muni-works/rose/electronics/limb-controller/DESIGN.md

# Arm controller board - design v0.1 (2026-10-13)

**Schematic:** `arm_controller.loon` is the circuit, written in loon, and it is the source.
`./build.sh` exports it with vcad to `arm_controller.kicad_sch`. It then checks that every pin is
on its loon net with no merges (`netcheck.py`), runs KiCad ERC (0 errors), and plots
`arm_controller.pdf`. Every part is a KiCad library symbol, so pin numbers come from KiCad.

**Parts the schematic uses instead of the first pass below.** Each change was made to use a part
that KiCad's library has:

| first pass | schematic | why |
|---|---|---|
| TCAN1044 | MCP2562FD | same role, 8-pin CAN-FD, in KiCad's library |
| LM5069 | LM5060 | high-side switch controller with enable, inrush and VDS overcurrent |
| INA229 (SPI) | INA228 (I2C) | same 85 V, 20-bit monitor |
| TPS3431 | TPS3430 | same window watchdog family |
| LMR38020 to 5 V | LM5164 48 V to 12 V, then TPS54302 to 5 V | the 12 V rail drives the brake FET gate and feeds aux |
| FDCAN2 on PB12/PB13 | FDCAN2 on PB5/PB6 | the 100-pin package has no port G, so RMII takes PB11-PB13 |

- **Same FET twice.** The hot-swap and brake FETs are the same 100 V TOLL part.
- **VCAP pins.** The two VCAP pins each get their own 2.2 µF capacitor.
- **Footprint gap.** KiCad has no XT30(2+2) footprint, so the wrist-bus connector is a marked
  placeholder until one is drawn.
- **Check before layout.** Verify the FDCAN3 pins (PD12/PD13) and every alternate-function
  assignment in CubeMX.

One board per arm. It sits in the base, on the 6 mm foot, beside the yaw motor. It replaces
four boxes:

| replaced | by |
|---|---|
| RobStride Power Board | the power front end: inrush limit, e-stop switch, bus monitoring |
| RobStride Discharge Module | the on-board brake chopper; its resistor is bolted to the foot |
| a USB-to-CAN adapter | two motor buses, driven directly by the microcontroller |
| a Teensy + transceivers | the microcontroller, with a hardware watchdog it can't override |

It has two firmware modes on the same hardware:

- **Robot mode.** A humanoid's main computer sends joint targets each tick: position, velocity,
  kp, kd and feed-forward torque. The board forwards them to both buses in the same tick and
  returns the motor states. It does no kinematics. It adds the safety layer and one cable across
  the shoulder.
- **Standalone mode.** A laptop talks to the board over USB-C or Ethernet. The board runs the
  servo loop, trajectory interpolation, gravity compensation and the safety policy. The user needs
  no CAN adapter and no realtime OS.

## Simulation (sim/, 2026-10-13)

`cd sim && cargo run --release` runs the power path on vcad's circuit solver. The ICs are behavioural
chips (`vcad_ecad_sim::circuit::chips`): the LM5060 hot-swap, the 3-input AND, the TLV7031 comparator,
and the brake FET with its driver. The circuit is a 48 V bench supply that can't absorb current,
power-up, a 100 ms regen pulse from a back-driven arm, then e-stop. `plot.py` draws
`power_path.svg`.

What it changed in the schematic:

| | first schematic | simulated | now |
|---|---|---|---|
| brake comparator hysteresis | on 54.3 V / off 53.3 V: chatters (582 switch events in 100 ms) | | R16 301k, R17 9.09k, R20 665k: on 57.0 / off 55.5 V (±1.2%: on ≤57.7, off ≥54.9, above a full 13S pack at 54.6) |
| brake resistor | 10 Ω: holds 5 A of regen; 20 A runs the bus to 188 V | 4.7 Ω holds 10 A, 3.3 Ω holds 15 A at 54.2 V | **3.3 Ω, 200 W, on the foot** |
| e-stop hold (R8 / C3) | 104-142 ms, depending on how long the board has been on | diode across R8 makes it fixed | C3 390 nF + BAT54 (D10): **188 ms** |

The LM5060 pin thresholds (EN 2.0 V, UVLO 1.6 V, OVP 2.0 V) and the 5 A inrush limit are assumptions
in the model. Check them against the datasheet before trusting the e-stop delay.

Linear checks were run with vcad's hosted simulate tool:
- 12 V feedback: 1.189 V at 12.0 V out, so the rail sits at 12.11 V.
- 5 V feedback: 0.587 V at 5.0 V out, so the rail sits at 5.08 V.
- Brake sense at 48 V: 1.46 V against the 1.65 V reference, so the brake stays off.
- CAN split-termination corner: about 1.1 MHz.

## Requirements

Facts below come from the RobStride manuals in `~/Developer/robstride_assets`.

| | requirement | source |
|---|---|---|
| bus voltage | 48 V nominal; every part on the bus rated 80 V or more | motors 15–60 V; regen spikes |
| motor buses | 2, CAN 2.0 at 1 Mbps today; CAN-FD capable for later | motors default to 1 Mbps CAN 2.0; most RS models list CAN-FD |
| control rate | 1 kHz with command and reply for every joint | 3 motors per bus fits at 1 Mbps (about 1.1 kHz ceiling) |
| bus A | J1 yaw, J2 shoulder, J4 elbow (3x RS04) | RS04: XT30 power + GH1.25 CAN, separate |
| bus B | J5, J6 (RS02), J7 (RS00), gripper | RS02/RS00: XT30(2+2), power and CAN in one plug |
| current | 40 A peak, 10 A continuous for the whole arm | RS04 phase peak 90 A is phase, not bus; bus power is far lower |
| regen | clamp the motor bus to about 54 V | a bench supply cannot absorb energy, per the discharge module manual |
| e-stop | cuts motor power by hardware, with no firmware in the path | ISO 13850; matches the power board's 5 µs cut |
| uplink | USB-C, 100 Mbit Ethernet, and CAN-FD | robot or standalone |
| size | fits the foot annulus outside the J1 collar: 150 x 40 mm max | foot Ø230, collar Ø140 |

## Block diagram

```mermaid
flowchart LR
  PIN[48 V in<br/>XT60] --> TVS[TVS + reverse<br/>polarity FET] --> HS[LM5069 hot-swap<br/>inrush + overcurrent<br/>+ e-stop off]
  HS --> MB[(motor bus)]
  MB --> BR[brake chopper<br/>comparator + 100 V FET<br/>resistor on the foot]
  MB --> INA[INA229<br/>bus V and I]
  MB --> BA[bus A out<br/>3x XT30 + GH1.25]
  MB --> BB[bus B out<br/>XT30 2+2]
  PIN --> BK[LMR38020 buck<br/>48 V to 5 V] --> LDO[3.3 V LDO]
  BK --> AUX[5 V aux out]
  ES[e-stop loop<br/>2-channel NC] --> HS
  WD[TPS3431<br/>window watchdog] --> HS
  MCU[STM32H723<br/>550 MHz M7<br/>3x FDCAN] --> TA[TCAN1044 A] --> BA
  MCU --> TB[TCAN1044 B] --> BB
  MCU --> TU[TCAN1044 uplink] --> UP[CAN-FD uplink<br/>JST-GH 4]
  MCU --> PHY[LAN8742A<br/>RMII] --> RJ[RJ45]
  MCU --> USB[USB-C]
  MCU --> WD
  INA --> MCU
  MCU -- override --> BR
  ES --> MCU
```

## Microcontroller: STM32H723 instead of the Teensy's i.MX RT1062

| | STM32H723VGT6 | i.MX RT1062 (Teensy 4.1) |
|---|---|---|
| CAN | **3x FDCAN**, all CAN-FD | 3x CAN, only one CAN-FD |
| Ethernet | MAC on chip, RMII PHY | MAC on chip, RMII PHY |
| package | LQFP-100, routable on a 4-layer board | BGA-196, needs fine-pitch fab |
| flash | 1 MB on chip | external QSPI |
| price, qty 10 | about $10 (estimate) | about $8, plus flash |

The H723 wins on CAN-FD on every bus and on an easy package. The Teensy's selling point was firmware
continuity, so **prototype on an ST NUCLEO-H723ZG instead of a Teensy**. Its chip is the same, and it
has Ethernet on board. The firmware then moves to this board unchanged.

## Power and safety

**Power path.** 48 V comes in through an XT60. Next are a TVS (SMDJ60A) and a reverse-polarity
FET. Then an LM5069 hot-swap controller drives a 100 V, about 2 mΩ MOSFET. The LM5069 does three jobs:

- It limits inrush by limiting the rise rate, so no precharge resistor is needed.
- It trips on overcurrent with a power limit, set to 45 A.
- Its enable pin is driven only by the e-stop loop AND the watchdog. Firmware cannot hold it on.

**Brake chopper.** It sits on the motor side of the switch. A comparator with hysteresis turns
on at 57.0 V and off at 55.5 V: above a full 13S pack (54.6 V), so it never bleeds a charged pack,
and below RS04's limit. Firmware may add braking (soft brake on 55.0 / off 54.4 V when the BMS can't
take the regen) but never inhibits the comparator. TVS is SMDJ60A: 60 V stand-off clears the 57.7 V
worst-case brake-on, clamp stays under the 100 V FETs.
It drives a 100 V FET into an aluminium-clad resistor, 10 Ω / 100 W, bolted to the 6 mm foot.
The foot is the heat sink. The MCU can also force it on, and it logs every event.

**Stop sequence (ISO 13850 category 1).**

1. Pressing e-stop, a watchdog timeout or a fault from the bus monitor starts a stop.
2. Within one tick, the MCU commands every motor to damping mode. Each joint gets kd only, so
   the arm settles instead of dropping.
3. After 200 ms, an RC timer opens the hot-swap FET. This step is hardware and happens even if
   the firmware is dead.
4. Unpowered, the motors fall back on RobStride's power-off anti-backdrive damping. Rig test #1
   checks whether that holds a slowly falling arm.

**Watchdog.** A TPS3431 window watchdog is kicked by the control loop, not by an idle task. A
hung loop takes motor power away within 200 ms.

**Monitoring.** An INA229 reads bus voltage and current at 20 bits over SPI. Firmware uses it for
energy accounting, overcurrent before the hardware trip, and collision detection from current
spikes, the crush-point policy the audit asks for. Two NTCs watch the FET and the brake resistor.

**Logic power.** An LMR38020 buck (80 V in, 2 A) makes 5 V from the input side of the switch, so
the MCU stays alive through an e-stop and can report. A 3.3 V LDO follows it. The 5 V aux output
is for the gripper or lights.

## Connectors

| connector | part | carries |
|---|---|---|
| power in | XT60PW-M | 48 V from supply or body bus |
| bus A power | 3x XT30PW-M (or one XT30 out, daisy-chained) | RS04 power |
| bus A CAN | GH1.25 2-pin | RS04 CAN, daisy-chained |
| bus B | XT30PB(2+2)-M | RS02 / RS00 power + CAN, daisy-chained |
| e-stop | 4-pin locking, dual-channel normally closed | e-stop button |
| uplink | RJ45 with magnetics, JST-GH 4 (CAN-FD), USB-C | robot or laptop |
| brake resistor | 2-pin screw terminal | resistor on the foot |
| aux | JST-GH 3 | 5 V, GND, one GPIO |

Each CAN bus is terminated at the board, with a 120 Ω split termination and a solder jumper, and at
the far motor. ESD protection (PESD2CAN class) on every CAN line that leaves the board.

## Board

- **Stackup:** 4 layers, 2 oz outer copper for the 40 A path. The motor bus runs as a pour,
  not as traces.
- **Size:** 140 x 38 mm, shaped to the foot annulus. It mounts on four M3 standoffs with the FET
  and chopper thermally padded to the foot.
- **Assembly:** single-sided SMT at a board house. Connectors are hand-soldered or assembled
  through-hole.
- **Cost, qty 10:** roughly $45–70 per board assembled, excluding the brake resistor. That's an
  estimate until it's quoted.

### One board, many limbs

The same board runs the arm, a leg, the torso or the head. Firmware picks the role from
the board ID, and each block below is fitted only where a limb needs it.

| Block | Part | MCU | Use |
|---|---|---|---|
| Board ID | R67/R68 divider | PC0 (ADC) | R68 DNP = arm, 10k leg, 4.7k torso, 2.2k head |
| IMU | ISM330DHCX (SPI1) | CS PA4, INT PD6 | orientation, fall and collision detection |
| Load cell | ADS1220 24-bit, ratiometric (SPI1) | CS PD4, DRDY PD2 | wrist force, grip force, foot contact (J14) |
| 4th CAN-FD | MCP251863 (controller and transceiver, SPI1) | CS PD5, INT PC10 | second limb or tool bus (J15); the MCU's 3 FDCANs are taken |
| Brushed motor | DRV8871 from +12 V, ILIM 0.78 A | TIM1 CH1/CH2 (PA8/PA9) | gripper or tool without a RobStride (J16) |
| 48 V aux out | 1.1 A PTC (60 V 2920s stop near 1 A), XT30 | - | the board doubles as the power distribution node (J17) |
| PTP time sync | STM32H7 MAC timestamping | - | firmware only, no new parts |
| Mounting | 4 x M3, grounded pads | - | fits any limb, not only the foot ring |

SPI1 is PA5 SCK, PA6 MISO and PD7 MOSI. The IMU and ADC outputs go through 33 R series
resistors onto the shared MISO line. The MCP251863's TXCAN-TXD link is a 0 R resistor (R77).
**Open:** check the brushed motor's 0.78 A limit against the 1 A LM5164 12 V buck. If a
gripper needs more, swap the buck for a 2 A part. Pick a real part number for F1.

### Layout as built (v0.1 draft, 150 x 40 mm)

- **Hand work (v0.2, 150 x 46):** the router left SPI_MOSI open between U10 and the SPI devices.
  - SPI_MOSI: astar_fix.py with ASTAR_FORCE=1 ASTAR_WIN=8 ASTAR_GRID=0.1 routed it, ripping
    IMU_INT's escape.
  - IMU_INT: pin-swapped from U10 pin 87 (PD6) to pin 7 (PC13), beside its remaining copper,
    then astar_fix.py. Firmware: IMU_INT is PC13 (EXTI13).
  - +12V near the ETH_REFCLK via at (108.75, 35.9): the 0.5 mm jog re-laid 1.4 mm to the left
    (Power class needs 0.2 mm).
  - AUX_IO stays on U10 pin 34 (PB0), facing J11 (from the 150 x 40 board).
  A full re-route regenerates the board: replay pin_swap.py and astar_fix.py.

- **Flow:** `arm_controller.loon` → `place.py` (placement block) → `route.sh`. route.sh runs
  `vcad route`, then KiCad fills the zones (`fill_zones.py`) and runs DRC (`drc.rpt`).
- **Stackup (6 layers):** F signal / In1 GND / In2 signal / In3 +3V3 / In4 signal / B signal.
  The router keeps traces off the two plane layers, and vias pass through them. On
  4 layers, signals on the planes cut ground into islands and stranded pads. +12 V, +5 V,
  VIN_BUCK and VAUX48 are traced at 0.5 mm (the "Power" class).
- **48 V pours:** VIN, VBUS_SW, VBUS and BRK_R get F.Cu pour rectangles that reinforce routed
  traces. The router never relies on them, because KiCad's fill carves overlapping pours
  apart. Only pads of 1 mm² or larger set a pour's extent, so a controller's sense pin
  doesn't drag the pour over the logic.
- **VIN_BUCK:** a ferrite (FB4) splits the buck's input from VIN. This keeps the buck's
  switching noise off the hot-swap sense node, and gives the 48 V pour a clean edge.
- **Hot-swap and brake FETs:** IPT015N10N5 (TOLL), with pins 1 = G, 2 = S, 3 = D. The
  old generic NMOS symbol's G/D/S names didn't match the footprint's pad numbers, so the FETs
  were unconnected. vcad now refuses a pin that has no pad.
- **Thermal vias** under exposed pads tie solid to the planes, with no spokes.
- **Easter eggs:** the muni logo is on the front silk. A note sits inside the MCU's pad ring,
  so it's only readable on a bare board. The back carries the fork arm, drawn from its own
  dimensions.

## Firmware outline

- **1 kHz control tick.** Send bus A and bus B frames in parallel and gather replies, then publish
  one state packet upstream and kick the watchdog.
- **Robot mode.** Accept one target packet per tick over CAN-FD or UDP. Stale for 3 ticks means a
  damped hold. Stale for 200 ms means the hardware stop.
- **Standalone mode.** A USB CDC or UDP API covering joint and Cartesian targets, trajectories,
  gravity compensation from the model's masses, and leader-follower teleop for LeRobot-style data.
- **Safety layer, both modes.** Joint limits from `audit.py` ranges, a velocity cap, collision
  detection from motor current and INA229 spikes, and a thermal model per motor from the stall
  ratings.
- **Bring-up tools.** A Python CLI to set motor IDs, read parameters, zero joints and stream plots.

## Plan

1. **Now:** NUCLEO-H723ZG plus three TCAN1044 breakout modules and the RobStride discharge module.
   Write the firmware against the elbow rig.
2. **Board v0.1:** schematic and layout from this document. Fab 5 at a board house.
3. **Swap:** the rig and the first arm move to the board. Firmware is unchanged.

Open questions:

- the EDU gripper's interface (PWM servo, serial bus or CAN), which decides what the aux port carries
- whether the humanoid body supplies 48 V on a shared bus, and how its regen is handled
- e-stop wiring in the humanoid: one loop through every limb board, or a body-level signal
