muni-works/rose/electronics/brain/b2b_pinmap.csv

connector | pin | net
J_B2B1 | 1 | GND
J_B2B1 | 2 | GND
J_B2B1 | 3 | CAM0_CP
J_B2B1 | 4 | GND
J_B2B1 | 5 | CAM0_CN
J_B2B1 | 6 | GND
J_B2B1 | 7 | GND
J_B2B1 | 8 | GND
J_B2B1 | 9 | CAM0_D0P
J_B2B1 | 10 | GND
J_B2B1 | 11 | CAM0_D0N
J_B2B1 | 12 | GND
J_B2B1 | 13 | GND
J_B2B1 | 14 | GND
J_B2B1 | 15 | CAM0_D1P
J_B2B1 | 16 | GND
J_B2B1 | 17 | CAM0_D1N
J_B2B1 | 18 | GND
J_B2B1 | 19 | GND
J_B2B1 | 20 | GND
J_B2B1 | 21 | CAM0_D2P
J_B2B1 | 22 | GND
J_B2B1 | 23 | CAM0_D2N
J_B2B1 | 24 | GND
J_B2B1 | 25 | GND
J_B2B1 | 26 | GND
J_B2B1 | 27 | CAM0_D3P
J_B2B1 | 28 | GND
J_B2B1 | 29 | CAM0_D3N
J_B2B1 | 30 | GND
J_B2B1 | 31 | GND
J_B2B1 | 32 | GND
J_B2B1 | 33 | CAM1_CP
J_B2B1 | 34 | GND
J_B2B1 | 35 | CAM1_CN
J_B2B1 | 36 | GND
J_B2B1 | 37 | GND
J_B2B1 | 38 | GND
J_B2B1 | 39 | CAM1_D0P
J_B2B1 | 40 | GND
J_B2B1 | 41 | CAM1_D0N
J_B2B1 | 42 | GND
J_B2B1 | 43 | GND
J_B2B1 | 44 | GND
J_B2B1 | 45 | CAM1_D1P
J_B2B1 | 46 | GND
J_B2B1 | 47 | CAM1_D1N
J_B2B1 | 48 | GND
J_B2B1 | 49 | GND
J_B2B1 | 50 | GND
J_B2B1 | 51 | CAM1_D2P
J_B2B1 | 52 | GND
J_B2B1 | 53 | CAM1_D2N
J_B2B1 | 54 | GND
J_B2B1 | 55 | GND
J_B2B1 | 56 | GND
J_B2B1 | 57 | CAM1_D3P
J_B2B1 | 58 | GND
J_B2B1 | 59 | CAM1_D3N
J_B2B1 | 60 | GND
J_B2B1 | 61 | GND
J_B2B1 | 62 | GND
J_B2B1 | 63 | USB_OTG_DP
J_B2B1 | 64 | GND
J_B2B1 | 65 | USB_OTG_DM
J_B2B1 | 66 | GND
J_B2B1 | 67 | GND
J_B2B1 | 68 | GND
J_B2B1 | 69 | GND
J_B2B1 | 70 | GND
J_B2B1 | 71 | GND
J_B2B1 | 72 | GND
J_B2B1 | 73 | GND
J_B2B1 | 74 | GND
J_B2B1 | 75 | GND
J_B2B1 | 76 | GND
J_B2B1 | 77 | GND
J_B2B1 | 78 | GND
J_B2B1 | 79 | GND
J_B2B1 | 80 | GND
J_B2B1 | 81 | GND
J_B2B1 | 82 | GND
J_B2B1 | 83 | GND
J_B2B1 | 84 | GND
J_B2B1 | 85 | GND
J_B2B1 | 86 | GND
J_B2B1 | 87 | GND
J_B2B1 | 88 | GND
J_B2B1 | 89 | GND
J_B2B1 | 90 | GND
J_B2B1 | 91 | GND
J_B2B1 | 92 | GND
J_B2B1 | 93 | GND
J_B2B1 | 94 | GND
J_B2B1 | 95 | GND
J_B2B1 | 96 | GND
J_B2B1 | 97 | GND
J_B2B1 | 98 | GND
J_B2B1 | 99 | GND
J_B2B1 | 100 | GND
J_B2B2 | 1 | VCC_SYSIN
J_B2B2 | 2 | VCC_SYSIN
J_B2B2 | 3 | VCC_SYSIN
J_B2B2 | 4 | VCC_SYSIN
J_B2B2 | 5 | VCC_SYSIN
J_B2B2 | 6 | VCC_SYSIN
J_B2B2 | 7 | VCC_SYSIN
J_B2B2 | 8 | VCC_SYSIN
J_B2B2 | 9 | VCC_SYSIN
J_B2B2 | 10 | VCC_SYSIN
J_B2B2 | 11 | VCC_SYSIN
J_B2B2 | 12 | VCC_SYSIN
J_B2B2 | 13 | VCC_SYSIN
J_B2B2 | 14 | VCC_SYSIN
J_B2B2 | 15 | VCC_SYSIN
J_B2B2 | 16 | VCC_SYSIN
J_B2B2 | 17 | VCC_SYSIN
J_B2B2 | 18 | VCC_SYSIN
J_B2B2 | 19 | VCC_SYSIN
J_B2B2 | 20 | VCC_SYSIN
J_B2B2 | 21 | VCC_3V3_S0
J_B2B2 | 22 | VCC_3V3_S0
J_B2B2 | 23 | VCC_3V3_S0
J_B2B2 | 24 | VCC_3V3_S0
J_B2B2 | 25 | USB_VBUS
J_B2B2 | 26 | USB_VBUS
J_B2B2 | 27 | GND
J_B2B2 | 28 | GND
J_B2B2 | 29 | CAM0_PWDN
J_B2B2 | 30 | GND
J_B2B2 | 31 | CAM0_SCL
J_B2B2 | 32 | GND
J_B2B2 | 33 | CAM0_SDA
J_B2B2 | 34 | GND
J_B2B2 | 35 | CAM1_PWDN
J_B2B2 | 36 | GND
J_B2B2 | 37 | CAM1_SCL
J_B2B2 | 38 | GND
J_B2B2 | 39 | CAM1_SDA
J_B2B2 | 40 | GND
J_B2B2 | 41 | PWRON_L
J_B2B2 | 42 | GND
J_B2B2 | 43 | RECOVERY_KEY
J_B2B2 | 44 | GND
J_B2B2 | 45 | RT_BOOT0
J_B2B2 | 46 | GND
J_B2B2 | 47 | RT_CS_n
J_B2B2 | 48 | GND
J_B2B2 | 49 | RT_IRQ
J_B2B2 | 50 | GND
J_B2B2 | 51 | RT_MISO
J_B2B2 | 52 | GND
J_B2B2 | 53 | RT_MOSI
J_B2B2 | 54 | GND
J_B2B2 | 55 | RT_NRST
J_B2B2 | 56 | GND
J_B2B2 | 57 | RT_RX
J_B2B2 | 58 | GND
J_B2B2 | 59 | RT_SCK
J_B2B2 | 60 | GND
J_B2B2 | 61 | RT_TX
J_B2B2 | 62 | GND
J_B2B2 | 63 | SOC_UART2_RX
J_B2B2 | 64 | GND
J_B2B2 | 65 | SOC_UART2_TX
J_B2B2 | 66 | GND
J_B2B2 | 67 | GND
J_B2B2 | 68 | GND
J_B2B2 | 69 | GND
J_B2B2 | 70 | GND
J_B2B2 | 71 | GND
J_B2B2 | 72 | GND
J_B2B2 | 73 | GND
J_B2B2 | 74 | GND
J_B2B2 | 75 | GND
J_B2B2 | 76 | GND
J_B2B2 | 77 | GND
J_B2B2 | 78 | GND
J_B2B2 | 79 | GND
J_B2B2 | 80 | GND
J_B2B2 | 81 | GND
J_B2B2 | 82 | GND
J_B2B2 | 83 | GND
J_B2B2 | 84 | GND
J_B2B2 | 85 | GND
J_B2B2 | 86 | GND
J_B2B2 | 87 | GND
J_B2B2 | 88 | GND
J_B2B2 | 89 | GND
J_B2B2 | 90 | GND
J_B2B2 | 91 | GND
J_B2B2 | 92 | GND
J_B2B2 | 93 | GND
J_B2B2 | 94 | GND
J_B2B2 | 95 | GND
J_B2B2 | 96 | GND
J_B2B2 | 97 | GND
J_B2B2 | 98 | GND
J_B2B2 | 99 | GND
J_B2B2 | 100 | GND
