muni-works/rose/electronics/brain/ddr_swizzle.csv

channel | dram_side | dram_dq | soc_dq
0 | A | 0 | 1
0 | A | 1 | 4
0 | A | 2 | 6
0 | A | 3 | 0
0 | A | 4 | 2
0 | A | 5 | 7
0 | A | 6 | 5
0 | A | 7 | 3
0 | A | 8 | 14
0 | A | 9 | 11
0 | A | 10 | 8
0 | A | 11 | 9
0 | A | 12 | 10
0 | A | 13 | 13
0 | A | 14 | 12
0 | A | 15 | 15
0 | B | 0 | 6
0 | B | 1 | 0
0 | B | 2 | 5
0 | B | 3 | 2
0 | B | 4 | 4
0 | B | 5 | 7
0 | B | 6 | 3
0 | B | 7 | 1
0 | B | 8 | 13
0 | B | 9 | 14
0 | B | 10 | 9
0 | B | 11 | 8
0 | B | 12 | 10
0 | B | 13 | 11
0 | B | 14 | 12
0 | B | 15 | 15
1 | A | 0 | 2
1 | A | 1 | 0
1 | A | 2 | 4
1 | A | 3 | 5
1 | A | 4 | 7
1 | A | 5 | 6
1 | A | 6 | 1
1 | A | 7 | 3
1 | A | 8 | 14
1 | A | 9 | 12
1 | A | 10 | 9
1 | A | 11 | 8
1 | A | 12 | 11
1 | A | 13 | 10
1 | A | 14 | 13
1 | A | 15 | 15
1 | B | 0 | 0
1 | B | 1 | 1
1 | B | 2 | 6
1 | B | 3 | 5
1 | B | 4 | 7
1 | B | 5 | 3
1 | B | 6 | 4
1 | B | 7 | 2
1 | B | 8 | 9
1 | B | 9 | 11
1 | B | 10 | 14
1 | B | 11 | 8
1 | B | 12 | 13
1 | B | 13 | 15
1 | B | 14 | 12
1 | B | 15 | 10
