muni-works/rose/electronics/limb-controller/sim/power_path.csv

t_s | vbus | hs_en | brake
0.0000 | 0.000 | 0.000 | 0
0.0005 | 11.077 | 2.740 | 0
0.0010 | 22.047 | 2.761 | 0
0.0015 | 32.841 | 2.773 | 0
0.0020 | 43.386 | 2.782 | 0
0.0025 | 47.182 | 2.788 | 0
0.0030 | 47.183 | 2.793 | 0
0.0035 | 47.183 | 2.798 | 0
0.0040 | 47.183 | 2.802 | 0
0.0045 | 47.183 | 2.805 | 0
0.0050 | 47.183 | 2.808 | 0
0.0055 | 47.183 | 2.811 | 0
0.0060 | 47.183 | 2.814 | 0
0.0065 | 47.183 | 2.816 | 0
0.0070 | 47.183 | 2.818 | 0
0.0075 | 47.183 | 2.820 | 0
0.0080 | 47.183 | 2.822 | 0
0.0085 | 47.183 | 2.824 | 0
0.0090 | 47.183 | 2.826 | 0
0.0095 | 47.183 | 2.828 | 0
0.0100 | 47.183 | 2.830 | 0
0.0105 | 47.183 | 2.831 | 0
0.0110 | 47.183 | 2.833 | 0
0.0115 | 47.183 | 2.834 | 0
0.0120 | 47.183 | 2.836 | 0
0.0125 | 47.183 | 2.837 | 0
0.0130 | 47.183 | 2.838 | 0
0.0135 | 47.183 | 2.840 | 0
0.0140 | 47.183 | 2.841 | 0
0.0145 | 47.183 | 2.842 | 0
0.0150 | 47.183 | 2.843 | 0
0.0155 | 47.183 | 2.845 | 0
0.0160 | 47.183 | 2.846 | 0
0.0165 | 47.183 | 2.847 | 0
0.0170 | 47.183 | 2.848 | 0
0.0175 | 47.183 | 2.849 | 0
0.0180 | 47.183 | 2.850 | 0
0.0185 | 47.183 | 2.851 | 0
0.0190 | 47.183 | 2.852 | 0
0.0195 | 47.183 | 2.853 | 0
0.0200 | 47.183 | 2.854 | 0
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
