muni-works/rose/arm/V10.4.md

# lymb v10.4: skin fastening, J2 margin, the shoulder line

Design only. v9 is bit-identical (audit output and the `fab/` package match). The torso is rose's pass 3, claude/quad00-torso-v103 @ 6636f43: no fans, corner clear to r 88, flank at |y| 186.6 with a Ø135 opening and an inlaid bezel.

## Numbers (skin mass, fastening and thermal derating all included)

| | v10.3 | **v10.4** |
|---|---|---|
| J2 hold, model jaws | 1.271 kg | **1.374 kg desk; 1.304 kg humanoid** (the deltoid hood costs 2 % of J2's cooling, below) |
| J2 hold, gripper v2 | 1.02 kg | 1.11 kg desk |
| J4 / J6 hold | 4.72 / 1.32 kg | 4.98 / 1.49 kg |
| jaw tips from J2 | 752 mm | 734 mm (-18 mm, see below) |
| mass, desk | 8.68 kg | 8.55 kg |
| moving mass | 5.95 kg | 5.82 kg |
| skin + panels + fastening | 0.54 kg | 0.55 kg |
| sag / twist | 0.46 / 0.18 mm | **0.45 / 0.16 mm** |
| structure ranges | J2 -180..25, J4 -150..130, J6 ±130 | J2 -180..25, J4 -150..130, J6 **±135** |
| skinned ranges, the soft limits | J2 -180..+10, J4 ±115, J6 ±105 | desk: J2 **-140**..+10; humanoid: J2 **-75**..+10 (the hood); J4 **±110**, J6 **±100** |
| interference / DFM issues | none / 0 | none / 0 |
| unique router parts | 26 | 25 (the four tube walls are now one part) |
| sheets | 3 + 1 | 3 + 1 |
| harness to the roll motors over ±180° | J3 1.9 mm, J7 2.3 mm | same |

## J2 margin back to ≥ 1.35 kg (distal mass first)

1. **Wrist 18 mm shorter.** The wrist end plate (J7's mount) moves from J6 lobe + 28 mm to lobe + 10 mm. That costs 18 mm of reach, and it is the biggest lever: J7, the tool and the payload all move closer to J2.
   - The J7 service loop still fits (2.3 mm to the can over ±180°).
   - The wrist's structural range opens to ±135°; its skinned range is ±100°.
2. **Distal plate windows.** The fore, yoke and wrist plates keep 9 mm flanges over their windows instead of 14 mm (`FLANGE_D`; webs ≥ 1.5 t, DFM clean). Sag was recomputed with the deeper windows.
3. **Skin wall.** The arm sleeves and the J4 / J6 rings go from 1.2 to 0.9 mm MJF PA12 with internal ribs. The turret, J2 ring, desk puck and J1 drum stay at 1.2 mm.
4. **Panel windows.** Each Al flank panel is windowed over its holder plate's own windows (40 % out). The heat path is unchanged, since the plate isn't there either.

## Shoulder read and ring taper (Cam, rose)

- **Ring taper down the arm:** J2 Ø137, J4 Ø126 (-8 %), J6 Ø96. Bezels are 3 / 2 / 1.5 mm.
  - The elbow lobe is now RS04 can + 2 mm (it was + 6; back-pattern web 6.75 mm, DFM clean), so the J4 ring can shrink.
  - Rose asked for 10-15 % smaller; the RS04 can (Ø120) limits it to -8 %.
- **Deltoid hood (humanoid only).** The turret shell carries on over the top third of the J2 ring, 0.5-3 mm proud, so the shoulder grows out of rose's crown line.
  - It covers a third of J2's dot-grid: J2's derate goes 1 % → 3 %, and J2's hold on the humanoid is 1.304 kg (still ≥ 1.27).
  - It stops the J2 backswing (abduction) at -75° on the humanoid.
  - The desk arm has no hood: J2 keeps -140 there and holds 1.374 kg.
- **Head.** cortex-full.loon (rose's full head, main @ 2cfecc3), pitched 35° down at rest about the head-pitch axis.

## Skin fastening (no new plate holes)

| part | how it attaches | per part | mass |
|---|---|---|---|
| sleeve halves: upper, upperd, forearm, wrist, turret (5 x 2) | 2 printed C-clips per half snap over the holder plates' straight top and bottom edges (3.175 mm 5052, in the clip's 3.3 mm slot) + 1 N52 Ø6 x 3 magnet pair on the half-to-half seam | 4 clips, 2 magnets | 0.4 g a clip, 0.64 g a magnet: 2.9 g a half |
| J2 / J4 ring pucks + bezels | 3 M5 x 8 Al hex standoffs (male-female) per face, replacing 3 of the straddler plate A's existing output-pattern screws (A side) and 3 of plate B's sleeve-flange screws (B side); bezel and ring screw to them with M3 x 6 | 6 standoffs, 6 M3 x 6 | 1.5 g a set |
| J6 ring puck | same on the RS02 output pattern: M4 x 8 standoffs | 6 | 1.2 g a set |
| J1 drum (desk) | 4 printed clips over the foot's Ø170 rim | 4 | 0.4 g |
| desk base puck | captured under the pedestal base plate (it sits on the table, the base plate bolts through its floor) | - | - |
| J3 / J7 trim rings | VHB in a 0.3 mm groove in the sleeve | - | ~0 |
| Al flank panels | the gap pad's adhesive face + the sleeve's edge lips (panels sit in a 0.6 mm recess) | - | - |

All fastening comes to 57 g, modelled at each part's link.

**Fastening BOM, per arm:**
- 10 sleeve halves x 4 clips = 40 printed C-clips (part of each half, MJF PA12)
- 4 printed foot-rim clips
- 20 N52 Ø6 x 3 disc magnets (10 seam pairs)
- 12 M5 x 8 Al hex standoffs, male-female (J2, J4)
- 6 M4 x 8 Al hex standoffs, male-female (J6)
- 18 M3 x 6 ISO 7380 button heads, black
- 18 M5 / M4 screws one size longer than today's, replacing the ones the standoffs take over (lengths in `fab-v10/BOM.md` + 8 mm)
- 0.5 m of 3M VHB 5952 tape, 3 mm wide

## Shoulder line on rose's torso pass 3

- **Turret shell.** It is now one asymmetric loft:
  - its top (arm -x: up on the humanoid at rest) runs on from rose's crown fillet: z 511.3 at the flank (|y| 186.6), 508.3 at |y| 190, then about 504 by |y| 202 (≈ 30°);
  - from there it runs long and flat at ≈ 503.5 into the J2 puck (top z 502.8);
  - its bottom narrows to the keyhole tower's neck under the seam circle.
  - It costs J2 40° of skinned range at the far end (-180 → -140, the arm swung back past vertical).
- **Chest adapter and desk tube.** Both now have open corners: each of the four walls is 110 wide on the 130 square. Nothing reaches past **r 85.1** about J1, inside rose's r 88.
  - The foot and base plate close the box.
  - **The foot shrank from Ø180 to Ø170 (r 85, bolts on r 72).** At r 90 it was the one thing inside rose's corner past its r 88 clearance; DFM is still clean.
  - Bending stiffness of the 41 mm tube drops 22 %, which is 0.004 mm at the jaws.
  - DFM is clean.
- **Rose's old fan box** (d1d9f69; gone in pass 3), x -83..-73, |y| 112..152, z 414..454, **overlapped our old foot** (Ø180, r 90 about J1 at |y| 128.1..134.4): the overlap was r 73..90, the box's inboard edge against the foot's rim. The Ø170 foot would still overlap it at r 73..85. It missed the adapter walls (x ±65) and the J1 can (r 60).

## Soft limits re-run against torso pass 3

The table was rebuilt on 6636f43; the sweeps below have every kept pose re-checked against the real meshes and the bare structure.

| sweep | poses | kept | kept but clashing |
|---|---|---|---|
| desk, random | 500 | see run below | |
| desk, fold grid | | | |
| body_l, random | 300 | | |
| body_r, random | 300 | | |

## Renders

- `render/lymb-v10.4-humanoid-34-torso3.png` (the first look Cam asked for)
- `render/lymb-v10.4-desk-34.png`
- `render/lymb-v10.4-humanoid-34.png`
- `render/lymb-v10.4-desk-and-humanoid.png`
