muni-works/rose/arm/V10.5.md

# lymb v10.5: the biceps

Built on v10.4 (fastening, J2 margin, turret slope, ring taper, deltoid hood). QUAD00 is rose's merged torso and head on main @ 2cfecc3: no fans, cortex-full head at head_pitch 35° rest.

## 1. What showed on the upper arm (humanoid 3/4, front, side; J3 = 90° rest and J3 = 0°)

Audit renders: `t5.py` crops of the left arm on main's torso, before any v10.5 change.

| item | in the v10.3 / torso-3 renders | in v10.4 (this base) |
|---|---|---|
| J3 RS02 can (silver in the old flat-shaded scenes) | read as a grey band: the dot-grid band was drawn as a flat "vent" strip | under the sleeve; only its dot-grid holes show, dark |
| upper end plate / upperd bridge tabs (3.2 mm 5052, tab-and-slot) | showed in the 1.5 mm J3 gap as bright edges | black-anodized in skinned scenes and behind the gunmetal ring; nothing bright in the gap |
| J2 holder plates' keyhole necks | inside the J2 ring | inside the ring |
| hub caps (printed, orange) | at J2 / J4 | left out of skinned scenes; the ring bezels replace them |
| harness at the J2 crossing | orange loops at the puck | black silicone, under the ring |

With the v10.4 skin, none of the six views (3/4, front, side x J3 0 / 90) shows a bare can, tab or silver edge on the upper arm. The remaining reads are the ones rose asked for:
- the J2 ring with its gunmetal bezel and hood;
- one sleeve with its J3 dot-grid panel;
- the 1.5 mm J3 parting line with a thin gunmetal band;
- the J4 ring.

## 2. The sleeve, built to rose's form

| rose | v10.5 |
|---|---|
| section 1.15 wide (lateral) : 1 deep (fore-aft), corner 0.3, flat front/back, fuller sides | rounded rectangle, b = 1.15 a (arm z lateral, arm y fore-aft), corner 0.30 x half-depth; the Al panels sit on the front/back flats |
| fullest 25-30 % down from J2, straight to 0.75 at J3, ~0.72 to the elbow, no waist, no swelling | fullest at 27 % (81 mm), straight to 0.75 at the J3 seam, 0.72 at the elbow ring. Each station is raised only where the structure needs it. The J3 can + its loop set the 0.75 point, so the biceps is 122 deep x 140 wide at its fullest. |
| sleeve under the deltoid cap rim, ~1 mm shadow gap, cap overlapping 8-10 mm | the sleeve's top is cut by the J2 seam cylinder, a constant 1 mm to the J2 ring at every angle. The hood covers the ring's top third. **Open:** the hood does not reach down to the sleeve (see below). |
| across J3 the sections match, one surface with a hairline | one loft split at J3: identical sections both sides, a 1.5 mm dark parting line with a 0.8 mm gunmetal hairline inset 0.6 mm. No band. |
| lower sleeve 1 mm short of the elbow ring's bezel | the J4 seam is r = ring + 1 mm |
| J3 dot-grid | inner, back and outer faces, front clean. One size, Ø1.4 / 2.2 hex (the cortex grilles'). Each face's grid sits in a rounded-rectangle field (corner 0.3), ≥ 6 mm from the J3 hairline. The outer face's field stops 15° of the corner round + 3 mm short of the front edge. Holes are 2.5 mm deep into the dark sleeve (dark on dark). Left and right arms mirror (`ROSE_ARM_SIDE`). |
| upper arm visibly heavier than the forearm | biceps 122 x 140 against a forearm of 84 x 57 |
| J2 > J4 > J6 rings | the rings match the sleeve's width where it meets each joint: J2 Ø137 x 122, J4 Ø126 x 90, J6 Ø96 x 84 |

**Not met: the deltoid cap overlap.** On the humanoid, J2's axis runs fore-aft and the upper arm hangs below the J2 ring, so the sleeve meets the ring, not the cap. A cap that overlapped the sleeve by 8-10 mm would have to wrap the ring's lower half too. That would cover the rest of J2's dot-grid (J2 derate 3 % → about 10 %, J2 hold below 1.27 kg) and stop the J2 swing near 0°. I kept the hood to the top third. Rose should decide whether "cap over sleeve" can read as "cap over ring, ring over sleeve".

## 3. Thermal

- **J3:**
  - The grid is real holes. Open area is 2231 mm² (Ø1.4 / 2.2, three fields) against 2830 mm² for the v10.3 four-face Ø1.3 / 2.3 grid.
  - Derate **21 %**. Continuous **3.49 N·m**, above the **3.43 N·m** pose cap; the cap is unchanged.
  - The Ø1.3 / 2.3 grid in the same fields would not hold the cap (derate 22 %, continuous ~3.43 N·m with no margin).
- **J2 / J4:** open faces unchanged. J2 1 % desk, 3 % humanoid (the hood); J4 1 %.
- **Holds, model jaws:** J2 **1.369 kg desk / 1.299 kg humanoid**; J4 4.98 kg; J6 1.49 kg. Sag 0.45 mm. Mass 8.58 kg desk.

## 4. What the fuller biceps costs: range

The biceps is 122 deep x 140 wide, held to 55 mm on the torso side (arm -z) so it clears the turret shell below J2. That fuller section shortens the skinned single-joint ranges (`skin_clash.ranges`), and the soft limits now carry them:

| joint | v10.4 | v10.5 |
|---|---|---|
| J2, desk | -140 .. +10 | **-95 .. +5** |
| J2, humanoid (hood) | -75 .. +10 | -75 .. **+5** |
| J4 | ±110 | **±100** |
| J6 | ±100 | ±100 |

If rose wants J2 / J4 back, the biceps' fore-aft depth (a) is the lever, not its width.

Soft limits re-run on main's torso (table rebuilt; every kept pose re-checked against the real meshes and the bare structure):

| sweep | poses | kept | kept but clashing |
|---|---|---|---|
| desk, random inside the structure's ranges | 500 | 131 (26 %) | **0** |
| desk, fold grid J2 x J4 x J6 over the skinned ranges | 1372 | 1263 (92 %) | **0** |
| body_l, random | 300 | 64 (21 %) | **0** |
| body_r, random | 300 | 63 (21 %) | **0** |

The kept fraction of the whole structural range dropped from 45-48 % (v10.4) to 21-26 %, almost all from the per-joint ranges above.

## Renders (photoreal, 256 spp, main's torso and head)

- `render/lymb-v10.5-humanoid-34.png`
- `render/lymb-v10.5-humanoid-front.png`
- `render/lymb-v10.5-humanoid-side.png`
- `render/lymb-v10.5-biceps-rest.png` (J3 90)
- `render/lymb-v10.5-biceps-j3p90.png` (J3 180)
- `render/lymb-v10.5-biceps-outer-grazing.png` (the outer face, near-grazing view)
- `render/lymb-v10.5-desk-34.png`
- `render/lymb-v10.5-desk-and-humanoid.png`

## Still open

- The J4 ring is 8 % smaller than J2's, not the 10-15 % asked for: the RS04 can sets the floor.
