muni-works/rose/arm/render/fork-v1-posed.png

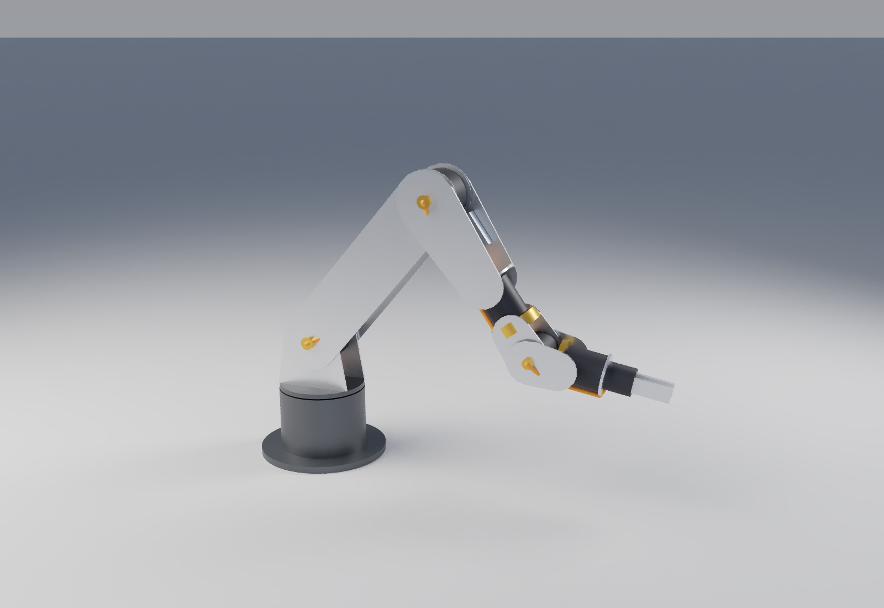
arm/render/fork-v1-posed.png
