muni-works/rose/arm/render/fork-v1.png

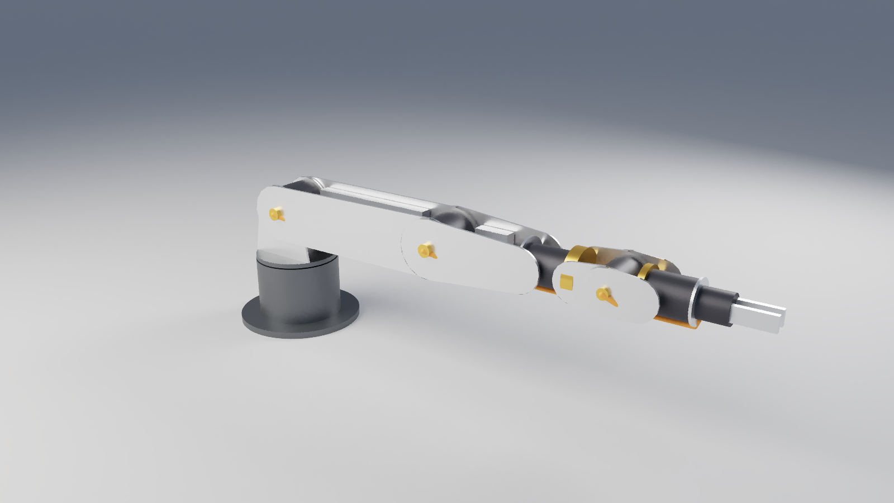
arm/render/fork-v1.png
