muni-works/rose/arm/render/fork-v3-back.png

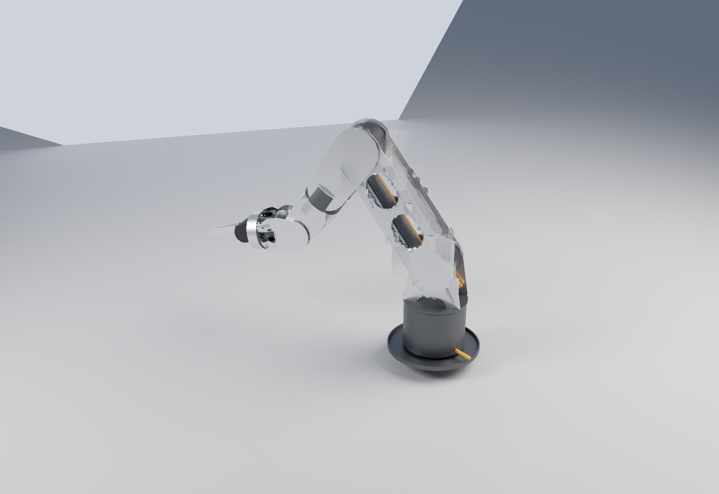
arm/render/fork-v3-back.png
