muni-works/rose/arm/render/fork-v3-posed.png

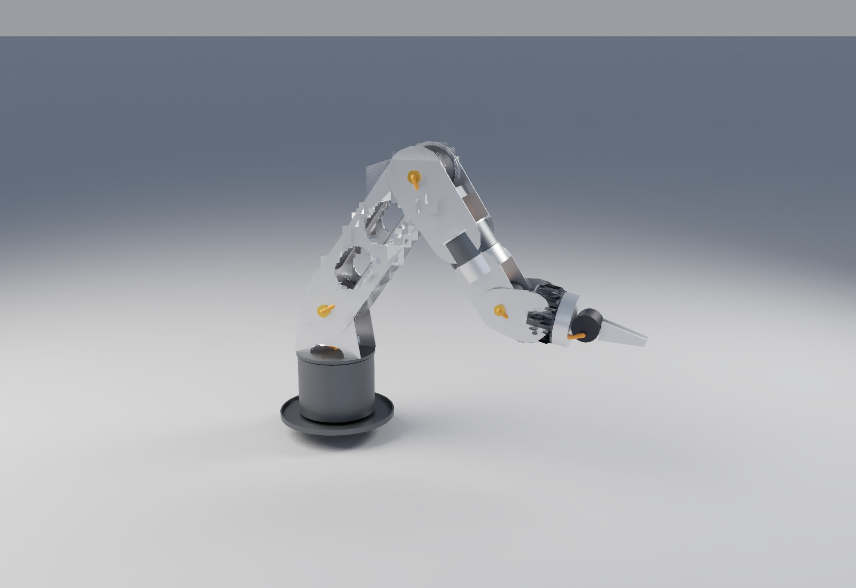
arm/render/fork-v3-posed.png
