muni-works/rose/arm/render/fork-v3.png

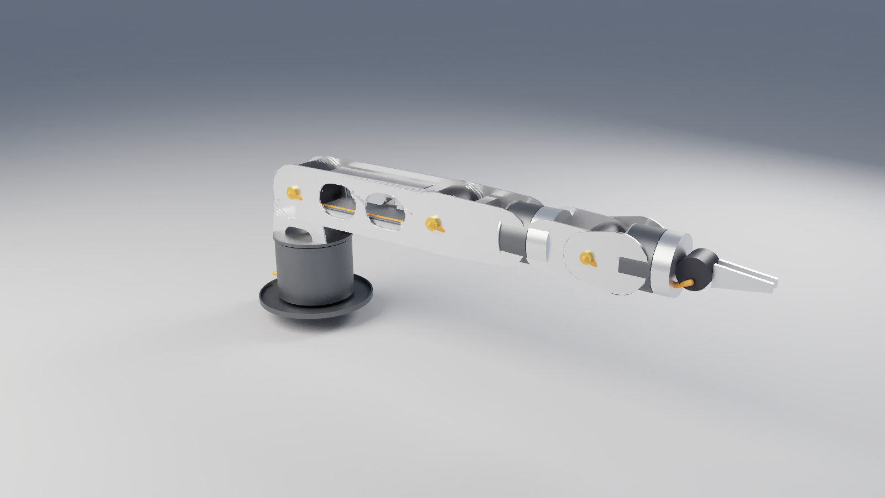
arm/render/fork-v3.png
