muni-works/rose/arm/render/fork-v4-lines.png

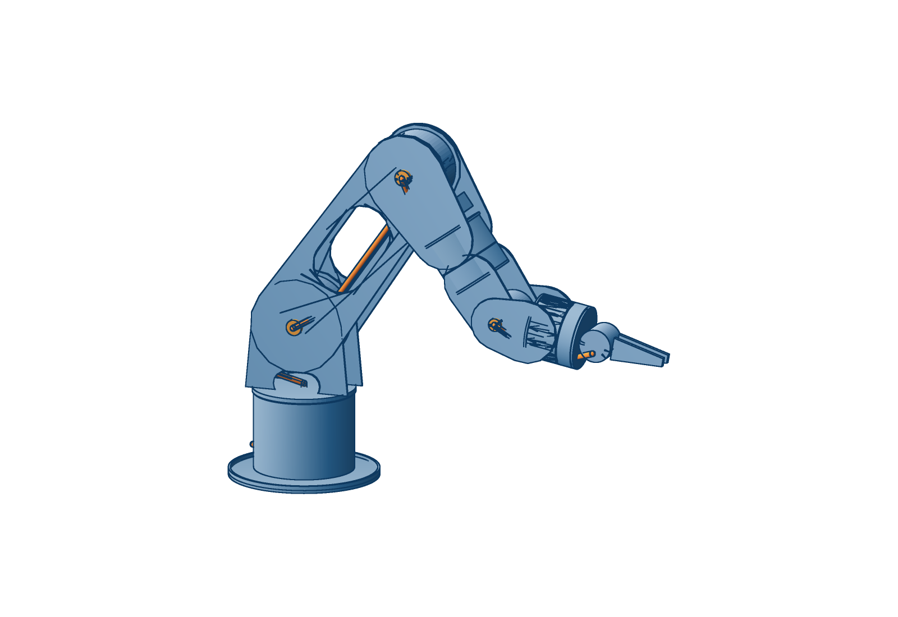
arm/render/fork-v4-lines.png
