muni-works/rose/arm/render/fork-v6-back.png

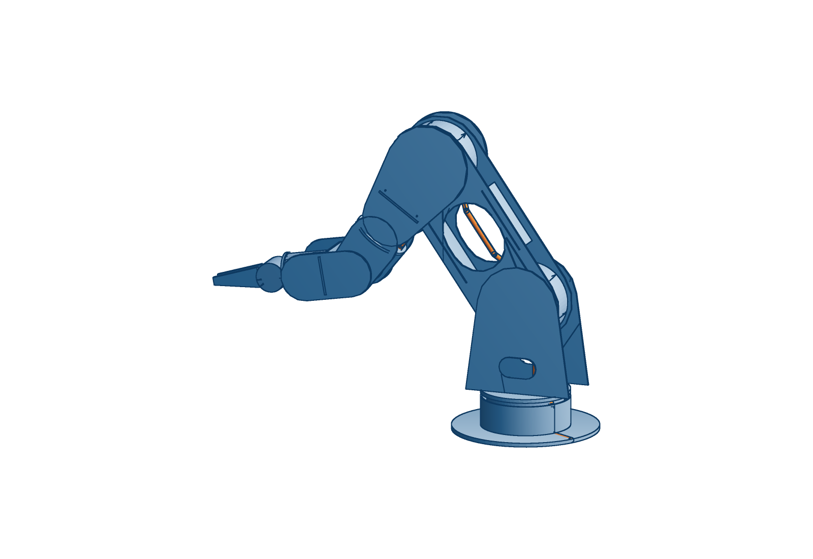
arm/render/fork-v6-back.png
