muni-works/rose/arm/render/fork-v7-lines.png

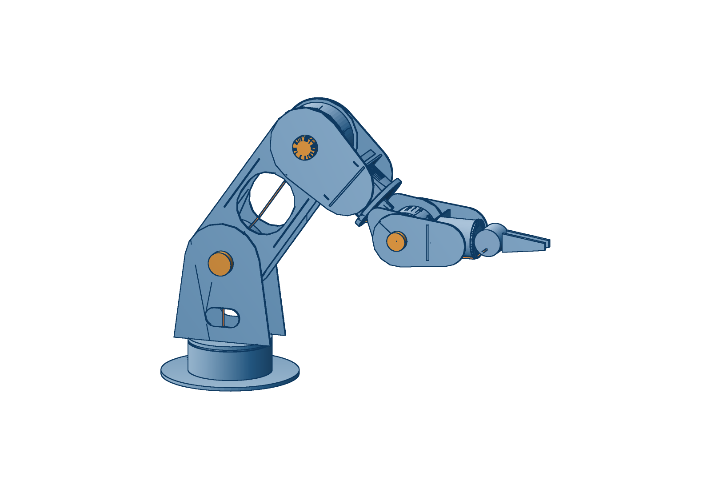
arm/render/fork-v7-lines.png
