muni-works/rose/arm/render/lymb-v9-vs-v10-desk.png

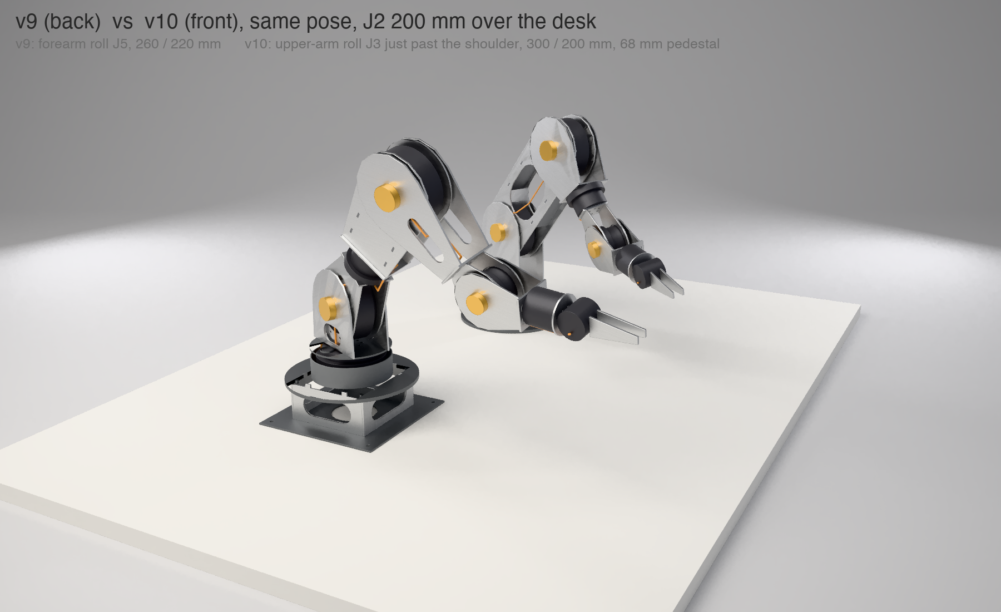
arm/render/lymb-v9-vs-v10-desk.png
