muni-works/rose/arm/render/lymb-v10-desk.png

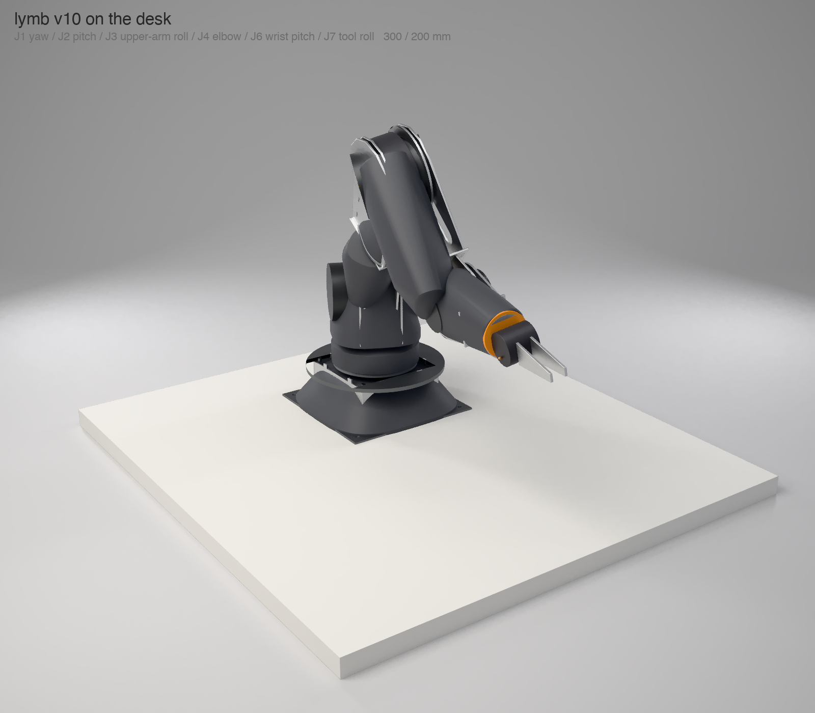
arm/render/lymb-v10-desk.png
