muni-works/rose/arm/render/lymb-v10-humanoid.png

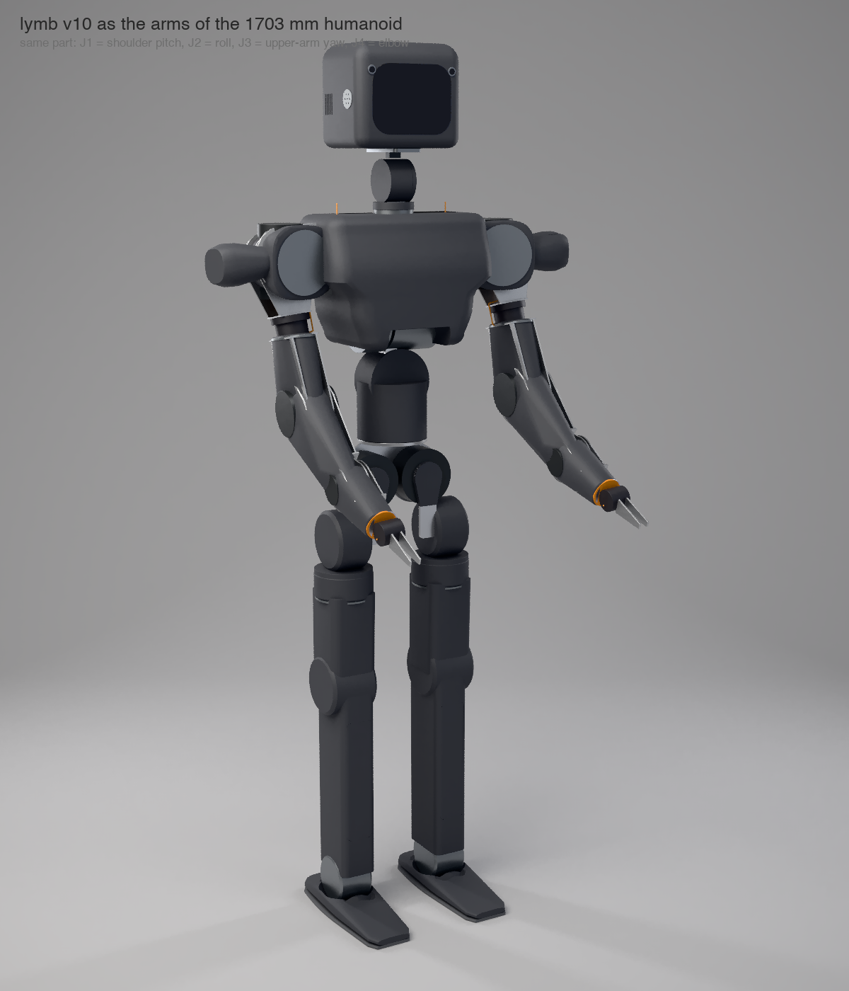
arm/render/lymb-v10-humanoid.png
