muni-works/rose/arm/render/lymb-v10.1-elbow-closeup.png

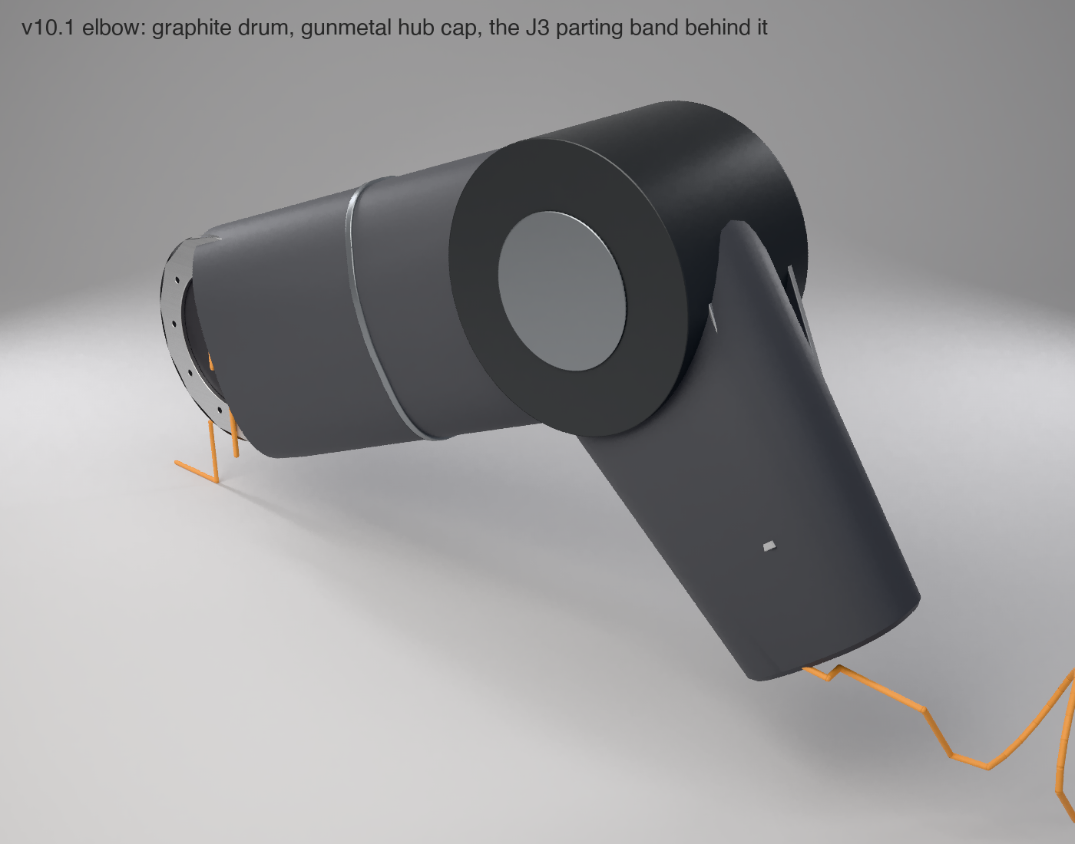
arm/render/lymb-v10.1-elbow-closeup.png
