muni-works/rose/arm/render/lymb-v10.2-desk-and-humanoid.png

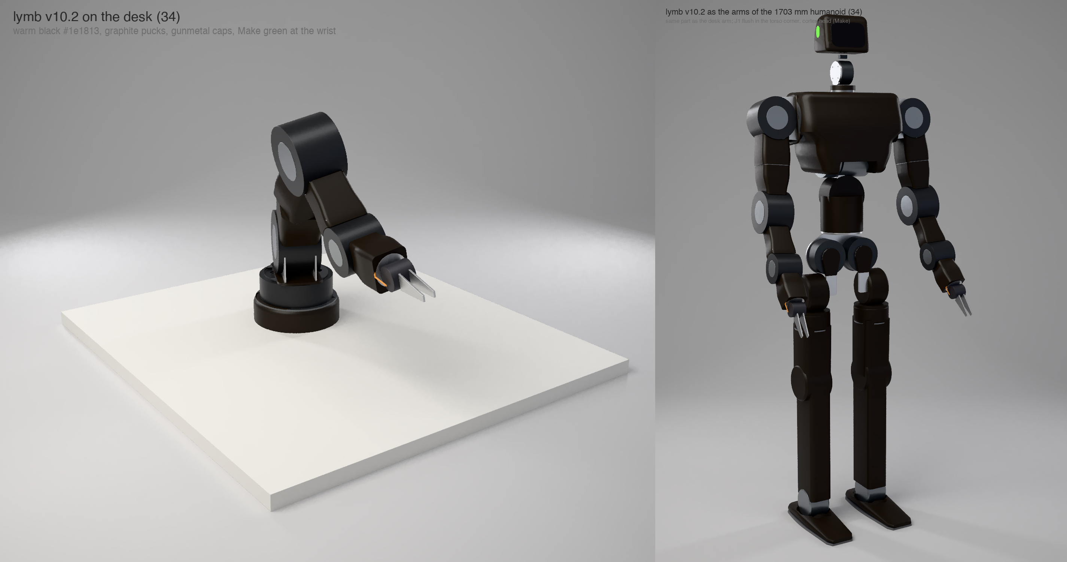
arm/render/lymb-v10.2-desk-and-humanoid.png
