muni-works/rose/arm/render/lymb-v10.2-desk-front.png

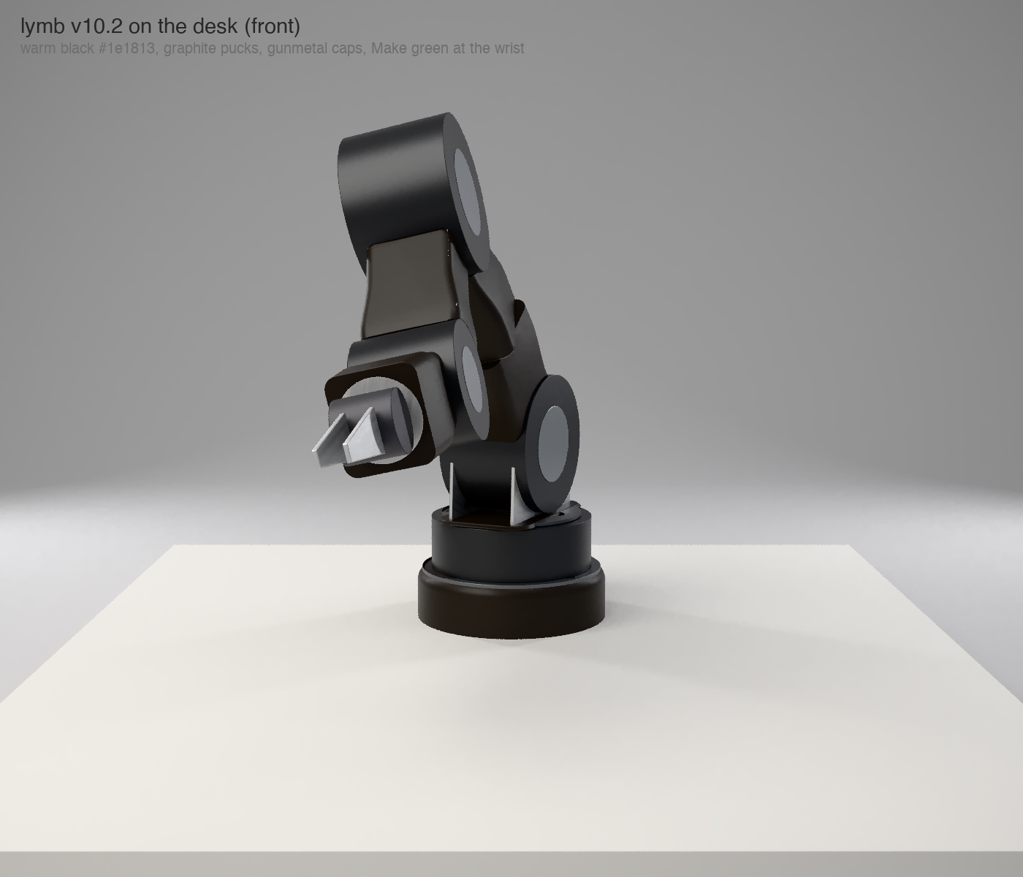
arm/render/lymb-v10.2-desk-front.png
