muni-works/rose/arm/render/lymb-v10.2-desk-high.png

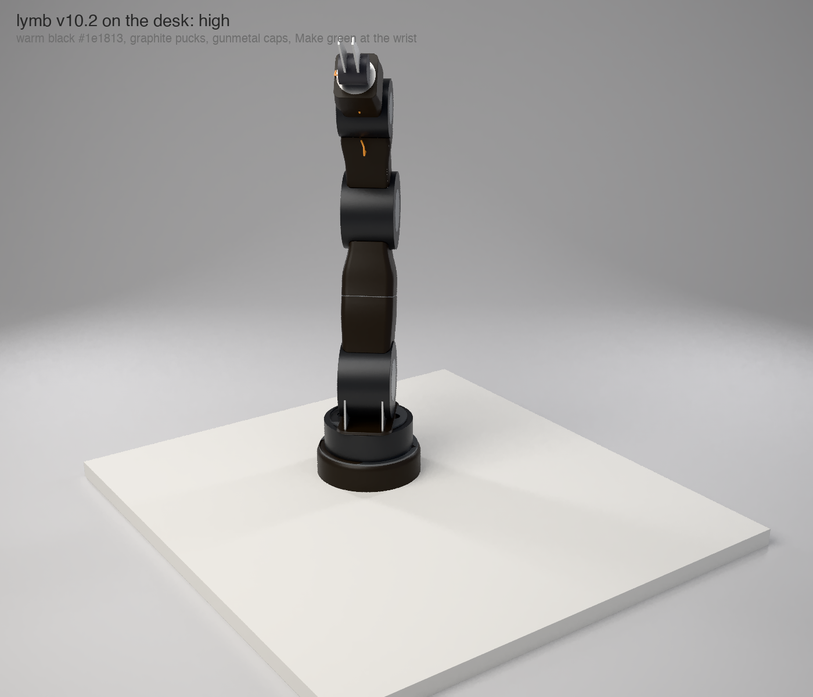
arm/render/lymb-v10.2-desk-high.png
