muni-works/rose/arm/render/lymb-v10.2-desk-pick.png

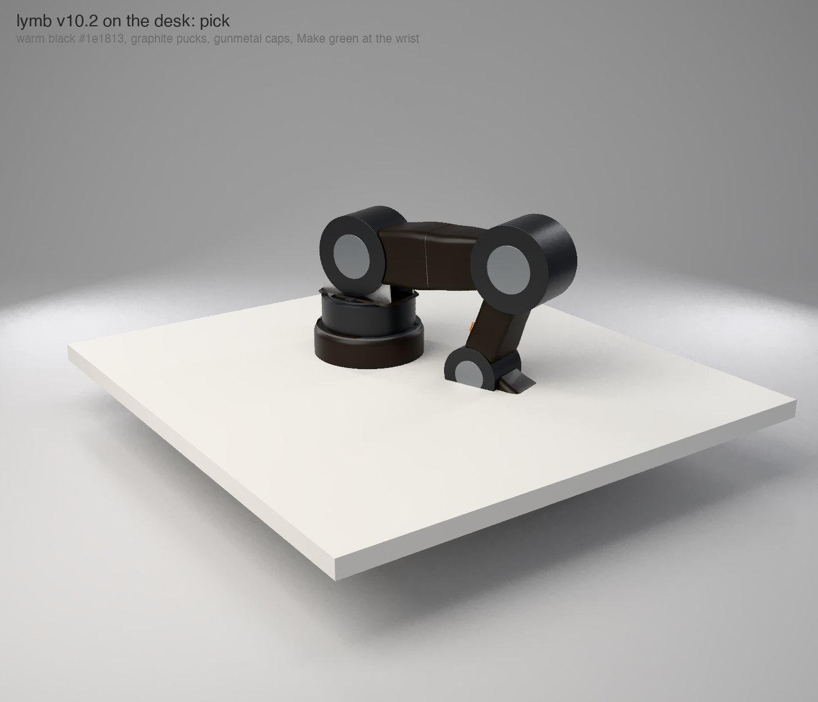
arm/render/lymb-v10.2-desk-pick.png
