muni-works/rose/arm/render/lymb-v10.2-desk-side.png

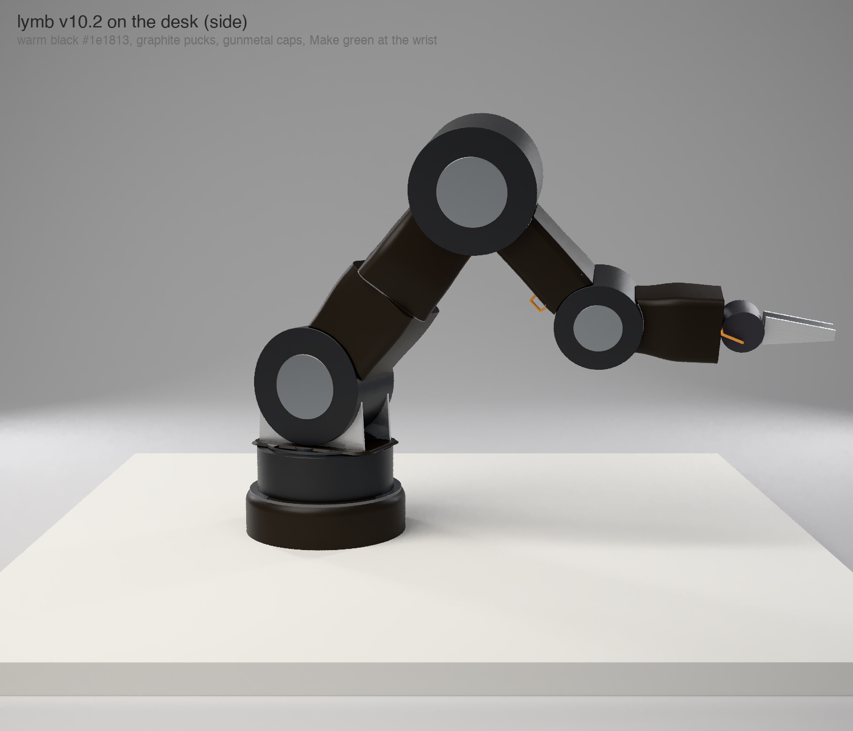
arm/render/lymb-v10.2-desk-side.png
