muni-works/rose/arm/render/lymb-v10.2-elbow-closeup.png

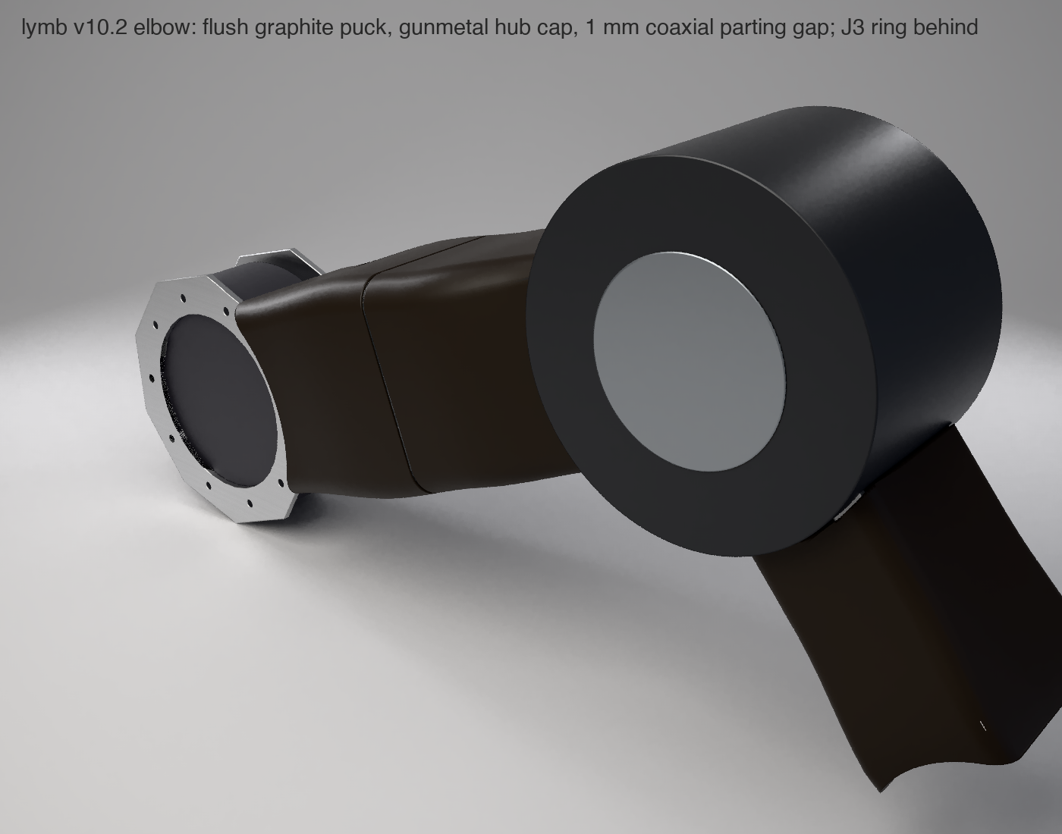
arm/render/lymb-v10.2-elbow-closeup.png
