muni-works/rose/arm/render/lymb-v10.2-humanoid-34.png

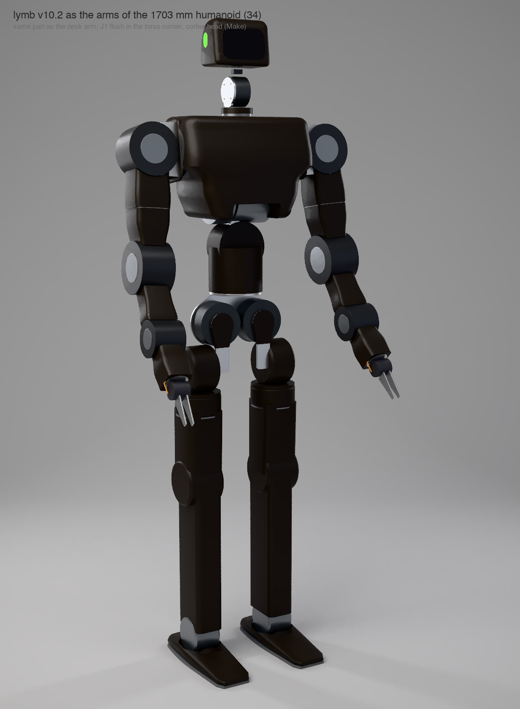
arm/render/lymb-v10.2-humanoid-34.png
