muni-works/rose/arm/render/lymb-v10.2-humanoid-carry.png

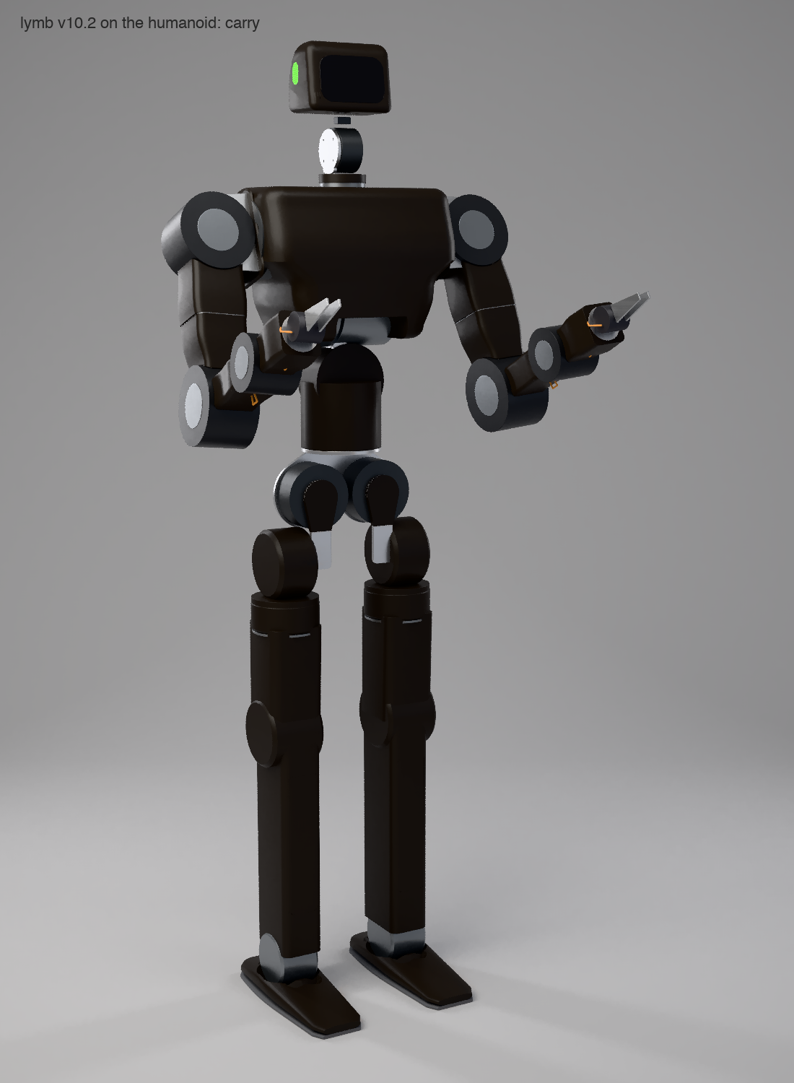
arm/render/lymb-v10.2-humanoid-carry.png
