muni-works/rose/arm/render/lymb-v10.2-humanoid-front.png

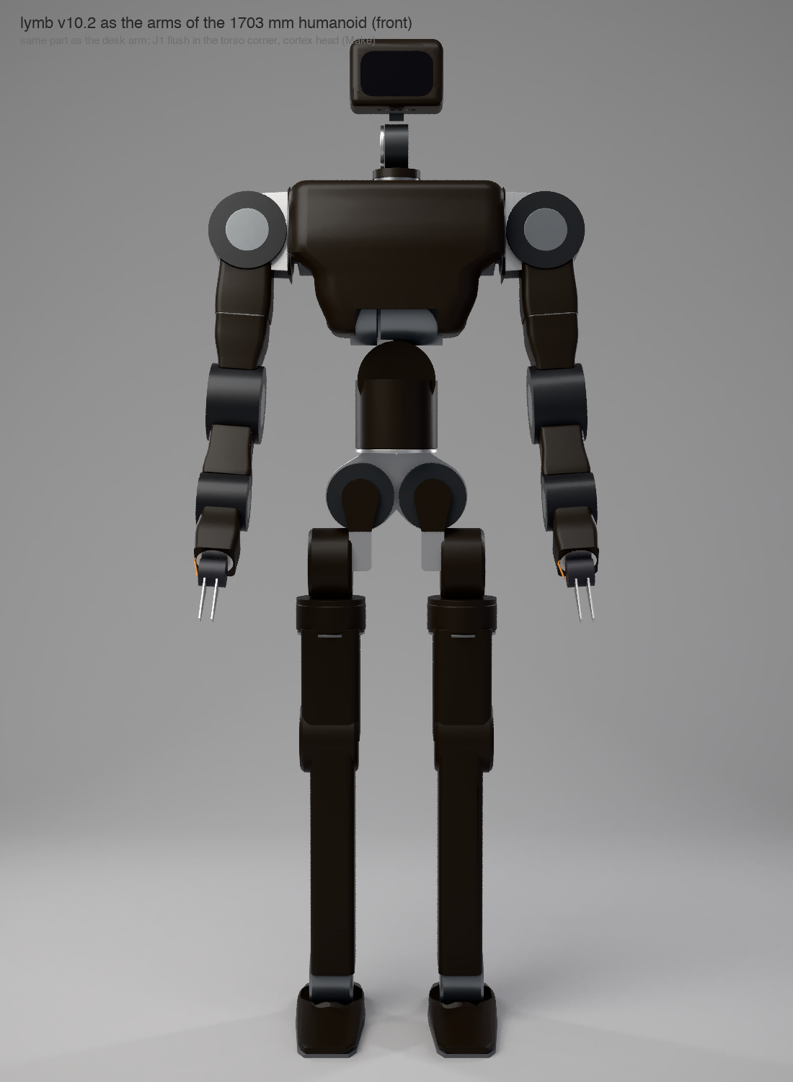
arm/render/lymb-v10.2-humanoid-front.png
