muni-works/rose/arm/render/lymb-v10.2-humanoid-reach.png

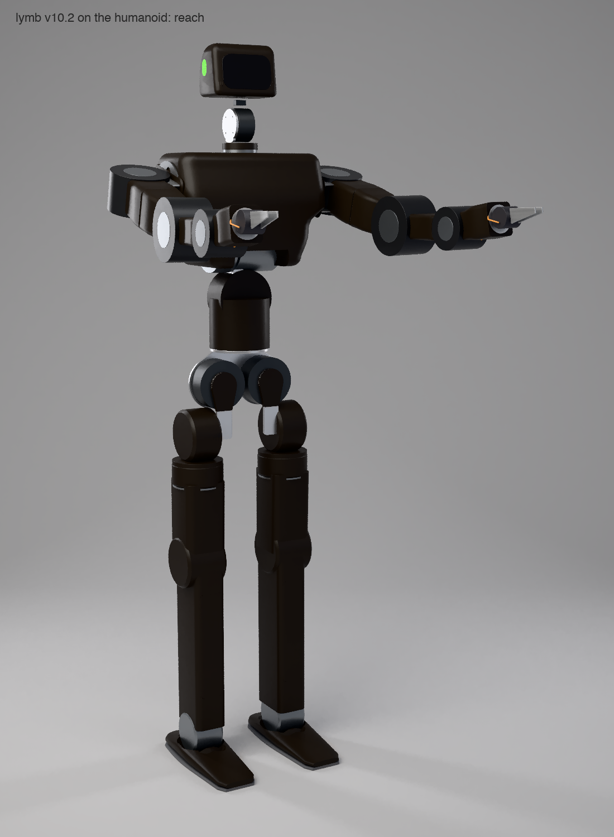
arm/render/lymb-v10.2-humanoid-reach.png
