muni-works/rose/arm/render/lymb-v10.2-humanoid-side.png

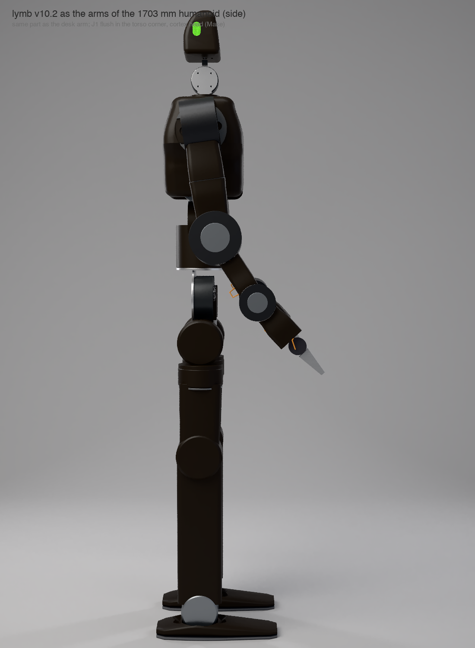
arm/render/lymb-v10.2-humanoid-side.png
