muni-works/rose/arm/render/lymb-v10.2-shoulder-j1m90.png

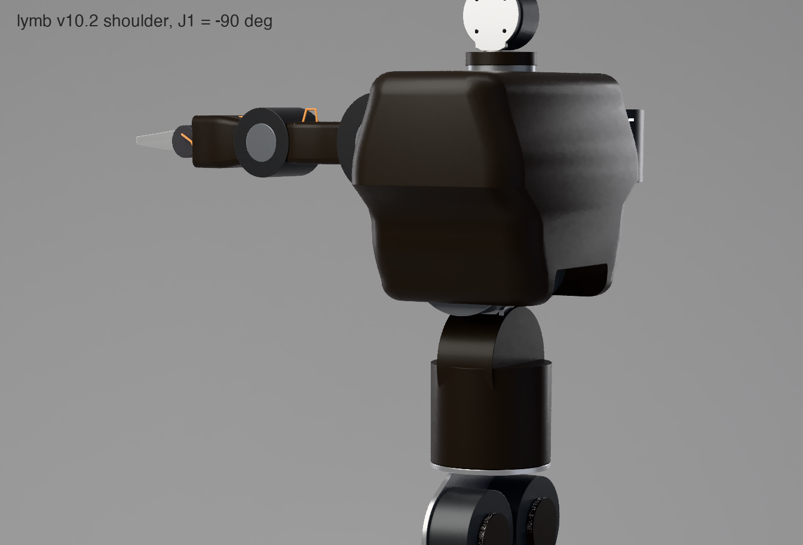
arm/render/lymb-v10.2-shoulder-j1m90.png
