muni-works/rose/arm/render/lymb-v10.3-elbow-closeup.png

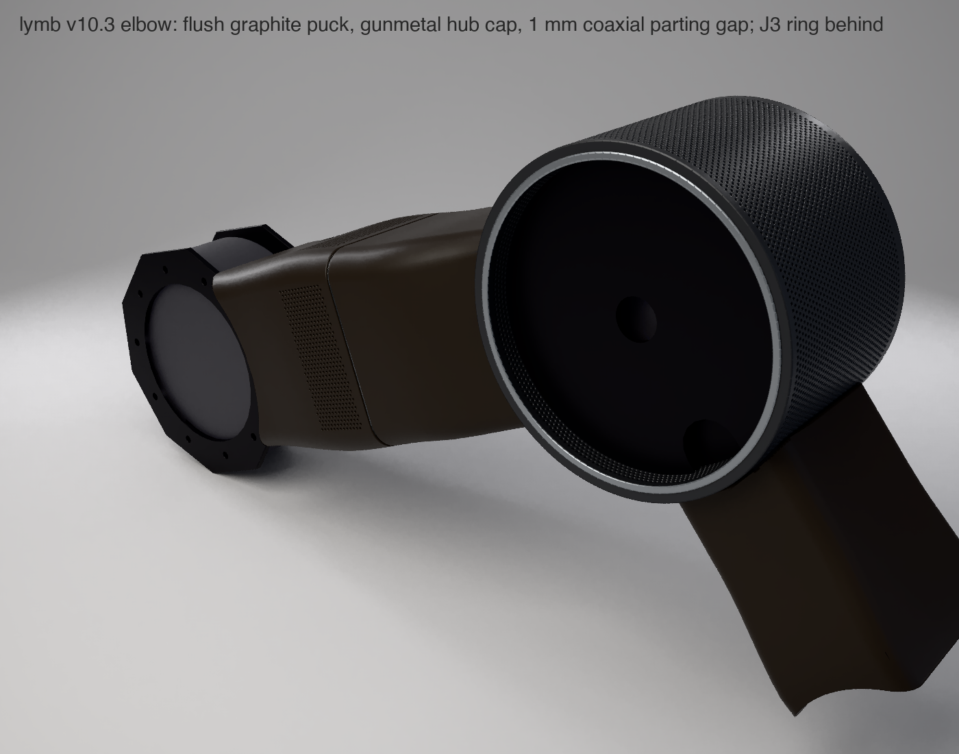
arm/render/lymb-v10.3-elbow-closeup.png
