muni-works/rose/arm/render/lymb-v10.4-humanoid-34-torso3.png

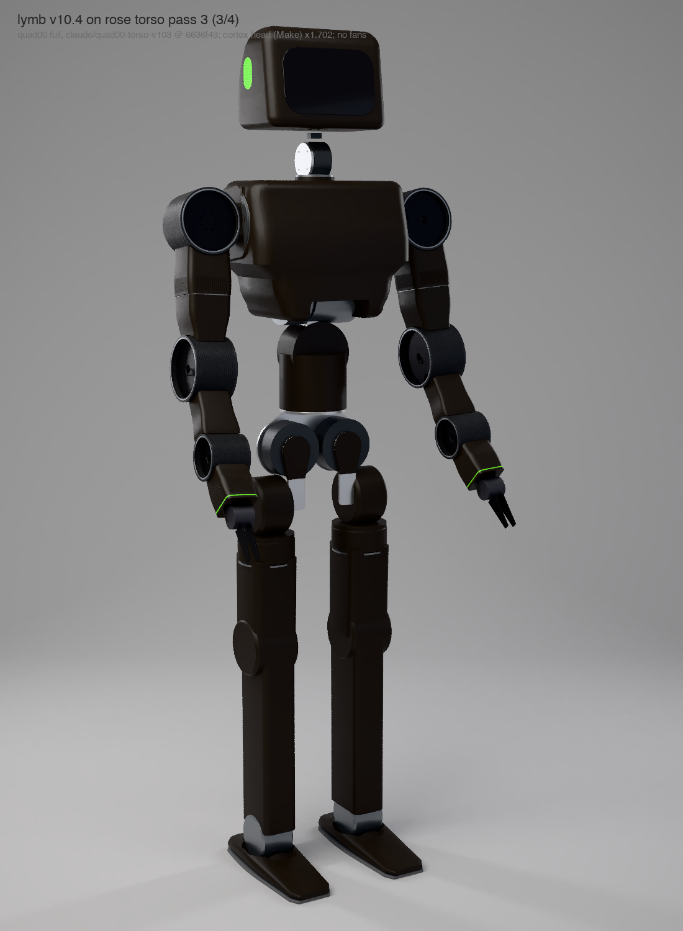
arm/render/lymb-v10.4-humanoid-34-torso3.png
