muni-works/rose/arm/render/lymb-v10.5-biceps-j3p90.png

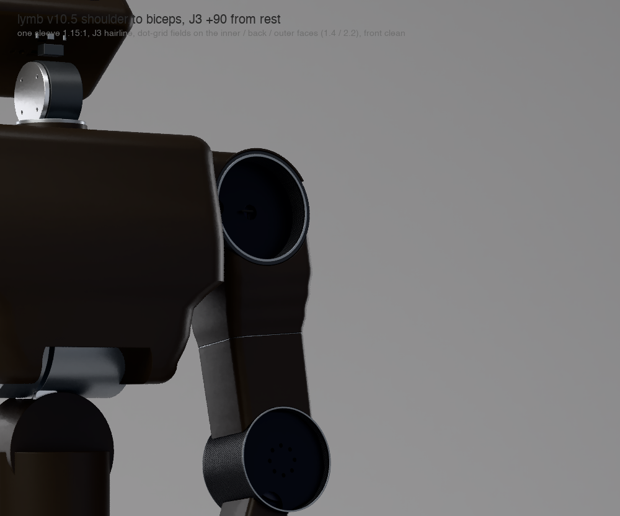
arm/render/lymb-v10.5-biceps-j3p90.png
