muni-works/rose/arm/render/lymb-v10.5-biceps-outer-grazing.png

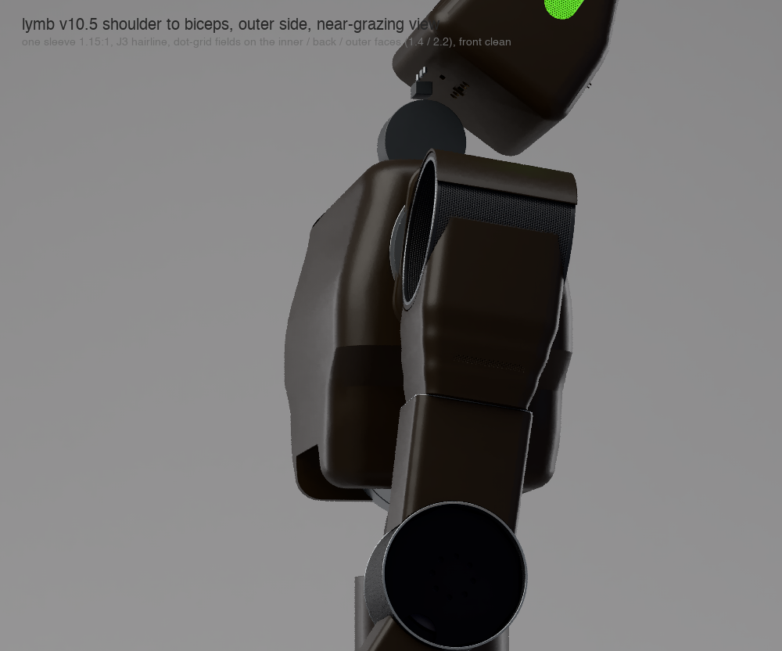
arm/render/lymb-v10.5-biceps-outer-grazing.png
