muni-works/rose/arm/render/lymb-v10.5-biceps-rest.png

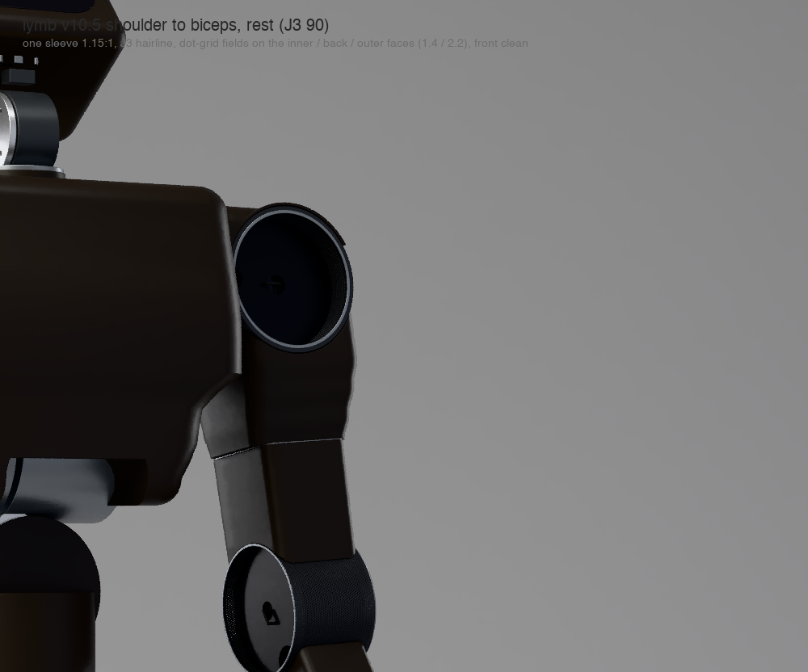
arm/render/lymb-v10.5-biceps-rest.png
