muni-works/rose/arm/render/lymb-v10.5-humanoid-side.png

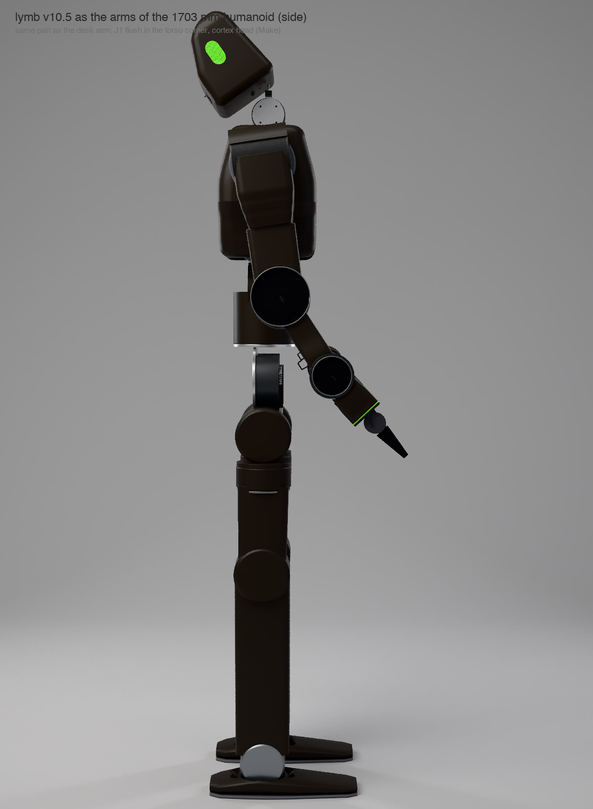
arm/render/lymb-v10.5-humanoid-side.png
