muni-works/rose/arm/render/lymb-v10.8-black-neck-closeup.png

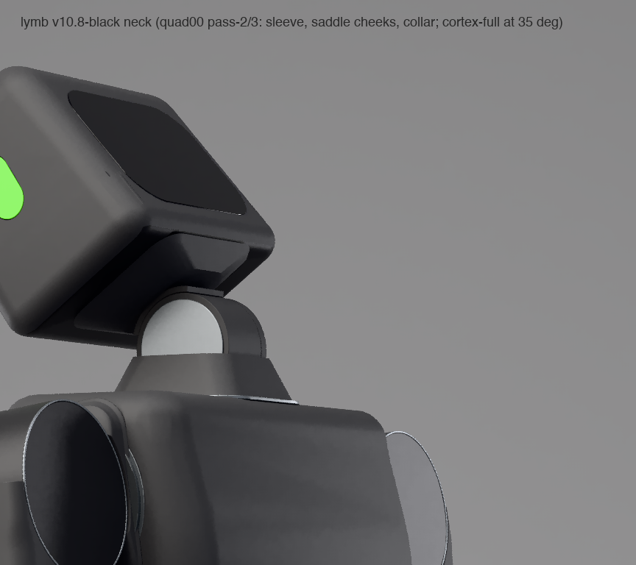
arm/render/lymb-v10.8-black-neck-closeup.png
