muni-works/rose/arm/render/lymb-v10.8-white-humanoid-34.png

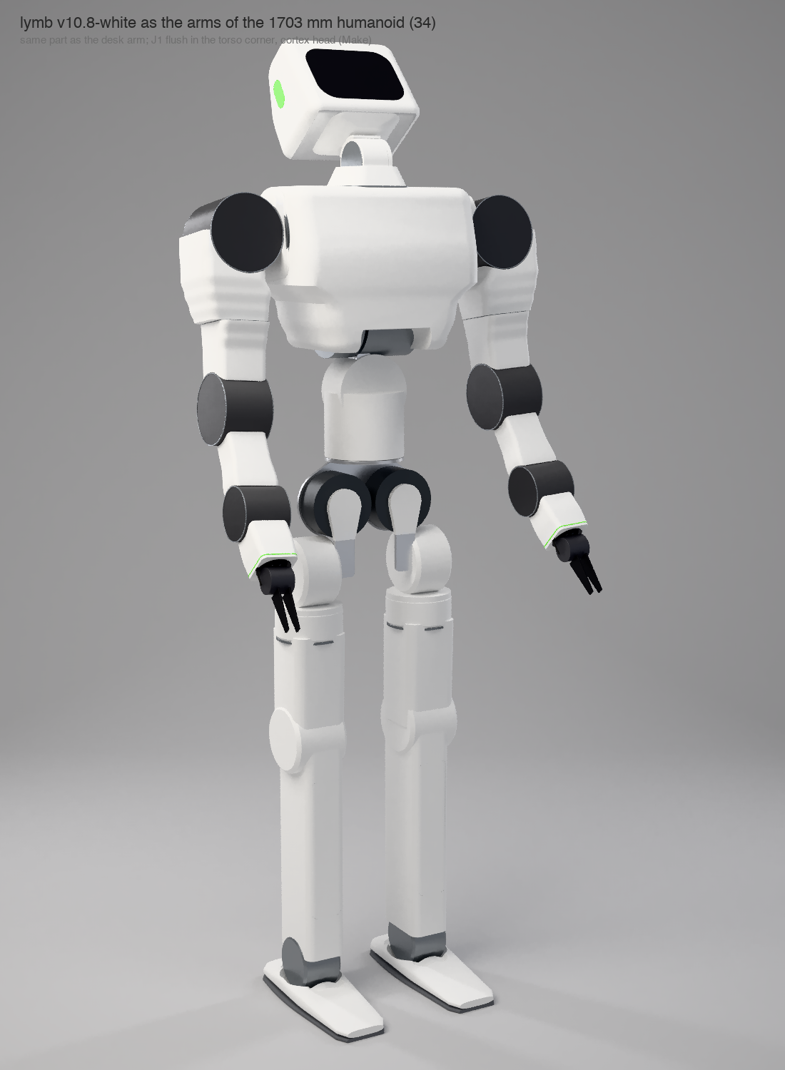
arm/render/lymb-v10.8-white-humanoid-34.png
