muni-works/rose/arm/render/lymb-v10.8-white-humanoid-front.png

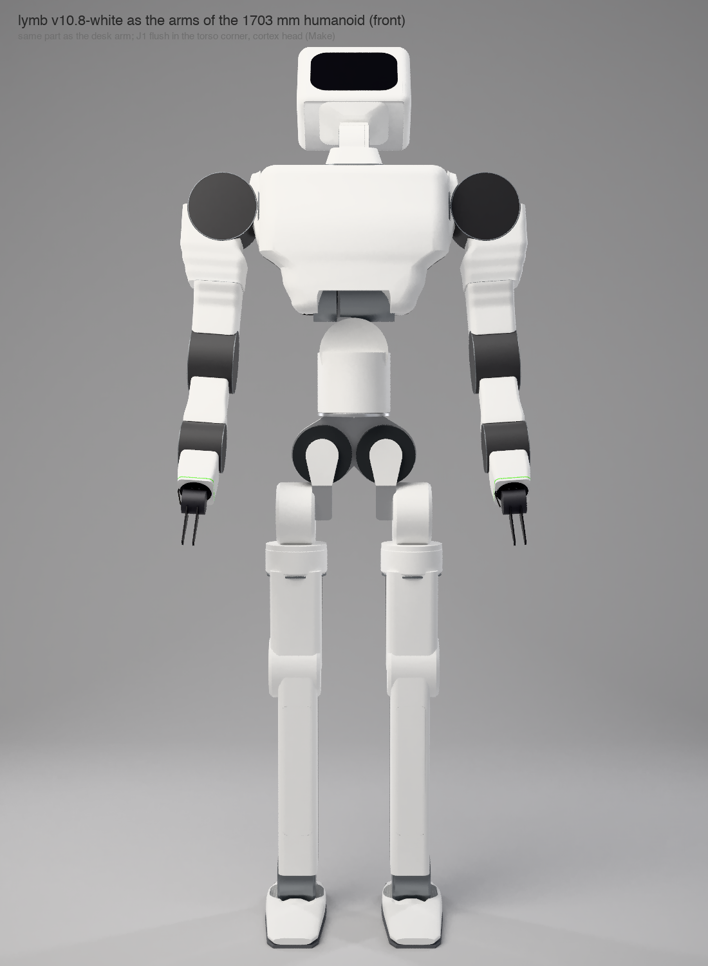
arm/render/lymb-v10.8-white-humanoid-front.png
