muni-works/rose/arm/render/lymb-v10.8-white-humanoid-side.png

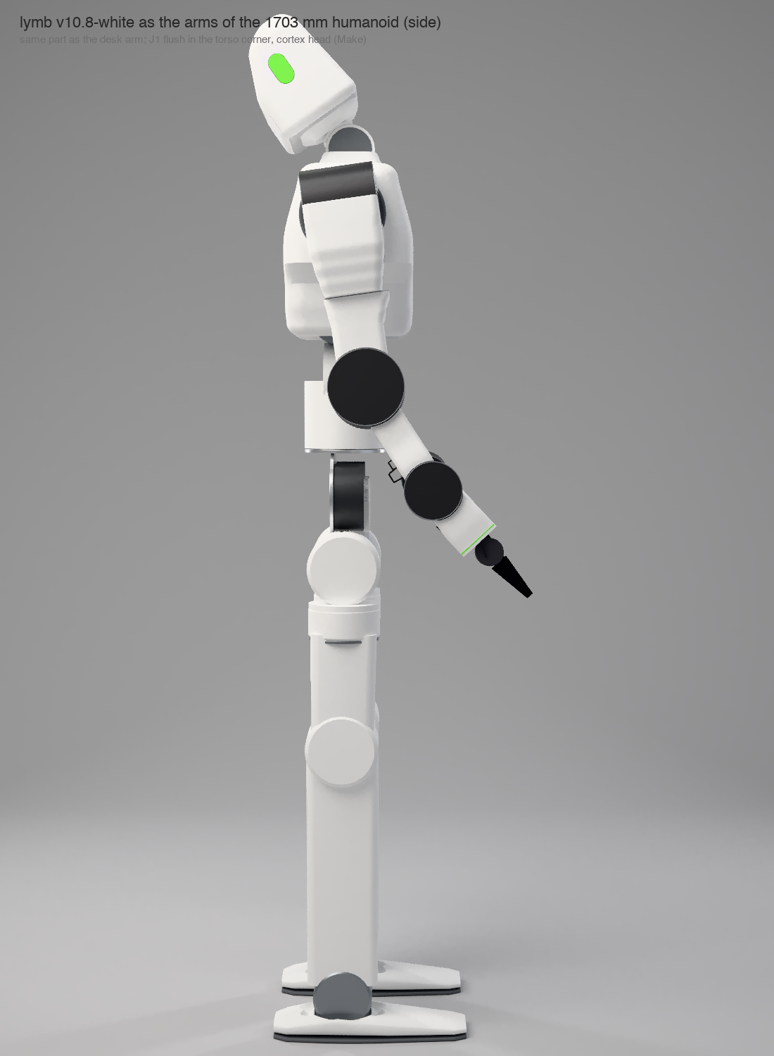
arm/render/lymb-v10.8-white-humanoid-side.png
