muni-works/rose/arm/render/lymb-v10.8-white-neck-closeup.png

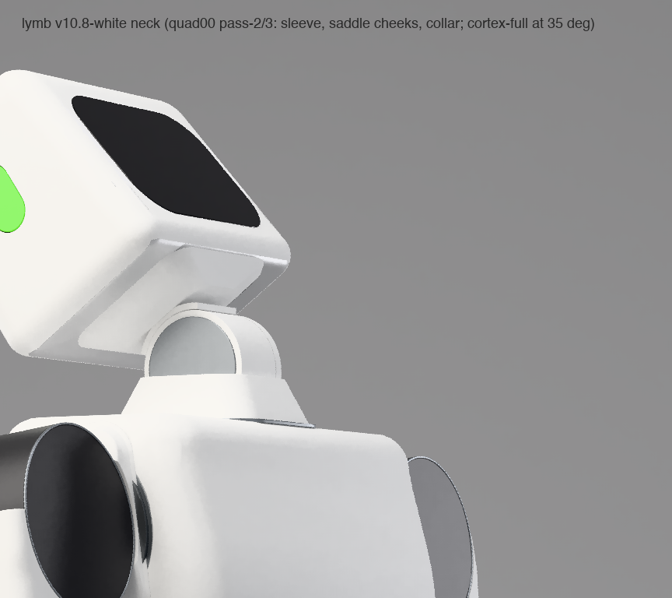
arm/render/lymb-v10.8-white-neck-closeup.png
