muni-works/rose/arm/render/mini-compare-iso.png

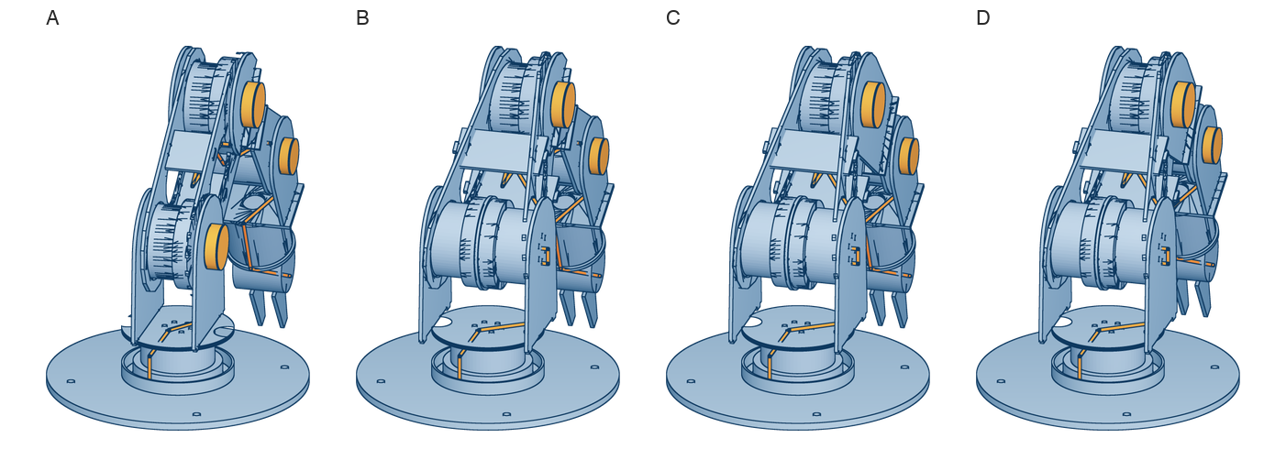
arm/render/mini-compare-iso.png
