muni-works/rose/arm/render/mini-compare.png

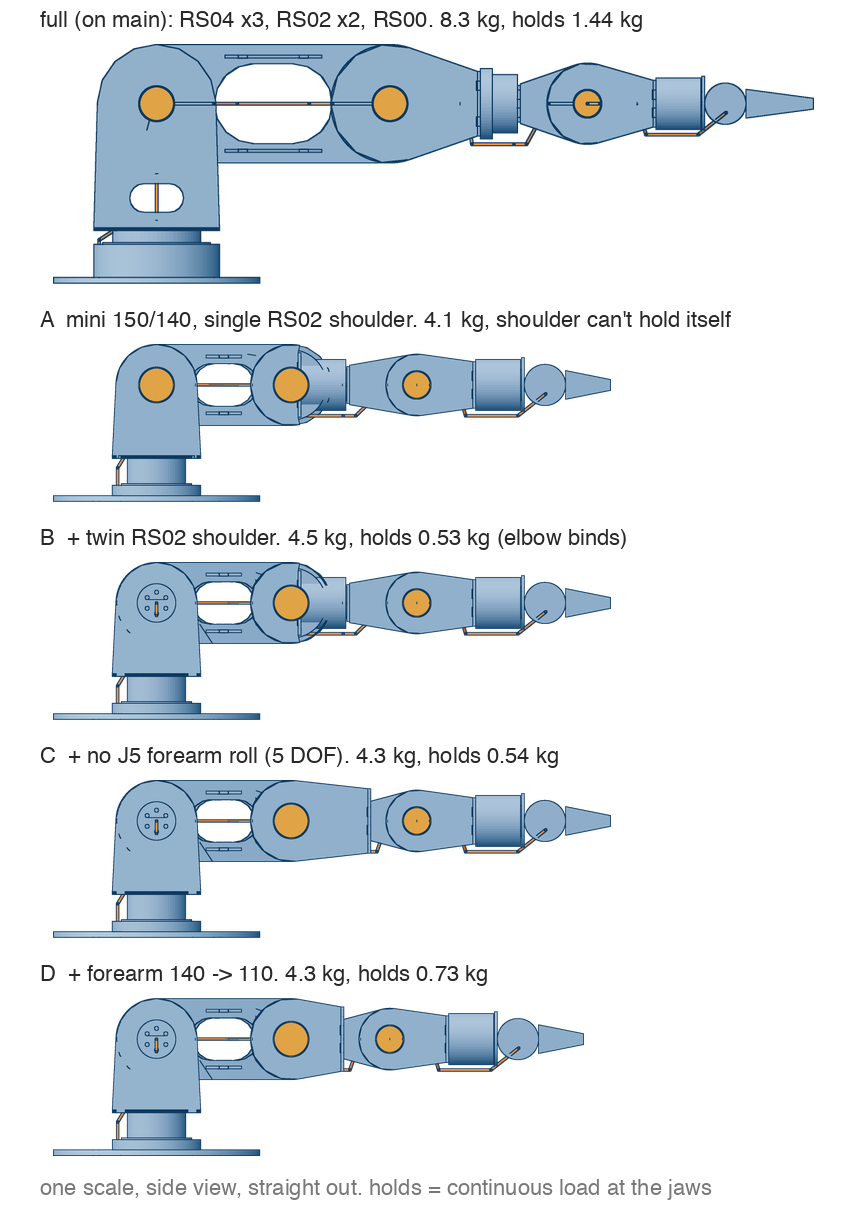
arm/render/mini-compare.png
