muni-works/rose/arm/render/rose-arms.png

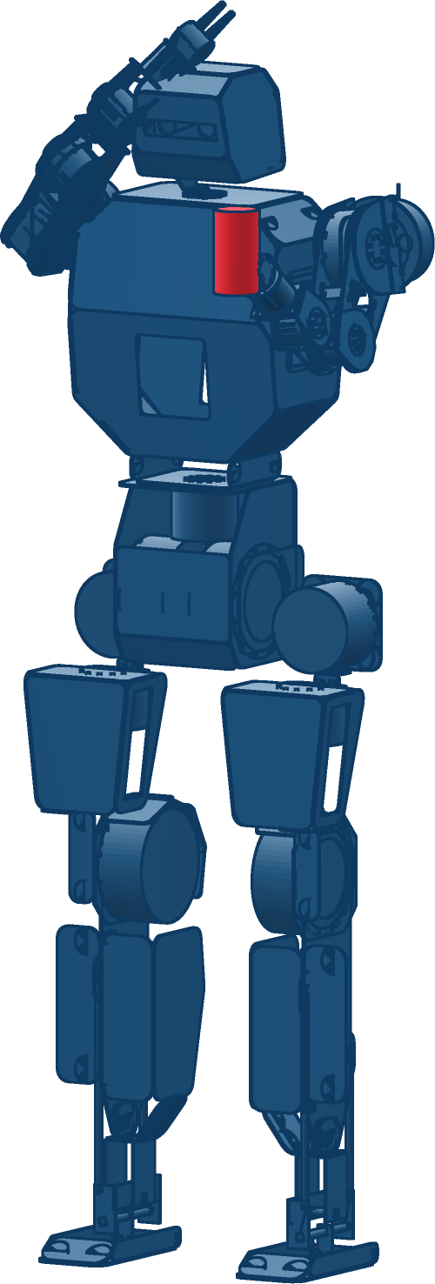
arm/render/rose-arms.png
