muni-works/rose/body/renders/body-node/duet-front.png

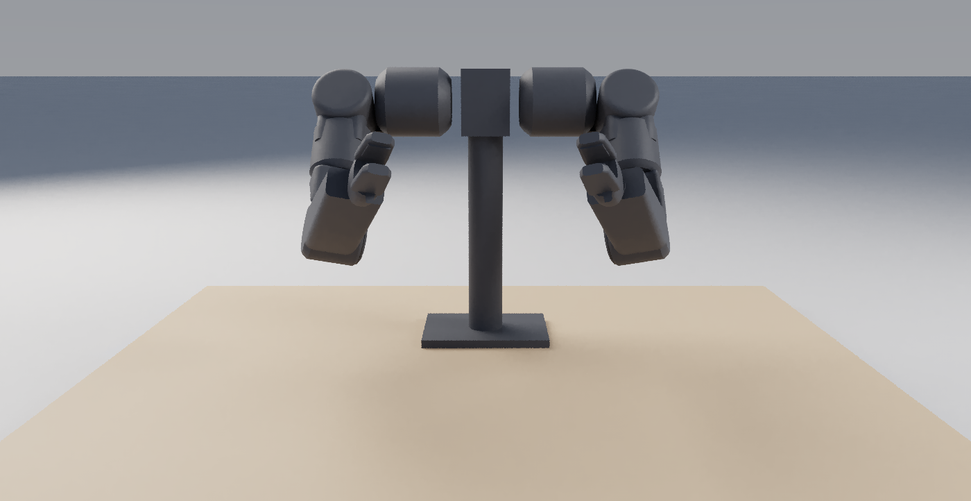
body/renders/body-node/duet-front.png
