muni-works/rose/body/renders/body-node/duet-hero.png

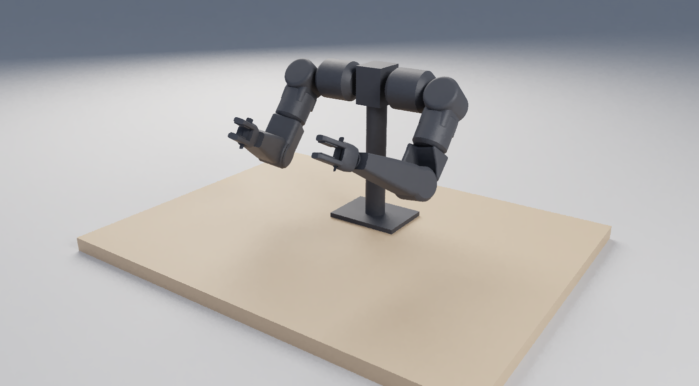
body/renders/body-node/duet-hero.png
