muni-works/rose/body/renders/body-node/full-front.png

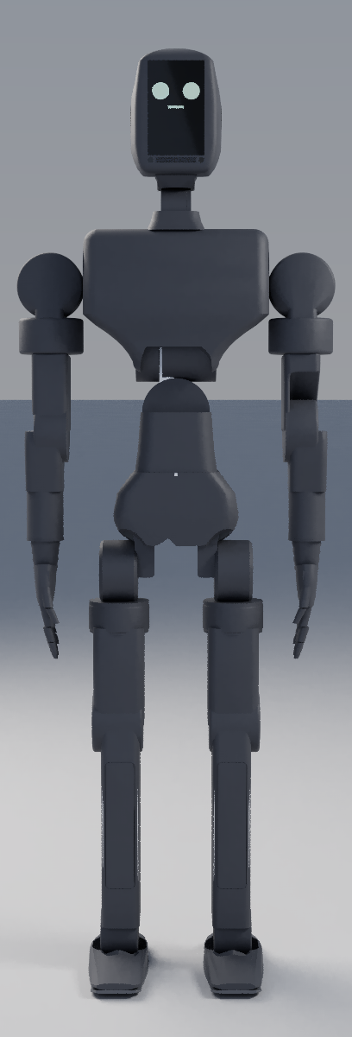
body/renders/body-node/full-front.png
