muni-works/rose/body/renders/body-node/full-side.png

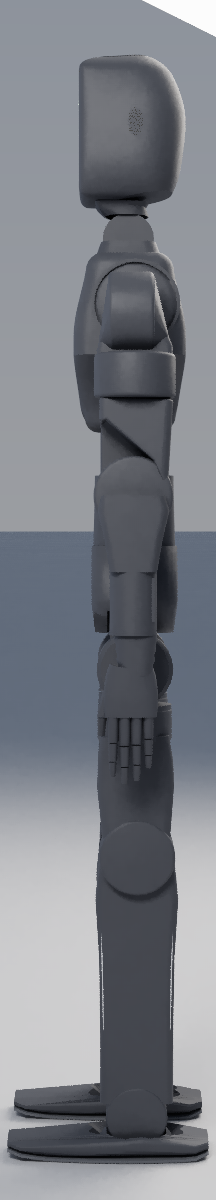
body/renders/body-node/full-side.png
