muni-works/rose/body/renders/body-node/hand-full-alone.png

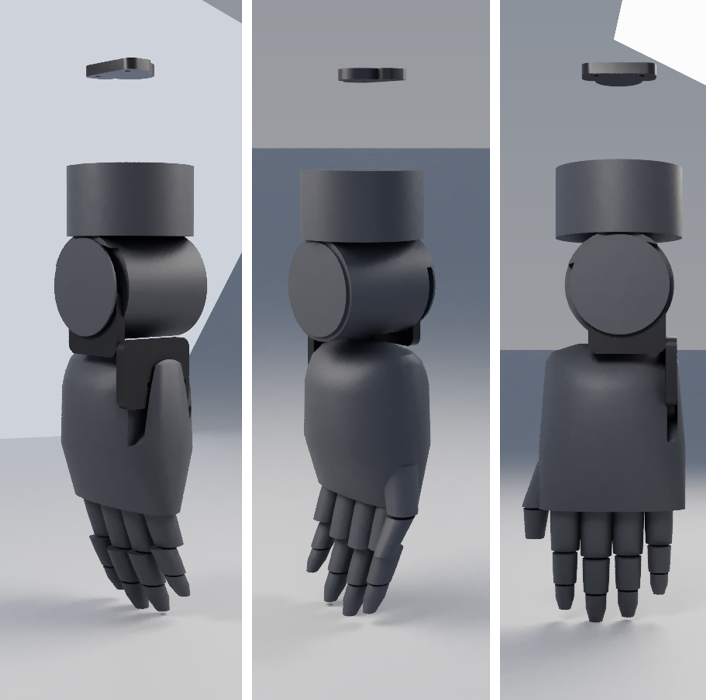
body/renders/body-node/hand-full-alone.png
