muni-works/rose/body/renders/body-node/hand-full-ujoint.png

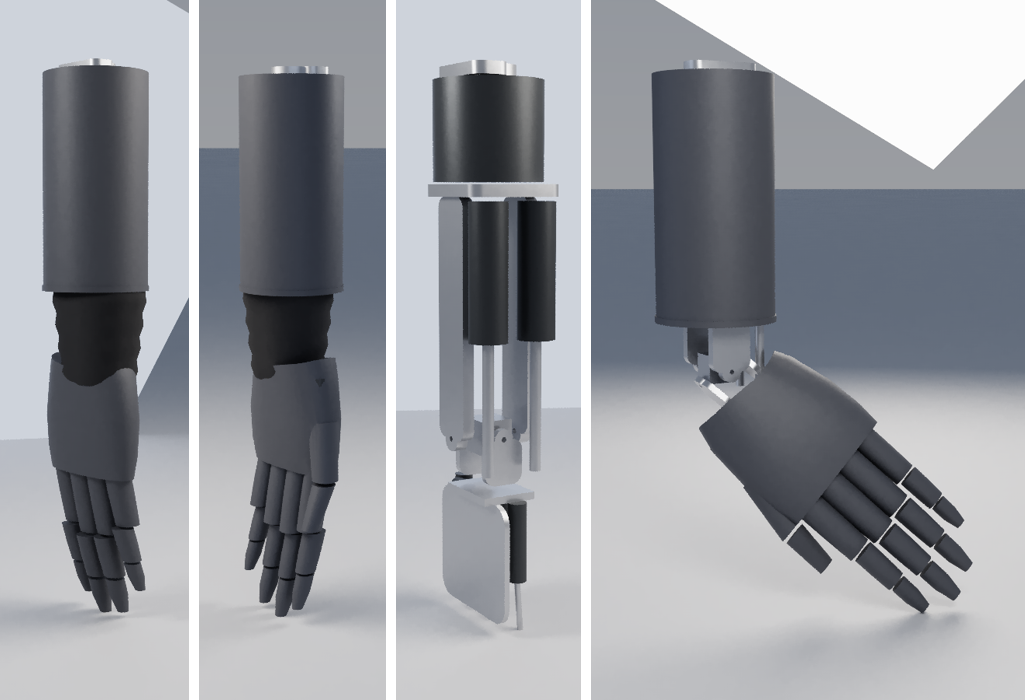
body/renders/body-node/hand-full-ujoint.png
