muni-works/rose/body/renders/body-node/hand-grasp-frames.png

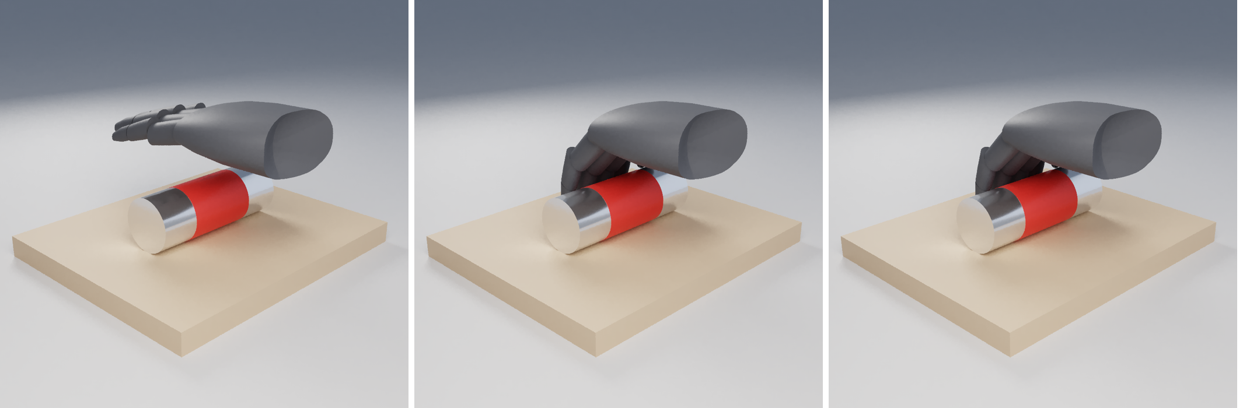
body/renders/body-node/hand-grasp-frames.png
