muni-works/rose/body/renders/body-node/hands-full.png

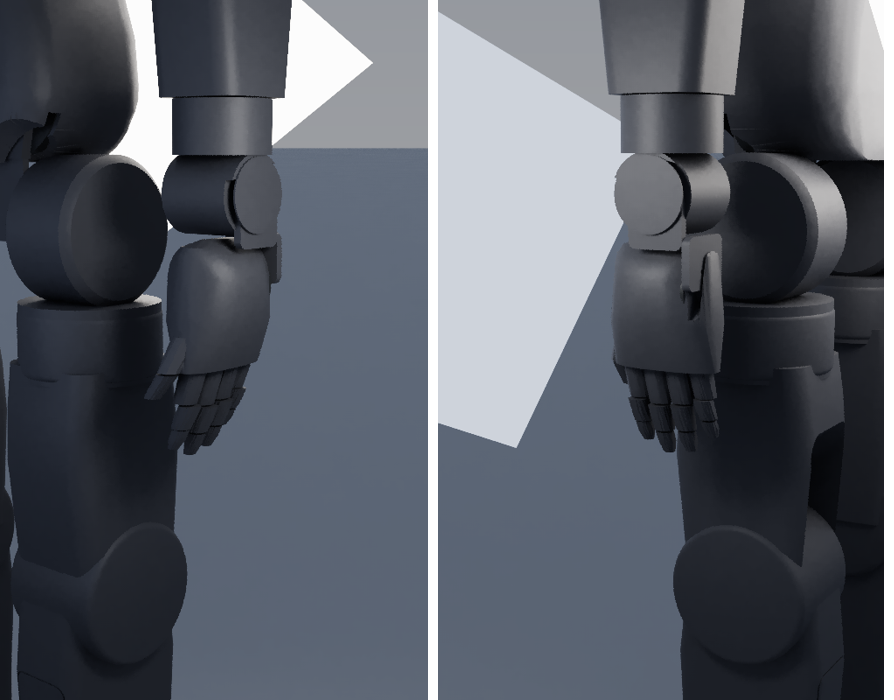
body/renders/body-node/hands-full.png
