muni-works/rose/body/renders/body-node/hands-mini.png

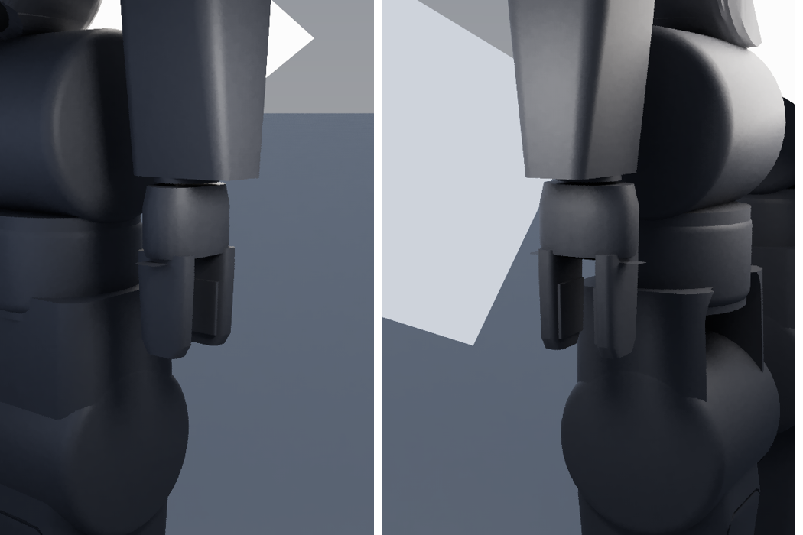
body/renders/body-node/hands-mini.png
