muni-works/rose/body/renders/body-node/heads-jaw.png

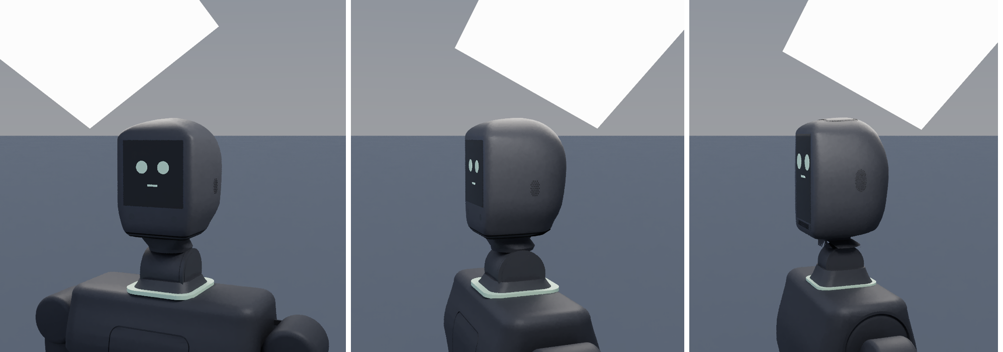
body/renders/body-node/heads-jaw.png
