muni-works/rose/body/renders/body-node/mini-bare-34.png

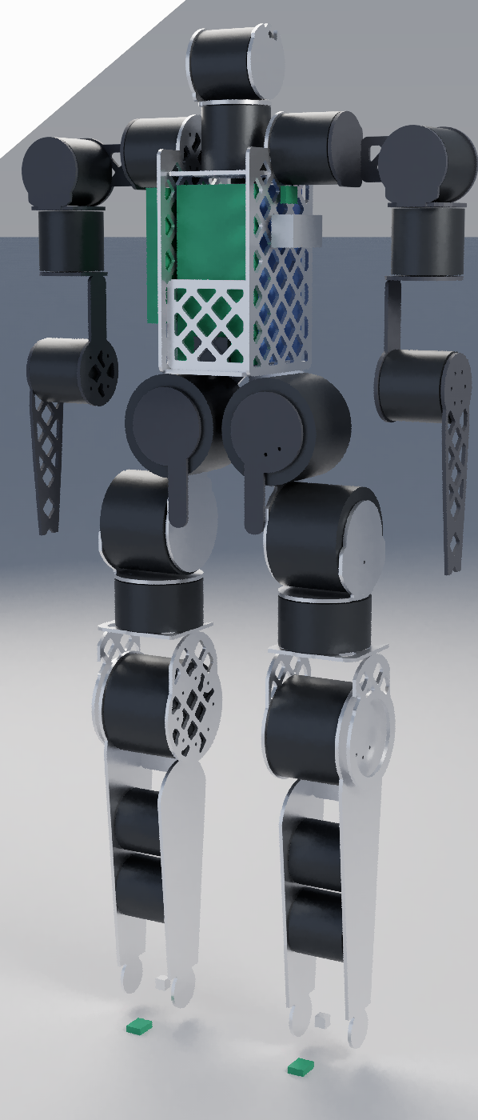
body/renders/body-node/mini-bare-34.png
