muni-works/rose/body/renders/body-node/mini-bare-back.png

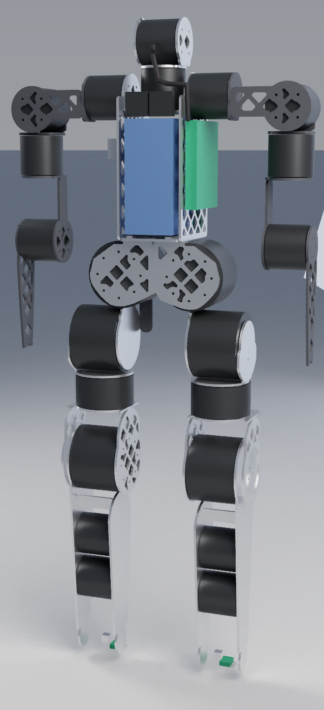
body/renders/body-node/mini-bare-back.png
