muni-works/rose/body/renders/body-node/mini-bare-front.png

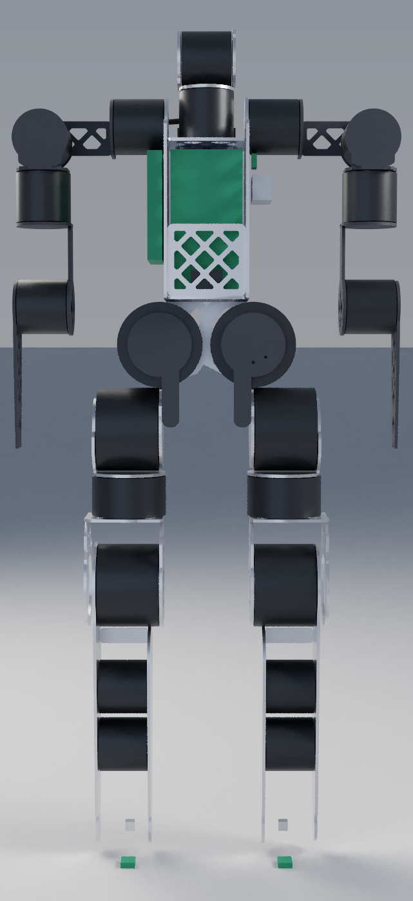
body/renders/body-node/mini-bare-front.png
