muni-works/rose/body/renders/body-node/mini-bare.png

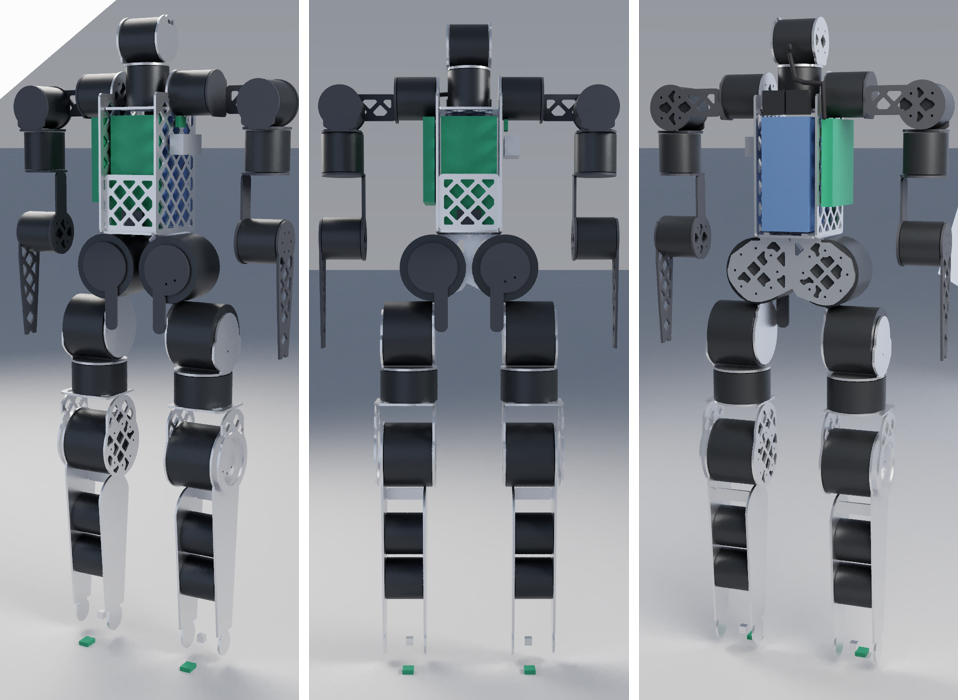
body/renders/body-node/mini-bare.png
