muni-works/rose/body/renders/body-node/mini-exploded-34.png

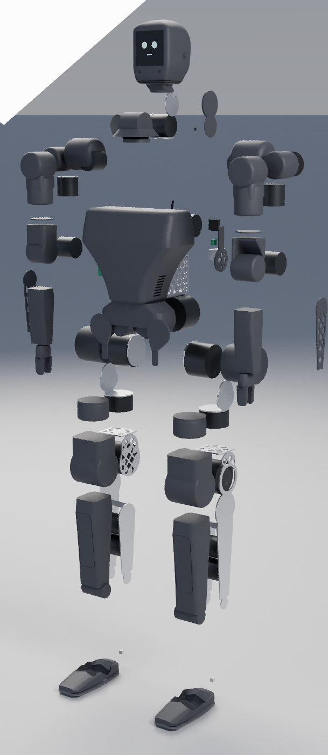
body/renders/body-node/mini-exploded-34.png
