muni-works/rose/body/renders/body-node/mini-exploded-back.png

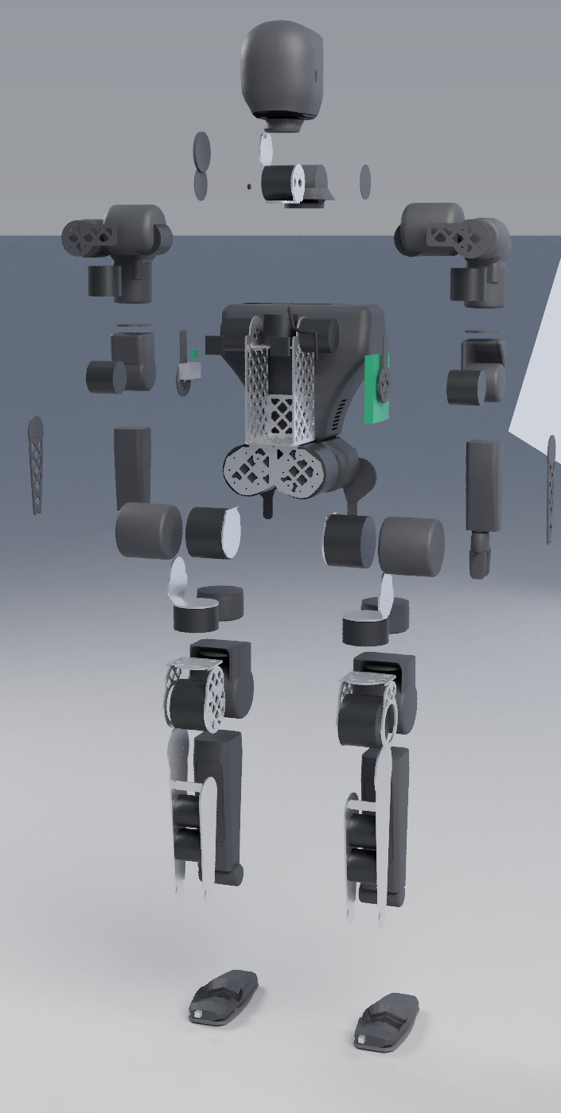
body/renders/body-node/mini-exploded-back.png
