muni-works/rose/body/renders/body-node/mini-exploded-front.png

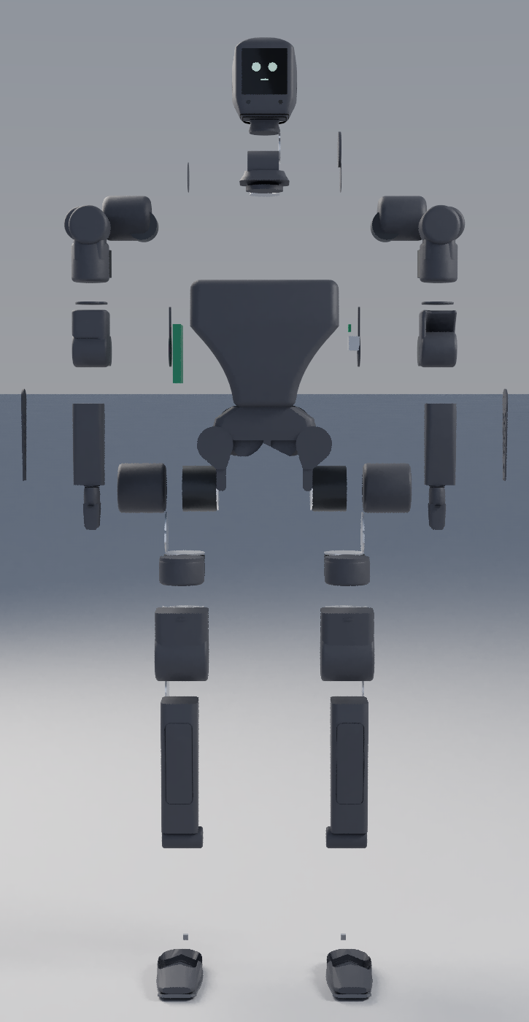
body/renders/body-node/mini-exploded-front.png
