muni-works/rose/body/renders/body-node/mini-exploded.png

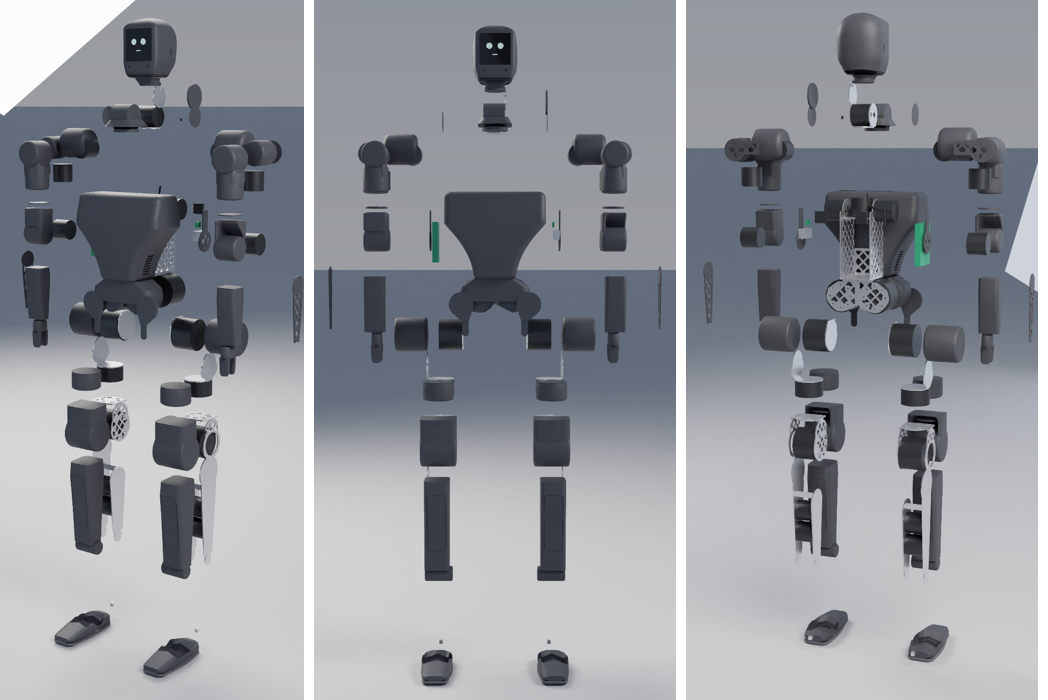
body/renders/body-node/mini-exploded.png
