muni-works/rose/body/renders/body-node/mini-front.png

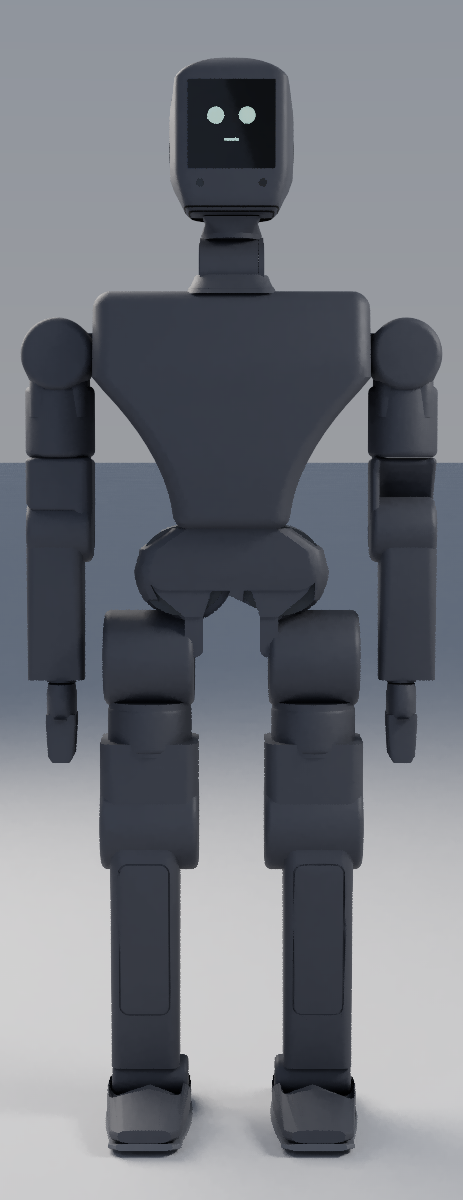
body/renders/body-node/mini-front.png
