muni-works/rose/body/renders/body-node/mini-side.png

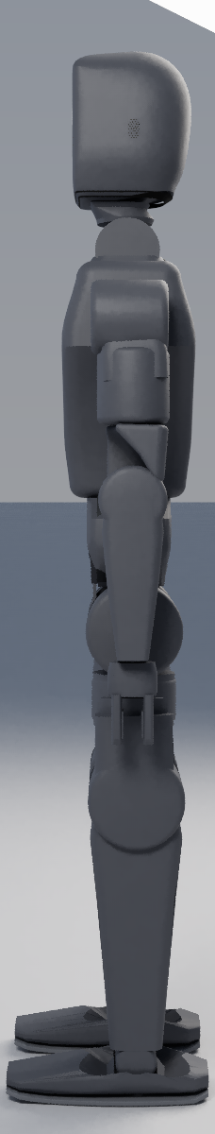
body/renders/body-node/mini-side.png
