muni-works/rose/body/renders/body-node/mini-vs-k1-34.png

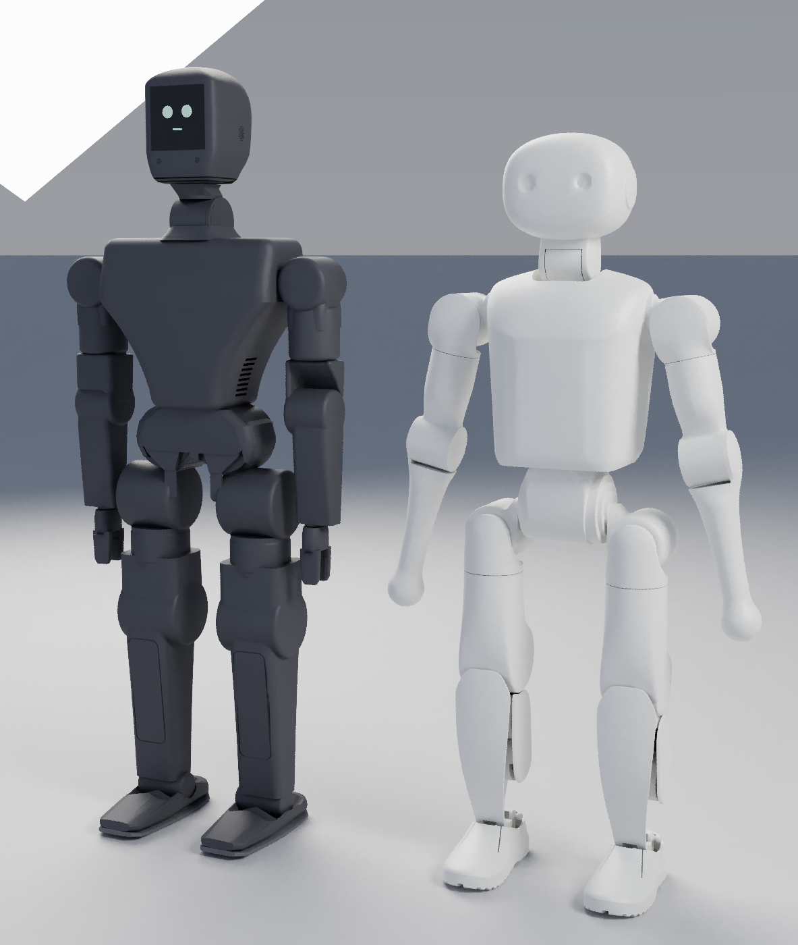
body/renders/body-node/mini-vs-k1-34.png
