muni-works/rose/body/renders/body-node/mini-vs-k1-front.png

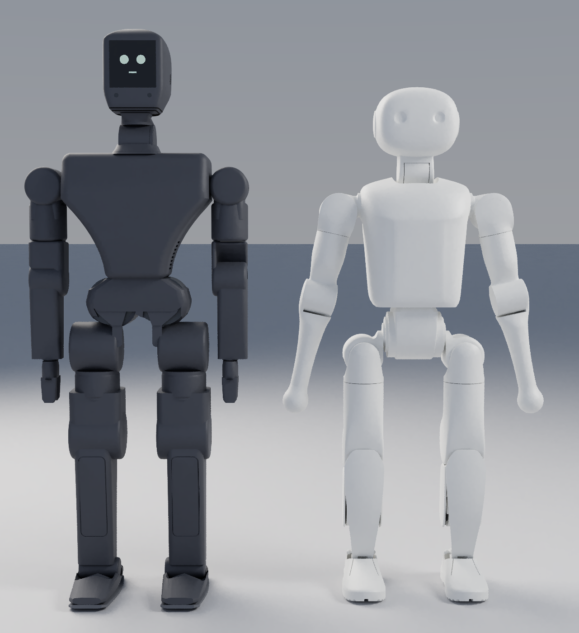
body/renders/body-node/mini-vs-k1-front.png
