muni-works/rose/body/renders/body-node/mini-vs-k1-side.png

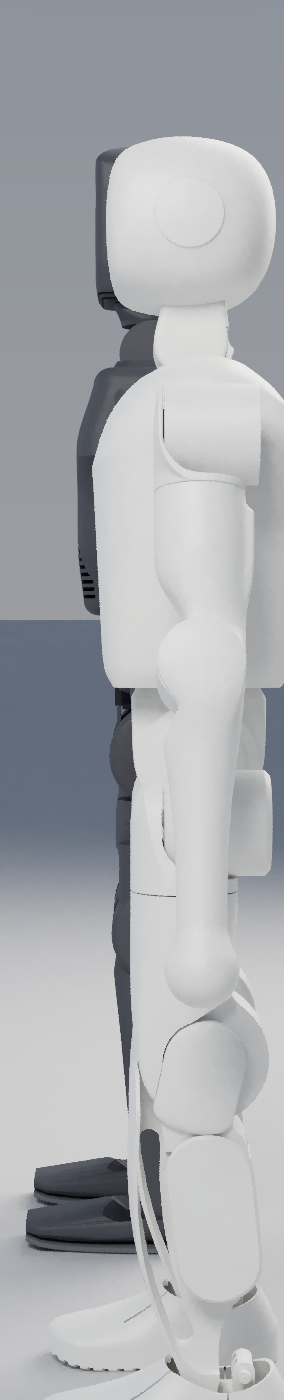
body/renders/body-node/mini-vs-k1-side.png
