muni-works/rose/body/renders/body-node/mini-vs-k1.png

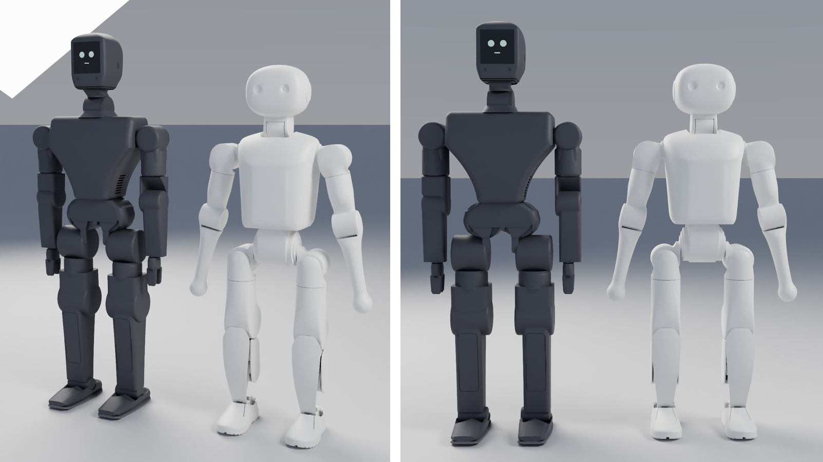
body/renders/body-node/mini-vs-k1.png
