muni-works/rose/body/renders/body-node/sheet.png

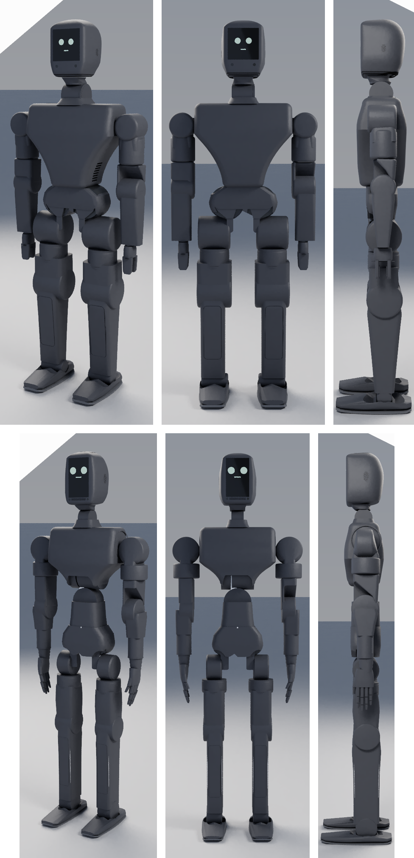
body/renders/body-node/sheet.png
