muni-works/rose/body/renders/body-node/torso-pass-preview.png

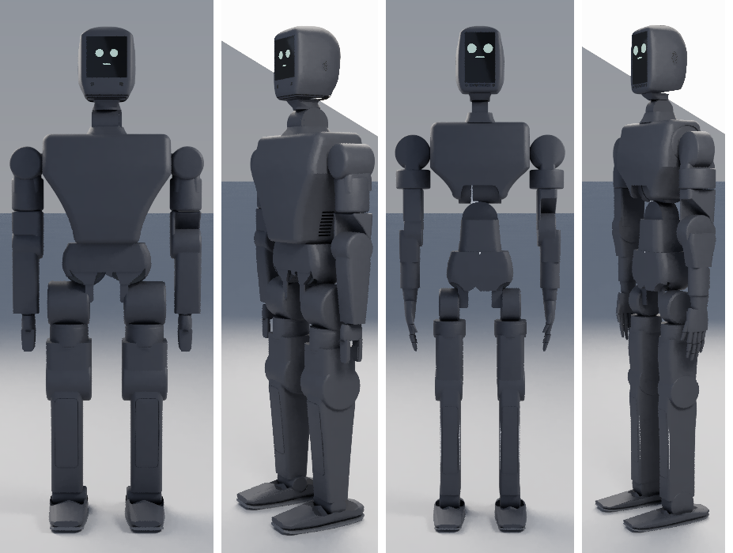
body/renders/body-node/torso-pass-preview.png
