muni-works/rose/body/renders/deep-mini/deep-mini-cutaway.png

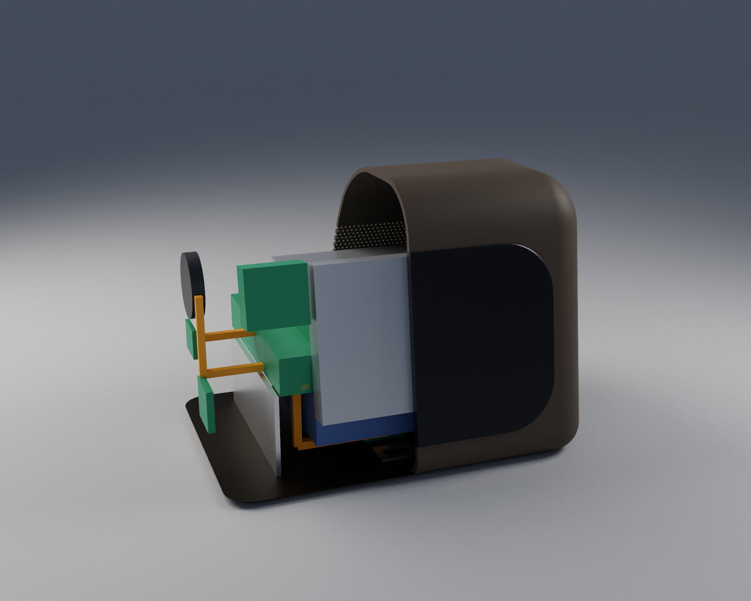
body/renders/deep-mini/deep-mini-cutaway.png
