muni-works/rose/body/renders/deep-mini/minis-vs-full-34.png

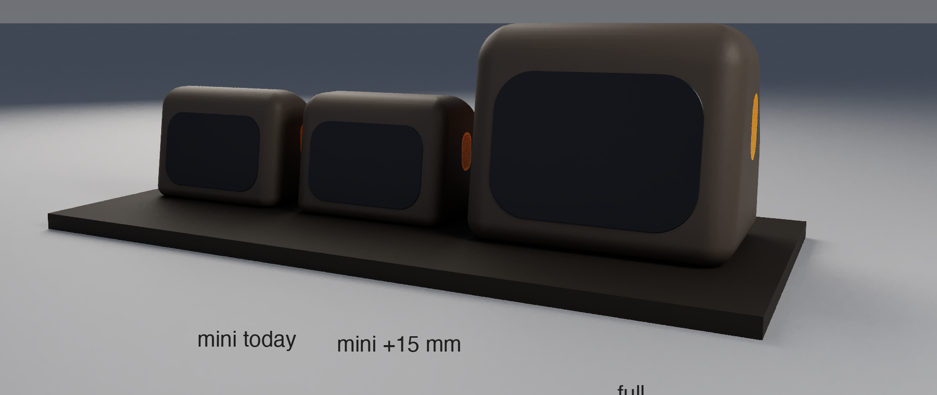
body/renders/deep-mini/minis-vs-full-34.png
