muni-works/rose/body/renders/deep-mini/minis-vs-full-side.png

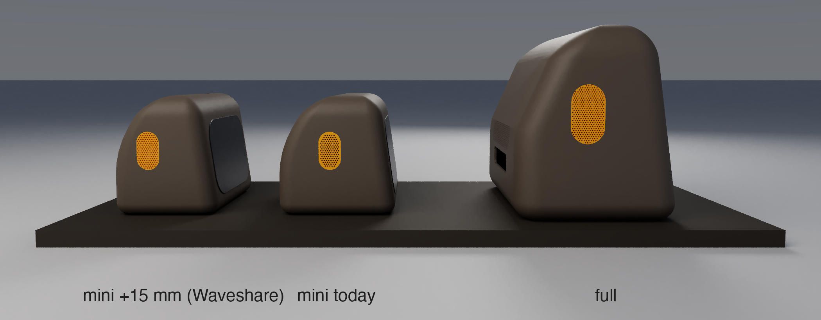
body/renders/deep-mini/minis-vs-full-side.png
