muni-works/rose/body/renders/lineup/humanoid-lineup.png

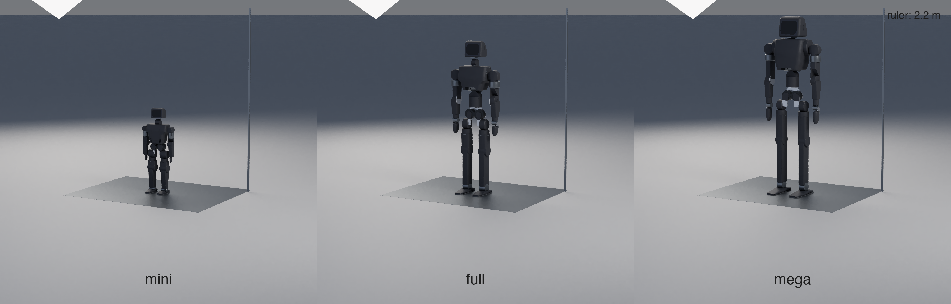
body/renders/lineup/humanoid-lineup.png
