muni-works/rose/body/renders/lineup/lineup-full.png

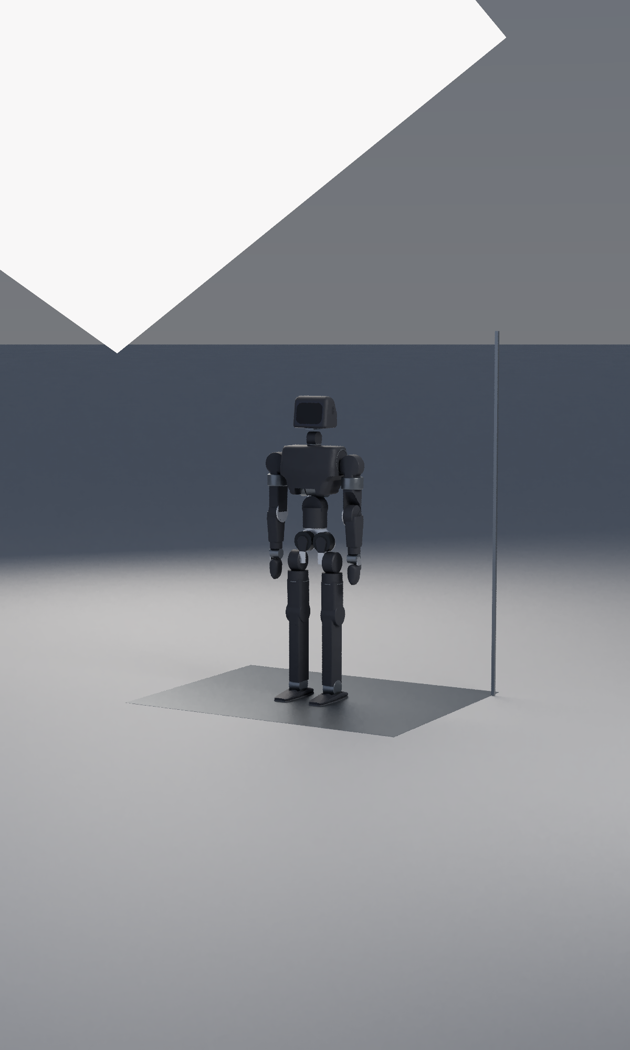
body/renders/lineup/lineup-full.png
