muni-works/rose/body/renders/neck/full-34-pitch0.png

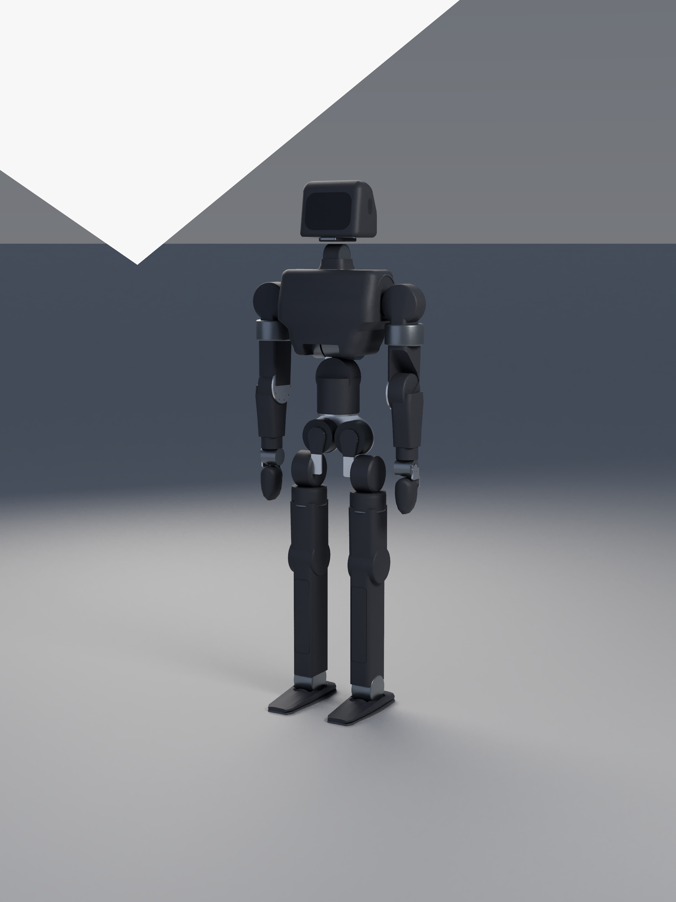
body/renders/neck/full-34-pitch0.png
