muni-works/rose/body/renders/neck/neck-closeup-pitch0.png

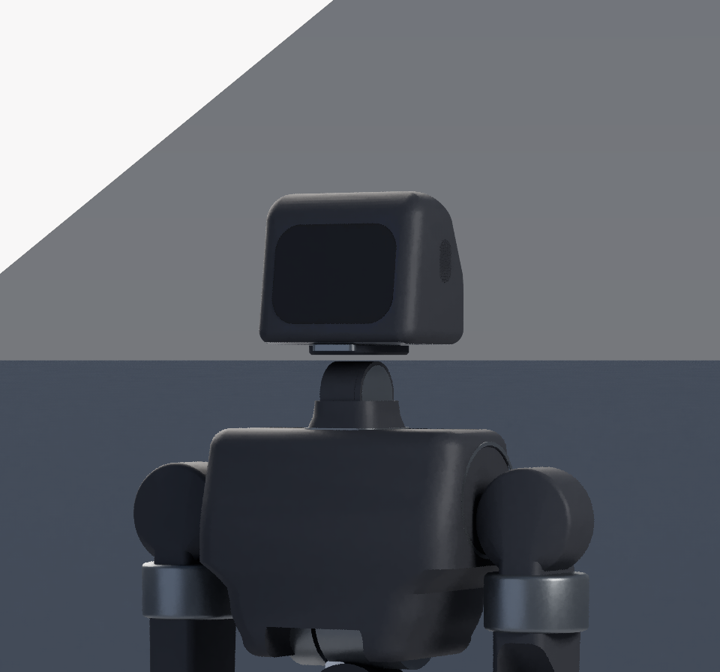
body/renders/neck/neck-closeup-pitch0.png
