muni-works/rose/body/renders/neck/neck-closeup-pitch35.png

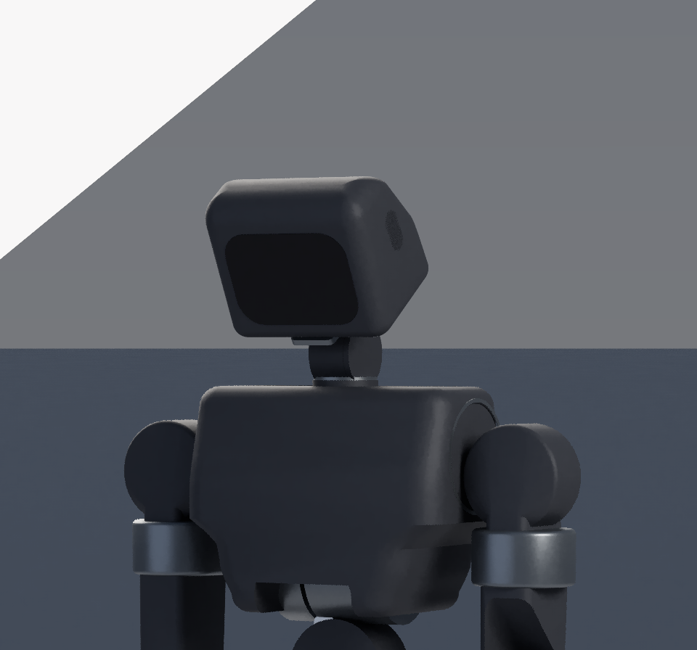
body/renders/neck/neck-closeup-pitch35.png
