muni-works/rose/body/renders/neck/pass3-neck-closeup-pitch35.png

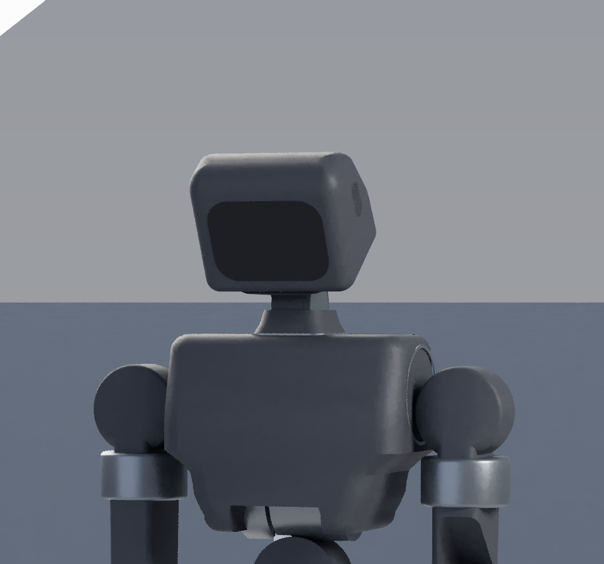
body/renders/neck/pass3-neck-closeup-pitch35.png
