muni-works/rose/body/renders/torso-v103/full-34.png

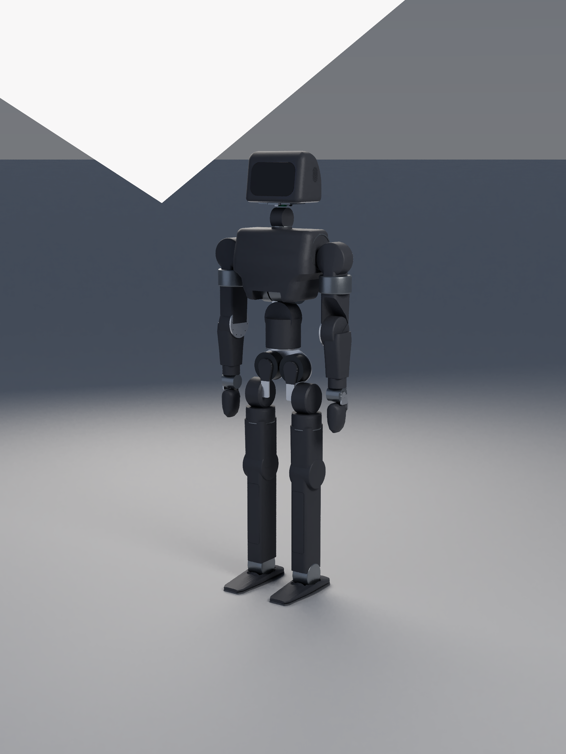
body/renders/torso-v103/full-34.png
