muni-works/rose/body/renders/torso-v103/full-rear.png

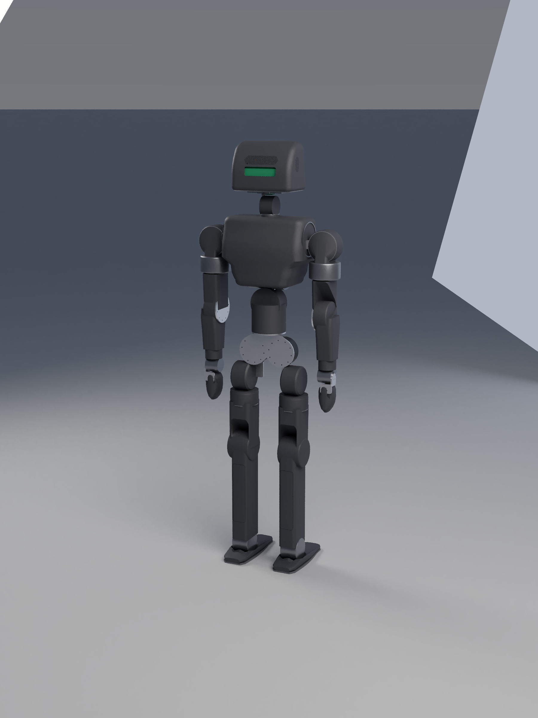
body/renders/torso-v103/full-rear.png
