muni-works/rose/body/renders/torso-v103/full-side.png

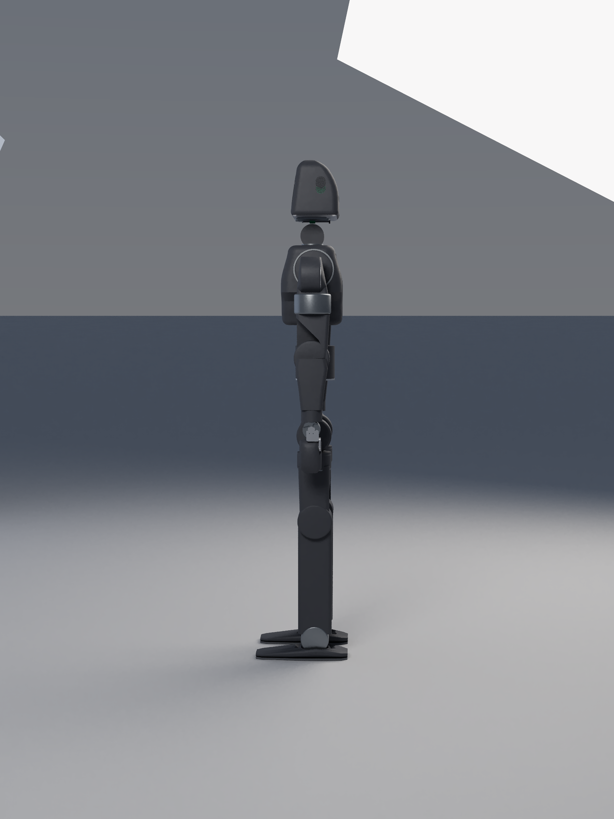
body/renders/torso-v103/full-side.png
