muni-works/rose/body/renders/torso-v103/j1-corner-side.png

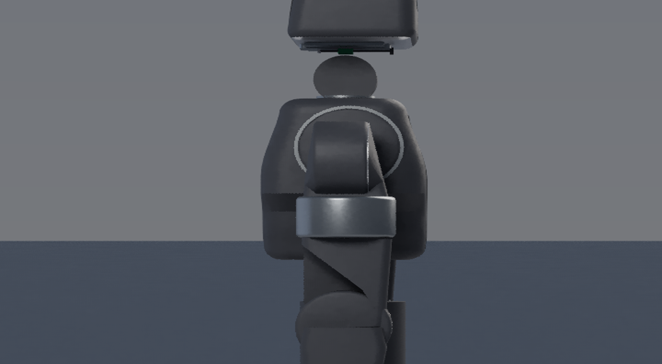
body/renders/torso-v103/j1-corner-side.png
