muni-works/rose/body/renders/torso-v103/torso-rear.png

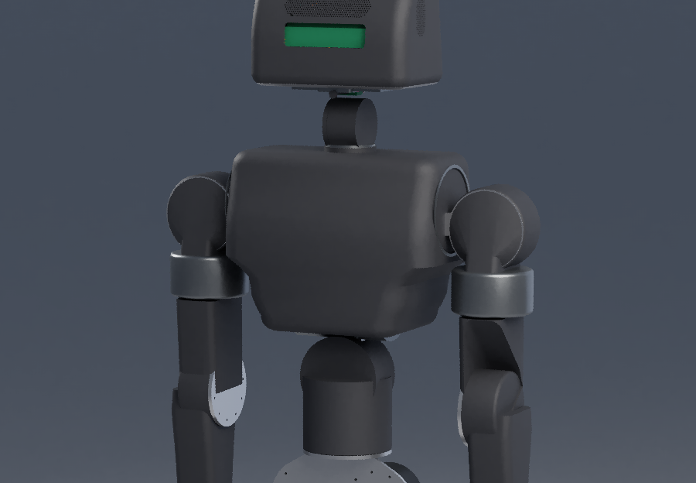
body/renders/torso-v103/torso-rear.png
