muni-works/rose/body/vcad/mini/app-back-vent-estop.png

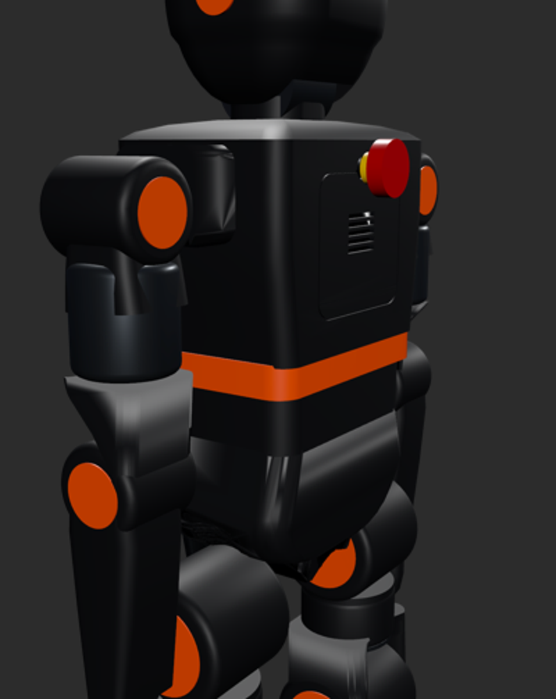
body/vcad/mini/app-back-vent-estop.png
