muni-works/rose/body/vcad/mini/app-calf-forearm-taper.png

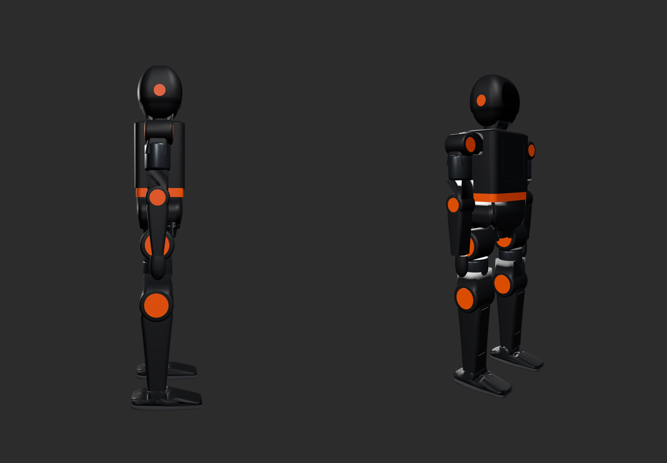
body/vcad/mini/app-calf-forearm-taper.png
