muni-works/rose/body/vcad/mini/app-no-caps.png

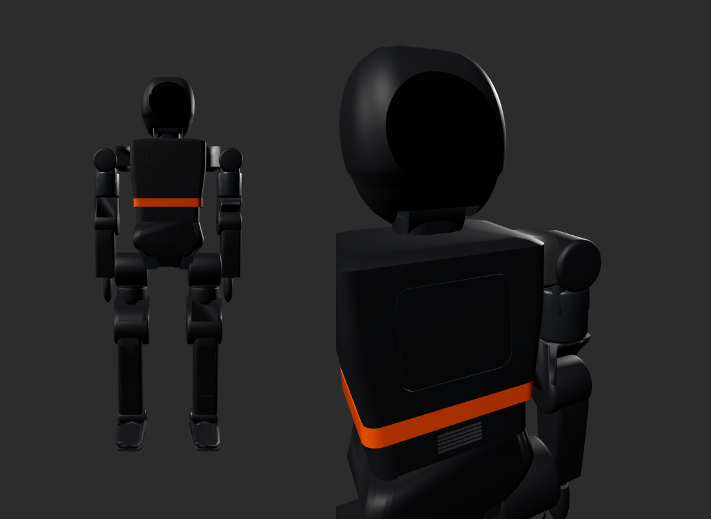
body/vcad/mini/app-no-caps.png
