muni-works/rose/body/vcad/mini/posed.png

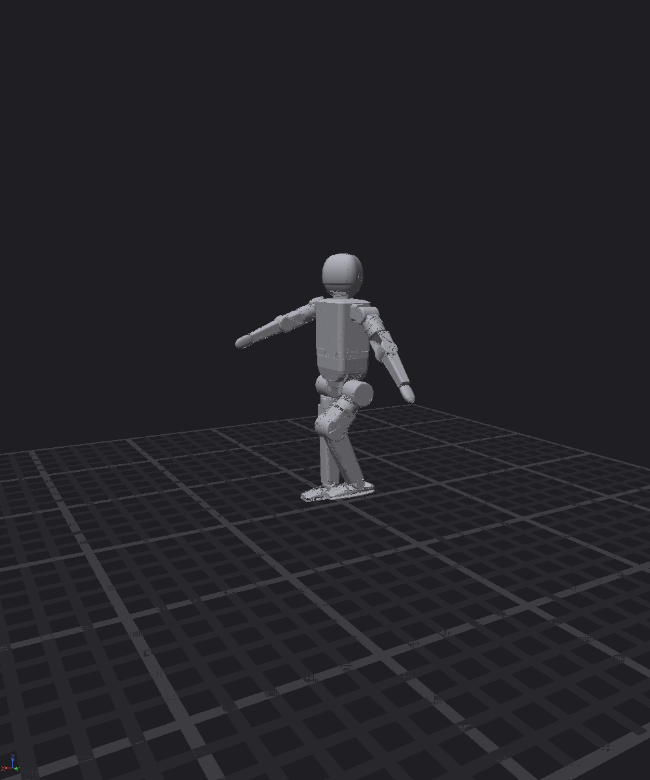
body/vcad/mini/posed.png
