muni-works/rose/body/vcad/mini/rest.png

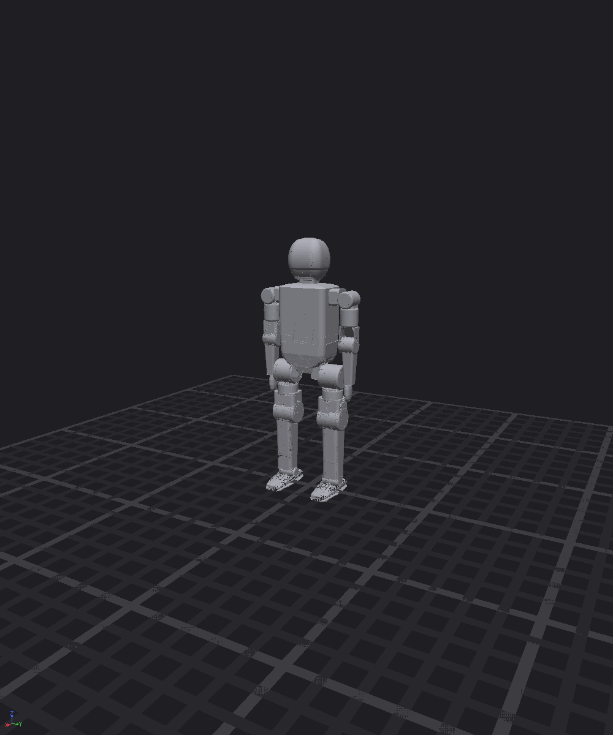
body/vcad/mini/rest.png
