muni-works/rose/electronics/brain/render/brain_matte_black_top.png

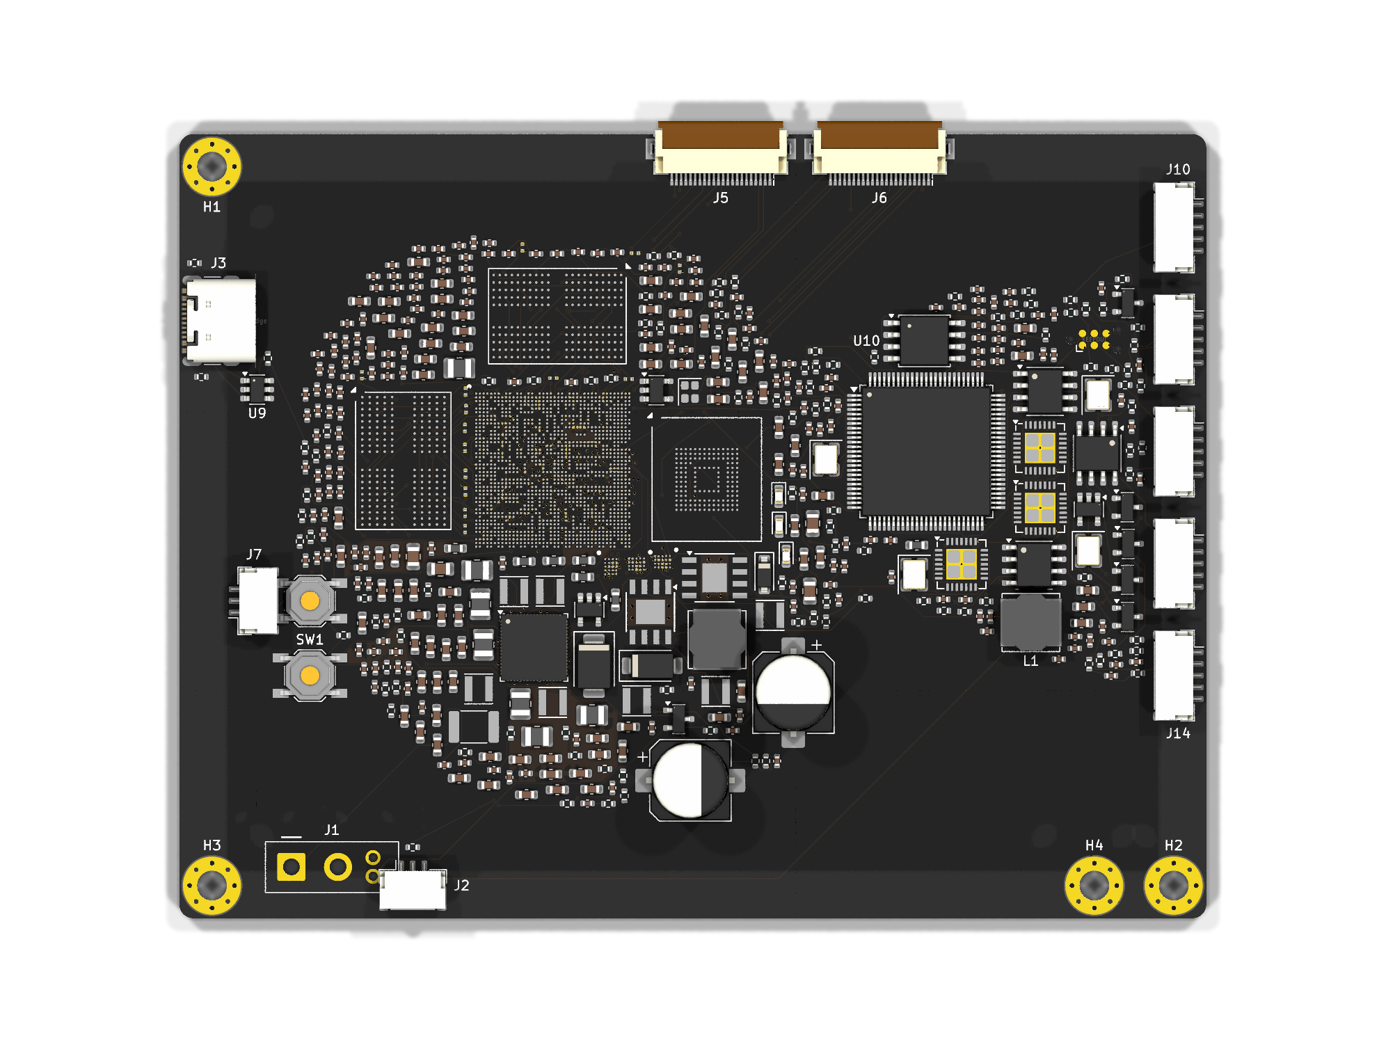
electronics/brain/render/brain_matte_black_top.png
