muni-works/rose/electronics/brain/render/module_bottom.png

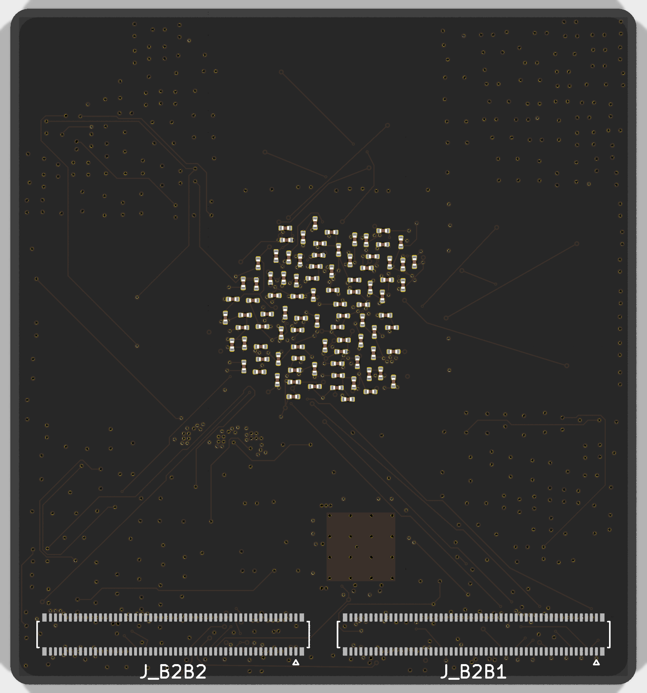
electronics/brain/render/module_bottom.png
