muni-works/rose/electronics/brain/render/module_top.png

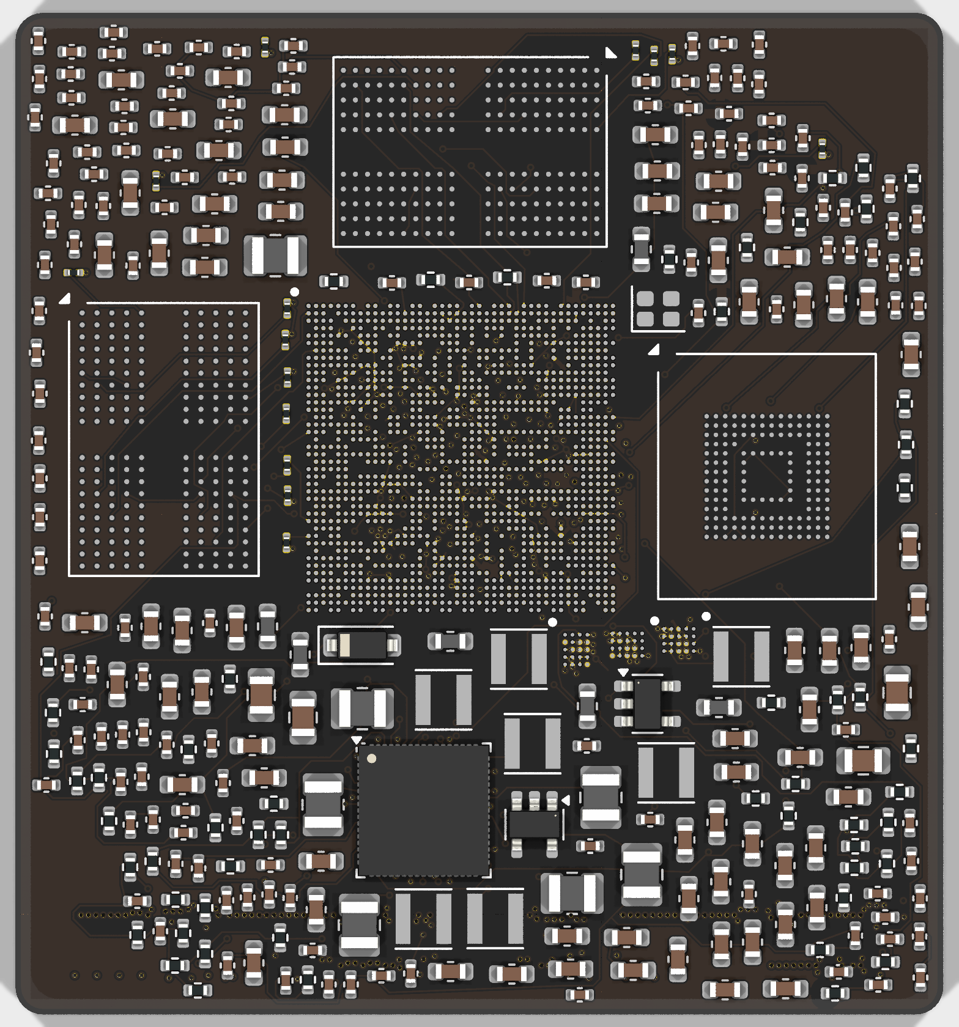
electronics/brain/render/module_top.png
