muni-works/rose/electronics/brain/render/place_bottom.png

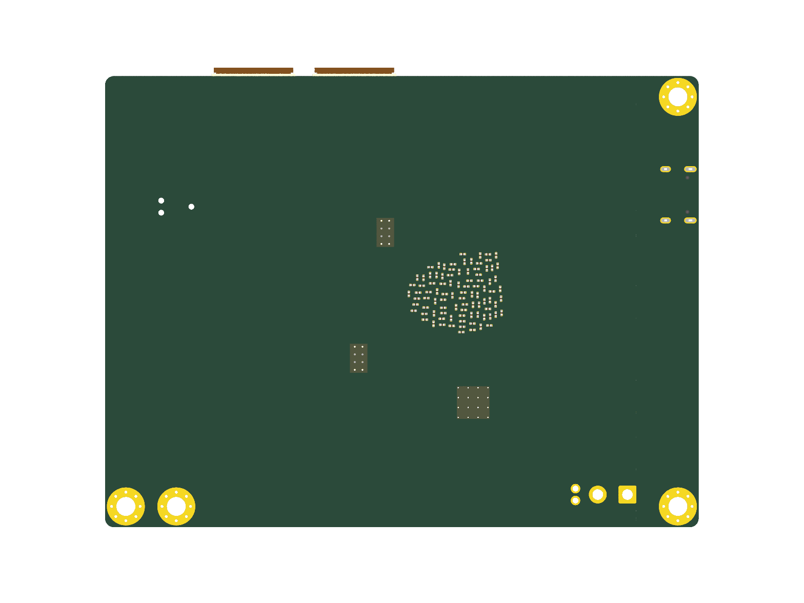
electronics/brain/render/place_bottom.png
