muni-works/rose/electronics/brain/render/place_top.png

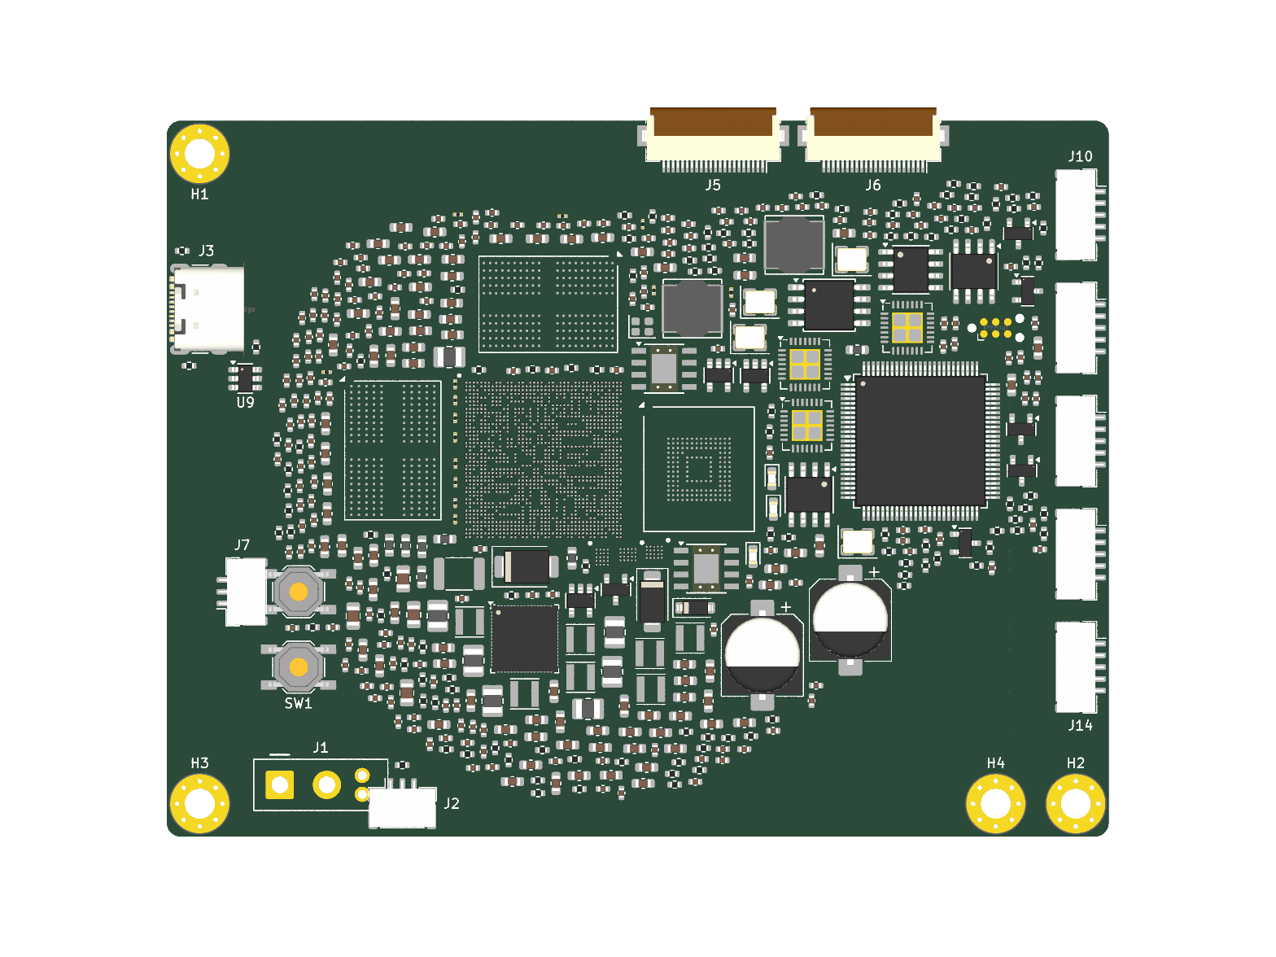
electronics/brain/render/place_top.png
