muni-works/rose/electronics/limb-controller/arm_controller.png

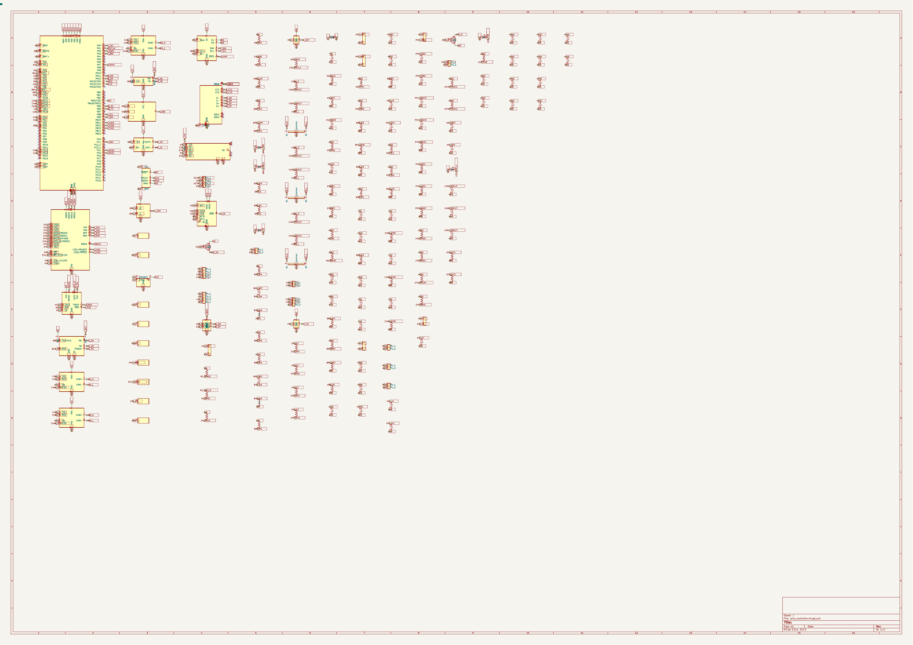
electronics/limb-controller/arm_controller.png
