muni-works/rose/electronics/limb-controller/render/board_3d.png

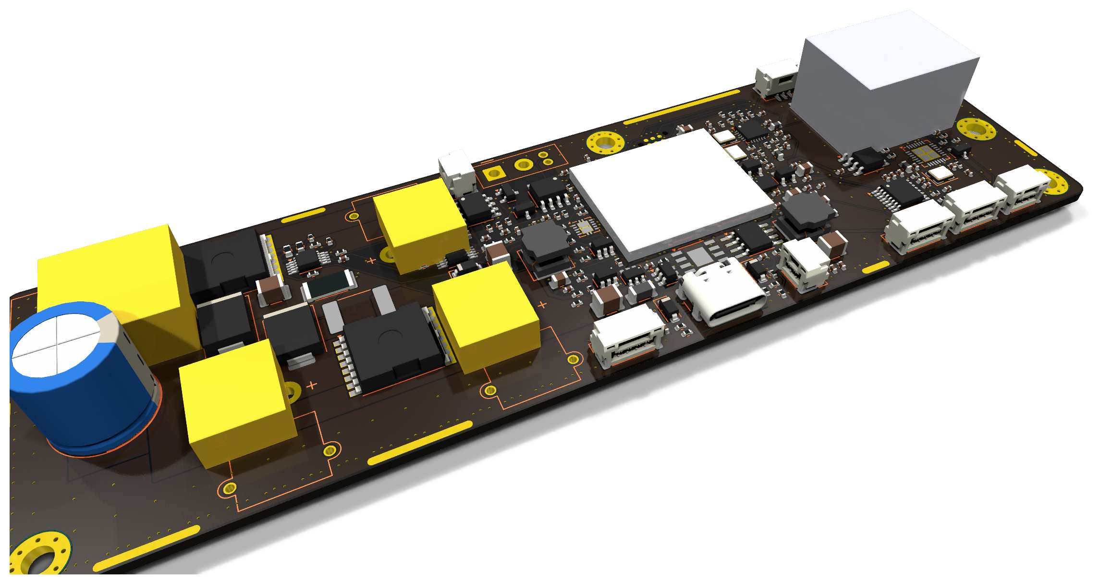
electronics/limb-controller/render/board_3d.png
