muni-works/rose/electronics/limb-controller/render/board_bottom.png

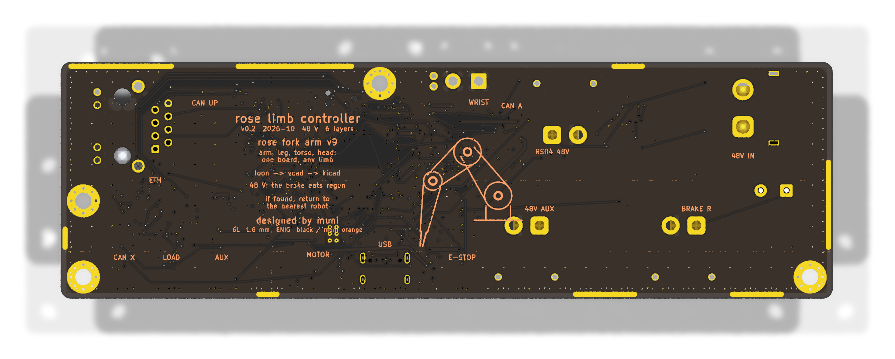
electronics/limb-controller/render/board_bottom.png
