muni-works/rose/electronics/limb-controller/render/board_top.png

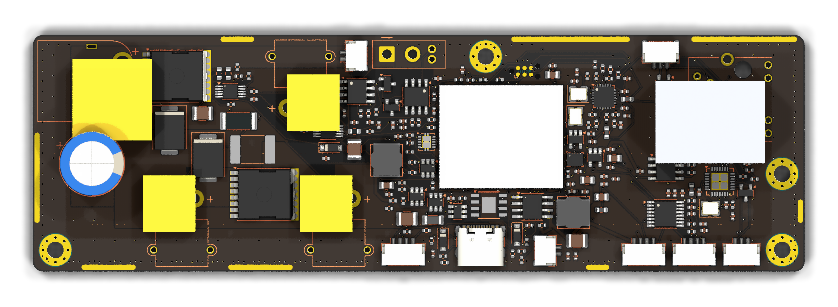
electronics/limb-controller/render/board_top.png
