muni-works/rose/head/renders/full-head/full-pitch0.png

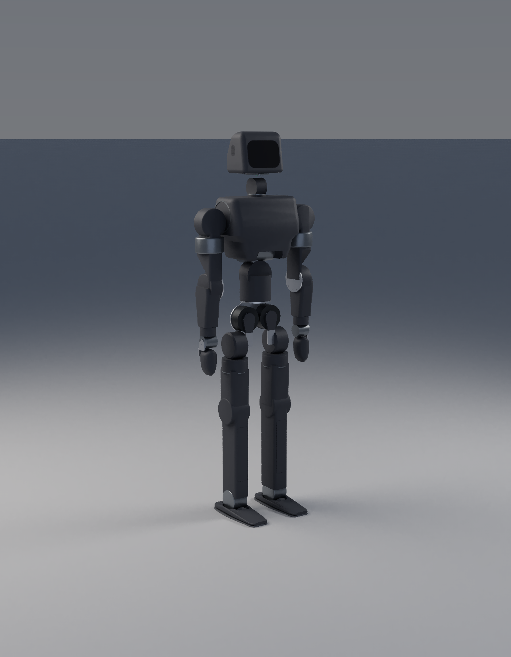
head/renders/full-head/full-pitch0.png
