muni-works/rose/head/renders/full-head/heads-mini-vs-full.png

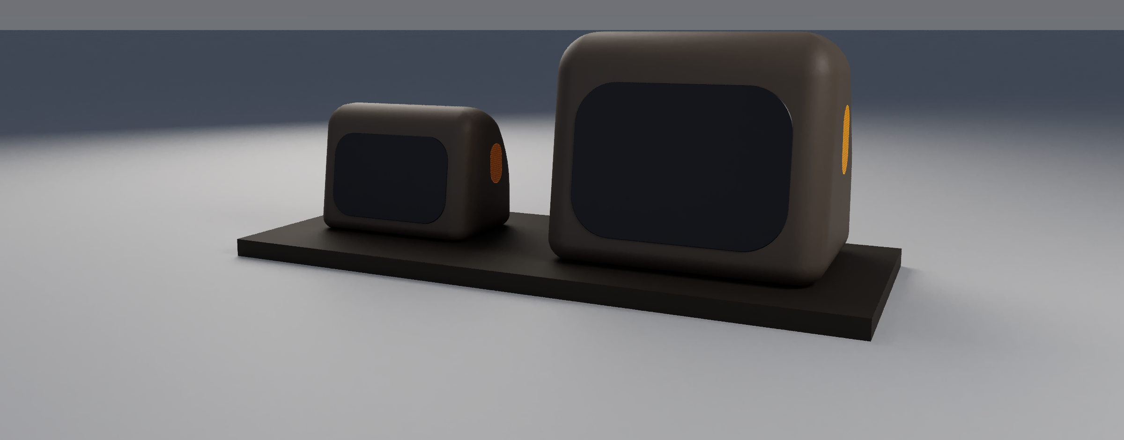
head/renders/full-head/heads-mini-vs-full.png
