muni-works/rose/head/renders/node-full/hero-v0.png

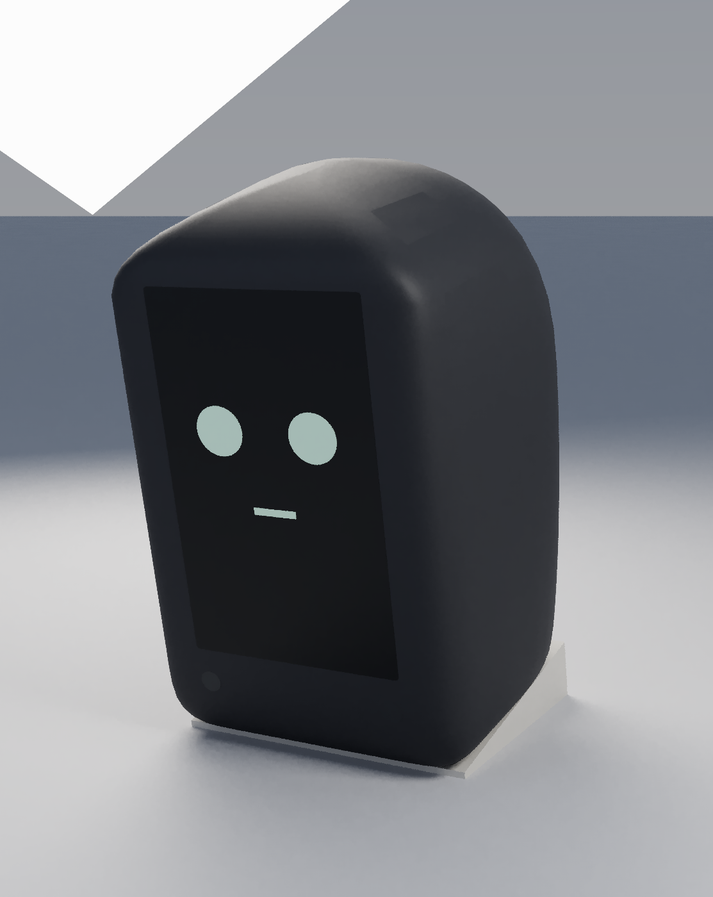
head/renders/node-full/hero-v0.png
