muni-works/rose/head/renders/node-full/hero-v3.png

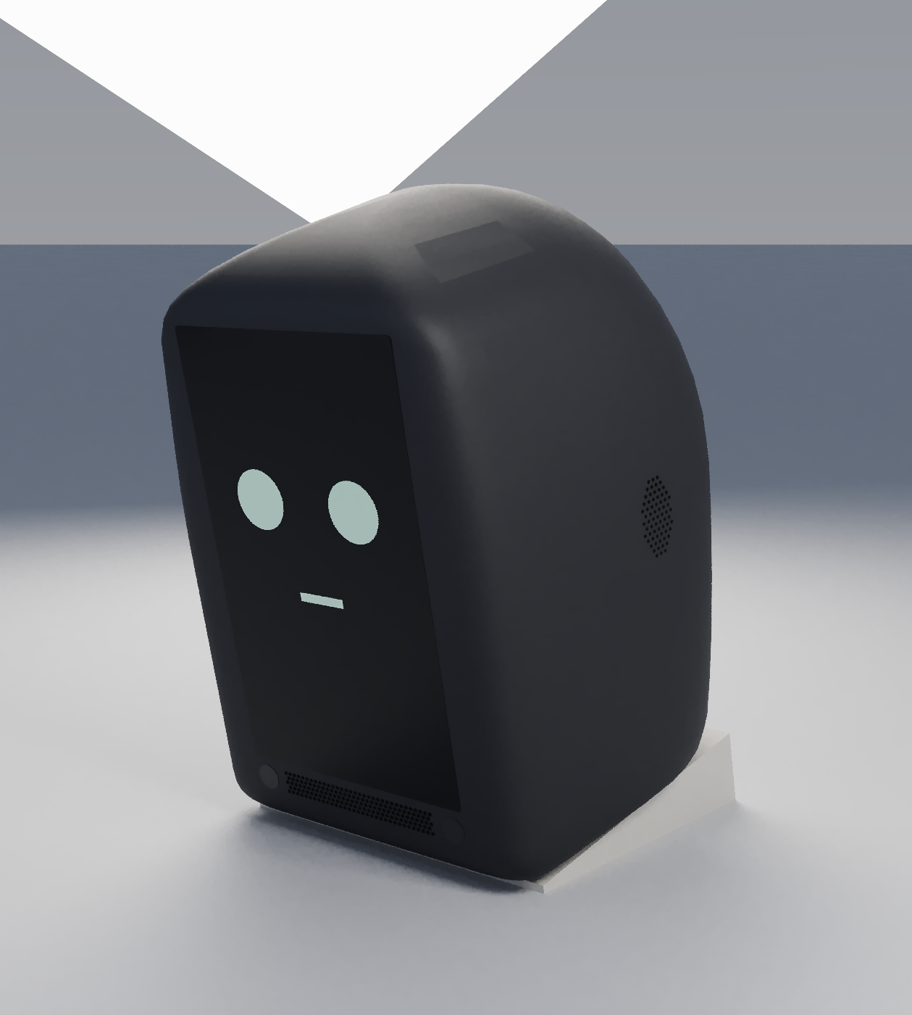
head/renders/node-full/hero-v3.png
