muni-works/rose/head/renders/node-full/mini-vs-full-banana.png

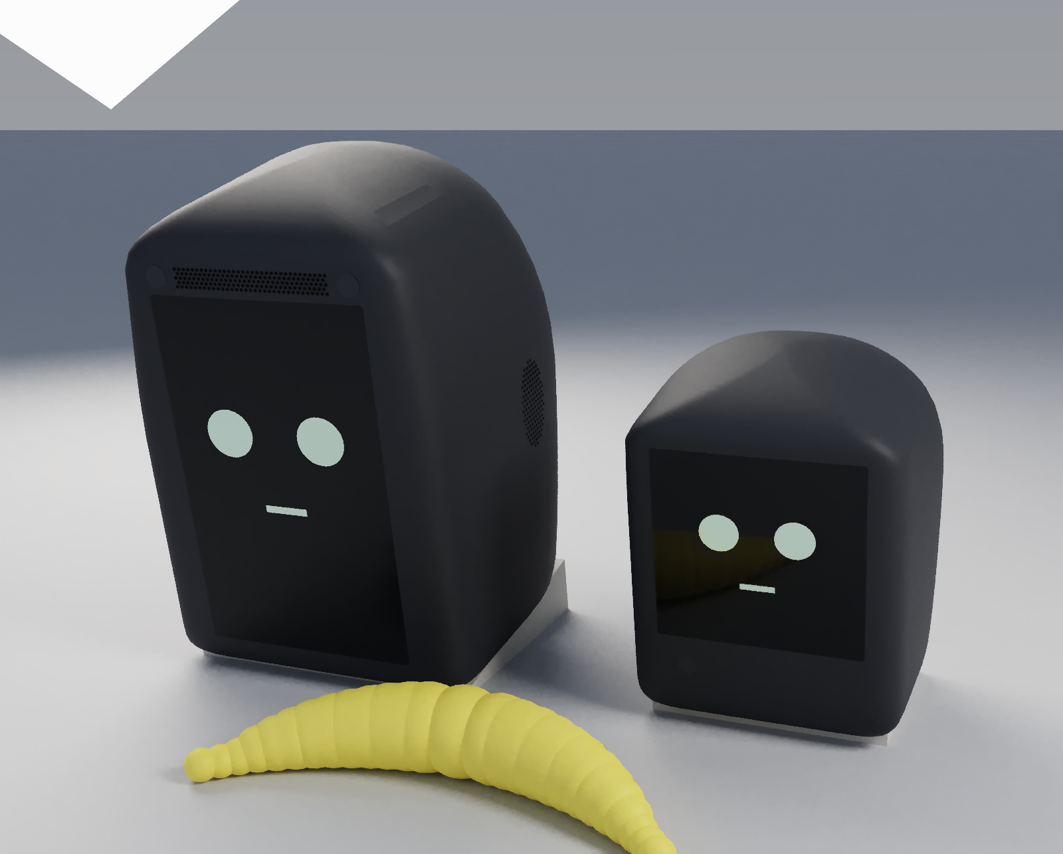
head/renders/node-full/mini-vs-full-banana.png
