muni-works/rose/head/renders/node-full/mini-vs-full-desk.png

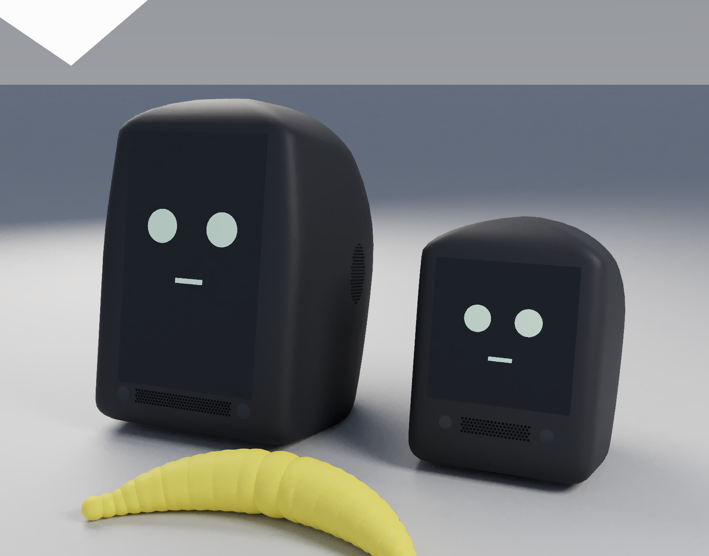
head/renders/node-full/mini-vs-full-desk.png
