muni-works/rose/head/renders/node-full/mini-vs-full-side.png

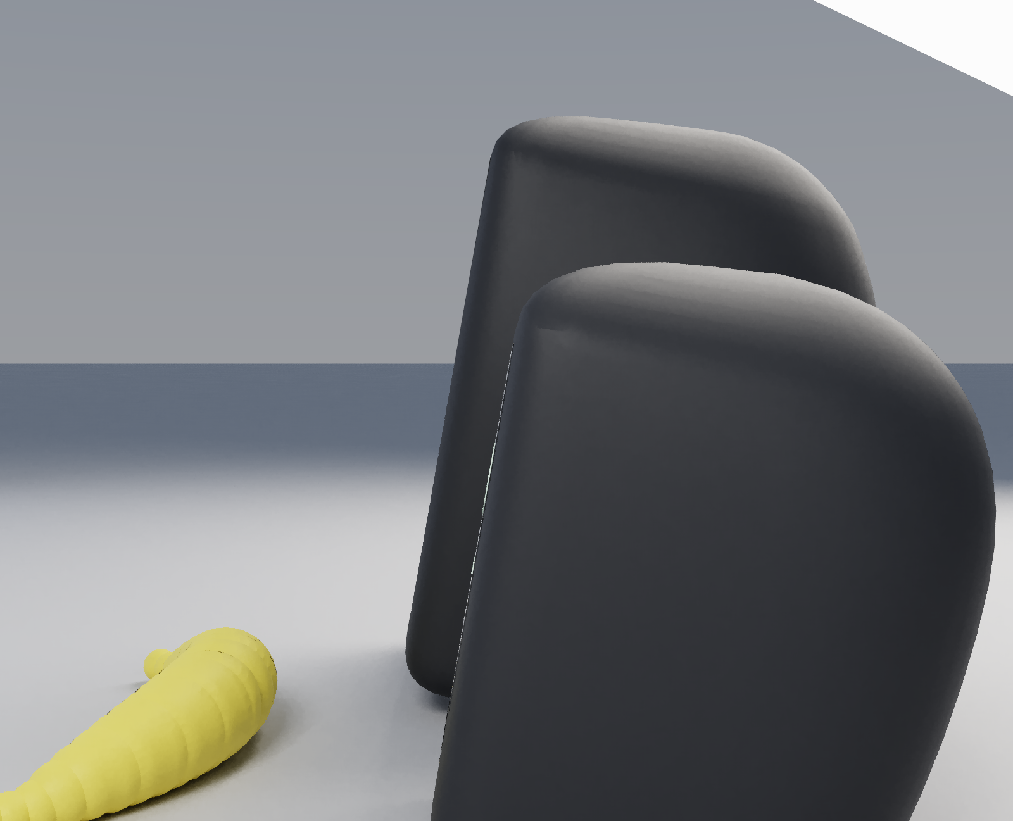
head/renders/node-full/mini-vs-full-side.png
