muni-works/rose/head/renders/node-full/side-v1.png

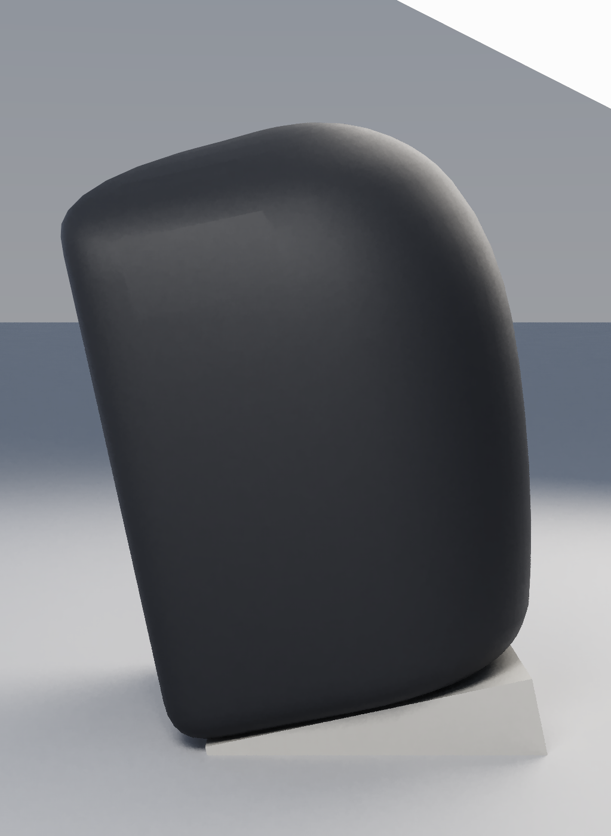
head/renders/node-full/side-v1.png
