muni-works/rose/head/renders/node-full/side-v2.png

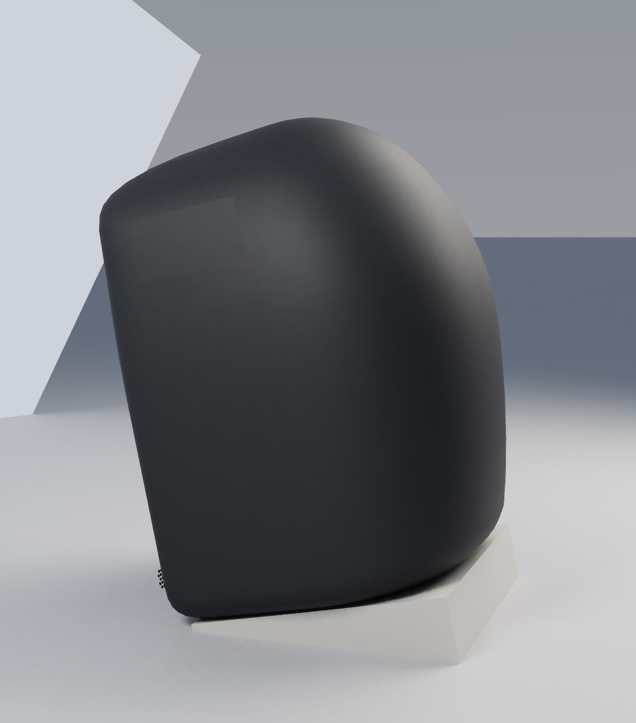
head/renders/node-full/side-v2.png
