muni-works/rose/head/renders/node-full/xvf3800-crown-ports.png

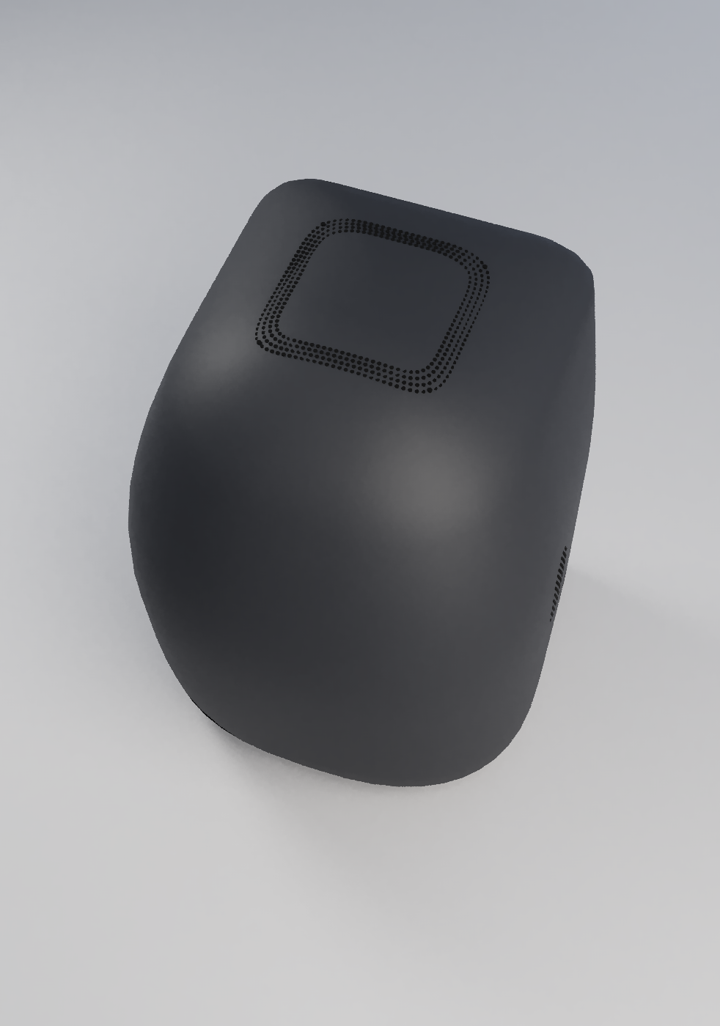
head/renders/node-full/xvf3800-crown-ports.png
