muni-works/rose/head/renders/node-full/xvf3800-internals.png

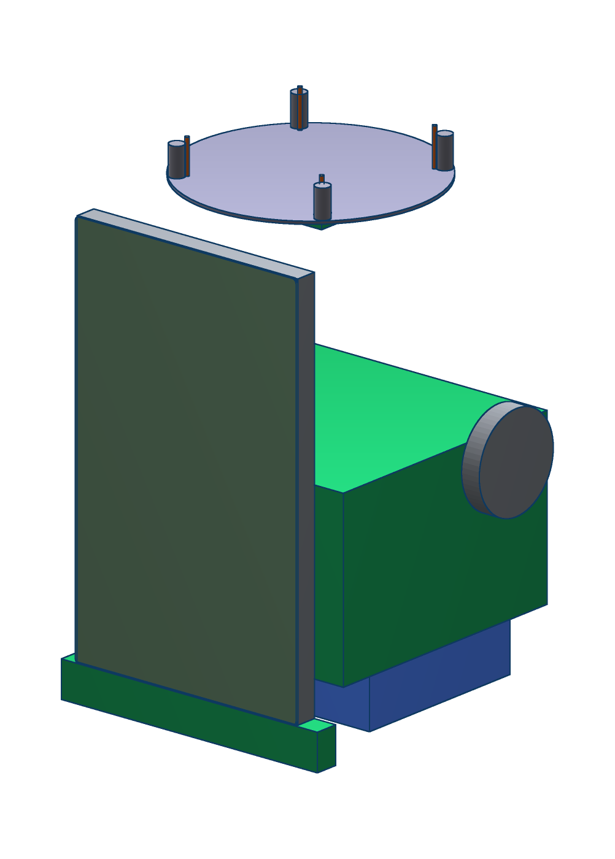
head/renders/node-full/xvf3800-internals.png
