muni-works/rose/head/renders/node/back-34.png

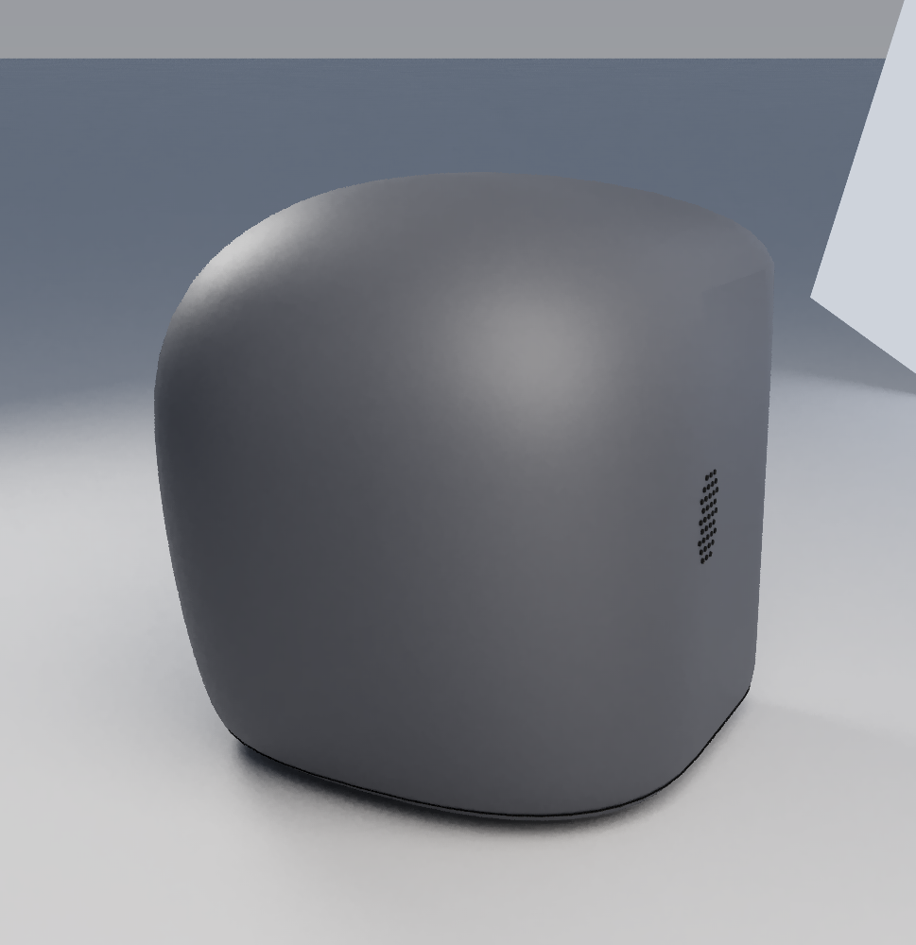
head/renders/node/back-34.png
