muni-works/rose/head/renders/node/cut-34.png

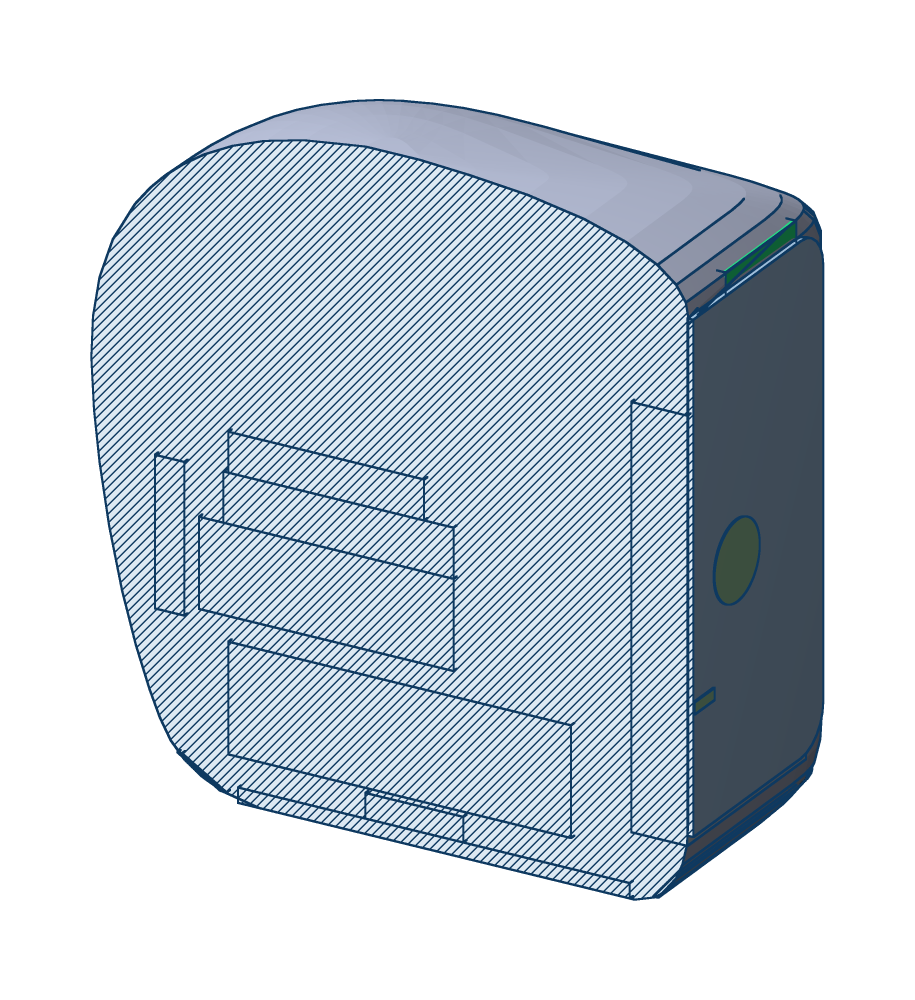
head/renders/node/cut-34.png
