muni-works/rose/head/renders/node/cut-side.png

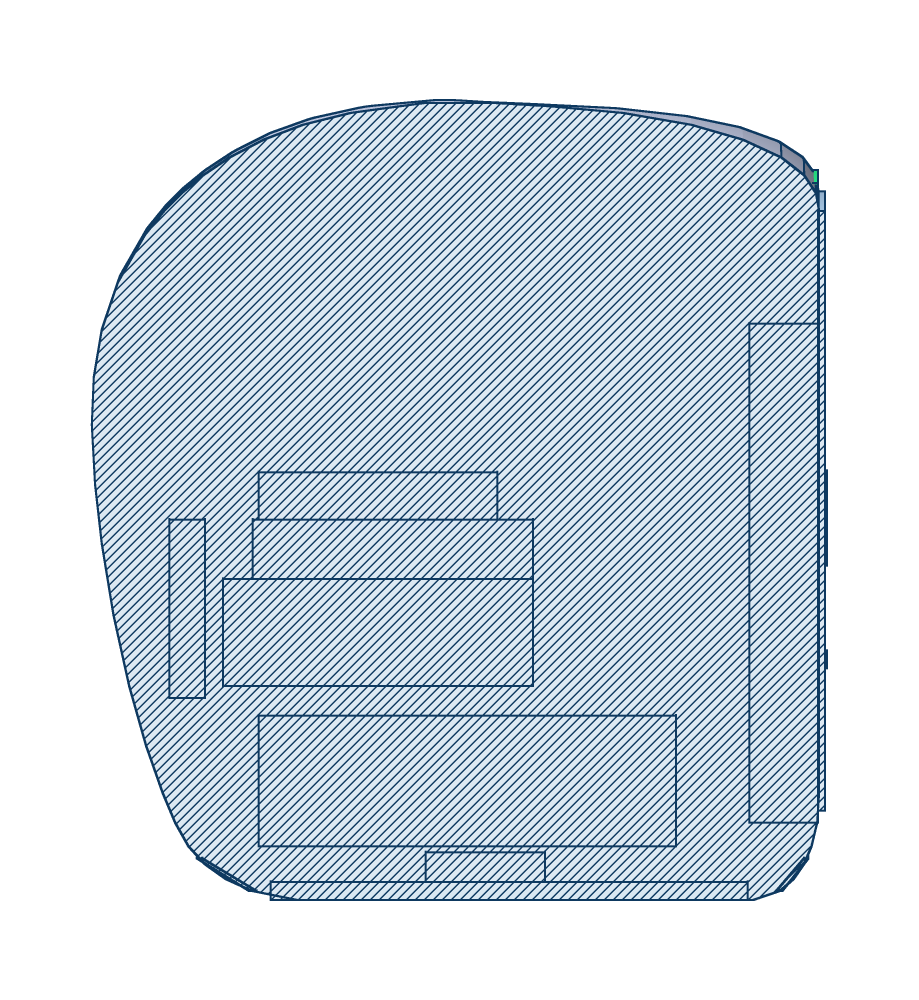
head/renders/node/cut-side.png
