muni-works/rose/head/renders/node/desk-34.png

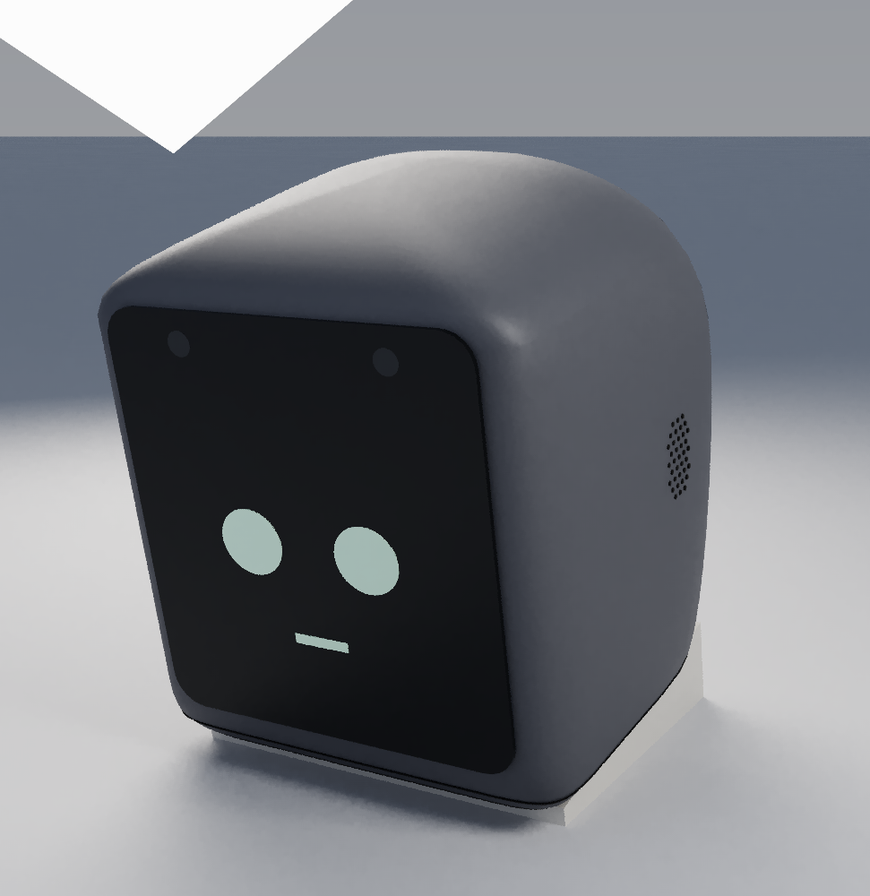
head/renders/node/desk-34.png
