muni-works/rose/head/renders/node/desk-front.png

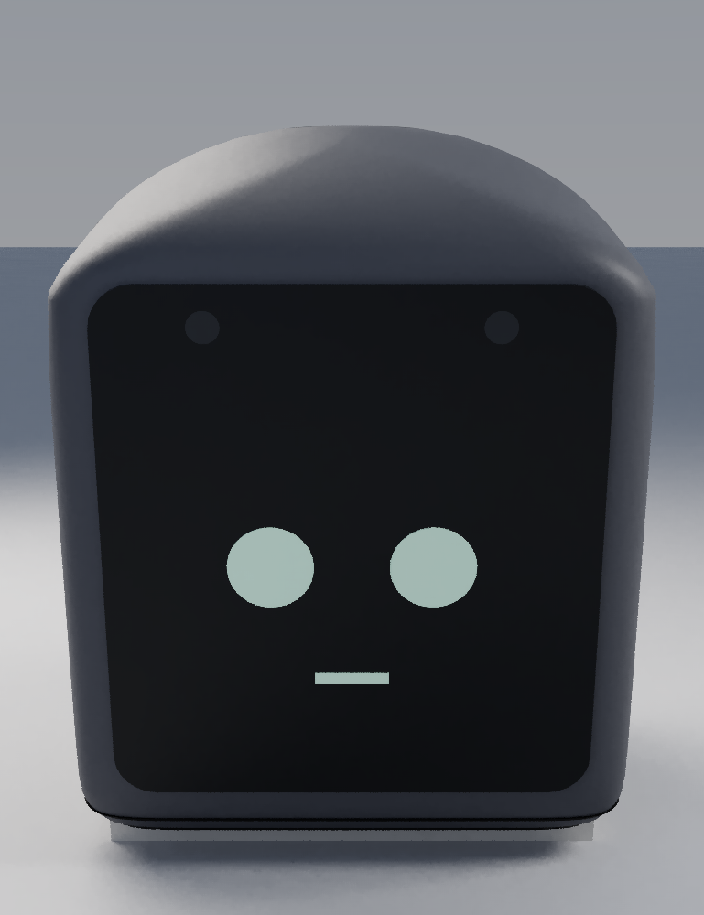
head/renders/node/desk-front.png
