muni-works/rose/head/renders/node/desk-side.png

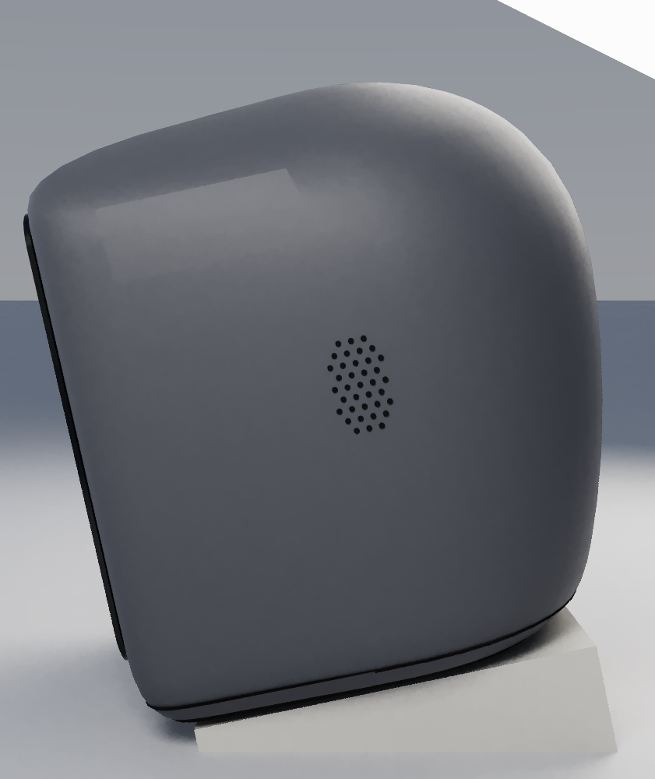
head/renders/node/desk-side.png
