muni-works/rose/head/renders/node/hero-exploded-line.png

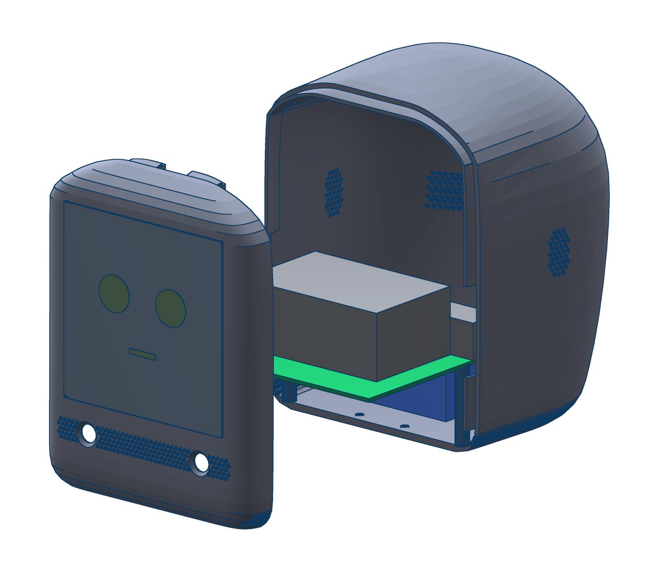
head/renders/node/hero-exploded-line.png
