muni-works/rose/head/renders/node/hero-exploded.png

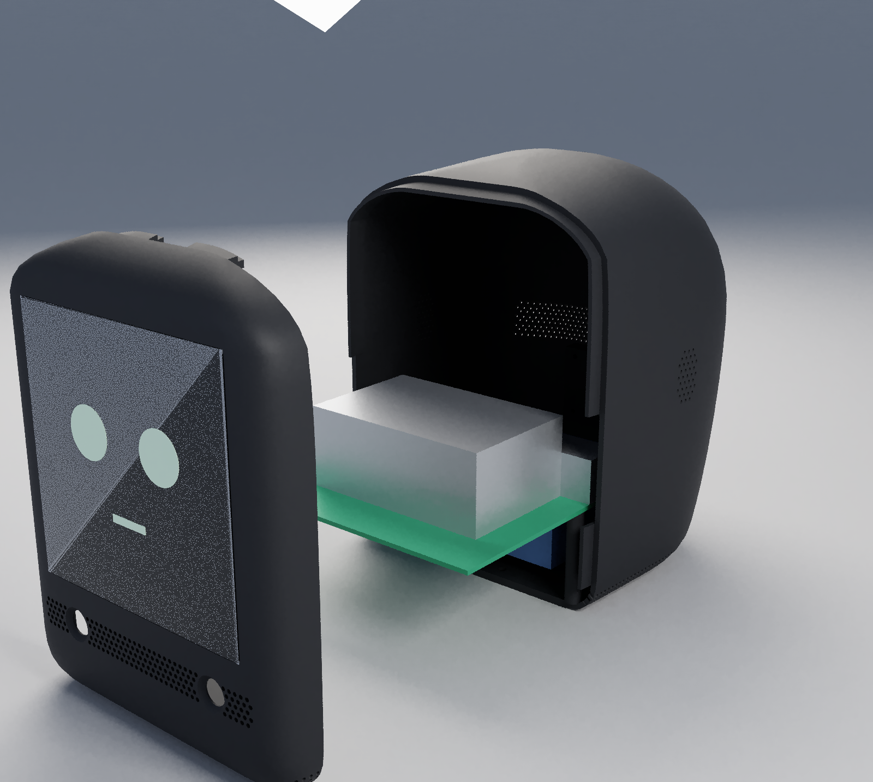
head/renders/node/hero-exploded.png
