muni-works/rose/head/renders/node/human-34.png

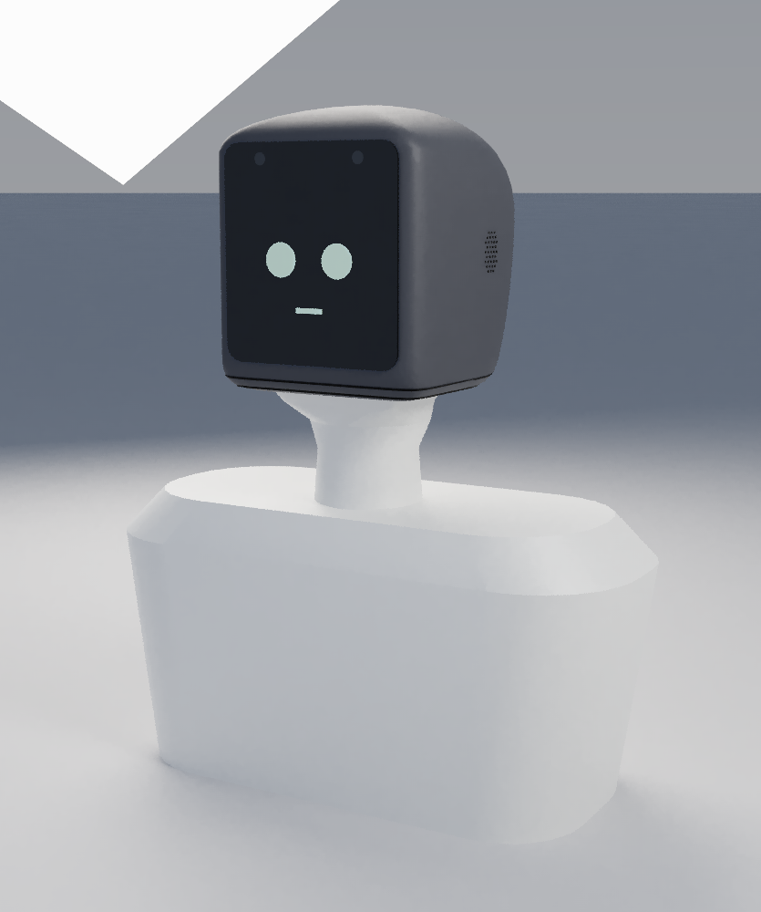
head/renders/node/human-34.png
