muni-works/rose/head/renders/node/human-side.png

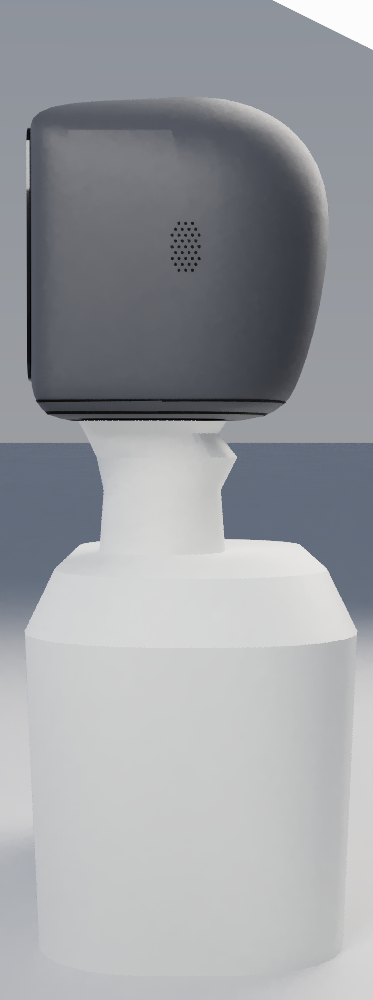
head/renders/node/human-side.png
