muni-works/rose/head/renders/node/inlay-section.png

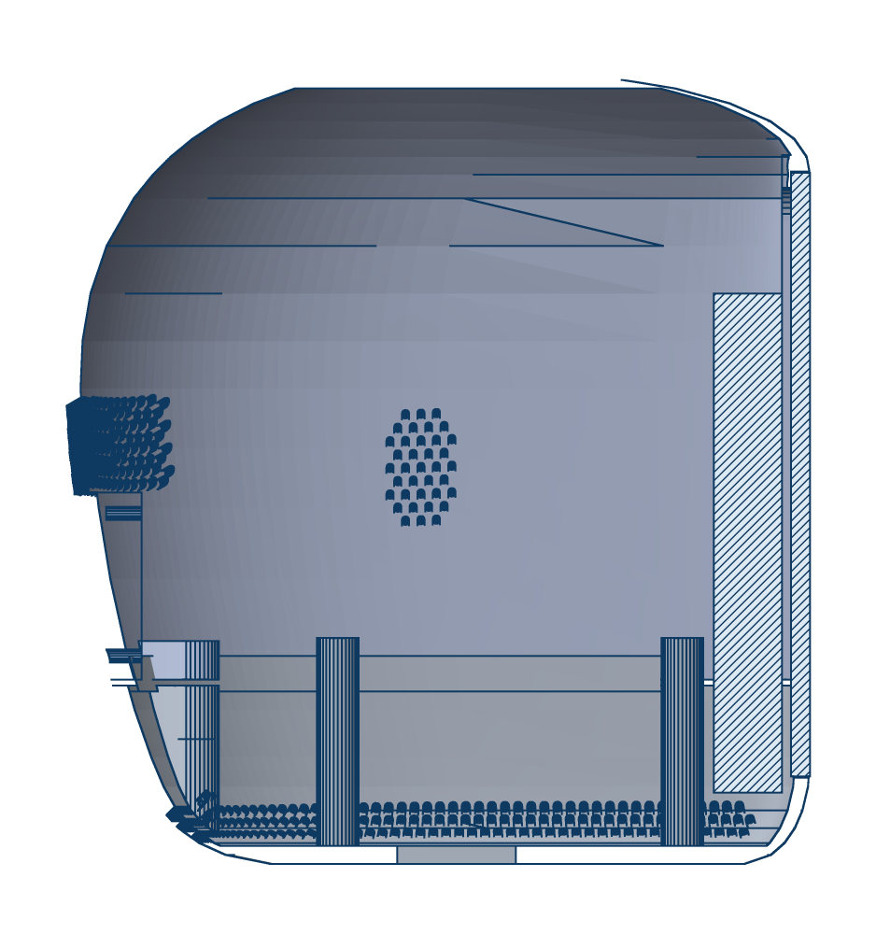
head/renders/node/inlay-section.png
