muni-works/rose/head/renders/node/neck-dock-photo.png

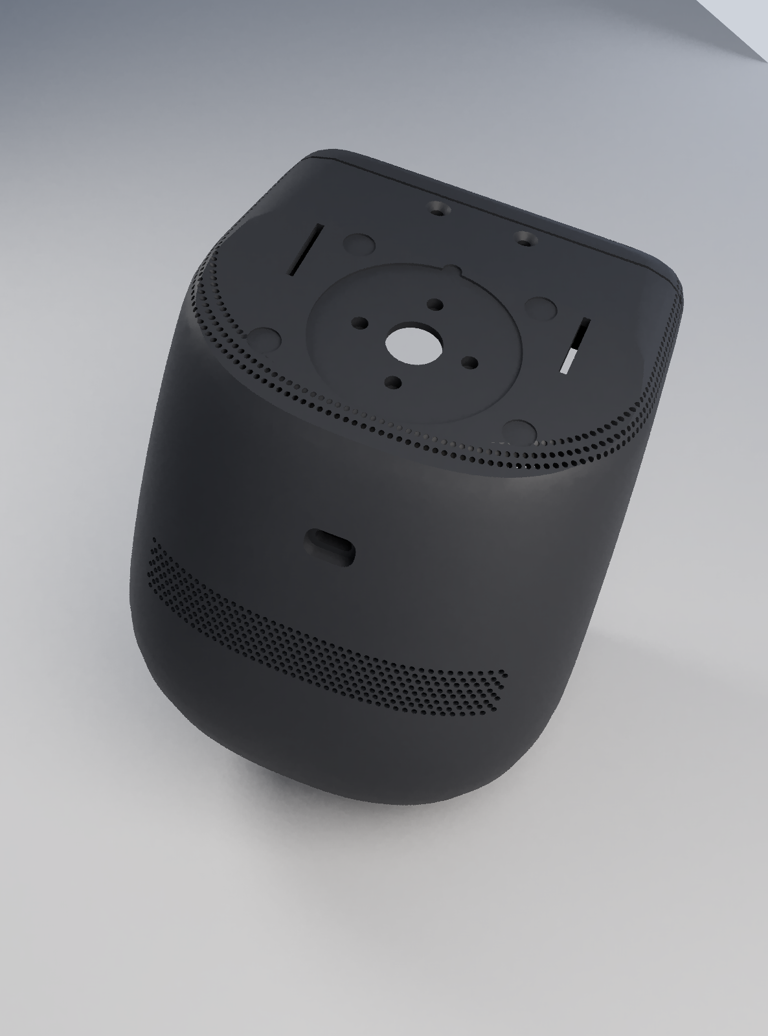
head/renders/node/neck-dock-photo.png
