muni-works/rose/head/renders/node/neck-dock.png

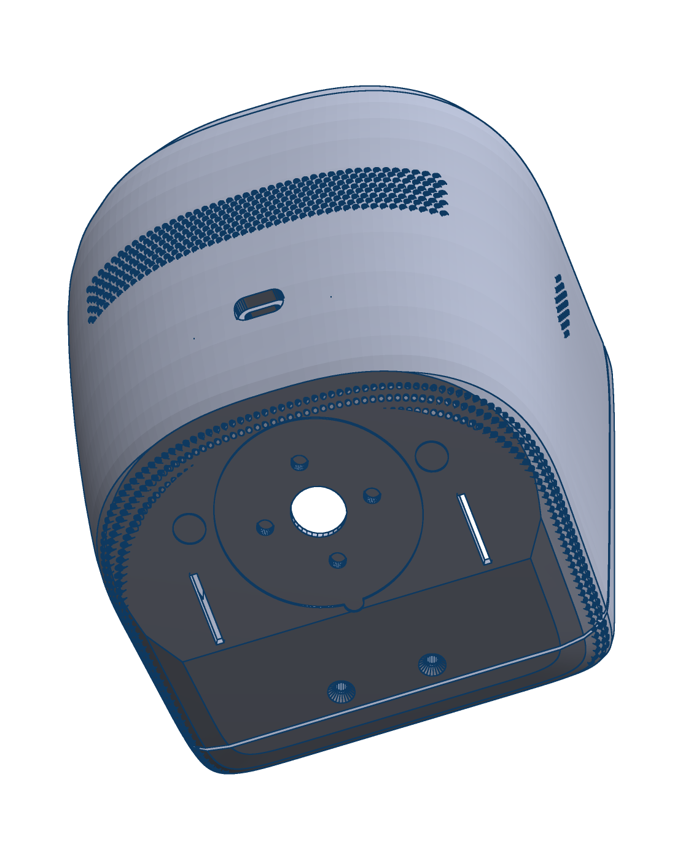
head/renders/node/neck-dock.png
