muni-works/rose/head/renders/node/xvf3800-crown-ports.png

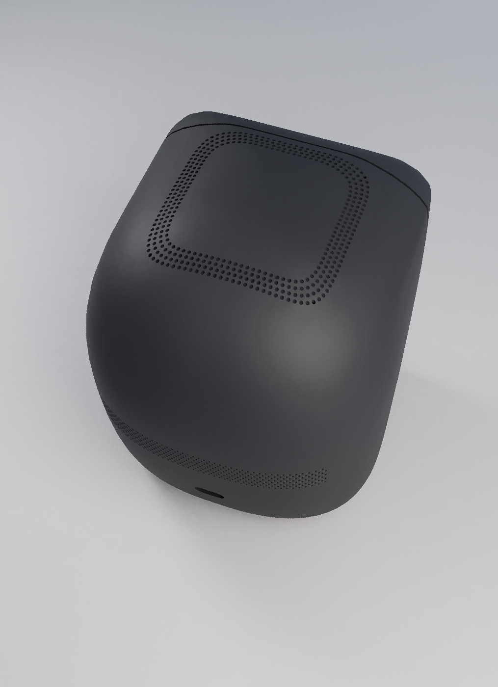
head/renders/node/xvf3800-crown-ports.png
