muni-works/rose/head/renders/release/cortex-hero-16x9.png

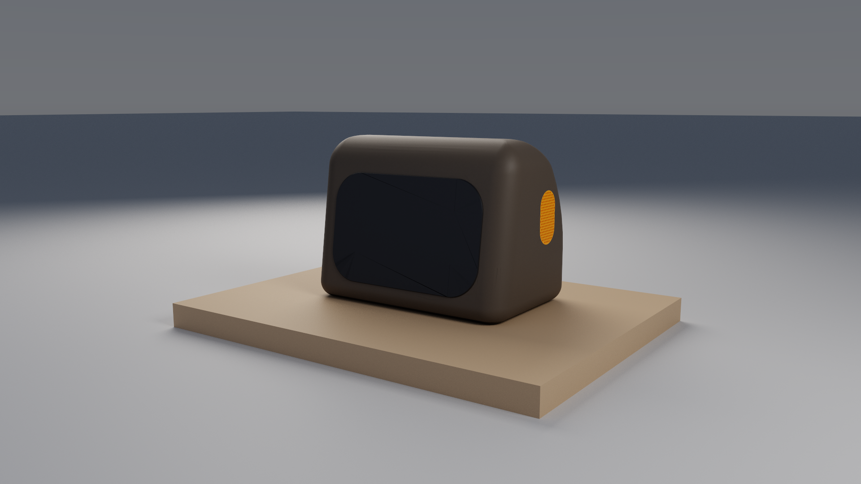
head/renders/release/cortex-hero-16x9.png
