muni-works/rose/head/renders/release/cortex-hero-square.png

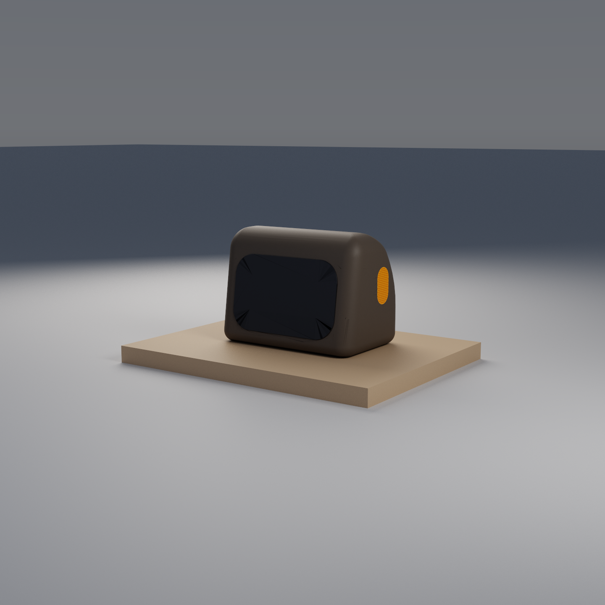
head/renders/release/cortex-hero-square.png
