muni-works/rose/head/renders/release/cortex-lineup.png

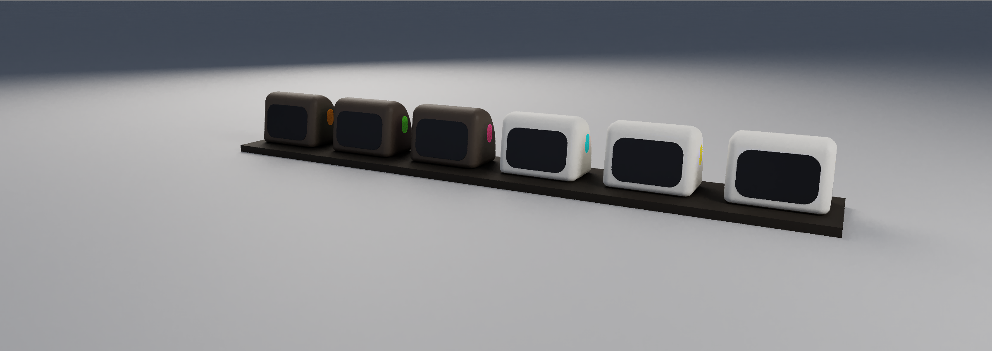
head/renders/release/cortex-lineup.png
