muni-works/rose/arm/build/ORDER.md

# Rose fork v9 "lymb" - ORDER (one arm), prices researched 2026-10-20

> **PARKED (2026-10-20): do not order. The design is not approved yet; see [DESIGN-REVIEW.md](DESIGN-REVIEW.md).**

Nothing was bought, carted or signed in. Public pages only. Many retailer pages (McMaster, TME, Jameco, Zoro, Digi-Key) blocked fetches (JS/403), so lines marked UNCONFIRMED are estimates or search-snippet figures, not live-checked prices. Re-verify before ordering.

## 1. Order today (longest lead time first)

| # | item | vendor / product / SKU | URL | unit | qty | extended | lead time / stock as shown | alternative | status |
|---|---|---|---|---:|---:|---:|---|---|---|
| 1 | RobStride RS04 | Robotics Center 'Robstride RS-04 Actuator' | https://www.roboticscenter.ai/store/product/robstride-04 | $295.00 | 3 | $885.00 | BACKORDER, 4-6 wk (page) | aifitlab $255 (5+ = $240, backordered, ships from China) https://aifitlab.com/products/robstride-04-motor ; openelab.io EUR254.75 preorder | confirmed |
| 2 | Shipping est. for RS04 (page estimate, US) | Robotics Center checkout est. | https://www.roboticscenter.ai/store/product/robstride-04 | $67.21 | 1 | $67.21 | included in the 4-6 wk | aifitlab / openelab ship cost shown at checkout | estimate |
| 3 | RobStride RS02 | OpenELAB US 'ROBSTRIDE02 QDD 17N.m joint motor module' SKU TB-ROBSTRIDE02 (duties included) | https://openelab.com/products/robstride02-qdd-joint-motor-module | $174.99 | 2 | $349.98 | SOLD OUT, preorder, 10-20 working days from China | Robotics Center RS-02 $195 backorder 4-6 wk https://www.roboticscenter.ai/store/product/robstride-02 | confirmed |
| 4 | RobStride RS00 | OpenELAB US 'ROBSTRIDE00 QDD 14N.m' (duties included) | https://openelab.com/products/robstride00-qdd-joint-motor-module | $151.99 | 1 | $151.99 | motor-only variant SOLD OUT, preorder 10-20 working days | Robotics Center RS-00 $185 backorder 4-6 wk https://www.roboticscenter.ai/store/product/robstride-00 | confirmed |
| 5 | RobStride EL05 (gripper) - price is for EduLite 05 | OpenELAB US 'ROBSTRIDE EDULITE 05' SKU TB-ROBSTRIDE-EDULITE05 (duties included) | https://openelab.com/products/robstride-edulite-05-youth-edition | $81.99 | 1 | $81.99 | stock not shown; preorder 10-20 working days if out (China) | RS05 at Robotics Center $155 https://www.roboticscenter.ai/store/product/robstride-05 . UNCONFIRMED that EduLite05 == EL05 in the EL PDF; check part number | UNCONFIRMED (identity) |
| 6 | RobStride USB-CAN adapter | OpenELAB 'ROBSTRIDE CAN to USB debugging module' SKU TB-ROBSTRIDE-Debug | https://openelab.com/products/robstride-can-to-usb-debugging | $25.09 | 1 | $25.09 | stock not confirmed ('Checking inventory'); US wh 3-7 d, else 10-20 d | Pakronics A$33.95 (AU) ; or RS04 aifitlab 'Motor + USB-to-CAN' variant | UNCONFIRMED |
| 7 | E-stop 22 mm twist-release, 1NO+1NC | Omron A22EM11EMO | https://ramcoi.com/itemdetail/A22EM11EMO | $76.00 | 1 | $76.00 | 'call for lead time' | IDEC XW1ELV402Q4MR $45.56 (OOS) https://allworldmachinery.com/itemdetail/XW1ELV402Q4MR | UNCONFIRMED |
| 8 | igus iglidur G flanged GFM-1618-03 | igus GFM-1618-03 (sibling -06 $1.03, -21 $1.17 at TME US; -03 not found) | https://www.tme.com/us/en-us/details/gfl-16/plain-bearings/igus/ | $1.50 | 2 | $3.00 | -03 not confirmed; siblings stocked; igus.com 1-3 d | igus.com direct; nearest stocked GFM-1618-06 (3 mm shorter spigot fit must be checked) | UNCONFIRMED |
| 9 | igus iglidur G flanged GFM-1012-03 | igus GFM-1012-03 | https://www.igus.com/product/GFM-1012-03 | $1.50 | 1 | $1.50 | unconfirmed | TME / RS | UNCONFIRMED |
| 10 | Flat harness CAN + 48 V, high-flex, 2.1 m | no vendor identified; e.g. igus chainflex flat / silicone flat ribbon 4x20AWG | https://www.igus.com | $40.00 | 1 | $40.00 | unconfirmed | Adafruit / Amazon silicone ribbon cable (not high-flex rated) | UNCONFIRMED |
| 11 | Ruby ball stylus O6 mm (M3 thread) probe tip | Renishaw-style stylus (est.) | https://www.amazon.com | $35.00 | 1 | $35.00 | unconfirmed | eBay generic | UNCONFIRMED |
| 12 | XT30PW(2+2) pairs | eBay 'XT30(2+2) 1 Pair' listing (per-pair price not clear); LCSC C19268030 $0.61/ea at 1+ is cheaper but ships slow | https://www.lcsc.com/product-detail/C19268030.html | $8.99 | 7 | $62.93 | eBay: days; LCSC: 1-2 wk from China | LCSC male+female (need both halves, check F part) | UNCONFIRMED |
| 13 | 48 V supply, Mean Well LRS-600-48 (12.5 A) - recommended | Mean Well LRS-600-48 (price est.) | https://www.digikey.com (search LRS-600-48) | $65.00 | 1 | $65.00 | typ. in stock at Digi-Key/Mouser | LRS-350-48 (7.3 A) Jameco $33.30, 126 in stock (search snippet) https://www.jameco.com/z/LRS-350-48-MEAN-WELL-350W-48V-7-3A-Single-Output-Enclosed-Switching-Power-Supply_2219840.html | UNCONFIRMED |
| 14 | 5052-H32 sheet 1/8" (0.125) 24x48 in | McMaster 5052 H32 sheet (SKU not confirmed) | https://www.mcmaster.com/products/5052-aluminum-sheet/ | $115.00 | 1 | $115.00 | McMaster usually 1-2 d | OnlineMetals 5052 0.125; Zoro/Online Metal Supply 0.125x24x24 listed $188.99 (multi-pack pricing, looks off) | UNCONFIRMED |
| 15 | 5052-H32 plate 1/4" 12x12 in (foot) | McMaster / OnlineMetals (SKU not confirmed) | https://www.mcmaster.com/products/5052-aluminum-sheet/ | $35.00 | 1 | $35.00 | 1-2 d | Alcobra / OnlineMetals | UNCONFIRMED |
| 16 | 6061 round bar for sleeves: O5" x 2" (RS04 x2) + O3" x 2" (RS02 x1), 2 cuts | McMaster 6061 round rod, cut to length (SKU not confirmed; check SLEEVES.md for final O) | https://www.mcmaster.com/products/6061-aluminum-rod/ | $75.00 | 1 | $75.00 | 1-2 d | OnlineMetals cut-to-length | UNCONFIRMED |
| 17 | DIN 471 retaining ring 16 mm (pack) | McMaster external retaining ring 16 mm (SKU not confirmed) | https://www.mcmaster.com/products/retaining-rings/ | $9.00 | 1 | $9.00 | 1-2 d | Amazon assortment | UNCONFIRMED |
| 18 | DIN 471 retaining ring 10 mm (pack) | McMaster external retaining ring 10 mm (SKU not confirmed) | https://www.mcmaster.com/products/retaining-rings/ | $9.00 | 1 | $9.00 | 1-2 d | Amazon assortment | UNCONFIRMED |
| 19 | Socket head M3x10 (8) | McMaster 91290A series (SKU not confirmed) | https://www.mcmaster.com/products/screws/ | $8.00 | 1 | $8.00 | 1-2 d | Bolt Depot / Fastenal | UNCONFIRMED |
| 20 | Socket head M3x6 (6) | McMaster 91290A series | https://www.mcmaster.com/products/screws/ | $8.00 | 1 | $8.00 | 1-2 d | Bolt Depot | UNCONFIRMED |
| 21 | Socket head M4x10 (44) | McMaster 91290A series | https://www.mcmaster.com/products/screws/ | $9.00 | 1 | $9.00 | 1-2 d | Bolt Depot | UNCONFIRMED |
| 22 | Socket head M4x8 (12) | McMaster 91290A series | https://www.mcmaster.com/products/screws/ | $8.00 | 1 | $8.00 | 1-2 d | Bolt Depot | UNCONFIRMED |
| 23 | Socket head M5x12 (18) | McMaster 91290A series | https://www.mcmaster.com/products/screws/ | $9.00 | 1 | $9.00 | 1-2 d | Bolt Depot | UNCONFIRMED |
| 24 | Socket head M5x8 (10) | McMaster 91290A series | https://www.mcmaster.com/products/screws/ | $9.00 | 1 | $9.00 | 1-2 d | Bolt Depot | UNCONFIRMED |
| 25 | Socket head M6 x (table) (6), length per bench | McMaster 91290A series | https://www.mcmaster.com/products/screws/ | $9.00 | 1 | $9.00 | 1-2 d | Bolt Depot | UNCONFIRMED |
| 26 | PETG filament 1 kg | Overture/Polymaker PETG (orange) | https://www.amazon.com | $22.00 | 1 | $22.00 | 1-2 d | Prusament | UNCONFIRMED |
| 27 | Loctite 243 (50 ml) | Henkel Loctite 243 | https://www.amazon.com | $24.00 | 1 | $24.00 | 1-2 d | McMaster | UNCONFIRMED |
| 28 | Loctite 638 retaining compound (10 ml) | Henkel Loctite 638 | https://www.amazon.com | $20.00 | 1 | $20.00 | 1-2 d | McMaster | UNCONFIRMED |
| 29 | End mill 3.175 mm (1/8") single flute O-flute, 1/4" or 1/8" shank, 2 pc | eBay US seller (Oregon) listing; Yonico 31310-SC 3-flute $22.95 Home Depot | https://www.homedepot.com/p/Yonico-1-8-in-Dia-Solid-Carbide-3-Flute-Upcut-Spiral-End-Mill-1-4-in-Shank-CNC-Router-Bit-31310-SC/306082182 | $25.05 | 2 | $50.10 | days | Yonico 31310-SC $22.95 (3-flute, not single-flute) | UNCONFIRMED |
| 30 | M6 T-slot table clamps (set of 4+) | generic Anolex 4040 / 2020 clamp set | https://www.amazon.com | $20.00 | 1 | $20.00 | 1-2 d | OpenBuilds | UNCONFIRMED |
| 31 | Dial indicator 0.001" + magnetic base | generic Fowler/Shars style set (est.) | https://www.amazon.com | $60.00 | 1 | $60.00 | 1-2 d | Mitutoyo 64PKA079B $307 Linen Plus https://www.linenplus.ca/en/mitutoyo-0-001-x-1-dial-indicator-and-magnetic-base-set-each-64pka079b.html (in stock 1-2 d; may be CAD) | UNCONFIRMED |
| 32 | Hanging scale + calibrated weights 0.5-4 kg | digital hanging scale ~$12 + weight set ~$30 (rig BOM est.) | https://www.amazon.com | $42.00 | 1 | $42.00 | 1-2 d | McMaster / Amazon | UNCONFIRMED |
| 33 | MIC-6 tooling plate 12x12x1/2" | OnlineMetals / Speedy Metals MIC-6 (1" = $120.96 at Speedy; 1/2" est.) | https://speedymetals.com/p-2931-1-aluminum-cast-tool-jig-plate.aspx | $70.00 | 1 | $70.00 | days | McMaster tool & jig plate https://mcmaster.com/products/tool-and-jig-plates | UNCONFIRMED |
| 34 | K-type thermocouple + reader | generic handheld K-type (rig BOM est. $15) | https://www.amazon.com | $15.00 | 1 | $15.00 | 1-2 d | Adafruit / Amazon | UNCONFIRMED |

## 2. Totals

| group | total |
|---|---:|
| Motors + electronics (RS04 x3, RS02 x2, RS00, EL05, USB-CAN, est. shipping) | $1,561.26 |
| Power and safety (48 V supply, e-stop) | $141.00 |
| Materials and consumables | $546.53 |
| Tools / measurement | $222.00 |
| **Grand total** | **$2,470.79** |

Unconfirmed lines: 30 of 34. Motor prices are the only ones seen on live pages today (RS04 $295 Robotics Center, RS02/RS00/EL05/USB-CAN OpenELAB US). Using aifitlab for RS04 ($255) saves $120 on three but ships from China.

## 3. Notes

- **Gating item: RS04 x3.** Robotics Center shows BACKORDER, 4-6 weeks (RS02 and RS00 same there). OpenELAB US shows RS02/RS00 sold out, preorder, 10-20 working days (2-4 weeks, shipped from China or via US warehouse). aifitlab RS04 is backordered with no date. The openelab.io RS04 is preorder with no timeline; no openelab.com RS04 page found. Realistic: first motor in ~4-6 weeks, the full set ~6 weeks. Nothing else gates the build: aluminum, screws, bushings are 1-3 days from US stock.
- **Real stock claims differ.** A search snippet said Robotics Center RS-04 was 'in stock, ~48 h, San Francisco' at $255; the live page today says backorder at $295. Trust the page, confirm by email/quote before paying.
- **Amazon / AliExpress / Seeed / Foxtech: could not confirm** any official RobStride listing on those (search found none; Seeed only sells RS00/RS06 inside the reBot Arm B601-RS kit). The RobStride site (robstride.com) fetch returned no product data. Treat all above as third-party resellers.
- **Prices in the spec PDF** (README, 2026-07-13) are CNY ex-factory: RS00 CNY598, RS02 CNY699, RS04 CNY1199, RS05 CNY499 (about $85/$98/$168/$70). Resellers charge ~1.8-3x; ordering direct from RobStride in China could save money but adds freight, brokerage and tariff risk and slower lead.
- **US tariff risk: unconfirmed.** I could not verify the current duty rate on China-origin actuators in 2026. OpenELAB prices say 'duties and customs fees included' (DDP); Robotics Center says only 'tax calculated at checkout'; aifitlab ships from China, duty responsibility not stated. Budget 0-30% extra on non-DDP sellers.
- **EL05:** OpenELAB's closest product is the 'EduLite 05' (6 N.m peak, 1.8 N.m rated, $81.99). Confirm it equals the EL05 in the EL PDF (2026.09.22) before ordering.
- **48 V supply sizing.** BOM says LRS-350-48 (7.3 A, 350 W). RS04 is listed at 700 W output peak each; 3 RS04 plus 2 RS02 can exceed 350 W on a fast loaded move, and the supply hiccups on overcurrent. Recommend LRS-600-48 (12.5 A) for headroom, or keep the 350 W and limit current in firmware. Actuator regen cannot be absorbed by the LRS: add a bus TVS/brake-resistor or cap, and keep the supply fused.
- **E-stop on 48 V DC:** a 22 mm button's contacts are typically rated 3 A at 24 V DC, so do not break motor current through it directly. Use it to drop a DC-rated contactor or the PSU remote-on/off. A contactor (~$30) is not in the totals.
- **igus GFM-1618-03 / GFM-1012-03** were not found at distributors. Siblings in the family are $1-1.2 at TME US. The bushing length matters for the plate stack; verify the -03 variant on igus.com or use the nearest length only after checking the fit.
- **Sheet stock:** 3x 15x15 in is covered by one 24x48 in 1/8 in sheet (nest in nest/). The foot is 6.3 mm, so 1/4 in 12x12 works (9 in square needed).
- **Screw counts** above are BOM order list + spares: M3x10 8, M3x6 6, M4x10 44, M4x8 12, M5x12 18, M5x8 10, M6 6. Verify RS02 thread depth (marked 'assumed' in BOM) before cutting final lengths.

## Added by the arm manager (2026-10-20)

| # | item | vendor | URL | unit | qty | note |
|---|---|---|---|---:|---:|---|
| 35 | candleLight USB-CAN (gs_usb), e.g. CANable 2.0 | canable.io / Amazon | https://canable.io | ~$40 | 1 | the measurement scripts use python-can; the RobStride USB-CAN dongle speaks its own serial protocol. Keep the RobStride one for their Motor Studio (firmware, IDs). UNCONFIRMED price |
| 36 | 120 Ω CAN terminator / resistor | any | — | ~$1 | 2 | one at each end of the bus |
| 37 | Ø6 mm dowel pins h6 x 20 (pack) + Ø6 H7 reamer | McMaster | https://www.mcmaster.com | ~$25 | 1 | calibration-plate risers. UNCONFIRMED |
| 38 | 2" 6061 square bar, 2 x 60 mm | McMaster / OnlineMetals | — | ~$15 | 1 | riser blocks for two raised seats |
| 39 | 90° spot drill / countersink 1/4" | any | — | ~$10 | 1 | seat cones on the cal plate |
| 40 | digital level 0.1° | Amazon | — | ~$25 | 1 | zero jig |
