muni-works/rose/arm/fab-v10/BOM.md

# Fork arm v10 - bill of materials (one arm)

Generated by `fab.py` from the model. Router parts are in `parts/`, nested in `nest/`.
Fastener lengths are the longest standard length that stays 0.5 mm short of the bottom of
the motor's blind thread. Depths marked "assumed" are not on the RS02 drawing; measure before ordering.

## Actuators

| part | qty | where |
|---|---:|---|
| RobStride RS04 | 3 | J1 base yaw, J2 shoulder, J4 elbow |
| RobStride RS02 | 2 | J3 upper-arm roll, J6 wrist pitch |
| RobStride RS00 | 1 | J7 tool roll |
| gripper servo (EDU class, Ø46 x 44) | 1 | jaws |

## Router parts (5052-H32, Anolex 4040, 3.175 mm end mill)

| part | t mm | qty | size mm | holes + slots | g each |
|---|---:|---:|---|---:|---:|
| foot | 6.3 | 1 | 170 x 170 | 23 | 291 |
| turret-disc | 3.2 | 1 | 140 x 140 | 14 | 121 |
| turret-tower-A | 3.2 | 1 | 132 x 139 | 9 | 116 |
| turret-tower-B | 3.2 | 1 | 132 x 139 | 2 | 115 |
| spacer-RS04 | 3.2 | 2 | 57 x 57 | 8 | 20 |
| pedestal-X | 3.2 | 4 | 110 x 51 | 1 | 33 |
| pedestal-base | 3.2 | 1 | 188 x 188 | 13 | 190 |
| upper-A | 3.2 | 1 | 174 x 132 | 1 | 72 |
| upper-B | 3.2 | 1 | 174 x 132 | 11 | 86 |
| upper-end-plate | 3.2 | 1 | 65 x 68 | 9 | 27 |
| upperd-bridge | 3.2 | 1 | 65 x 80 | 10 | 42 |
| upperd-A | 3.2 | 1 | 212 x 124 | 6 | 76 |
| upperd-B | 3.2 | 1 | 212 x 124 | 16 | 92 |
| upperd-cover | 3.2 | 2 | 65 x 54 | 0 | 28 |
| fore-A | 3.2 | 1 | 208 x 124 | 9 | 117 |
| fore-B | 3.2 | 1 | 208 x 124 | 2 | 116 |
| fore-end-plate | 3.2 | 1 | 79 x 52 | 9 | 29 |
| yoke-A | 3.2 | 1 | 102 x 90 | 1 | 27 |
| yoke-B | 3.2 | 1 | 102 x 90 | 5 | 50 |
| wrist-A | 3.2 | 1 | 104 x 90 | 6 | 60 |
| wrist-B | 3.2 | 1 | 104 x 90 | 1 | 60 |
| wrist-end-plate | 3.2 | 1 | 69 x 52 | 9 | 26 |
| spacer-RS02 | 3.2 | 1 | 43 x 43 | 6 | 12 |
| tool-flange | 3.2 | 1 | 61 x 61 | 6 | 24 |
| jaw | 3.2 | 2 | 75 x 32 | 0 | 14 |

Stock, 3.2 mm: **3 sheets** of 381 x 381 mm.
Stock, 6.3 mm: **1 sheet** of 381 x 381 mm.

Covers and end plates are located by tabs in slots (10 mm tabs, slots 0.4 mm long and 0.2 mm wide
over). They are captured between the side plates once the motors are bolted, so they need no
screws; a drop of retaining compound on each tab stops rattle.

## Turned, printed, purchased

| part | qty | note |
|---|---:|---|
| sleeve, RS04 pitch joints (6061) | 2 | J2, J4 - see SLEEVES.md |
| sleeve, RS02 wrist pitch (6061) | 1 | J6 - see SLEEVES.md |
| flanged plain bushing 16 x 18 x 3, flange 24 (iglidur G GFM-1618 family) | 2 | J2, J4 straddler plate B |
| flanged plain bushing 10 x 12 x 3, flange 18 (iglidur G GFM-1012 family) | 1 | J6 straddler plate B |
| retaining ring DIN 471-16 | 2 | sleeve ends, J2, J4 |
| retaining ring DIN 471-10 | 1 | sleeve end, J6 |
| hub cap, closed cup (printed PETG, orange) | 3 | Ø40 x 12 at J2, J4; Ø32 x 10 at J6 |
| base collar (printed PETG) | 1 | round the J1 motor on the foot |
| flat harness: CAN pair + 48 V pair | 2.6 m | model route at zero pose is 1.55 m; +30 % for the joint loops and service |
| XT30 (2+2) connector pairs | 7 | one per actuator, daisy chain, plus the base lead |

## Fasteners, by interface

| joint | interface | qty | screw | stack mm | thread depth mm | engagement mm |
|---|---|---:|---|---:|---:|---:|
| J1 base yaw RS04 | back face to the foot | 10 | M4 x 10 | 6.35 | 6 | 3.65 |
| J1 base yaw RS04 | output to the turret disc | 8 | M5 x 8 | 3.175 | 6.5 | 4.825 |
| J2 shoulder RS04 | back face to upper B + sleeve flange | 10 | M4 x 10 | 5.175 | 6 | 4.825 |
| J2 shoulder RS04 | output to spacer + turret tower A | 8 | M5 x 12 | 6.35 | 6.5 | 5.65 |
| J4 elbow RS04 | back face to upper B + sleeve flange | 10 | M4 x 10 | 5.175 | 6 | 4.825 |
| J4 elbow RS04 | output to spacer + fore A | 8 | M5 x 12 | 6.35 | 6.5 | 5.65 |
| J3 upper-arm roll RS02 | back face to the upper end plate | 4 | M4 x 8 | 3.175 | 6 (assumed) | 4.825 |
| J3 upper-arm roll RS02 | output to the upperd bridge | 6 | M4 x 8 | 3.175 | 6 (assumed) | 4.825 |
| J6 wrist pitch RS02 | back face to yoke B + sleeve flange | 4 | M4 x 10 | 5.175 | 6 (assumed) | 4.825 |
| J6 wrist pitch RS02 | output to spacer + wrist A | 6 | M4 x 10 | 6.35 | 6 (assumed) | 3.65 |
| J7 tool roll RS00 | back face to the wrist end plate | 4 | M3 x 6 | 3.175 | 4 | 2.825 |
| J7 tool roll RS00 | output to tool flange + gripper top plate (shared screws) | 6 | M3 x 10 | 6.35 | 5 | 3.65 |

### Order list

| screw (ISO 4762 socket head, A2 or 12.9 black) | qty | + spares |
|---|---:|---:|
| M3 x 10 | 6 | 2 |
| M3 x 6 | 4 | 2 |
| M4 x 10 | 40 | 4 |
| M4 x 8 | 10 | 2 |
| M5 x 12 | 16 | 2 |
| M5 x 8 | 8 | 2 |
| M6 x (table) - foot to bench | 4 | 2 |

Total: 88 screws per arm.
