muni-works/rose/arm/fab/BOM.md

# Fork arm v9 - bill of materials (one arm)

Generated by `fab.py` from the model. Router parts are in `parts/`, nested in `nest/`.
Fastener lengths are the longest standard length that stays 0.5 mm short of the bottom of
the motor's blind thread. Depths marked "assumed" are not on the RS02 drawing; measure before ordering.

## Actuators

| part | qty | where |
|---|---:|---|
| RobStride RS04 | 3 | J1 base yaw, J2 shoulder, J4 elbow |
| RobStride RS02 | 2 | J5 forearm roll, J6 wrist pitch |
| RobStride RS00 | 1 | J7 tool roll |
| gripper servo (EDU class, Ø46 x 44) | 1 | jaws |

## Router parts (5052-H32, Anolex 4040, 3.175 mm end mill)

| part | t mm | qty | size mm | holes + slots | g each |
|---|---:|---:|---|---:|---:|
| foot | 6.3 | 1 | 230 x 230 | 15 | 617 |
| turret-disc | 3.2 | 1 | 140 x 140 | 14 | 121 |
| turret-tower-A | 3.2 | 1 | 140 x 207 | 9 | 203 |
| turret-tower-B | 3.2 | 1 | 140 x 207 | 2 | 202 |
| spacer-RS04 | 3.2 | 2 | 57 x 57 | 8 | 20 |
| upper-A | 3.2 | 1 | 392 x 132 | 7 | 173 |
| upper-B | 3.2 | 1 | 392 x 132 | 27 | 211 |
| upper-cover | 3.2 | 2 | 108 x 54 | 0 | 45 |
| fore-A | 3.2 | 1 | 166 x 132 | 8 | 144 |
| fore-B | 3.2 | 1 | 166 x 132 | 1 | 144 |
| fore-end-plate | 3.2 | 1 | 79 x 72 | 9 | 38 |
| yoke-bridge | 3.2 | 1 | 54 x 41 | 10 | 17 |
| yoke-A | 3.2 | 1 | 123 x 90 | 1 | 40 |
| yoke-B | 3.2 | 1 | 123 x 90 | 5 | 63 |
| wrist-A | 3.2 | 1 | 122 x 90 | 6 | 73 |
| wrist-B | 3.2 | 1 | 122 x 90 | 1 | 72 |
| wrist-end-plate | 3.2 | 1 | 69 x 52 | 9 | 26 |
| spacer-RS02 | 3.2 | 1 | 43 x 43 | 6 | 12 |
| tool-flange | 3.2 | 1 | 61 x 61 | 6 | 24 |
| jaw | 3.2 | 2 | 75 x 32 | 0 | 14 |

Stock, 3.2 mm: **3 sheets** of 381 x 381 mm.
Stock, 6.3 mm: **1 sheet** of 381 x 381 mm.

Covers and end plates are located by tabs in slots (10 mm tabs, slots 0.4 mm long and 0.2 mm wide
over). They are captured between the side plates once the motors are bolted, so they need no
screws; a drop of retaining compound on each tab stops rattle.

## Turned, printed, purchased

| part | qty | note |
|---|---:|---|
| sleeve, RS04 pitch joints (6061) | 2 | J2, J4 - see SLEEVES.md |
| sleeve, RS02 wrist pitch (6061) | 1 | J6 - see SLEEVES.md |
| flanged plain bushing 16 x 18 x 3, flange 24 (iglidur G GFM-1618 family) | 2 | J2, J4 straddler plate B |
| flanged plain bushing 10 x 12 x 3, flange 18 (iglidur G GFM-1012 family) | 1 | J6 straddler plate B |
| retaining ring DIN 471-16 | 2 | sleeve ends, J2, J4 |
| retaining ring DIN 471-10 | 1 | sleeve end, J6 |
| hub cap, closed cup (printed PETG, orange) | 3 | Ø40 x 12 at J2, J4; Ø32 x 10 at J6 |
| base collar (printed PETG) | 1 | round the J1 motor on the foot |
| flat harness: CAN pair + 48 V pair | 2.1 m | model route at zero pose is 1.18 m; +30 % for the joint loops and service |
| XT30 (2+2) connector pairs | 7 | one per actuator, daisy chain, plus the base lead |

## Fasteners, by interface

| joint | interface | qty | screw | stack mm | thread depth mm | engagement mm |
|---|---|---:|---|---:|---:|---:|
| J1 base yaw RS04 | back face to the foot | 10 | M4 x 10 | 6.35 | 6 | 3.65 |
| J1 base yaw RS04 | output to the turret disc | 8 | M5 x 8 | 3.175 | 6.5 | 4.825 |
| J2 shoulder RS04 | back face to upper B + sleeve flange | 10 | M4 x 10 | 5.175 | 6 | 4.825 |
| J2 shoulder RS04 | output to spacer + turret tower A | 8 | M5 x 12 | 6.35 | 6.5 | 5.65 |
| J4 elbow RS04 | back face to upper B + sleeve flange | 10 | M4 x 10 | 5.175 | 6 | 4.825 |
| J4 elbow RS04 | output to spacer + fore A | 8 | M5 x 12 | 6.35 | 6.5 | 5.65 |
| J5 forearm roll RS02 | back face to the forearm end plate | 4 | M4 x 8 | 3.175 | 6 (assumed) | 4.825 |
| J5 forearm roll RS02 | output to the yoke bridge | 6 | M4 x 8 | 3.175 | 6 (assumed) | 4.825 |
| J6 wrist pitch RS02 | back face to yoke B + sleeve flange | 4 | M4 x 10 | 5.175 | 6 (assumed) | 4.825 |
| J6 wrist pitch RS02 | output to spacer + wrist A | 6 | M4 x 10 | 6.35 | 6 (assumed) | 3.65 |
| J7 tool roll RS00 | back face to the wrist end plate | 4 | M3 x 6 | 3.175 | 4 | 2.825 |
| J7 tool roll RS00 | output to tool flange + gripper top plate (shared screws) | 6 | M3 x 10 | 6.35 | 5 | 3.65 |

### Order list

| screw (ISO 4762 socket head, A2 or 12.9 black) | qty | + spares |
|---|---:|---:|
| M3 x 10 | 6 | 2 |
| M3 x 6 | 4 | 2 |
| M4 x 10 | 40 | 4 |
| M4 x 8 | 10 | 2 |
| M5 x 12 | 16 | 2 |
| M5 x 8 | 8 | 2 |
| M6 x (table) - foot to bench | 4 | 2 |

Total: 88 screws per arm.
