muni-works/rose/electronics/limb-controller/bom_mpn.csv

value | manufacturer | mpn
2.2u 100V | Murata | GRM32ER72A225KA35L
100n | Murata | GRM155R71C104KA88D
390n | Murata | GRM155R61A394KE15D
10n | Murata | GRM155R71H103KA88D
220u 100V | Panasonic | EEU-FS2A221
2.2n | Murata | GRM155R71H222KA01D
22u 25V | Murata | GRM21BR61E226ME44L
10u 25V@C_0805_2012Metric | Murata | GRM21BR61E106KA73L
10u 25V@C_1210_3225Metric | Murata | GRM32DR71E106KA12L
22u | Murata | GRM21BR61A226ME51L
10u | Murata | GRM21BR61C106KE15L
4.7u | Murata | GRM21BR61E475KA12L
2.2u | Murata | GRM155R61A225KE95D
4.7n | Murata | GRM155R71H472KA01D
470p | Murata | GRM1555C1H471JA01D
1n | Murata | GRM155R71H102KA01D
12p | Murata | GRM1555C1H120JA01D
SMDJ60A | Littelfuse | SMDJ60A
BAT54 | Nexperia | BAT54 | 215
STPS10H100 100V | STMicroelectronics | STPS10H100SFY
green 3V3 | Wurth | 150060GS75000
blue status | Wurth | 150060BS75000
PESD2CAN | Nexperia | PESD2CAN | 215
600R@100MHz | Murata | BLM18KG601SN1D
BLM31KN601SN1 (1206, 100 V) | Murata | BLM31KN601SN1L
XT60PW-M 48V in (fuse: ATM 50A inline in the supply cable) | AMASS | XT60PW-M
E-stop, 2-ch NC | JST | SM04B-GHS-TB(LF)(SN)
XT30PW-M brake resistor 3R3 200W | AMASS | XT30PW-M
XT30PW-M RS04 power (3-way split in the harness) | AMASS | XT30PW-M
XT30PW-M 48 V aux out | AMASS | XT30PW-M
GH1.25 RS04 CAN | JST | SM02B-GHS-TB(LF)(SN)
GH brushed motor | JST | SM02B-GHS-TB(LF)(SN)
GH CAN-FD uplink | JST | SM03B-GHS-TB(LF)(SN)
GH CAN-FD X (second limb / tool) | JST | SM03B-GHS-TB(LF)(SN)
GH aux 12V/5V/IO | JST | SM04B-GHS-TB(LF)(SN)
GH load cell EXC+/EXC-/S+/S- | JST | SM04B-GHS-TB(LF)(SN)
USB-C | GCT | USB4105-GF-A
HR911105A | HanRun | HR911105A
22u 1.5A | Bourns | SRN6045TA-220M
4.7u 3A | Bourns | SRN6045TA-4R7M
IPT015N10N5 100V 1.5mR | Infineon | IPT015N10N5ATMA1
0.5m 4-term | Vishay | WSK25120L500FEA
10k NTC (FETs) | Murata | NCP15XH103F03RC
10k NTC (brake R) | Murata | NCP15XH103F03RC
LM5060 | Texas Instruments | LM5060MMX/NOPB
74LVC1G11 | Texas Instruments | SN74LVC1G11DBVR
TPS3430 | Texas Instruments | TPS3430WDRCR
INA228 | Texas Instruments | INA228AIDGSR
TLV7031 | Texas Instruments | TLV7031DBVR
UCC27511A | Texas Instruments | UCC27511ADBVR
LM5164 48V->12V | Texas Instruments | LM5164DDAR
TPS54302 12V->5V | Texas Instruments | TPS54302DDCR
AP2112K-3.3 | Diodes Inc | AP2112K-3.3TRG1
STM32H723VGT6 | STMicroelectronics | STM32H723VGT6
MCP2562FD-E/SN | Microchip | MCP2562FDT-E/SN
USBLC6-2SC6 | STMicroelectronics | USBLC6-2SC6
LAN8742A-CZ | Microchip | LAN8742A-CZ-TR
ISM330DHCX | STMicroelectronics | ISM330DHCXTR
ADS1220IPW | Texas Instruments | ADS1220IPWR
MCP251863T-E/9PX | Microchip | MCP251863T-E/9PX
DRV8871DDAR | Texas Instruments | DRV8871DDAR
25MHz | Abracon | ABM8-25.000MHZ-B2-T
40MHz | Abracon | ABM8-40.000MHZ-B2-T
1u | Murata | GRM155R61A105KE15D
10p | Murata | GRM1555C1H100JA01D
PTC 60V 1.1A hold (Bel 0ZCF0110AF2A) | Bel Fuse | 0ZCF0110AF2A
