muni-works/rose/head/print/stl/cortex-full-glass.stl

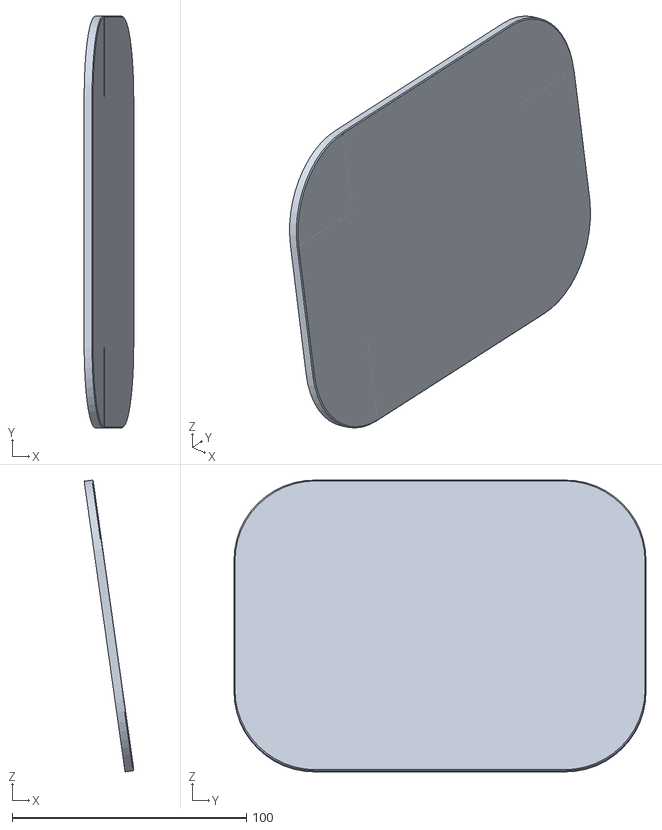
[picture p133: CAD file, 2026-10-21]
head/print/stl/cortex-full-glass.stl
21.2 x 176.0 x 124.7
