muni-works/rose/head/print/3mf/cortex-full-3-sled.3mf

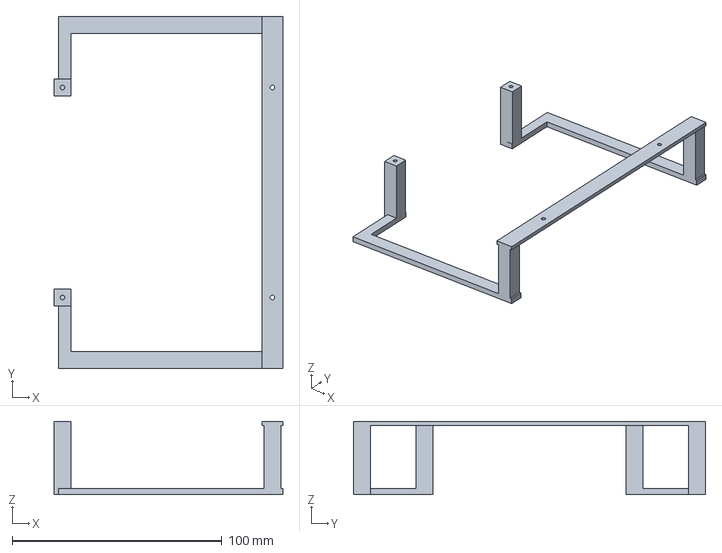
[picture p134: CAD file, 2026-10-21]
head/print/3mf/cortex-full-3-sled.3mf
109.2 x 168.0 x 35.0 mm
