muni-works/rose/head/print/stl/cortex-full-tub.stl

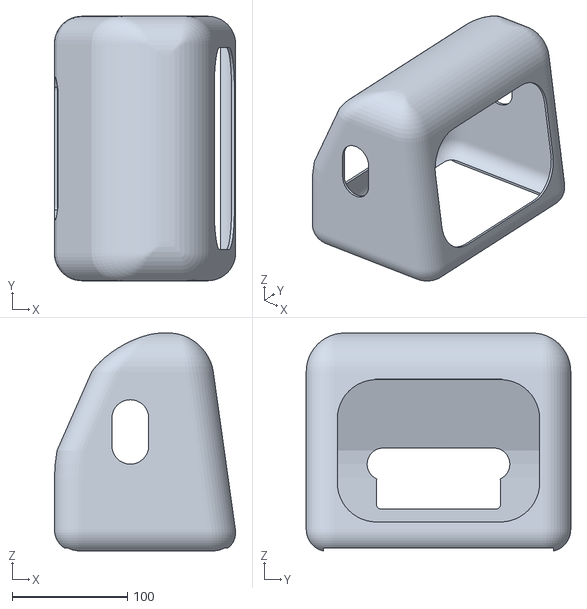
[picture p135: CAD file, 2026-10-21]
head/print/stl/cortex-full-tub.stl
157.5 x 230.0 x 189.5
