muni-works/rose/head/print/3mf/cortex-full-4-grilles.3mf

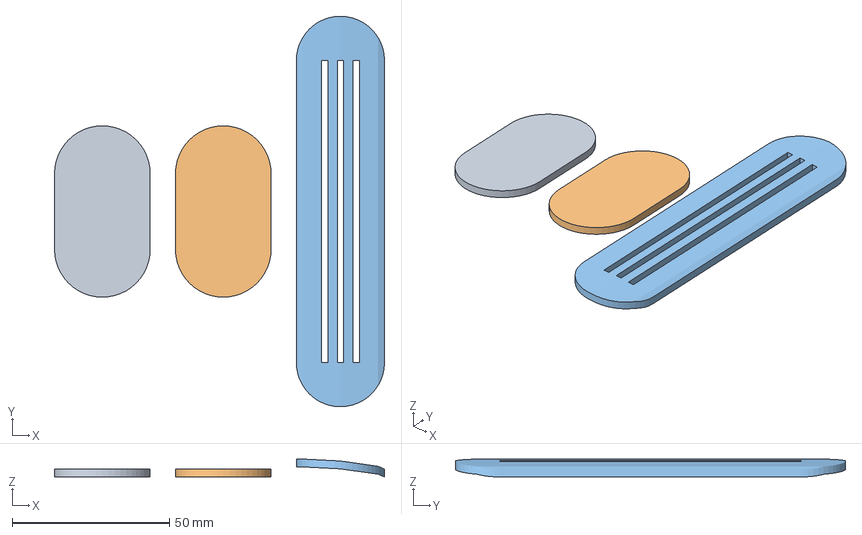
[picture p136: CAD file, 2026-10-21]
head/print/3mf/cortex-full-4-grilles.3mf
104.8 x 124.0 x 5.71 mm
ear-grille-r
ear-grille-l
exhaust-grille
