muni-works/rose/head/print/stl/cortex-full-exhaust-grille.stl

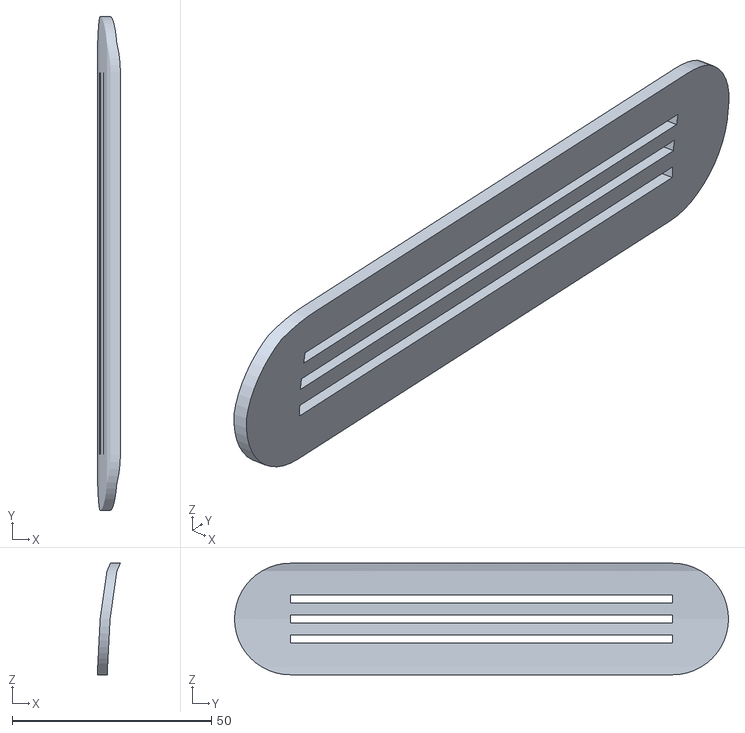
[picture p137: CAD file, 2026-10-21]
head/print/stl/cortex-full-exhaust-grille.stl
5.71 x 124.0 x 28.0
