muni-works/rose/head/print/stl/cortex-full-ear-grilles.stl

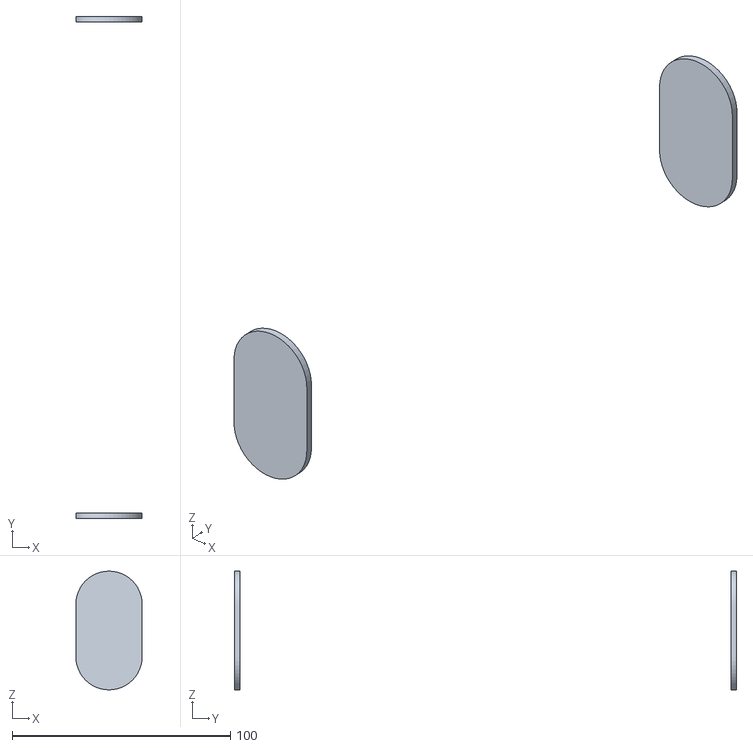
[picture p138: CAD file, 2026-10-21]
head/print/stl/cortex-full-ear-grilles.stl
30.4 x 230.0 x 54.4
