muni-works/rose/head/print/3mf/cortex-full-2-floor.3mf

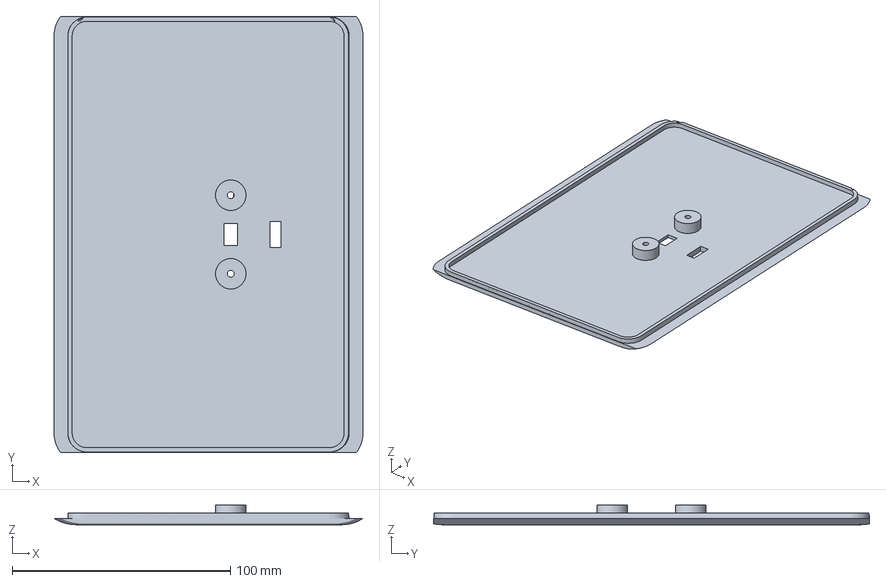
[picture p139: CAD file, 2026-10-21]
head/print/3mf/cortex-full-2-floor.3mf
141.7 x 200.0 x 9.00 mm
