muni-works/rose/head/print/3mf/cortex-full-5-glass.3mf

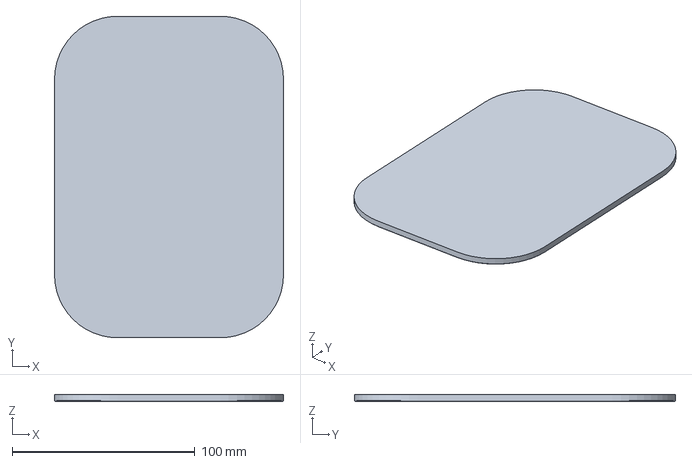
[picture p140: CAD file, 2026-10-21]
head/print/3mf/cortex-full-5-glass.3mf
125.4 x 176.0 x 3.85 mm
