muni-works/rose/arm/build/measure/cal_plate.dxf

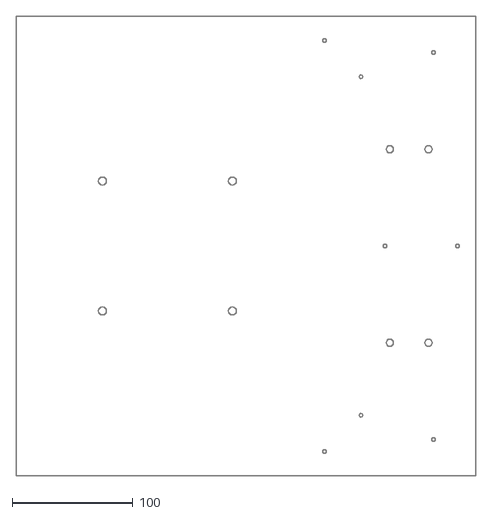
[picture p141: CAD file, 2026-10-21]
arm/build/measure/cal_plate.dxf
380.0 x 380.0
