muni-works/rose/arm/fab-v10/nest/3.2mm_sheet1.dxf

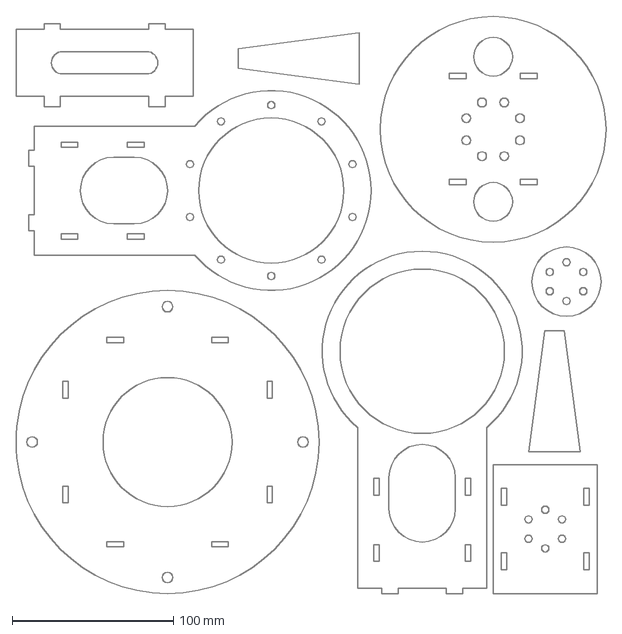
[picture p142: CAD file, 2026-10-21]
arm/fab-v10/nest/3.2mm_sheet1.dxf
366.0 x 358.0 mm
