muni-works/rose/arm/fab-v10/parts/fore-B_3.2mm_x1.dxf

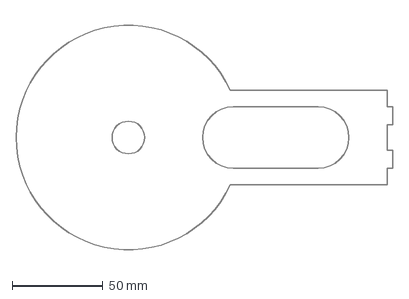
[picture p143: CAD file, 2026-10-21]
arm/fab-v10/parts/fore-B_3.2mm_x1.dxf
207.9 x 133.6 mm
