muni-works/rose/arm/fab/nest/3.2mm_sheet1.dxf

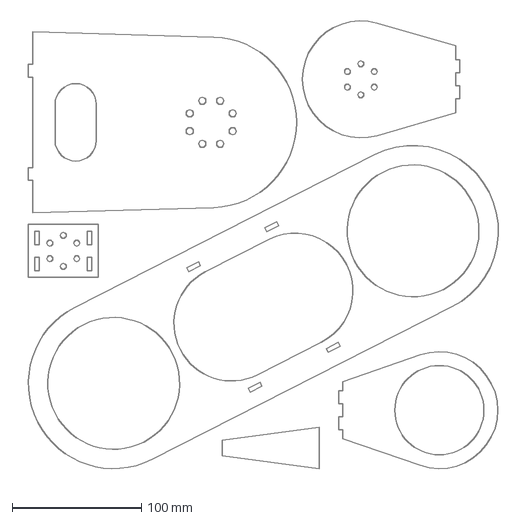
[picture p144: CAD file, 2026-10-21]
arm/fab/nest/3.2mm_sheet1.dxf
375.5 x 359.4 mm
