muni-works/rose/arm/fab/parts/turret-tower-B_3.2mm_x1.dxf

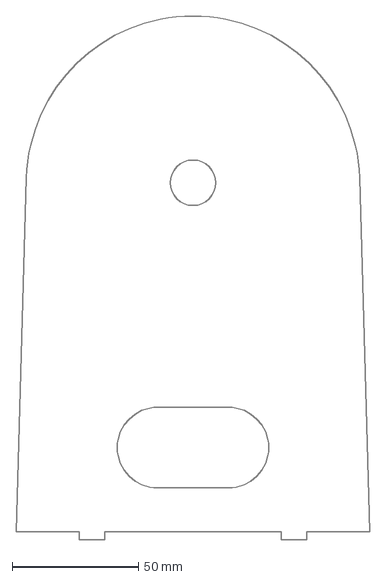
[picture p145: CAD file, 2026-10-21]
arm/fab/parts/turret-tower-B_3.2mm_x1.dxf
140.0 x 207.4 mm
