muni-works/rose/arm/interface/j1j2_envelope_l.stl

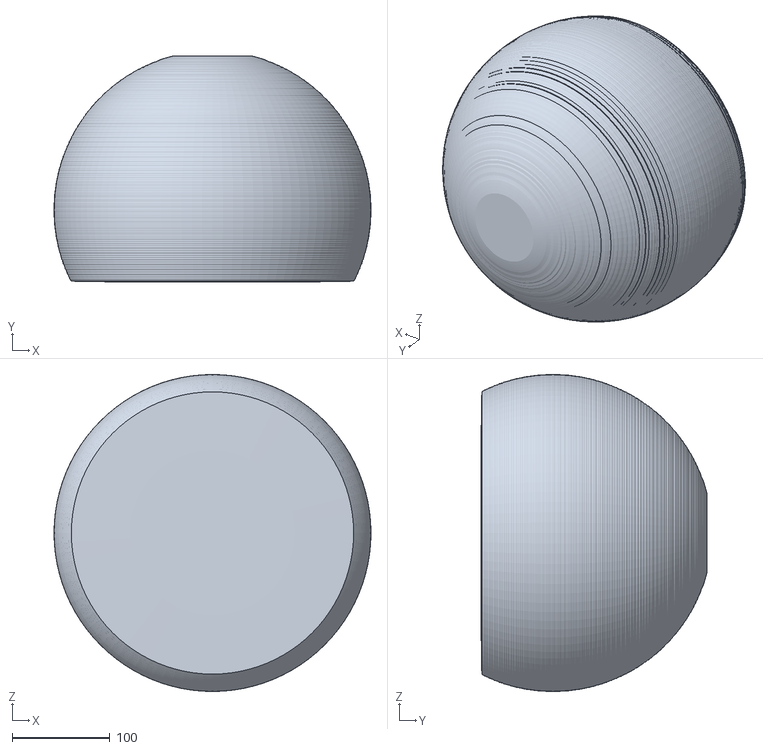
[picture p146: CAD file, 2026-10-21]
arm/interface/j1j2_envelope_l.stl
324.9 x 232.0 x 324.9
