muni-works/rose/arm/rig/cut/sheet_3.175mm_1.dxf

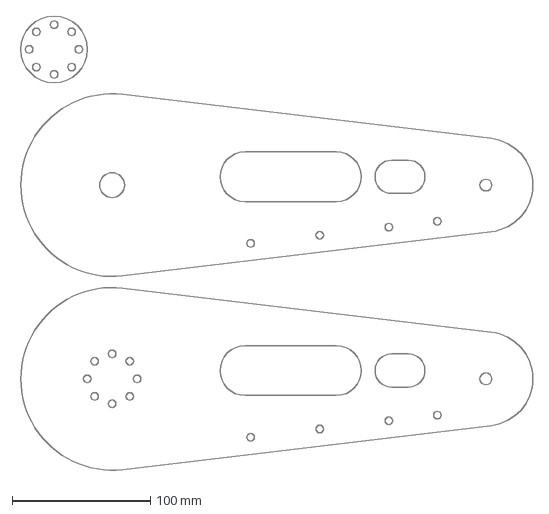
[picture p147: CAD file, 2026-10-14]
arm/rig/cut/sheet_3.175mm_1.dxf
373.4 x 330.6 mm
