muni-works/rose/arm/skin-stl/print/turret-front_body.stl

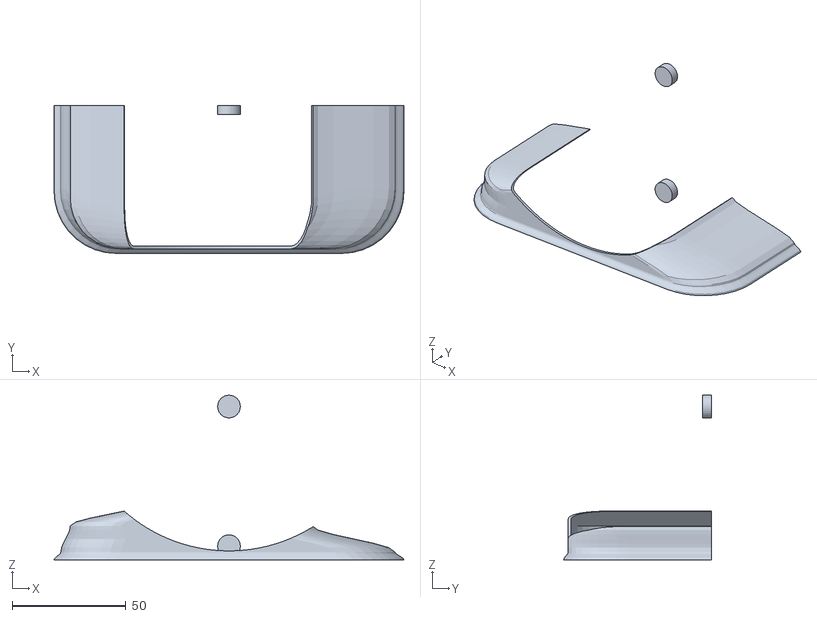
[picture p148: CAD file, 2026-10-21]
arm/skin-stl/print/turret-front_body.stl
153.9 x 65.0 x 72.5
