muni-works/rose/body/fab/plates/parts/arm-yokeP2_ra.dxf

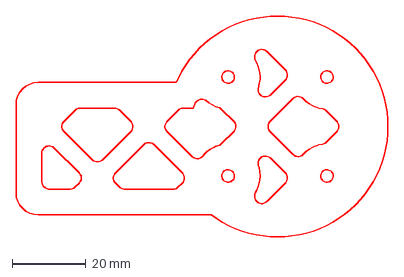
[picture p149: CAD file, 2026-10-29]
body/fab/plates/parts/arm-yokeP2_ra.dxf
101.1 x 60.0 mm
