muni-works/rose/body/fab/plates/sheet-3.dxf

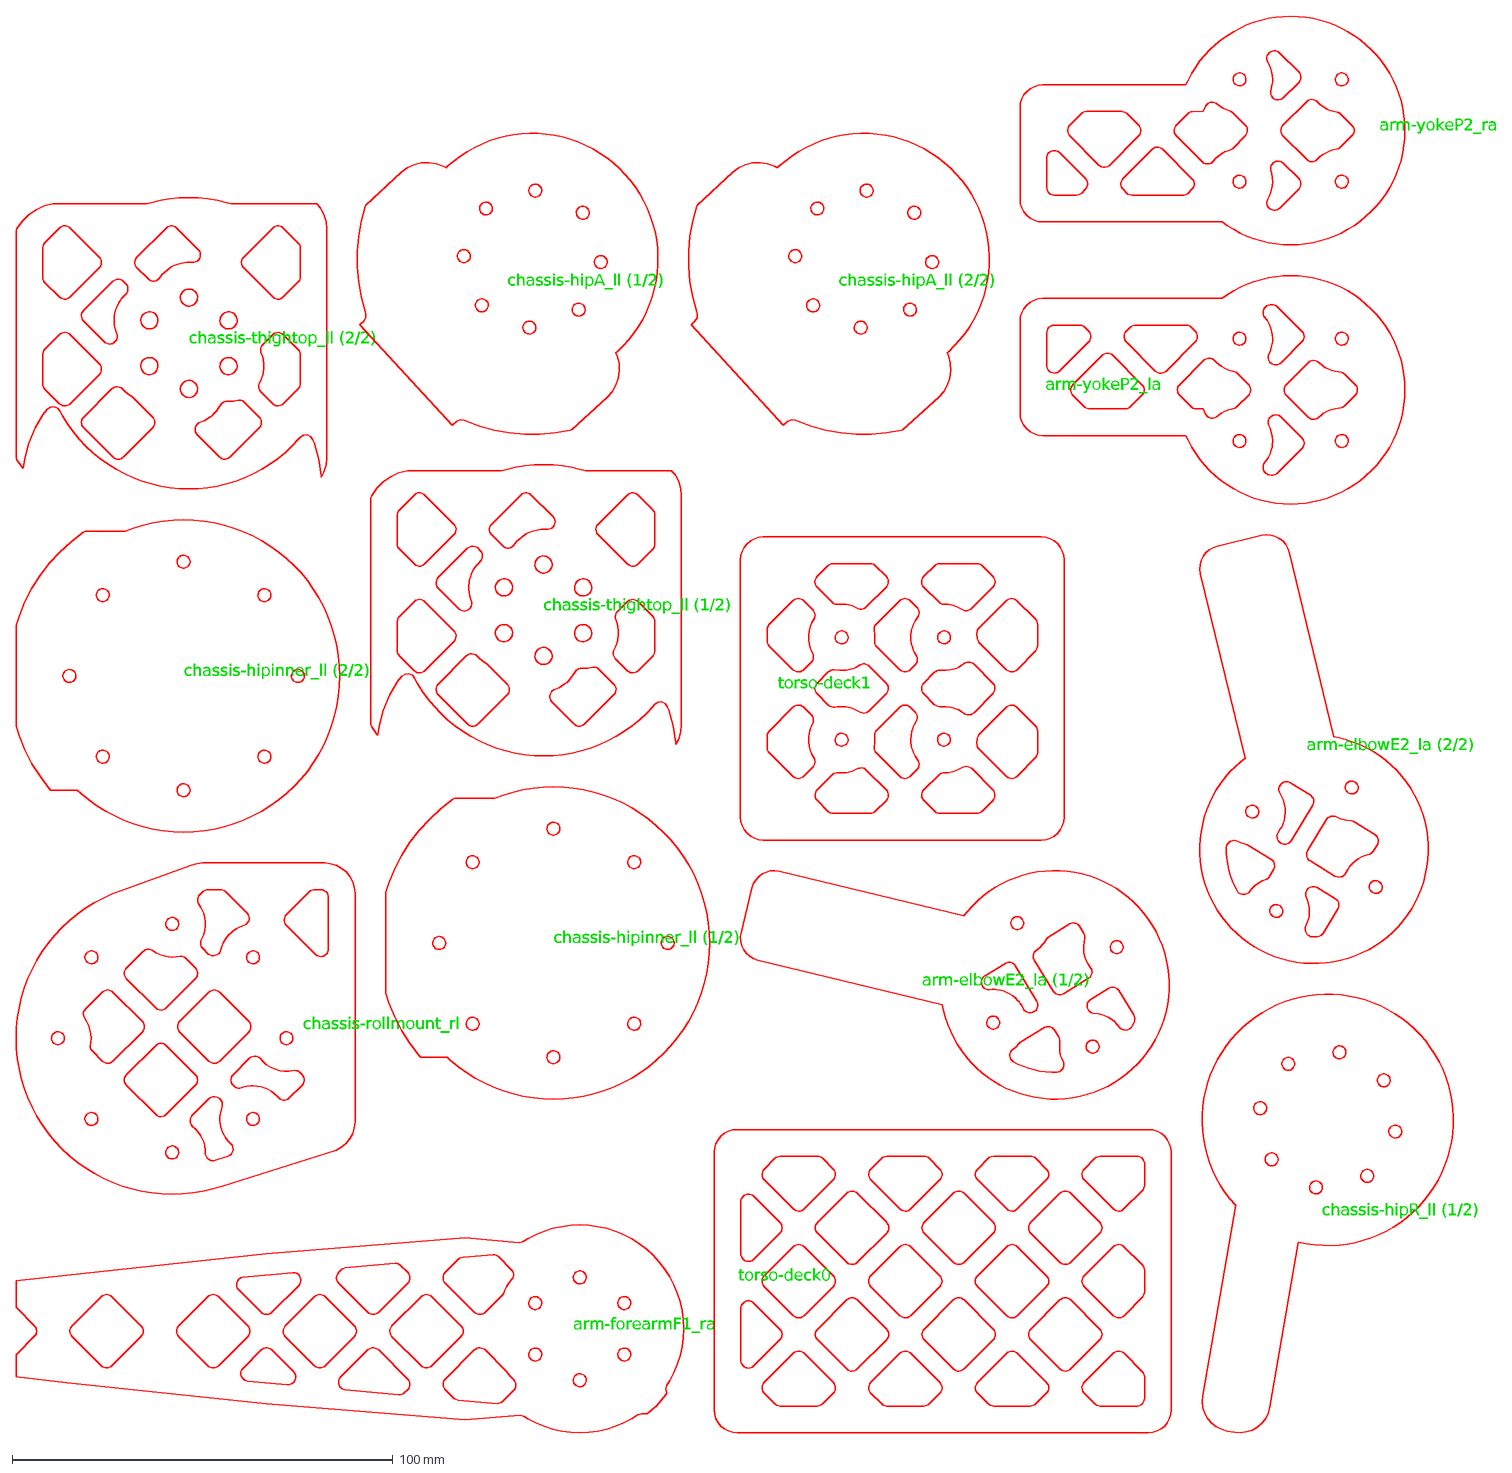
[picture p150: CAD file, 2026-10-29]
body/fab/plates/sheet-3.dxf
arm-forearmF1_ra
torso-deck0
chassis-rollmount_rl
chassis-hipR_ll (1/2)
chassis-hipinner_ll (1/2)
chassis-hipinner_ll (2/2)
arm-elbowE2_la (1/2)
arm-elbowE2_la (2/2)
torso-deck1
chassis-thightop_ll (1/2)
chassis-thightop_ll (2/2)
chassis-hipA_ll (1/2)
chassis-hipA_ll (2/2)
arm-yokeP2_la
arm-yokeP2_ra
