muni-works/rose/body/fab/shells/cover-forearm_la-a.stl

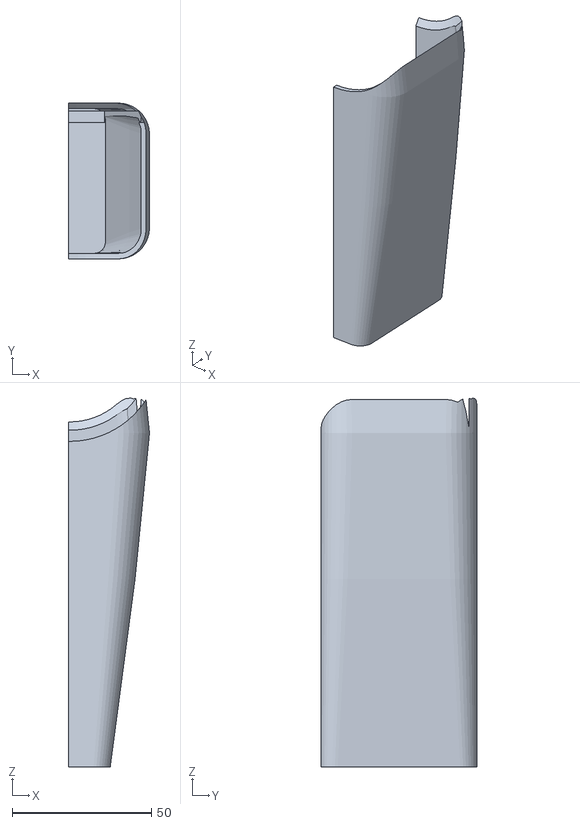
[picture p151: CAD file, 2026-10-29]
body/fab/shells/cover-forearm_la-a.stl
29.1 x 56.0 x 132.6
