muni-works/rose/body/vcad/full/stl/cover-deltoid_la.stl

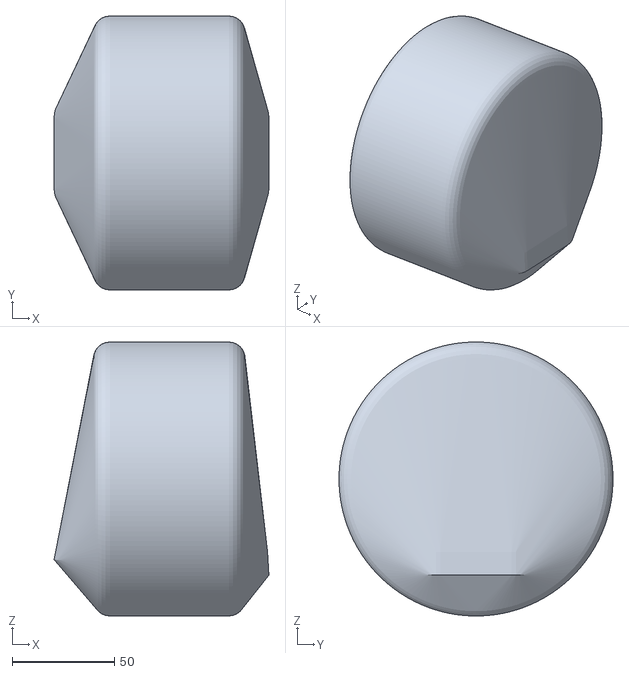
[picture p152: CAD file, 2026-10-21]
body/vcad/full/stl/cover-deltoid_la.stl
105.1 x 134.0 x 134.0
