muni-works/rose/body/vcad/mini/stl/thigh-inner_ll.stl

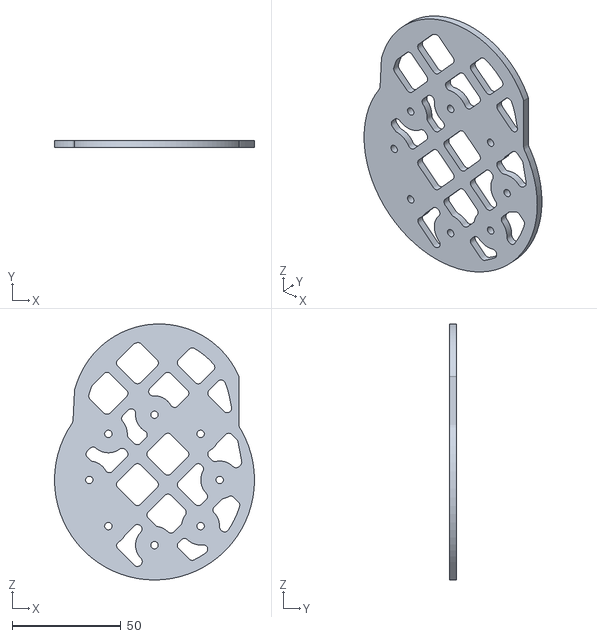
[picture p153: CAD file, 2026-10-21]
body/vcad/mini/stl/thigh-inner_ll.stl
92.0 x 3.20 x 117.7
