muni-works/rose/head/fab/cortex/print/cortex-ear-grille-r.stl

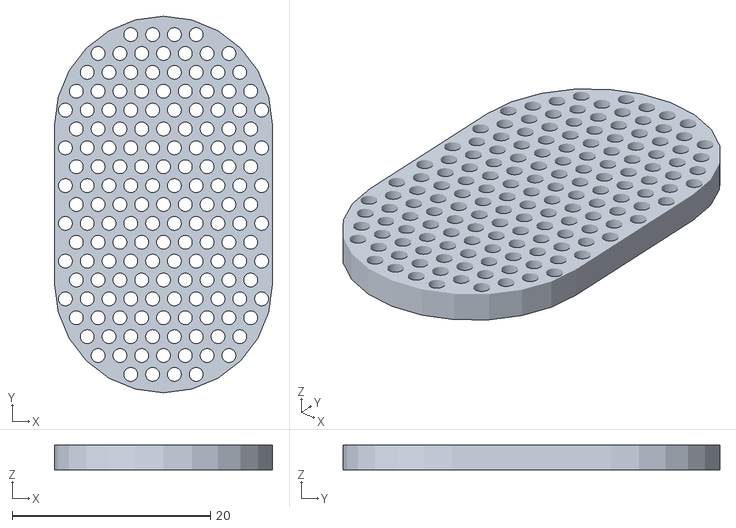
[picture p154: CAD file, 2026-10-29]
head/fab/cortex/print/cortex-ear-grille-r.stl
22.0 x 38.0 x 2.50
