muni-works/rose/head/fab/node/node-mvp.3mf

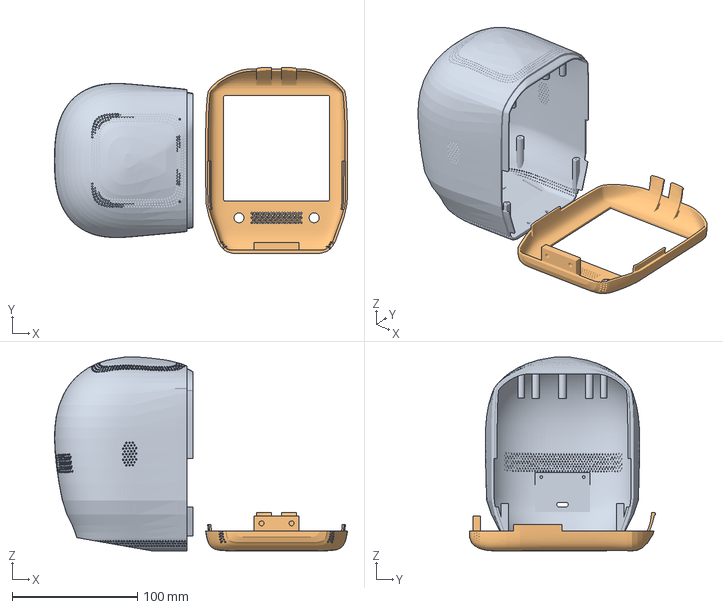
[picture p155: CAD file, 2026-10-29]
head/fab/node/node-mvp.3mf
234.0 x 148.6 x 154.8 mm
node-rear
node-face
