muni-works/rose/head/print/3mf/cortex-coupons.3mf

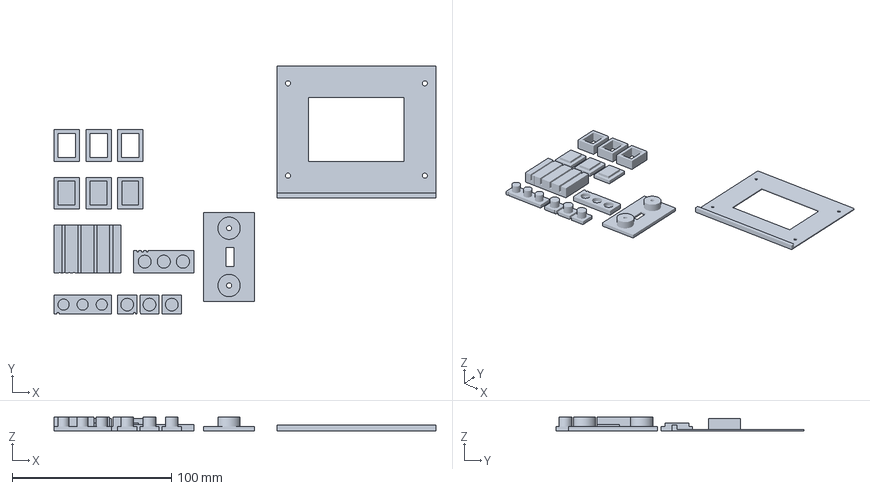
[picture p156: CAD file, 2026-10-21]
head/print/3mf/cortex-coupons.3mf
240.0 x 156.0 x 9.00 mm
