muni-works/rose/head/stl/dock-pawl.stl

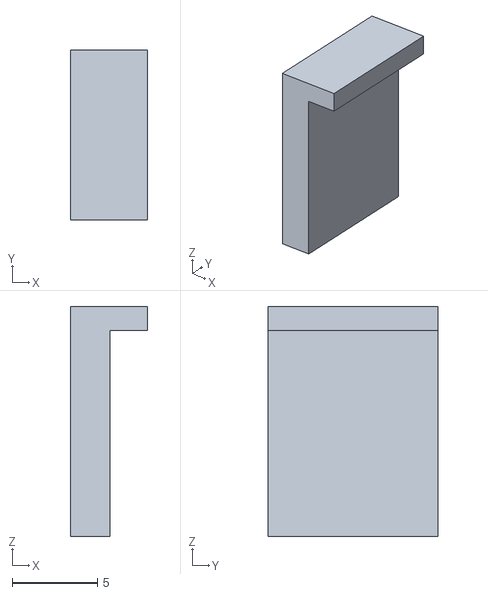
[picture p157: CAD file, 2026-10-29]
head/stl/dock-pawl.stl
4.50 x 10.0 x 13.5
