muni-works/rose/arm/fab-v10/nest/6.3mm_sheet1.dxf

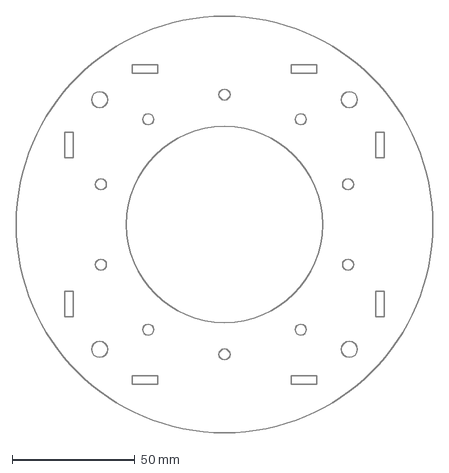
[picture p158: CAD file, 2026-10-21]
arm/fab-v10/nest/6.3mm_sheet1.dxf
170.0 x 170.0 mm
