muni-works/rose/arm/fab-v10/parts/upper-A_3.2mm_x1.dxf

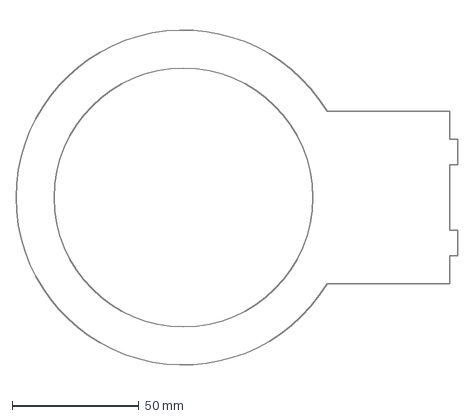
[picture p159: CAD file, 2026-10-21]
arm/fab-v10/parts/upper-A_3.2mm_x1.dxf
174.2 x 143.1 mm
