muni-works/rose/arm/fab/nest/3.2mm_sheet2.dxf

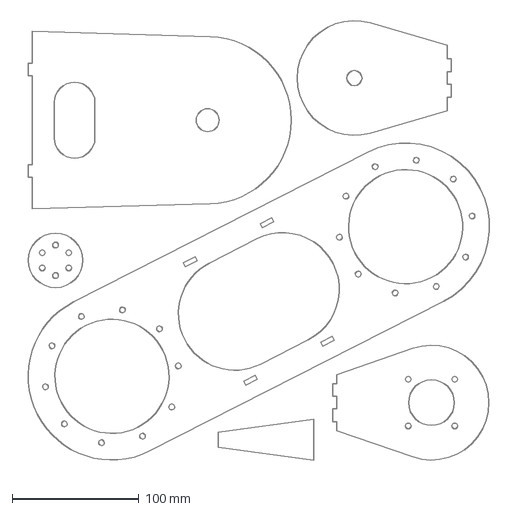
[picture p160: CAD file, 2026-10-21]
arm/fab/nest/3.2mm_sheet2.dxf
375.5 x 359.4 mm
