muni-works/rose/arm/fab/parts/turret-tower-A_3.2mm_x1.dxf

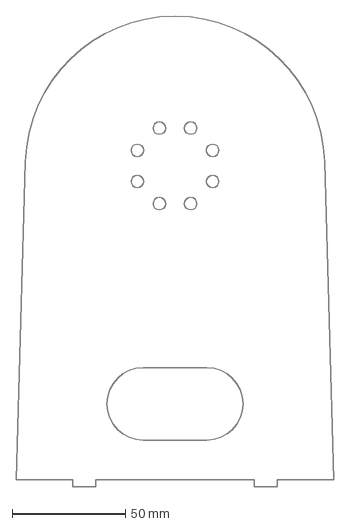
[picture p161: CAD file, 2026-10-21]
arm/fab/parts/turret-tower-A_3.2mm_x1.dxf
140.0 x 207.4 mm
