muni-works/rose/arm/skin-stl/print/wrist-front.stl

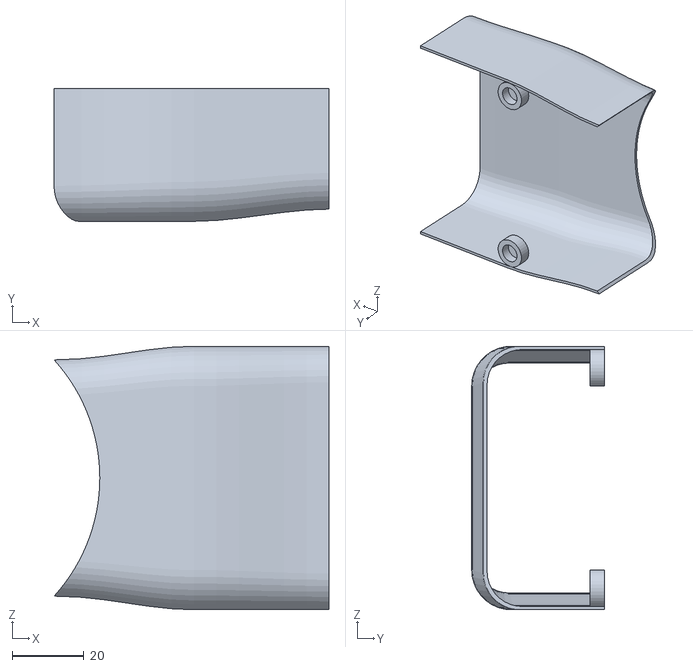
[picture p163: CAD file, 2026-10-21]
arm/skin-stl/print/wrist-front.stl
76.4 x 36.8 x 73.2
