muni-works/rose/body/fab/plates/sheet-4.dxf

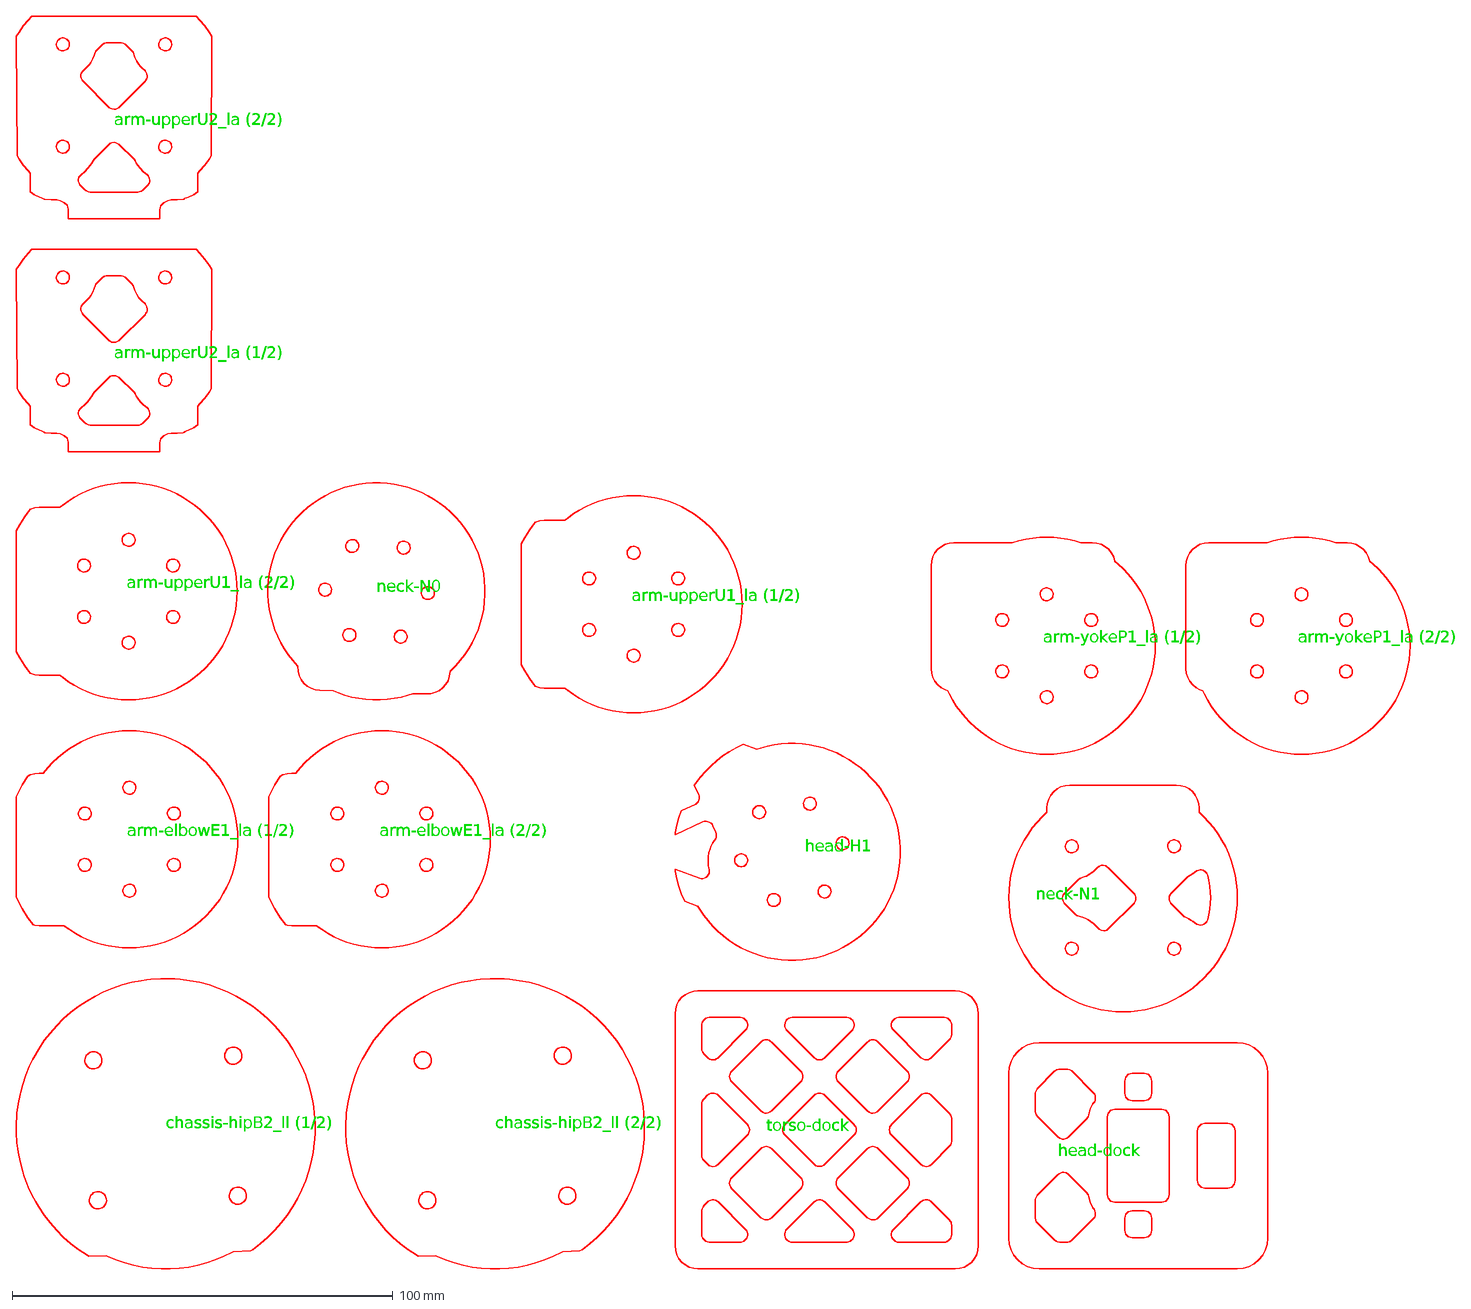
[picture p165: CAD file, 2026-10-29]
body/fab/plates/sheet-4.dxf
chassis-hipB2_ll (1/2)
chassis-hipB2_ll (2/2)
torso-dock
head-dock
neck-N1
head-H1
arm-yokeP1_la (1/2)
arm-yokeP1_la (2/2)
arm-elbowE1_la (1/2)
arm-elbowE1_la (2/2)
arm-upperU1_la (1/2)
arm-upperU1_la (2/2)
neck-N0
arm-upperU2_la (1/2)
arm-upperU2_la (2/2)
