muni-works/rose/body/fab/shells/cover-deltoid_la-b.stl

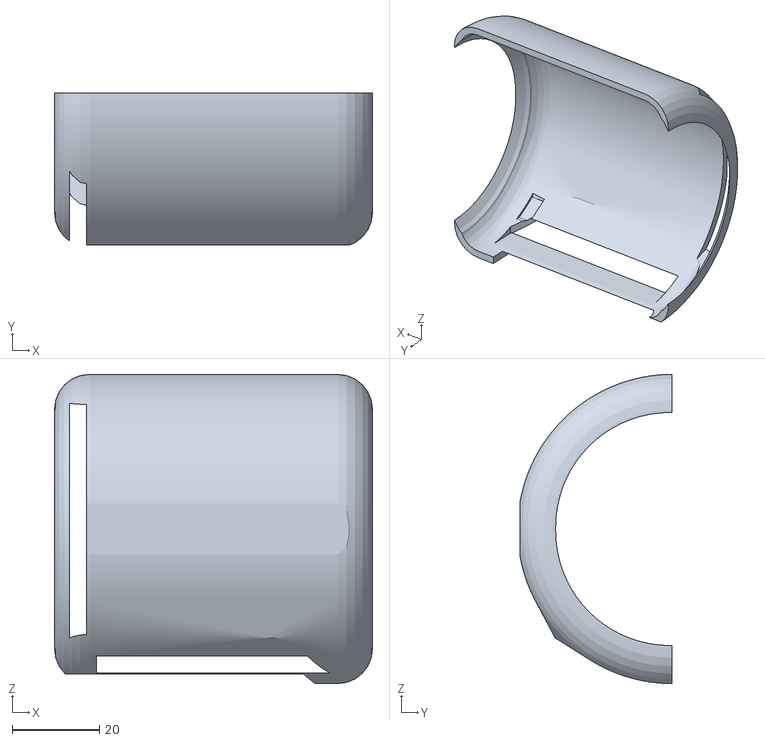
[picture p166: CAD file, 2026-10-29]
body/fab/shells/cover-deltoid_la-b.stl
73.0 x 35.0 x 71.0
