muni-works/rose/body/vcad/full/stl/cover-dockcollar.stl

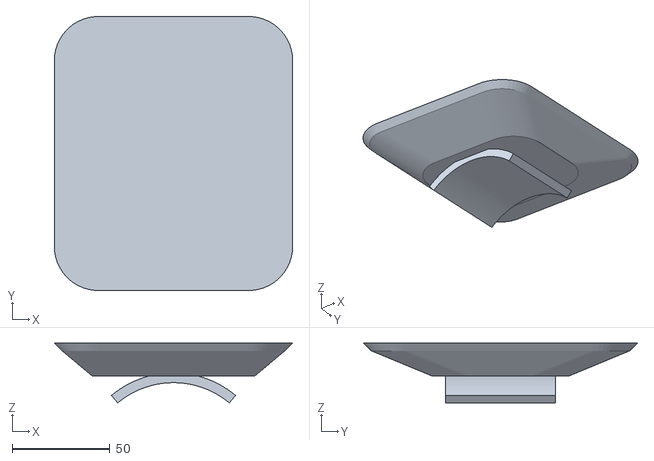
[picture p167: CAD file, 2026-10-21]
body/vcad/full/stl/cover-dockcollar.stl
121.8 x 140.0 x 30.6
