muni-works/rose/body/vcad/mini/stl/cover-dockcollar.stl

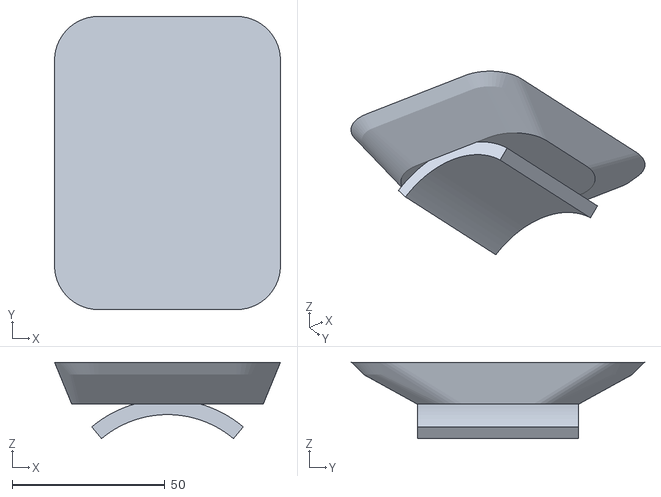
[picture p168: CAD file, 2026-10-21]
body/vcad/mini/stl/cover-dockcollar.stl
74.0 x 96.0 x 25.0
