muni-works/rose/head/fab/cortex/print/cortex-sled-print-r.stl

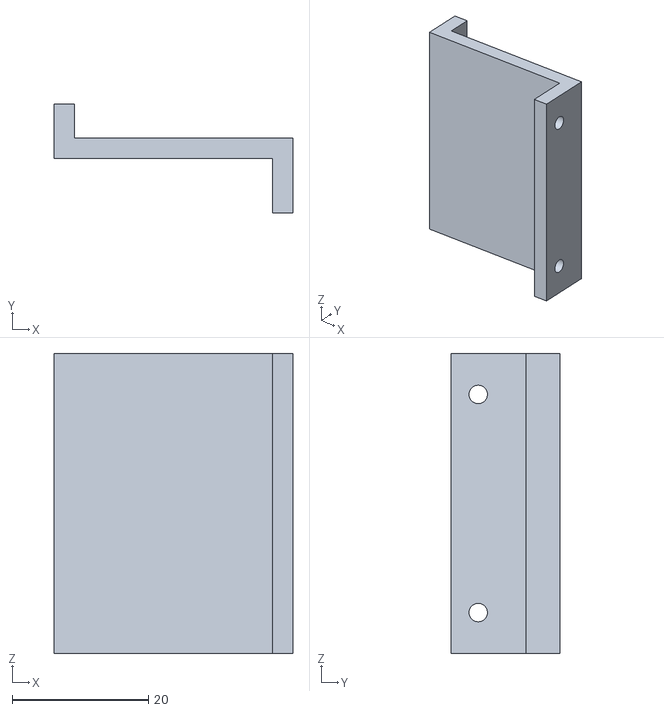
[picture p169: CAD file, 2026-10-29]
head/fab/cortex/print/cortex-sled-print-r.stl
35.0 x 16.0 x 44.0
