muni-works/rose/head/stl/cortex-keeper.stl

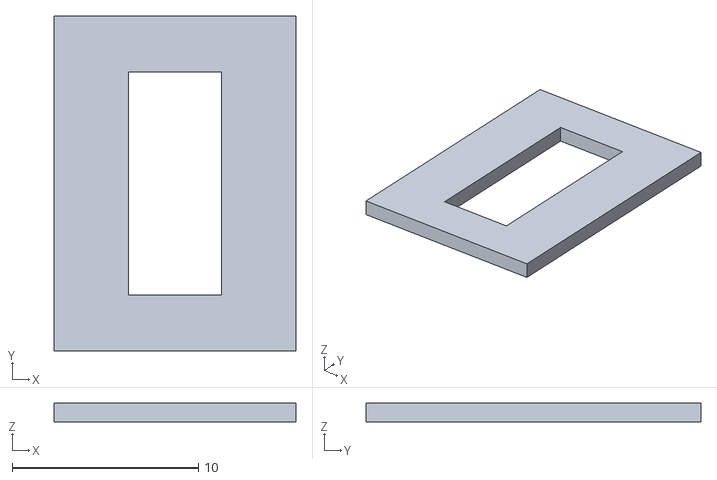
[picture p170: CAD file, 2026-10-29]
head/stl/cortex-keeper.stl
13.0 x 18.0 x 1.00
