muni-works/rose/arm/fab-v10/nest/3.2mm_sheet2.dxf

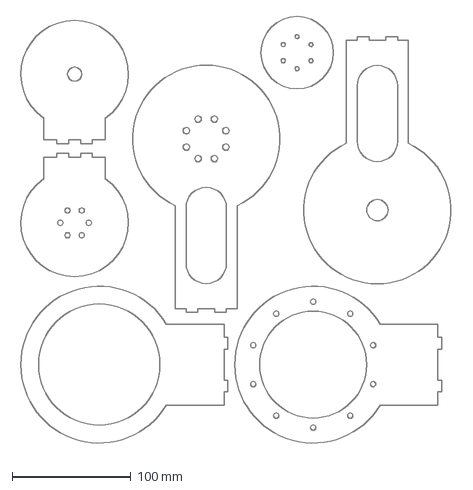
[picture p171: CAD file, 2026-10-21]
arm/fab-v10/nest/3.2mm_sheet2.dxf
370.7 x 364.5 mm
