muni-works/rose/arm/fab-v10/parts/pedestal-X_3.2mm_x4.dxf

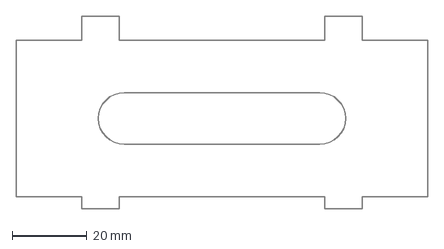
[picture p172: CAD file, 2026-10-21]
arm/fab-v10/parts/pedestal-X_3.2mm_x4.dxf
110.0 x 51.4 mm
