muni-works/rose/arm/fab/nest/6.3mm_sheet1.dxf

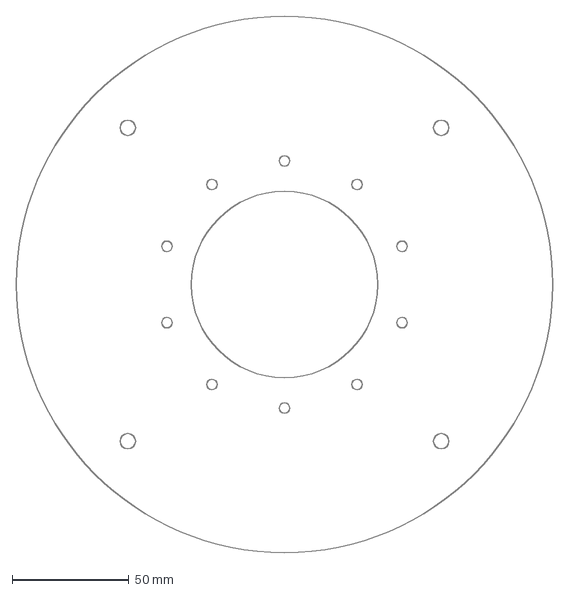
[picture p173: CAD file, 2026-10-14]
arm/fab/nest/6.3mm_sheet1.dxf
230.0 x 230.0 mm
