muni-works/rose/arm/fab/parts/spacer-RS04_3.2mm_x2.dxf

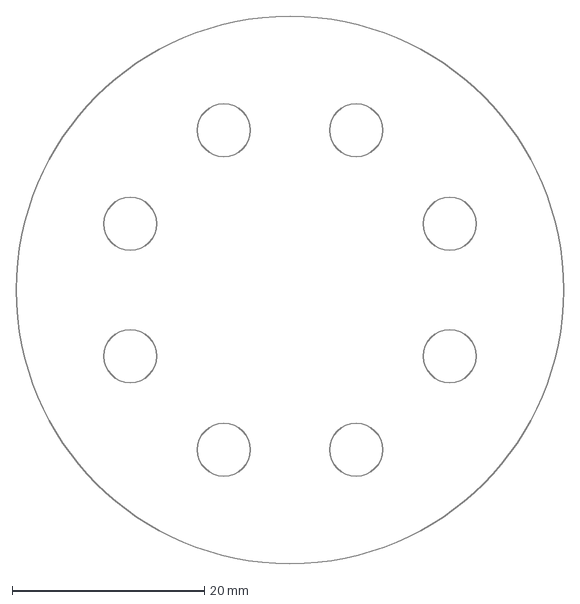
[picture p174: CAD file, 2026-10-14]
arm/fab/parts/spacer-RS04_3.2mm_x2.dxf
57.0 x 57.0 mm
