muni-works/rose/arm/skin-stl/print/disc-J2+1.stl

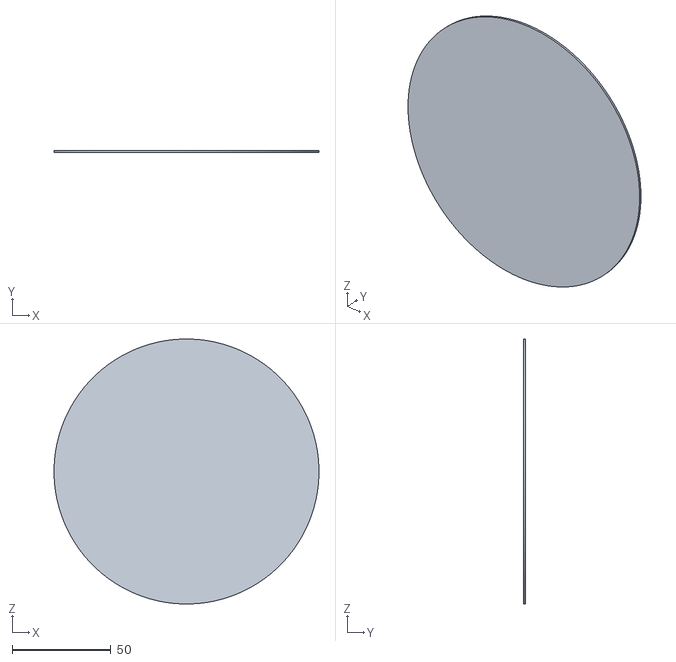
[picture p176: CAD file, 2026-10-21]
arm/skin-stl/print/disc-J2+1.stl
134.0 x 1.01 x 134.0
