muni-works/rose/body/fab/plates/parts/neck-N1.dxf

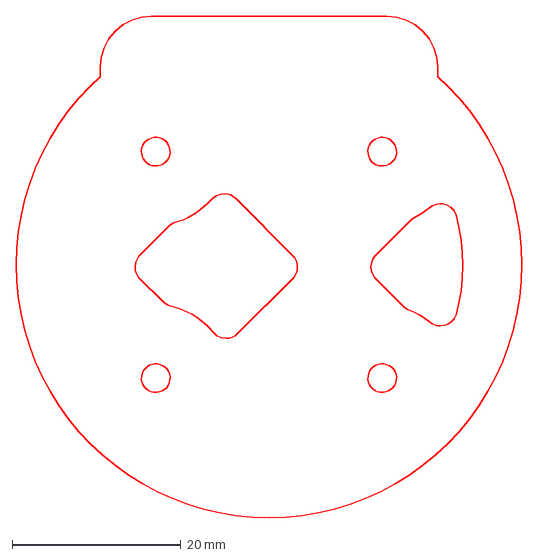
[picture p177: CAD file, 2026-10-29]
body/fab/plates/parts/neck-N1.dxf
60.0 x 59.5 mm
