muni-works/rose/body/fab/plates/sheet-2.dxf

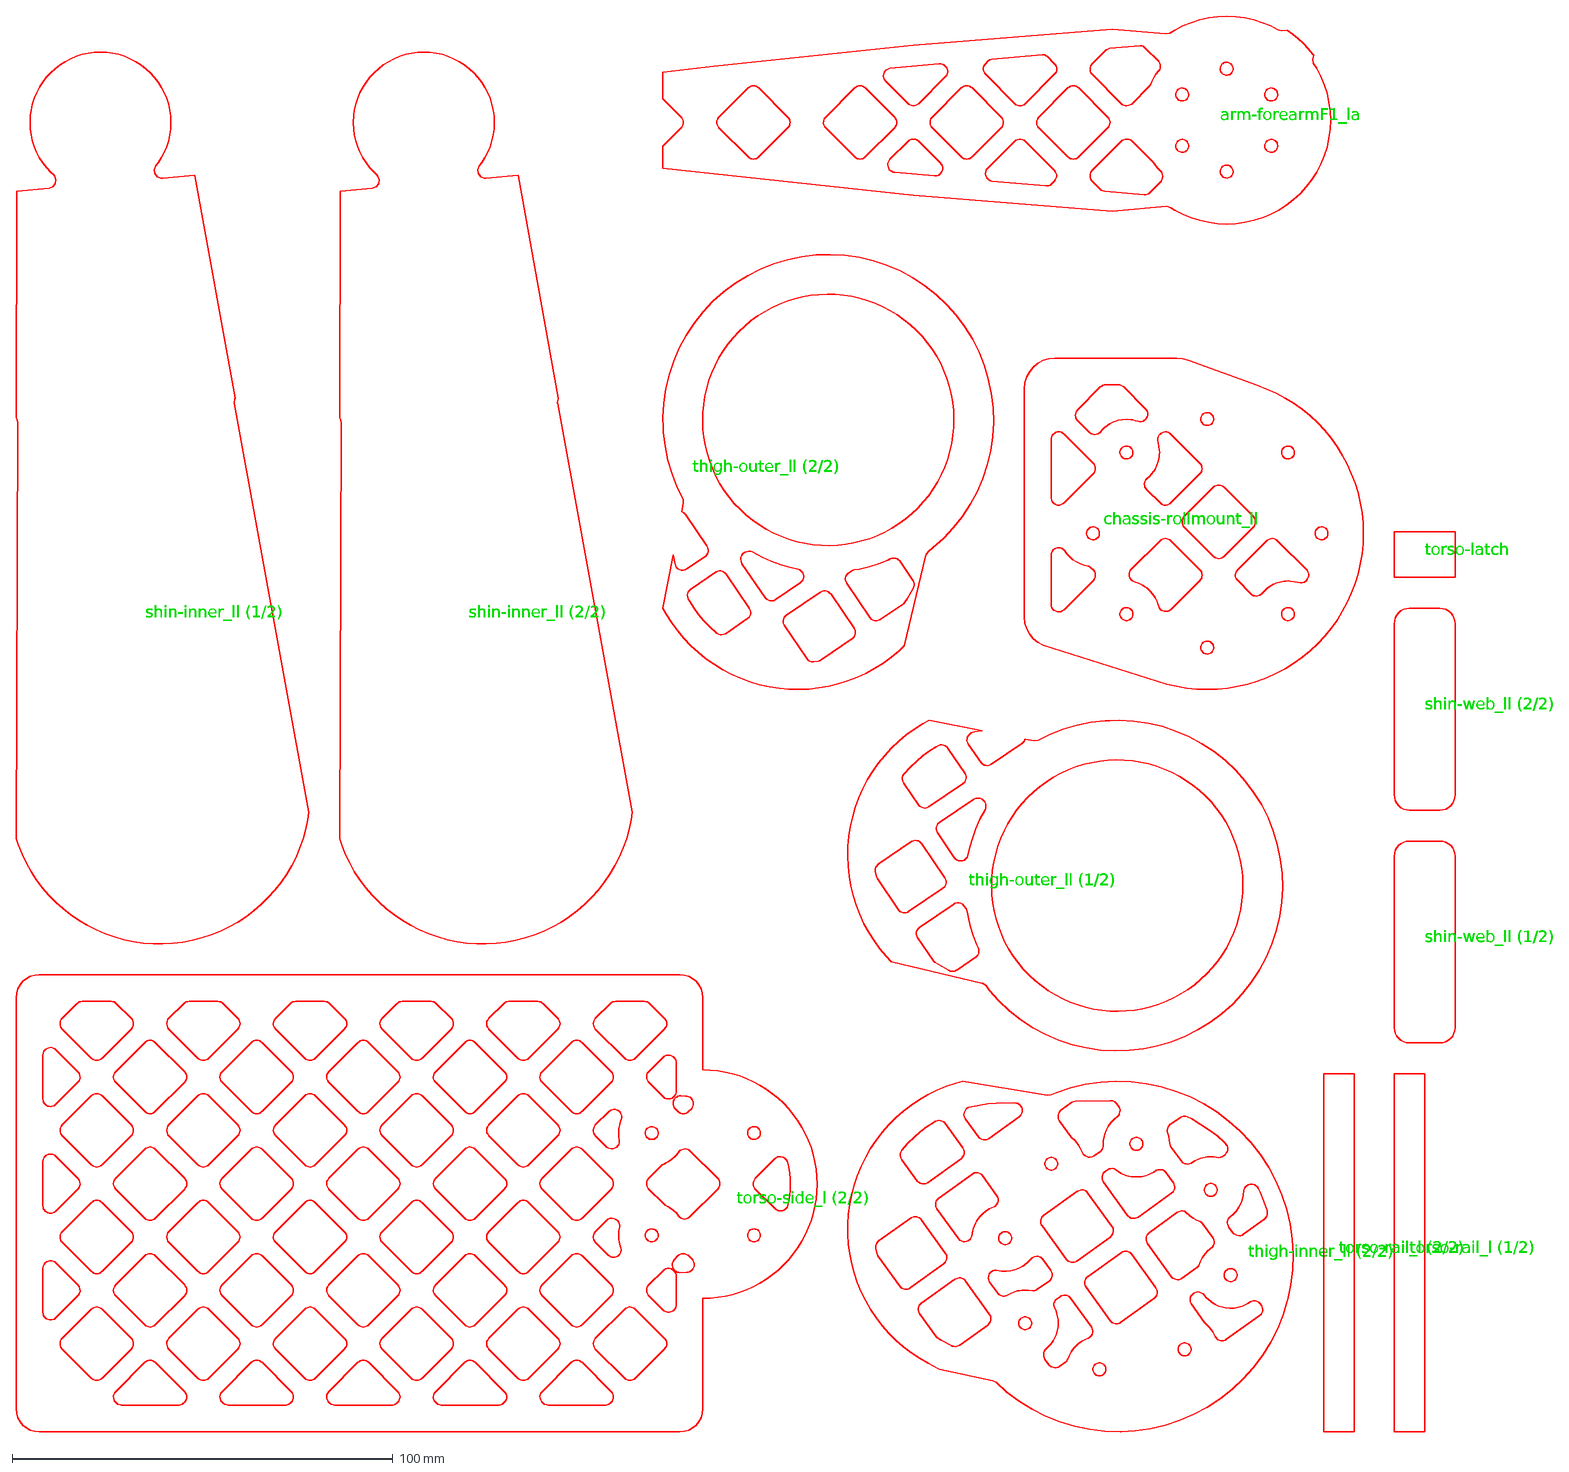
[picture p178: CAD file, 2026-10-29]
body/fab/plates/sheet-2.dxf
torso-side_l (2/2)
shin-inner_ll (1/2)
shin-inner_ll (2/2)
thigh-inner_ll (2/2)
thigh-outer_ll (1/2)
thigh-outer_ll (2/2)
arm-forearmF1_la
chassis-rollmount_ll
torso-rail_l (1/2)
torso-rail_l (2/2)
shin-web_ll (1/2)
shin-web_ll (2/2)
torso-latch
