muni-works/rose/body/fab/shells/cover-headhub-b.stl

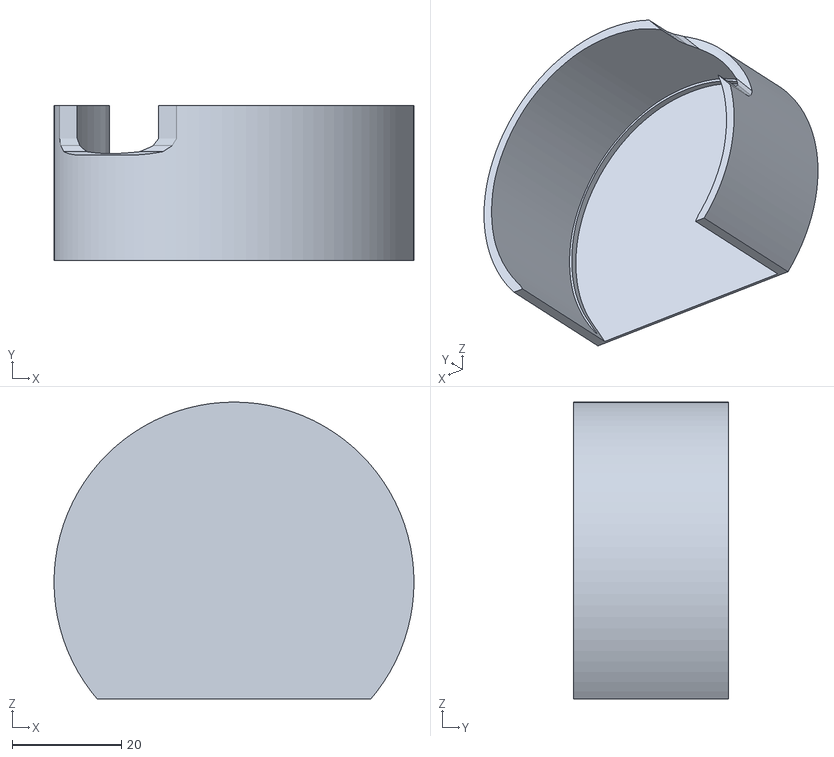
[picture p179: CAD file, 2026-10-29]
body/fab/shells/cover-headhub-b.stl
66.0 x 28.4 x 54.4
