muni-works/rose/body/vcad/full/stl/trim-j1ring_r.stl

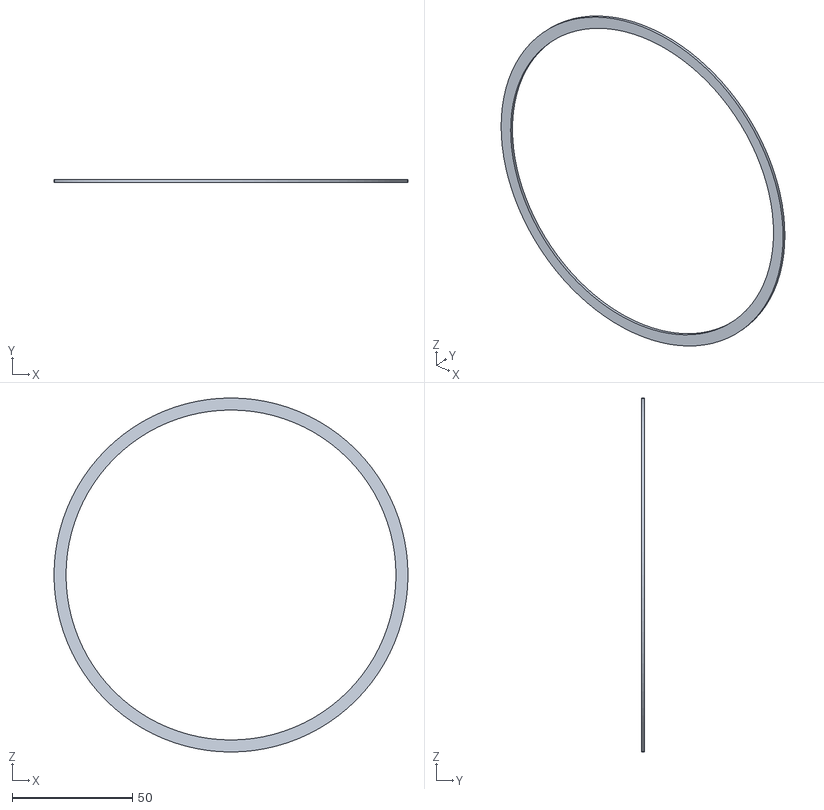
[picture p180: CAD file, 2026-10-21]
body/vcad/full/stl/trim-j1ring_r.stl
147.1 x 1.20 x 147.1
