muni-works/rose/body/vcad/mini/stl/cover-deltoid_ra.stl

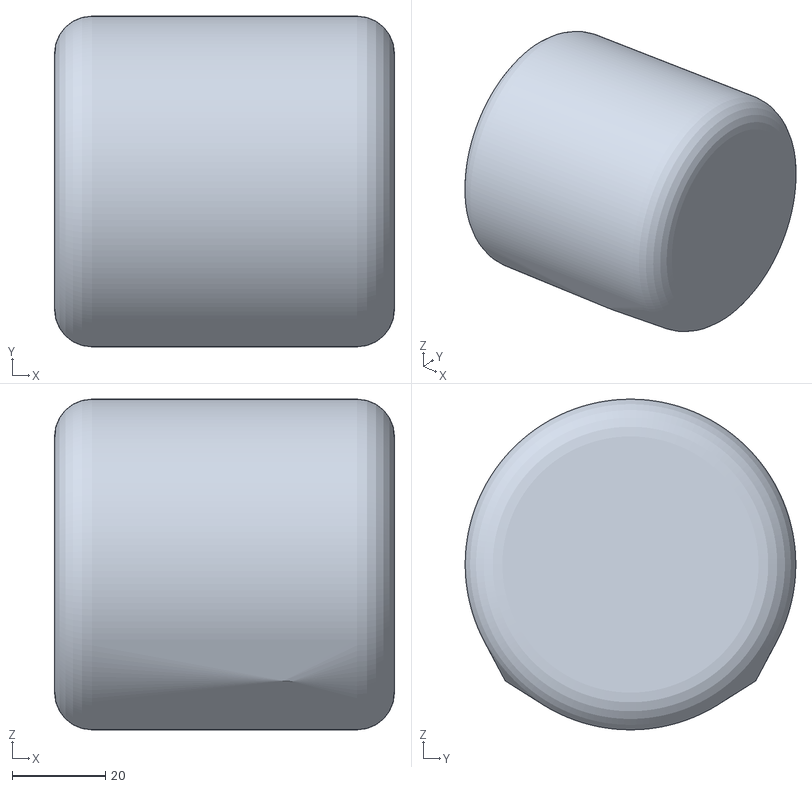
[picture p181: CAD file, 2026-10-21]
body/vcad/mini/stl/cover-deltoid_ra.stl
73.0 x 71.0 x 71.0
