muni-works/rose/head/fab/node/node-mvp-asa.3mf

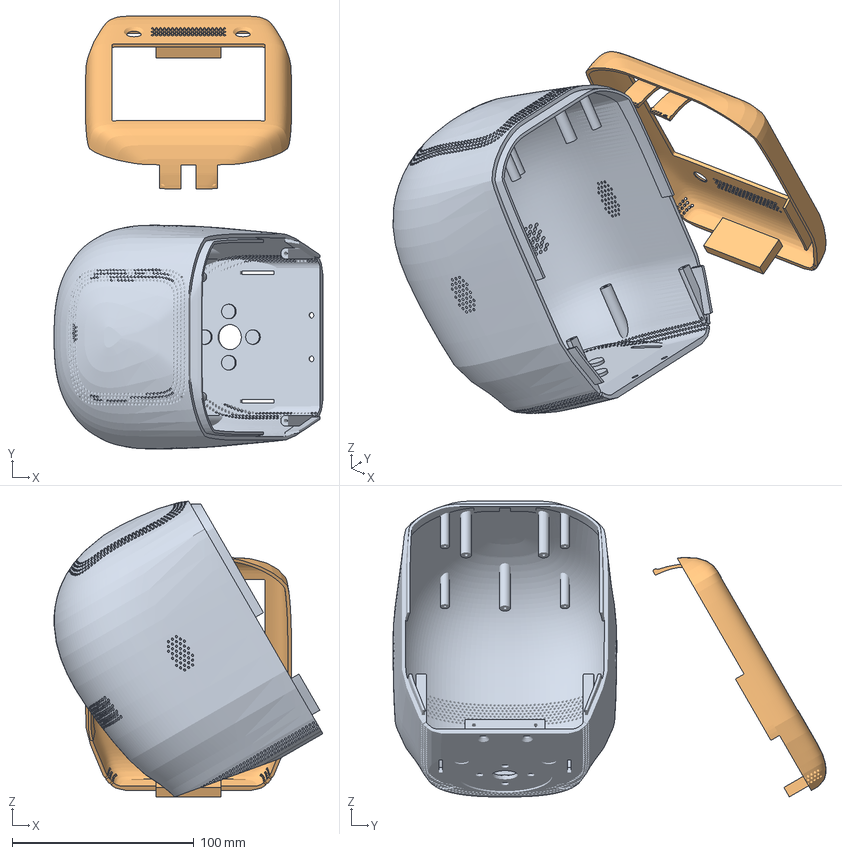
[picture p182: CAD file, 2026-10-29]
head/fab/node/node-mvp-asa.3mf
147.9 x 238.2 x 162.7 mm
node-rear
node-face
