muni-works/rose/head/stl/cortex-glass.stl

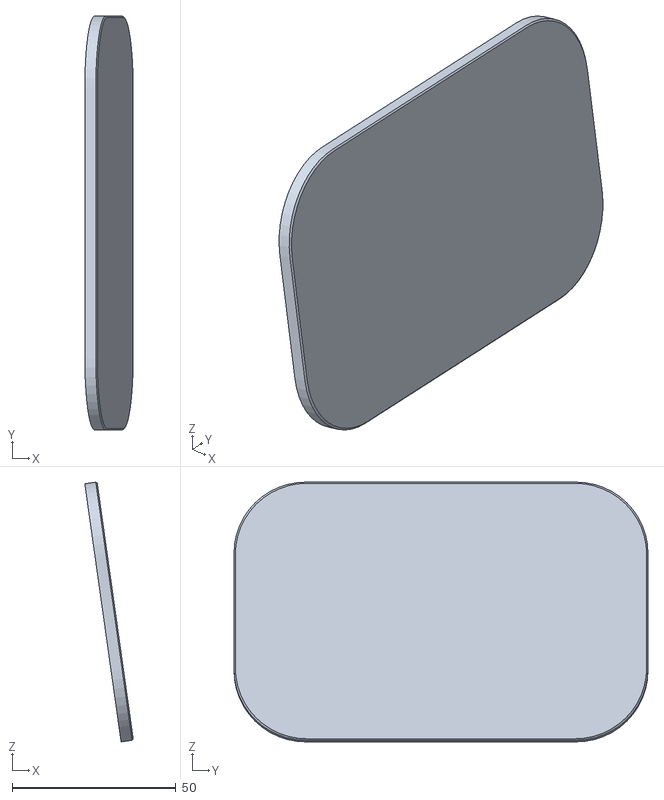
[picture p183: CAD file, 2026-10-29]
head/stl/cortex-glass.stl
14.8 x 126.4 x 79.3
