muni-works/rose/arm/fab-v10/nest/3.2mm_sheet3.dxf

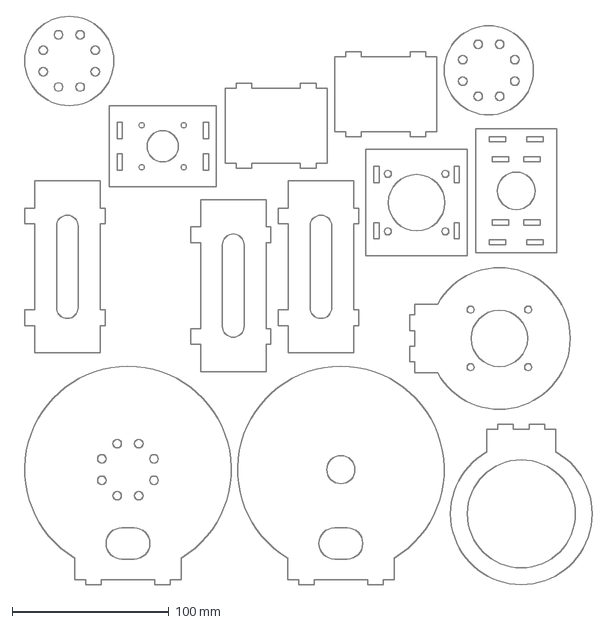
[picture p184: CAD file, 2026-10-21]
arm/fab-v10/nest/3.2mm_sheet3.dxf
371.8 x 363.0 mm
