muni-works/rose/arm/fab-v10/parts/upper-end-plate_3.2mm_x1.dxf

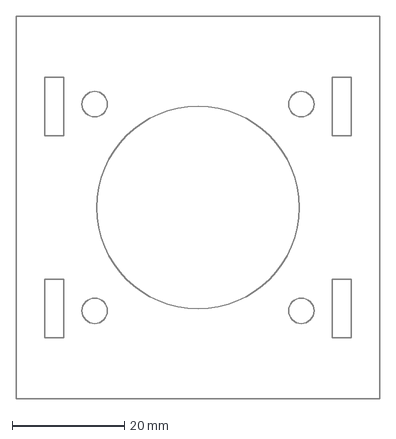
[picture p185: CAD file, 2026-10-21]
arm/fab-v10/parts/upper-end-plate_3.2mm_x1.dxf
64.7 x 68.0 mm
