muni-works/rose/arm/fab/nest/3.2mm_sheet3.dxf

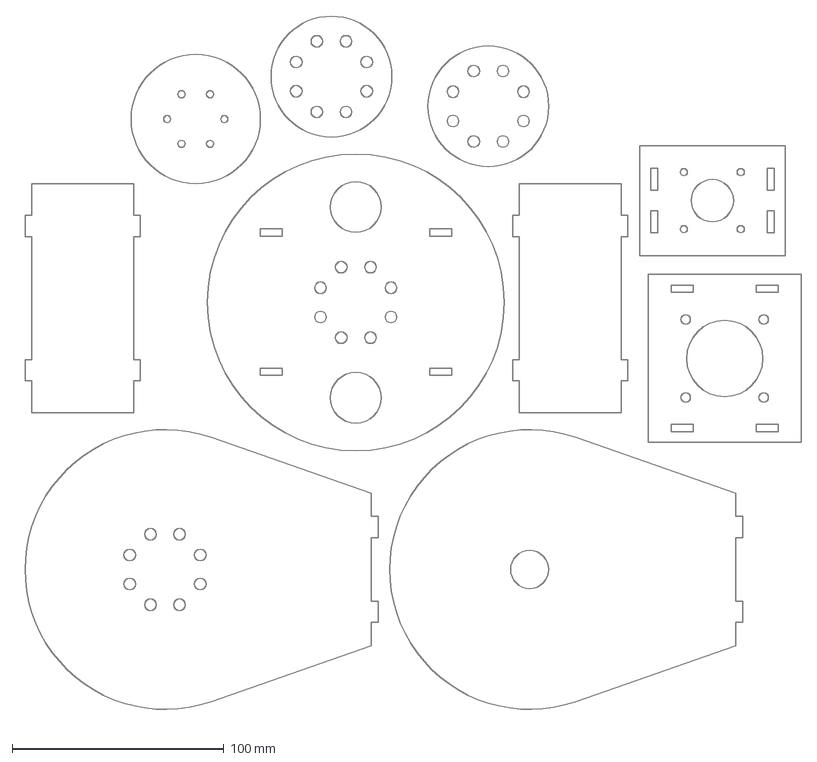
[picture p186: CAD file, 2026-10-14]
arm/fab/nest/3.2mm_sheet3.dxf
370.3 x 332.8 mm
