muni-works/rose/arm/fab/parts/spacer-RS02_3.2mm_x1.dxf

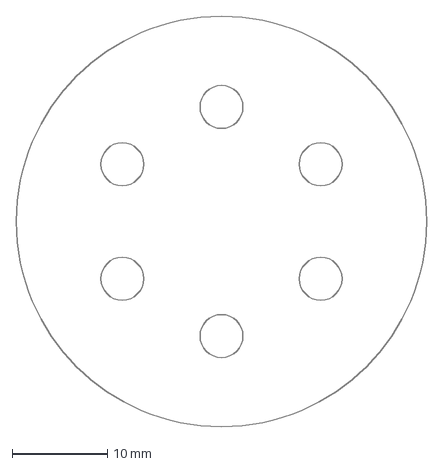
[picture p187: CAD file, 2026-10-14]
arm/fab/parts/spacer-RS02_3.2mm_x1.dxf
43.0 x 43.0 mm
