muni-works/rose/arm/rig/cut/parent_A_3.175mm.dxf

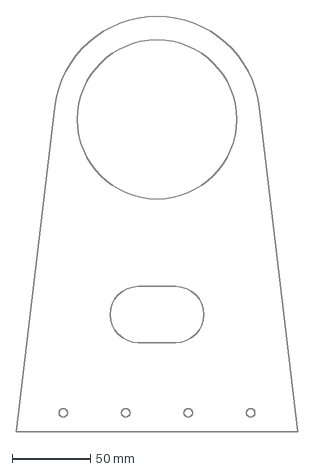
[picture p188: CAD file, 2026-10-14]
arm/rig/cut/parent_A_3.175mm.dxf
180.0 x 266.0 mm
