muni-works/rose/arm/skin-stl/print/disc-J4+1.stl

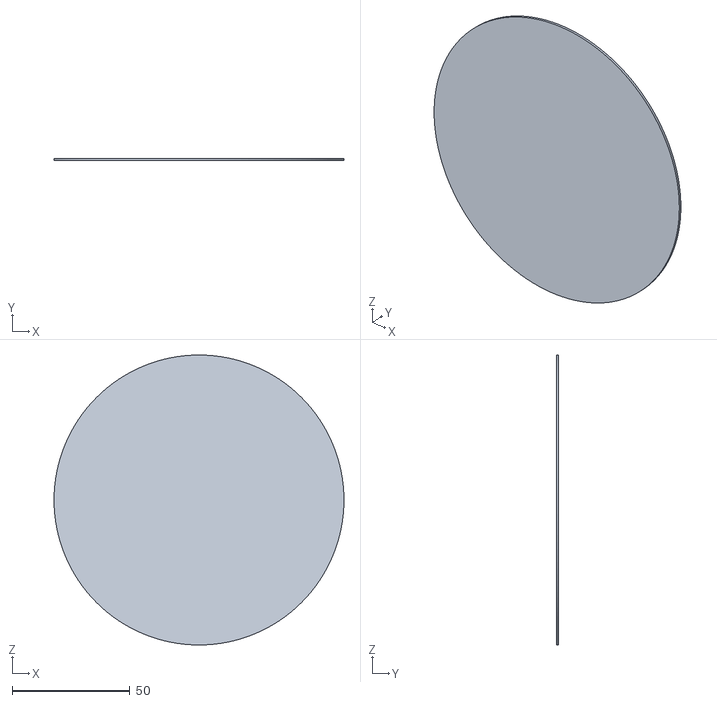
[picture p189: CAD file, 2026-10-21]
arm/skin-stl/print/disc-J4+1.stl
123.0 x 1.01 x 123.0
