muni-works/rose/body/fab/plates/parts/torso-rail_l.dxf

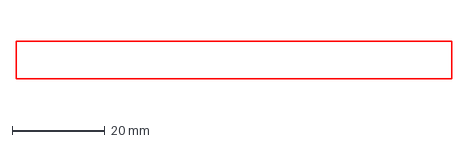
[picture p190: CAD file, 2026-10-29]
body/fab/plates/parts/torso-rail_l.dxf
94.0 x 8.00 mm
