muni-works/rose/body/fab/plates/sheet-1.dxf

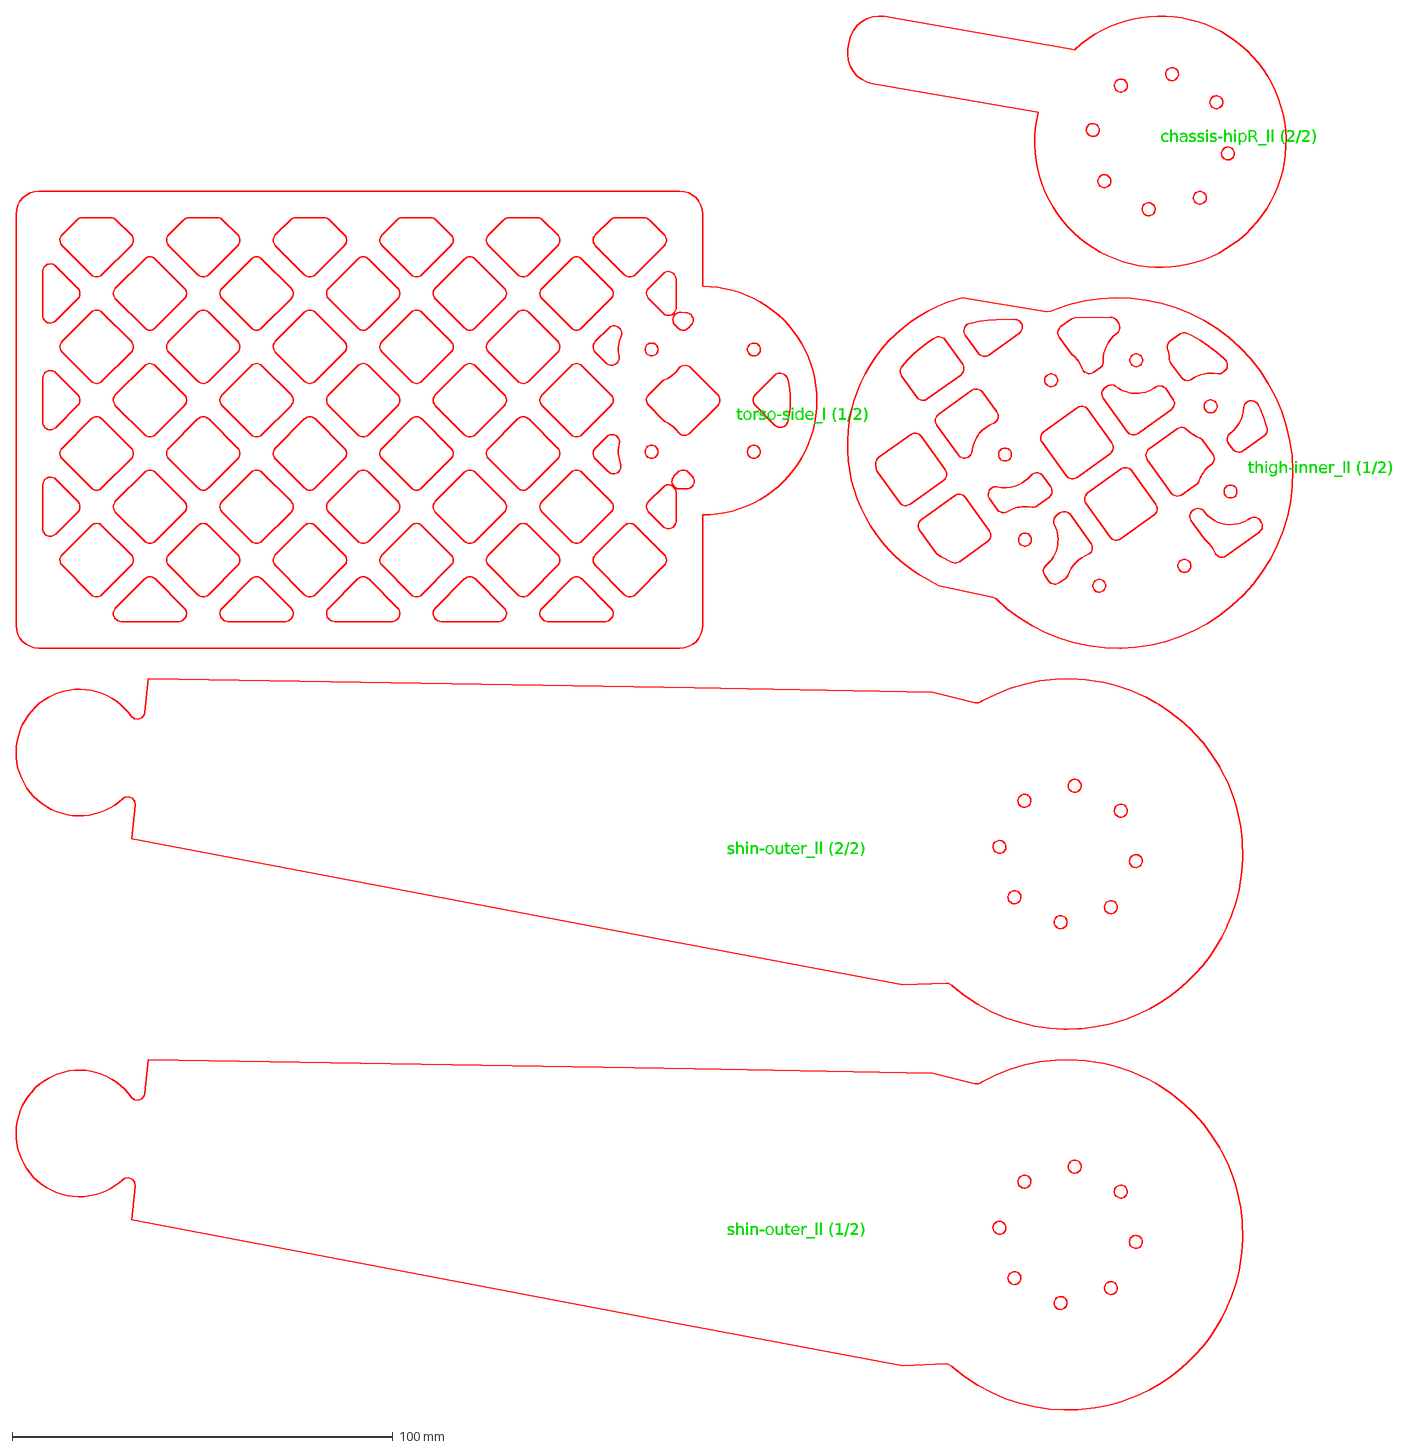
[picture p191: CAD file, 2026-10-29]
body/fab/plates/sheet-1.dxf
shin-outer_ll (1/2)
shin-outer_ll (2/2)
torso-side_l (1/2)
thigh-inner_ll (1/2)
chassis-hipR_ll (2/2)
