muni-works/rose/body/fab/shells/cover-pack-b.stl

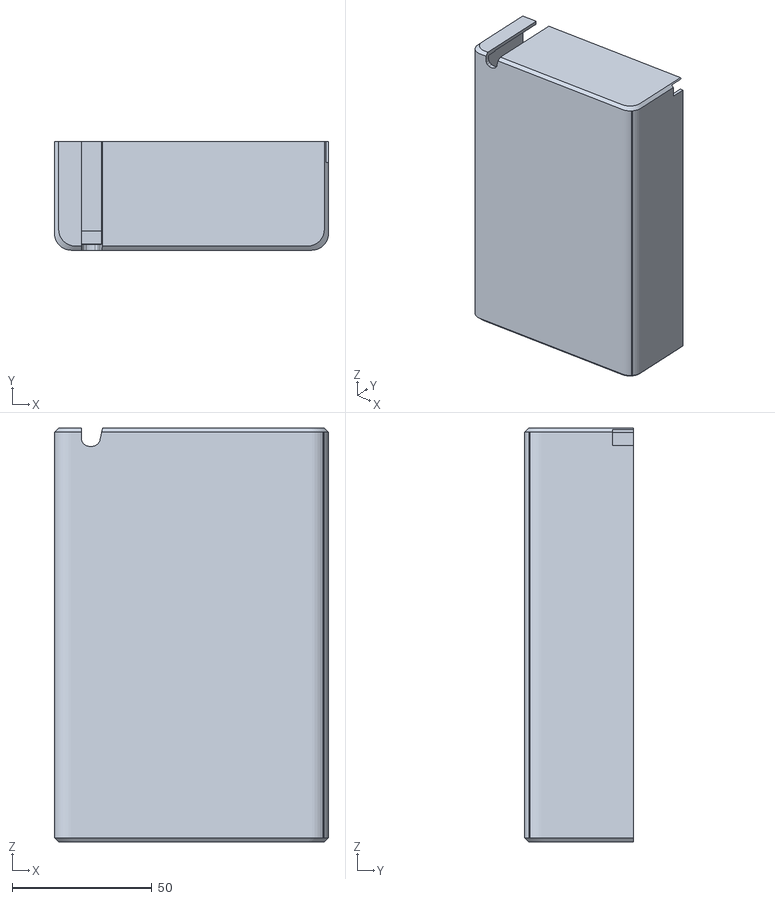
[picture p192: CAD file, 2026-10-29]
body/fab/shells/cover-pack-b.stl
98.0 x 38.8 x 148.0
