muni-works/rose/body/vcad/full/stl/trim-j1grille_l.stl

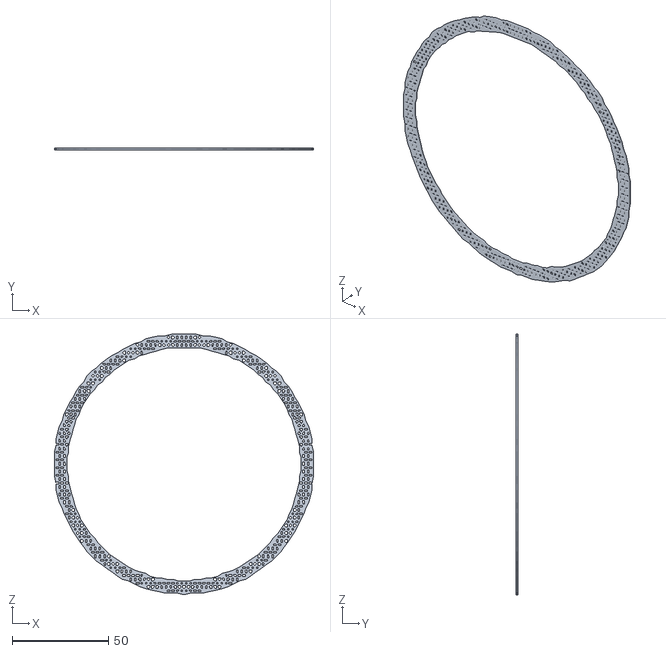
[picture p193: CAD file, 2026-10-21]
body/vcad/full/stl/trim-j1grille_l.stl
134.4 x 0.8 x 135.2
