muni-works/rose/head/fab/cortex/glass.dxf

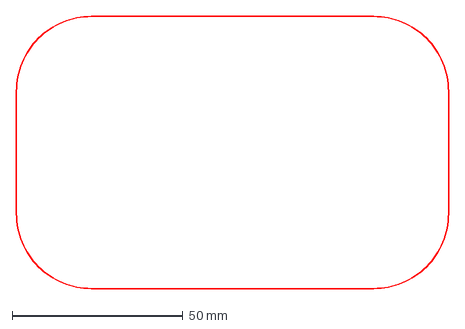
[picture p194: CAD file, 2026-10-29]
head/fab/cortex/glass.dxf
126.4 x 79.6 mm
