muni-works/rose/head/fab/node/node-rear.stl

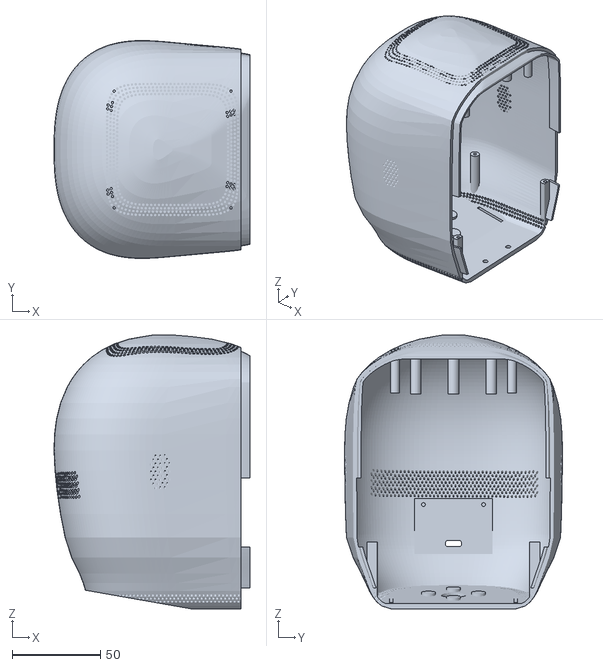
[picture p195: CAD file, 2026-10-29]
head/fab/node/node-rear.stl
110.8 x 123.1 x 154.8
