muni-works/rose/head/stl/cortex-mics.stl

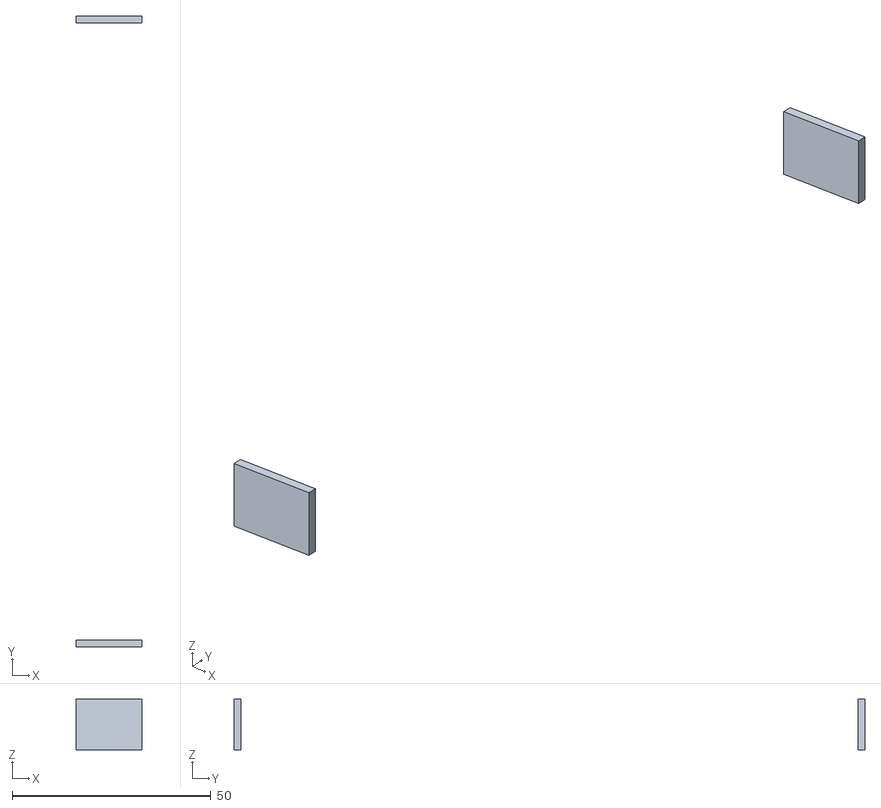
[picture p196: CAD file, 2026-10-29]
head/stl/cortex-mics.stl
16.7 x 158.6 x 12.7
