muni-works/rose/arm/fab-v10/parts/foot_6.3mm_x1.dxf

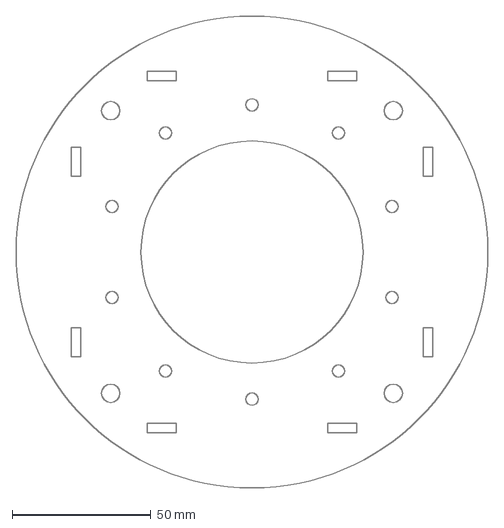
[picture p197: CAD file, 2026-10-21]
arm/fab-v10/parts/foot_6.3mm_x1.dxf
170.0 x 170.0 mm
