muni-works/rose/arm/fab/parts/yoke-bridge_3.2mm_x1.dxf

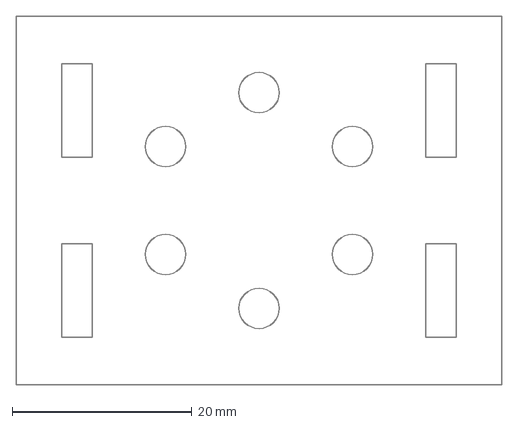
[picture p198: CAD file, 2026-10-14]
arm/fab/parts/yoke-bridge_3.2mm_x1.dxf
54.0 x 41.0 mm
