muni-works/rose/arm/rig/cut/child_B_3.175mm.dxf

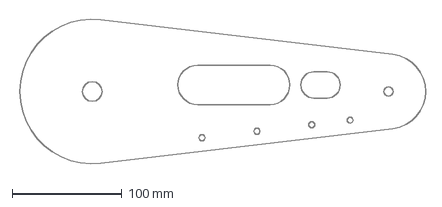
[picture p199: CAD file, 2026-10-14]
arm/rig/cut/child_B_3.175mm.dxf
373.4 x 137.1 mm
