muni-works/rose/arm/skin-stl/print/cap-J2+1.stl

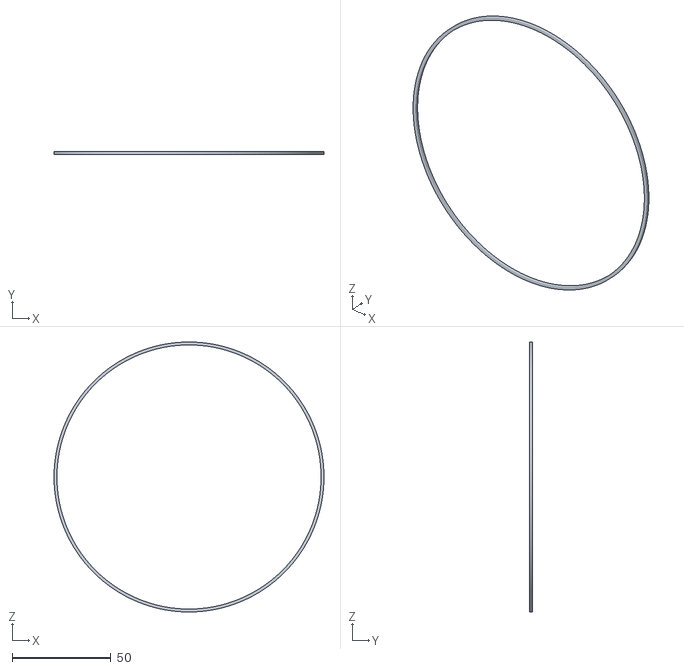
[picture p200: CAD file, 2026-10-21]
arm/skin-stl/print/cap-J2+1.stl
137.0 x 1.51 x 137.0
