muni-works/rose/body/fab/plates/parts/thigh-inner_ll.dxf

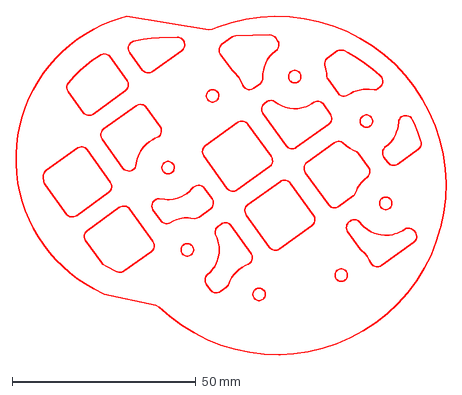
[picture p201: CAD file, 2026-10-29]
body/fab/plates/parts/thigh-inner_ll.dxf
117.0 x 92.0 mm
