muni-works/rose/body/fab/shells/cover-knee_rl-b.stl

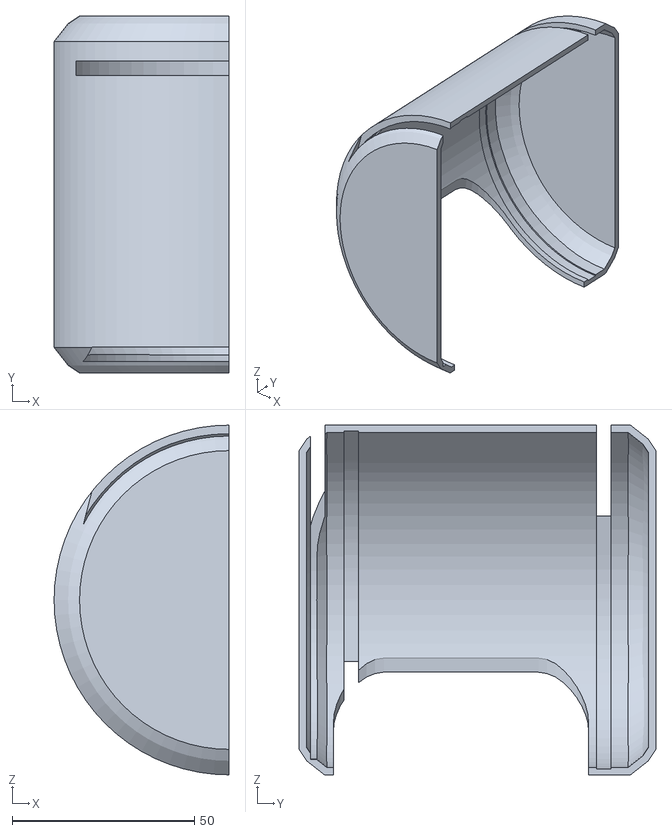
[picture p202: CAD file, 2026-10-29]
body/fab/shells/cover-knee_rl-b.stl
48.0 x 98.0 x 96.0
