muni-works/rose/body/vcad/full/stl/elec-j1fan_l.stl

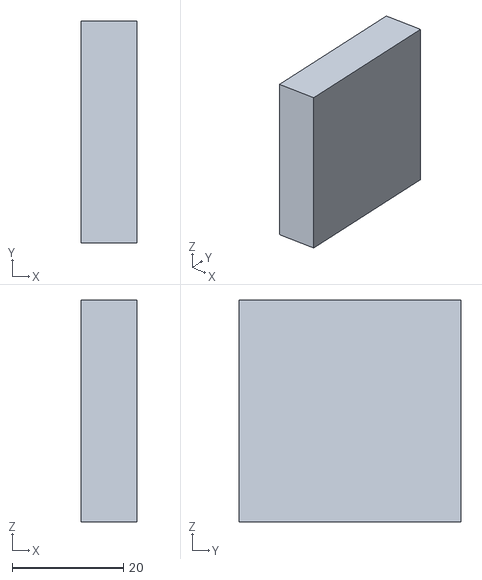
[picture p203: CAD file, 2026-10-21]
body/vcad/full/stl/elec-j1fan_l.stl
10.0 x 40.0 x 40.0
