muni-works/rose/head/fab/node/node-face.stl

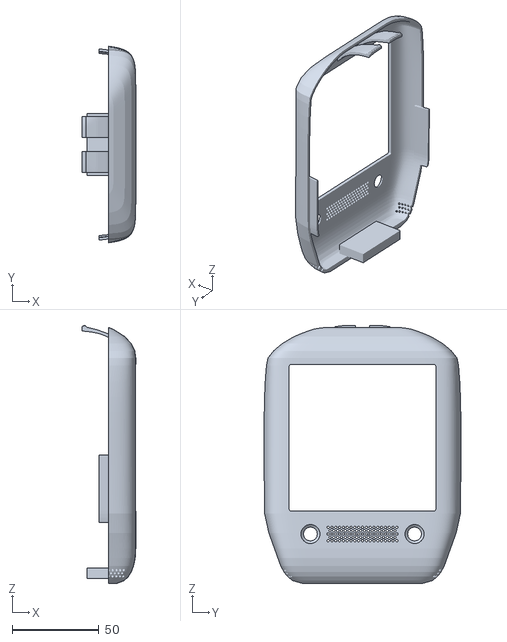
[picture p204: CAD file, 2026-10-29]
head/fab/node/node-face.stl
30.9 x 113.3 x 148.6
