muni-works/rose/head/stl/cortex-power.stl

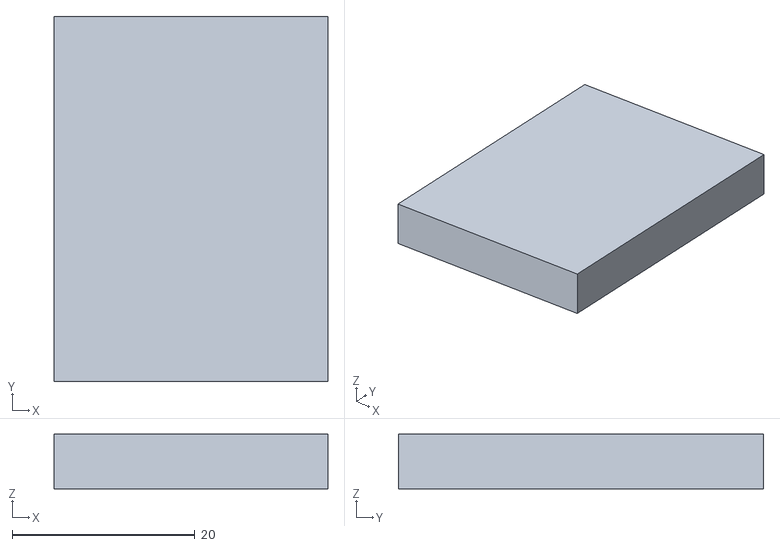
[picture p205: CAD file, 2026-10-29]
head/stl/cortex-power.stl
30.0 x 40.0 x 6.00
