muni-works/rose/arm/fab-v10/parts/wrist-A_3.2mm_x1.dxf

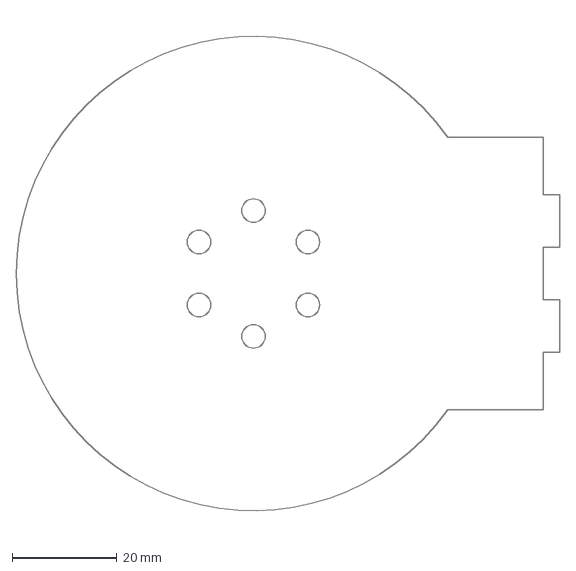
[picture p206: CAD file, 2026-10-21]
arm/fab-v10/parts/wrist-A_3.2mm_x1.dxf
103.7 x 98.2 mm
