muni-works/rose/arm/fab/parts/jaw_3.2mm_x2.dxf

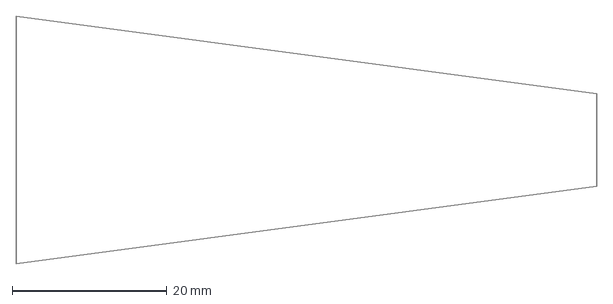
[picture p207: CAD file, 2026-10-14]
arm/fab/parts/jaw_3.2mm_x2.dxf
75.0 x 32.0 mm
