muni-works/rose/arm/rig/cut/spacer_disc_3.175mm.dxf

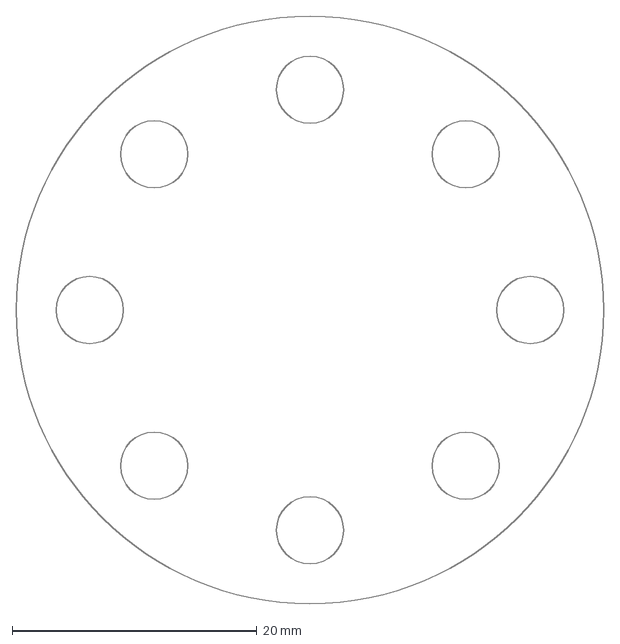
[picture p208: CAD file, 2026-10-14]
arm/rig/cut/spacer_disc_3.175mm.dxf
48.0 x 48.0 mm
