muni-works/rose/arm/skin-stl/print/upper-back.stl

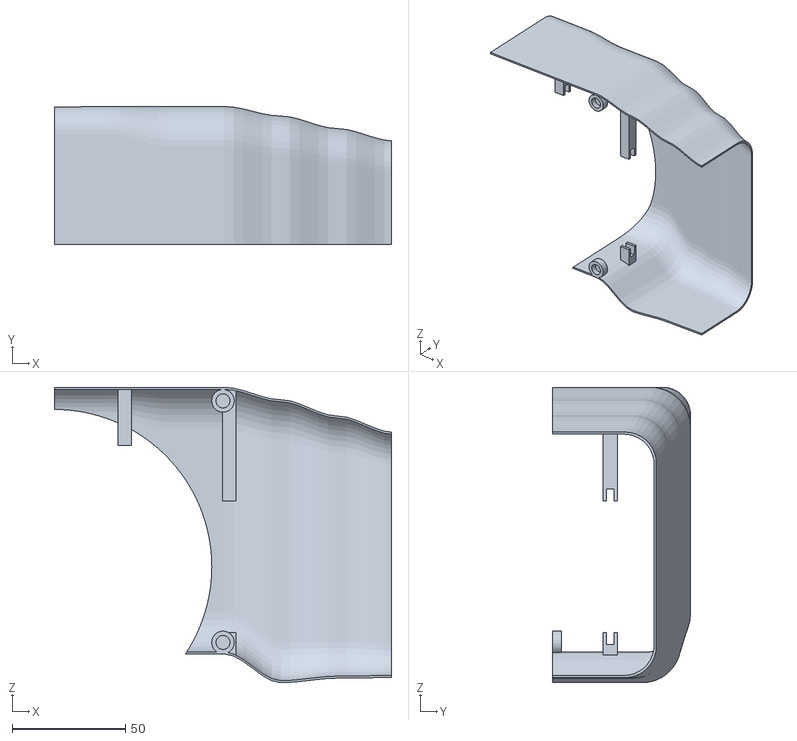
[picture p209: CAD file, 2026-10-21]
arm/skin-stl/print/upper-back.stl
148.9 x 61.0 x 130.6
