muni-works/rose/body/fab/plates/parts/head-dock.dxf

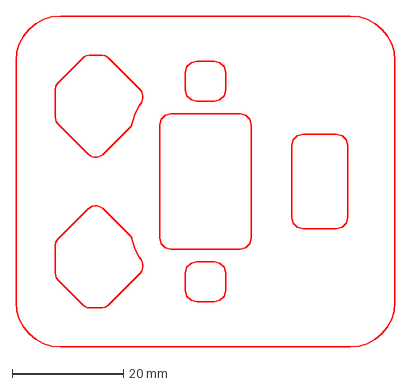
[picture p210: CAD file, 2026-10-29]
body/fab/plates/parts/head-dock.dxf
68.0 x 59.4 mm
