muni-works/rose/body/fab/shells/cover-elbowfork_la-a.stl

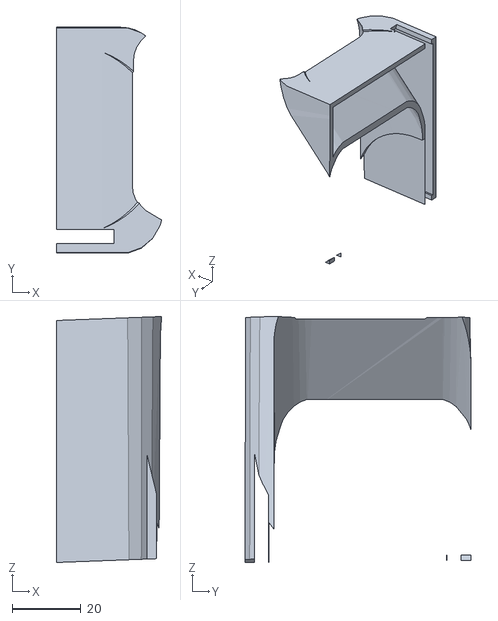
[picture p211: CAD file, 2026-10-29]
body/fab/shells/cover-elbowfork_la-a.stl
30.8 x 65.8 x 71.8
