muni-works/rose/body/vcad/full/stl/trim-dockplug.stl

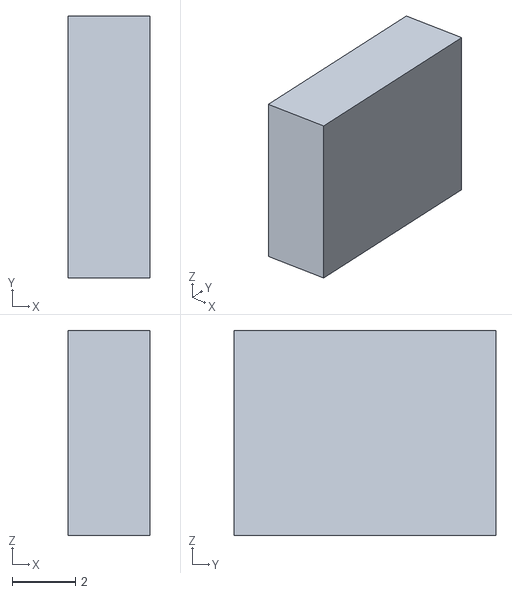
[picture p212: CAD file, 2026-10-21]
body/vcad/full/stl/trim-dockplug.stl
2.60 x 8.30 x 6.50
