muni-works/rose/body/vcad/mini/stl/elec-cxmic_l.stl

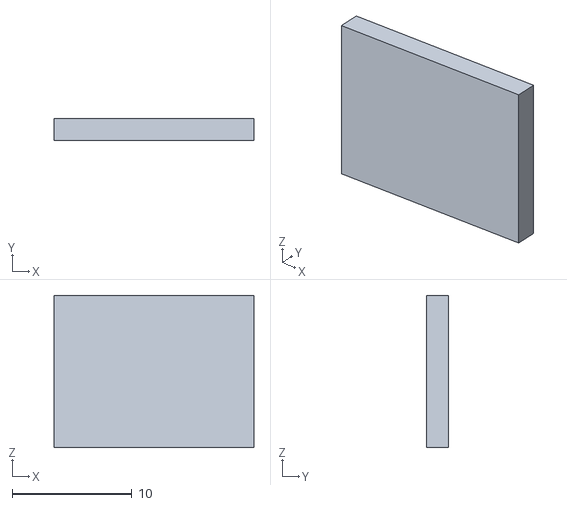
[picture p213: CAD file, 2026-10-21]
body/vcad/mini/stl/elec-cxmic_l.stl
16.7 x 1.80 x 12.7
