muni-works/rose/head/print/3mf/cortex-mini-5-glass.3mf

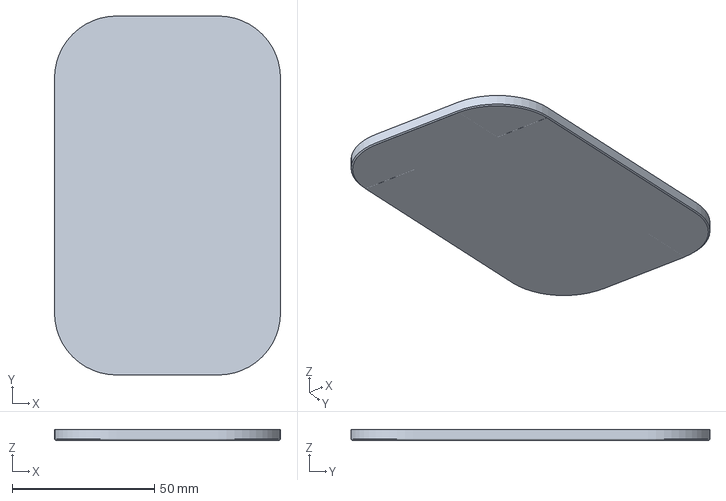
[picture p214: CAD file, 2026-10-21]
head/print/3mf/cortex-mini-5-glass.3mf
79.6 x 126.4 x 3.85 mm
