muni-works/rose/head/print/stl/cortex-mini-sled.stl

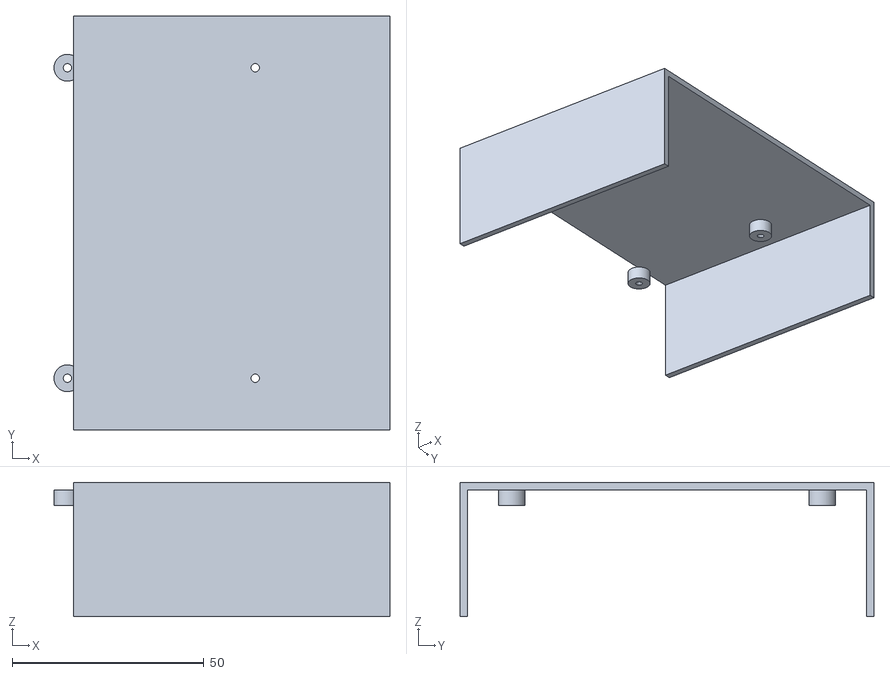
[picture p215: CAD file, 2026-10-21]
head/print/stl/cortex-mini-sled.stl
87.7 x 108.0 x 35.0
