muni-works/rose/head/stl/cortex-back-grille.stl

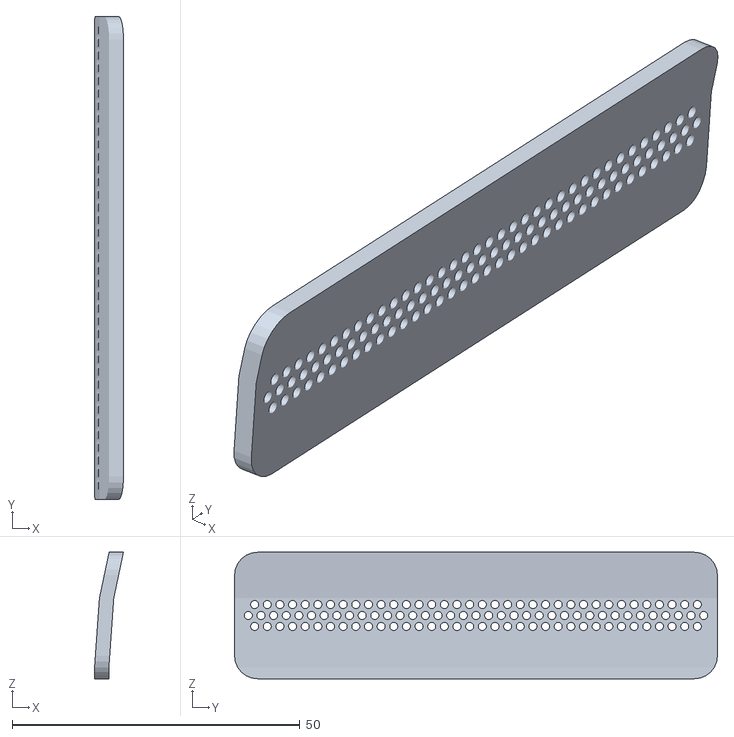
[picture p216: CAD file, 2026-10-29]
head/stl/cortex-back-grille.stl
5.03 x 84.0 x 22.0
