muni-works/rose/arm/fab-v10/parts/pedestal-base_3.2mm_x1.dxf

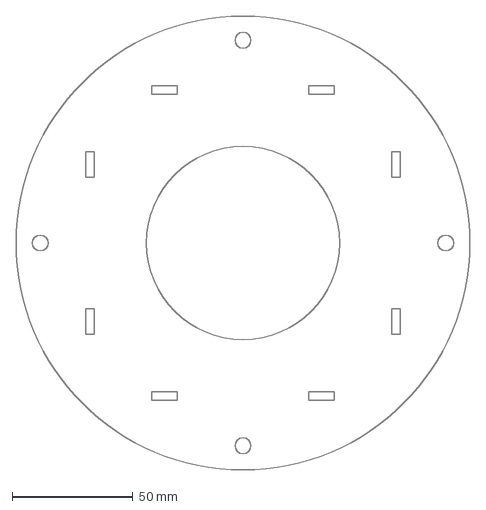
[picture p217: CAD file, 2026-10-21]
arm/fab-v10/parts/pedestal-base_3.2mm_x1.dxf
188.0 x 188.0 mm
