muni-works/rose/arm/fab/parts/wrist-end-plate_3.2mm_x1.dxf

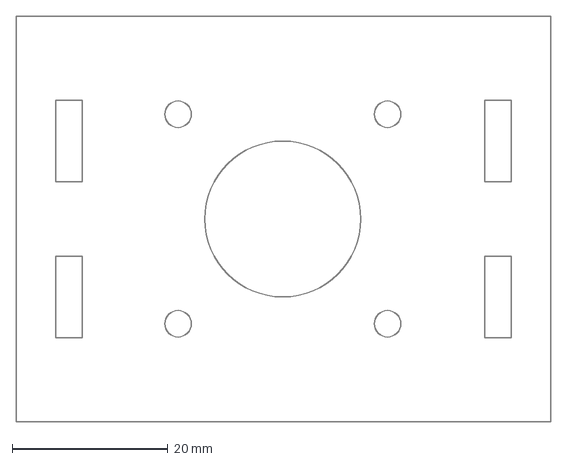
[picture p218: CAD file, 2026-10-14]
arm/fab/parts/wrist-end-plate_3.2mm_x1.dxf
68.5 x 52.0 mm
