muni-works/rose/arm/rig/cut/sheet_3.175mm_2.dxf

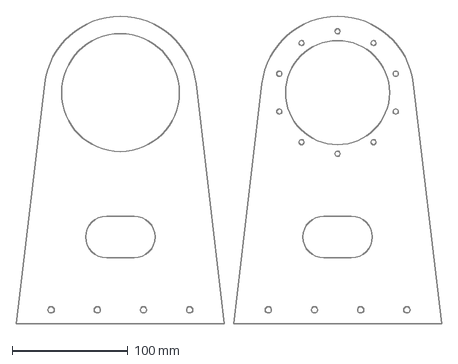
[picture p219: CAD file, 2026-10-14]
arm/rig/cut/sheet_3.175mm_2.dxf
368.0 x 266.0 mm
