muni-works/rose/body/fab/plates/parts/shin-outer_ll.dxf

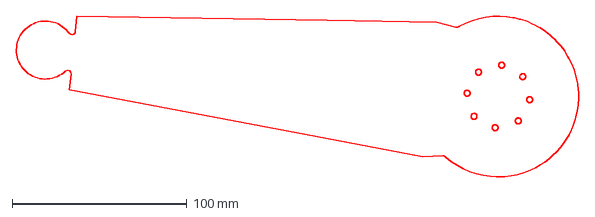
[picture p220: CAD file, 2026-10-29]
body/fab/plates/parts/shin-outer_ll.dxf
322.1 x 92.0 mm
