muni-works/rose/body/fab/shells/trim-ankle_rl-b.stl

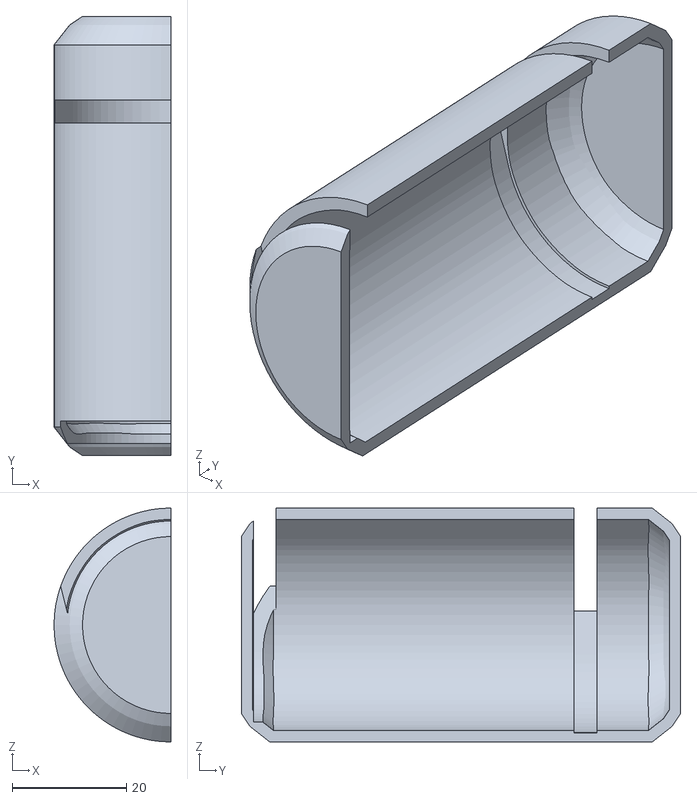
[picture p221: CAD file, 2026-10-29]
body/fab/shells/trim-ankle_rl-b.stl
20.5 x 77.0 x 41.0
