muni-works/rose/body/vcad/mini/stl/cable-hmic_r.stl

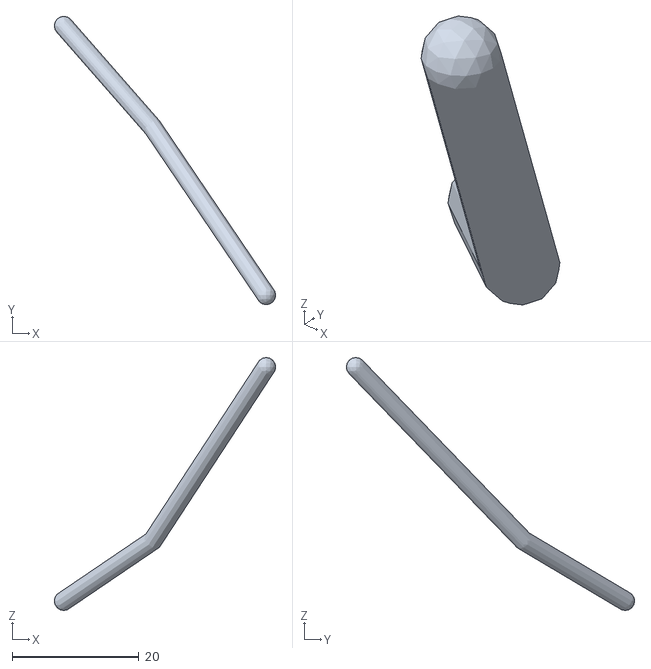
[picture p222: CAD file, 2026-10-21]
body/vcad/mini/stl/cable-hmic_r.stl
34.9 x 45.4 x 39.8
