muni-works/rose/head/stl/cortex-tub-d4.stl

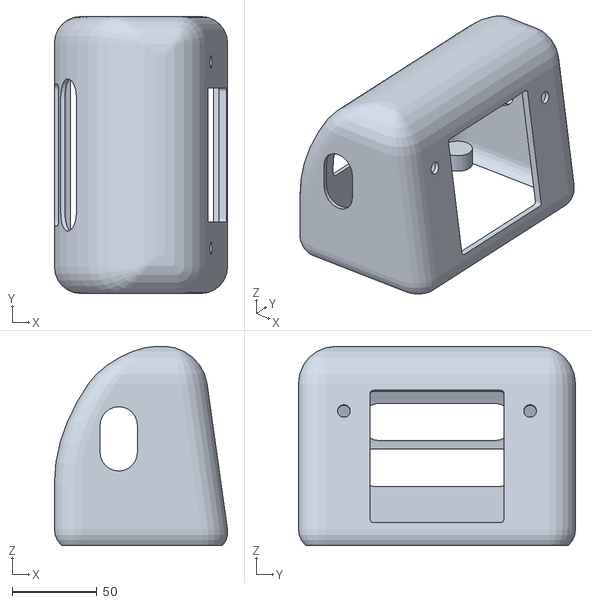
[picture p223: CAD file, 2026-10-29]
head/stl/cortex-tub-d4.stl
102.3 x 163.6 x 117.6
