muni-works/rose/arm/fab-v10/parts/yoke-B_3.2mm_x1.dxf

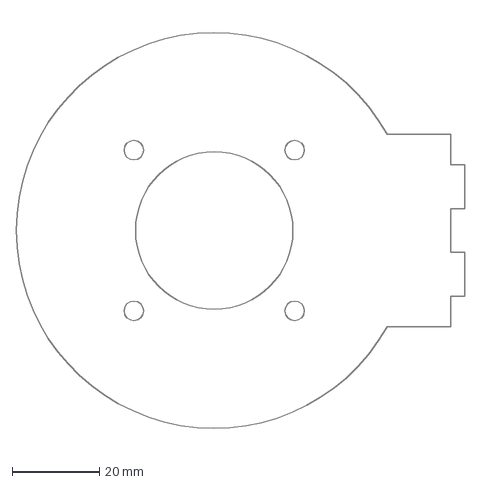
[picture p224: CAD file, 2026-10-21]
arm/fab-v10/parts/yoke-B_3.2mm_x1.dxf
102.5 x 98.0 mm
