muni-works/rose/arm/fab/parts/fore-end-plate_3.2mm_x1.dxf

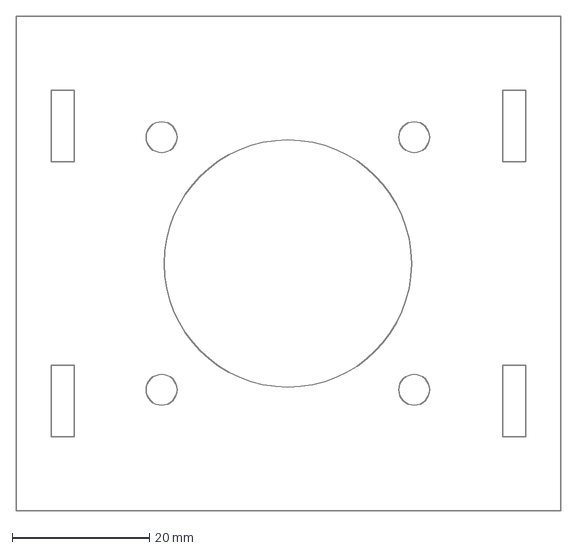
[picture p225: CAD file, 2026-10-14]
arm/fab/parts/fore-end-plate_3.2mm_x1.dxf
79.2 x 72.0 mm
