muni-works/rose/arm/skin-stl/print/fore-front.stl

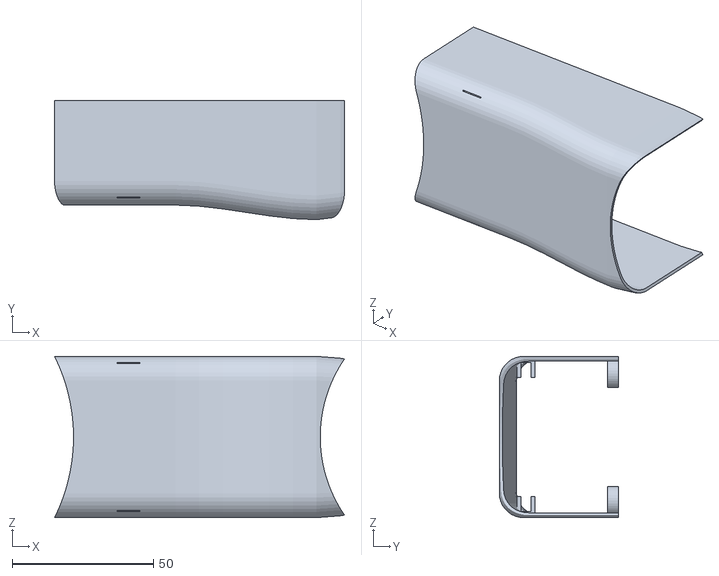
[picture p226: CAD file, 2026-10-21]
arm/skin-stl/print/fore-front.stl
102.5 x 42.2 x 57.0
