muni-works/rose/body/fab/plates/parts/neck-N0.dxf

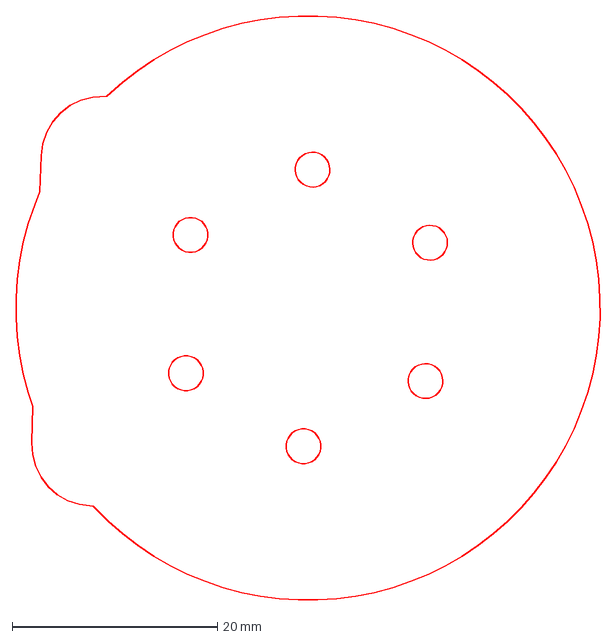
[picture p227: CAD file, 2026-10-29]
body/fab/plates/parts/neck-N0.dxf
57.0 x 57.0 mm
