muni-works/rose/body/fab/shells/cover-hipneck_rl-b.stl

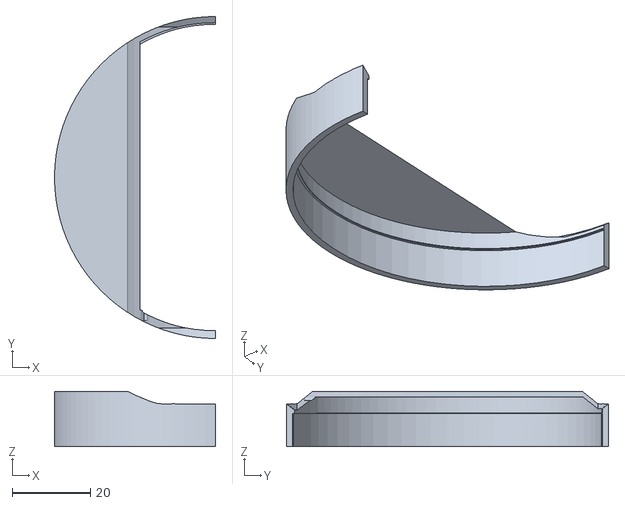
[picture p228: CAD file, 2026-10-29]
body/fab/shells/cover-hipneck_rl-b.stl
41.2 x 82.5 x 14.2
