muni-works/rose/body/vcad/full/stl/trim-ear_r.stl

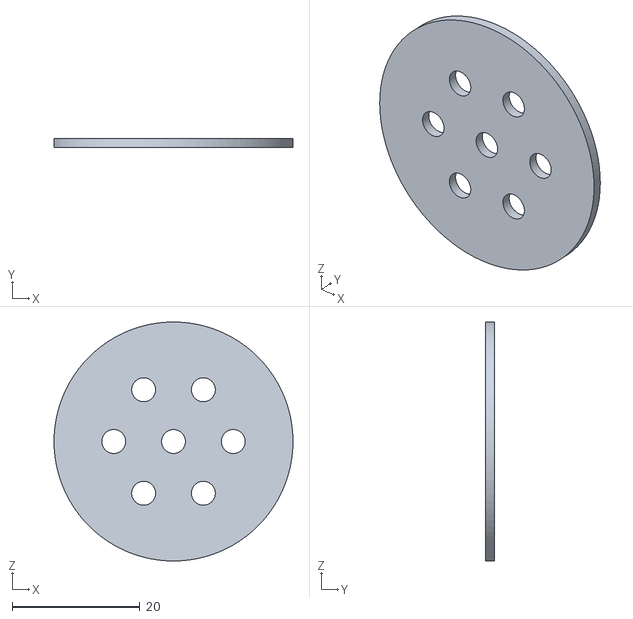
[picture p229: CAD file, 2026-10-21]
body/vcad/full/stl/trim-ear_r.stl
37.5 x 1.40 x 37.5
