muni-works/rose/body/vcad/mini/stl/elec-bms.stl

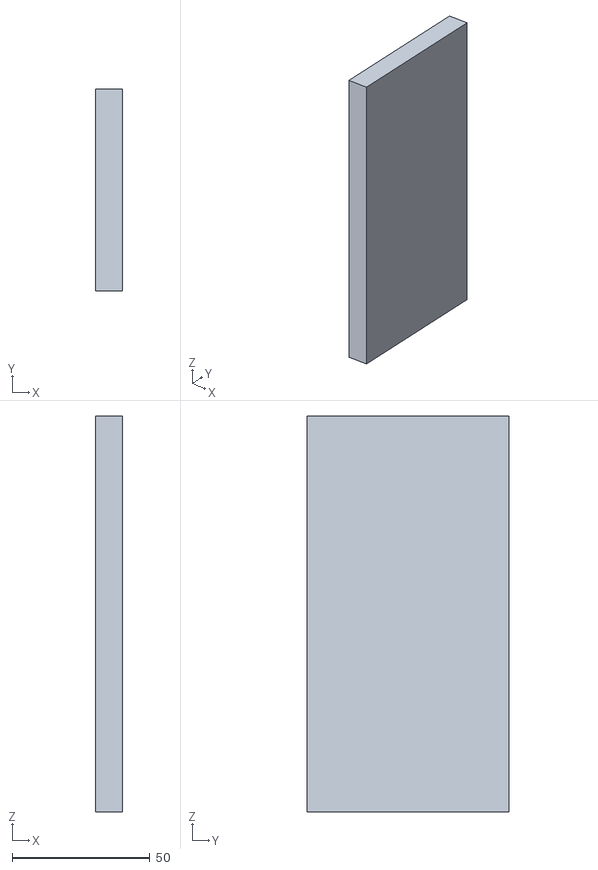
[picture p230: CAD file, 2026-10-21]
body/vcad/mini/stl/elec-bms.stl
10.0 x 73.6 x 144.0
