muni-works/rose/head/print/3mf/cortex-mini-2-floor.3mf

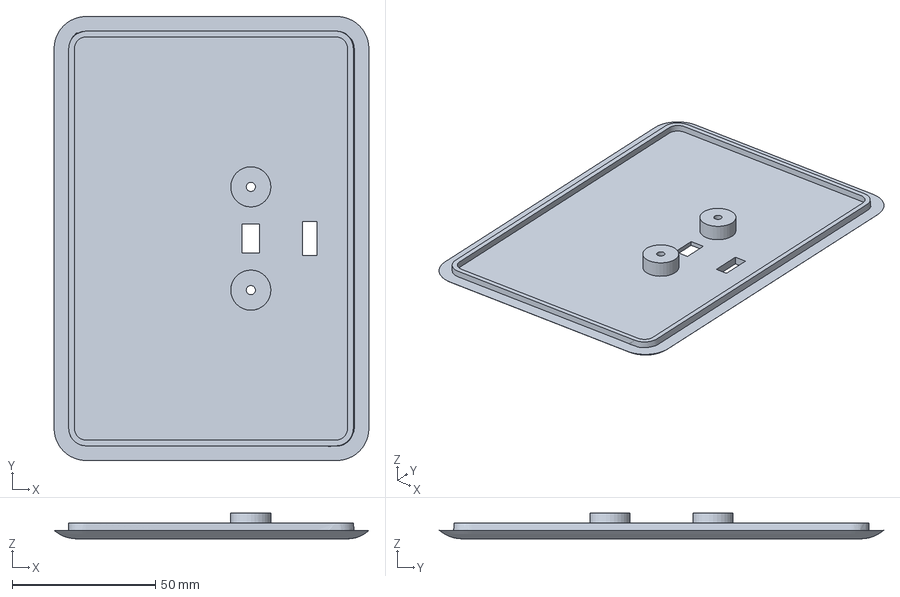
[picture p231: CAD file, 2026-10-21]
head/print/3mf/cortex-mini-2-floor.3mf
109.8 x 154.8 x 9.00 mm
