muni-works/rose/head/print/stl/cortex-mini-ear-grilles.stl

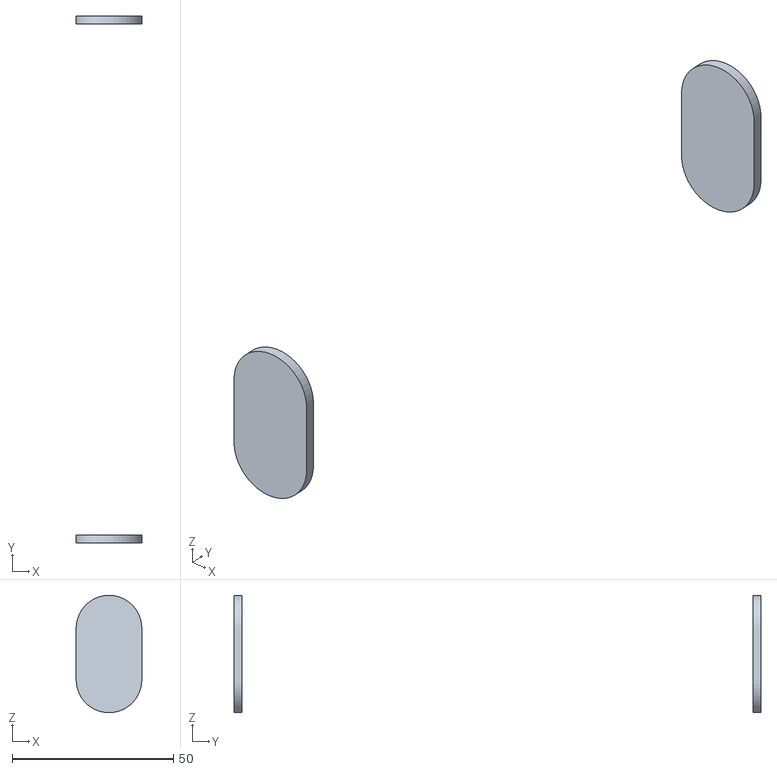
[picture p232: CAD file, 2026-10-21]
head/print/stl/cortex-mini-ear-grilles.stl
20.4 x 163.6 x 36.4
