muni-works/rose/head/stl/dock-face.stl

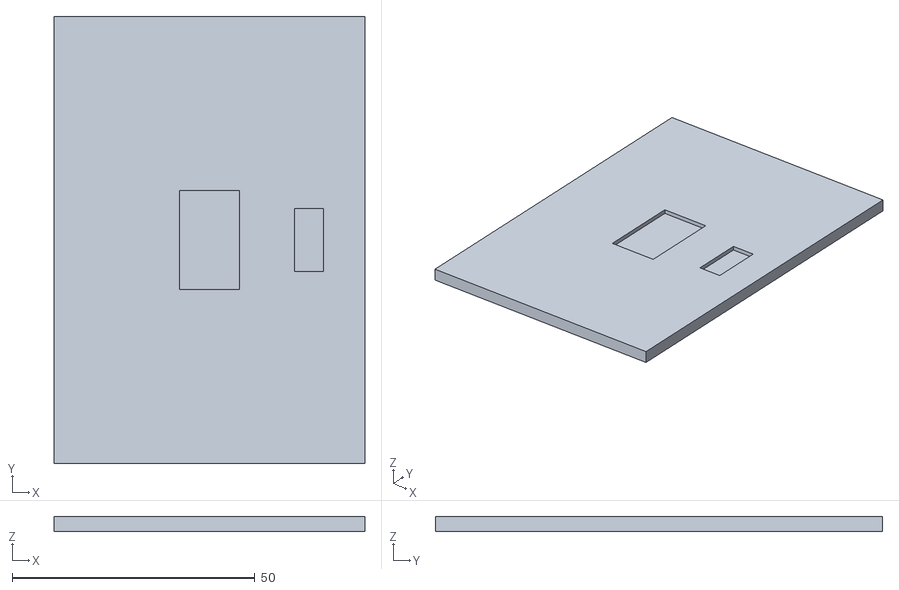
[picture p233: CAD file, 2026-10-29]
head/stl/dock-face.stl
64.0 x 92.0 x 3.00
