muni-works/rose/arm/fab/parts/turret-disc_3.2mm_x1.dxf

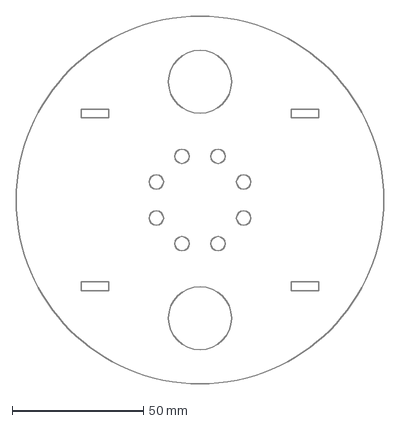
[picture p235: CAD file, 2026-10-14]
arm/fab/parts/turret-disc_3.2mm_x1.dxf
140.0 x 140.0 mm
