muni-works/rose/body/fab/plates/parts/torso-deck0.dxf

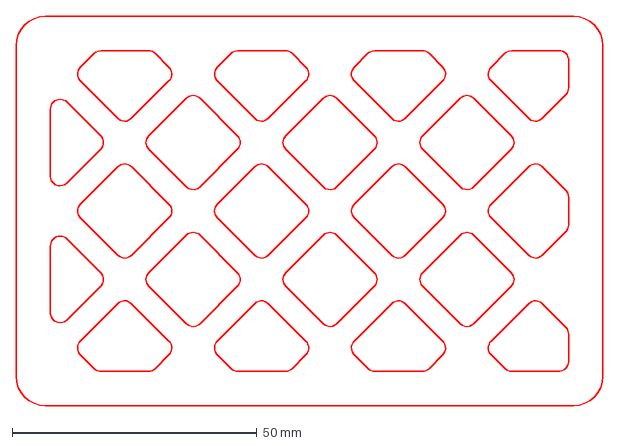
[picture p236: CAD file, 2026-10-29]
body/fab/plates/parts/torso-deck0.dxf
120.0 x 79.6 mm
