muni-works/rose/body/vcad/mini/stl/trim-ear_r.stl

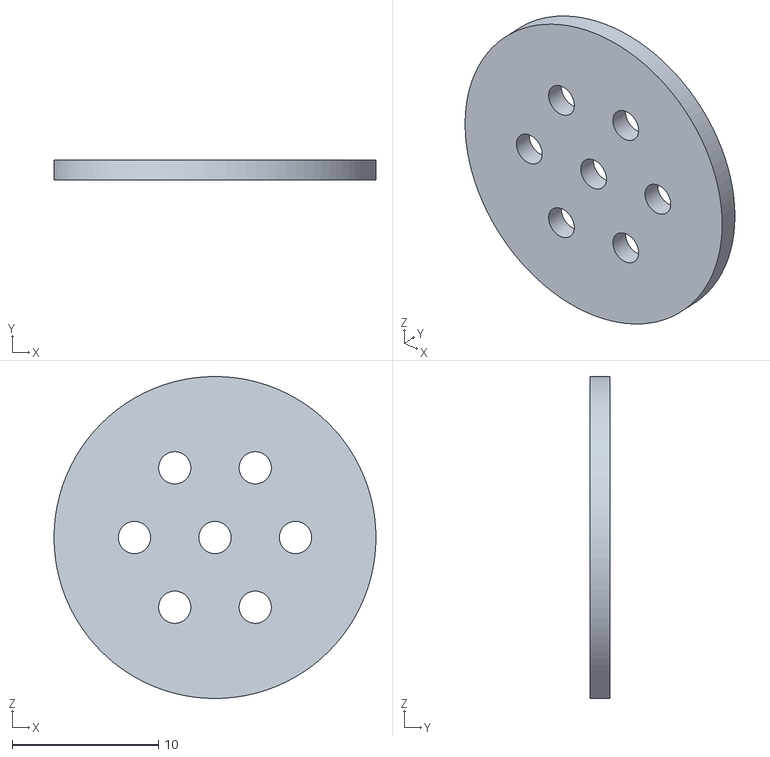
[picture p237: CAD file, 2026-10-21]
body/vcad/mini/stl/trim-ear_r.stl
22.0 x 1.40 x 22.0
