muni-works/rose/head/print/3mf/cortex-mini-1-tub.3mf

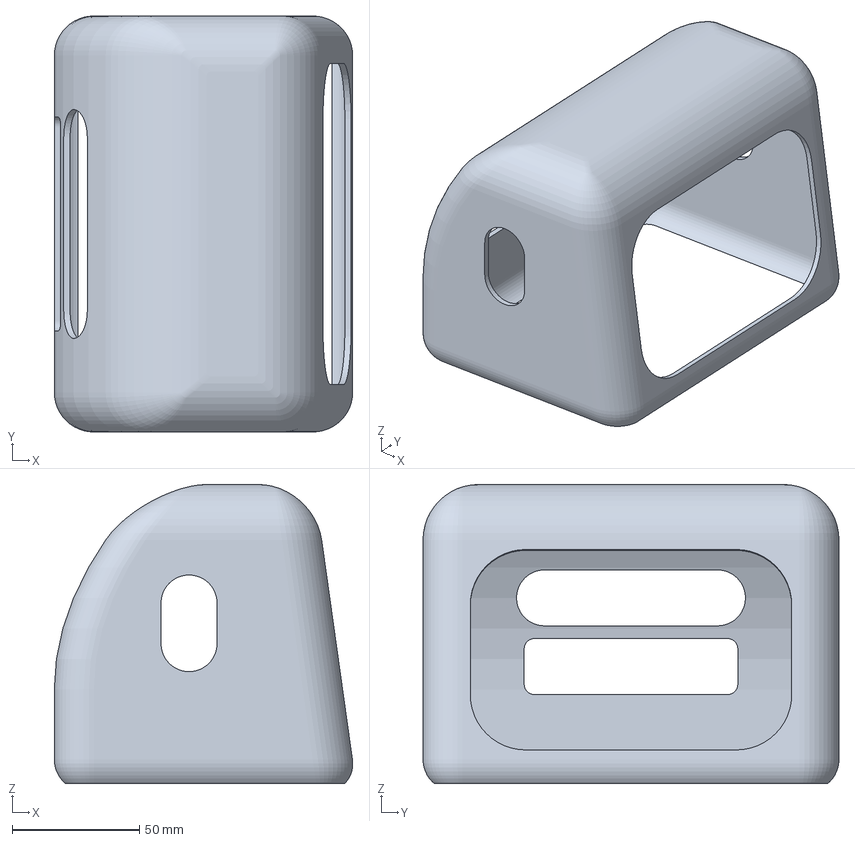
[picture p238: CAD file, 2026-10-21]
head/print/3mf/cortex-mini-1-tub.3mf
117.4 x 163.6 x 117.6 mm
