muni-works/rose/head/stl/cortex-dockboard.stl

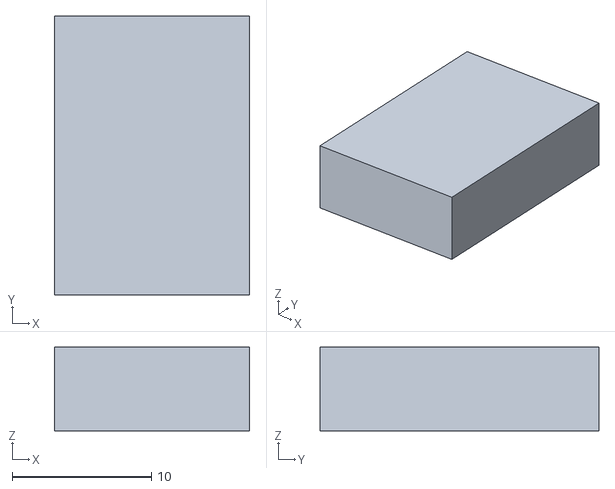
[picture p239: CAD file, 2026-10-29]
head/stl/cortex-dockboard.stl
14.0 x 20.0 x 6.00
