muni-works/rose/arm/fab-v10/parts/upperd-bridge_3.2mm_x1.dxf

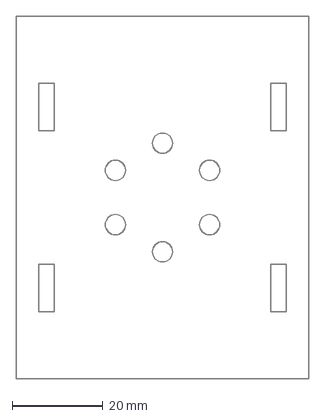
[picture p240: CAD file, 2026-10-21]
arm/fab-v10/parts/upperd-bridge_3.2mm_x1.dxf
64.7 x 80.0 mm
