muni-works/rose/arm/fab/parts/foot_6.3mm_x1.dxf

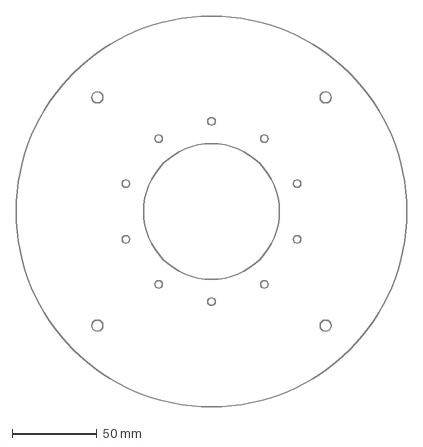
[picture p241: CAD file, 2026-10-14]
arm/fab/parts/foot_6.3mm_x1.dxf
230.0 x 230.0 mm
