muni-works/rose/body/fab/plates/parts/shin-inner_ll.dxf

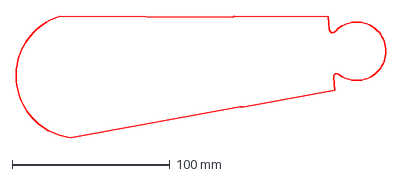
[picture p242: CAD file, 2026-10-29]
body/fab/plates/parts/shin-inner_ll.dxf
234.1 x 76.8 mm
