muni-works/rose/body/fab/shells/cover-hip_rl-a.stl

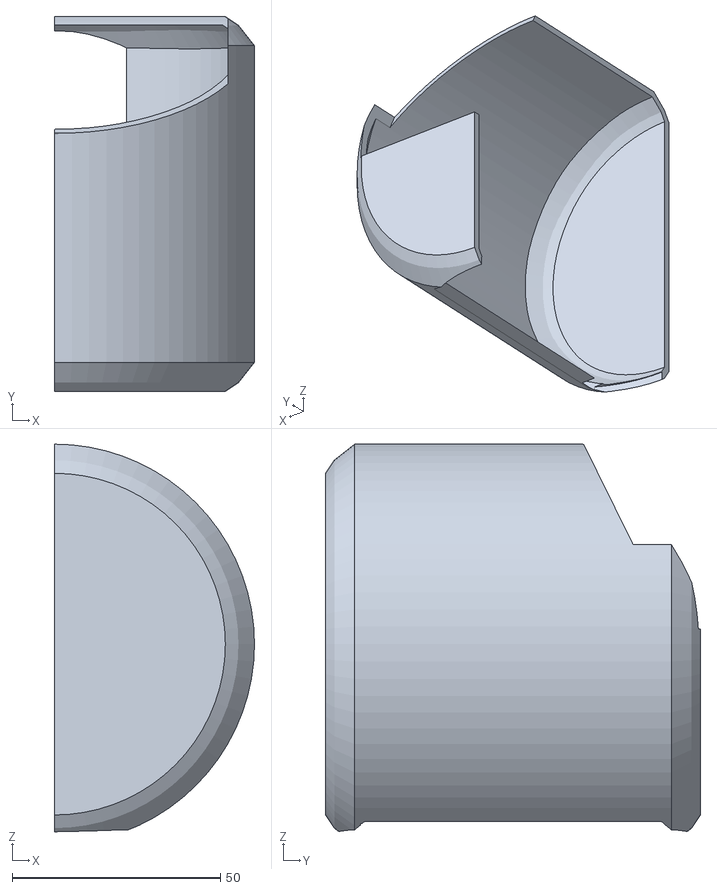
[picture p243: CAD file, 2026-10-29]
body/fab/shells/cover-hip_rl-a.stl
48.0 x 90.0 x 93.1
