muni-works/rose/body/vcad/full/stl/cover-chest.stl

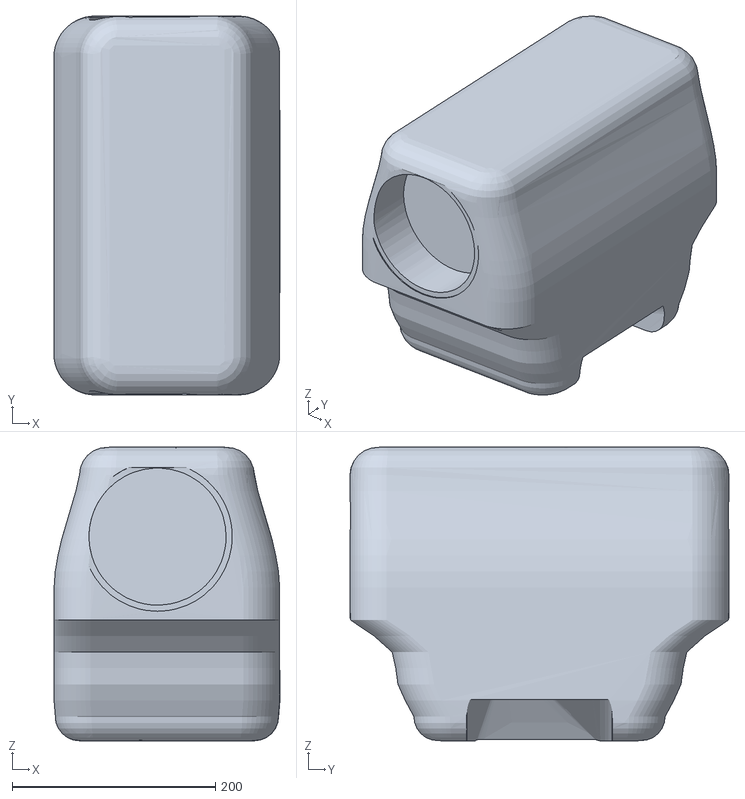
[picture p244: CAD file, 2026-10-21]
body/vcad/full/stl/cover-chest.stl
222.4 x 373.2 x 289.1
