muni-works/rose/head/stl/cortex-cams.stl

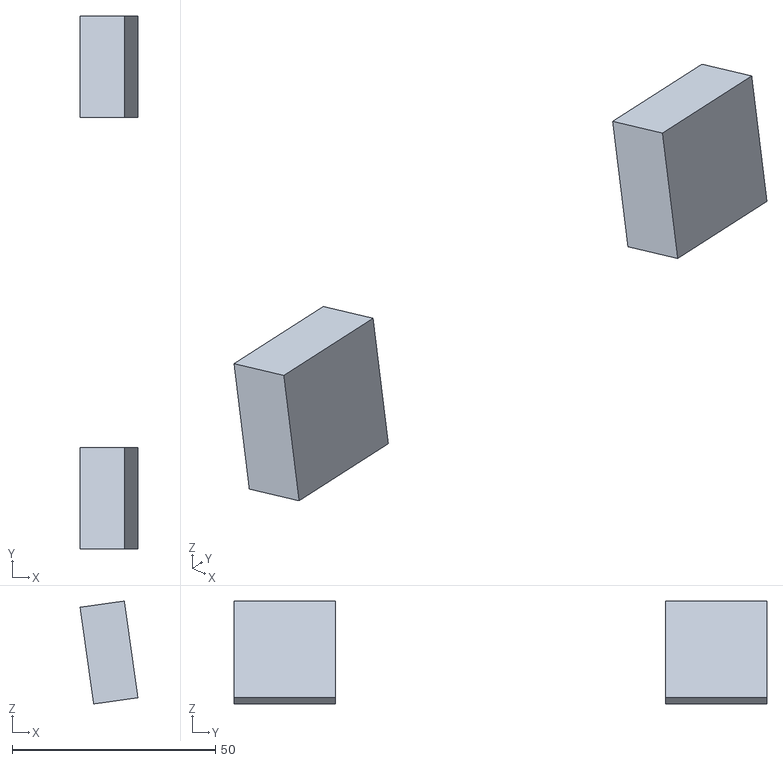
[picture p245: CAD file, 2026-10-29]
head/stl/cortex-cams.stl
14.2 x 131.0 x 25.3
