muni-works/rose/arm/fab-v10/parts/turret-tower-B_3.2mm_x1.dxf

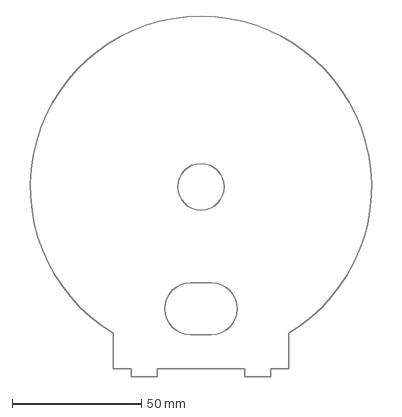
[picture p246: CAD file, 2026-10-21]
arm/fab-v10/parts/turret-tower-B_3.2mm_x1.dxf
143.1 x 139.5 mm
