muni-works/rose/arm/fab/parts/fore-A_3.2mm_x1.dxf

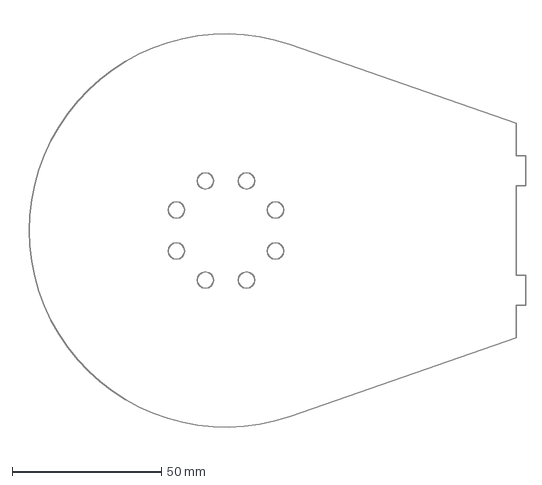
[picture p247: CAD file, 2026-10-14]
arm/fab/parts/fore-A_3.2mm_x1.dxf
170.8 x 143.7 mm
