muni-works/rose/arm/skin-stl/print/cap-J4+1.stl

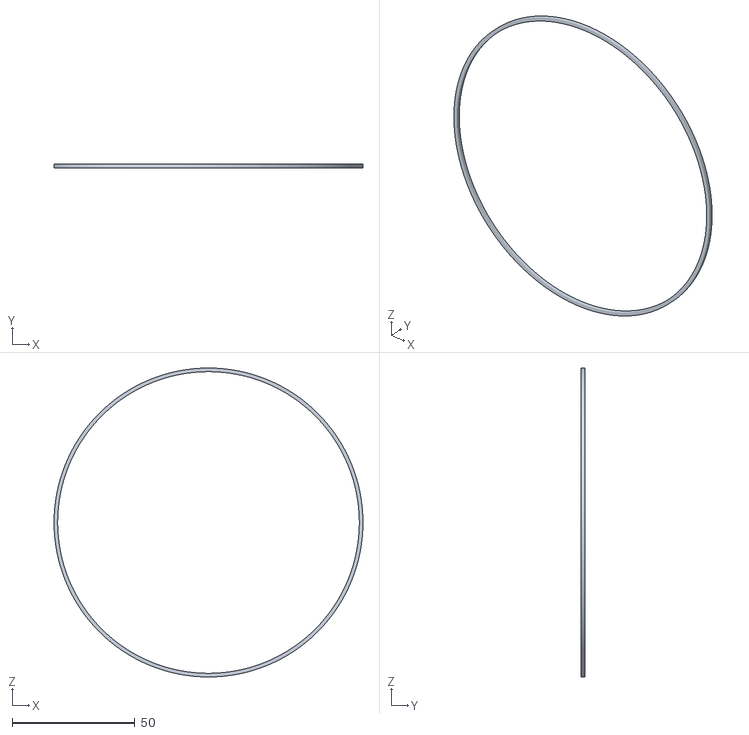
[picture p248: CAD file, 2026-10-21]
arm/skin-stl/print/cap-J4+1.stl
126.0 x 1.51 x 126.0
