muni-works/rose/body/fab/plates/parts/chassis-hipR_ll.dxf

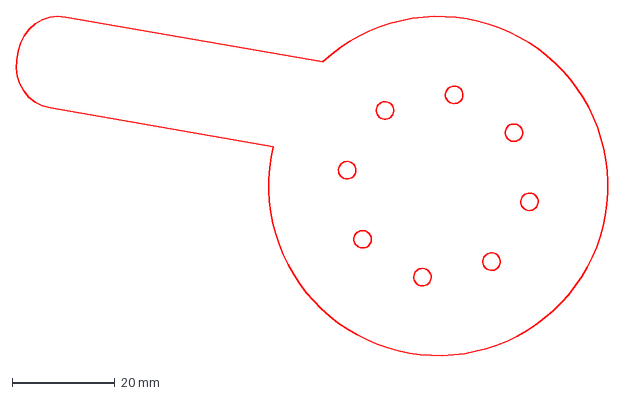
[picture p249: CAD file, 2026-10-29]
body/fab/plates/parts/chassis-hipR_ll.dxf
115.1 x 66.0 mm
