muni-works/rose/(list of files, cad)

Other CAD files:
head/print/3mf/cortex-full-1-tub.3mf
head/print/stl/cortex-full-sled.stl
head/print/stl/cortex-full-floor.stl
head/fab/cortex/d4-body.step
head/print/coupons-plate.stl
head/fab/cortex/dock-face.step
head/fab/node/node-mvp-fast.3mf
head/fab/cortex/cortex-sled.step
head/fab/cortex/print/cortex-ear-grille-l.stl
body/vcad/mini/stl/cover-deltoid_la.stl
head/fab/cortex/print/cortex-sled-print-l.stl
body/vcad/mini/stl/thigh-inner_rl.stl
head/fab/cortex/dock-release.step
head/print/stl/cortex-mini-glass.stl
head/fab/cortex/cortex-tub-d4.step
head/fab/node/node-mvp-quality.3mf
arm/skin-stl/print/turret-front.stl
body/vcad/full/stl/trim-j1ring_l.stl
head/fab/node/node-mvp-06.3mf
head/print/3mf/cortex-mini-3-sled.3mf
head/fab/cortex/dock-pawl.step
head/fab/node/node-mvp-tilt.3mf
arm/skin-stl/print/turret-back.stl
body/fab/shells/cover-forearm_ra-a.stl
body/vcad/full/stl/trim-ear_l.stl
head/fab/cortex/cortex-tub.step
head/fab/node/node-mvp-fastest.3mf
arm/skin-stl/print/upper-front.stl
body/vcad/mini/stl/trim-ear_l.stl
head/fab/cortex/cortex-sled-print.step
head/fab/node/node-mvp-facedown.3mf
head/print/stl/cortex-mini-tub.stl
arm/fab-v10/parts/fore-A_3.2mm_x1.dxf
arm/fab-v10/parts/fore-end-plate_3.2mm_x1.dxf
arm/fab-v10/parts/tool-flange_3.2mm_x1.dxf
arm/fab-v10/parts/turret-disc_3.2mm_x1.dxf
arm/fab-v10/parts/turret-tower-A_3.2mm_x1.dxf
arm/fab-v10/parts/upper-B_3.2mm_x1.dxf
arm/fab-v10/parts/upperd-A_3.2mm_x1.dxf
arm/fab-v10/parts/upperd-B_3.2mm_x1.dxf
arm/fab-v10/parts/upperd-cover_3.2mm_x2.dxf
arm/fab-v10/parts/wrist-B_3.2mm_x1.dxf
arm/fab/parts/fore-B_3.2mm_x1.dxf
arm/fab/parts/tool-flange_3.2mm_x1.dxf
arm/fab/parts/upper-A_3.2mm_x1.dxf
arm/fab/parts/upper-B_3.2mm_x1.dxf
arm/fab/parts/upper-cover_3.2mm_x2.dxf
arm/fab/parts/wrist-A_3.2mm_x1.dxf
arm/fab/parts/wrist-B_3.2mm_x1.dxf
arm/fab/parts/yoke-A_3.2mm_x1.dxf
arm/fab/parts/yoke-B_3.2mm_x1.dxf
arm/skin-stl/print/cap-J2-1.stl
arm/skin-stl/print/cap-J4-1.stl
arm/skin-stl/print/cap-J6+1.stl
arm/skin-stl/print/cap-J6-1.stl
arm/skin-stl/print/desk-puck.stl
arm/skin-stl/print/disc-J2-1.stl
arm/skin-stl/print/disc-J4-1.stl
arm/skin-stl/print/disc-J6+1.stl
arm/skin-stl/print/disc-J6-1.stl
arm/skin-stl/print/drum-J1.stl
arm/skin-stl/print/flank-J1_body.stl
arm/skin-stl/print/fore-back.stl
arm/skin-stl/print/puck-J2.stl
arm/skin-stl/print/puck-J4.3mf
arm/skin-stl/print/puck-J6.3mf
arm/skin-stl/print/ring-J3.stl
arm/skin-stl/print/ring-J7.stl
arm/skin-stl/print/turret-back_body.stl
arm/skin-stl/print/upper-front_R.stl
arm/skin-stl/print/upperd-back.stl
arm/skin-stl/print/upperd-front.stl
arm/skin-stl/print/wrist-back.stl
body/fab/plates/parts/arm-elbowE1_la.dxf
body/fab/plates/parts/arm-elbowE2_la.dxf
body/fab/plates/parts/arm-forearmF1_la.dxf
body/fab/plates/parts/arm-forearmF1_ra.dxf
body/fab/plates/parts/arm-upperU1_la.dxf
body/fab/plates/parts/arm-upperU2_la.dxf
body/fab/plates/parts/arm-yokeP1_la.dxf
body/fab/plates/parts/chassis-hipA_ll.dxf
body/fab/plates/parts/chassis-hipB2_ll.dxf
body/fab/plates/parts/chassis-hipinner_ll.dxf
body/fab/plates/parts/chassis-rollmount_ll.dxf
body/fab/plates/parts/chassis-rollmount_rl.dxf
body/fab/plates/parts/chassis-thightop_ll.dxf
body/fab/plates/parts/head-H1.dxf
body/fab/plates/parts/shin-web_ll.dxf
body/fab/plates/parts/thigh-outer_ll.dxf
body/fab/plates/parts/torso-deck1.dxf
body/fab/plates/parts/torso-dock.dxf
body/fab/plates/parts/torso-latch.dxf
body/fab/plates/parts/torso-side_l.dxf
body/fab/shells/cover-calf_ll-a.stl
body/fab/shells/cover-calf_ll-b.stl
body/fab/shells/cover-calf_rl-a.stl
body/fab/shells/cover-calf_rl-b.stl
body/fab/shells/cover-chest-al.stl
body/fab/shells/cover-chest-ar.stl
body/fab/shells/cover-chest-bl.stl
body/fab/shells/cover-chest-br.stl
body/fab/shells/cover-deltoid_la-a.stl
body/fab/shells/cover-deltoid_ra-a.stl
body/fab/shells/cover-deltoid_ra-b.stl
body/fab/shells/cover-elbow_la-a.stl
body/fab/shells/cover-elbow_la-b.stl
body/fab/shells/cover-elbow_ra-a.stl
body/fab/shells/cover-elbow_ra-b.stl
body/fab/shells/cover-elbowfork_la-b.stl
body/fab/shells/cover-elbowfork_ra-a.stl
body/fab/shells/cover-elbowfork_ra-b.stl
body/fab/shells/cover-forearm_la-b.stl
body/fab/shells/cover-forearm_ra-b.stl
body/fab/shells/cover-hand_la.stl
body/fab/shells/cover-hand_ra.stl
body/fab/shells/cover-headcheek.stl
body/fab/shells/cover-headhub-a.stl
body/fab/shells/cover-hip_ll-a.stl
body/fab/shells/cover-hip_ll-b.stl
body/fab/shells/cover-hip_rl-b.stl
body/fab/shells/cover-hipguard_ll.stl
body/fab/shells/cover-hipguard_rl.stl
body/fab/shells/cover-hipneck_ll-a.stl
body/fab/shells/cover-hipneck_ll-b.stl
body/fab/shells/cover-hipneck_rl-a.stl
body/fab/shells/cover-hipyaw_ll-a.stl
body/fab/shells/cover-hipyaw_ll-b.stl
body/fab/shells/cover-hipyaw_rl-a.stl
body/fab/shells/cover-hipyaw_rl-b.stl
body/fab/shells/cover-knee_ll-a.stl
body/fab/shells/cover-knee_ll-b.stl
body/fab/shells/cover-knee_rl-a.stl
body/fab/shells/cover-pack-a.stl
body/fab/shells/cover-shoe_ll-a.stl
body/fab/shells/cover-shoe_ll-b.stl
body/fab/shells/cover-shoe_rl-a.stl
body/fab/shells/cover-shoe_rl-b.stl
body/fab/shells/cover-thigh_ll-a.stl
body/fab/shells/cover-thigh_ll-b.stl
body/fab/shells/cover-thigh_rl-a.stl
body/fab/shells/cover-thigh_rl-b.stl
body/fab/shells/cover-upperarm_la-a.stl
body/fab/shells/cover-upperarm_la-b.stl
body/fab/shells/cover-upperarm_ra-a.stl
body/fab/shells/cover-upperarm_ra-b.stl
body/fab/shells/sole_ll.stl
body/fab/shells/sole_rl.stl
body/fab/shells/trim-ankle_ll-a.stl
body/fab/shells/trim-ankle_ll-b.stl
body/fab/shells/trim-ankle_rl-a.stl
body/fab/shells/trim-headdock.stl
body/fab/shells/trim-upperarm_la-a.stl
body/fab/shells/trim-upperarm_la-b.stl
body/fab/shells/trim-upperarm_ra-a.stl
body/fab/shells/trim-upperarm_ra-b.stl
body/fab/shells/trim-wrist_la.stl
body/fab/shells/trim-wrist_ra.stl
body/fab/shells/trim-yawring_ll.stl
body/fab/shells/trim-yawring_rl.stl
body/vcad/full/stl/cover-deltoid_ra.stl
body/vcad/full/stl/cover-elbowfork_la.stl
body/vcad/full/stl/cover-elbowfork_ra.stl
body/vcad/full/stl/cover-hand_la.stl
body/vcad/full/stl/cover-hand_ra.stl
body/vcad/full/stl/cover-hip_ll.stl
body/vcad/full/stl/cover-hip_rl.stl
body/vcad/full/stl/cover-hipguard_ll.stl
body/vcad/full/stl/cover-hipguard_rl.stl
body/vcad/full/stl/cover-shoe_ll.stl
body/vcad/full/stl/cover-shoe_rl.stl
body/vcad/full/stl/cover-thigh_ll.stl
body/vcad/full/stl/cover-thigh_rl.stl
body/vcad/full/stl/elec-dockplug.stl
body/vcad/full/stl/elec-j1fan_r.stl
body/vcad/full/stl/trim-j1grille_r.stl
body/vcad/full/stl/trim-waisthub.stl
body/vcad/full/stl/trim-wristpitch_la.stl
body/vcad/full/stl/trim-wristpitch_ra.stl
body/vcad/mini/stl/arm-forearmF1_la.stl
body/vcad/mini/stl/arm-forearmF1_ra.stl
body/vcad/mini/stl/cable-haudio_l.stl
body/vcad/mini/stl/cable-haudio_r.stl
body/vcad/mini/stl/cable-hcsi_l.stl
body/vcad/mini/stl/cable-hcsi_r.stl
body/vcad/mini/stl/cable-hdockdc.stl
body/vcad/mini/stl/cable-hdockgbe.stl
body/vcad/mini/stl/cable-heth.stl
body/vcad/mini/stl/cable-hhdmi.stl
body/vcad/mini/stl/cable-hmic_l.stl
body/vcad/mini/stl/cable-hpower.stl
body/vcad/mini/stl/cable-hspine.stl
body/vcad/mini/stl/cable-husbc.stl
body/vcad/mini/stl/cable-nspine.stl
body/vcad/mini/stl/cable-tspine.stl
body/vcad/mini/stl/chassis-thightop_ll.stl
body/vcad/mini/stl/chassis-thightop_rl.stl
body/vcad/mini/stl/cover-elbowfork_la.stl
body/vcad/mini/stl/cover-elbowfork_ra.stl
body/vcad/mini/stl/cover-hipguard_ll.stl
body/vcad/mini/stl/cover-hipguard_rl.stl
body/vcad/mini/stl/cover-shoe_ll.stl
body/vcad/mini/stl/cover-shoe_rl.stl
body/vcad/mini/stl/cover-thigh_ll.stl
body/vcad/mini/stl/cover-thigh_rl.stl
body/vcad/mini/stl/elec-battery.stl
body/vcad/mini/stl/elec-brake.stl
body/vcad/mini/stl/elec-cbat.stl
body/vcad/mini/stl/elec-cxamp_l.stl
body/vcad/mini/stl/elec-cxamp_r.stl
body/vcad/mini/stl/elec-cxcam_l.stl
body/vcad/mini/stl/elec-cxcam_r.stl
body/vcad/mini/stl/elec-cxdisplay.stl
body/vcad/mini/stl/elec-cxdock.stl
body/vcad/mini/stl/elec-cxmic_r.stl
body/vcad/mini/stl/elec-cxpower.stl
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
