muni-works/rose/head/print/PRINT.md

# Cortex head: desk fit print

Goal: print a cortex head and fit Cam's Jetson Orin NX on its **Seeed reComputer J401** carrier, on the desk, then iterate. Printer: Bambu P1S (256 mm bed, enclosed), **PETG**.

**Print the FULL head first.** The J401 is 100 × 80 mm, the Orin Nano dev-kit footprint, and it doesn't fit the mini: at module height there's only 69–77 mm of depth there. The full head has about 130 mm. Minis will take an Orin Nano or NX on a compact carrier (Seeed A603 class, 87 × 52). The mini STLs are here too for later.

## 1. Fit coupons first (about 1 hour)

`coupons-plate.stl` is one plate, 240 × 156 mm. Settings: PLA or PETG, 0.2 mm layers, 3 walls, 20 % infill, no supports, flat as modelled. The notches along each coupon's edge mark the variant (1 notch = smallest clearance).

| Coupon | Variants | What to do | Lock it into |
|---|---|---|---|
| Inserts | M2.5 heat-set holes 3.4 / 3.6 / 3.8; M3 holes 4.0 / 4.2 / 4.4 | Press an insert into each hole. Keep the hole where it goes in square and holds without cracking the boss. | Carrier and sled standoffs (M2.5); tub-to-floor screws (M3) |
| Board slot | 1.7 / 1.8 / 1.9 / 2.0 wide | Slide in a carrier edge, or any 1.6 mm PCB. Keep the slot that's snug with no rattle. | Board guides |
| Magnet pockets | Ø8.1 / 8.2 / 8.3 × 3.1 deep | Ø8 × 3 magnets or steel discs: press-fit vs drop-in. | Floor strike pockets, neck magnets |
| Dock face | Full-size pad pocket, cone seats, latch slot | Check that the cones seat without rocking and the latch hook clears. | The floor's dock cuts |
| **J401 template** | Plate with the assumed 86 × 58 hole pattern (Ø3.2 with Ø2.2 pilots) and a port-edge ridge | Lay the real J401 on it. Do the holes line up? Do the ports sit on the ridge edge? | `j401-holes` in `cortex-full.loon` |
| Tub-to-floor lip | 0.15 / 0.25 / 0.35 per side (floor strips + wall rings) | Keep the one that drops in by hand with no play. | `c` in `head-print.loon` (0.25 now) |

## 1b. Bambu Studio 3MF plates (P1S)

The files are in `3mf/`, generated by `make_3mf.py`. There's one 3MF per plate, with parts pre-oriented and centred on the 256 mm bed, and per-object settings stored as Bambu metadata (layer height, walls, infill, supports). When a file opens, pick the printer **Bambu Lab P1S 0.4 nozzle** and a **PETG** filament preset; those presets aren't stored in the files. Check that the per-object settings came through (right-click the object, then Edit settings). If they didn't, the tables here have them.

| File | What | Key settings |
|---|---|---|
| `cortex-coupons.3mf` | Coupon plate | 0.2 mm, 3 walls, 20 %, no supports |
| `cortex-full-1-tub.3mf` | Tub, upright | 0.2 mm, 3 walls, 15 % gyroid; tree(auto) supports, **build plate only**, 40° threshold. The crown supports grow up inside through the open bottom; there are small outside supports only under the bottom round. |
| `cortex-full-2-floor.3mf` | Floor, dock face down | 0.2 mm, 4 walls, 30 %, no supports |
| `cortex-full-3-sled.3mf` | Sled, pillars up | 0.2 mm, 4 walls, 40 %, no supports. Too big to share the floor's plate. |
| `cortex-full-4-grilles.3mf` | Two ear grilles and the exhaust grille, inner face down | **0.12 mm**, 2 walls, no supports |
| `cortex-full-5-glass.3mf` | Glass, face down | 0.12 mm, 100 % infill; smoke PETG. Run "lay on face" if it sits on an edge (the face has an 8° rake). |

## Release 1 (Cam, 2026-10-21): deep mini, black/white, minimal

- **The mini is now the +15 mm deep version** (`cortex.loon`, 119 deep × 164 × 121), so the Waveshare IO base fits at 100+.
  - For the MVP the decased **J3011** sits on a **carrier plate** in the sled: 4 M2.5 self-tap pilots (Ø2.2) on Seeed's 81 × 49 pattern, in 7 mm bosses.
  - Plates: `3mf/cortex-mini-1-tub` … `-5-glass` (sled prints plate-down).
- **No perforation for show:**
  - The ear grilles are now **solid accent panels** with a hidden 0.8 mm gap round them (speaker and mic breathe through the gap).
  - The exhaust is **three plain slots**.
  - The full head's plate 4 (`cortex-full-4-grilles`) is regenerated to match. If the old dot grilles are already printed, they still fit the same windows. Use them for the fit test, then reprint plate 4 for the look.
- **Colour:** black or white PETG for the shell and exhaust, accent colour for the two ear panels (see `../CMF.md`).

## MVP fits (Cam, 2026-10-21)

- **No heat-set inserts.** Screws self-tap into undersized PETG pilots: M2.5 → Ø2.2, M3 → Ø2.6, ≥ 3 walls around each boss.
  - The sled pillars are now Ø2.2 pilots, 7 mm deep in 8 mm square pillars (2.9 mm walls). Use M2.5 × 8 screws: thread-forming plastic screws if you have them, plain machine screws are fine.
  - Drive them in once, slowly. Don't over-torque.
- **"Medium-rare":** one step tighter than the middle on every ladder.
  - Floor lip: c = 0.15.
  - Strike and magnet pockets: Ø8.1 (already).
  - Board slot: 1.7, when we add guides.
- Changed: floor and sled only (plates 2 and 3). The tub, grilles and glass are unchanged.

## 2. Head shells

Regenerate the STLs with `./make_print.sh head-print-full.loon full` (or with no arguments for the mini). Set `VCAD=` to the vcad CLI. The full head is listed first; the mini parts use the same settings.

| STL | Orientation | Settings |
|---|---|---|
| `stl/cortex-full-tub.stl` (158 × 230 × 190) | Upright on its open bottom | PETG, 0.2 mm, 3 walls, 15 % gyroid, enclosure closed, same support rules as the mini tub below |
| `stl/cortex-full-floor.stl`, `-sled`, `-ear-grilles`, `-exhaust-grille`, `-glass` | As the mini rows below | PETG. The sled is four pillars with M2.5 insert holes under the J401's corners. |
| `stl/cortex-mini-tub.stl` (102 × 164 × 118) | Upright on its open bottom | PLA, 0.2 mm, 3 walls, 15 % gyroid. **Tree supports inside only:** the crown roof and the top edge of the face opening. The outside needs none. Bambu: "support on build plate only" off, "tree (auto)", top Z distance 0.2. |
| `stl/cortex-mini-floor.stl` (98 × 158 × 9) | Flat, dock face down | 0.2 mm, 4 walls, 30 % infill, no supports. Has the 2.5 mm registration lip that drops into the tub. |
| `stl/cortex-mini-sled.stl` | Flat | 0.2 mm, 4 walls, 40 % (the product part is 2 mm folded aluminium) |
| `stl/cortex-mini-ear-grilles.stl`, `-exhaust-grille.stl` | Inner face down | **0.12 mm layers** for the 1.4 mm holes, 2 walls, no supports. Contrast colour (the colorway accent) if you have it. |
| `stl/cortex-mini-glass.stl` (optional) | Face down | Smoke PETG, or skip and tape on 3 mm smoked acrylic cut to the opening |

- Mesh repair: Bambu Studio may offer to repair the tub, floor and exhaust grille (a few open edges from the booleans). Accept it.
- Assembly: the floor drops into the tub. Tape it for now. M3 self-tap bosses (Ø2.6 pilots) come in the next pass.

## 3. Jetson: the bare reComputer Super carrier

Cam's call: take the board out of its enclosure to save weight, and keep the stock heatsink and fan. The full head carries:

**Measured from Cam's caliper photos (2026-10-21):**
- Mounting holes 100.2 × 100.2 mm
- Port edge (DC, 2× RJ45 over USB, a stacked USB pair, HDMI, USB-C) 23.6 mm tall including the board

**Estimated:**
- Board about 110 × 110 mm (scaled from the photo)

**Assumed, measure and send:**
- The stock heatsink and fan: about 70 × 85 footprint, 30 mm above the board. The design has 30 mm of headroom to the crown and 16 mm to the display, so a wrong guess won't break the print.
- Hole diameter: M2.5 (from the J3011 STEP; check the Super carrier).

**How it sits:**
- The board lies on the sled (two back pillars plus a bridge on legs over the 3S2P pack) at z 38.
- The port edge faces a 108 × 28 mm back cutout.
- The 7" panel's driver board lies flat above the heatsink in the crown.

**Airflow:** the fan pulls from the crown; intake is through the ear grids. The heatsink exhausts toward the back grid.

**Margins:** board to wall 7.5 mm, board to display 27 mm, heatsink to display 16 mm. One sled pillar foot meets the tub's bottom curl over a sliver of about 12 mm³, which print tolerance absorbs.

## 4. What to check on the desk

1. **Board fit.** Does the carrier sit on the sled within the tub with ≥ 2 mm to every wall? Does the tub drop over it from above without catching on any connector?
2. **Connector and cable access.** Do the carrier's ports line up with the back cutout? Can you plug and unplug USB, Ethernet and DC with the head closed? Is there room for the CSI and HDMI ribbons to fold without kinking (≥ 3 mm bend radius)?
3. **Airflow.** The heatsink fan pulls from the open crown space and exhausts aft through the back dot grid. Is the fan ≥ 5 mm from the crown? Run it closed for 10 minutes under load and note the module temperature.
4. **Cameras and lenses.** Hold the cameras behind the glass position. Is the face opening's edge outside the lens FOV? Is the 106 mm baseline symmetric? Is there room behind for the FPCs?
5. **Dock.** Seat the floor on a printed neck dock. Do the cones locate it without rocking? Do the magnets pull it flat (if fitted)? Does the latch slot line up?
6. **Feel.** Weight in the hand, how it sits on the desk, whether the face rake reads right at desk height.

Write the measurements here or in a note, and the next pass folds them in.

## Node in ASA (OrcaSlicer, P1S)

`fab/node/node-mvp-asa.3mf` (from `node_3mf.py`): both parts tilted 30 deg, uniform 0.2 layers, 3 walls, 8 mm
outer brim, one filament (Generic ASA or Bambu ASA). The tree supports are tuned to peel clean: 0.2 top/bottom gap
(one layer), 3 interlaced interface layers at 0.3 spacing, 0.6 xy gap from the walls, 60 mm/s interface.

A PLA interface (it doesn't bond to ASA) would peel cleaner. Orca blocks the pair on its nozzle-temperature
check unless you turn on Preferences -> Control -> Slicing -> Remove mixed temperature restriction.

Keep the door and lid closed, dry the ASA, and use Textured PEI or the Smooth/High Temp plate (not the Cool Plate).
