muni-works/rose/arm/skin-stl/print/PRINT.md

# lymb v10.8 skin: print-ready parts

Generated by `skin_print_all.py` (geometry: `skin_print.py`, from the frozen v10.6 lofts). Every file is a
watertight, manifold solid in its link frame (mm), shelled to its wall with the inner face open, the attachment
features modelled in:
- sleeve halves: 2 C-clips per holder plate over its straight top / bottom edge (3.375 mm slot, 5 mm deep),
  and 2 magnet bosses on the parting plane (Ø6.2 x 3.2 pocket for an N52 Ø6 x 3 disc, glued);
- v10.8 (Cam: no perforations): no dot-grids anywhere. J4 / J6 ring barrels are sealed PA12 tubes with a 3-spoke
  spider on each face to 3 of the motor's own screws; the J2 drum and every cap disc are turned 6061, black
  anodized, on a gap pad to the motor (listed here with their process, not printed); the 1.5 mm gunmetal rings
  are turned 6061. The J3 band is in V10.8.md (BOM).
Rings are 3MF (zip); everything else is binary STL.

Builds: **desk arm** = every file without a suffix (left-handed upper sleeve). **Humanoid, per arm** =
`turret-*_body` and `flank-J1_body` in place of `turret-*`, `drum-J1`, `desk-puck`; the right arm takes
`upper-*_R` in place of `upper-*`.

Cost: volume x $0.40 / cm³ - a typical MJF PA12 service rate (material + machine time), **not a quote**: JLC3DP
and Xometry both need an account to return an instant MJF price. Dyeing / vapour smoothing and the turned
6061 bezels / SLA trims are extra.

| file | part | finish | process | wall mm | watertight | volume cm³ | est. $ | bbox mm | faces |
|---|---|---|---|---:|---|---:|---:|---|---:|
| upper-front.stl | upper-front | skin | MJF PA12, dyed black #121213 (or white #ECECE9 on the white arm), vapour-smoothed satin | 0.9 | yes | 25.0 | 10 | 149 x 61 x 131 | 3288 |
| upper-back.stl | upper-back | skin | MJF PA12, dyed black #121213 (or white #ECECE9 on the white arm), vapour-smoothed satin | 0.9 | yes | 25.0 | 10 | 149 x 61 x 131 | 3288 |
| upperd-front.stl | upperd-front | skin | MJF PA12, dyed black #121213 (or white #ECECE9 on the white arm), vapour-smoothed satin | 0.9 | yes | 16.5 | 7 | 102 x 46 x 108 | 2930 |
| upperd-back.stl | upperd-back | skin | MJF PA12, dyed black #121213 (or white #ECECE9 on the white arm), vapour-smoothed satin | 0.9 | yes | 16.5 | 7 | 102 x 46 x 108 | 2930 |
| ring-J3.stl | ring-J3 | trim | turned 6061, gunmetal anodize | 1.2 | yes | 0.4 | - | 1 x 90 x 107 | 480 |
| fore-front.stl | fore-front | skin | MJF PA12, dyed black #121213 (or white #ECECE9 on the white arm), vapour-smoothed satin | 0.9 | yes | 12.2 | 5 | 103 x 42 x 57 | 2144 |
| fore-back.stl | fore-back | skin | MJF PA12, dyed black #121213 (or white #ECECE9 on the white arm), vapour-smoothed satin | 0.9 | yes | 12.2 | 5 | 103 x 42 x 57 | 2140 |
| wrist-front.stl | wrist-front | skin | MJF PA12, dyed black #121213 (or white #ECECE9 on the white arm), vapour-smoothed satin | 0.9 | yes | 9.4 | 4 | 76 x 37 x 73 | 1804 |
| wrist-back.stl | wrist-back | skin | MJF PA12, dyed black #121213 (or white #ECECE9 on the white arm), vapour-smoothed satin | 0.9 | yes | 9.4 | 4 | 76 x 37 x 73 | 1804 |
| ring-J7.stl | ring-J7 | accent | SLA, Make green #39ff14 | 1.2 | yes | 0.6 | - | 2 x 66 x 72 | 480 |
| turret-front.stl | turret-front | skin | MJF PA12, dyed black #121213 (or white #ECECE9 on the white arm), vapour-smoothed satin | 1.2 | yes | 2.6 | 1 | 154 x 65 x 72 | 2024 |
| turret-back.stl | turret-back | skin | MJF PA12, dyed black #121213 (or white #ECECE9 on the white arm), vapour-smoothed satin | 1.2 | yes | 2.6 | 1 | 154 x 65 x 72 | 2026 |
| puck-J4.3mf | puck-J4 | puck | MJF PA12, dyed black #121213 (joints are black on both colourways), vapour-smoothed satin | 0.9 | yes | 34.9 | 14 | 126 x 87 x 126 | 2740 |
| puck-J6.3mf | puck-J6 | puck | MJF PA12, dyed black #121213 (joints are black on both colourways), vapour-smoothed satin | 0.9 | yes | 26.0 | 10 | 96 x 81 x 96 | 2660 |
| puck-J2.stl | puck-J2 | drum | turned 6061, black anodize satin, on a 0.25 mm gap pad to the motor (NOT printed) | 1.0 | yes | 55.7 | - | 137 x 119 x 137 | 2746 |
| disc-J2-1.stl | disc-J2-1 | drum | turned 6061, black anodize satin, on a 0.25 mm gap pad to the motor (NOT printed) | 1.2 | yes | 14.2 | - | 134 x 1 x 134 | 512 |
| cap-J2-1.stl | cap-J2-1 | trim | turned 6061, gunmetal anodize | 0.9 | yes | 1.0 | - | 137 x 2 x 137 | 1024 |
| disc-J2+1.stl | disc-J2+1 | drum | turned 6061, black anodize satin, on a 0.25 mm gap pad to the motor (NOT printed) | 1.2 | yes | 14.2 | - | 134 x 1 x 134 | 512 |
| cap-J2+1.stl | cap-J2+1 | trim | turned 6061, gunmetal anodize | 0.9 | yes | 1.0 | - | 137 x 2 x 137 | 1024 |
| disc-J4-1.stl | disc-J4-1 | drum | turned 6061, black anodize satin, on a 0.25 mm gap pad to the motor (NOT printed) | 1.2 | yes | 12.0 | - | 123 x 1 x 123 | 512 |
| cap-J4-1.stl | cap-J4-1 | trim | turned 6061, gunmetal anodize | 0.9 | yes | 0.9 | - | 126 x 2 x 126 | 1024 |
| disc-J4+1.stl | disc-J4+1 | drum | turned 6061, black anodize satin, on a 0.25 mm gap pad to the motor (NOT printed) | 1.2 | yes | 12.0 | - | 123 x 1 x 123 | 512 |
| cap-J4+1.stl | cap-J4+1 | trim | turned 6061, gunmetal anodize | 0.9 | yes | 0.9 | - | 126 x 2 x 126 | 1024 |
| disc-J6-1.stl | disc-J6-1 | drum | turned 6061, black anodize satin, on a 0.25 mm gap pad to the motor (NOT printed) | 1.2 | yes | 6.8 | - | 92 x 1 x 92 | 512 |
| cap-J6-1.stl | cap-J6-1 | trim | turned 6061, gunmetal anodize | 0.9 | yes | 0.7 | - | 96 x 2 x 96 | 1024 |
| disc-J6+1.stl | disc-J6+1 | drum | turned 6061, black anodize satin, on a 0.25 mm gap pad to the motor (NOT printed) | 1.2 | yes | 6.8 | - | 92 x 1 x 92 | 512 |
| cap-J6+1.stl | cap-J6+1 | trim | turned 6061, gunmetal anodize | 0.9 | yes | 0.7 | - | 96 x 2 x 96 | 1024 |
| drum-J1.stl | drum-J1 | puck | MJF PA12, dyed black #121213 (joints are black on both colourways), vapour-smoothed satin | 1.2 | yes | 29.5 | 12 | 154 x 154 x 51 | 1280 |
| desk-puck.stl | desk-puck | skin | MJF PA12, dyed black #121213 (or white #ECECE9 on the white arm), vapour-smoothed satin | 1.2 | yes | 69.0 | 28 | 190 x 190 x 51 | 6656 |
| upper-front_R.stl | upper-front_R | skin | MJF PA12, dyed black #121213 (or white #ECECE9 on the white arm), vapour-smoothed satin | 0.9 | yes | 25.0 | 10 | 149 x 61 x 131 | 3288 |
| upper-back_R.stl | upper-back_R | skin | MJF PA12, dyed black #121213 (or white #ECECE9 on the white arm), vapour-smoothed satin | 0.9 | yes | 25.0 | 10 | 149 x 61 x 131 | 3288 |
| turret-front_body.stl | turret-front_body | skin | MJF PA12, dyed black #121213 (or white #ECECE9 on the white arm), vapour-smoothed satin | 1.2 | yes | 3.9 | 2 | 154 x 65 x 72 | 2148 |
| turret-back_body.stl | turret-back_body | skin | MJF PA12, dyed black #121213 (or white #ECECE9 on the white arm), vapour-smoothed satin | 1.2 | yes | 3.9 | 2 | 154 x 65 x 72 | 2140 |
| flank-J1_body.stl | flank-J1_body | puck | MJF PA12, dyed black #121213 (joints are black on both colourways), vapour-smoothed satin | 2.0 | yes | 4.0 | 2 | 133 x 133 x 2 | 1024 |

Desk arm: 29 parts, 291 cm³ printed in MJF PA12 (~$116 at the rate above), + 14 turned 6061 parts, 1 SLA trim.
Not watertight: none.

Retention without clips (no straight plate edge inside them): wrist halves - 2 seam magnet pairs + the J7
accent ring over the joint line; turret halves - 2 seam magnet pairs, located on the turret disc rim; J1 drum -
sits on the foot, located by the turret disc; desk puck - captured under the pedestal base plate.
