muni-works/rose/body/vcad/mini/photoreal-assembled.png

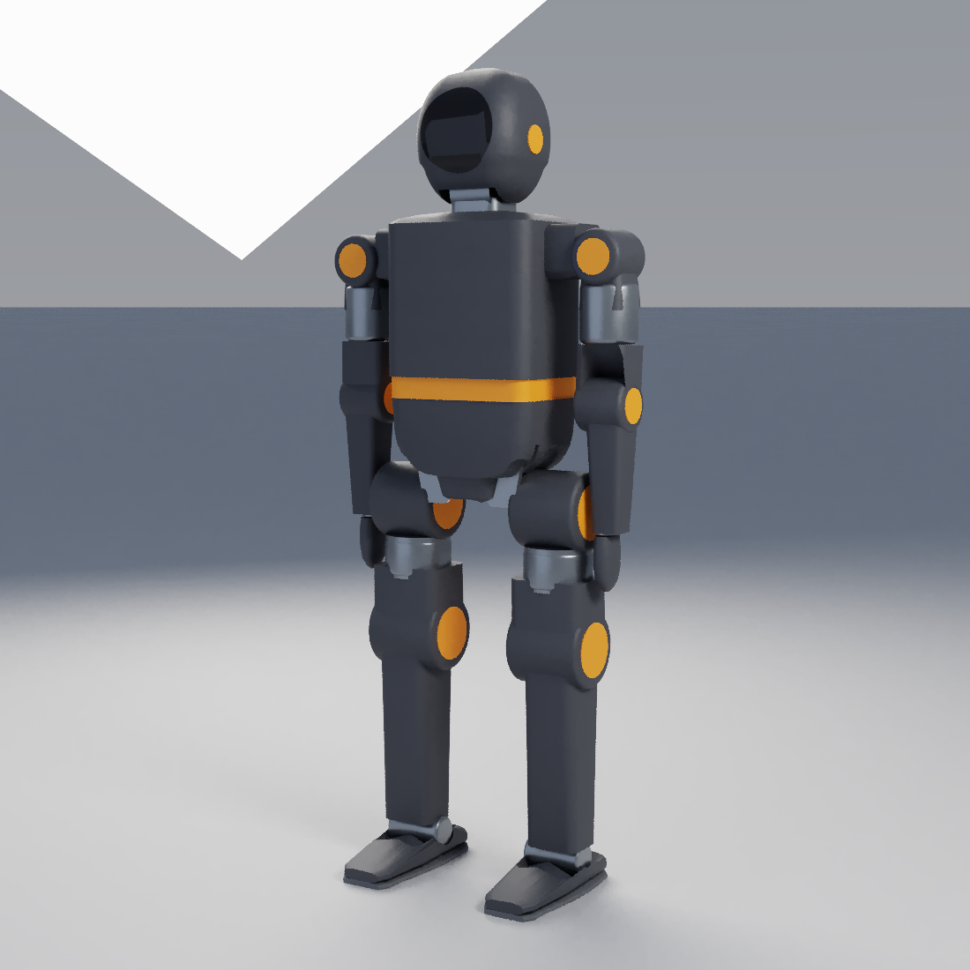
body/vcad/mini/photoreal-assembled.png
