muni-works/rose/head/print/3mf/preview/cortex-coupons.png

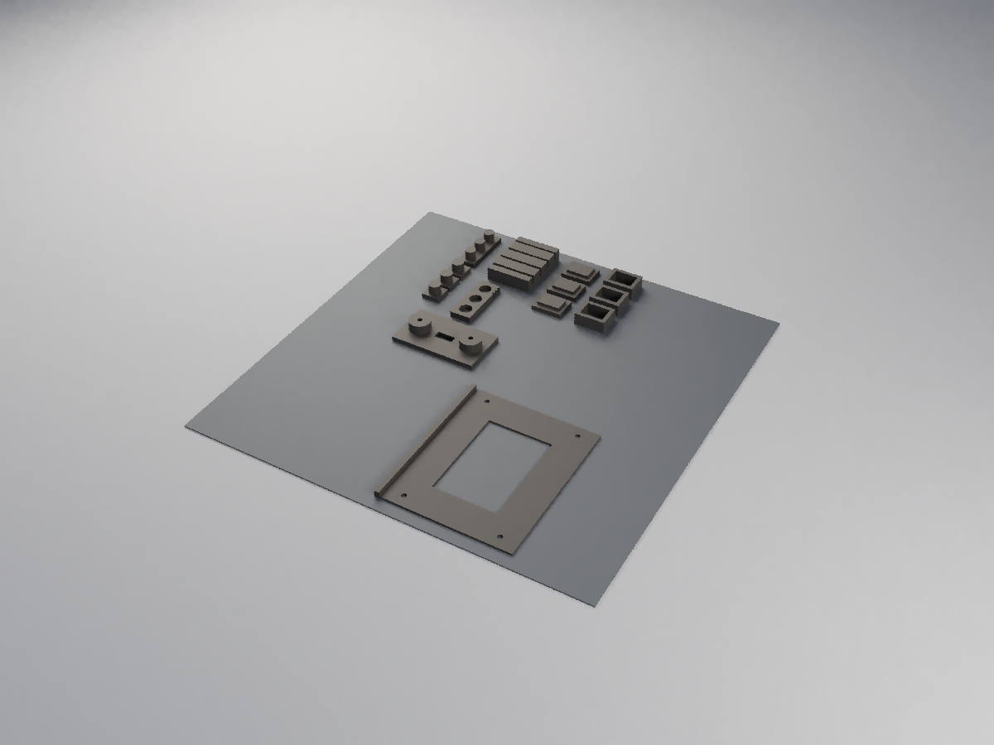
head/print/3mf/preview/cortex-coupons.png
