muni-works/rose/head/print/3mf/preview/cortex-full-1-tub.png

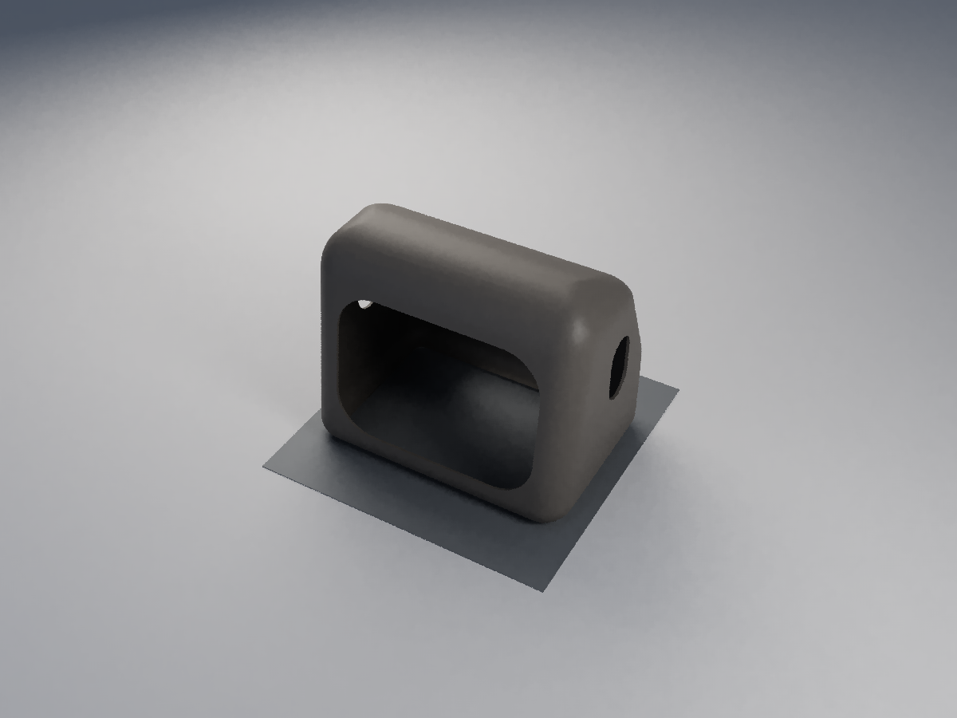
head/print/3mf/preview/cortex-full-1-tub.png
