muni-works/rose/head/print/3mf/preview/cortex-mini-1-tub.png

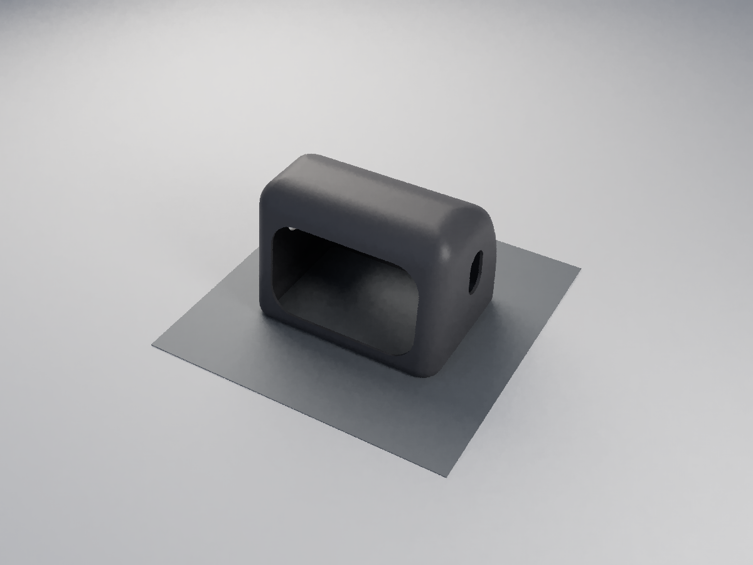
head/print/3mf/preview/cortex-mini-1-tub.png
