muni-works/rose/head/print/3mf/preview/cortex-mini-3-sled.png

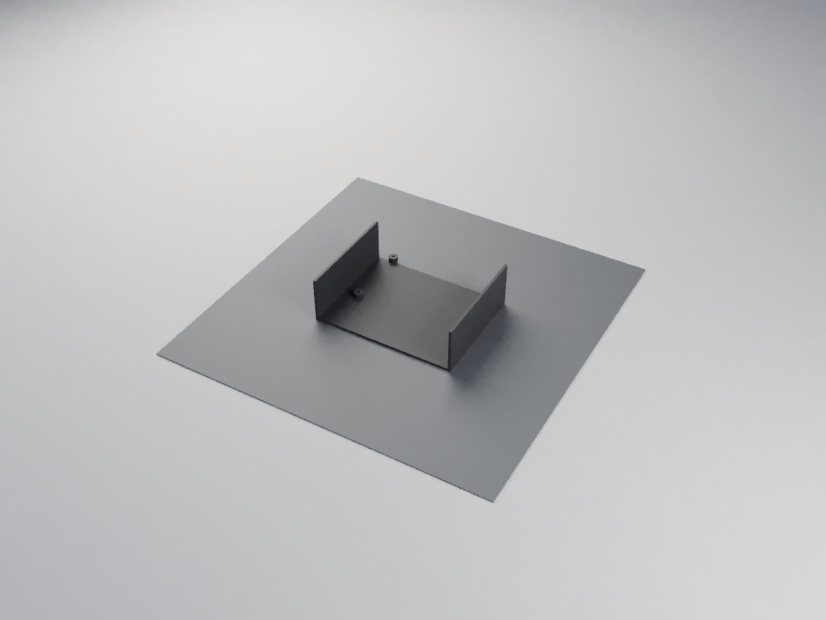
head/print/3mf/preview/cortex-mini-3-sled.png
