muni-works/rose/head/renders/node/print-34.png

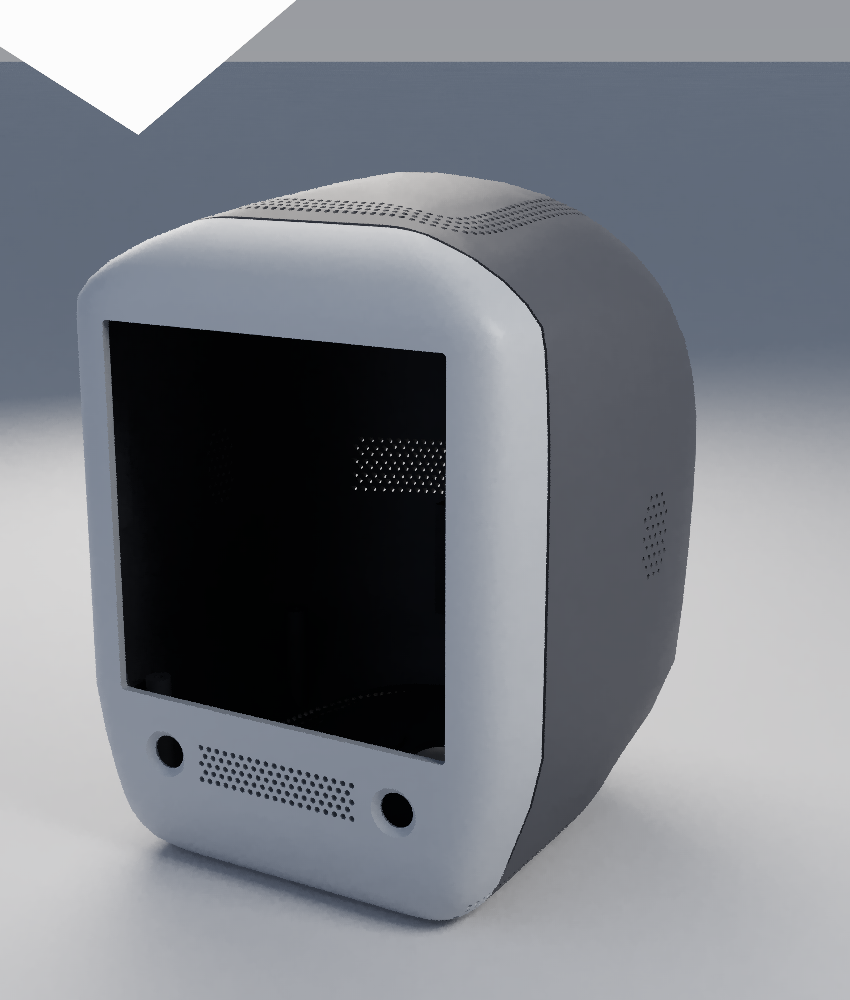
head/renders/node/print-34.png
