muni-works/rose/head/renders/node/print-back.png

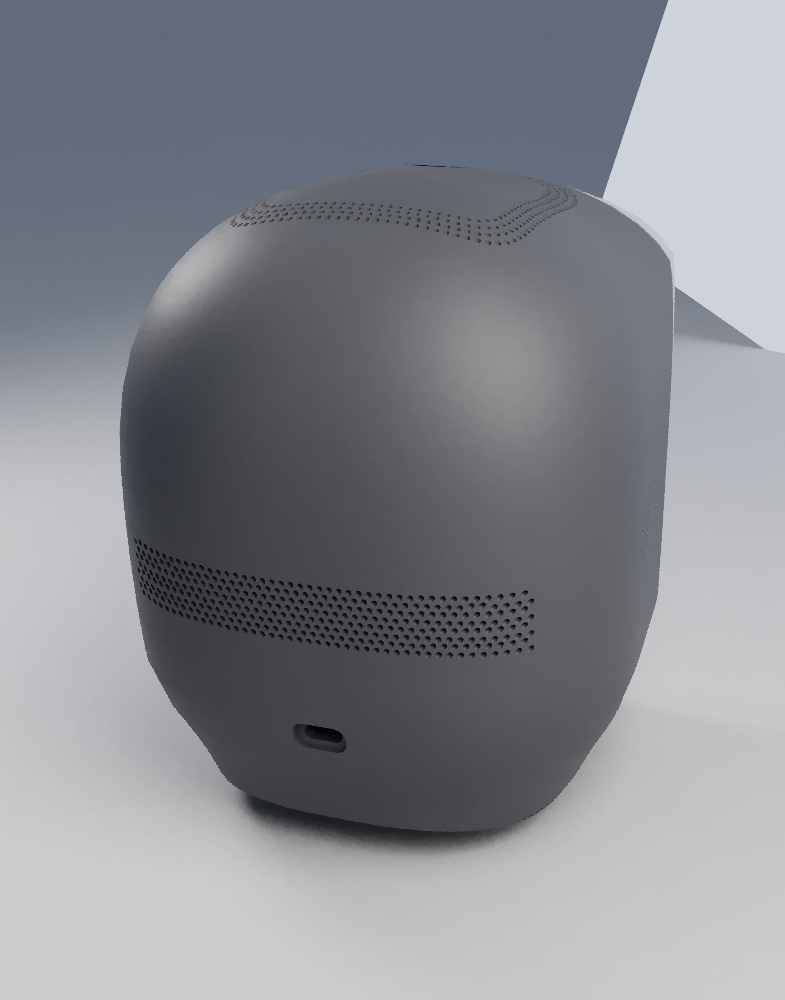
head/renders/node/print-back.png
