muni-works/rose/head/renders/node/print-cut.png

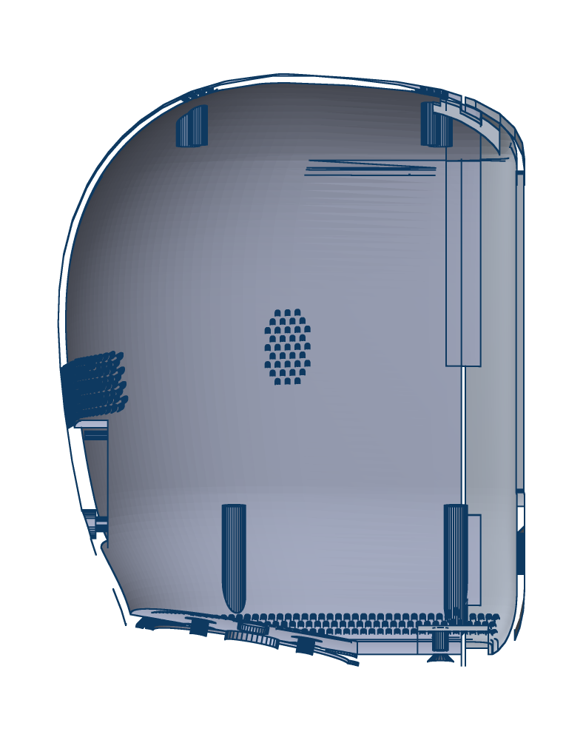
head/renders/node/print-cut.png
