muni-works/rose/head/renders/node/print-fit-ear.png

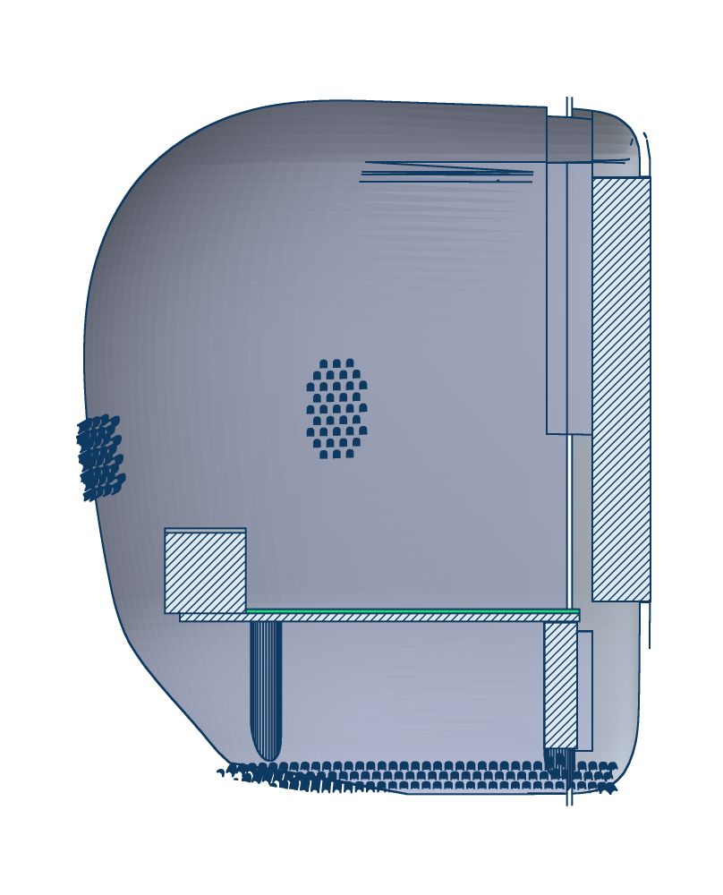
head/renders/node/print-fit-ear.png
