muni-works/rose/head/renders/node/print-fit.png

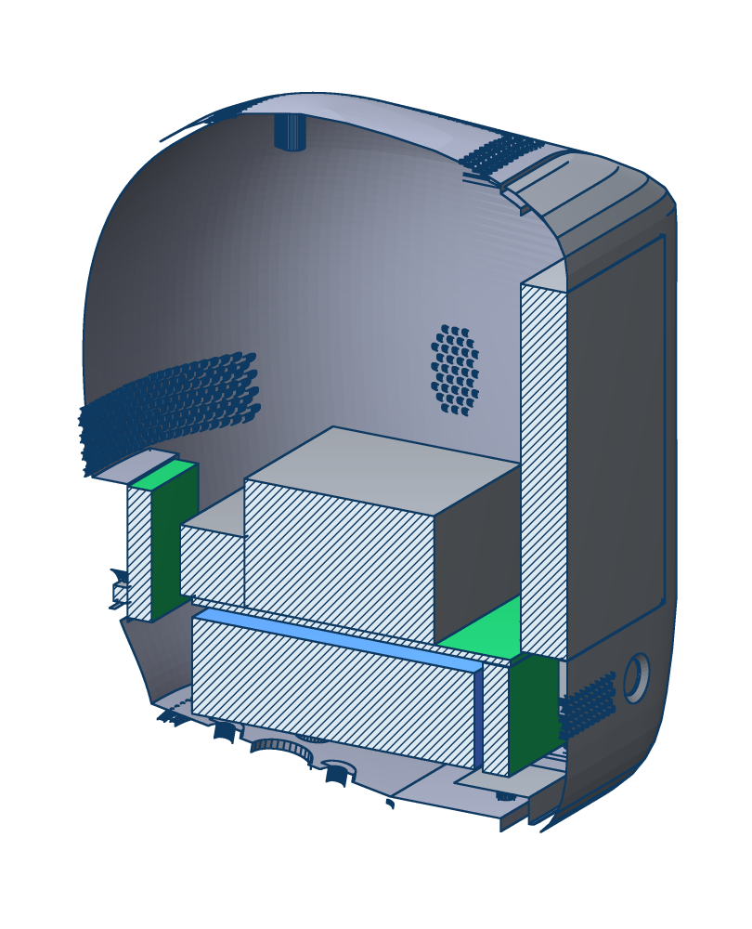
head/renders/node/print-fit.png
