muni-works/rose/head/renders/node/print-under.png

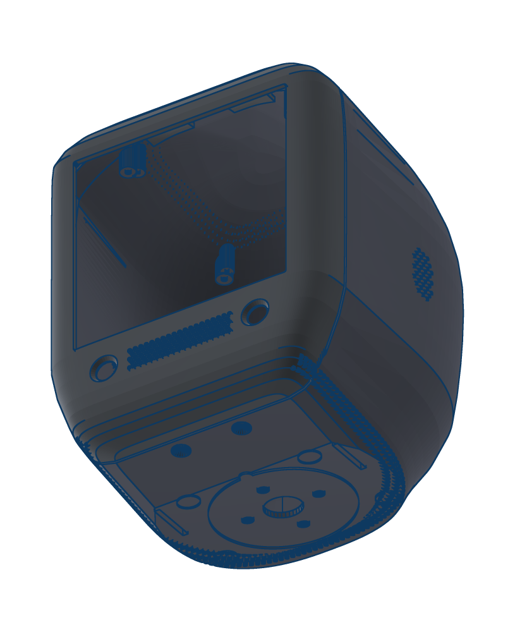
head/renders/node/print-under.png
