muni-works/rose/head/renders/node/print-usb.png

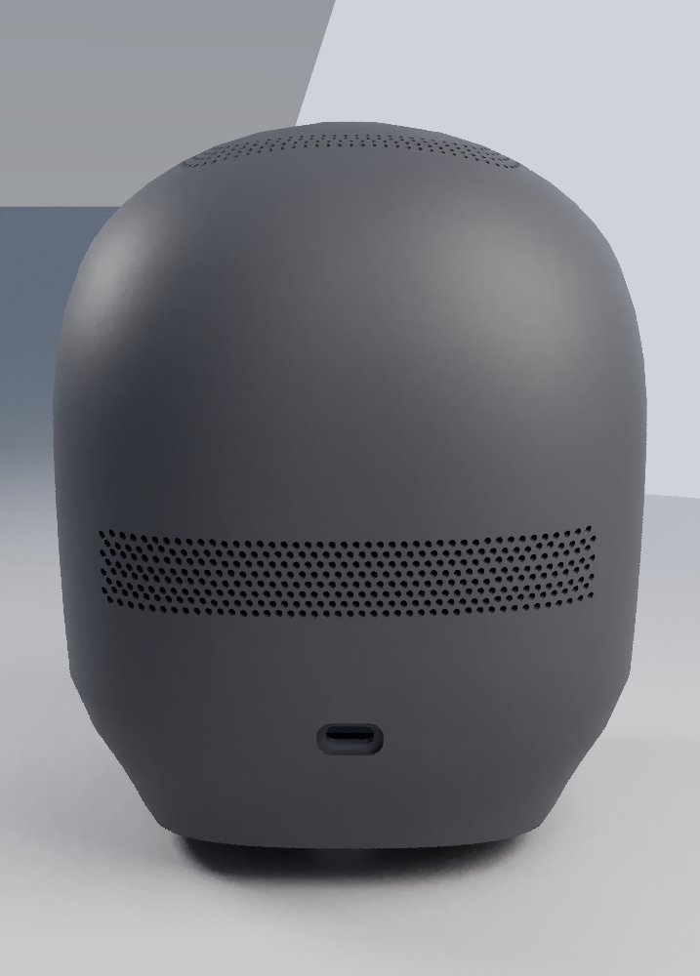
head/renders/node/print-usb.png
