muni-works/rose/head/renders/print/b1.png

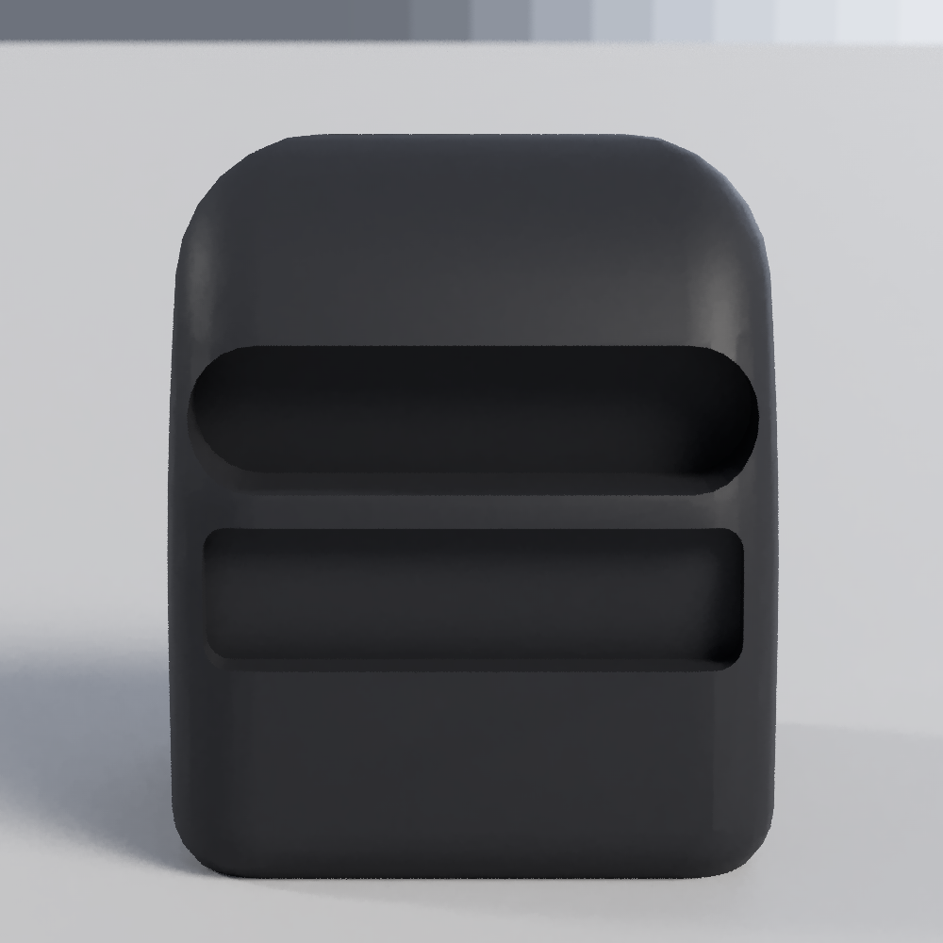
head/renders/print/b1.png
