muni-works/rose/head/renders/print/b2.png

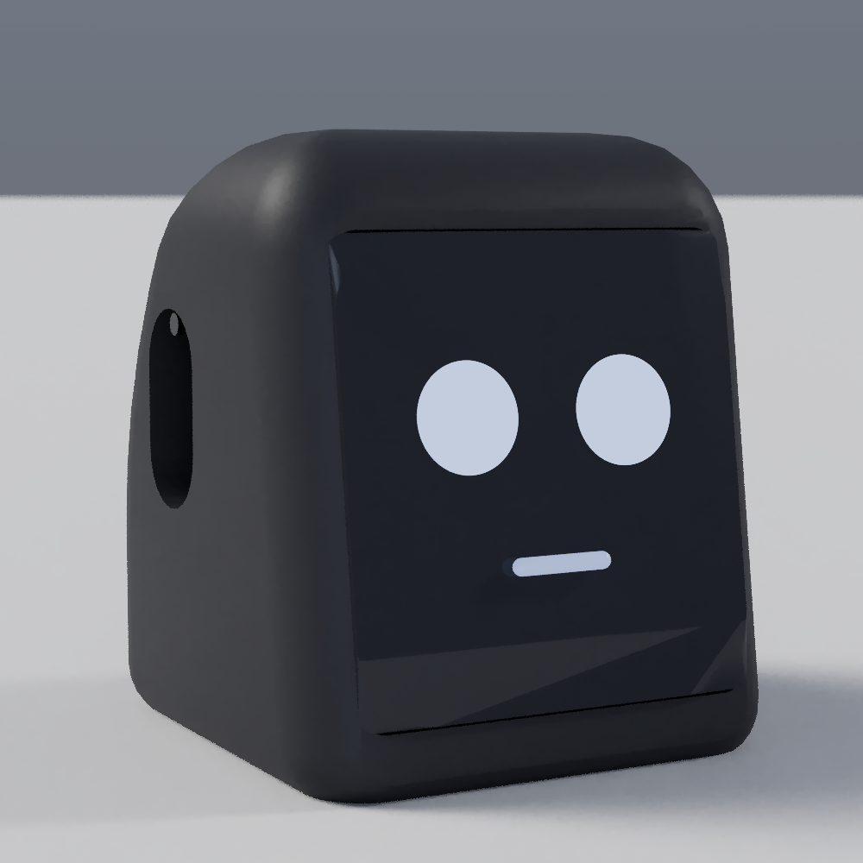
head/renders/print/b2.png
