muni-works/rose/head/renders/print/back-grille.png

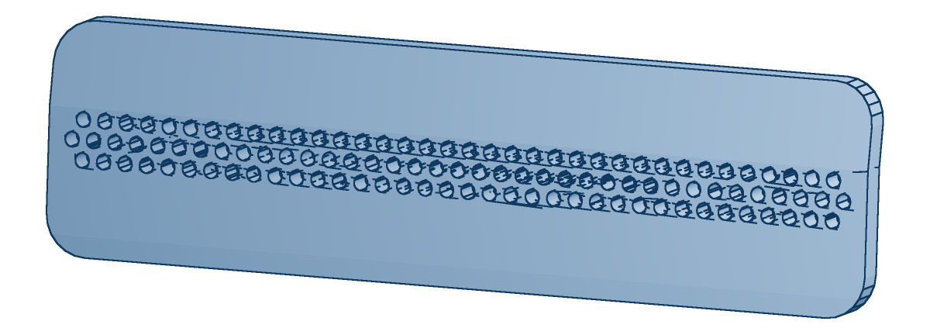
head/renders/print/back-grille.png
