muni-works/rose/head/renders/print/cw-A-two-tone.png

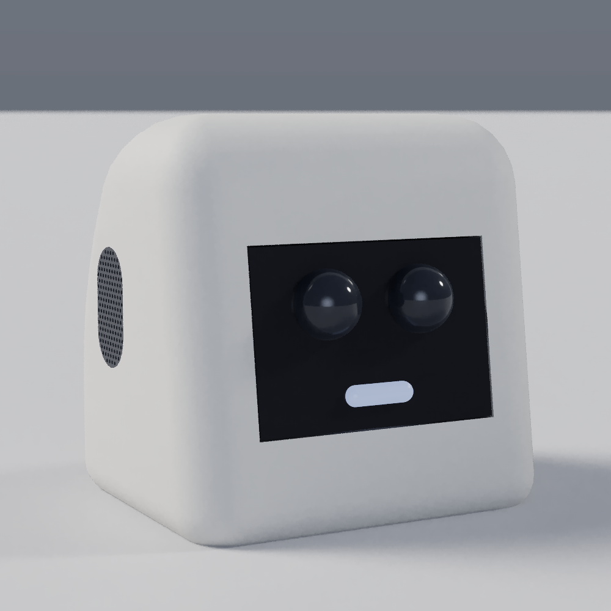
head/renders/print/cw-A-two-tone.png
