muni-works/rose/head/renders/print/cw-B-black.png

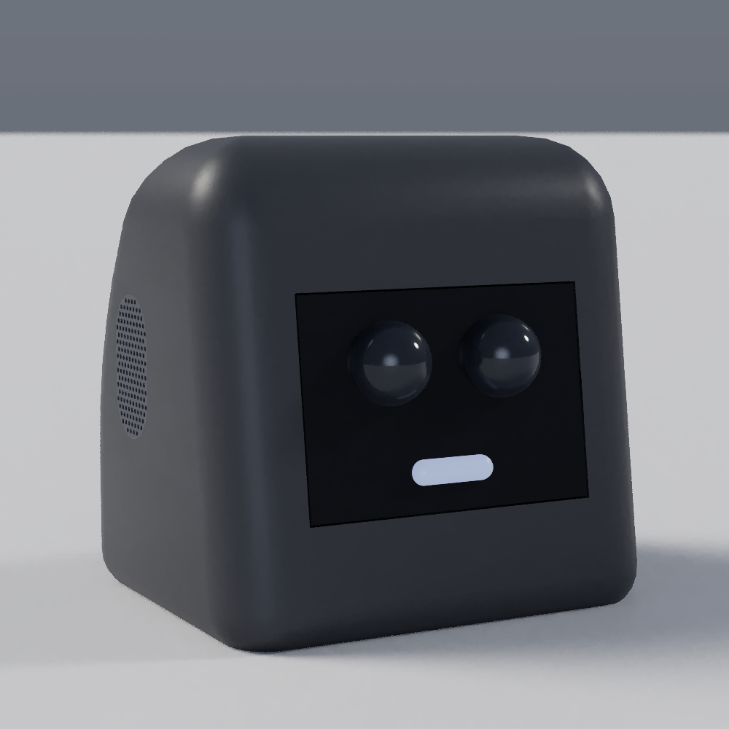
head/renders/print/cw-B-black.png
