muni-works/rose/head/renders/print/cw-C-white.png

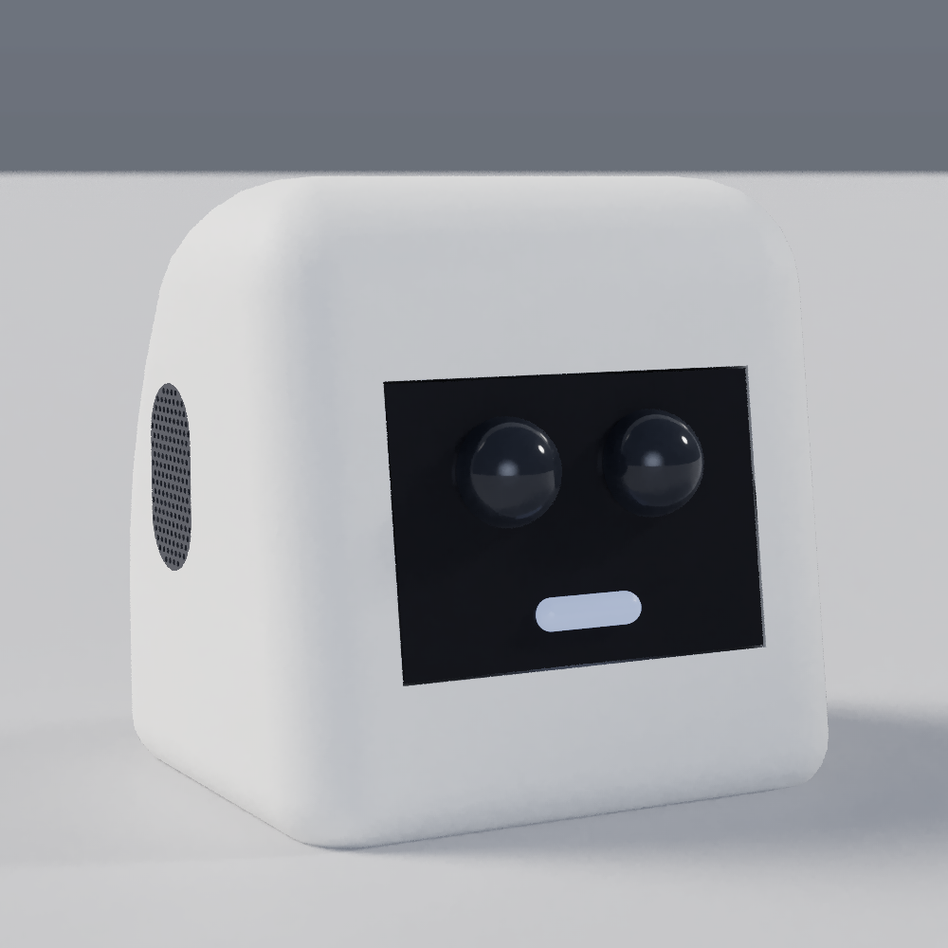
head/renders/print/cw-C-white.png
