muni-works/rose/head/renders/print/d4-face.png

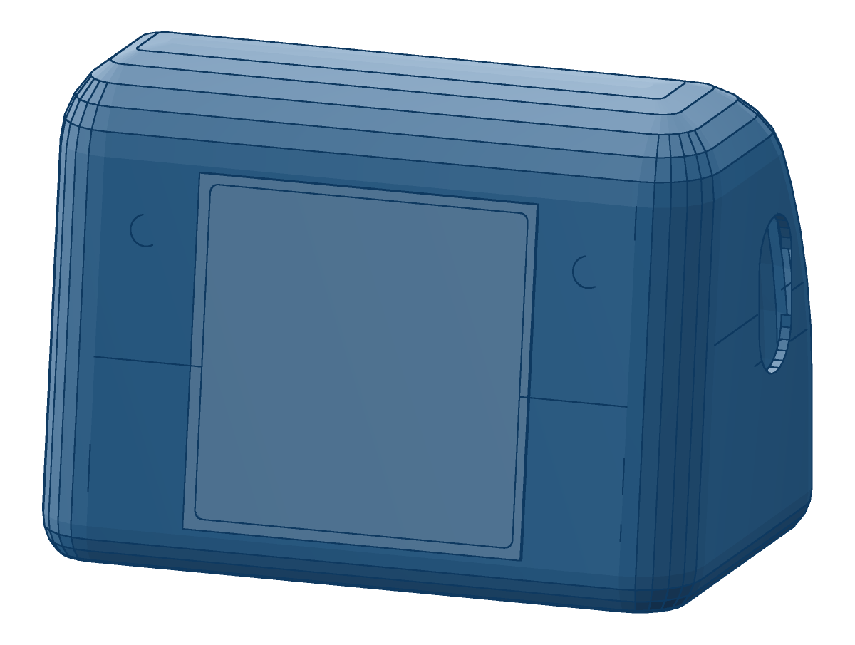
head/renders/print/d4-face.png
