muni-works/rose/head/renders/print/d4-inside.png

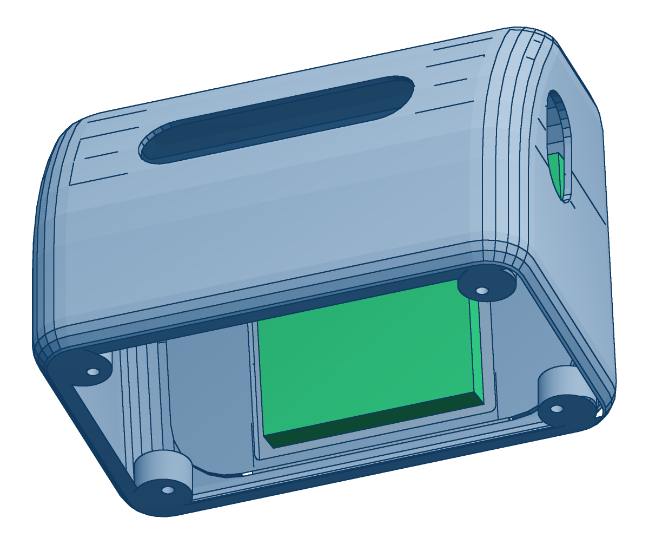
head/renders/print/d4-inside.png
