muni-works/rose/head/renders/print/e1.png

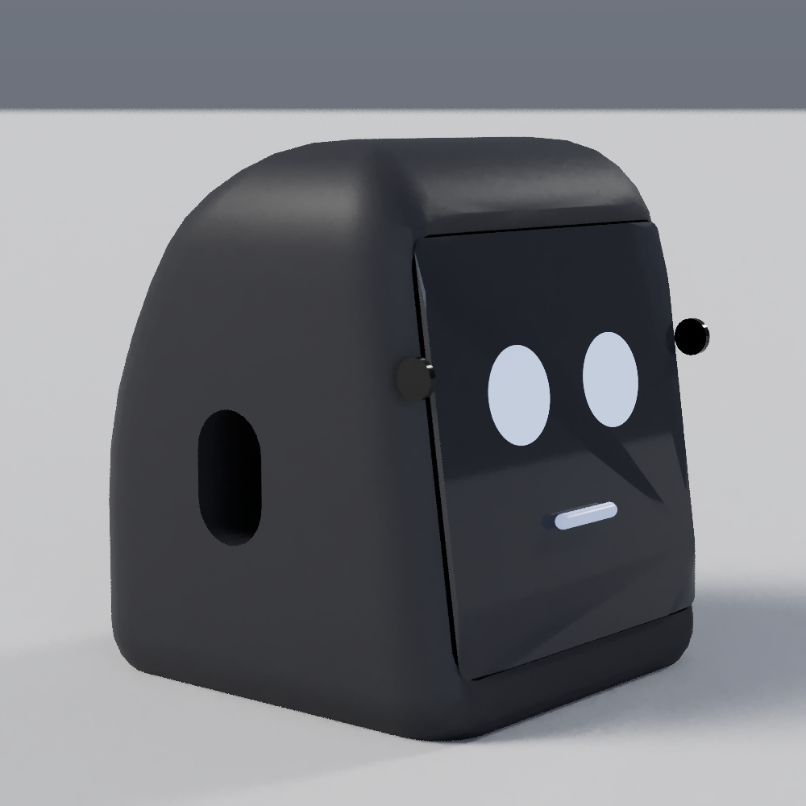
head/renders/print/e1.png
