muni-works/rose/head/renders/print/e2.png

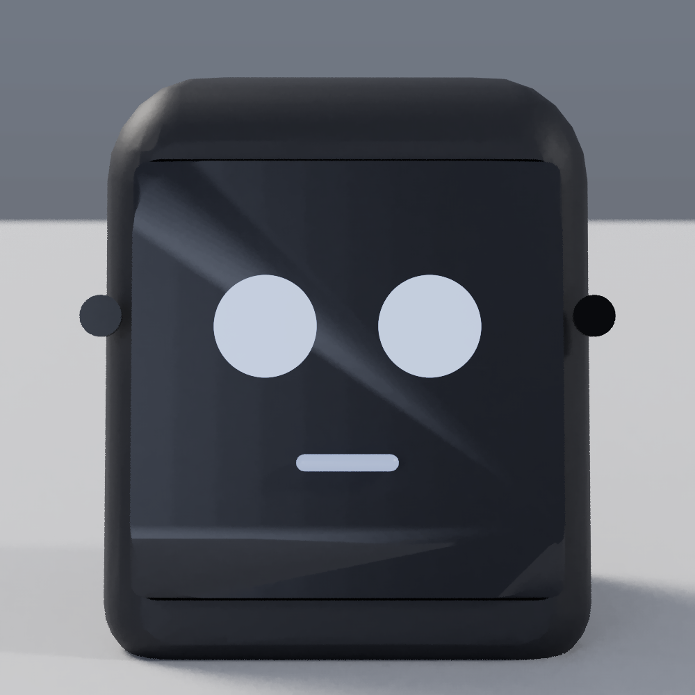
head/renders/print/e2.png
