muni-works/rose/head/renders/print/e7.png

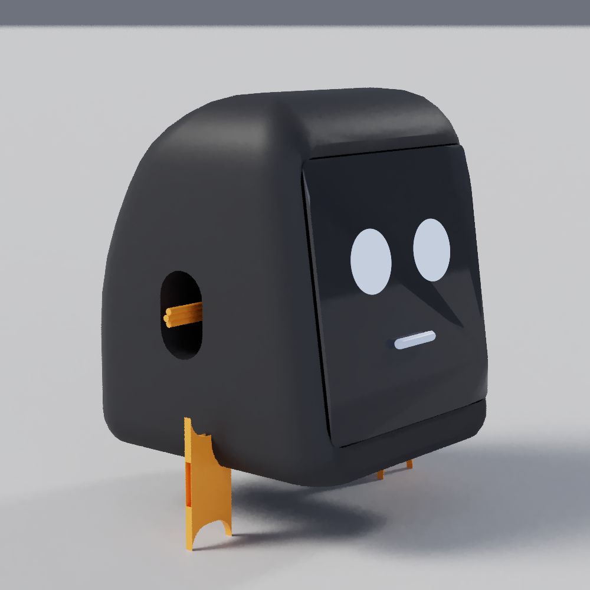
head/renders/print/e7.png
