muni-works/rose/head/renders/print/ear-grilles.png

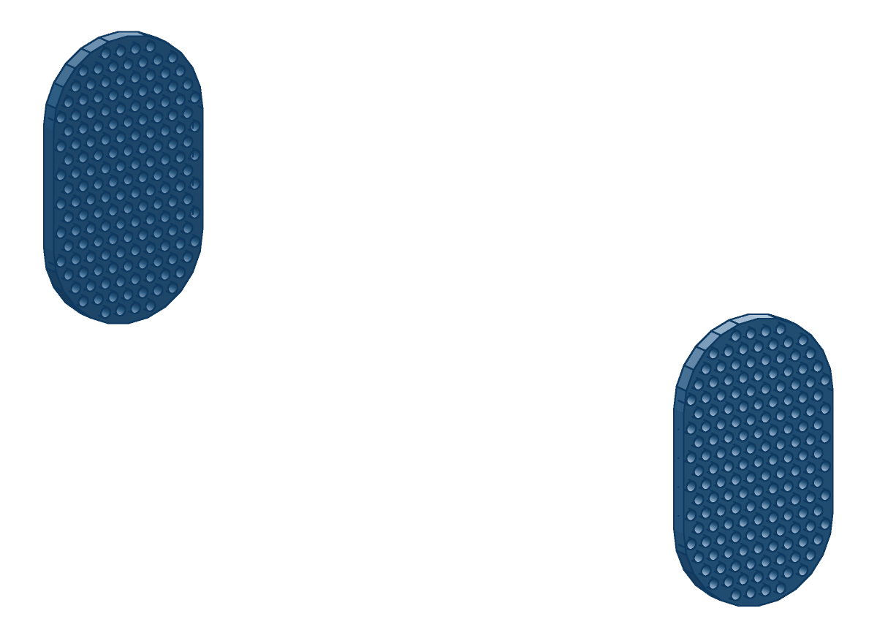
head/renders/print/ear-grilles.png
