muni-works/rose/head/renders/print/exhaust-grille.png

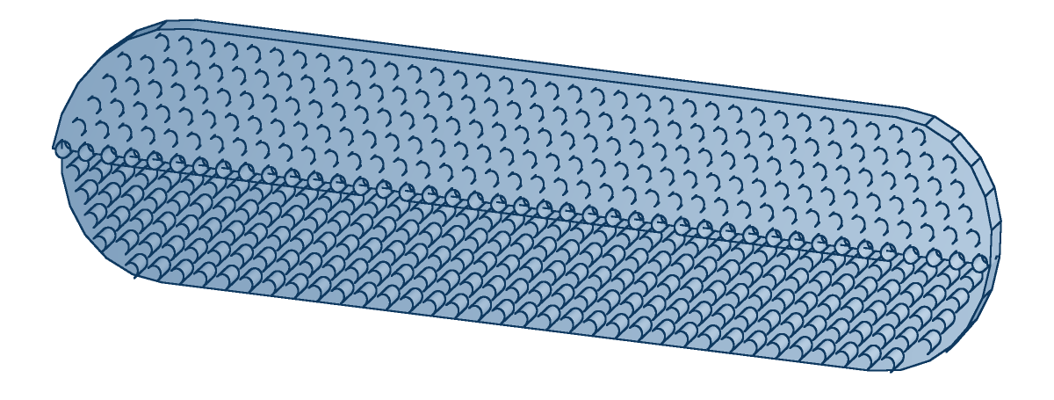
head/renders/print/exhaust-grille.png
