muni-works/rose/head/renders/print/floor-bottom.png

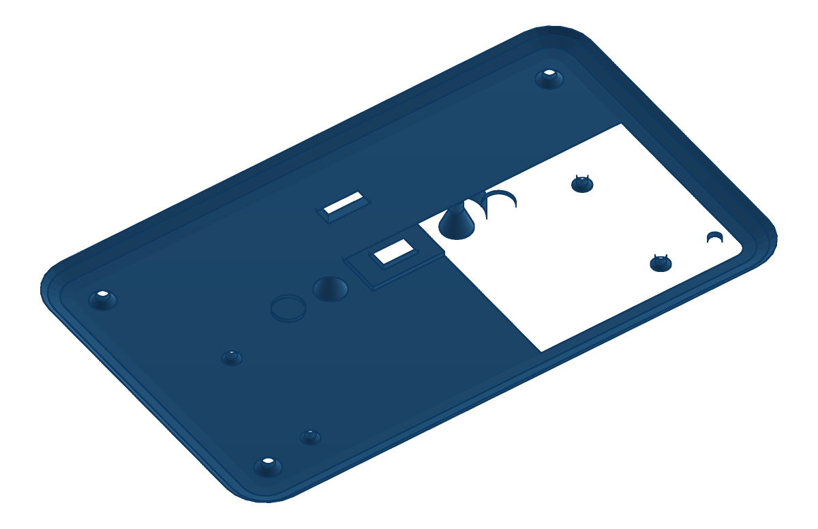
head/renders/print/floor-bottom.png
