muni-works/rose/head/renders/print/floor-top.png

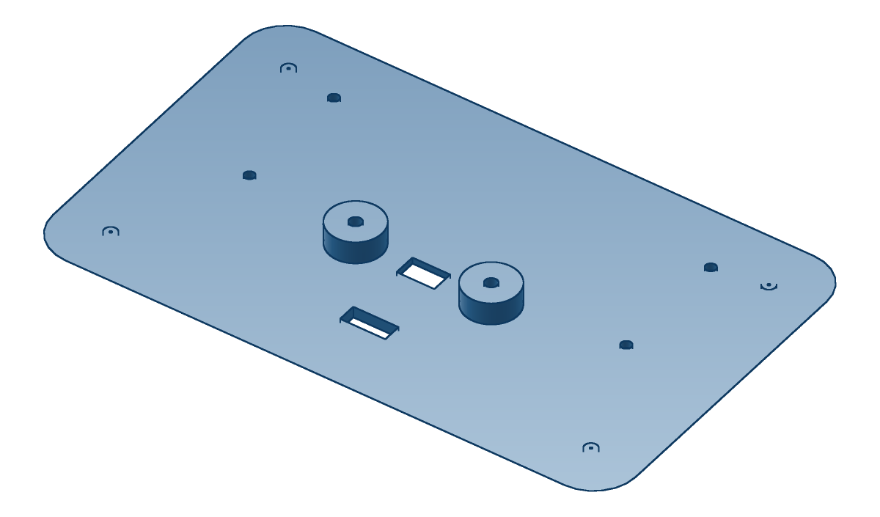
head/renders/print/floor-top.png
