muni-works/rose/head/renders/print/j-banana.png

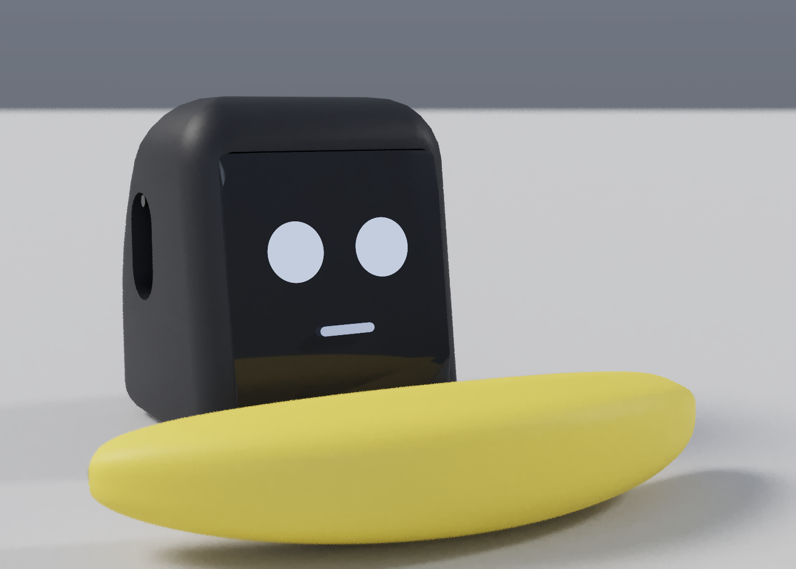
head/renders/print/j-banana.png
