muni-works/rose/head/renders/print/j-clear1.png

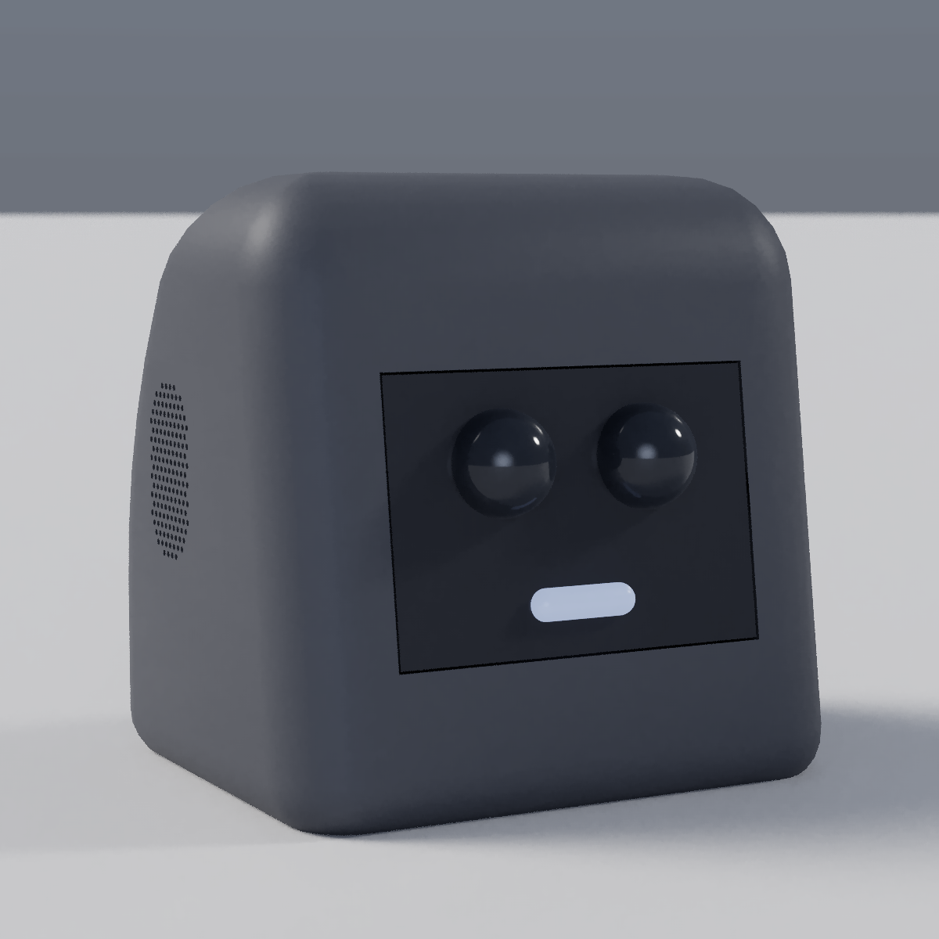
head/renders/print/j-clear1.png
