muni-works/rose/head/renders/print/j-full7.png

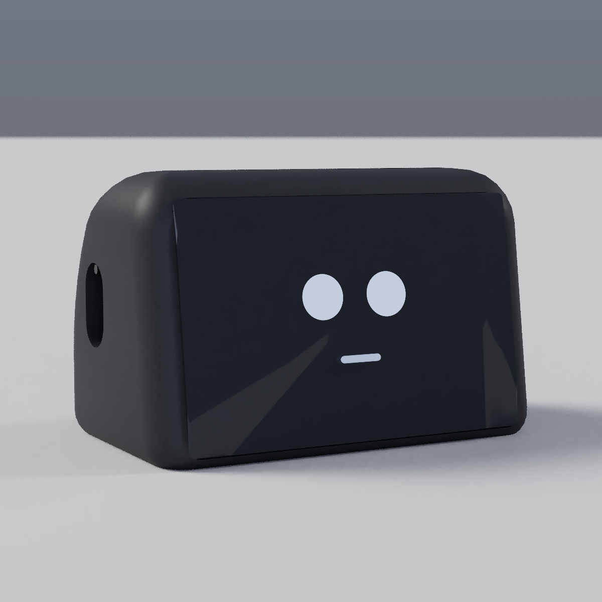
head/renders/print/j-full7.png
