muni-works/rose/head/renders/print/j-head2.png

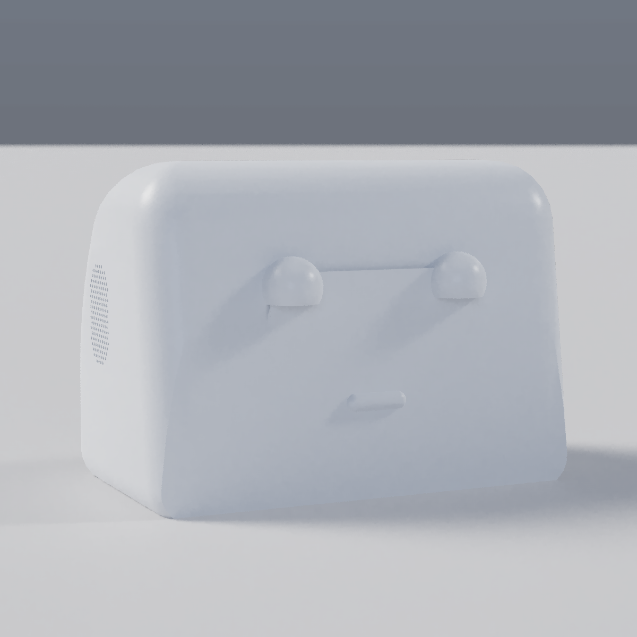
head/renders/print/j-head2.png
