muni-works/rose/head/renders/print/j-head4.png

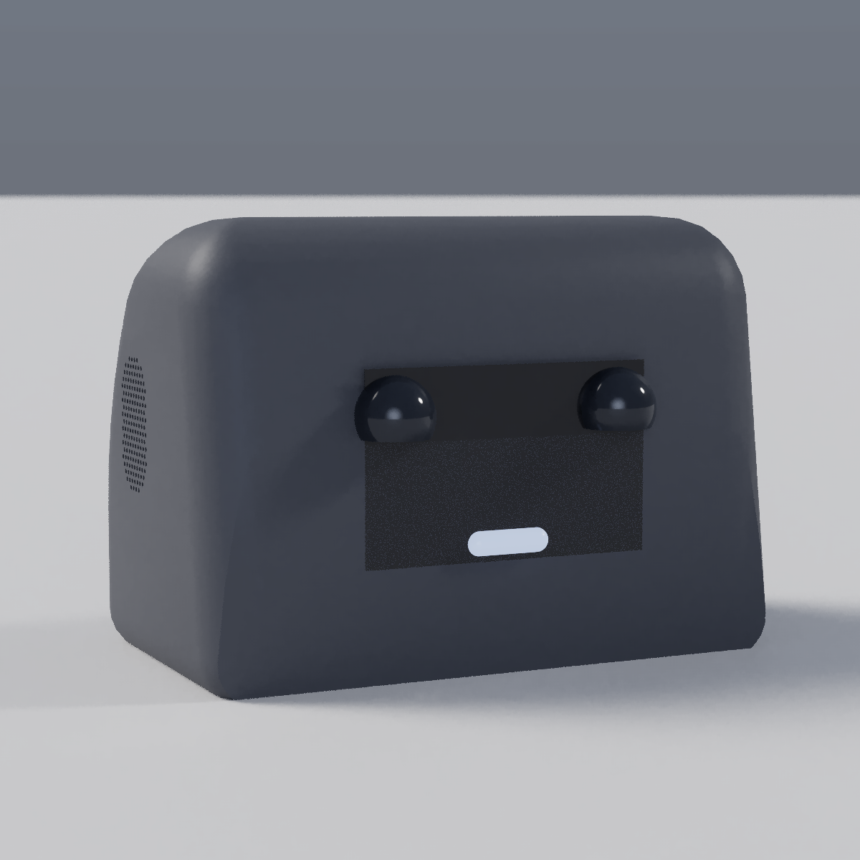
head/renders/print/j-head4.png
