muni-works/rose/head/renders/print/j-head6.png

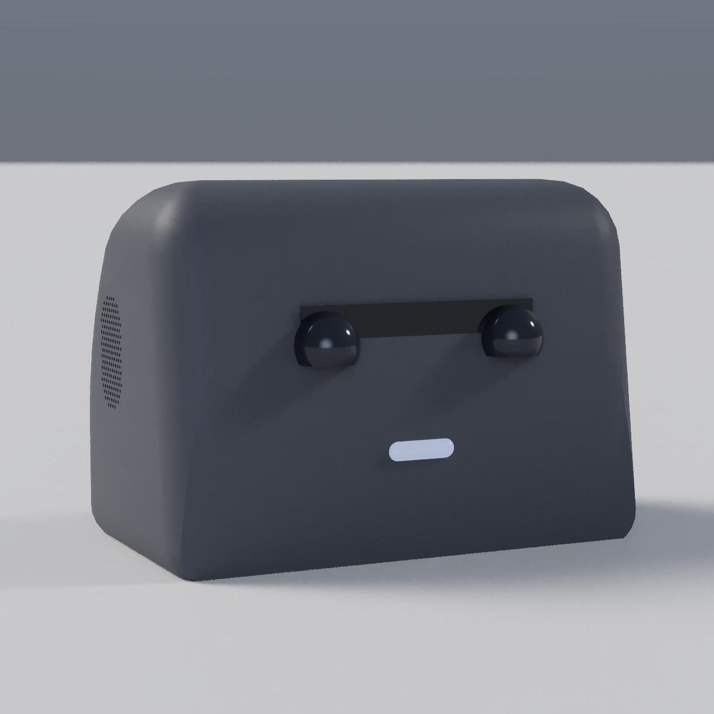
head/renders/print/j-head6.png
