muni-works/rose/head/renders/print/j-head7.png

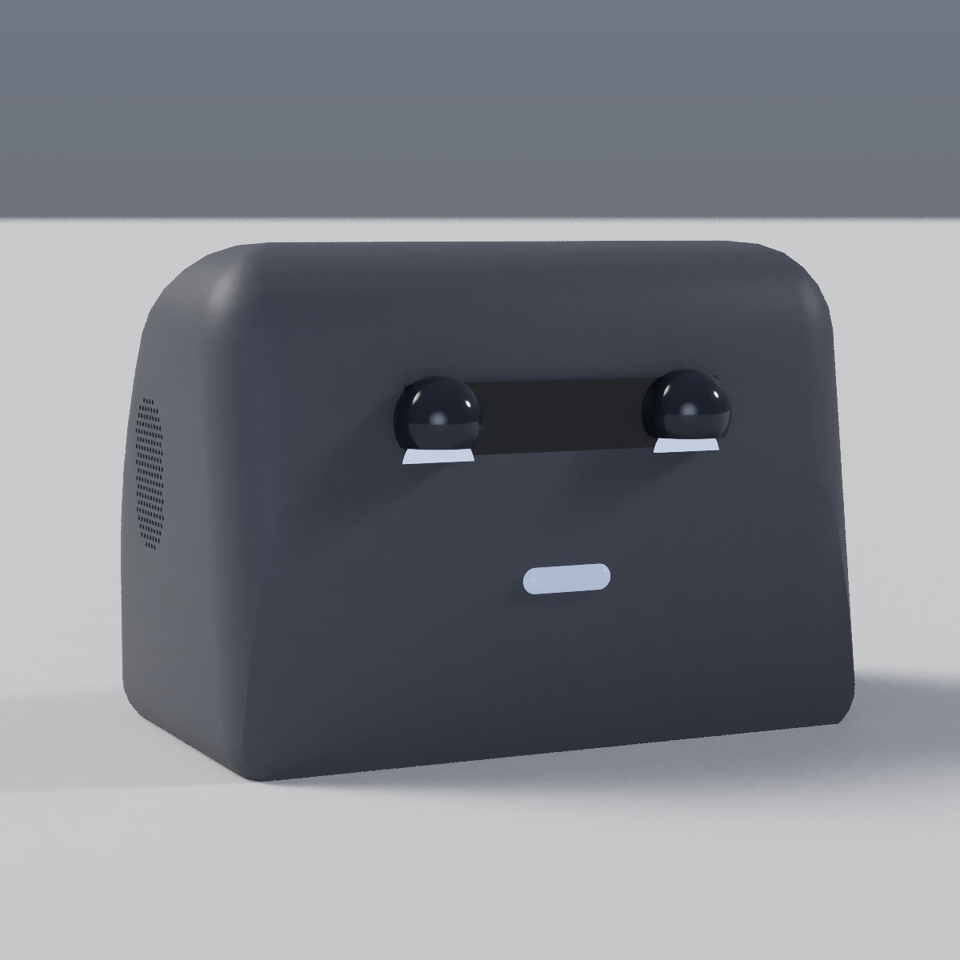
head/renders/print/j-head7.png
