muni-works/rose/head/renders/print/j-head10.png

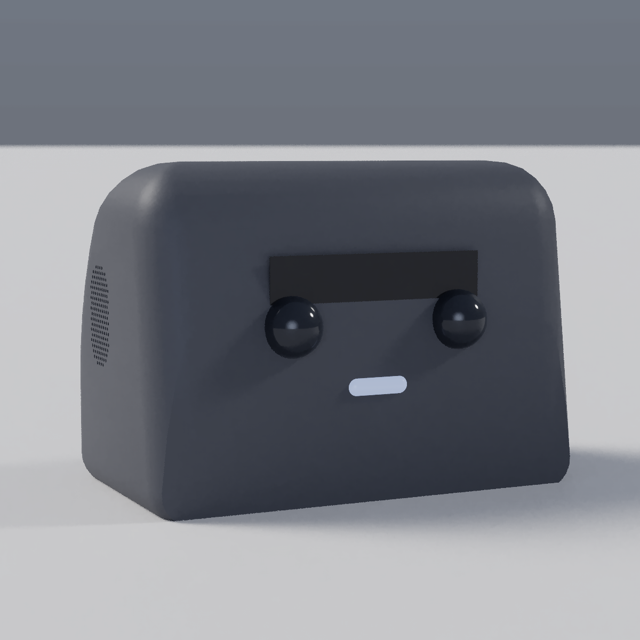
head/renders/print/j-head10.png
