muni-works/rose/head/renders/print/j-head.png

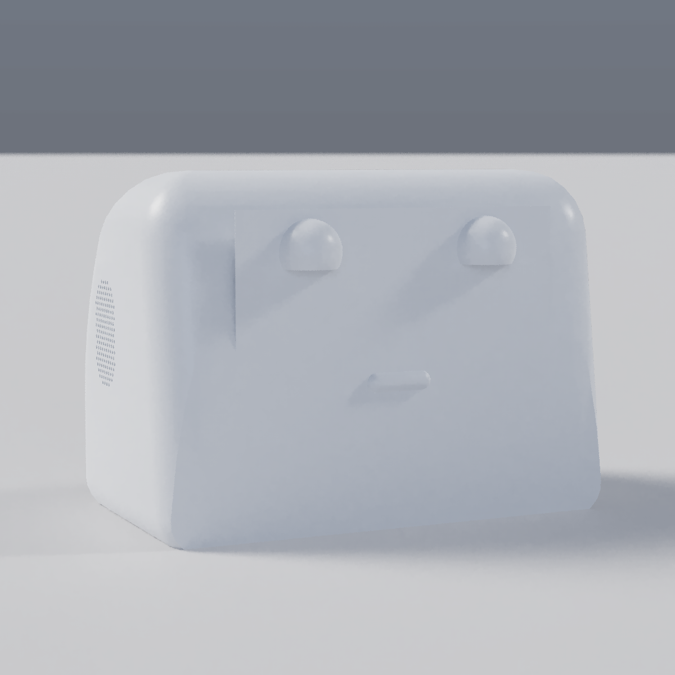
head/renders/print/j-head.png
