muni-works/rose/head/renders/print/j-k1.png

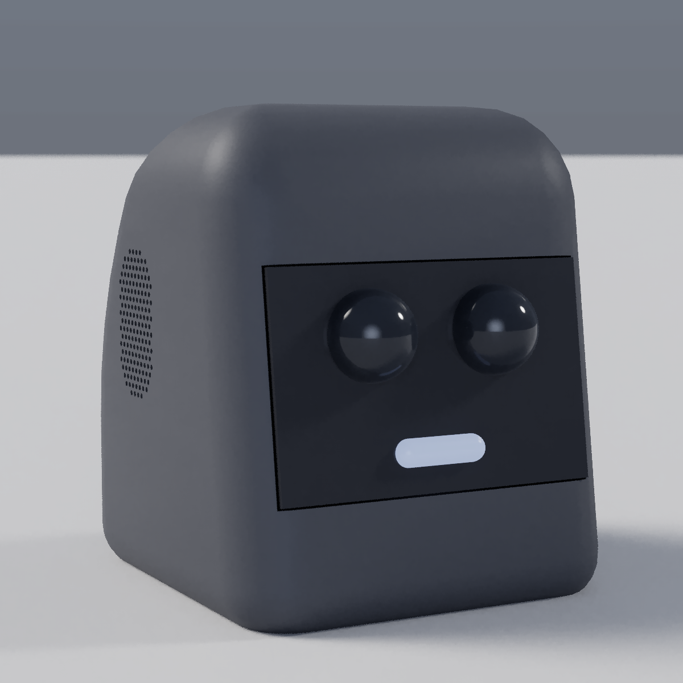
head/renders/print/j-k1.png
