muni-works/rose/head/renders/print/j-lean2.png

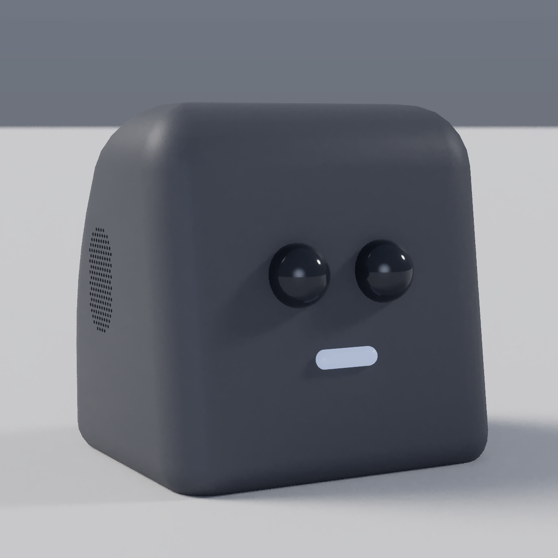
head/renders/print/j-lean2.png
