muni-works/rose/head/renders/print/j-lean.png

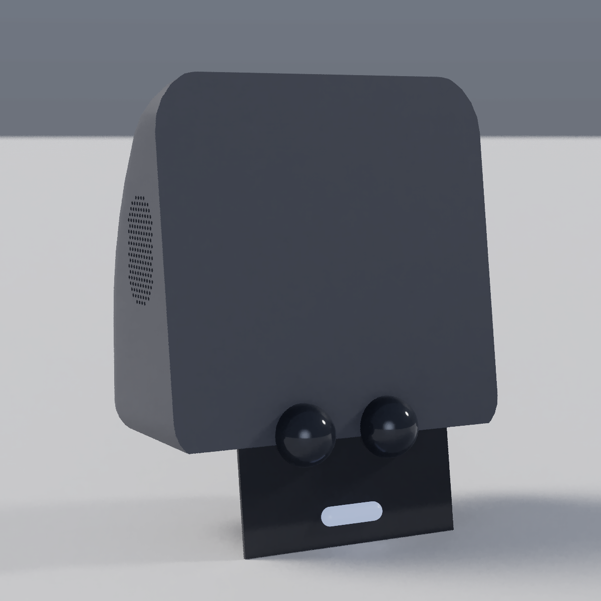
head/renders/print/j-lean.png
