muni-works/rose/head/renders/print/j-narrow.png

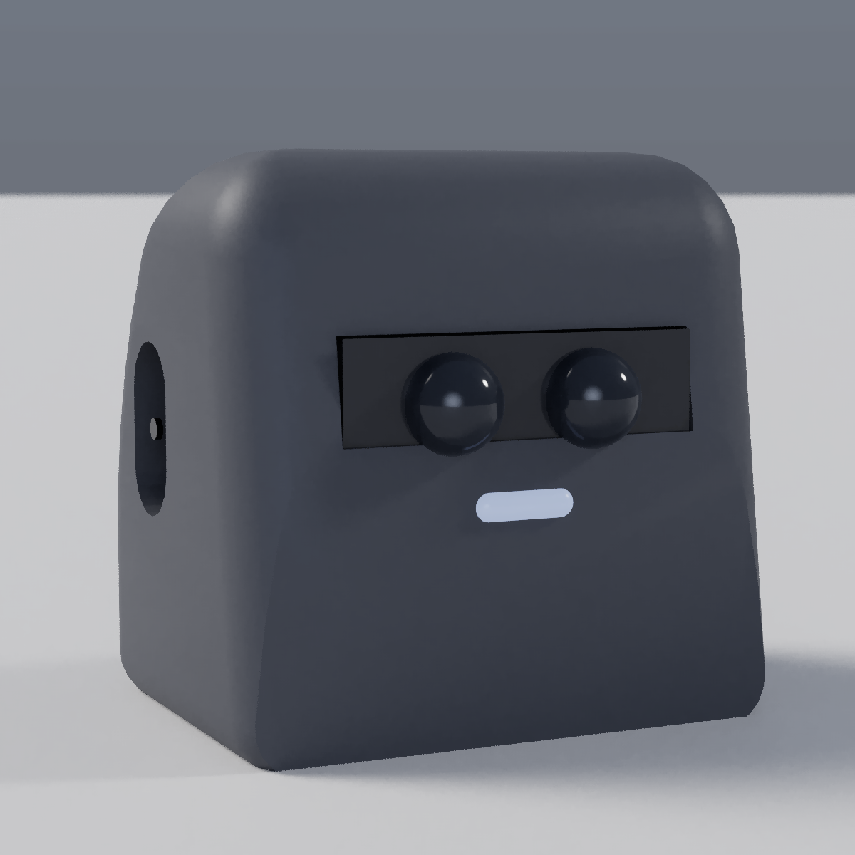
head/renders/print/j-narrow.png
