muni-works/rose/head/renders/print/j-vert.png

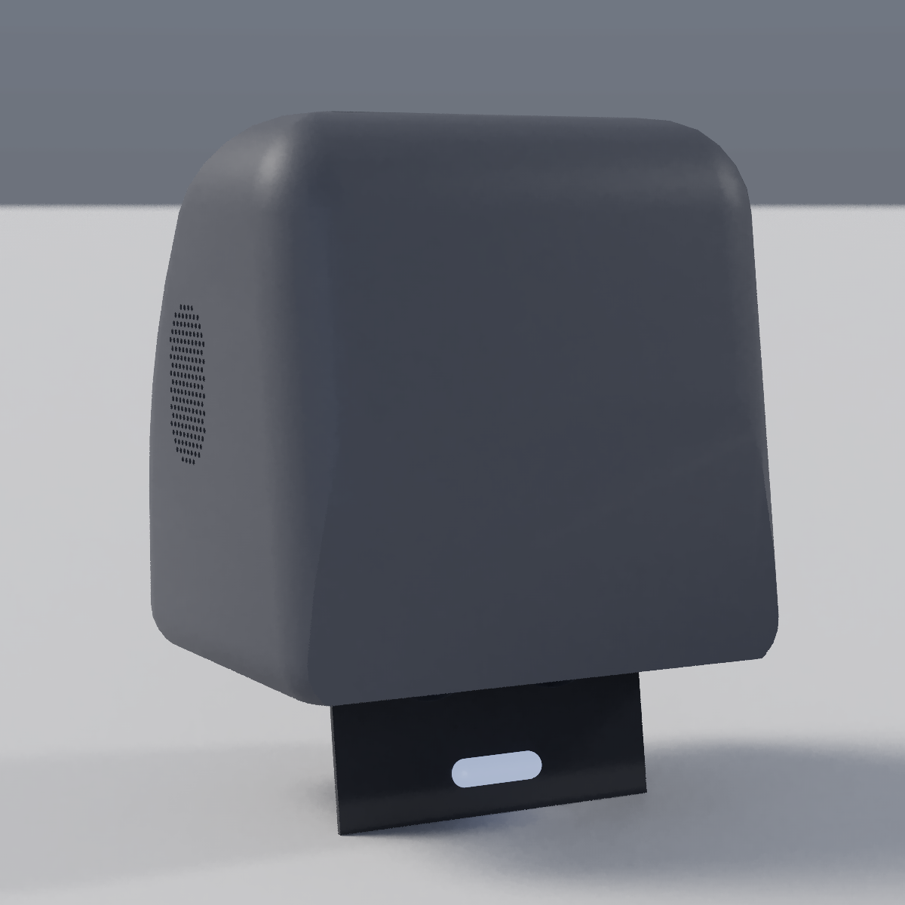
head/renders/print/j-vert.png
