muni-works/rose/head/renders/print/jd-m34R.png

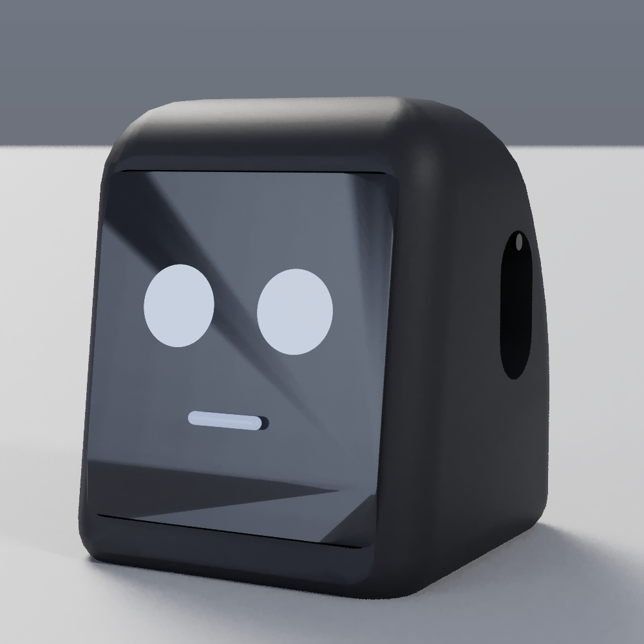
head/renders/print/jd-m34R.png
