muni-works/rose/head/renders/print/je-earR.png

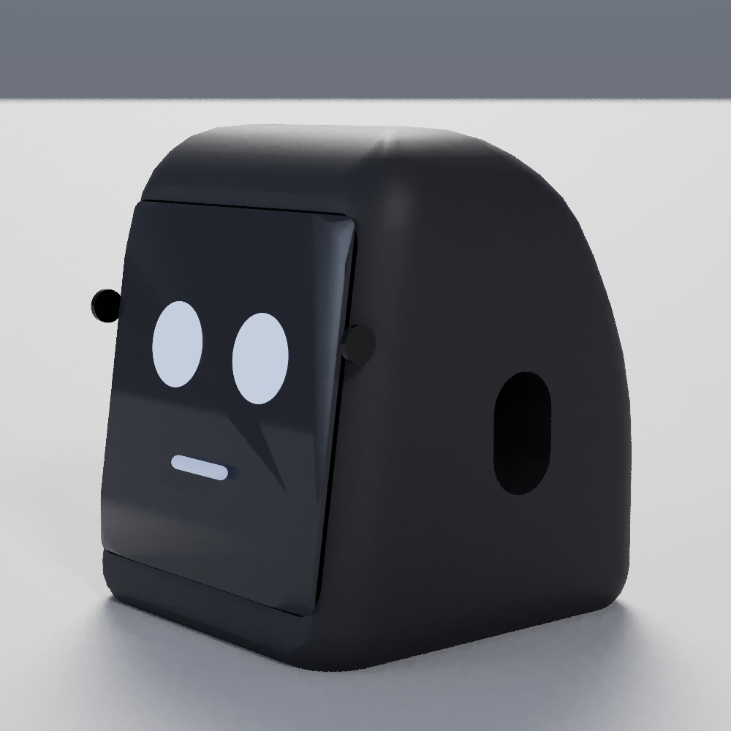
head/renders/print/je-earR.png
