muni-works/rose/head/renders/print/jg-front.png

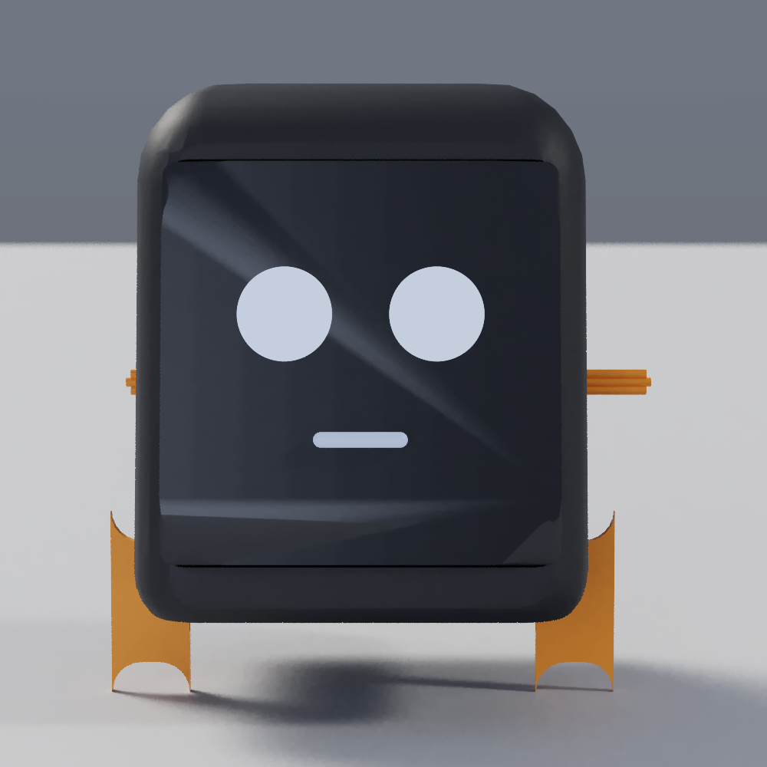
head/renders/print/jg-front.png
