muni-works/rose/head/renders/print/jm-ahero.png

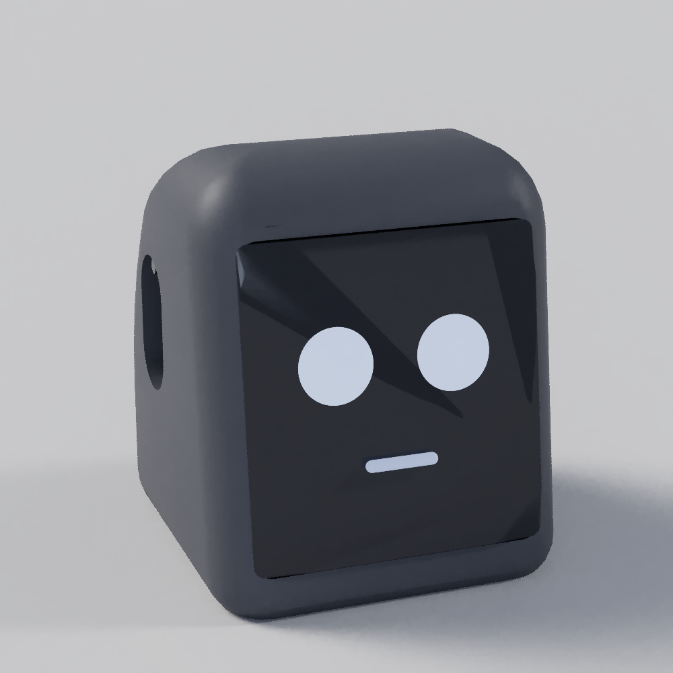
head/renders/print/jm-ahero.png
