muni-works/rose/head/renders/print/sled-on-floor.png

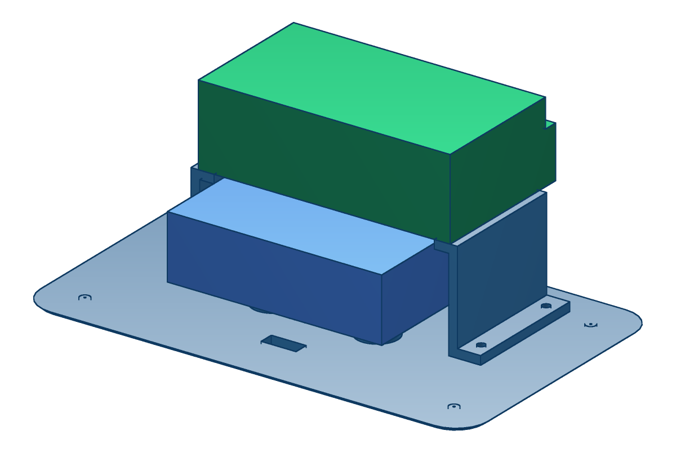
head/renders/print/sled-on-floor.png
