muni-works/rose/head/renders/print/sled-print.png

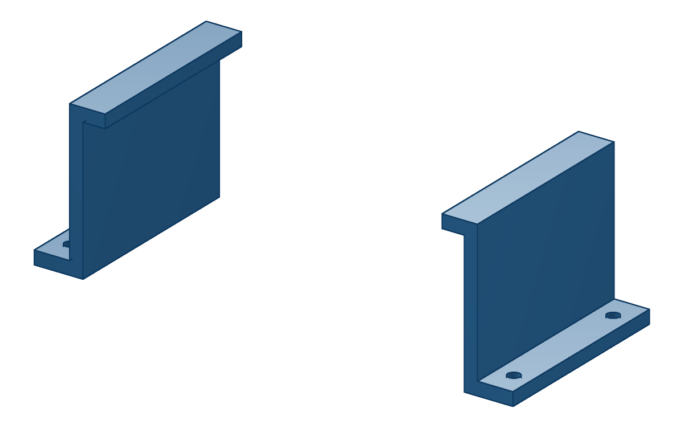
head/renders/print/sled-print.png
