muni-works/rose/head/renders/print/tub-inside.png

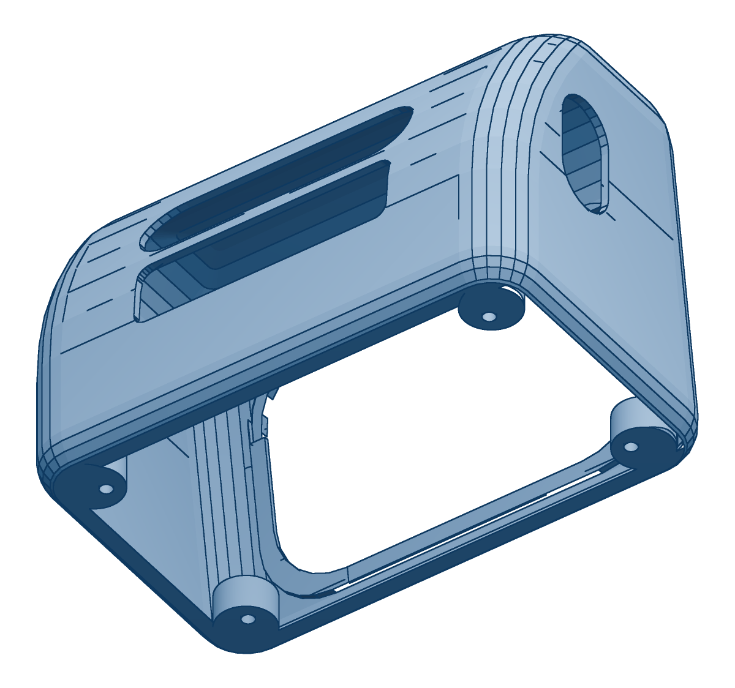
head/renders/print/tub-inside.png
