muni-works/rose/head/renders/print/tub.png

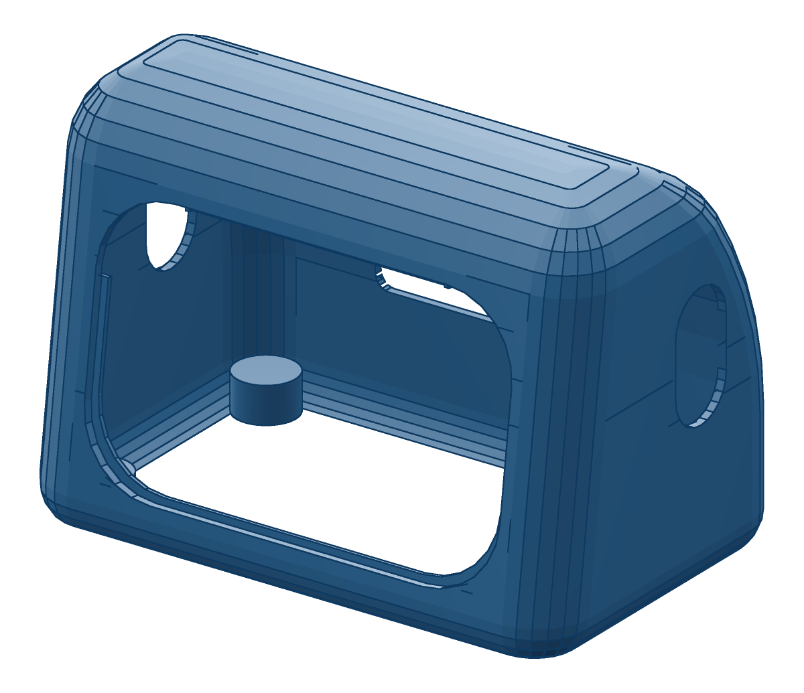
head/renders/print/tub.png
