muni-works/rose/arm/build/measure/poses.csv

pose | seat | x | y | z | pitch | J1_yaw | J2_sho_pitch | J3_upper_roll | J4_elbow | J6_wrist_pitch | J7_tool_roll
1 | 1 | 0.16 | -0.14 | -0.04375735931288072 | 75 | -41.186 | -60.647 | 0.0 | 103.605 | 62.072 | 90
2 | 1 | 0.16 | -0.14 | -0.04375735931288072 | 60 | -41.186 | -45.754 | 0.0 | 82.951 | 82.845 | 180
3 | 1 | 0.16 | -0.14 | -0.04375735931288072 | 45 | -41.186 | -29.473 | 0.0 | 60.419 | 104.006 | -90
4 | 1 | 0.16 | -0.14 | -0.04375735931288072 | 80 | -41.186 | -65.269 | 0.0 | 110.259 | 55.05 | 0
5 | 1 | 0.16 | -0.14 | -0.04375735931288072 | 80 | -41.186 | -65.269 | 0.0 | 110.259 | 55.05 | 90
6 | 2 | 0.22 | -0.16 | -0.04375735931288072 | 90 | -36.027 | -65.238 | 0.0 | 108.315 | 46.875 | 0
7 | 2 | 0.22 | -0.16 | -0.04375735931288072 | 75 | -36.027 | -51.672 | 0.0 | 85.098 | 71.623 | 90
8 | 2 | 0.22 | -0.16 | -0.04375735931288072 | 60 | -36.027 | -35.486 | 0.0 | 59.05 | 96.395 | 180
9 | 2 | 0.22 | -0.16 | -0.04375735931288072 | 80 | -36.027 | -56.475 | 0.0 | 92.993 | 63.53 | 0
10 | 2 | 0.22 | -0.16 | -0.04375735931288072 | 80 | -36.027 | -56.475 | 0.0 | 92.993 | 63.53 | 90
11 | 3 | 0.18 | 0.0 | -0.04375735931288072 | 75 | 0.0 | -65.269 | 0.0 | 112.697 | 57.599 | 90
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
