muni-works/rose/body/vcad/mini/pose-test.png

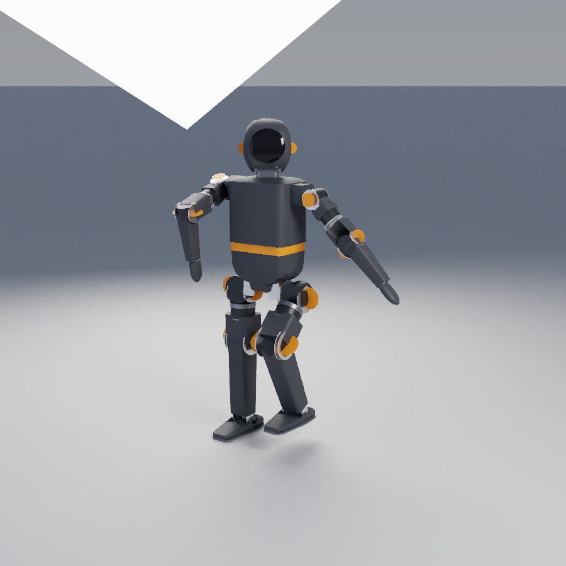
body/vcad/mini/pose-test.png
