muni-works/rose/electronics/brain/brain.pdf

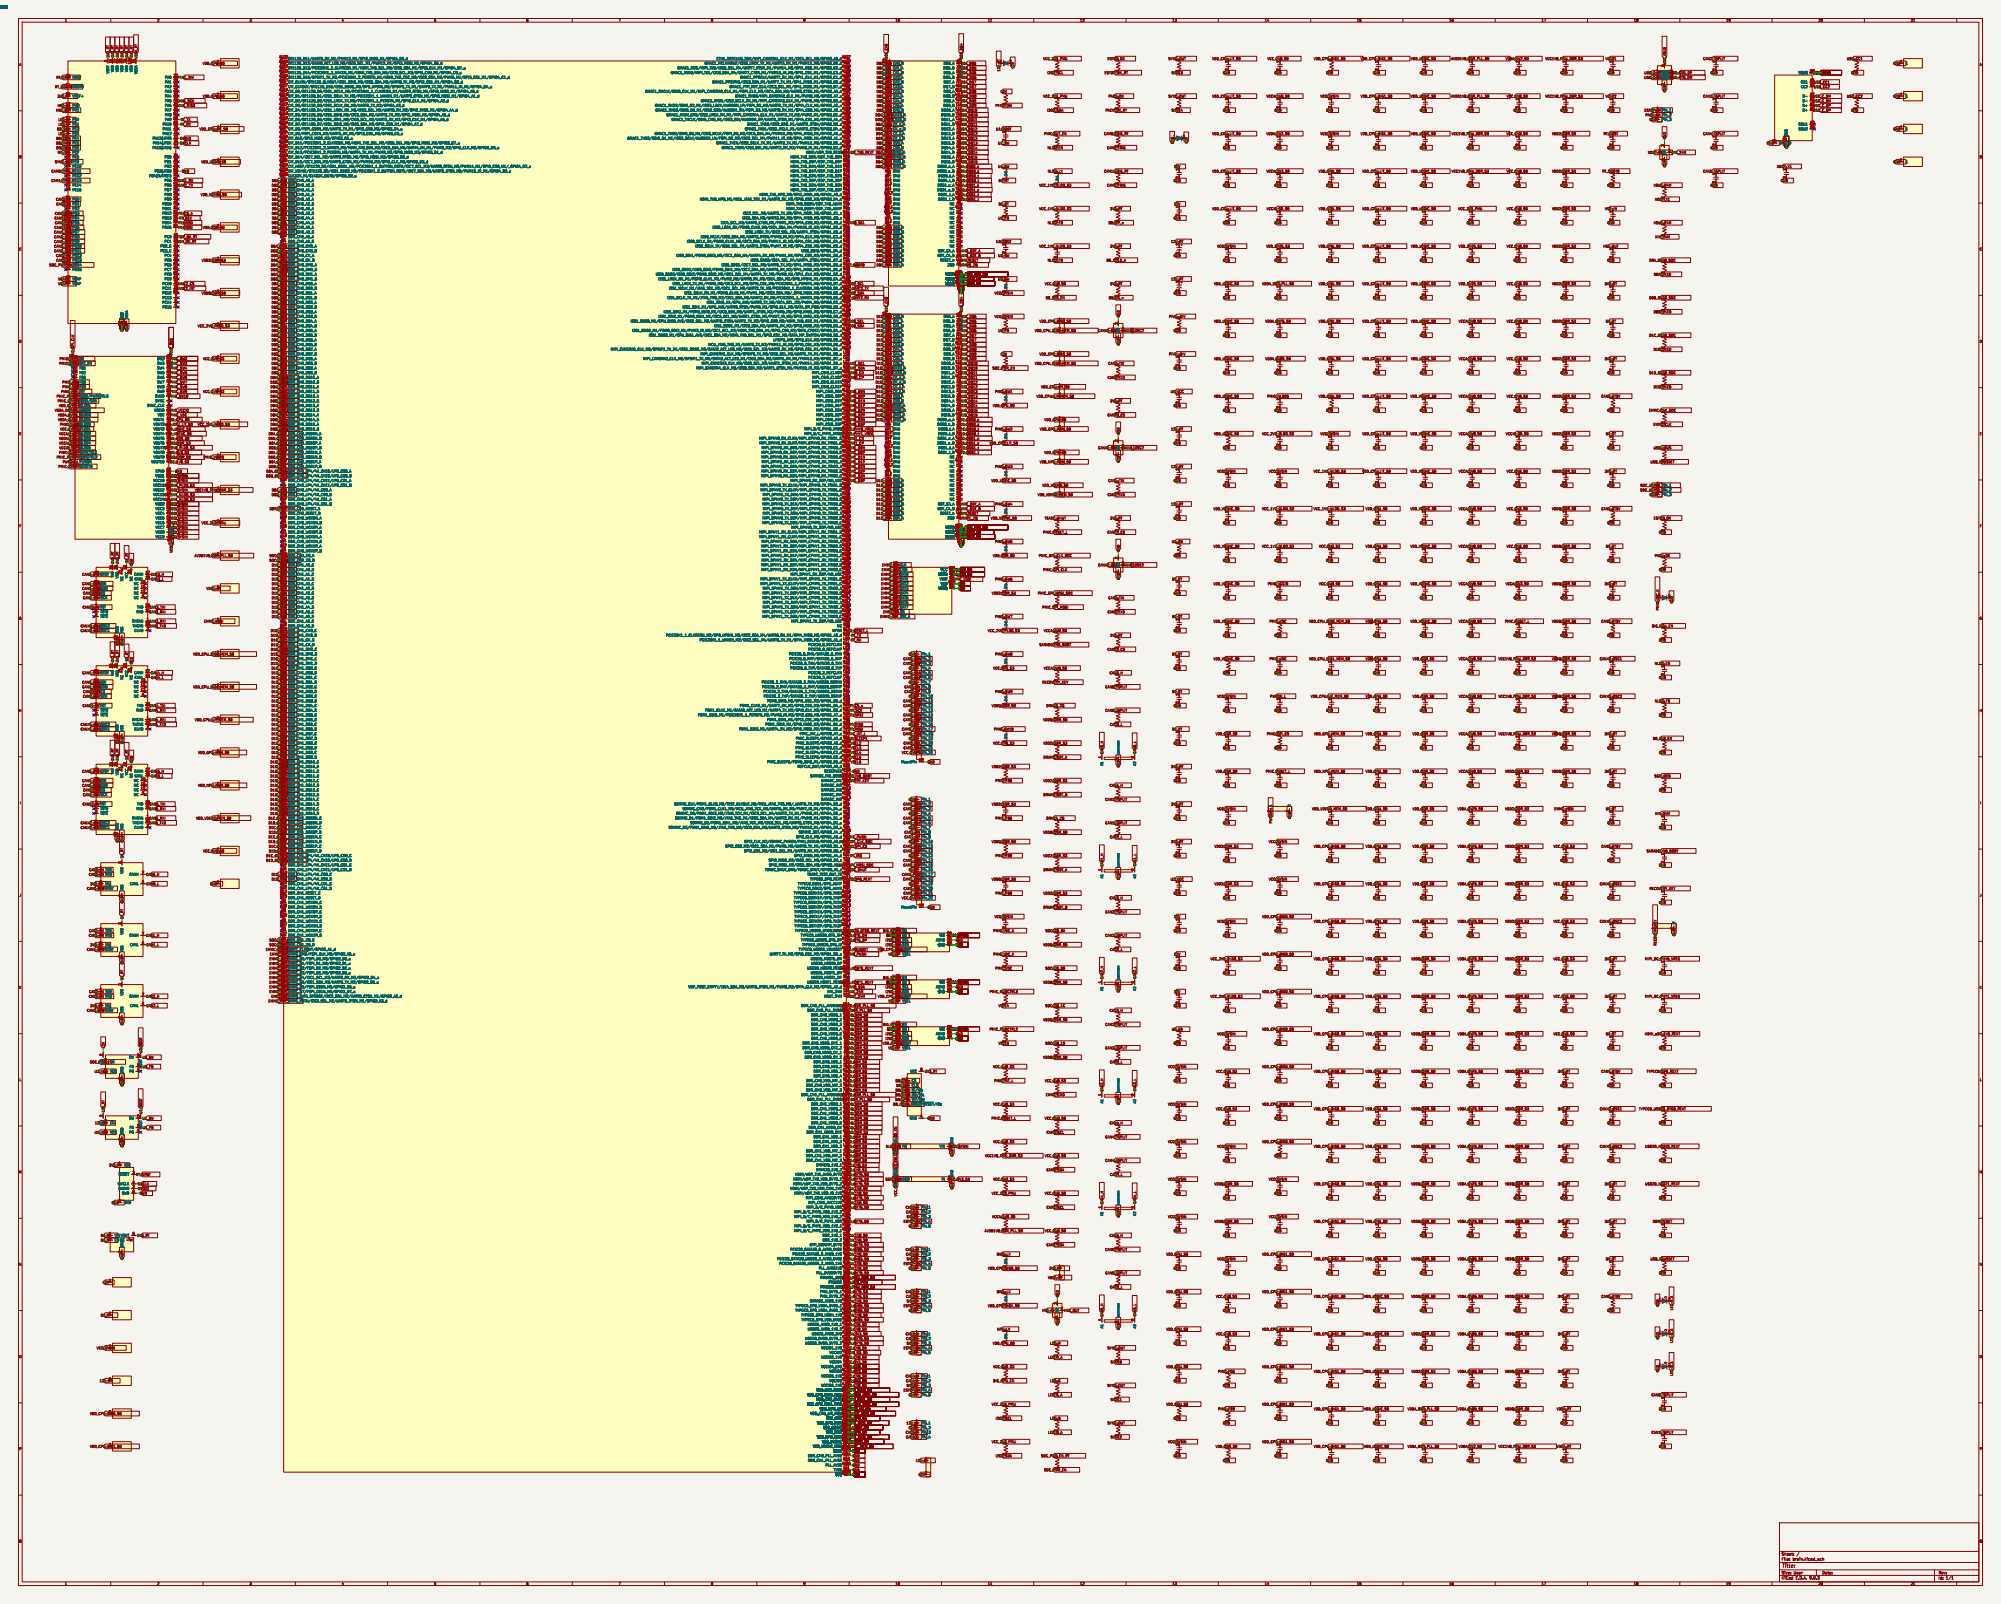
[picture p300: page 1]

J11 GH limb port: right arm (bus 1)

J13 GH limb port: right leg (bus 3)

J10 GH limb port: left arm (bus 0)

J12 GH limb port: left leg (bus 2)

J10 K9E6F5 VCCQ M4 N4 C6P35 VDDi C2 VSS H10 G5 K8E7A6J5 VSSQ

~{CS} 1 CLK 6 DI/IO_{0} 5 DO/IO_{1} 2 ~{WP}/IO_{2} 3 ~{HOLD}/~{RESET}/IO_{3} 7 VCC 8 GND 4

L20 EMMCIO_1V8_1 AB35 EMMCIO_1V8_2 AC35 HDMI/eDP_TX0_AVDD_0V75 AN10 HDMI/eDP_TX0_VDD_0V75_1 AM13 HDMI/eDP_TX0_VDD_0V75_2 AN12 HDMI/eDP_TX0_VDD_CMN_1V8 AL14 HDMI/eDP_TX0_VDD_IO_1V8 AK12 MIPI_CSI0_AVCC0V75 AM37 MIPI_CSI0_AVCC1V8 AM35 MIPI_D/C_PHY0_VDD

VCC 1 GND 5~{RESET}3 SWCLK 4 SWDIO 2 SWO 6
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
