muni-works/rose/electronics/limb-controller/arm_controller.pdf

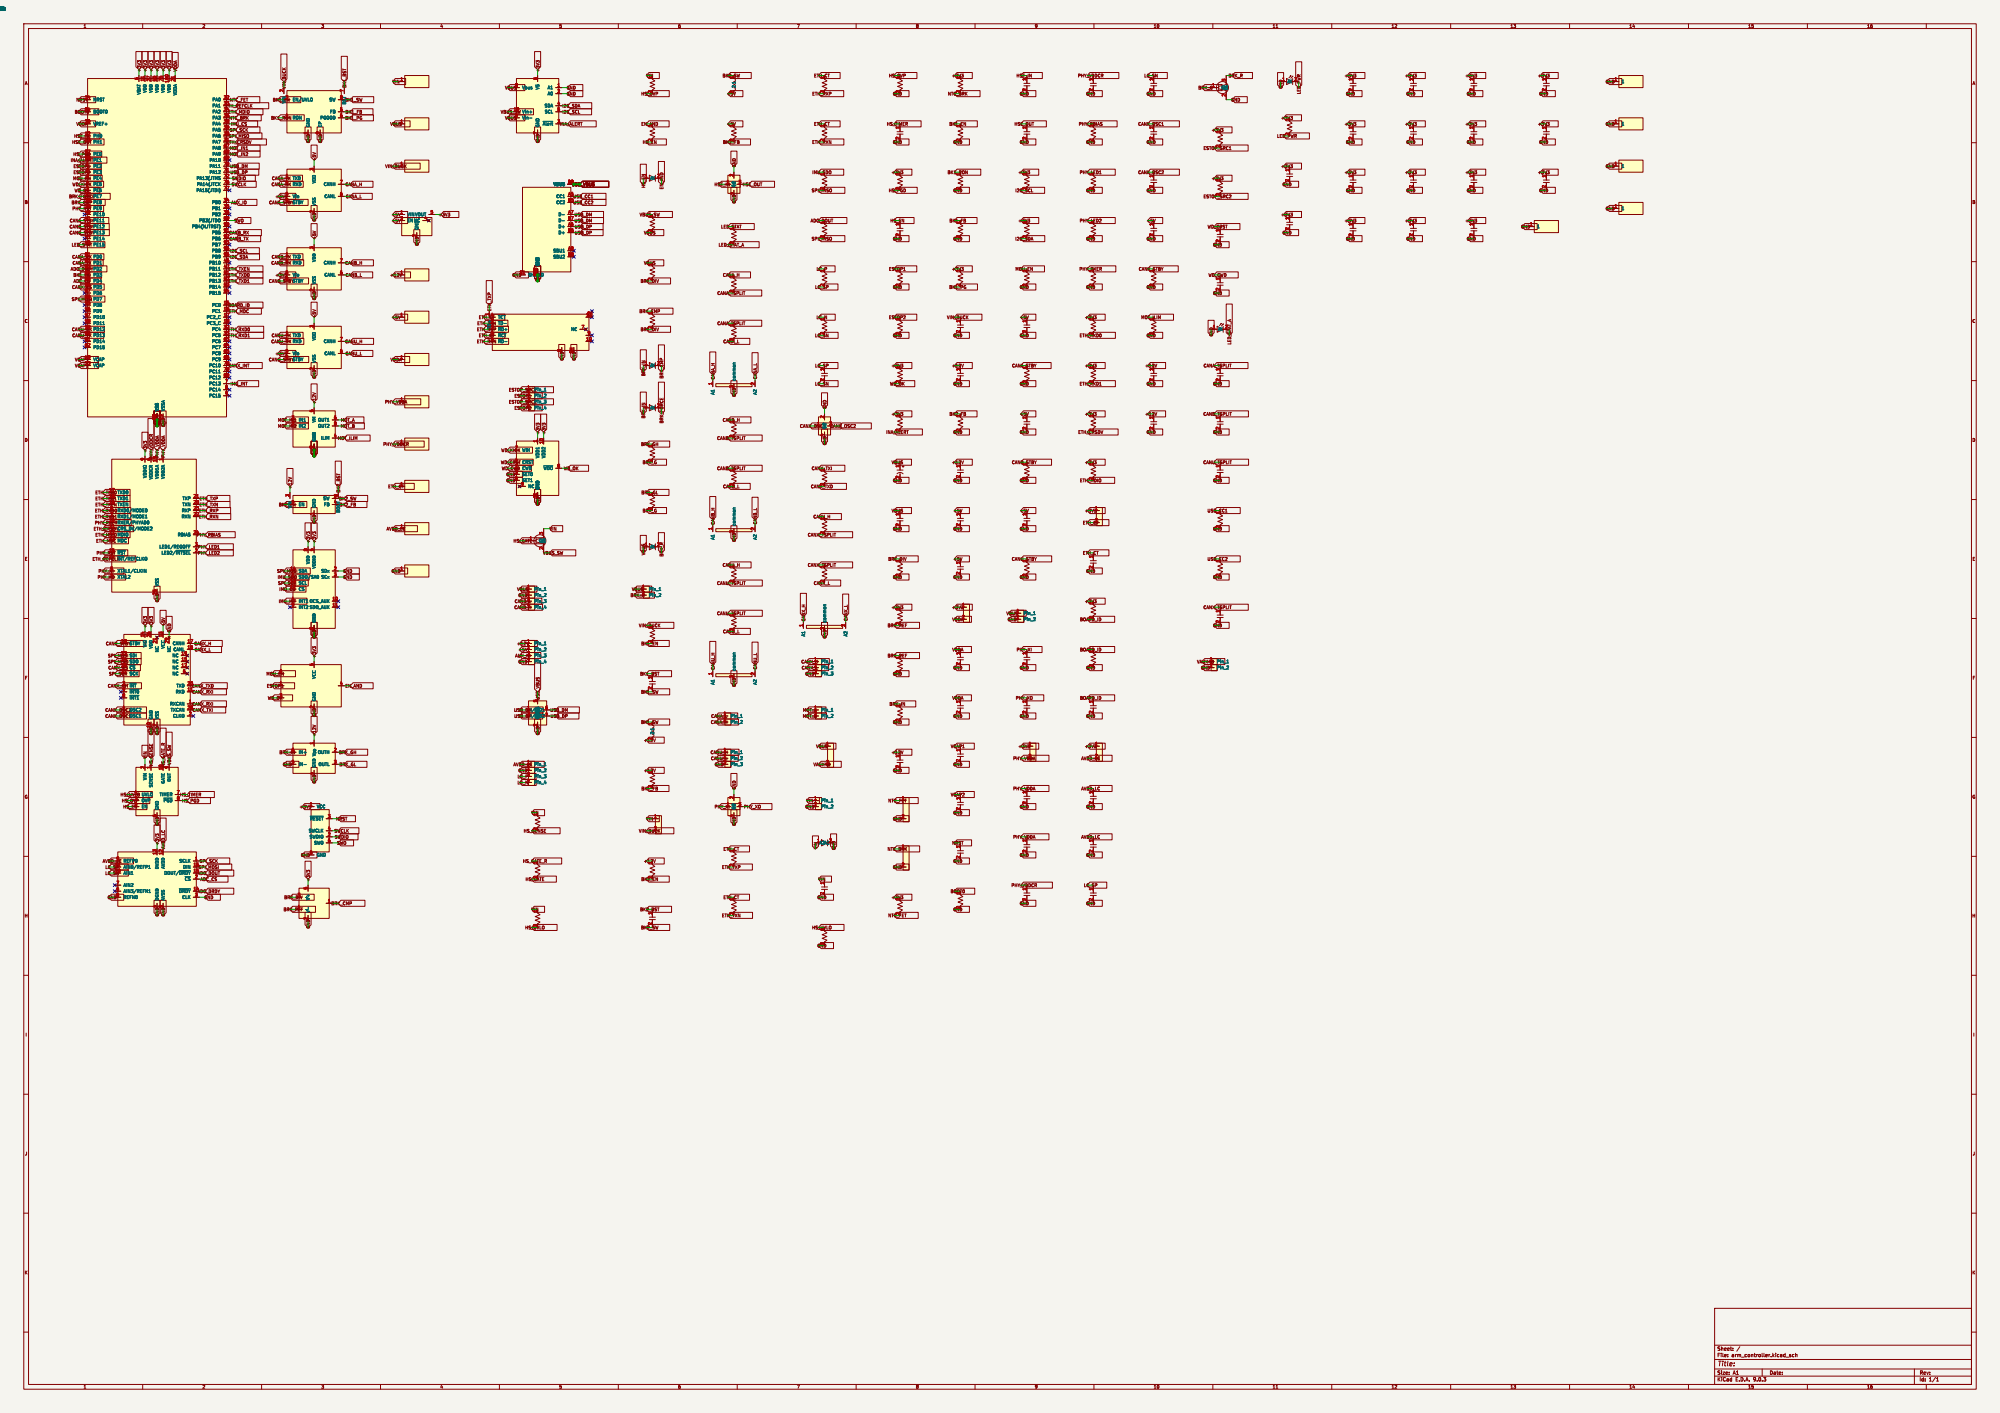
[picture p301: page 1]

J1 XT60PW-M 48V in (fuse: ATM 50A inline in the supply cable)

J15 GH CAN-FD X (second limb / tool)

J14 GH load cell EXC+/EXC-/S+/S-

J10 GH CAN-FD uplink

SDA 14 SDO/SA0 1 SCL 13 CS 12

GND
VCC 1 GND 5~{RESET}3 SWCLK 4 SWDIO 2 SWO 6

BRK_GL
