muni-works/rose/electronics/limb-controller/arm_controller.kicad_pcb

## KiCad design electronics/limb-controller/arm_controller.kicad_pcb (2026-10-16)

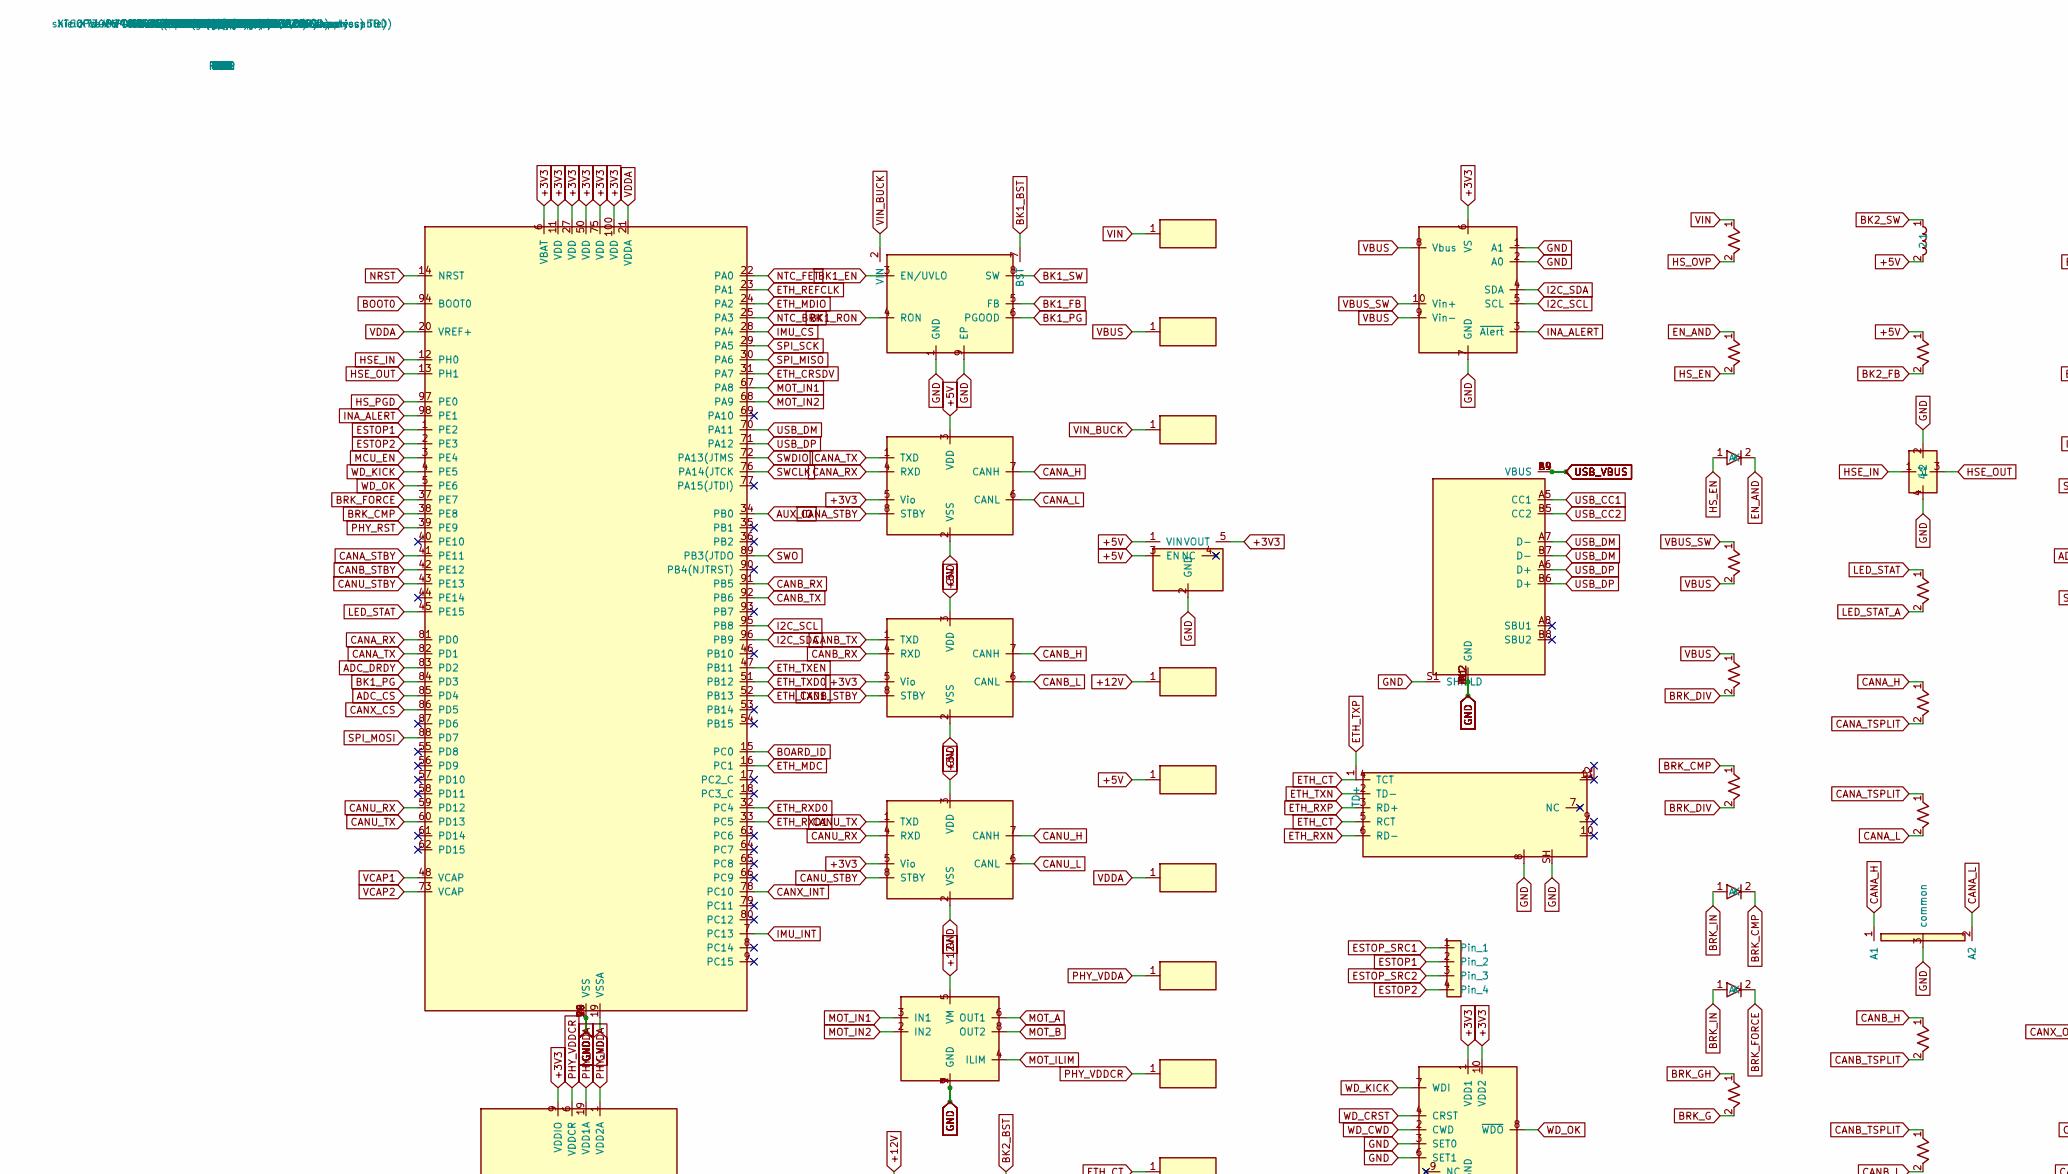
[picture p302: schematic arm_controller.kicad_sch, part in row 1, column 1]

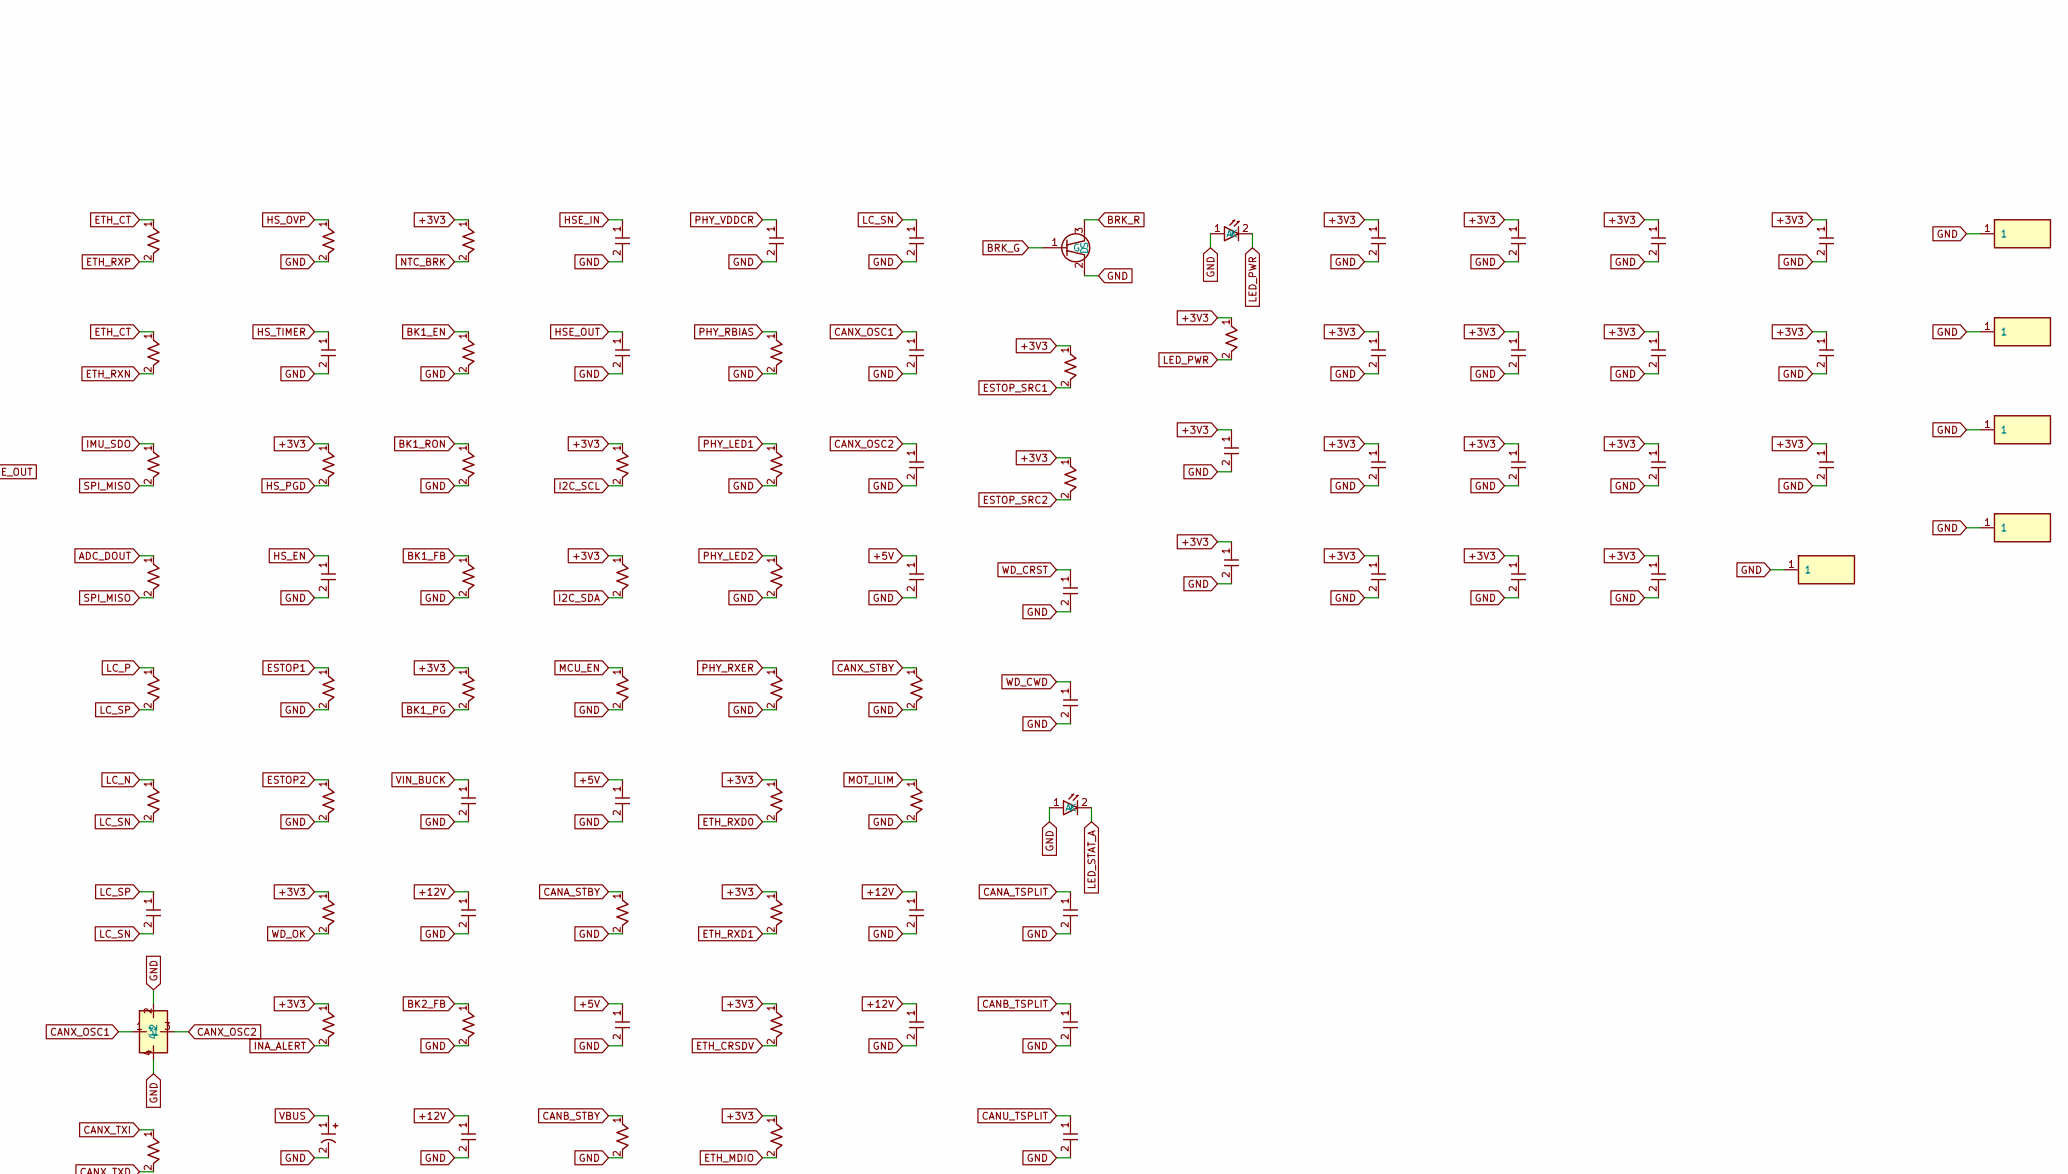
[picture p303: schematic arm_controller.kicad_sch, part in row 1, column 2]

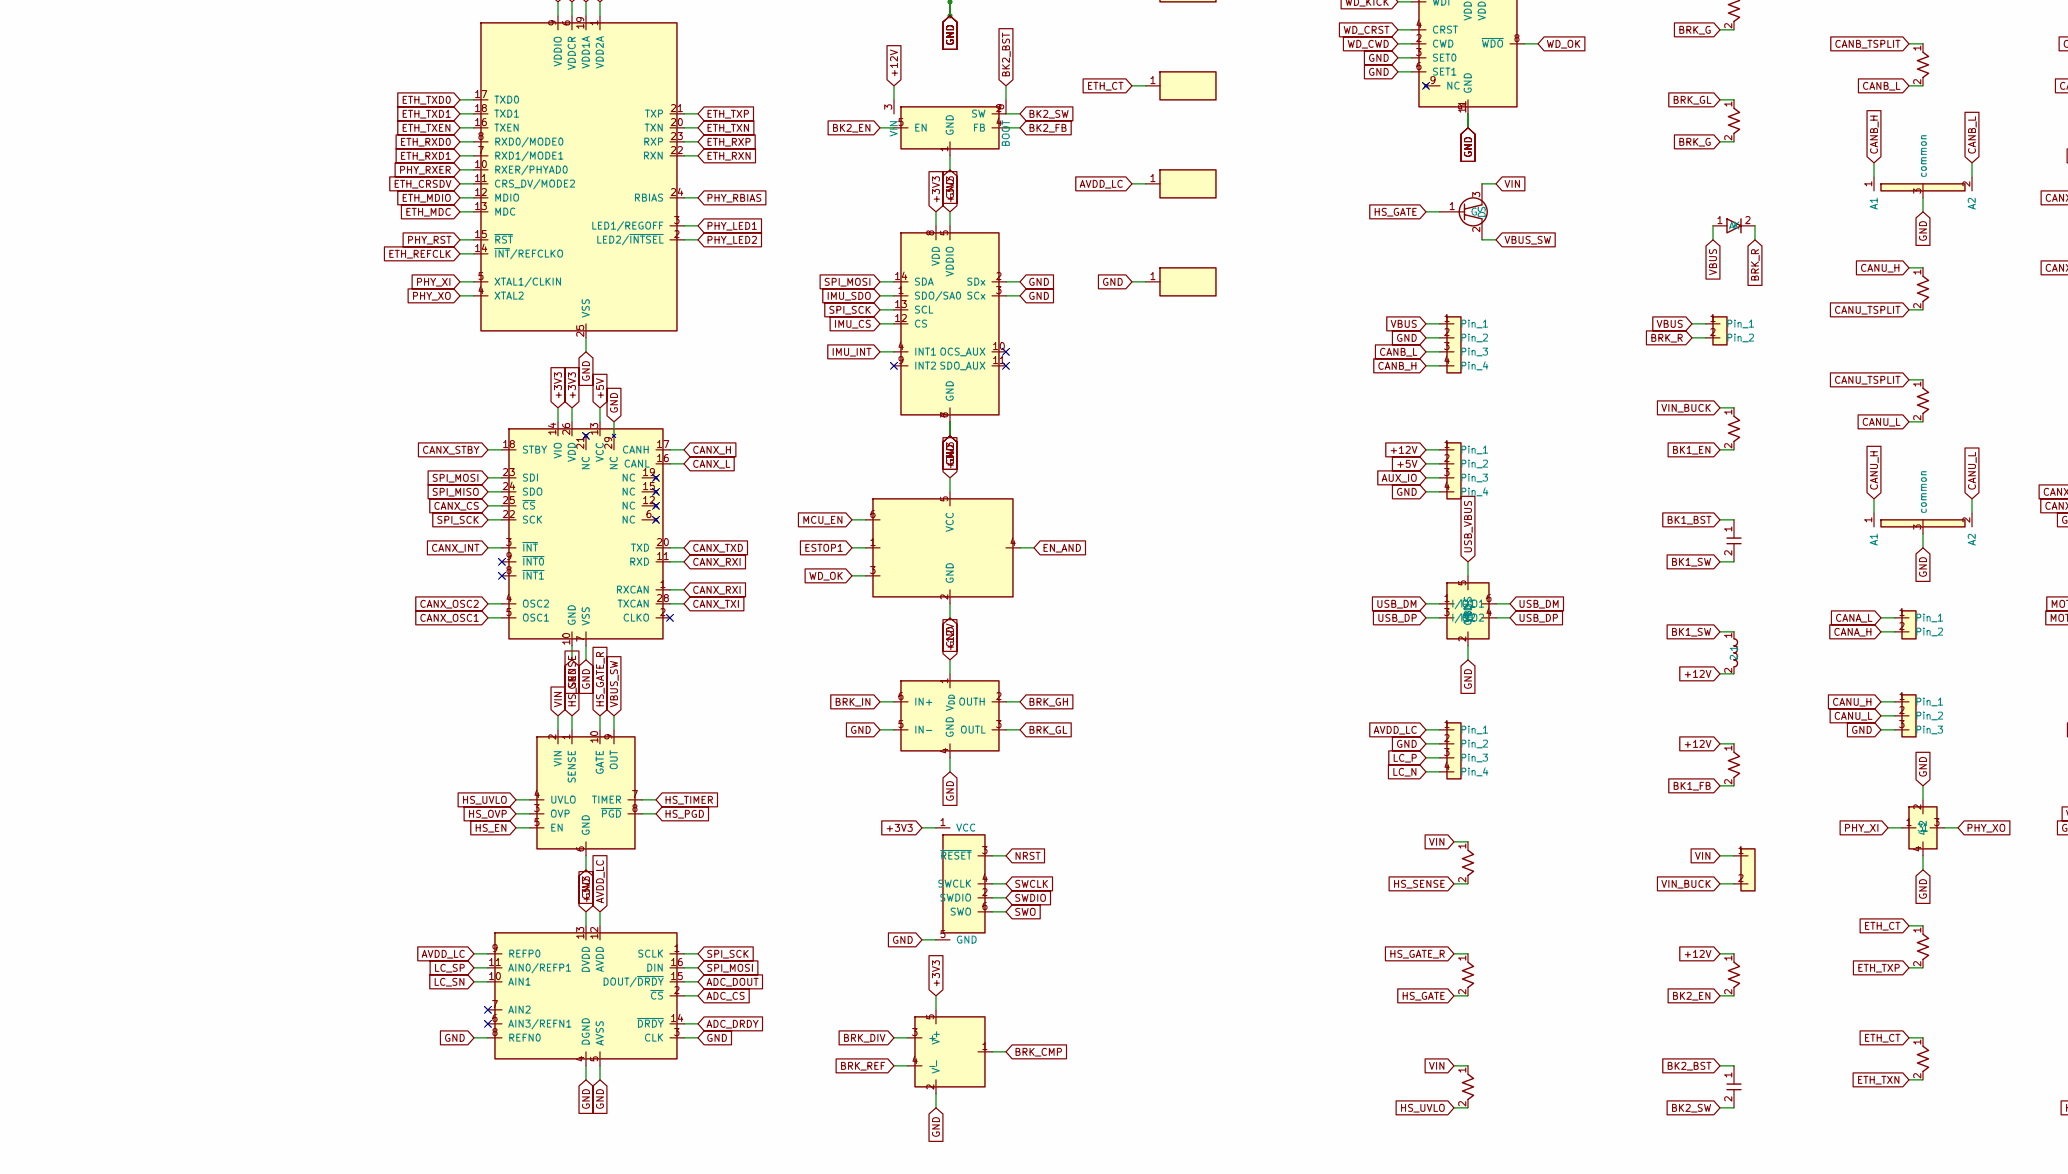
[picture p304: schematic arm_controller.kicad_sch, part in row 2, column 1]

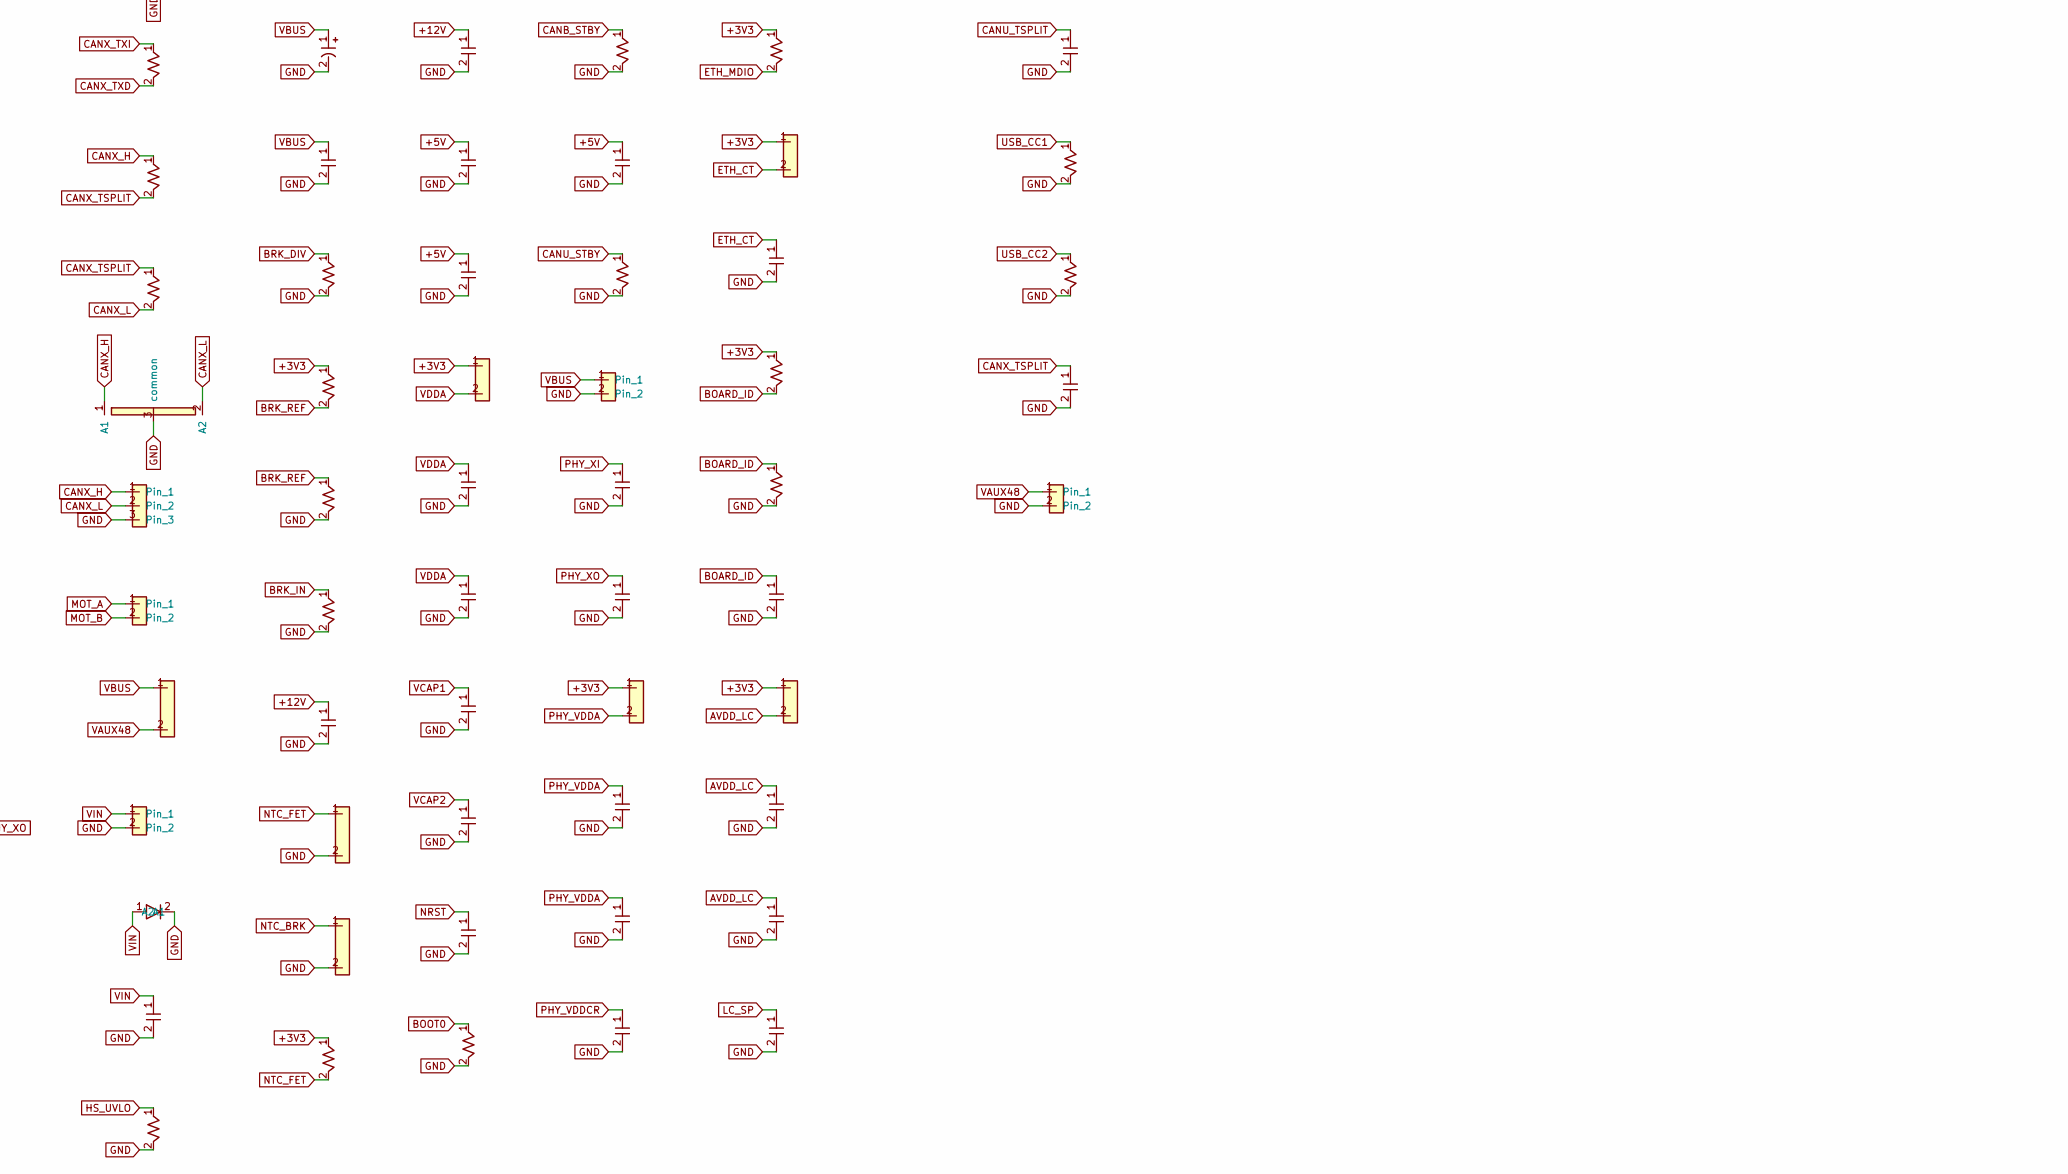
[picture p305: schematic arm_controller.kicad_sch, part in row 2, column 2]

Parts:
C1, C8, C11: 2.2u 100V; C_1210_3225Metric
C2, C6, C13, C18, C19, C20, C21, C22, C25, C28, C31, C32, C33, C34, C35, C36, C43, C46, C47, C48, C49, C50, C52, C53, C59, C60, C61, C64: 100n; C_0402_1005Metric
C3: 390n; C_0402_1005Metric
C4, C5, C54: 10n; C_0402_1005Metric
C7: 220u 100V; CP_Radial_D12.5mm_P5.00mm
C9, C16, C24, C42, C44, C51: 1u; C_0402_1005Metric
C10: 2.2n; C_0402_1005Metric
C12: 22u 25V; C_0805_2012Metric
C14: 10u 25V; C_0805_2012Metric
C15: 22u; C_0805_2012Metric
C17: 10u; C_0805_2012Metric
C23: 4.7u; C_0805_2012Metric
C26, C27: 2.2u; C_0402_1005Metric
C29, C30, C40, C41: 10p; C_0402_1005Metric
C37, C38, C39, C62: 4.7n; C_0402_1005Metric
C45: 470p; C_0402_1005Metric
C55, C56: 1n; C_0402_1005Metric
C57, C58: 12p; C_0402_1005Metric
C63: 10u 25V; C_1210_3225Metric
D1: SMDJ60A; D_SMC
D2, D3, D10: BAT54; D_SOD-123
D4: STPS10H100 100V; D_SMC
D5: green 3V3; LED_0603_1608Metric
D6: blue status; LED_0603_1608Metric
D7, D8, D9, D11: PESD2CAN; SOT-23
F1: PTC 60V 1.1A hold (Bel 0ZCF0110AF2A); Fuse_2920_7451Metric
FB1, FB2, FB3, FB5: 600R@100MHz; L_0603_1608Metric
FB4: BLM31KN601SN1 (1206, 100 V); L_1206_3216Metric
H1, H2, H3, H4: M3; MountingHole_3.2mm_M3_Pad_Via
J1: XT60PW-M 48V in (fuse: ATM 50A inline in the supp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; AMASS_XT60PW-M_1x02_P7.20mm_Horizontal
J2: E-stop, 2-ch NC; JST_GH_SM04B-GHS-TB_1x04-1MP_P1.25mm_Horizontal
J3: XT30PW-M brake resistor 3R3 200W; AMASS_XT30PW-M_1x02_P2.50mm_Horizontal
J4: TC2030 SWD; Tag-Connect_TC2030-IDC-NL_2x03_P1.27mm_Vertical
J5: XT30PW-M RS04 power (3-way split in the harness); AMASS_XT30PW-M_1x02_P2.50mm_Horizontal
J8: GH1.25 RS04 CAN; JST_GH_SM02B-GHS-TB_1x02-1MP_P1.25mm_Horizontal
J9: XT30PB(2+2)-M wrist bus; AMASS_XT30PB_2+2_M
J10: GH CAN-FD uplink; JST_GH_SM03B-GHS-TB_1x03-1MP_P1.25mm_Horizontal
J11: GH aux 12V/5V/IO; JST_GH_SM04B-GHS-TB_1x04-1MP_P1.25mm_Horizontal
J12: USB-C; USB_C_Receptacle_GCT_USB4105-xx-A_16P_TopMnt_Horizontal
J13: HR911105A; RJ45_Hanrun_HR911105A_Horizontal
J14: GH load cell EXC+/EXC-/S+/S-; JST_GH_SM04B-GHS-TB_1x04-1MP_P1.25mm_Horizontal
J15: GH CAN-FD X (second limb / tool); JST_GH_SM03B-GHS-TB_1x03-1MP_P1.25mm_Horizontal
J16: GH brushed motor; JST_GH_SM02B-GHS-TB_1x02-1MP_P1.25mm_Horizontal
J17: XT30PW-M 48 V aux out; AMASS_XT30PW-M_1x02_P2.50mm_Horizontal
L1: 22u 1.5A; L_Bourns_SRN6045TA
L2: 4.7u 3A; L_Bourns_SRN6045TA
PF1, PF2, PF3, PF4, PF5, PF6, PF8, PF9, PF10, PF11, PF12: PWR_FLAG
Q1, Q2: IPT015N10N5 100V 1.5mR; Infineon_PG-HSOF-8-1
R1: 20k; R_0402_1005Metric
R2: 10; R_0402_1005Metric
R3: 220k; R_0603_1608Metric
R4, R6, R7, R10, R12, R13, R15, R18, R19, R24, R25, R27, R36, R41, R45, R49, R56, R57, R58, R59, R60, R61, R67, R71: 10k; R_0402_1005Metric
R5: 330k; R_0603_1608Metric
R8: 1M; R_0402_1005Metric
R9, R11, R35, R40, R69, R70: 1k; R_0402_1005Metric
R14: 0.5m 4-term; R_2512_6332Metric
R16: 301k; R_0603_1608Metric
R17: 9.09k; R_0402_1005Metric
R20: 665k; R_0402_1005Metric
R21, R26, R29, R31, R32, R33, R39: 100k; R_0402_1005Metric
R22: 4.7; R_0402_1005Metric
R23: 2.2; R_0402_1005Metric
R28: 150k; R_0402_1005Metric
R30: 11k; R_0402_1005Metric
R34: 13.3k; R_0402_1005Metric
R37, R38: 2.2k; R_0402_1005Metric
R42, R43, R46, R47, R50, R51, R72, R73: 60.4; R_0402_1005Metric
R53, R54: 5.1k; R_0402_1005Metric
R55: 12.1k 1%; R_0402_1005Metric
R62: 1.5k; R_0402_1005Metric
R63, R64, R65, R66: 49.9 1%; R_0402_1005Metric
R68: ID: DNP arm, 10k leg, 4.7k torso, 2.2k head; R_0402_1005Metric
R74: 82k; R_0402_1005Metric
R75, R76: 33; R_0402_1005Metric
R77: 0; R_0402_1005Metric
SH1: shield can 24x20x2 (frame + lid, e.g. Harwin S02 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; shield_mcu
TH1: 10k NTC (FETs); R_0402_1005Metric
TH2: 10k NTC (brake R); R_0402_1005Metric
U1: LM5060; VSSOP-10_3x3mm_P0.5mm
U2: 74LVC1G11; SOT-23-6
U3: TPS3430; Texas_DRC0010J_ThermalVias
U4: INA228; VSSOP-10_3x3mm_P0.5mm
U5: TLV7031; SOT-23-5
U6: UCC27511A; SOT-23-6
U7: LM5164 48V->12V; Texas_HSOP-8-1EP_3.9x4.9mm_P1.27mm
U8: TPS54302 12V->5V; TSOT-23-6
U9: AP2112K-3.3; SOT-23-5
U10: STM32H723VGT6; LQFP-100_14x14mm_P0.5mm
U11, U12, U13: MCP2562FD-E/SN; SOIC-8_3.9x4.9mm_P1.27mm
U14: USBLC6-2SC6; SOT-23-6
U15: LAN8742A-CZ; QFN-24-1EP_4x4mm_P0.5mm_EP2.6x2.6mm
U16: ISM330DHCX; LGA-14_3x2.5mm_P0.5mm_LayoutBorder3x4y
U17: ADS1220IPW; TSSOP-16_4.4x5mm_P0.65mm
U18: MCP251863T-E/9PX; VQFN-28-1EP_5x5mm_P0.5mm_EP3.25x3.25mm
U19: DRV8871DDAR; Texas_HTSOP-8-1EP_3.9x4.9mm_P1.27mm_EP2.95x4.9mm_Mask2.4x3.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
Y1, Y2: 25MHz; Crystal_SMD_3225-4Pin_3.2x2.5mm
Y3: 40MHz; Crystal_SMD_3225-4Pin_3.2x2.5mm

Connections:
+3V3: C6.1, C17.1, C18.1, C19.1, C20.1, C21.1, C22.1, C23.1, C32.1, C34.1, C36.1, C46.1, C49.1, C50.1, C53.1, C59.1, C60.1, FB1.1, FB2.1, FB3.1, FB5.1, J4.1 (VCC), R7.1, R9.1, R11.1, R13.1, R15.1, R18.1, R24.1, R25.1, R31.1, R35.1, R37.1, R38.1, R59.1, R60.1, R61.1, R62.1, R67.1, U2.5 (VCC), U3.1 (VDD1), U3.10 (VDD2), U4.6 (VS), U5.5 (V+), U9.5 (VOUT), U10.6 (VBAT), U10.11 (VDD), U10.27 (VDD), U10.50 (VDD), U10.75 (VDD), U10.100 (VDD), U11.5 (Vio), U12.5 (Vio), U13.5 (Vio), U15.9 (VDDIO), U16.5 (VDDIO), U16.8 (VDD), U17.13 (DVDD), U18.14 (VIO), U18.26 (VDD)
+5V: C15.1, C16.1, C31.1, C33.1, C35.1, C61.1, J11.2, L2.2, PF5.1, R33.1, U9.1 (VIN), U9.3 (EN), U11.3 (VDD), U12.3 (VDD), U13.3 (VDD), U18.13 (VCC)
+12V: C9.1, C12.1, C14.1, C63.1, C64.1, J11.1, L1.2, PF4.1, R29.1, R32.1, U6.1 (V_{DD}), U8.3 (VIN), U19.5 (VM)
ADC_CS: U10.85 (PD4), U17.2 (~CS)
ADC_DOUT: R76.1, U17.15 (DOUT/~DRDY)
ADC_DRDY: U10.83 (PD2), U17.14 (~DRDY)
AUX_IO: J11.3, U10.34 (PB0)
AVDD_LC: C51.1, C52.1, FB5.2, J14.1, PF12.1, U17.9 (REFP0), U17.12 (AVDD)
BK1_BST: C10.1, U7.7 (BST)
BK1_EN: R26.2, R27.1, U7.3 (EN/UVLO)
BK1_FB: R29.2, R30.1, U7.5 (FB)
BK1_PG: R31.2, U7.6 (PGOOD), U10.84 (PD3)
BK1_RON: R28.1, U7.4 (RON)
BK1_SW: C10.2, L1.1, U7.8 (SW)
BK2_BST: C13.1, U8.6 (BOOT)
BK2_EN: R32.2, U8.5 (EN)
BK2_FB: R33.2, R34.1, U8.4 (FB)
BK2_SW: C13.2, L2.1, U8.2 (SW)
BOARD_ID: C48.1, R67.2, R68.1, U10.15 (PC0)
BOOT0: R36.1, U10.94 (BOOT0)
BRK_CMP: D2.2 (A), R20.1, U5.1, U10.38 (PE8)
BRK_DIV: R16.2, R17.1, R20.2, U5.3 (+)
BRK_FORCE: D3.2 (A), U10.37 (PE7)
BRK_G: Q2.1 (G), R22.2, R23.2
BRK_GH: R22.1, U6.2 (OUTH)
BRK_GL: R23.1, U6.3 (OUTL)
BRK_IN: D2.1 (K), D3.1 (K), R21.1, U6.6 (IN+)
BRK_R: D4.2 (A), J3.2, Q2.3 (D)
BRK_REF: R18.2, R19.1, U5.4 (-)
CANA_H: D7.1 (A1), J8.2, R42.1, U11.7 (CANH)
CANA_L: D7.2 (A2), J8.1, R43.2, U11.6 (CANL)
CANA_RX: U10.81 (PD0), U11.4 (RXD)
CANA_STBY: R41.1, U10.41 (PE11), U11.8 (STBY)
CANA_TSPLIT: C37.1, R42.2, R43.1
CANA_TX: U10.82 (PD1), U11.1 (TXD)
CANB_H: D8.1 (A1), J9.4, R46.1, U12.7 (CANH)
CANB_L: D8.2 (A2), J9.3, R47.2, U12.6 (CANL)
CANB_RX: U10.91 (PB5), U12.4 (RXD)
CANB_STBY: R45.1, U10.42 (PE12), U12.8 (STBY)
CANB_TSPLIT: C38.1, R46.2, R47.1
CANB_TX: U10.92 (PB6), U12.1 (TXD)
CANU_H: D9.1 (A1), J10.1, R50.1, U13.7 (CANH)
CANU_L: D9.2 (A2), J10.2, R51.2, U13.6 (CANL)
CANU_RX: U10.59 (PD12), U13.4 (RXD)
CANU_STBY: R49.1, U10.43 (PE13), U13.8 (STBY)
CANU_TSPLIT: C39.1, R50.2, R51.1
CANU_TX: U10.60 (PD13), U13.1 (TXD)
CANX_CS: U10.86 (PD5), U18.25 (~CS)
CANX_H: D11.1 (A1), J15.1, R72.1, U18.17 (CANH)
CANX_INT: U10.78 (PC10), U18.3 (~INT)
CANX_L: D11.2 (A2), J15.2, R73.2, U18.16 (CANL)
CANX_OSC1: C57.1, U18.5 (OSC1), Y3.1
CANX_OSC2: C58.1, U18.4 (OSC2), Y3.3
CANX_RXI: U18.1 (RXCAN), U18.11 (RXD)
CANX_STBY: R71.1, U18.18 (STBY)
CANX_TSPLIT: C62.1, R72.2, R73.1
CANX_TXD: R77.2, U18.20 (TXD)
CANX_TXI: R77.1, U18.28 (TXCAN)
EN_AND: D10.2 (A), R8.1, U2.4
ESTOP1: J2.2, R10.1, U2.1, U10.1 (PE2)
ESTOP2: J2.4, R12.1, U10.2 (PE3)
ESTOP_SRC1: J2.1, R9.2
ESTOP_SRC2: J2.3, R11.2
ETH_CRSDV: R61.2, U10.31 (PA7), U15.11 (CRS_DV/MODE2)
ETH_CT: C47.1, FB3.2, J13.4 (TCT), J13.5 (RCT), PF10.1, R63.1, R64.1, R65.1, R66.1
ETH_MDC: U10.16 (PC1), U15.13 (MDC)
ETH_MDIO: R62.2, U10.24 (PA2), U15.12 (MDIO)
ETH_REFCLK: U10.23 (PA1), U15.14 (~INT/REFCLKO)
ETH_RXD0: R59.2, U10.32 (PC4), U15.8 (RXD0/MODE0)
ETH_RXD1: R60.2, U10.33 (PC5), U15.7 (RXD1/MODE1)
ETH_RXN: J13.6 (RD-), R66.2, U15.22 (RXN)
ETH_RXP: J13.3 (RD+), R65.2, U15.23 (RXP)
ETH_TXD0: U10.51 (PB12), U15.17 (TXD0)
ETH_TXD1: U10.52 (PB13), U15.18 (TXD1)
ETH_TXEN: U10.47 (PB11), U15.16 (TXEN)
ETH_TXN: J13.2 (TD-), R64.2, U15.20 (TXN)
ETH_TXP: J13.1 (TD+), R63.2, U15.21 (TXP)
GND: C1.2, C2.2, C3.2, C4.2, C5.2, C6.2, C7.2, C8.2, C9.2, C11.2, C12.2, C14.2, C15.2, C16.2, C17.2, C18.2, C19.2, C20.2, C21.2, C22.2, C23.2, C24.2, C25.2, C26.2, C27.2, C28.2, C29.2, C30.2, C31.2, C32.2, C33.2, C34.2, C35.2, C36.2, C37.2, C38.2, C39.2, C40.2, C41.2, C42.2, C43.2, C44.2, C45.2, C46.2, C47.2, C48.2, C49.2, C50.2, C51.2, C52.2, C53.2, C55.2, C56.2, C57.2, C58.2, C59.2, C60.2, C61.2, C62.2, C63.2, C64.2, D1.2 (A2), D5.1 (K), D6.1 (K), D7.3 (common), D8.3 (common), D9.3 (common), D11.3 (common), H1.1, H2.1, H3.1, H4.1, J1.2, J4.5 (GND), J5.2, J9.2, J10.3, J11.4, J12.A1 (GND), J12.A12 (GND), J12.B1 (GND), J12.B12 (GND), J12.S1 (SHIELD), J13.8, J13.SH, J14.2, J15.3, J17.2, PF2.1, Q2.2 (S), R4.2, R6.2, R10.2, R12.2, R17.2, R19.2, R21.2, R27.2, R28.2, R30.2, R34.2, R36.2, R39.2, R41.2, R45.2, R49.2, R53.2, R54.2, R55.2, R56.2, R57.2, R58.2, R68.2, R71.2, R74.2, SH1.1, TH1.2, TH2.2, U1.6 (GND), U2.2 (GND), U3.3 (SET0), U3.5 (GND), U3.6 (SET1), U3.11 (GND), U4.1 (A1), U4.2 (A0), U4.7 (GND), U5.2 (V-), U6.4 (GND), U6.5 (IN-), U7.1 (GND), U7.9 (EP), U8.1 (GND), U9.2 (GND), U10.10 (VSS), U10.19 (VSSA), U10.26 (VSS), U10.49 (VSS), U10.74 (VSS), U10.99 (VSS), U11.2 (VSS), U12.2 (VSS), U13.2 (VSS), U14.2 (GND), U15.25 (VSS), U16.2 (SDx), U16.3 (SCx), U16.6 (GND), U16.7 (GND), U17.3 (CLK), U17.4 (DGND), U17.5 (AVSS), U17.8 (REFN0), U18.7 (VSS), U18.10 (GND), U18.29 (NC), U19.1 (GND), U19.7 (GND), U19.9 (GND), Y1.2, Y1.4, Y2.2, Y2.4, Y3.2, Y3.4
HSE_IN: C29.1, U10.12 (PH0), Y1.1
HSE_OUT: C30.1, U10.13 (PH1), Y1.3
HS_EN: C3.1, D10.1 (K), R8.2, U1.5 (EN)
HS_GATE: Q1.1 (G), R2.2
HS_GATE_R: R2.1, U1.10 (GATE)
HS_OVP: R5.2, R6.1, U1.3 (OVP)
HS_PGD: R7.2, U1.8 (~PGD), U10.97 (PE0)
HS_SENSE: R1.2, U1.1 (SENSE)
HS_TIMER: C2.1, U1.7 (TIMER)
HS_UVLO: R3.2, R4.1, U1.4 (UVLO)
I2C_SCL: R37.2, U4.5 (SCL), U10.95 (PB8)
I2C_SDA: R38.2, U4.4 (SDA), U10.96 (PB9)
IMU_CS: U10.28 (PA4), U16.12 (CS)
IMU_INT: U10.7 (PC13), U16.4 (INT1)
IMU_SDO: R75.1, U16.1 (SDO/SA0)
INA_ALERT: R15.2, U4.3 (~Alert), U10.98 (PE1)
LC_N: J14.4, R70.1
LC_P: J14.3, R69.1
LC_SN: C54.2, C56.1, R70.2, U17.10 (AIN1)
LC_SP: C54.1, C55.1, R69.2, U17.11 (AIN0/REFP1)
LED_PWR: D5.2 (A), R35.2
LED_STAT: R40.1, U10.45 (PE15)
LED_STAT_A: D6.2 (A), R40.2
MCU_EN: R39.1, U2.6, U10.3 (PE4)
MOT_A: J16.1, U19.6 (OUT1)
MOT_B: J16.2, U19.8 (OUT2)
MOT_ILIM: R74.1, U19.4 (ILIM)
MOT_IN1: U10.67 (PA8), U19.3 (IN1)
MOT_IN2: U10.68 (PA9), U19.2 (IN2)
NRST: C28.1, J4.3 (~RESET), U10.14 (NRST)
NTC_BRK: R25.2, TH2.1, U10.25 (PA3)
NTC_FET: R24.2, TH1.1, U10.22 (PA0)
PHY_LED1: R56.1, U15.3 (LED1/REGOFF)
PHY_LED2: R57.1, U15.2 (LED2/~INTSEL)
PHY_RBIAS: R55.1, U15.24 (RBIAS)
PHY_RST: U10.39 (PE9), U15.15 (~RST)
PHY_RXER: R58.1, U15.10 (RXER/PHYAD0)
PHY_VDDA: C42.1, C43.1, FB2.2, PF8.1, U15.1 (VDD2A), U15.19 (VDD1A)
PHY_VDDCR: C44.1, C45.1, PF9.1, U15.6 (VDDCR)
PHY_XI: C40.1, U15.5 (XTAL1/CLKIN), Y2.1
PHY_XO: C41.1, U15.4 (XTAL2), Y2.3
SPI_MISO: R75.2, R76.2, U10.30 (PA6), U18.24 (SDO)
SPI_MOSI: U10.88 (PD7), U16.14 (SDA), U17.16 (DIN), U18.23 (SDI)
SPI_SCK: U10.29 (PA5), U16.13 (SCL), U17.1 (SCLK), U18.22 (SCK)
SWCLK: J4.4 (SWCLK), U10.76 (PA14(JTCK)
SWDIO: J4.2 (SWDIO), U10.72 (PA13(JTMS)
SWO: J4.6 (SWO), U10.89 (PB3(JTDO)
USB_CC1: J12.A5 (CC1), R53.1
USB_CC2: J12.B5 (CC2), R54.1
USB_DM: J12.A7 (D-), J12.B7 (D-), U10.70 (PA11), U14.1 (I/O1), U14.6 (I/O1)
USB_DP: J12.A6 (D+), J12.B6 (D+), U10.71 (PA12), U14.3 (I/O2), U14.4 (I/O2)
USB_VBUS: J12.A4 (VBUS), J12.A9 (VBUS), J12.B4 (VBUS), J12.B9 (VBUS), U14.5 (VBUS)
VAUX48: F1.2, J17.1
VBUS: C7.1, C8.1, D4.1 (K), F1.1, J3.1, J5.1, J9.1, PF3.1, R14.2, R16.1, U4.8 (Vbus), U4.9 (Vin-)
VBUS_SW: Q1.2 (S), R14.1, U1.9 (OUT), U4.10 (Vin+)
VCAP1: C26.1, U10.48 (VCAP)
VCAP2: C27.1, U10.73 (VCAP)
VDDA: C24.1, C25.1, FB1.2, PF6.1, U10.20 (VREF+), U10.21 (VDDA)
VIN: C1.1, D1.1 (A1), FB4.1, J1.1, PF1.1, Q1.3 (D), R1.1, R3.1, R5.1, U1.2 (VIN)
VIN_BUCK: C11.1, FB4.2, PF11.1, R26.1, U7.2 (VIN)
WD_CRST: C4.1, U3.4 (CRST)
WD_CWD: C5.1, U3.2 (CWD)
WD_KICK: U3.7 (WDI), U10.4 (PE5)
WD_OK: R13.2, U2.3, U3.8 (~WDO), U10.5 (PE6)

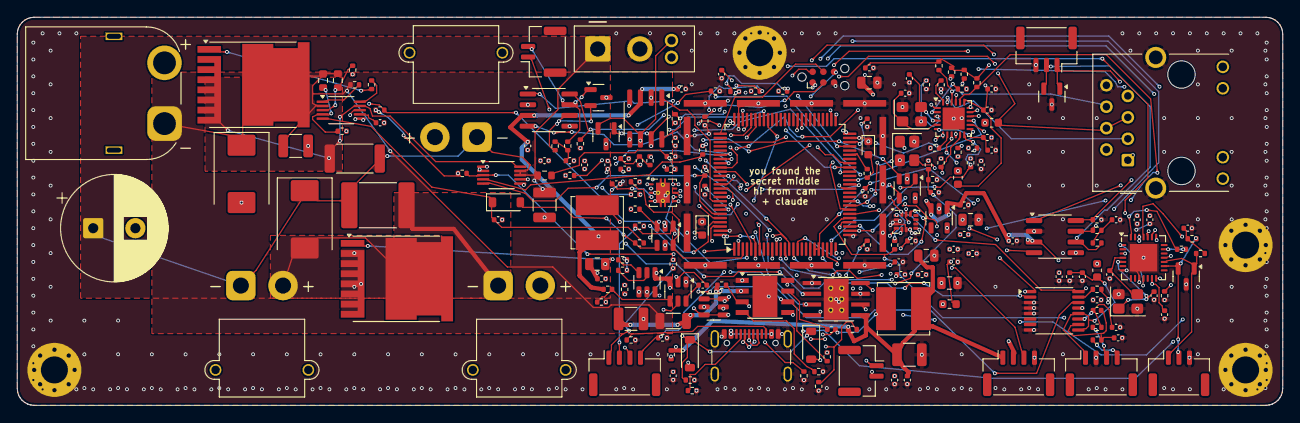
[picture p306: board arm_controller.kicad_pcb from above]

Board: 6 copper layers, 150.0 x 46.0 mm, 220 parts (0 on the bottom side), 142 nets.

Other parts of the board:
ART1: rose_back
EGG1: rose_egg_mcu
LBB_J1: lblb_J1
LBB_J2: lblb_J2
LBB_J3: lblb_J3
LBB_J5: lblb_J5
LBB_J8: lblb_J8
LBB_J9: lblb_J9
LBB_J10: lblb_J10
LBB_J11: lblb_J11
LBB_J12: lblb_J12
LBB_J13: lblb_J13
LBB_J14: lblb_J14
LBB_J15: lblb_J15
LBB_J16: lblb_J16
LBB_J17: lblb_J17
RING1: edge_ring
