muni-works/rose/electronics/brain/module.kicad_pcb

## KiCad design electronics/brain/module.kicad_pcb (2026-10-17)

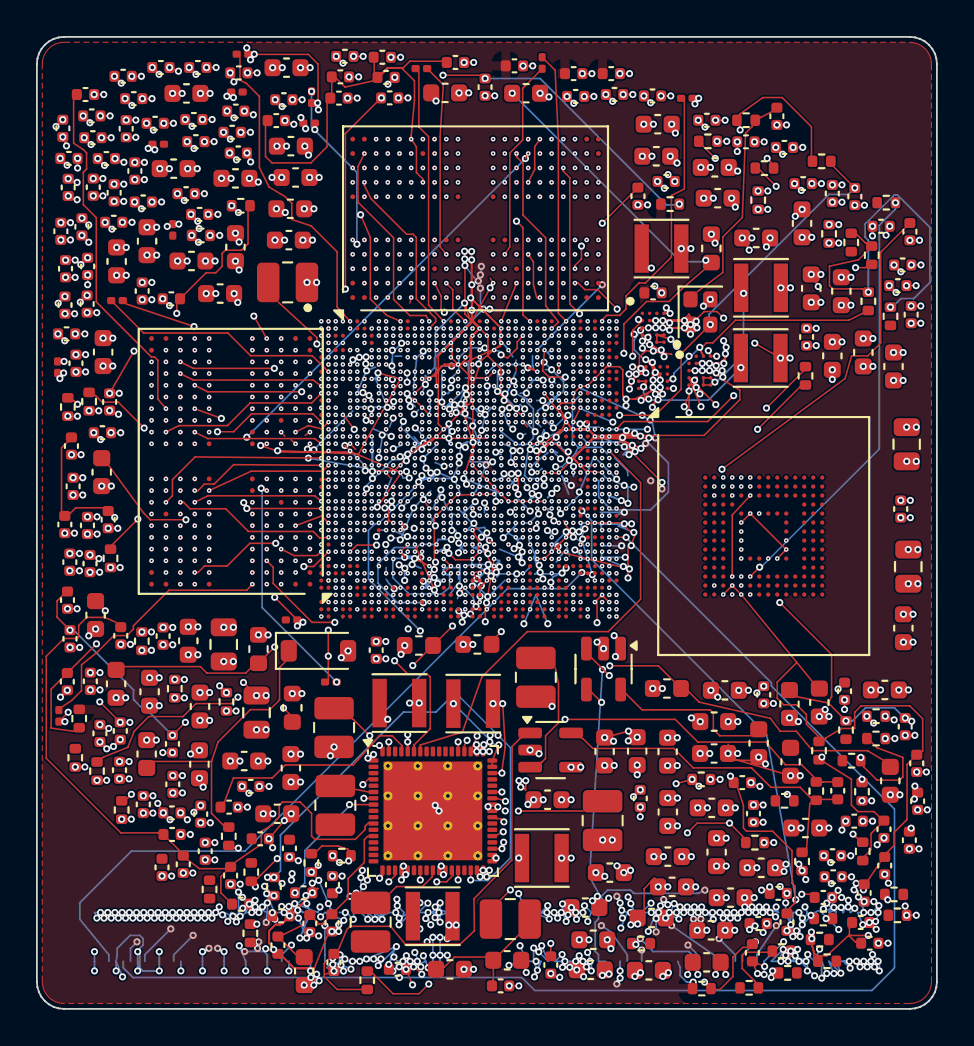
[picture p307: board module.kicad_pcb from above]

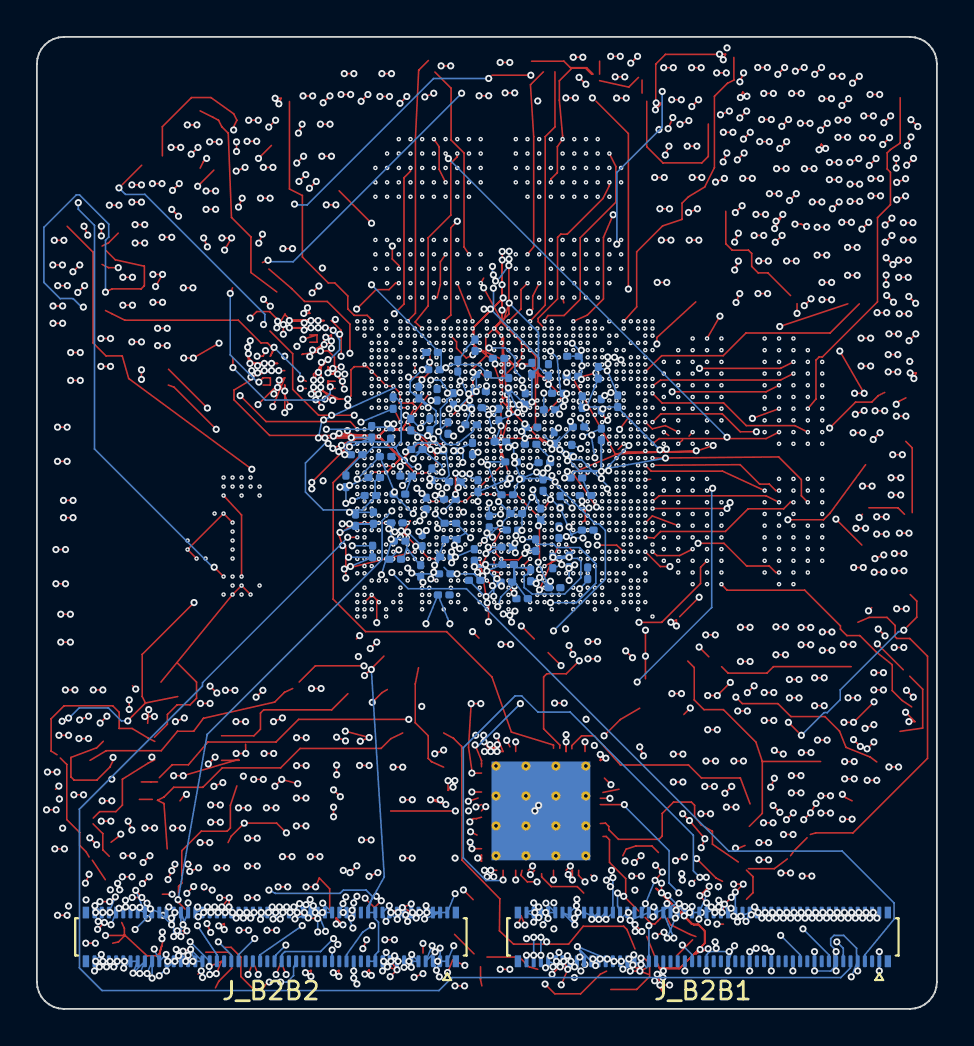
[picture p308: board module.kicad_pcb from below]

Board: 10 copper layers, 50.0 x 54.0 mm, 406 parts (94 on the bottom side), 292 nets.

Parts:
C24, C25, C26, C28, C31, C33, C34, C35, C36, C38, C39, C40, C41, C43, C44, C45, C46, C49, C50, C52, C53, C55, C56, C58, C59, C61, C62, C64, C65, C87, C88, C90, C91, C92, C93, C94, C95, C96, C98, C99, C100, C101, C102, C103, C104, C108, C109, C110, C114, C118, C119, C120, C121, C122, C123: 22u; C_0603_1608Metric
C27, C85, C86, C115, C272, C278, C279, C284, C285, C286, C287, C288, C289, C292, C293, C294, C295, C296, C297, C299, C300, C305, C306, C307, C308, C309, C310, C313, C314, C315, C316, C317, C318, C322, C324: 100n; C_0402_1005Metric
C29, C30, C106, C107: 47u; C_0805_2012Metric
C32, C37, C42, C47, C68, C69, C70, C71, C72, C78, C79, C80, C81, C82, C89, C97, C105, C116, C117, C124, C125, C126, C127, C134, C135, C136, C137, C144, C145, C146, C147, C153, C154, C155, C156, C157, C158, C165, C166, C167, C168, C174, C175, C176, C177, C178, C179, C188, C189, C190, C197, C198, C213, C214, C215, C216, C217, C218, C222, C224, C225, C226, C237, C238, C239, C240, C249, C250, C264, C275, C276, C277, C282, C283, C290, C291, C298, C303, C304, C311, C312, C320, C325, C326: 1u; C_0402_1005Metric
C48, C51, C54, C57, C60, C63, C112, C195, C196, C203, C204, C280, C281, C301, C302: 10u; C_0603_1608Metric
C66, C67, C113: 100p; C_0402_1005Metric
C73, C74, C75, C76, C77, C321, C323: 2.2u; C_0402_1005Metric
C83: 4.7u; C_0603_1608Metric
C84, C319: 1n 25V; C_0402_1005Metric
C111: 100n 25V; C_0402_1005Metric
C128, C129, C130, C131, C132, C133, C138, C139, C140, C141, C142, C143, C148, C149, C150, C151, C152, C159, C160, C161, C162, C163, C164, C169, C170, C171, C172, C173, C180, C181, C182, C183, C184, C185, C186, C187, C191, C192, C193, C194, C199, C200, C201, C202, C205, C206, C207, C208, C209, C210, C211, C212, C219, C220, C221, C223, C227, C228, C229, C230, C231, C232, C233, C234, C235, C236, C241, C242, C243, C244, C245, C246, C247, C248, C251, C252, C253, C254, C255, C256, C257, C258, C259, C260, C261, C262, C263, C265, C266, C267, C268, C269: 100n; C_0201_0603Metric
C270, C271: 18p; C_0402_1005Metric
C273, C274: 1n; C_0402_1005Metric
D3: B5819W; D_SOD-123
FB1, FB2, FB3, FB4, FB5, FB6: 120R@100MHz; L_0603_1608Metric
J_B2B1, J_B2B2: DF40C-100DP header; Hirose_DF40C-100DP-0.4V_2x50-1MP_P0.4mm
L3, L4, L5, L6: 0.22u; L_Taiyo-Yuden_MD-3030
L7, L8, L9, L10, L11, L12: 0.47u; L_1008_2520Metric
L13, L14, L15: 0.24u; L_Taiyo-Yuden_MD-3030
L16: 2.2u; L_1008_2520Metric
R10, R11, R12, R13, R18, R29, R30, R31: 100R; R_0402_1005Metric
R14, R33, R40: 120k; R_0402_1005Metric
R15, R17, R21, R32, R39, R42, R49, R74, R75: 100k; R_0402_1005Metric
R16: 20k; R_0402_1005Metric
R19, R20: 200k; R_0402_1005Metric
R22, R23, R26, R27, R28, R46, R70: 0; R_0402_1005Metric
R24, R25, R38, R41, R50, R71, R80: 10k; R_0402_1005Metric
R34, R35, R36, R37, R76, R77, R78, R79: 2.2k; R_0402_1005Metric
R43: 4.7k; R_0402_1005Metric
R44, R47, R48: 22R; R_0402_1005Metric
R45: 510k; R_0402_1005Metric
R51, R52: 8.2k 1%; R_0402_1005Metric
R53, R54, R55: 200R 1%; R_0402_1005Metric
R56, R57, R61, R62: 49.9R 1%; R_0201_0603Metric
R58, R63, R66, R67, R68, R69: 240R 1%; R_0201_0603Metric
R59, R60, R64, R65: 10k; R_0201_0603Metric
U4, U6: RK860-2; Rockchip_WLCSP-20_1.65x2.05mm_P0.4mm
U5: RK860-3; Rockchip_WLCSP-20_1.65x2.05mm_P0.4mm
U7: SY8089AAC; SOT-23-5
U8: SGM2576; SOT-23-5
U_DRAM0, U_DRAM1: W66DP2RQQAGJ (8Gb x32 LPDDR4X); BGA-200_10x14.5mm_Layout12x22_P0.8x0.65mm
U_EMMC: ZDEMMC32GA (32 GB eMMC 5.1); LFBGA-153_11.5x13mm_Layout14x14_P0.5mm
U_PMIC: RK806-1; ArtInChip_QFN-68-1EP_7x7mm_P0.35mm_EP5.49x5.49mm_ThermalVias
U_SOC: RK3588S2; Rockchip_FCCSP-1253_17x17mm_P0.4mm
Y1: 24MHz; Crystal_SMD_2016-4Pin_2.0x1.6mm

Connections:
AVDD1V8_DDR_PLL_S0: C217.1, C218.1, R28.2, U_SOC.L15, U_SOC.Y14
BIG0_LX: L13.1, U4.D3, U4.D4, U4.E3, U4.E4
BIG1_LX: L14.1, U5.D3, U5.D4, U5.E3, U5.E4
BIG_NPU_EN: R32.2, R33.1, U4.A2, U5.A2, U6.A2
CAM0_CN: J_B2B1.5, U_SOC.AN41
CAM0_CP: J_B2B1.3, U_SOC.AN42
CAM0_D0N: J_B2B1.11, U_SOC.AL41
CAM0_D0P: J_B2B1.9, U_SOC.AL42
CAM0_D1N: J_B2B1.17, U_SOC.AK42
CAM0_D1P: J_B2B1.15, U_SOC.AK41
CAM0_D2N: J_B2B1.23, U_SOC.AT42
CAM0_D2P: J_B2B1.21, U_SOC.AT41
CAM0_D3N: J_B2B1.29, U_SOC.AP41
CAM0_D3P: J_B2B1.27, U_SOC.AP42
CAM0_PWDN: J_B2B2.29, U_SOC.D40
CAM0_SCL: J_B2B2.31, R76.2, U_SOC.L39
CAM0_SDA: J_B2B2.33, R77.2, U_SOC.D38
CAM1_CN: J_B2B1.35, U_SOC.BA41
CAM1_CP: J_B2B1.33, U_SOC.BB41
CAM1_D0N: J_B2B1.41, U_SOC.BB38
CAM1_D0P: J_B2B1.39, U_SOC.BA38
CAM1_D1N: J_B2B1.47, U_SOC.AY40
CAM1_D1P: J_B2B1.45, U_SOC.BA40
CAM1_D2N: J_B2B1.53, U_SOC.BA42
CAM1_D2P: J_B2B1.51, U_SOC.AY42
CAM1_D3N: J_B2B1.59, U_SOC.AW42
CAM1_D3P: J_B2B1.57, U_SOC.AW41
CAM1_PWDN: J_B2B2.35, U_SOC.D39
CAM1_SCL: J_B2B2.37, R78.2, U_SOC.L37
CAM1_SDA: J_B2B2.39, R79.2, U_SOC.G38
D0A_CA0: U_DRAM0.H2, U_SOC.U1
D0A_CA1: U_DRAM0.J2, U_SOC.AC2
D0A_CA2: U_DRAM0.H9, U_SOC.AF1
D0A_CA3: U_DRAM0.H10, U_SOC.AL2
D0A_CA4: U_DRAM0.H11, U_SOC.Y1
D0A_CA5: U_DRAM0.J11, U_SOC.AG2
D0A_CKE0: R56.2, U_DRAM0.J4
D0A_CKE0_SOC: R56.1, U_SOC.AK1
D0A_CK_c: U_DRAM0.J9, U_SOC.AA1
D0A_CK_t: U_DRAM0.J8, U_SOC.AA2
D0A_CS0: U_DRAM0.H4, U_SOC.Y2
D0A_DMI0: U_DRAM0.C3, U_SOC.AE1
D0A_DMI1: U_DRAM0.C10, U_SOC.AK4
D0A_DQ0: U_DRAM0.F2, U_SOC.AJ2
D0A_DQ1: U_DRAM0.B2, U_SOC.AB4
D0A_DQ2: U_DRAM0.F4, U_SOC.AJ1
D0A_DQ3: U_DRAM0.B4, U_SOC.AB3
D0A_DQ4: U_DRAM0.C2, U_SOC.AB5
D0A_DQ5: U_DRAM0.C4, U_SOC.AE5
D0A_DQ6: U_DRAM0.E2, U_SOC.AE2
D0A_DQ7: U_DRAM0.E4, U_SOC.AF3
D0A_DQ8: U_DRAM0.E11, U_SOC.AK5
D0A_DQ9: U_DRAM0.F11, U_SOC.AN5
D0A_DQ10: U_DRAM0.F9, U_SOC.AN4
D0A_DQ11: U_DRAM0.C11, U_SOC.AJ6
D0A_DQ12: U_DRAM0.C9, U_SOC.AJ3
D0A_DQ13: U_DRAM0.E9, U_SOC.AK3
D0A_DQ14: U_DRAM0.B11, U_SOC.AF4
D0A_DQ15: U_DRAM0.B9, U_SOC.AF5
D0A_DQS0_c: U_DRAM0.E3, U_SOC.AN2
D0A_DQS0_t: U_DRAM0.D3, U_SOC.AN1
D0A_DQS1_c: U_DRAM0.E10, U_SOC.AV3
D0A_DQS1_t: U_DRAM0.D10, U_SOC.AV4
D0B_CA0: U_DRAM0.R2, U_SOC.U2
D0B_CA1: U_DRAM0.P2, U_SOC.R2
D0B_CA2: U_DRAM0.R9, U_SOC.R1
D0B_CA3: U_DRAM0.R10, U_SOC.D2
D0B_CA4: U_DRAM0.R11, U_SOC.E1
D0B_CA5: U_DRAM0.P11, U_SOC.L1
D0B_CKE0: R57.2, U_DRAM0.P4
D0B_CKE0_SOC: R57.1, U_SOC.H2
D0B_CK_c: U_DRAM0.P9, U_SOC.V1
D0B_CK_t: U_DRAM0.P8, U_SOC.V2
D0B_CS0: U_DRAM0.R4, U_SOC.J1
D0B_DMI0: U_DRAM0.Y3, U_SOC.V5
D0B_DMI1: U_DRAM0.Y10, U_SOC.G2
D0B_DQ0: U_DRAM0.Y2, U_SOC.U3
D0B_DQ1: U_DRAM0.AA4, U_SOC.AA5
D0B_DQ2: U_DRAM0.U2, U_SOC.N1
D0B_DQ3: U_DRAM0.Y4, U_SOC.U5
D0B_DQ4: U_DRAM0.U4, U_SOC.P4
D0B_DQ5: U_DRAM0.V2, U_SOC.P3
D0B_DQ6: U_DRAM0.AA2, U_SOC.U4
D0B_DQ7: U_DRAM0.V4, U_SOC.P5
D0B_DQ8: U_DRAM0.U11, U_SOC.G5
D0B_DQ9: U_DRAM0.V11, U_SOC.J3
D0B_DQ10: U_DRAM0.U9, U_SOC.G4
D0B_DQ11: U_DRAM0.V9, U_SOC.J4
D0B_DQ12: U_DRAM0.Y9, U_SOC.N5
D0B_DQ13: U_DRAM0.AA11, U_SOC.N2
D0B_DQ14: U_DRAM0.Y11, U_SOC.J5
D0B_DQ15: U_DRAM0.AA9, U_SOC.N6
D0B_DQS0_c: U_DRAM0.V3, U_SOC.B1
D0B_DQS0_t: U_DRAM0.W3, U_SOC.B2
D0B_DQS1_c: U_DRAM0.V10, U_SOC.K2
D0B_DQS1_t: U_DRAM0.W10, U_SOC.K1
D1C_CA0: U_DRAM1.H2, U_SOC.B18
D1C_CA1: U_DRAM1.J2, U_SOC.A21
D1C_CA2: U_DRAM1.H9, U_SOC.B22
D1C_CA3: U_DRAM1.H10, U_SOC.A7
D1C_CA4: U_DRAM1.H11, U_SOC.A10
D1C_CA5: U_DRAM1.J11, U_SOC.A15
D1C_CKE0: R61.2, U_DRAM1.J4
D1C_CKE0_SOC: R61.1, U_SOC.A18
D1C_CK_c: U_DRAM1.J9, U_SOC.D21
D1C_CK_t: U_DRAM1.J8, U_SOC.C21
D1C_CS0: U_DRAM1.H4, U_SOC.B15
D1C_DMI0: U_DRAM1.C3, U_SOC.E17
D1C_DMI1: U_DRAM1.C10, U_SOC.D13
D1C_DQ0: U_DRAM1.C2, U_SOC.B20
D1C_DQ1: U_DRAM1.C4, U_SOC.E20
D1C_DQ2: U_DRAM1.B2, U_SOC.A20
D1C_DQ3: U_DRAM1.B4, U_SOC.F20
D1C_DQ4: U_DRAM1.E2, U_SOC.C17
D1C_DQ5: U_DRAM1.F2, U_SOC.C16
D1C_DQ6: U_DRAM1.E4, U_SOC.D17
D1C_DQ7: U_DRAM1.F4, U_SOC.D16
D1C_DQ8: U_DRAM1.F11, U_SOC.D10
D1C_DQ9: U_DRAM1.E11, U_SOC.B12
D1C_DQ10: U_DRAM1.E9, U_SOC.A12
D1C_DQ11: U_DRAM1.F9, U_SOC.C10
D1C_DQ12: U_DRAM1.C11, U_SOC.C13
D1C_DQ13: U_DRAM1.C9, U_SOC.E13
D1C_DQ14: U_DRAM1.B11, U_SOC.A16
D1C_DQ15: U_DRAM1.B9, U_SOC.B16
D1C_DQS0_c: U_DRAM1.E3, U_SOC.B9
D1C_DQS0_t: U_DRAM1.D3, U_SOC.A9
D1C_DQS1_c: U_DRAM1.E10, U_SOC.A4
D1C_DQS1_t: U_DRAM1.D10, U_SOC.A3
D1D_CA0: U_DRAM1.R2, U_SOC.A26
D1D_CA1: U_DRAM1.P2, U_SOC.A27
D1D_CA2: U_DRAM1.R9, U_SOC.A30
D1D_CA3: U_DRAM1.R10, U_SOC.A36
D1D_CA4: U_DRAM1.R11, U_SOC.B33
D1D_CA5: U_DRAM1.P11, U_SOC.A38
D1D_CKE0: R62.2, U_DRAM1.P4
D1D_CKE0_SOC: R62.1, U_SOC.A35
D1D_CK_c: U_DRAM1.P9, U_SOC.D23
D1D_CK_t: U_DRAM1.P8, U_SOC.C23
D1D_CS0: U_DRAM1.R4, U_SOC.B30
D1D_DMI0: U_DRAM1.Y3, U_SOC.D27
D1D_DMI1: U_DRAM1.Y10, U_SOC.C33
D1D_DQ0: U_DRAM1.AA2, U_SOC.A24
D1D_DQ1: U_DRAM1.Y2, U_SOC.C25
D1D_DQ2: U_DRAM1.AA4, U_SOC.B24
D1D_DQ3: U_DRAM1.V4, U_SOC.A28
D1D_DQ4: U_DRAM1.Y4, U_SOC.D25
D1D_DQ5: U_DRAM1.U2, U_SOC.B28
D1D_DQ6: U_DRAM1.V2, U_SOC.C27
D1D_DQ7: U_DRAM1.U4, U_SOC.C29
D1D_DQ8: U_DRAM1.U11, U_SOC.D34
D1D_DQ9: U_DRAM1.AA11, U_SOC.D29
D1D_DQ10: U_DRAM1.AA9, U_SOC.E29
D1D_DQ11: U_DRAM1.Y11, U_SOC.E32
D1D_DQ12: U_DRAM1.Y9, U_SOC.B32
D1D_DQ13: U_DRAM1.U9, U_SOC.C34
D1D_DQ14: U_DRAM1.V11, U_SOC.C32
D1D_DQ15: U_DRAM1.V9, U_SOC.A32
D1D_DQS0_c: U_DRAM1.V3, U_SOC.A41
D1D_DQS0_t: U_DRAM1.W3, U_SOC.B41
D1D_DQS1_c: U_DRAM1.V10, U_SOC.C36
D1D_DQS1_t: U_DRAM1.W10, U_SOC.D36
DDR_RESET: C319.1, U_DRAM0.T11, U_DRAM1.T11, U_SOC.AG1
DRAM0_ODT_A: R59.2, U_DRAM0.G2
DRAM0_ODT_B: R60.2, U_DRAM0.T2
DRAM0_ZQ: R58.1, U_DRAM0.A5
DRAM1_ODT_A: R64.2, U_DRAM1.G2
DRAM1_ODT_B: R65.2, U_DRAM1.T2
DRAM1_ZQ: R63.1, U_DRAM1.A5
EMMC_CLK: R70.2, U_EMMC.M6
EMMC_CLK_SOC: R70.1, U_SOC.AB41
EMMC_CMD: R71.2, U_EMMC.M5, U_SOC.AE42
EMMC_DAT0: U_EMMC.A3, U_SOC.Y41
EMMC_DAT1: U_EMMC.A4, U_SOC.Y40
EMMC_DAT2: U_EMMC.A5, U_SOC.AA41
EMMC_DAT3: U_EMMC.B2, U_SOC.AA42
EMMC_DAT4: U_EMMC.B3, U_SOC.AB42
EMMC_DAT5: U_EMMC.B4, U_SOC.AD42
EMMC_DAT6: U_EMMC.B5, U_SOC.AD41
EMMC_DAT7: U_EMMC.B6, U_SOC.AE41
EMMC_DS: U_EMMC.H5, U_SOC.AC40
EMMC_RST_n: U_EMMC.K5, U_SOC.AD40
EMMC_VDDI: C320.1, U_EMMC.C2
GND: C24.2, C25.2, C26.2, C27.2, C28.2, C29.2, C30.2, C31.2, C32.2, C33.2, C34.2, C35.2, C36.2, C37.2, C38.2, C39.2, C40.2, C41.2, C42.2, C43.2, C44.2, C45.2, C46.2, C47.2, C48.2, C49.2, C50.2, C51.2, C52.2, C53.2, C54.2, C55.2, C56.2, C57.2, C58.2, C59.2, C60.2, C61.2, C62.2, C63.2, C64.2, C65.2, C68.2, C69.2, C70.2, C71.2, C72.2, C73.2, C74.2, C75.2, C76.2, C77.2, C78.2, C79.2, C80.2, C81.2, C82.2, C84.2, C85.2, C86.2, C87.2, C88.2, C89.2, C90.2, C91.2, C92.2, C93.2, C94.2, C95.2, C96.2, C97.2, C98.2, C99.2, C100.2, C101.2, C102.2, C103.2, C104.2, C105.2, C106.2, C107.2, C108.2, C109.2, C110.2, C111.2, C112.2, C114.2, C115.2, C116.2, C117.2, C118.2, C119.2, C120.2, C121.2, C122.2, C123.2, C124.2, C125.2, C126.2, C127.2, C128.2, C129.2, C130.2, C131.2, C132.2, C133.2, C134.2, C135.2, C136.2, C137.2, C138.2, C139.2, C140.2, C141.2, C142.2, C143.2, C144.2, C145.2, C146.2, C147.2, C148.2, C149.2, C150.2, C151.2, C152.2, C153.2, C154.2, C155.2, C156.2, C157.2, C158.2, C159.2, C160.2, C161.2, C162.2, C163.2, C164.2, C165.2, C166.2, C167.2, C168.2, C169.2, C170.2, C171.2, C172.2, C173.2, C174.2, C175.2, C176.2, C177.2, C178.2, C179.2, C180.2, C181.2, C182.2, C183.2, C184.2, C185.2, C186.2, C187.2, C188.2, C189.2, C190.2, C191.2, C192.2, C193.2, C194.2, C195.2, C196.2, C197.2, C198.2, C199.2, C200.2, C201.2, C202.2, C203.2, C204.2, C205.2, C206.2, C207.2, C208.2, C209.2, C210.2, C211.2, C212.2, C213.2, C214.2, C215.2, C216.2, C217.2, C218.2, C219.2, C220.2, C221.2, C222.2, C223.2, C224.2, C225.2, C226.2, C227.2, C228.2, C229.2, C230.2, C231.2, C232.2, C233.2, C234.2, C235.2, C236.2, C237.2, C238.2, C239.2, C240.2, C241.2, C242.2, C243.2, C244.2, C245.2, C246.2, C247.2, C248.2, C249.2, C250.2, C251.2, C252.2, C253.2, C254.2, C255.2, C256.2, C257.2, C258.2, C259.2, C260.2, C261.2, C262.2, C263.2, C264.2, C265.2, C266.2, C267.2, C268.2, C269.2, C270.2, C271.2, C272.2, C273.2, C274.2, C275.2, C276.2, C277.2, C278.2, C279.2, C280.2, C281.2, C282.2, C283.2, C284.2, C285.2, C286.2, C287.2, C288.2, C289.2, C290.2, C291.2, C292.2, C293.2, C294.2, C295.2, C296.2, C297.2, C298.2, C299.2, C300.2, C301.2, C302.2, C303.2, C304.2, C305.2, C306.2, C307.2, C308.2, C309.2, C310.2, C311.2, C312.2, C313.2, C314.2, C315.2, C316.2, C317.2, C318.2, C319.2, C320.2, C321.2, C322.2, C323.2, C324.2, C325.2, C326.2, D3.2, J_B2B1.1, J_B2B1.2, J_B2B1.4, J_B2B1.6, J_B2B1.7, J_B2B1.8, J_B2B1.10, J_B2B1.12, J_B2B1.13, J_B2B1.14, J_B2B1.16, J_B2B1.18, J_B2B1.19, J_B2B1.20, J_B2B1.22, J_B2B1.24, J_B2B1.25, J_B2B1.26, J_B2B1.28, J_B2B1.30, J_B2B1.31, J_B2B1.32, J_B2B1.34, J_B2B1.36, J_B2B1.37, J_B2B1.38, J_B2B1.40, J_B2B1.42, J_B2B1.43, J_B2B1.44, J_B2B1.46, J_B2B1.48, J_B2B1.49, J_B2B1.50, J_B2B1.52, J_B2B1.54, J_B2B1.55, J_B2B1.56, J_B2B1.58, J_B2B1.60, J_B2B1.61, J_B2B1.62, J_B2B1.64, J_B2B1.66, J_B2B1.67, J_B2B1.68, J_B2B1.69, J_B2B1.70, J_B2B1.71, J_B2B1.72, J_B2B1.73, J_B2B1.74, J_B2B1.75, J_B2B1.76, J_B2B1.77, J_B2B1.78, J_B2B1.79, J_B2B1.80, J_B2B1.81, J_B2B1.82, J_B2B1.83, J_B2B1.84, J_B2B1.85, J_B2B1.86, J_B2B1.87, J_B2B1.88, J_B2B1.89, J_B2B1.90, J_B2B1.91, J_B2B1.92, J_B2B1.93, J_B2B1.94, J_B2B1.95, J_B2B1.96, J_B2B1.97, J_B2B1.98, J_B2B1.99, J_B2B1.100, J_B2B2.27, J_B2B2.28, J_B2B2.30, J_B2B2.32, J_B2B2.34, J_B2B2.36, J_B2B2.38, J_B2B2.40, J_B2B2.42, J_B2B2.44, J_B2B2.46, J_B2B2.48, J_B2B2.50, J_B2B2.52, J_B2B2.54, J_B2B2.56, J_B2B2.58, J_B2B2.60, J_B2B2.62, J_B2B2.64, J_B2B2.66, J_B2B2.67, J_B2B2.68, J_B2B2.69, J_B2B2.70, J_B2B2.71, J_B2B2.72, J_B2B2.73, J_B2B2.74, J_B2B2.75, J_B2B2.76, J_B2B2.77, J_B2B2.78, J_B2B2.79, J_B2B2.80, J_B2B2.81, J_B2B2.82, J_B2B2.83, J_B2B2.84, J_B2B2.85, J_B2B2.86, J_B2B2.87, J_B2B2.88, J_B2B2.89, J_B2B2.90, J_B2B2.91, J_B2B2.92, J_B2B2.93, J_B2B2.94, J_B2B2.95, J_B2B2.96, J_B2B2.97, J_B2B2.98, J_B2B2.99, J_B2B2.100, R10.2, R11.2, R12.2, R13.2, R15.2, R17.2, R18.2, R20.2, R21.2, R29.2, R30.2, R31.2, R33.2, R40.2, R42.2, R43.2, R51.2, R52.2, R53.2, R54.2, R55.2, R75.2, R80.2, U4.B2, U4.B3, U4.B4, U4.C1, U4.C2, U4.C3, U4.C4, U5.B2, U5.B3, U5.B4, U5.C1, U5.C2, U5.C3, U5.C4, U6.B2, U6.B3, U6.B4, U6.C1, U6.C2, U6.C3, U6.C4, U7.2, U8.2, U_DRAM0.A3, U_DRAM0.A10, U_DRAM0.AB3, U_DRAM0.AB5, U_DRAM0.AB8, U_DRAM0.AB10, U_DRAM0.C1, U_DRAM0.C5, U_DRAM0.C8, U_DRAM0.C12, U_DRAM0.D2, U_DRAM0.D4, U_DRAM0.D9, U_DRAM0.D11, U_DRAM0.E1, U_DRAM0.E5, U_DRAM0.E8, U_DRAM0.E12, U_DRAM0.G1, U_DRAM0.G3, U_DRAM0.G5, U_DRAM0.G8, U_DRAM0.G10, U_DRAM0.G12, U_DRAM0.J1, U_DRAM0.J3, U_DRAM0.J10, U_DRAM0.J12, U_DRAM0.K2, U_DRAM0.K4, U_DRAM0.K9, U_DRAM0.K11, U_DRAM0.N2, U_DRAM0.N4, U_DRAM0.N9, U_DRAM0.N11, U_DRAM0.P1, U_DRAM0.P3, U_DRAM0.P10, U_DRAM0.P12, U_DRAM0.T1, U_DRAM0.T3, U_DRAM0.T5, U_DRAM0.T8, U_DRAM0.T10, U_DRAM0.T12, U_DRAM0.V1, U_DRAM0.V5, U_DRAM0.V8, U_DRAM0.V12, U_DRAM0.W2, U_DRAM0.W4, U_DRAM0.W9, U_DRAM0.W11, U_DRAM0.Y1, U_DRAM0.Y5, U_DRAM0.Y8, U_DRAM0.Y12, U_DRAM1.A3, U_DRAM1.A10, U_DRAM1.AB3, U_DRAM1.AB5, U_DRAM1.AB8, U_DRAM1.AB10, U_DRAM1.C1, U_DRAM1.C5, U_DRAM1.C8, U_DRAM1.C12, U_DRAM1.D2, U_DRAM1.D4, U_DRAM1.D9, U_DRAM1.D11, U_DRAM1.E1, U_DRAM1.E5, U_DRAM1.E8, U_DRAM1.E12, U_DRAM1.G1, U_DRAM1.G3, U_DRAM1.G5, U_DRAM1.G8, U_DRAM1.G10, U_DRAM1.G12, U_DRAM1.J1, U_DRAM1.J3, U_DRAM1.J10, U_DRAM1.J12, U_DRAM1.K2, U_DRAM1.K4, U_DRAM1.K9, U_DRAM1.K11, U_DRAM1.N2, U_DRAM1.N4, U_DRAM1.N9, U_DRAM1.N11, U_DRAM1.P1, U_DRAM1.P3, U_DRAM1.P10, U_DRAM1.P12, U_DRAM1.T1, U_DRAM1.T3, U_DRAM1.T5, U_DRAM1.T8, U_DRAM1.T10, U_DRAM1.T12, U_DRAM1.V1, U_DRAM1.V5, U_DRAM1.V8, U_DRAM1.V12, U_DRAM1.W2, U_DRAM1.W4, U_DRAM1.W9, U_DRAM1.W11, U_DRAM1.Y1, U_DRAM1.Y5, U_DRAM1.Y8, U_DRAM1.Y12, U_EMMC.A6, U_EMMC.C4, U_EMMC.E7, U_EMMC.G5, U_EMMC.H10, U_EMMC.J5, U_EMMC.K8, U_EMMC.N2, U_EMMC.N5, U_EMMC.P4, U_EMMC.P6, U_PMIC.69, U_SOC.A1, U_SOC.A2, U_SOC.A42, U_SOC.AA3, U_SOC.AA6, U_SOC.AA7, U_SOC.AA8, U_SOC.AA9, U_SOC.AA10, U_SOC.AA11, U_SOC.AA12, U_SOC.AA14, U_SOC.AA19, U_SOC.AA22, U_SOC.AA23, U_SOC.AA26, U_SOC.AA31, U_SOC.AA37, U_SOC.AA38, U_SOC.AA39, U_SOC.AA40, U_SOC.AB2, U_SOC.AB6, U_SOC.AB9, U_SOC.AB10, U_SOC.AB11, U_SOC.AB12, U_SOC.AB19, U_SOC.AB20, U_SOC.AB21, U_SOC.AB22, U_SOC.AB23, U_SOC.AB24, U_SOC.AB32, U_SOC.AB33, U_SOC.AB34, U_SOC.AB36, U_SOC.AB37, U_SOC.AB38, U_SOC.AB39, U_SOC.AB40, U_SOC.AC3, U_SOC.AC4, U_SOC.AC5, U_SOC.AC6, U_SOC.AC17, U_SOC.AC18, U_SOC.AC22, U_SOC.AC23, U_SOC.AC24, U_SOC.AC25, U_SOC.AC26, U_SOC.AC41, U_SOC.AD2, U_SOC.AD3, U_SOC.AD5, U_SOC.AD6, U_SOC.AD8, U_SOC.AD9, U_SOC.AD10, U_SOC.AD11, U_SOC.AD12, U_SOC.AD13, U_SOC.AD14, U_SOC.AD19, U_SOC.AD20, U_SOC.AD22, U_SOC.AD23, U_SOC.AD24, U_SOC.AD25, U_SOC.AE6, U_SOC.AE7, U_SOC.AE8, U_SOC.AE9, U_SOC.AE10, U_SOC.AE11, U_SOC.AE12, U_SOC.AE13, U_SOC.AE14, U_SOC.AE15, U_SOC.AE16, U_SOC.AE19, U_SOC.AE20, U_SOC.AE22, U_SOC.AE23, U_SOC.AE24, U_SOC.AE25, U_SOC.AE26, U_SOC.AE38, U_SOC.AE39, U_SOC.AE40, U_SOC.AF2, U_SOC.AF6, U_SOC.AF7, U_SOC.AF8, U_SOC.AF9, U_SOC.AF10, U_SOC.AF16, U_SOC.AF17, U_SOC.AF19, U_SOC.AF20, U_SOC.AF21, U_SOC.AF26, U_SOC.AF27, U_SOC.AF28, U_SOC.AF29, U_SOC.AF30, U_SOC.AF31, U_SOC.AF32, U_SOC.AF33, U_SOC.AF34, U_SOC.AF35, U_SOC.AF37, U_SOC.AF38, U_SOC.AF39, U_SOC.AF40, U_SOC.AF41, U_SOC.AG3, U_SOC.AG4, U_SOC.AG5, U_SOC.AG6, U_SOC.AG7, U_SOC.AG8, U_SOC.AG15, U_SOC.AG16, U_SOC.AG17, U_SOC.AG18, U_SOC.AG19, U_SOC.AG20, U_SOC.AG21, U_SOC.AG22, U_SOC.AG23, U_SOC.AG24, U_SOC.AG25, U_SOC.AG28, U_SOC.AG29, U_SOC.AG31, U_SOC.AG32, U_SOC.AG33, U_SOC.AG34, U_SOC.AG35, U_SOC.AG40, U_SOC.AH2, U_SOC.AH3, U_SOC.AH4, U_SOC.AH5, U_SOC.AH7, U_SOC.AH8, U_SOC.AH9, U_SOC.AH10, U_SOC.AH16, U_SOC.AH17, U_SOC.AH28, U_SOC.AH29, U_SOC.AH36, U_SOC.AJ5, U_SOC.AJ7, U_SOC.AJ8, U_SOC.AJ9, U_SOC.AJ10, U_SOC.AJ11, U_SOC.AJ12, U_SOC.AJ16, U_SOC.AJ26, U_SOC.AJ27, U_SOC.AJ28, U_SOC.AJ29, U_SOC.AJ30, U_SOC.AJ35, U_SOC.AJ38, U_SOC.AJ39, U_SOC.AJ40, U_SOC.AJ41, U_SOC.AK2, U_SOC.AK6, U_SOC.AK7, U_SOC.AK16, U_SOC.AK22, U_SOC.AK26, U_SOC.AK30, U_SOC.AK40, U_SOC.AL3, U_SOC.AL4, U_SOC.AL5, U_SOC.AL15, U_SOC.AL16, U_SOC.AL22, U_SOC.AL35, U_SOC.AM4, U_SOC.AM5, U_SOC.AM14, U_SOC.AM15, U_SOC.AM16, U_SOC.AM17, U_SOC.AM23, U_SOC.AM25, U_SOC.AM27, U_SOC.AM31, U_SOC.AM32, U_SOC.AM41, U_SOC.AN3, U_SOC.AN6, U_SOC.AN7, U_SOC.AN11, U_SOC.AN13, U_SOC.AN14, U_SOC.AN15, U_SOC.AN17, U_SOC.AN18, U_SOC.AN23, U_SOC.AN25, U_SOC.AN31, U_SOC.AN32, U_SOC.AN33, U_SOC.AN34, U_SOC.AN35, U_SOC.AN37, U_SOC.AN38, U_SOC.AN39, U_SOC.AN40, U_SOC.AP2, U_SOC.AP5, U_SOC.AP6, U_SOC.AP7, U_SOC.AP8, U_SOC.AP9, U_SOC.AP10, U_SOC.AP11, U_SOC.AP16, U_SOC.AP22, U_SOC.AP25, U_SOC.AP27, U_SOC.AP31, U_SOC.AP32, U_SOC.AP33, U_SOC.AP34, U_SOC.AP35, U_SOC.AP37, U_SOC.AP38, U_SOC.AP39, U_SOC.AP40, U_SOC.AR3, U_SOC.AR4, U_SOC.AR9, U_SOC.AR16, U_SOC.AR18, U_SOC.AR20, U_SOC.AR21, U_SOC.AR22, U_SOC.AR25, U_SOC.AR40, U_SOC.AR41, U_SOC.AT2, U_SOC.AT5, U_SOC.AT6, U_SOC.AT7, U_SOC.AT8, U_SOC.AT16, U_SOC.AT19, U_SOC.AT20, U_SOC.AT21, U_SOC.AT22, U_SOC.AT23, U_SOC.AT29, U_SOC.AT36, U_SOC.AU2, U_SOC.AU3, U_SOC.AU4, U_SOC.AU8, U_SOC.AU16, U_SOC.AU18, U_SOC.AU19, U_SOC.AU21, U_SOC.AU24, U_SOC.AU25, U_SOC.AU27, U_SOC.AU28, U_SOC.AU29, U_SOC.AU31, U_SOC.AU35, U_SOC.AU38, U_SOC.AU39, U_SOC.AU40, U_SOC.AV5, U_SOC.AV8, U_SOC.AV9, U_SOC.AV12, U_SOC.AV14, U_SOC.AV15, U_SOC.AV16, U_SOC.AV21, U_SOC.AV25, U_SOC.AV29, U_SOC.AV32, U_SOC.AV33, U_SOC.AV36, U_SOC.AV41, U_SOC.AW3, U_SOC.AW4, U_SOC.AW8, U_SOC.AW9, U_SOC.AW12, U_SOC.AW14, U_SOC.AW16, U_SOC.AW17, U_SOC.AW21, U_SOC.AW25, U_SOC.AW28, U_SOC.AW29, U_SOC.AW32, U_SOC.AW33, U_SOC.AW36, U_SOC.AW40, U_SOC.AY2, U_SOC.AY4, U_SOC.AY5, U_SOC.AY7, U_SOC.AY8, U_SOC.AY9, U_SOC.AY12, U_SOC.AY14, U_SOC.AY16, U_SOC.AY17, U_SOC.AY18, U_SOC.AY21, U_SOC.AY22, U_SOC.AY23, U_SOC.AY25, U_SOC.AY28, U_SOC.AY29, U_SOC.AY32, U_SOC.AY33, U_SOC.AY36, U_SOC.AY37, U_SOC.AY39, U_SOC.AY41, U_SOC.B3, U_SOC.B5, U_SOC.B8, U_SOC.B10, U_SOC.B11, U_SOC.B14, U_SOC.B17, U_SOC.B19, U_SOC.B21, U_SOC.B23, U_SOC.B26, U_SOC.B27, U_SOC.B29, U_SOC.B31, U_SOC.B34, U_SOC.B35, U_SOC.B36, U_SOC.B38, U_SOC.B40, U_SOC.B42, U_SOC.BA3, U_SOC.BA6, U_SOC.BA9, U_SOC.BA12, U_SOC.BA15, U_SOC.BA18, U_SOC.BA21, U_SOC.BA24, U_SOC.BA27, U_SOC.BA30, U_SOC.BA33, U_SOC.BA36, U_SOC.BB1, U_SOC.BB42, U_SOC.C2, U_SOC.C6, U_SOC.C7, U_SOC.C9, U_SOC.C11, U_SOC.C12, U_SOC.C14, U_SOC.C15, U_SOC.C18, U_SOC.C19, U_SOC.C20, U_SOC.C22, U_SOC.C24, U_SOC.C26, U_SOC.C28, U_SOC.C30, U_SOC.C35, U_SOC.C37, U_SOC.C39, U_SOC.C41, U_SOC.D3, U_SOC.D4, U_SOC.D7, U_SOC.D11, U_SOC.D14, U_SOC.D15, U_SOC.D18, U_SOC.D19, U_SOC.D22, U_SOC.D26, U_SOC.D30, U_SOC.D31, U_SOC.D32, U_SOC.E2, U_SOC.E5, U_SOC.E6, U_SOC.E8, U_SOC.E9, U_SOC.E10, U_SOC.E12, U_SOC.E16, U_SOC.E18, U_SOC.E19, U_SOC.E21, U_SOC.E23, U_SOC.E25, U_SOC.E27, U_SOC.E30, U_SOC.E31, U_SOC.E33, U_SOC.E34, U_SOC.E37, U_SOC.E38, U_SOC.E39, U_SOC.E40, U_SOC.F2, U_SOC.F3, U_SOC.F4, U_SOC.F8, U_SOC.F9, U_SOC.F10, U_SOC.F13, U_SOC.F14, U_SOC.F15, U_SOC.F16, U_SOC.F19, U_SOC.F21, U_SOC.F23, U_SOC.F29, U_SOC.F31, U_SOC.F33, U_SOC.F34, U_SOC.F35, U_SOC.F36, U_SOC.F38, U_SOC.F39, U_SOC.F40, U_SOC.G3, U_SOC.G6, U_SOC.G8, U_SOC.G9, U_SOC.G10, U_SOC.G12, U_SOC.G20, U_SOC.G21, U_SOC.G22, U_SOC.G25, U_SOC.G26, U_SOC.G29, U_SOC.G36, U_SOC.G41, U_SOC.H3, U_SOC.H4, U_SOC.H5, U_SOC.H6, U_SOC.H11, U_SOC.H12, U_SOC.H22, U_SOC.H25, U_SOC.H29, U_SOC.H37, U_SOC.H40, U_SOC.J2, U_SOC.J6, U_SOC.J7, U_SOC.J8, U_SOC.J9, U_SOC.J10, U_SOC.J12, U_SOC.J14, U_SOC.J15, U_SOC.J16, U_SOC.J22, U_SOC.J24, U_SOC.J26, U_SOC.J29, U_SOC.J30, U_SOC.J31, U_SOC.J38, U_SOC.J39, U_SOC.J40, U_SOC.K3, U_SOC.K6, U_SOC.K7, U_SOC.K10, U_SOC.K11, U_SOC.K12, U_SOC.K14, U_SOC.K17, U_SOC.K22, U_SOC.K23, U_SOC.K25, U_SOC.K26, U_SOC.K31, U_SOC.K32, U_SOC.K33, U_SOC.K34, U_SOC.K35, U_SOC.K36, U_SOC.K37, U_SOC.K38, U_SOC.K39, U_SOC.K40, U_SOC.L2, U_SOC.L3, U_SOC.L5, U_SOC.L6, U_SOC.L10, U_SOC.L11, U_SOC.L12, U_SOC.L14, U_SOC.L22, U_SOC.L23, U_SOC.L24, U_SOC.L32, U_SOC.L33, U_SOC.L34, U_SOC.L35, U_SOC.L36, U_SOC.L41, U_SOC.M2, U_SOC.M5, U_SOC.M8, U_SOC.M9, U_SOC.M10, U_SOC.M12, U_SOC.M14, U_SOC.M17, U_SOC.M19, U_SOC.M21, U_SOC.M22, U_SOC.M23, U_SOC.M33, U_SOC.M34, U_SOC.M35, U_SOC.M36, U_SOC.N3, U_SOC.N7, U_SOC.N9, U_SOC.N11, U_SOC.N12, U_SOC.N15, U_SOC.N16, U_SOC.N17, U_SOC.N18, U_SOC.N21, U_SOC.N22, U_SOC.N33, U_SOC.N34, U_SOC.N38, U_SOC.N39, U_SOC.N40, U_SOC.P2, U_SOC.P6, U_SOC.P7, U_SOC.P8, U_SOC.P9, U_SOC.P12, U_SOC.P16, U_SOC.P17, U_SOC.P18, U_SOC.P19, U_SOC.P25, U_SOC.P26, U_SOC.P27, U_SOC.P28, U_SOC.P29, U_SOC.P30, U_SOC.P31, U_SOC.P32, U_SOC.P33, U_SOC.P34, U_SOC.R3, U_SOC.R4, U_SOC.R8, U_SOC.R16, U_SOC.R20, U_SOC.R21, U_SOC.R25, U_SOC.R35, U_SOC.T2, U_SOC.T3, U_SOC.T4, U_SOC.T7, U_SOC.T16, U_SOC.T17, U_SOC.T18, U_SOC.T20, U_SOC.T21, U_SOC.T24, U_SOC.T25, U_SOC.T35, U_SOC.T36, U_SOC.T37, U_SOC.T38, U_SOC.T39, U_SOC.T40, U_SOC.U6, U_SOC.U7, U_SOC.U8, U_SOC.U16, U_SOC.U17, U_SOC.U18, U_SOC.U20, U_SOC.U21, U_SOC.U22, U_SOC.U23, U_SOC.U24, U_SOC.U25, U_SOC.U39, U_SOC.U40, U_SOC.U41, U_SOC.V3, U_SOC.V6, U_SOC.V7, U_SOC.V8, U_SOC.V16, U_SOC.V17, U_SOC.V19, U_SOC.V23, U_SOC.V24, U_SOC.V25, U_SOC.V30, U_SOC.V31, U_SOC.V32, U_SOC.V33, U_SOC.V34, U_SOC.V38, U_SOC.V39, U_SOC.V40, U_SOC.V41, U_SOC.W2, U_SOC.W5, U_SOC.W7, U_SOC.W8, U_SOC.W9, U_SOC.W18, U_SOC.W19, U_SOC.W22, U_SOC.W23, U_SOC.W24, U_SOC.W26, U_SOC.Y3, U_SOC.Y4, U_SOC.Y5, U_SOC.Y6, U_SOC.Y11, U_SOC.Y18, U_SOC.Y19, U_SOC.Y22, U_SOC.Y23, U_SOC.Y24, U_SOC.Y28, U_SOC.Y29, U_SOC.Y30, U_SOC.Y31, U_SOC.Y32, Y1.2, Y1.4
HDMI_eDP_TX0_REXT: R51.1, U_SOC.AY3
I2C0_SCL: R34.2, U4.A3, U5.A3, U_SOC.AH41
I2C0_SDA: R35.2, U4.B1, U5.B1, U_SOC.AG41
I2C2_SCL: R36.2, U6.A3, U_SOC.AK39
I2C2_SDA: R37.2, U6.B1, U_SOC.AM40
MIPI_DC_PHY0_VREG: C275.1, U_SOC.AT33
MIPI_DC_PHY1_VREG: C276.1, U_SOC.AT27
NLDO_EN: C111.1, R38.2, U7.1
NLDO_FB: C113.2, R39.2, R40.1, U7.5
NLDO_LX: L16.1, U7.3
NPU_LX: L15.1, U6.D3, U6.D4, U6.E3, U6.E4
PMIC_EXT_EN: R38.1, U_PMIC.39
PMIC_FB6: C66.2, R14.2, R15.1, U_PMIC.31
PMIC_FB9: C67.2, R16.2, R17.1, U_PMIC.66
PMIC_INT_L: R24.2, U_PMIC.19, U_SOC.W42
PMIC_NLDO5: C77.1, U_PMIC.8
PMIC_PWRCTRL2: R23.1, U_PMIC.61
PMIC_PWRCTRL3: R22.1, U_PMIC.16
PMIC_RESET_L: C86.1, C272.1, R25.2, R46.2, U_PMIC.40, U_SOC.V42
PMIC_SLEEP1: U_PMIC.62, U_SOC.W41
PMIC_SPI_CLK: R47.2, U_PMIC.17
PMIC_SPI_CLK_SOC: R47.1, U_SOC.Y39
PMIC_SPI_CS: R21.1, U_PMIC.18, U_SOC.W40
PMIC_SPI_MOSI: R48.2, U_PMIC.15
PMIC_SPI_MOSI_SOC: R48.1, U_SOC.W39
PMIC_SW1: L3.1, U_PMIC.50, U_PMIC.51
PMIC_SW2: L4.1, U_PMIC.35, U_PMIC.36
PMIC_SW3: L5.1, U_PMIC.55
PMIC_SW4: L6.1, U_PMIC.23
PMIC_SW5: L7.1, U_PMIC.45
PMIC_SW6: L8.1, U_PMIC.29
PMIC_SW7: L9.1, U_PMIC.42
PMIC_SW8: L10.1, U_PMIC.6
PMIC_SW9: L11.1, U_PMIC.68
PMIC_SW10: L12.1, U_PMIC.26
PMIC_VCCIO: C82.1, U_PMIC.20
PMIC_VDC: C84.1, R19.2, R20.1, U_PMIC.32
PMIC_VDC_K: C83.2, D3.1, R19.1
PWRON_L: C85.1, J_B2B2.41, U_PMIC.4
RECOVERY_KEY: C274.1, J_B2B2.43, R50.2, U_SOC.AY13
RT_BOOT0: J_B2B2.45, R80.1, U_SOC.U37
RT_CS_n: J_B2B2.47, U_SOC.M39
RT_IRQ: J_B2B2.49, U_SOC.G37
RT_MISO: J_B2B2.51, U_SOC.G39
RT_MOSI: J_B2B2.53, U_SOC.M38
RT_NRST: J_B2B2.55, U_SOC.H38
RT_RX: J_B2B2.57, U_SOC.L40
RT_SCK: J_B2B2.59, U_SOC.M37
RT_TX: J_B2B2.61, U_SOC.G40
S0_3V3_EN: R41.2, R42.1, U8.4
SARADC_IN0_BOOT: C273.1, R49.2, U_SOC.AW15
SGM_OCB: R43.1, U8.3
SOC_UART2_RX: J_B2B2.63, U_SOC.AH40
SOC_UART2_TX: J_B2B2.65, U_SOC.AH39
SOC_ZQ_0A: R66.1, U_SOC.AM1
SOC_ZQ_0B: R67.1, U_SOC.C1
SOC_ZQ_1C: R68.1, U_SOC.A5
SOC_ZQ_1D: R69.1, U_SOC.A40
TSADC_SHUT: R46.1, U_SOC.AC39
TYPEC0_DP0_REXT: R52.1, U_SOC.AW11
TYPEC0_USB20_OTG0_REXT: R53.1, U_SOC.AU7
USB20_HOST0_REXT: R54.1, U_SOC.AW5
USB20_HOST1_REXT: R55.1, U_SOC.AU6
USB_OTG_DM: J_B2B1.65, U_SOC.AY10
USB_OTG_DP: J_B2B1.63, U_SOC.AY11
USB_VBUS: J_B2B2.25, J_B2B2.26, R74.1
USB_VBUSDET: R74.2, R75.1, U_SOC.AV10
VCC1V8_PMU_DDR_S3: C219.1, C220.1, C277.1, C278.1, C279.1, C298.1, C299.1, C300.1, R26.2, U_DRAM0.F1, U_DRAM0.F12, U_DRAM0.G4, U_DRAM0.G9, U_DRAM0.T4, U_DRAM0.T9, U_DRAM0.U1, U_DRAM0.U12, U_DRAM1.F1, U_DRAM1.F12, U_DRAM1.G4, U_DRAM1.G9, U_DRAM1.T4, U_DRAM1.T9, U_DRAM1.U1, U_DRAM1.U12, U_SOC.N37, U_SOC.R36, U_SOC.V37, U_SOC.Y37
VCCA_1V8_S0: C69.1, C224.1, C225.1, C226.1, C227.1, C228.1, C229.1, C230.1, C231.1, C232.1, C233.1, C234.1, C235.1, C236.1, R28.1, R49.1, R50.1, U_PMIC.58, U_SOC.AB25, U_SOC.AK12, U_SOC.AL14, U_SOC.AM35, U_SOC.AP23, U_SOC.AR23, U_SOC.G34, U_SOC.H34, U_SOC.N35, U_SOC.N36
VCCA_3V3_S0: C71.1, C269.1, U_PMIC.63, U_SOC.AT10
VCCIO_SD_S0: C72.1, C265.1, U_PMIC.65, U_SOC.AK10
VCC_1V1_NLDO_S3: C80.1, C81.1, C113.1, C114.1, C115.1, L16.2, R39.1, U_PMIC.9, U_PMIC.13
VCC_1V8_S0: C68.1, C256.1, C257.1, C258.1, C259.1, C260.1, C261.1, C262.1, C263.1, R41.1, U_PMIC.60, U_SOC.AF36, U_SOC.AJ34, U_SOC.AK11, U_SOC.AT13, U_SOC.AT14, U_SOC.G27, U_SOC.G28, U_SOC.H31
VCC_1V8_S3: C64.1, C65.1, C264.1, C323.1, C324.1, L12.2, R24.1, R25.1, R26.1, R71.1, U_EMMC.C6, U_EMMC.M4, U_EMMC.N4, U_EMMC.P3, U_EMMC.P5, U_PMIC.25, U_SOC.AB35, U_SOC.AC35
VCC_2V0_PLDO_S3: C55.1, C56.1, C78.1, L9.2, U_PMIC.41, U_PMIC.59
VCC_3V3_PMU: C221.1, R27.2, R34.1, R35.1, R36.1, R37.1, U_SOC.V35, U_SOC.V36
VCC_3V3_S0: C117.1, C266.1, C267.1, C268.1, C325.1, C326.1, J_B2B2.21, J_B2B2.22, J_B2B2.23, J_B2B2.24, R76.1, R77.1, R78.1, R79.1, U8.1, U_SOC.AC33, U_SOC.AC34, U_SOC.AL33, U_SOC.AM33, U_SOC.G31
VCC_3V3_S3: C58.1, C59.1, C116.1, C321.1, C322.1, L10.2, R27.1, R32.1, U8.5, U_EMMC.E6, U_EMMC.F5, U_EMMC.J10, U_EMMC.K9, U_PMIC.5
VCC_SYSIN: C24.1, C25.1, C26.1, C27.1, C28.1, C33.1, C38.1, C43.1, C48.1, C51.1, C54.1, C57.1, C60.1, C63.1, C79.1, C83.1, C87.1, C88.1, C95.1, C96.1, C103.1, C104.1, C112.1, J_B2B2.1, J_B2B2.2, J_B2B2.3, J_B2B2.4, J_B2B2.5, J_B2B2.6, J_B2B2.7, J_B2B2.8, J_B2B2.9, J_B2B2.10, J_B2B2.11, J_B2B2.12, J_B2B2.13, J_B2B2.14, J_B2B2.15, J_B2B2.16, J_B2B2.17, J_B2B2.18, J_B2B2.19, J_B2B2.20, U4.D1, U4.D2, U4.E1, U4.E2, U5.D1, U5.D2, U5.E1, U5.E2, U6.D1, U6.D2, U6.E1, U6.E2, U7.4, U_PMIC.1, U_PMIC.7, U_PMIC.21, U_PMIC.22, U_PMIC.27, U_PMIC.28, U_PMIC.33, U_PMIC.34, U_PMIC.43, U_PMIC.44, U_PMIC.52, U_PMIC.53, U_PMIC.54, U_PMIC.64
VDD2_DDR_S3: C52.1, C53.1, C66.1, C213.1, C214.1, C280.1, C281.1, C282.1, C283.1, C284.1, C285.1, C286.1, C287.1, C288.1, C289.1, C301.1, C302.1, C303.1, C304.1, C305.1, C306.1, C307.1, C308.1, C309.1, C310.1, L8.2, R14.1, R59.1, R60.1, R64.1, R65.1, U_DRAM0.A4, U_DRAM0.A9, U_DRAM0.AB4, U_DRAM0.AB9, U_DRAM0.F5, U_DRAM0.F8, U_DRAM0.H1, U_DRAM0.H5, U_DRAM0.H8, U_DRAM0.H12, U_DRAM0.K1, U_DRAM0.K3, U_DRAM0.K10, U_DRAM0.K12, U_DRAM0.N1, U_DRAM0.N3, U_DRAM0.N10, U_DRAM0.N12, U_DRAM0.R1, U_DRAM0.R5, U_DRAM0.R8, U_DRAM0.R12, U_DRAM0.U5, U_DRAM0.U8, U_DRAM1.A4, U_DRAM1.A9, U_DRAM1.AB4, U_DRAM1.AB9, U_DRAM1.F5, U_DRAM1.F8, U_DRAM1.H1, U_DRAM1.H5, U_DRAM1.H8, U_DRAM1.H12, U_DRAM1.K1, U_DRAM1.K3, U_DRAM1.K10, U_DRAM1.K12, U_DRAM1.N1, U_DRAM1.N3, U_DRAM1.N10, U_DRAM1.N12, U_DRAM1.R1, U_DRAM1.R5, U_DRAM1.R8, U_DRAM1.R12, U_DRAM1.U5, U_DRAM1.U8, U_PMIC.30, U_SOC.G24, U_SOC.M6, U_SOC.M7
VDDA_0V75_S0: C75.1, C237.1, C238.1, C239.1, C240.1, C241.1, C242.1, C243.1, C244.1, C245.1, C246.1, C247.1, C248.1, U_PMIC.11, U_SOC.AM13, U_SOC.AM37, U_SOC.AN8, U_SOC.AN10, U_SOC.AN12, U_SOC.AR27, U_SOC.AR33, U_SOC.AT11, U_SOC.AT12, U_SOC.Y26
VDDA_0V85_S0: C76.1, C249.1, C250.1, C251.1, C252.1, C253.1, U_PMIC.10, U_SOC.AP18, U_SOC.AR19, U_SOC.AT18, U_SOC.H36, U_SOC.J36
VDDA_1V2_S0: C70.1, C254.1, C255.1, U_PMIC.57
VDDA_DDR_PLL_S0: C74.1, C215.1, C216.1, U_PMIC.12, U_SOC.AB14, U_SOC.M16
VDDQ_DDR_S0: C61.1, C62.1, C67.1, C203.1, C204.1, C205.1, C206.1, C207.1, C208.1, C209.1, C210.1, C211.1, C212.1, C290.1, C291.1, C292.1, C293.1, C294.1, C295.1, C296.1, C297.1, C311.1, C312.1, C313.1, C314.1, C315.1, C316.1, C317.1, C318.1, L11.2, R16.1, R58.2, R63.2, R66.2, R67.2, R68.2, R69.2, U_DRAM0.AA3, U_DRAM0.AA5, U_DRAM0.AA8, U_DRAM0.AA10, U_DRAM0.B3, U_DRAM0.B5, U_DRAM0.B8, U_DRAM0.B10, U_DRAM0.D1, U_DRAM0.D5, U_DRAM0.D8, U_DRAM0.D12, U_DRAM0.F3, U_DRAM0.F10, U_DRAM0.U3, U_DRAM0.U10, U_DRAM0.W1, U_DRAM0.W5, U_DRAM0.W8, U_DRAM0.W12, U_DRAM1.AA3, U_DRAM1.AA5, U_DRAM1.AA8, U_DRAM1.AA10, U_DRAM1.B3, U_DRAM1.B5, U_DRAM1.B8, U_DRAM1.B10, U_DRAM1.D1, U_DRAM1.D5, U_DRAM1.D8, U_DRAM1.D12, U_DRAM1.F3, U_DRAM1.F10, U_DRAM1.U3, U_DRAM1.U10, U_DRAM1.W1, U_DRAM1.W5, U_DRAM1.W8, U_DRAM1.W12, U_PMIC.67, U_SOC.H14, U_SOC.H15, U_SOC.H16, U_SOC.H18, U_SOC.H20, U_SOC.H24, U_SOC.K9, U_SOC.L9, U_SOC.P10, U_SOC.R10, U_SOC.T10, U_SOC.V10, U_SOC.W10, U_SOC.Y10
VDD_0V75_S3: C73.1, C222.1, C223.1, U_PMIC.14, U_SOC.AJ36, U_SOC.AJ37
VDD_CPU_BIG0_MEM_S0: C118.1, FB1.2, U_SOC.K27, U_SOC.K28, U_SOC.K29, U_SOC.K30
VDD_CPU_BIG0_S0: C89.1, C90.1, C91.1, C92.1, C93.1, C94.1, C124.1, C125.1, C126.1, C127.1, C128.1, C129.1, C130.1, C131.1, C132.1, C133.1, FB1.1, L13.2, R29.1, U4.A4, U_SOC.M24, U_SOC.M25, U_SOC.M28, U_SOC.M29, U_SOC.M30, U_SOC.N24, U_SOC.N25, U_SOC.P23, U_SOC.R23, U_SOC.R24
VDD_CPU_BIG1_MEM_S0: C119.1, FB2.2, U_SOC.V26, U_SOC.V27, U_SOC.V28, U_SOC.V29
VDD_CPU_BIG1_S0: C97.1, C98.1, C99.1, C100.1, C101.1, C102.1, C134.1, C135.1, C136.1, C137.1, C138.1, C139.1, C140.1, C141.1, C142.1, C143.1, FB2.1, L14.2, R30.1, U5.A4, U_SOC.R26, U_SOC.R27, U_SOC.R28, U_SOC.R29, U_SOC.R30, U_SOC.R31, U_SOC.R32, U_SOC.R33, U_SOC.T26, U_SOC.U26
VDD_CPU_LIT_MEM_S0: C120.1, FB3.2, U_SOC.AA28, U_SOC.AA29, U_SOC.AA30
VDD_CPU_LIT_S0: C34.1, C35.1, C36.1, C37.1, C144.1, C145.1, C146.1, C147.1, C148.1, C149.1, C150.1, C151.1, C152.1, FB3.1, L4.2, R11.1, U_PMIC.37, U_SOC.AB31, U_SOC.AC27, U_SOC.AC28, U_SOC.AC29, U_SOC.AC30, U_SOC.AC31, U_SOC.AD26, U_SOC.AD27, U_SOC.AE27
VDD_DDR_S0: C49.1, C50.1, C195.1, C196.1, C197.1, C198.1, C199.1, C200.1, C201.1, C202.1, L7.2, R18.1, U_PMIC.46, U_SOC.J18, U_SOC.J20, U_SOC.K18, U_SOC.K20, U_SOC.L18, U_SOC.L20, U_SOC.T12, U_SOC.T13, U_SOC.U12, U_SOC.U13, U_SOC.V12, U_SOC.V13, U_SOC.V14
VDD_GPU_MEM_S0: C121.1, FB4.2, U_SOC.AJ18, U_SOC.AK18, U_SOC.AL18
VDD_GPU_S0: C29.1, C30.1, C31.1, C32.1, C153.1, C154.1, C155.1, C156.1, C157.1, C158.1, C159.1, C160.1, C161.1, C162.1, C163.1, C164.1, FB4.1, L3.2, R10.1, U_PMIC.49, U_SOC.AH18, U_SOC.AH19, U_SOC.AH20, U_SOC.AH21, U_SOC.AJ19, U_SOC.AJ20, U_SOC.AJ21, U_SOC.AK21, U_SOC.AL21, U_SOC.AM21, U_SOC.AM22, U_SOC.AN21, U_SOC.AN22
VDD_LOGIC_S0: C39.1, C40.1, C41.1, C42.1, C174.1, C175.1, C176.1, C177.1, C178.1, C179.1, C180.1, C181.1, C182.1, C183.1, C184.1, C185.1, C186.1, C187.1, L5.2, R12.1, U_PMIC.56, U_SOC.AF12, U_SOC.AF13, U_SOC.AH11, U_SOC.AH12, U_SOC.AH13, U_SOC.AH14, U_SOC.AH15, U_SOC.AH23, U_SOC.AH24, U_SOC.AJ15, U_SOC.AJ31, U_SOC.AJ32, U_SOC.AK15, U_SOC.AL31, U_SOC.H27, U_SOC.J27, U_SOC.W33, U_SOC.Y33
VDD_NPU_MEM_S0: C122.1, FB5.2, U_SOC.AH25, U_SOC.AH26, U_SOC.AJ25, U_SOC.AK25
VDD_NPU_S0: C105.1, C106.1, C107.1, C108.1, C109.1, C110.1, C165.1, C166.1, C167.1, C168.1, C169.1, C170.1, C171.1, C172.1, C173.1, FB5.1, L15.2, R31.1, U6.A4, U_SOC.AK27, U_SOC.AK28, U_SOC.AK29, U_SOC.AL28, U_SOC.AL29, U_SOC.AL30, U_SOC.AM30, U_SOC.AN30, U_SOC.AP30
VDD_VDENC_MEM_S0: C123.1, FB6.2, U_SOC.W17, U_SOC.Y17
VDD_VDENC_S0: C44.1, C45.1, C46.1, C47.1, C188.1, C189.1, C190.1, C191.1, C192.1, C193.1, C194.1, FB6.1, L6.2, R13.1, U_PMIC.24, U_SOC.AC16, U_SOC.AD15, U_SOC.P15, U_SOC.R15, U_SOC.T15, U_SOC.U15, U_SOC.W16
VSEL2: U4.A1, U_SOC.AD39
VSEL3: U6.A1, U_SOC.AM38
VSEL4: R22.2, U_SOC.AG36
VSEL5: R23.2, U_SOC.AH38
VSEL6: U5.A1, U_SOC.AG42
XIN_24M: C271.1, R45.2, U_SOC.T41, Y1.3
XOUT_24M: R44.1, R45.1, U_SOC.T42
XOUT_X1: C270.1, R44.2, Y1.1
