muni-works/rose/electronics/brain/carrier.kicad_pcb

## KiCad design electronics/brain/carrier.kicad_pcb (2026-10-17)

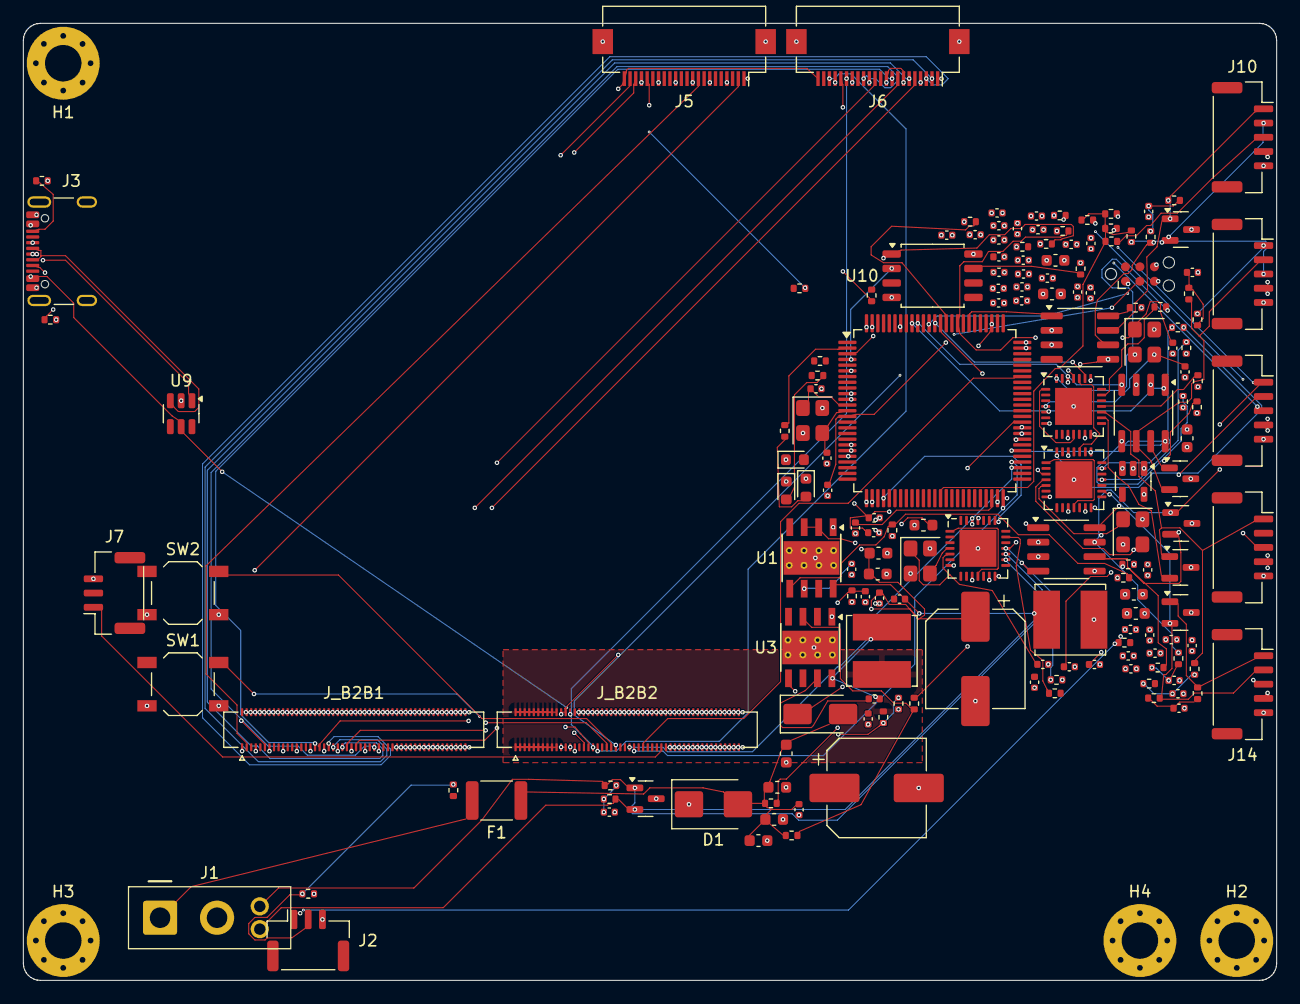
[picture p309: board carrier.kicad_pcb from above]

Board: 6 copper layers, 110.0 x 84.0 mm, 169 parts (0 on the bottom side), 153 nets.

Parts:
C1, C2, C8, C9, C21, C22: 10u 25V; C_0603_1608Metric
C3, C4: 470u 25V; CP_Elec_8x10.5
C5: 10n; C_0402_1005Metric
C6, C10, C14, C19, C23, C327, C328, C329, C330, C331, C332, C333, C334, C337, C340, C343, C344, C345, C346, C347, C348, C349, C352, C353, C354, C357, C358, C359, C362, C363, C364: 100n; C_0402_1005Metric
C7, C15, C16, C17, C20, C336: 1u; C_0402_1005Metric
C11, C12, C13: 22u; C_0603_1608Metric
C18: 10u; C_0603_1608Metric
C335: 4.7u; C_0603_1608Metric
C338, C339: 2.2u; C_0402_1005Metric
C341, C342: 10p; C_0402_1005Metric
C350, C351, C355, C356, C360, C361: 12p; C_0402_1005Metric
C365, C366, C367, C368, C369, C370: 4.7n; C_0402_1005Metric
D1: SMBJ15A; D_SMB
D2: SS34; D_SMA
D4: status R; LED_0603_1608Metric
D5: status G; LED_0603_1608Metric
D6: status B; LED_0603_1608Metric
D7, D8, D9, D10, D11, D12: PESD2CAN; SOT-23
F1: 6A hold 16V (1812); Fuse_1812_4532Metric
FB7: 600R@100MHz; L_0603_1608Metric
H1, H2, H3, H4: M3; MountingHole_3.2mm_M3_Pad_Via
J1: XT30PB(2+2)-M 12V + BMS CAN from spine; AMASS_XT30PB_2+2_M
J2: GH e-stop + pack status from spine; JST_GH_SM03B-GHS-TB_1x03-1MP_P1.25mm_Horizontal
J3: USB-C (device); USB_C_Receptacle_GCT_USB4105-xx-A_16P_TopMnt_Horizontal
J5: camera 0 (22-pin 0.5 mm, Pi CSI-2 4-lane); Hirose_FH12-22S-0.5SH_1x22-1MP_P0.50mm_Horizontal
J6: camera 1 (22-pin 0.5 mm, Pi CSI-2 4-lane); Hirose_FH12-22S-0.5SH_1x22-1MP_P0.50mm_Horizontal
J7: SoC console (UART2, 1.5 Mbaud); JST_GH_SM03B-GHS-TB_1x03-1MP_P1.25mm_Horizontal
J8: TC2030 SWD; Tag-Connect_TC2030-IDC-NL_2x03_P1.27mm_Vertical
J10: GH limb port: left arm (bus 0); JST_GH_SM05B-GHS-TB_1x05-1MP_P1.25mm_Horizontal
J11: GH limb port: right arm (bus 1); JST_GH_SM05B-GHS-TB_1x05-1MP_P1.25mm_Horizontal
J12: GH limb port: left leg (bus 2); JST_GH_SM05B-GHS-TB_1x05-1MP_P1.25mm_Horizontal
J13: GH limb port: right leg (bus 3); JST_GH_SM05B-GHS-TB_1x05-1MP_P1.25mm_Horizontal
J14: GH limb port: head (bus 4); JST_GH_SM05B-GHS-TB_1x05-1MP_P1.25mm_Horizontal
J_B2B1, J_B2B2: DF40C-100DS socket; Hirose_DF40C-100DS-0.4V_2x50_P0.4mm
L1: 6.8u; L_Bourns_SRN6045TA
L2: 3.3u; L_Bourns_SRN6045TA
R1, R2, R89, R90, R91, R92, R93, R94, R95, R97, R98, R100, R101, R103: 10k; R_0402_1005Metric
R3, R5, R7, R9: 100k; R_0402_1005Metric
R4: 22k; R_0402_1005Metric
R6, R8: 24.9k; R_0402_1005Metric
R72, R73: 5.1k; R_0402_1005Metric
R81, R82, R83, R84, R85, R86, R87, R88: 1k; R_0402_1005Metric
R96, R99, R102: 0; R_0402_1005Metric
R104, R105, R106, R107, R108, R109, R110, R111, R112, R113, R114, R115: 60.4; R_0402_1005Metric
R116, R117, R118, R119, R120: 22R; R_0402_1005Metric
SW1: power key; SW_SPST_TL3342
SW2: maskrom/recovery; SW_SPST_TL3342
U1: LMR33610ADDAR; Texas_HSOP-8-1EP_3.9x4.9mm_P1.27mm_ThermalVias
U2: AP2112K-3.3; SOT-23-5
U3: LMR33640ADDA; Texas_HSOP-8-1EP_3.9x4.9mm_P1.27mm_ThermalVias
U9: USBLC6-2SC6; SOT-23-6
U10: W25Q128JVS; SOIC-8_5.3x5.3mm_P1.27mm
U11, U12, U13: MCP2562FD-E/SN; SOIC-8_3.9x4.9mm_P1.27mm
U14, U15, U16: MCP251863T-E/9PX; VQFN-28-1EP_5x5mm_P0.5mm_EP3.25x3.25mm
U_RT: STM32H723VGT6; LQFP-100_14x14mm_P0.5mm
Y2: 25MHz; Crystal_SMD_3225-4Pin_3.2x2.5mm
Y3, Y4, Y5: 40MHz; Crystal_SMD_3225-4Pin_3.2x2.5mm

Connections:
3V3_RT: C16.1, C17.1, C18.1, C327.1, C328.1, C329.1, C330.1, C331.1, C332.1, C333.1, C334.1, C335.1, C343.1, C345.1, C347.1, C349.1, C352.1, C353.1, C357.1, C358.1, C362.1, C363.1, FB7.1, J8.1, R89.1, R90.1, R91.1, R97.1, R100.1, R103.1, U2.5, U10.8, U11.5, U12.5, U13.5, U14.14, U14.26, U15.14, U15.26, U16.14, U16.26, U_RT.6, U_RT.11, U_RT.20, U_RT.27, U_RT.50, U_RT.75, U_RT.100
5V_RT: C11.1, C12.1, C13.1, C14.1, C15.1, C344.1, C346.1, C348.1, C354.1, C359.1, C364.1, L1.2, R5.1, U2.1, U2.3, U11.3, U12.3, U13.3, U14.13, U15.13, U16.13
12V: C1.1, C2.1, C21.1, C22.1, C23.1, D1.2, D2.2, F1.2, R3.1, R9.1, U3.2
12V_IN: F1.1, J1.1
12V_RT: C3.1, C4.1, C8.1, C9.1, C10.1, D2.1, U1.2, U1.3
BB_CS_n: R91.2, U10.1, U_RT.3
BB_HOLD_n: R90.2, U10.7
BB_MISO: U10.2, U_RT.4
BB_MOSI: U10.5, U_RT.5
BB_SCK: U10.6, U_RT.1
BB_WP_n: R89.2, U10.3
CAM0_CN: J5.8, J_B2B1.5
CAM0_CP: J5.9, J_B2B1.3
CAM0_D0N: J5.2, J_B2B1.11
CAM0_D0P: J5.3, J_B2B1.9
CAM0_D1N: J5.5, J_B2B1.17
CAM0_D1P: J5.6, J_B2B1.15
CAM0_D2N: J5.11, J_B2B1.23
CAM0_D2P: J5.12, J_B2B1.21
CAM0_D3N: J5.14, J_B2B1.29
CAM0_D3P: J5.15, J_B2B1.27
CAM0_PWDN: J5.17, J_B2B2.29
CAM0_SCL: J5.20, J_B2B2.31
CAM0_SDA: J5.21, J_B2B2.33
CAM0_TRIG: J5.18, R87.2
CAM0_TRIG_RT: R87.1, U_RT.41
CAM1_CN: J6.8, J_B2B1.35
CAM1_CP: J6.9, J_B2B1.33
CAM1_D0N: J6.2, J_B2B1.41
CAM1_D0P: J6.3, J_B2B1.39
CAM1_D1N: J6.5, J_B2B1.47
CAM1_D1P: J6.6, J_B2B1.45
CAM1_D2N: J6.11, J_B2B1.53
CAM1_D2P: J6.12, J_B2B1.51
CAM1_D3N: J6.14, J_B2B1.59
CAM1_D3P: J6.15, J_B2B1.57
CAM1_PWDN: J6.17, J_B2B2.35
CAM1_SCL: J6.20, J_B2B2.37
CAM1_SDA: J6.21, J_B2B2.39
CAM1_TRIG: J6.18, R88.2
CAM1_TRIG_RT: R88.1, U_RT.43
CAN0_H: D7.1, J10.1, R104.1, U11.7
CAN0_L: D7.2, J10.2, R105.2, U11.6
CAN0_RX: U11.4, U_RT.81
CAN0_STBY: R92.1, U11.8, U_RT.55
CAN0_TSPLIT: C365.1, R104.2, R105.1
CAN0_TX: U11.1, U_RT.82
CAN1_H: D8.1, J11.1, R106.1, U12.7
CAN1_L: D8.2, J11.2, R107.2, U12.6
CAN1_RX: U12.4, U_RT.91
CAN1_STBY: R93.1, U12.8, U_RT.56
CAN1_TSPLIT: C366.1, R106.2, R107.1
CAN1_TX: U12.1, U_RT.92
CAN2_H: D9.1, J12.1, R108.1, U13.7
CAN2_L: D9.2, J12.2, R109.2, U13.6
CAN2_RX: U13.4, U_RT.59
CAN2_STBY: R94.1, U13.8, U_RT.57
CAN2_TSPLIT: C367.1, R108.2, R109.1
CAN2_TX: U13.1, U_RT.60
CAN3_H: D10.1, J13.1, R110.1, U14.17
CAN3_L: D10.2, J13.2, R111.2, U14.16
CAN3_RXI: U14.1, U14.11
CAN3_STBY: R95.1, U14.18
CAN3_TSPLIT: C368.1, R110.2, R111.1
CAN3_TXD: R96.2, U14.28
CAN3_TXI: R96.1, U14.20
CAN4_H: D11.1, J14.1, R112.1, U15.17
CAN4_L: D11.2, J14.2, R113.2, U15.16
CAN4_RXI: U15.1, U15.11
CAN4_STBY: R98.1, U15.18
CAN4_TSPLIT: C369.1, R112.2, R113.1
CAN4_TXD: R99.2, U15.28
CAN4_TXI: R99.1, U15.20
CAN5_H: D12.1, J1.3, R114.1, U16.17
CAN5_L: D12.2, J1.4, R115.2, U16.16
CAN5_RXI: U16.1, U16.11
CAN5_STBY: R101.1, U16.18, U_RT.58
CAN5_TSPLIT: C370.1, R114.2, R115.1
CAN5_TXD: R102.2, U16.28
CAN5_TXI: R102.1, U16.20
CANX0_CS: R97.2, U14.25, U_RT.84
CANX0_INT: U14.3, U_RT.85
CANX0_OSC1: C350.1, U14.5, Y3.1
CANX0_OSC2: C351.1, U14.4, Y3.3
CANX1_CS: R100.2, U15.25, U_RT.86
CANX1_INT: U15.3, U_RT.87
CANX1_OSC1: C355.1, U15.5, Y4.1
CANX1_OSC2: C356.1, U15.4, Y4.3
CANX2_CS: R103.2, U16.25, U_RT.78
CANX2_INT: U16.3, U_RT.79
CANX2_OSC1: C360.1, U16.5, Y5.1
CANX2_OSC2: C361.1, U16.4, Y5.3
CANX_MISO: U14.24, U15.24, U16.24, U_RT.30
CANX_MOSI: U14.23, U15.23, U16.23, U_RT.88
CANX_SCK: U14.22, U15.22, U16.22, U_RT.29
ESTOP_OK: J2.1, J10.4, J11.4, J12.4, J13.4, J14.4, R1.1, R85.1
ESTOP_OK_RT: R85.2, U_RT.15
GND: C1.2, C2.2, C3.2, C4.2, C5.2, C7.2, C8.2, C9.2, C10.2, C11.2, C12.2, C13.2, C14.2, C15.2, C16.2, C17.2, C18.2, C20.2, C21.2, C22.2, C23.2, C327.2, C328.2, C329.2, C330.2, C331.2, C332.2, C333.2, C334.2, C335.2, C336.2, C337.2, C338.2, C339.2, C340.2, C341.2, C342.2, C343.2, C344.2, C345.2, C346.2, C347.2, C348.2, C349.2, C350.2, C351.2, C352.2, C353.2, C354.2, C355.2, C356.2, C357.2, C358.2, C359.2, C360.2, C361.2, C362.2, C363.2, C364.2, C365.2, C366.2, C367.2, C368.2, C369.2, C370.2, D1.1, D4.1, D5.1, D6.1, D7.3, D8.3, D9.3, D10.3, D11.3, D12.3, H1.1, H2.1, H3.1, H4.1, J1.2, J2.3, J3.A1, J3.A12, J3.B1, J3.B12, J3.S1, J5.1, J5.4, J5.7, J5.10, J5.13, J5.16, J5.19, J5.MP, J6.1, J6.4, J6.7, J6.10, J6.13, J6.16, J6.19, J6.MP, J7.3, J8.5, J10.5, J11.5, J12.5, J13.5, J14.5, J_B2B1.1, J_B2B1.2, J_B2B1.4, J_B2B1.6, J_B2B1.7, J_B2B1.8, J_B2B1.10, J_B2B1.12, J_B2B1.13, J_B2B1.14, J_B2B1.16, J_B2B1.18, J_B2B1.19, J_B2B1.20, J_B2B1.22, J_B2B1.24, J_B2B1.25, J_B2B1.26, J_B2B1.28, J_B2B1.30, J_B2B1.31, J_B2B1.32, J_B2B1.34, J_B2B1.36, J_B2B1.37, J_B2B1.38, J_B2B1.40, J_B2B1.42, J_B2B1.43, J_B2B1.44, J_B2B1.46, J_B2B1.48, J_B2B1.49, J_B2B1.50, J_B2B1.52, J_B2B1.54, J_B2B1.55, J_B2B1.56, J_B2B1.58, J_B2B1.60, J_B2B1.61, J_B2B1.62, J_B2B1.64, J_B2B1.66, J_B2B1.67, J_B2B1.68, J_B2B1.69, J_B2B1.70, J_B2B1.71, J_B2B1.72, J_B2B1.73, J_B2B1.74, J_B2B1.75, J_B2B1.76, J_B2B1.77, J_B2B1.78, J_B2B1.79, J_B2B1.80, J_B2B1.81, J_B2B1.82, J_B2B1.83, J_B2B1.84, J_B2B1.85, J_B2B1.86, J_B2B1.87, J_B2B1.88, J_B2B1.89, J_B2B1.90, J_B2B1.91, J_B2B1.92, J_B2B1.93, J_B2B1.94, J_B2B1.95, J_B2B1.96, J_B2B1.97, J_B2B1.98, J_B2B1.99, J_B2B1.100, J_B2B2.27, J_B2B2.28, J_B2B2.30, J_B2B2.32, J_B2B2.34, J_B2B2.36, J_B2B2.38, J_B2B2.40, J_B2B2.42, J_B2B2.44, J_B2B2.46, J_B2B2.48, J_B2B2.50, J_B2B2.52, J_B2B2.54, J_B2B2.56, J_B2B2.58, J_B2B2.60, J_B2B2.62, J_B2B2.64, J_B2B2.66, J_B2B2.67, J_B2B2.68, J_B2B2.69, J_B2B2.70, J_B2B2.71, J_B2B2.72, J_B2B2.73, J_B2B2.74, J_B2B2.75, J_B2B2.76, J_B2B2.77, J_B2B2.78, J_B2B2.79, J_B2B2.80, J_B2B2.81, J_B2B2.82, J_B2B2.83, J_B2B2.84, J_B2B2.85, J_B2B2.86, J_B2B2.87, J_B2B2.88, J_B2B2.89, J_B2B2.90, J_B2B2.91, J_B2B2.92, J_B2B2.93, J_B2B2.94, J_B2B2.95, J_B2B2.96, J_B2B2.97, J_B2B2.98, J_B2B2.99, J_B2B2.100, R1.2, R2.2, R4.2, R6.2, R8.2, R72.2, R73.2, R92.2, R93.2, R94.2, R95.2, R98.2, R101.2, SW1.2, SW2.2, U1.1, U1.9, U2.2, U3.1, U3.9, U9.2, U10.4, U11.2, U12.2, U13.2, U14.7, U14.10, U14.29, U15.7, U15.10, U15.29, U16.7, U16.10, U16.29, U_RT.10, U_RT.19, U_RT.26, U_RT.49, U_RT.74, U_RT.99, Y2.2, Y2.4, Y3.2, Y3.4, Y4.2, Y4.4, Y5.2, Y5.4
HSE_IN: C341.1, U_RT.12, Y2.1
HSE_OUT: C342.1, U_RT.13, Y2.3
LED_B: R83.1, U_RT.2
LED_B_A: D6.2, R83.2
LED_G: R82.1, U_RT.98
LED_G_A: D5.2, R82.2
LED_R: R81.1, U_RT.97
LED_R_A: D4.2, R81.2
PACK_OK: J2.2, R2.1, R86.1
PACK_OK_RT: R86.2, U_RT.16
PFAIL_DIV: C5.1, R3.2, R4.1, U_RT.22
PWRON_L: J_B2B2.41, SW1.1
RECOVERY_KEY: J_B2B2.43, SW2.1
RT_BOOT0: J_B2B2.45, U_RT.94
RT_CS_n: J_B2B2.47, U_RT.51
RT_IRQ: J_B2B2.49, U_RT.37
RT_MISO: J_B2B2.51, U_RT.53
RT_MOSI: J_B2B2.53, U_RT.54
RT_NRST: C340.1, J8.3, J_B2B2.55, U_RT.14
RT_RX: J_B2B2.57, U_RT.69
RT_SCK: J_B2B2.59, U_RT.52
RT_TX: J_B2B2.61, U_RT.68
SOC_PWR_EN: R9.2, R84.2, U3.3
SOC_PWR_EN_RT: R84.1, U_RT.61
SOC_UART2_RX: J7.2, J_B2B2.63
SOC_UART2_TX: J7.1, J_B2B2.65
SWCLK: J8.4, U_RT.76
SWDIO: J8.2, U_RT.72
SWO: J8.6, U_RT.89
SYNC0: J10.3, R116.2
SYNC1: J11.3, R117.2
SYNC2: J12.3, R118.2
SYNC3: J13.3, R119.2
SYNC4: J14.3, R120.2
SYNC_OUT: R116.1, R117.1, R118.1, R119.1, R120.1, U_RT.39
U1_BOOT: C6.1, U1.7
U1_FB: R5.2, R6.1, U1.5
U1_SW: C6.2, L1.1, U1.8
U1_VCC: C7.1, U1.6
U3_BOOT: C19.1, U3.7
U3_FB: R7.2, R8.1, U3.5
U3_SW: C19.2, L2.1, U3.8
U3_VCC: C20.1, U3.6
USB_CC1: J3.A5, R72.1
USB_CC2: J3.B5, R73.1
USB_C_DM: J3.A7, J3.B7, U9.3
USB_C_DP: J3.A6, J3.B6, U9.1
USB_OTG_DM: J_B2B1.65, U9.4
USB_OTG_DP: J_B2B1.63, U9.6
USB_VBUS: J3.A4, J3.A9, J3.B4, J3.B9, J_B2B2.25, J_B2B2.26, U9.5
VCAP1: C338.1, U_RT.48
VCAP2: C339.1, U_RT.73
VCC_3V3_S0: J5.22, J6.22, J_B2B2.21, J_B2B2.22, J_B2B2.23, J_B2B2.24
VCC_SYSIN: J_B2B2.1, J_B2B2.2, J_B2B2.3, J_B2B2.4, J_B2B2.5, J_B2B2.6, J_B2B2.7, J_B2B2.8, J_B2B2.9, J_B2B2.10, J_B2B2.11, J_B2B2.12, J_B2B2.13, J_B2B2.14, J_B2B2.15, J_B2B2.16, J_B2B2.17, J_B2B2.18, J_B2B2.19, J_B2B2.20, L2.2, R7.1
VDDA_RT: C336.1, C337.1, FB7.2, U_RT.21
