muni-works/rose/body/vcad_export.py

"""export the mini (or tiny) humanoid to vcad as a loon assembly: one rigid body per link, revolute joints at the
K1 limits. Plates are native sketch + extrude (outlines taken from the clipped, router-cut plates), motors and drums
are native cylinders, the bones / blocks / helmet / hands native lofts of their section rings; only the shells carved
by swept clearance cuts (relief) come in as meshes (import-mesh) in each body's frame.

    python vcad_export.py [mini|tiny] [explode,...]   ->  vcad/<variant>/<variant>[-explode-NNN].loon + stl/*.stl
"""
import os, sys
import numpy as np, trimesh
from manifold3d import Manifold, Mesh
import k1_structure as KS

REC = {}                                     # id(mesh) -> native description
KEEP = []                                    # recorded meshes stay alive, so ids are never reused


def _patch():
    import k1_design as KD
    m0 = KS.motor

    def motor(c, ax, mot):
        m = m0(c, ax, mot)
        REC[id(m)] = ('cyl', np.asarray(c, float), np.asarray(ax, float), KS.Q.MOTORS[mot]['D'] / 2, KS.Q.MOTORS[mot]['L'], 0.0); KEEP.append(m)
        return m
    KS.motor = motor
    c0 = KD.cyl

    def cyl(c, ax, r, h, sections=96):
        m = c0(c, ax, r, h, sections)
        REC[id(m)] = ('cyl', np.asarray(c, float), np.asarray(ax, float), r, h, 0.0); KEEP.append(m)
        return m
    KD.cyl = cyl
    h0 = KD.housing

    def housing(p, ax, mot, pad=KD.PAD, fil=KD.FIL, extra_len=6.0):
        body, caps, r, L = h0(p, ax, mot, pad, fil, extra_len)
        REC[id(body)] = ('cyl', np.asarray(p, float), np.asarray(ax, float), r, L, fil)
        a = np.asarray(ax, float) / np.linalg.norm(ax)
        REC[id(caps)] = ('caps', np.asarray(p, float), a, (r - fil) * 0.82, L, 1.6); KEEP.extend([body, caps])
        return body, caps, r, L
    KD.housing = housing
    return KD


MATS = {'cover': ('satin_black', 0.090, 0.094, 0.106, 0.1, 0.55), 'puck': ('municipal_orange', 1.0, 0.353, 0.039, 0.0, 0.45),
        'accent': ('municipal_orange', 1.0, 0.353, 0.039, 0.0, 0.45), 'trim': ('gunmetal', 0.30, 0.32, 0.34, 0.8, 0.35),
        'visor': ('visor_glass', 0.02, 0.02, 0.025, 0.2, 0.05), 'sole': ('sole_rubber', 0.17, 0.176, 0.19, 0.0, 0.9),
        'plate': ('aluminium', 0.75, 0.76, 0.78, 0.9, 0.3), 'motor': ('motor_dark', 0.08, 0.085, 0.09, 0.6, 0.4),
        'cable': ('cable_black', 0.03, 0.03, 0.035, 0.0, 0.7), 'cxdisplay': ('heatsink', 0.55, 0.57, 0.6, 0.7, 0.4), 'cxcam': ('pcb_green', 0.05, 0.32, 0.18, 0.1, 0.45), 'cxspk': ('motor_dark', 0.08, 0.085, 0.09, 0.6, 0.4), 'cxamp': ('pcb_green', 0.05, 0.32, 0.18, 0.1, 0.45), 'cxmic': ('pcb_green', 0.05, 0.32, 0.18, 0.1, 0.45), 'cxpower': ('pcb_green', 0.05, 0.32, 0.18, 0.1, 0.45), 'cxdock': ('motor_dark', 0.08, 0.085, 0.09, 0.6, 0.4), 'cxusbc': ('pcb_green', 0.05, 0.32, 0.18, 0.1, 0.45), 'dockplug': ('motor_dark', 0.08, 0.085, 0.09, 0.6, 0.4), 'cbat': ('cell_pack', 0.13, 0.22, 0.42, 0.1, 0.5), 'battery': ('cell_pack', 0.13, 0.22, 0.42, 0.1, 0.5), 'jetson': ('heatsink', 0.55, 0.57, 0.6, 0.7, 0.4),
        'limbic': ('pcb_green', 0.05, 0.32, 0.18, 0.1, 0.45), 'node': ('pcb_green', 0.05, 0.32, 0.18, 0.1, 0.45),
        'fan': ('motor_dark', 0.08, 0.085, 0.09, 0.6, 0.4), 'estopbody': ('motor_dark', 0.08, 0.085, 0.09, 0.6, 0.4),
        'brake': ('heatsink', 0.55, 0.57, 0.6, 0.7, 0.4), 'dock': ('motor_dark', 0.08, 0.085, 0.09, 0.6, 0.4), 'elrs': ('pcb_green', 0.05, 0.32, 0.18, 0.1, 0.45), 'bms': ('pcb_green', 0.05, 0.32, 0.18, 0.1, 0.45),
        'estophead': ('estop_red', 0.78, 0.04, 0.03, 0.0, 0.35), 'estopcollar': ('estop_yellow', 0.98, 0.78, 0.05, 0.0, 0.45)}


def mat_of(n):
    if n.startswith('elec-'):
        return n.split('-')[1].split('.')[0]
    if n.startswith('estop-'):
        return 'estop' + n.split('-')[1]
    if n.startswith('node-'):
        return 'node'
    k = n.split('-')[0].split('.')[0]
    if k in MATS:
        return k
    if n.startswith('rs'):
        return 'motor'
    return 'plate'


def f(v):
    return f'{v:.3f}'


def _basis(a):
    a = np.asarray(a, float) / np.linalg.norm(a)
    u = np.cross(a, [1.0, 0, 0] if abs(a[0]) < 0.9 else [0, 1.0, 0]); u /= np.linalg.norm(u)
    return a, u, np.cross(a, u)


def _circle(c, u, v, r, n=48):
    t = np.linspace(0, 2 * np.pi, n, endpoint=False)
    return c[None, :] + r * (np.cos(t)[:, None] * u[None, :] + np.sin(t)[:, None] * v[None, :])


def cyl_src(c, ax, r, h, fil=0.0):
    """a cylinder (or a drum with rounded ends) from explicit axis vectors -- no Euler angles, no fillet op:
    plain = an extruded circle; filleted = a loft through rings tracing the end radii."""
    a, u, v = _basis(ax)
    c = np.asarray(c, float)
    if not fil:
        p0 = c - a * h / 2
        pts = [(r * np.cos(t), r * np.sin(t)) for t in np.linspace(0, 2 * np.pi, 48, endpoint=False)]
        segs = ' '.join(f'[line {f(p[0])} {f(p[1])} {f(q[0])} {f(q[1])}]' for p, q in zip(pts, pts[1:] + pts[:1]))
        e = a * h
        return (f'[extrude {f(e[0])} {f(e[1])} {f(e[2])} [sketch {f(p0[0])} {f(p0[1])} {f(p0[2])} '
                f'{f(u[0])} {f(u[1])} {f(u[2])} {f(v[0])} {f(v[1])} {f(v[2])} #[{segs}]]]')
    rings = []
    for end in (-1, 1):
        ts = np.linspace(0, np.pi / 2, 6)
        ts = ts if end < 0 else ts[::-1]
        for t in ts:                              # the end round: radius r - fil + fil*sin(t), axial h/2 - fil + fil*cos(t)
            rr = r - fil + fil * np.sin(t)
            z = end * (h / 2 - fil + fil * np.cos(t))
            rings.append(_circle(c + a * z, u, v, max(rr, 0.5)))
    return loft_src(rings, np.zeros(3))


def plate_src(m, origin):
    """a plate mesh -> [difference holes [extrude outline]] in the body frame."""
    lo, hi = m.bounds
    ax = int(np.argmin(hi - lo)); t = hi[ax] - lo[ax]
    M = Manifold(Mesh(vert_properties=np.asarray(m.vertices, np.float32), tri_verts=np.asarray(m.faces, np.uint32)))
    u, v = [i for i in range(3) if i != ax]
    if ax == 0:
        u, v = 1, 2
    if ax == 1:
        u, v = 0, 2
    if ax == 2:
        u, v = 0, 1
    perm = np.eye(3)[[u, v, ax]]
    sec = M.transform(np.hstack([perm, np.zeros((3, 1))])).slice((lo[ax] + hi[ax]) / 2).simplify(0.08)
    polys = [np.asarray(p) for p in sec.to_polygons() if len(p) >= 3]
    area = lambda p: 0.5 * np.sum(p[:, 0] * np.roll(p[:, 1], -1) - np.roll(p[:, 0], -1) * p[:, 1])
    outer = [p for p in polys if area(p) > 0]
    holes = [p for p in polys if area(p) <= 0]
    o3 = np.zeros(3); o3[ax] = lo[ax] - origin[ax]
    du, dv = origin[u], origin[v]
    xa = np.zeros(3); xa[u] = 1; ya = np.zeros(3); ya[v] = 1; ext = np.zeros(3); ext[ax] = t

    def sk(p, proud=0.0):
        p = p - np.array([du, dv])
        o = o3.copy(); o[ax] -= proud; e = ext.copy(); e[ax] += 2 * proud
        segs = ' '.join(f'[line {f(p[i][0])} {f(p[i][1])} {f(p[(i + 1) % len(p)][0])} {f(p[(i + 1) % len(p)][1])}]' for i in range(len(p)))
        return (f'[extrude {f(e[0])} {f(e[1])} {f(e[2])} [sketch {f(o[0])} {f(o[1])} {f(o[2])} '
                f'{f(xa[0])} {f(xa[1])} {f(xa[2])} {f(ya[0])} {f(ya[1])} {f(ya[2])} #[{segs}]]]')
    if not outer or len(holes) > 12:         # pocketed (router-lightened) plates: a mesh, not a 40-deep boolean chain
        return None
    s = sk(outer[0]) if len(outer) == 1 else '[union ' + ' '.join(sk(p) for p in outer[:2]) + ']'
    for h in holes:                          # holes: extrude a hair longer so the cut is clean
        hs = sk(h, proud=1.0)
        s = f'[difference {hs} {s}]'
    return s


def loft_src(rings, o):
    """section rings (3D point loops) -> [loft #[sketch ...]]: each ring sketched in its own plane, points kept."""
    sks = []
    for r in rings:
        r = np.asarray(r, float) - o
        c = r.mean(0)
        _, _, vt = np.linalg.svd(r - c)
        u, n = vt[0], vt[2]
        v = np.cross(n, u)
        p = np.c_[(r - c) @ u, (r - c) @ v]
        segs = ' '.join(f'[line {f(p[i][0])} {f(p[i][1])} {f(p[(i + 1) % len(p)][0])} {f(p[(i + 1) % len(p)][1])}]' for i in range(len(p)))
        sks.append(f'[sketch {f(c[0])} {f(c[1])} {f(c[2])} {f(u[0])} {f(u[1])} {f(u[2])} {f(v[0])} {f(v[1])} {f(v[2])} #[{segs}]]')
    return '[loft #[' + ' '.join(sks) + ']]'


def cuts_src(src, cuts, o):
    for kind, *a in cuts:
        if kind == 'xcyl':                    # a hole along x, `depth` into the face at c
            c, r, dep = np.asarray(a[0], float) - o, a[1], a[2]
            tool = f'[translate {f(c[0] - dep)} {f(c[1])} {f(c[2])} [rotate 0 90 0 [cylinder-n {f(r)} {f(2 * dep)} 48]]]'
        elif kind == 'ycyl':
            c, r = np.asarray(a[0], float) - o, a[1]
            hl = a[2] if len(a) > 2 else r
            tool = f'[translate {f(c[0])} {f(c[1] - hl)} {f(c[2])} [rotate -90 0 0 [cylinder-n {f(r)} {f(2 * hl)} 72]]]'
        else:
            p, sz = np.asarray(a[0], float) - o, a[1]
            tool = f'[translate {f(p[0])} {f(p[1])} {f(p[2])} [cube {f(sz[0])} {f(sz[1])} {f(sz[2])}]]'
        src = f'[difference {tool} {src}]'
    return src


def band_src(spec, o):
    """a parting-line band in loon (mirrors k1_design.band_manifold)."""
    import k1_design as KD
    if spec[0] == 'slab':
        _, a, at = spec
        lo = np.full(3, -1e3) - o; sz = np.full(3, 2e3); lo[a] = at - o[a] - KD.GROOVE_W / 2; sz[a] = KD.GROOVE_W
        return f'[translate {f(lo[0])} {f(lo[1])} {f(lo[2])} [cube {f(sz[0])} {f(sz[1])} {f(sz[2])}]]'
    _, a, c, hu, hv, rc = spec
    ax, u, v = KD._axes(a)
    def prism(hu_, hv_, rc_):
        pts = KD.rrect(np.zeros(3), np.array([1.0, 0, 0]), np.array([0, 1.0, 0]), hu_, hv_, rc_)[:, :2].tolist()
        p0 = np.asarray(c, float) - o - ax * 300.0; e = ax * 600.0
        segs = ' '.join(f'[line {f(p[0])} {f(p[1])} {f(q[0])} {f(q[1])}]' for p, q in zip(pts, pts[1:] + pts[:1]))
        return (f'[extrude {f(e[0])} {f(e[1])} {f(e[2])} [sketch {f(p0[0])} {f(p0[1])} {f(p0[2])} '
                f'{f(u[0])} {f(u[1])} {f(u[2])} {f(v[0])} {f(v[1])} {f(v[2])} #[{segs}]]]')
    return f'[difference {prism(hu - KD.GROOVE_W, hv - KD.GROOVE_W, max(rc - KD.GROOVE_W, 1.0))} {prism(hu, hv, rc)}]'


def shell_src(m, o):
    """native source for a ring-built shell (loft, optional cuts) or the visor; None -> import the mesh."""
    md = m.metadata
    if 'visor' in md:
        V = md['visor']; hc = np.asarray(V['hc'], float) - o; oc = np.asarray(V['oval_c'], float) - o; sx, sy, sz = V['oval_s']
        helmet = cuts_src(loft_src(V['helmet']['loft'], o), V['helmet'].get('cut', []), o)
        big = f'[translate {f(hc[0])} {f(hc[1])} {f(hc[2])} [scale {V["s"]} {V["s"]} {V["s"]} [translate {f(-hc[0])} {f(-hc[1])} {f(-hc[2])} {helmet}]]]'
        oval = f'[translate {f(oc[0])} {f(oc[1])} {f(oc[2])} [scale {f(sx)} {f(sy)} {f(sz)} [rotate 0 90 0 [translate 0 0 -0.5 [cylinder-n 1 1 96]]]]]'
        return f'[intersection {oval} {big}]'
    if 'loft' in md:
        src = loft_src(md['loft'], o)
        if md.get('grooves'):                 # parting lines cut into the skin: shell minus (bands minus the inset copy)
            import k1_design as KD
            inset = loft_src(KD.inset_rings(md['loft'], KD.GROOVE_D), o)
            bands = [band_src(sp, o) for sp in md['grooves']]
            band = bands[0] if len(bands) == 1 else '[union ' + ' '.join(bands) + ']'
            # loft - (band - inset): the same cut as loft - (band ^ (loft - inset)), but it never subtracts one loft
            # from a near-parallel copy of itself, which vcad's boolean gets wrong (it added volume, then cut a notch)
            src = f'[difference [difference {inset} {band}] {src}]'
        return cuts_src(src, md.get('cut', []), o)
    return None


def pivots(J):
    P = {'torso': np.zeros(3)}
    W = KS.waist_layout()
    if W is not None:
        P['wyaw'], P['wroll'], P['chest'] = W['yaw'][0], W['roll'][0], W['pitch'][0]
    H = KS.head_layout(J)
    P['hyaw'], P['hpitch'] = H['yaw'][0], H['pitch'][0]
    for side, t in (('Left', 'l'), ('Right', 'r')):
        Lg, U = KS.layout(J, side), KS.upper_layout(J, side)
        for k in ('roll', 'pitch', 'yaw', 'knee'):
            P[f'{k}.{t}'] = Lg[k][0]
        P[f'anklep.{t}'] = P[f'ankle.{t}'] = Lg['ankle']
        for k in ('sp', 'sr', 'ep', 'ey'):
            P[f'{k}.{t}'] = U[k][0]
        Wr = KS.wrist_layout(J, side)
        if Wr is not None:
            for k, b in (('roll', 'wr'), ('pitch', 'wp'), ('yaw', 'wy')):
                P[f'{b}.{t}'] = Wr[k][0]
    return P


def joints(J):
    """(name, parent, child, axis, lo, hi) -- axes signed as the K1's, limits from its URDF."""
    out = []
    import rom_mini as R_
    top = R_.TOP()
    W = KS.waist_layout()
    if W is not None:
        for jn, par, ch, k in (('Waist_yaw', 'torso', 'wyaw', 'yaw'), ('Waist_roll', 'wyaw', 'wroll', 'roll'), ('Waist_pitch', 'wroll', 'chest', 'pitch')):
            out.append((jn.lower(), par, ch, np.asarray(W[k][1], float), *R_.WAIST_LIM[jn]))
    lim = lambda n: tuple(np.degrees(J[n]['lim']))
    sgn = lambda ours, n: np.asarray(ours, float) * (np.sign(np.dot(ours, J[n]['axis'])) or 1.0)
    for side, t in (('Left', 'l'), ('Right', 'r')):
        s = 1 if t == 'l' else -1
        for jn, par, ch, a in (('Hip_Roll', 'torso', f'roll.{t}', [1, 0, 0]), ('Hip_Pitch', f'roll.{t}', f'pitch.{t}', [0, 1, 0]),
                               ('Hip_Yaw', f'pitch.{t}', f'yaw.{t}', [0, 0, 1]), ('Knee_Pitch', f'yaw.{t}', f'knee.{t}', [0, 1, 0]),
                               ('Ankle_Pitch', f'knee.{t}', f'anklep.{t}', [0, 1, 0]), ('Ankle_Roll', f'anklep.{t}', f'ankle.{t}', [1, 0, 0])):
            n = f'{side}_{jn}'
            out.append((f'{t}_{jn.lower()}', par, ch, sgn(a, n), *lim(n)))
        for jn, par, ch, a, n in (('shoulder_pitch', top, f'sp.{t}', [0, 1, 0], f'A{side}_Shoulder_Pitch'),
                                  ('shoulder_roll', f'sp.{t}', f'sr.{t}', [1, 0, 0], f'{side}_Shoulder_Roll'),
                                  ('upperarm_rot', f'sr.{t}', f'ep.{t}', [0, 0, -1], f'{side}_Elbow_Pitch'),
                                  ('elbow', f'ep.{t}', f'ey.{t}', [0, s, 0], f'{side}_Elbow_Yaw')):
            out.append((f'{t}_{jn}', par, ch, sgn(a, n), *lim(n)))
        Wr = KS.wrist_layout(J, side)
        if Wr is not None:
            for jn, par, ch, k in (('Wrist_roll', f'ey.{t}', f'wr.{t}', 'roll'), ('Wrist_pitch', f'wr.{t}', f'wp.{t}', 'pitch'), ('Wrist_yaw', f'wp.{t}', f'wy.{t}', 'yaw')):
                out.append((f'{t}_{jn.lower()}', par, ch, np.asarray(Wr[k][1], float), *R_.WRIST_LIM[jn]))
    out.append(('head_yaw', top, 'hyaw', sgn([0, 0, 1], 'AAHead_yaw'), *lim('AAHead_yaw')))
    out.append(('head_pitch', 'hyaw', 'hpitch', sgn([0, 1, 0], 'Head_pitch'), *lim('Head_pitch')))
    return out


def body_of(n):
    import rom_mini as R
    b = R.body_of(n)
    return b


# The cortex head is its own product, authored in loon (cortex/cortex.loon). The robot file [use]s it: the STL proxies
# the Python checks load (k1_structure.cx_parts: cortex-*, dock-*, cable-hcortex) are skipped here.
CX_PY = ('cortex-', 'dock-', 'cable-hcortex')
CX_HEAD = [('cortex-tub', 'satin_black'), ('cortex-floor', 'aluminium'), ('cortex-ear-grilles', 'satin_black'),
           ('cortex-exhaust-grille', 'satin_black'), ('cortex-glass', 'visor_glass'), ('cortex-glass-face', 'visor_glass'), ('cortex-padboard', 'pcb_green'),
           ('cortex-pads', 'gold'), ('cortex-strikes', 'steel'), ('cortex-keeper', 'steel'), ('cortex-display', 'heatsink'),
           ('cortex-cams', 'pcb_green'), ('cortex-dockboard', 'pcb_green'), ('cortex-power', 'pcb_green'),
           ('cortex-battery', 'cell_pack'), ('cortex-sled', 'aluminium'), ('cortex-compute', 'pcb_green'),
           ('cortex-heatsink', 'heatsink'), ('cortex-speakers', 'motor_dark'), ('cortex-mics', 'pcb_green'),
           ('cortex-amps', 'pcb_green'), ('cortex-cables', 'cable_orange')]
CX_NECK = [('dock-face', 'gunmetal'), ('dock-pogo', 'gold'), ('dock-pogo-block', 'pcb_green'), ('dock-cones', 'steel'),
           ('dock-magnets', 'motor_dark'), ('dock-pawl', 'steel'), ('dock-release', 'satin_black')]
# HEAD=node: the node skull (cortex/node.loon on mini, node-full.loon on full) in place of the cortex tub; same dock-origin frame
NODE = os.environ.get('HEAD') == 'node'
BARE = os.environ.get('BARE') == '1'          # no plastics: drop every printed cover, trim, sole and the head shell (the frame,
SHELL_PRE = ('cover-', 'trim-', 'puck-', 'sole', 'accent-', 'estop-')   # motors and electronics stay)
NODE_FULL_K = 1.12                            # the node-full skull, scaled about its dock origin on the full body
NODE_HEAD = {'mini': [('node-head', 'satin_black'), ('node-ears', 'dots'), ('node-intake', 'dots'), ('node-lenses', 'lens'),
                      ('node-glass', 'glass'), ('node-face', 'face')],
             'full': [('full-shell', 'satin_black'), ('full-ears', 'dots'), ('full-grille', 'dots'), ('full-crown-grille', 'dots'),
                      ('full-lenses', 'lens'), ('full-glass', 'glass'), ('full-face', 'face')]}
CX_MATS = {'dots': (0.0, 0.0, 0.0, 0.0, 0.9), 'lens': (0.035, 0.04, 0.045, 0.3, 0.08), 'glass': (0.01, 0.012, 0.014, 0.4, 0.04),
           'face': (0.72, 0.95, 0.76, 0.0, 0.5),
           'gold': (1.0, 0.78, 0.34, 1.0, 0.25), 'steel': (0.6, 0.6, 0.62, 0.9, 0.35), 'cable_orange': (1.0, 0.42, 0.05, 0.0, 0.45)}


def main(variant='mini', explodes=(0.0,)):
    global CX_HEAD, CX_NECK
    if NODE:
        CX_HEAD, CX_NECK = NODE_HEAD[variant], []
    # the node's own neck trim (node.loon: the foot's outline 1 mm under it, flaring out of a column) replaces the cortex
    # dock collar and plate (and hides the head's spine cable, which runs inside its column); it is cut where the saddle cheeks crown so it tucks into their cowl
    NODE_DROP = ('cover-dockcollar', 'head-dock', 'cable-hspine') if NODE else ()
    KS.use(variant)
    KD = _patch()
    import k1 as K
    J, M = KS.world()
    D = KD.design()
    C = KD.structure(D)
    P = pivots(J)
    outdir = os.path.join(os.path.dirname(os.path.abspath(__file__)), 'vcad', variant)
    os.makedirs(os.path.join(outdir, 'stl'), exist_ok=True)
    recs = []                                 # (part name, body, source, material, shell?, local centroid)
    used_mats = set()
    n_native = n_mesh = 0
    has_cx = variant in ('mini', 'full')       # the cortex head (loon), scaled to the body
    for n, m in D + C:
        if has_cx and n.startswith(CX_PY + NODE_DROP):
            continue
        if BARE and n.startswith(SHELL_PRE):
            continue
        b = body_of(n)
        if b is None:
            print('  (skipped, no body)', n)
            continue
        o = P[b]
        rec = REC.get(id(m))
        if rec and rec[0] == 'cyl':
            _, c, ax, r, h, fil = rec
            src = cyl_src(c - o, ax, r, h, fil)
        elif rec and rec[0] == 'caps':
            _, c, a, r, L, th = rec
            src = '[union ' + ' '.join(cyl_src(c - o + a * s * (L / 2 + 0.3), a, r, th) for s in (-1, 1)) + ']'
        elif mat_of(n) == 'plate':
            src = plate_src(m, o)
        else:
            src = shell_src(m, o)
        if src is None:                       # relief-cut shell: mesh in the body frame
            mm = K.simplify(m, grid=0.8) if len(m.faces) > 20000 else m
            fn = n.replace('.', '_') + '.stl'
            mm.copy().apply_translation(-o).export(os.path.join(outdir, 'stl', fn))
            src = f'[import-mesh-scaled 0.001 0.001 0.001 "stl/{fn}"]'    # import-mesh reads STL as metres
            n_mesh += 1
        else:
            n_native += 1
        mk = mat_of(n)
        if NODE and n.startswith('trim-'):            # design pass 2026-10-28: the scattered gunmetal bands go satin; no accent
            mk = 'cover'                              # (the face is the only light on the body)
        if NODE and mk == 'plate' and n.startswith(('chassis-hipR', 'arm-', 'wrist-')):   # plates that show (hip roll, elbow, wrist): black anodize
            mk = 'cover'
        used_mats.add(mk)
        recs.append((n.replace('.', '_'), b, src, mk, mk not in ('plate', 'motor'), m.bounds.mean(0) - o))
    if has_cx and not BARE:                   # the cortex module, placed at the dock origin in the head-pitch frame
        HF = KS.head_frame(J, M)
        o = np.array([HF['ox'], HF['oy'], HF['zb']]) - P['hpitch']
        for nm, mk in CX_HEAD + CX_NECK:
            dz = -0.5 if nm.startswith('dock-') else 0.0
            k_ = 1.0                                # each body has its own head: cortex.loon (mini), cortex-full.loon (full)
            if NODE and variant == 'full':
                k_ = NODE_FULL_K                     # design pass: the 7in head reads small on the full's shoulders
            src_ = nm if abs(k_ - 1.0) < 1e-3 else f'[scale {f(k_)} {f(k_)} {f(k_)} {nm}]'
            recs.append((nm, 'hpitch', f'[translate {f(o[0])} {f(o[1])} {f(o[2] + dz * k_)} {src_}]', 'cx:' + mk, False, o))
        if NODE:
            cheek = next(m for n_, m in D + C if n_.startswith('cover-headcheek'))
            zc = cheek.bounds[1][2] - (HF['zb']) - 3.0      # 3 mm into the cowl
            neck = 'node-neck' if variant == 'mini' else 'full-neck'
            kn_ = NODE_FULL_K if variant == 'full' else 1.0
            src_ = f'[intersection [scale {f(kn_)} {f(kn_)} {f(kn_)} {neck}] [translate -200 -200 {f(zc)} [cube 400 400 {f(-zc - 0.5)}]]]'
            recs.append((neck, 'hpitch', f'[translate {f(o[0])} {f(o[1])} {f(o[2])} {src_}]', 'cx:satin_black', False, o))
            CX_NECK = [(neck, 'satin_black')]
        mod = 'node' if NODE else 'cortex'
        cx_link = os.path.join(outdir, mod + '.loon')
        cx_src = os.path.relpath(os.path.join(os.path.dirname(os.path.abspath(__file__)), '..', 'head',
                                              f'{mod}-full.loon' if variant == 'full' else f'{mod}.loon'), outdir)
        if os.path.lexists(cx_link):
            os.remove(cx_link)
        os.symlink(cx_src, cx_link)
    z0 = -min(m.bounds[0][2] for _, m in D)  # the torso sits this high, so the soles stand on z = 0
    ankle_drop = abs(P['ankle.l'][2])
    jl = joints(J)
    mats = {MATS[k][0]: MATS[k] for k in used_mats}
    cxm = {r[3][3:] for r in recs if r[3].startswith('cx:')}
    for k in cxm - set(mats):                 # cortex materials the robot palette lacks
        mats[k] = (k,) + (CX_MATS.get(k) or next(v[1:] for v in MATS.values() if v[0] == k))
    outs = []
    for e in explodes:
        parts, inst, fixed, anchor = [], [], [], {}
        for pn, b, src, mk, shell, cen in recs:
            if shell and e:                   # explode: shells lift off the plate frame, away from the link's pivot
                d = np.array([cen[0], cen[1], 0.0])
                d = d / np.linalg.norm(d) if np.linalg.norm(d) > 15 else np.array([1.0, 0, 0])
                d = d * 45.0 * e
                src = f'[translate {f(d[0])} {f(d[1])} {f(d[2])} {src}]'
            parts.append(f'[part "{pn}" {src} "{mk[3:] if mk.startswith("cx:") else MATS[mk][0]}"]')
            z = z0 + 0.35 * e * ankle_drop if b == 'torso' and b not in anchor else 0.0
            inst.append(f'[instance "{pn}_i" "{pn}" 0.0 0.0 {f(z)}]')
            if b in anchor:
                fixed.append(f'[fixed-joint "fix_{pn}" "{anchor[b]}" 0.0 0.0 0.0 "{pn}_i" 0.0 0.0 0.0]')
            else:
                anchor[b] = f'{pn}_i'
        for t in ('l', 'r'):                  # the ankle U-joint cross: a body of its own between pitch and roll
            pn = f'ankle_cross_{t}'
            parts.append(f'[part "{pn}" [translate -5 -5 -5 [cube 10 10 10]] "aluminium"]')
            inst.append(f'[instance "{pn}_i" "{pn}" 0.0 0.0 0.0]')
            anchor[f'anklep.{t}'] = f'{pn}_i'
        jts = []
        for jn, par, ch, a, lo, hi in jl:
            pa = (P[ch] - P[par]) * (1 + 0.35 * e)          # explode: links spread along the pivot-to-pivot line
            jts.append(f'[revolute-joint "{jn}" {f(a[0])} {f(a[1])} {f(a[2])} {f(lo)} {f(hi)} "{anchor[par]}" {f(pa[0])} {f(pa[1])} {f(pa[2])} "{anchor[ch]}" 0.0 0.0 0.0]')
        head = [f';; {variant} humanoid -- generated by body/vcad_export.py from k1_design + k1_structure; do not hand-edit.',
                f';; {len(parts)} parts ({n_native} native loon, {n_mesh} imported shell meshes), {len(jts)} revolute joints (K1 limits)'
                + (f'; exploded {e:.2f}' if e else '') + '.',
                ';; frame: x fore, y left, z up, mm; each body is authored about its joint pivot.']
        head += [f'[material "{v[0]}" {v[1]} {v[2]} {v[3]} {v[4]} {v[5]}]' for v in mats.values()]
        if has_cx and not BARE:
            head += [f'[use {"node" if NODE else "cortex"} [' + ' '.join(nm for nm, _ in CX_HEAD + CX_NECK) + ']]']
        src = '\n'.join(head) + '\n[assembly\n #[' + '\n   '.join(parts) + ']\n #[' + '\n   '.join(inst) + ']\n #[' + \
            '\n   '.join(fixed + jts) + ']\n "' + anchor['torso'] + '"]\n'
        path = os.path.join(outdir, f'{variant}.loon' if not e else f'{variant}-explode-{int(round(e * 100)):03d}.loon')
        open(path, 'w').write(src)
        outs.append(path)
        print(f'{path}: {len(parts)} parts ({n_native} native, {n_mesh} meshes), {len(jts)} joints, {len(src) / 1e3:.0f} kB')
    KS.use('mini')
    return outs


if __name__ == '__main__':
    ex = tuple(float(v) for v in sys.argv[2].split(',')) if len(sys.argv) > 2 else (0.0,)
    main(sys.argv[1] if len(sys.argv) > 1 else 'mini', ex)
