muni-works/rose/arm/thermal_v10.py

"""lymb v10.3 steady-state thermal estimate: does the skin cost continuous torque?

Lumped network per enclosed motor, winding -> case -> ambient (25 C), winding limit 120 C (Class B
insulation is 130 C; 10 K kept back). Every number below is an ASSUMPTION unless it says manual.

  manual (RS spec book 2026-10-09, ~/Developer/robstride_assets):
    RS04  rated 40 N.m on a 345 x 345 mm Al sink plate, 27 A pk rated phase current, 0.16 ohm line
    RS02  rated  7 N.m on a 150 x 150 mm plate,          7 A pk,                      0.55 ohm
    RS00  rated  5 N.m on a 150 x 150 mm plate,          4.7 A pk,                    1.5 ohm
  copper loss at the rated point  P = 1.5 x R_line x I_rms^2  (3-phase, line-to-line resistance)
  the manual's sink plate:  R_ref = 1 / (h x eta x 2 a^2),  h = 10 W/m2K (free convection + radiation),
                            eta = 0.7 (plate fin efficiency)
  so the motor's own winding -> mounting-face resistance   R_int = 95 K / P - R_ref

  in the arm, case -> ambient conductance G:
    bare (no skin)    h x (A_can + eta_p x A_plates)          eta_p = 0.5 for the long thin 3 mm plates
    skinned           the can and its plates -> enclosed air -> shell -> ambient, in series:
                      1 / (1 / (h_in x (A_can + eta_p A_plates)) + 1 / (h x A_shell)),  h_in = 5 W/m2K
    vented            + h x phi x A_vent in parallel: the perforated hub caps (1.3 mm holes, 2.3 mm hex,
                      29 % open) pass phi = 0.5 of an open face's free convection (ASSUMED)
  allowed loss  P_max = 95 K / (R_int + 1/G); torque scales with sqrt(P) (copper loss ~ I^2), so the
  derating against the manual's rated condition is f = sqrt(P_max / P_rated), capped at 1.
  The model's hold numbers use STALL-continuous ratings (fork_checks RATING: 25 / 4.4 / 3.6 N.m),
  taken as valid on the manual's sink; the skin's effect is f_skin / f_bare applied to them.

    ROSE_ARM=v10 uv run -q --with numpy --with manifold3d --with trimesh --with scipy python arm/thermal_v10.py
"""
import math
import os
import sys

HERE = os.path.dirname(os.path.abspath(__file__))
sys.path.insert(0, HERE)
import numpy as np
import rose_fork as F
import fork_checks as C
import skin_v10 as S

H, ETA_REF, ETA_P, H_IN, PHI, DT = 10.0, 0.7, 0.5, 5.0, 0.5, 95.0
MANUAL = {'RS04': (40.0, 27.0, 0.16, 0.345), 'RS02': (7.0, 7.0, 0.55, 0.150), 'RS00': (5.0, 4.7, 1.5, 0.150)}
FLANK = float(os.environ.get('LYMB_FLANK', 0.0))
BARREL = float(os.environ.get('LYMB_BARREL', 1.0))   # v10.3: open annulus + a dot-grid round the ring's circumference
J3_GRID = float(os.environ.get('LYMB_J3_GRID', 0.95))   # J3's grid open area vs the old 4-face 29 % grid: v10.5 = 3 faces (front clean) at 1.4 / 2.2 hex (37 %) = 0.75 x 37 / 29 = 0.95
PHI_CAP = float(os.environ.get('LYMB_PHI_CAP', 1.0))   # 1.0: open motor faces behind a bezel (v10.3); 0.5: perforated 1.3 / 2.3 hex caps
ALPANEL = os.environ.get('LYMB_ALPANEL', '1') == '1'
OPEN = os.environ.get('LYMB_OPEN_DRUM', '1') == '1'
V108 = os.environ.get('LYMB_V108', '1') == '1'   # v10.8 (Cam: no perforations): Al drums + J3 band, nothing open
J3BAND = float(os.environ.get('LYMB_J3BAND', 1.0))   # v10.8: wrap fraction of the J3 can under its 6061 band
CAPS_ONLY = tuple(x for x in os.environ.get('LYMB_CAPS_ONLY', 'J4,J6').split(',') if x)   # v10.8: drums with Al caps only (mass)
VENT_OPEN = (math.pi / 4 * 1.3 ** 2) / (math.sqrt(3) / 2 * 2.3 ** 2)


def motor_numbers(name):
    T, ipk, R, a = MANUAL[name]
    P = 1.5 * R * (ipk / math.sqrt(2)) ** 2
    R_ref = 1 / (H * ETA_REF * 2 * a * a)
    return P, R_ref, DT / P - R_ref


def sheet_area(pred):
    A = 0.0
    for p in F.build():
        if p[1] in ('sheet', 'cover') and pred(p):
            A += 2 * (F.area2d(p[5]) - sum(F.area2d(h) for h in (p[7] if len(p) > 7 else [])))
    return A
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
