muni-works/rose/body/hand_grasp.py

"""rose full's 6-DoF hand closing on a can: each finger's three phalanges as real joints, coupled by four-bars and driven by
its palm linear actuator through a slider-crank. Run from body/:  python hand_grasp.py OUTDIR [FRAMES]

Per finger: the actuator pushes a rod to a crank on the proximal phalanx (MCP). A coupler from a palm-side pivot to the
back of the middle phalanx makes PIP follow MCP; a second coupler, from the proximal phalanx to the back of the distal,
makes DIP follow PIP -- both closed numerically, so the coupling is whatever the linkage geometry gives. Each finger
closes until a phalanx touches the can and stops there (the actuator stalls; the others keep closing), so the grasp
adapts. Writes OUTDIR/grasp.loon (a jointed assembly), OUTDIR/grasp.json (vcad-render --animate timeline) and prints
each finger's contact angles and the actuator stroke they took.

Coupler and crank pivots are ASSUMED (mm offsets below), sized to look right, not yet optimised for force transmission.
"""
import sys, os, json, math
sys.path.insert(0, os.getcwd())
import numpy as np, trimesh
from scipy.optimize import brentq
import k1_structure as KS, k1_design as KD
from design import ring, M_

OUT = sys.argv[1]; FRAMES = int(sys.argv[2]) if len(sys.argv) > 2 else 40
os.makedirs(OUT, exist_ok=True)
KS.use('full'); J, M = KS.world(); KD.design()
H = KD.HAND_SPEC['l']; s = H['s']; w, v = H['w'], H['v']
AX = np.array([-s * 1.0, 0, 0])                     # flexion axis: +angle curls the tips to the palm side
PALM, DORS, UP = np.array([0, -s * 1.0, 0]), np.array([0, s * 1.0, 0]), np.array([0, 0, 1.0])
CPL = dict(g=4.0, g_up=0.0, b=6.0, b_dn=0.0)        # MCP->PIP coupler: palm-side ground pivot / dorsal pivot on the middle
                                                     # (searched: stays assembled 0-90 deg MCP, PIP/MCP 0.65-0.75)
CPL2 = dict(g=3.5, g_up=0.0, b=5.0, b_dn=0.0)       # PIP->DIP coupler: on the proximal / dorsal on the distal (same proportions)
CRANK = 7.0                                          # actuator crank on the proximal phalanx, dorsal of the MCP
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
