muni-works/rose/(commit log)

2026-08-18 rose: the humanoid line, in one place
    frog is the quadruped and keeps its name. rose is the humanoid line, and
    the name is the thesis: past tense of rise, the one that stood up.
    Three variants, one design language (bent 3 mm 5052 sheet, exposed
    skeleton limbs, feet-only contact, 22 DOF):
    mini 1150 mm X-series Booster K1 size, the crashable one
    pro 1450 mm X-series the workhorse; validated at 1130 today
    max 1750 mm rana + torc beefy, built to jump, Jetson AGX Thor
    Folds in three previously scattered efforts: toad -> mini, pond-v1's
    generators (from ipse/scripts) -> pro, the old rose repo -> max.
    family.py sizes the line and puts vendor limits against Unitree's
    Su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
    [k1-thigh-r.step]
2026-08-18 rose: re-verify mini and pro packing on the scaled skeletons
    Both PASS. mini at 1150 mm is tightest at ankle pitch<->roll +6.1 mm; pro
    at 1450 mm clears every pair by more than 20 mm.
    This needed checking rather than assuming. Scaling up does not
    automatically buy clearance -- the actuator bodies stay the same size
    while the skeleton grows, and the near-tangent hip yaw<->knee gap has
    moved the wrong way under a length increase before.
2026-08-19 rose: square the ladder, and max gets broad as well as tall
    Heights are anchored to real references and rounded to 50 mm:
    mini 1200 (Booster K1 is 1150), pro 1750 (a standard adult human),
    max 2000 (a lumberjack).
    max carries a x1.15 bulk factor on top of the height scale -- stance 305
    against pro's 232, structure as length^3 * bulk^2 -- so it is broad
    rather than merely tall. joints() now scales Y separately from Z for it.
    Growing pro broke its actuator selection, which is the useful thing this
    found. X6-60 CANNOT hold a single-leg squat at 1750 mm: 149 N.m needed
    against 60 available, running out at ~67 deg of knee bend. Enough for
    walking stance, not for squatting, landing or jumping. F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
2026-08-19 rose: render all three from the geometry in the repo
    Renders are of what actually EXISTS, not of the 1200/1750/2000 ladder --
    each is at the height its CAD was authored at (mini 1150, pro 1130, max
    ~1750). The ladder is a sizing decision the geometry has not been recut
    to yet, and a render that claimed otherwise would be a lie.
    Side by side they show the design language is not yet shared: mini is
    massed volumes, pro is cut sheet with graded lightening, max is detailed
    mechanism with pushrod ankles. Converging mini and max onto pro's
    bent-sheet language is the open work.
    Also brings pro's loon into the repo (pro/cad/rose-pro.loon) -- it was
    only living in vcad/hardware, so the repo could no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
2026-08-19 pro: design for cobotting, and audit whether it actually does
    The brief is humanist -- designed around human comfort, safety and
    legibility -- NOT designed to be mistaken for a human. Where those
    conflict, legibility wins. Written up in pro/DESIGN.md.
    The useful part is that "humanist" turns out to have published numbers.
    ISO/TS 15066's biomechanical limits are defined for BLUNT contact and the
    standard says sharp contact should be avoided in all cases, so a 3 mm
    laser-cut edge is not a number to trade off -- it is outside the envelope
    the numbers live in. pro/cobot.py makes that a gate.
    It currently FAILS: 4453 mm of exposed square-cut edge across 38 edges.
    The fix is a hem, not a cover -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
2026-08-19 pro: what Unitree does, measured -- and why ours reads as a kit of parts
    The render looks like it will fall apart. Research pass on why, against
    Unitree's G1 URDF (real link masses and joint offsets, local copy in
    vcad/examples), two G1 teardowns, the H2 reveal, and the DecARt Leg
    paper's swing-time benchmark.
    Diagnosis in one line: Unitree WRAPS, we TAB. Every G1 link is a closed
    shell with its actuator inside; ours are flat plates on the outside of
    bare cylinders joined by tabs. Their load path is continuous shell from
    joint to joint; ours is plate-bolt-flange-cylinder-flange-bolt-plate.
    Three structural facts from the URDF that surface styling would never
    have found: the G1's ankle-pitc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
2026-08-19 pro: pull the G1's actual meshes and render it beside ours
    Sparse-checkout of unitreerobotics/unitree_ros robots/g1_description
    (BSD-3, 110 MB, 167 STLs) into pond_assets/reference/unitree_g1. A
    script composes the URDF's joint tree at zero pose into a loon of
    import-mesh roots, and vcad-render draws it in the same drafting style
    as rose -- so for the first time the reference and the design sit in
    identical renders.
    The left-leg side view is the whole "wrap, don't tab" argument in one
    image: hip roll link a curved shell sweeping down and back, thigh coming
    forward again on the 10 deg cant the URDF carries, knee disc, shank
    tapering to a yoke, two pushrods driving the ankle from actuators hi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
2026-08-19 pro: wrap the actuators -- and everything that turned out to mean
    Plan A from UNITREE.md, "fold channels around the actuators", forced two
    new tools and a layout change. Each was a finding.
    sweep.py: static plate/plate interference across links, and a swept check
    that rotates each joint's child side through the URDF range against its
    parent side, with rounded-rect plates on both sides. It found (a) the
    thigh knee-stator plate and shank knee-output plate in the SAME
    80x3x72 mm slab -- the pancake stack hipB documents, not applied at the
    knee, invisible to the sim (feet-only contact) and to vcad (union); and
    (b) the shank web driving 22 mm into the hip-yaw body at 132 deg knee
    flexion. Honest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
2026-08-19 pro: render the wrapped body, and two vcad boolean pathologies
    The render of the wrapped rose pro. Thighs are closed channels around the
    yaw actuators, knees show as exposed discs as on the G1, shanks carry a
    front flange, and the 55 mm knee-back offset reads in the stance. It is a
    body now, not a kit of parts. Arms still sticks; that is the next pass.
    Getting the render out took longer than the design did, and the reasons
    are worth keeping. vcad's boolean time on a plate is not monotonic in the
    corner radius: r=8 6.6 s, r=12 5.4 s, r=16 23.8 s, r=20 5.2 s, r=25
    68.3 s on the same three-plate link. The 25 mm cobot radius had silently
    turned a 2.5 min render into ~20; it is 20 now, same safe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
2026-08-19 pro: side render — the knee-back offset in profile
2026-08-19 pro: pull the H2's meshes and render it beside ours, same camera
    Unitree published robots/h2_description (URDF + STL, BSD-3) in unitree_ros;
    added to the sparse checkout at ~/Developer/pond_assets/reference/unitree_g1
    next to the G1. pro/reference/urdf2loon.py is the URDF->loon composer the G1
    README said was "inline in the commit" and was not: walks the joint tree at
    zero pose, one import-mesh root per visual. It reproduces g1_full.loon
    byte-for-byte on the transforms, so the G1 and H2 renders are now from one
    script.
    h2-full-{iso,side,front}.png rendered through vcad-render like everything
    else here. lineup.py composes renders at TRUE relative scale (each render's
    drawn height is its z ex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
2026-08-19 pro: chest over pelvis, thigh jogged to the knee, windows for hole fields, arms as channels -- the H2 pass, and what the sweeps made of it
    "She's starting to look heavy." Measured against the H2's own meshes (next
    commit has the numbers) the heaviness was three things: the leg was WIDEST at
    the knee (126 x 162 mm - the knee stator plate bridged 160 mm from the front
    web to a knee 55 mm back); torso + hip stack + thigh wrap was one prism with
    no width reversal for 48 % of the height; and the chest kept full width 70 mm
    above the shoulder axis. The arms were not there at all (a 3 mm strip that
    did not reach the roll output; nothing between elbow output and wrist).
    The cut, all in rose_pro_lin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
2026-08-19 pro: H2, measured -- why the wrapped body read heavy, in numbers
    UNITREE.md gets a second section with the H2 sliced every 25 mm from its own
    meshes and rose pro sliced from the plate table, before and after:
    thigh, hip end -> knee end H2 143x128 -> 72x74 (2:1 taper, knee a pinch)
    ours 85x74 -> 118x99 -> 126x162 (widest AT the knee)
    now 85x74 -> 124x99 -> 100x100
    chest : waist H2 1.6 (255:160) over a 216 pelvis pod
    ours 1.0 (206:206), no pelvis; now 1.32 + pod
    torso shell / height H2 26 %; ours 32 % one box; now chest 18 over waist 14
    shank : thigh H2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
2026-08-19 pro: emit rose-pro.loon as roots-only with [use plates [...]]; fix duplicate bendtab names
    The plate/bore/actuator helpers are now a loon module, hardware/rose-pro/plates.loon
    in vcad (resolved next to the generated file; see ecto/vcad#823). The HELPERS
    preamble is gone from this generator.
    Also: the ankle link has two bend tabs with the same tag, so the generated
    file bound L_ankle_bendtab / R_ankle_bendtab twice and the second let shadowed
    the first - both roots rendered the same tab and one tab was never drawn.
    vcad's new root cache reported 2 hits on a cold run, which is how it surfaced.
    Repeated tags within a link now get a _2 suffix.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
2026-08-19 pro/cad: regenerated rose-pro.loon — roots only, [use plates], unique bendtab names
2026-08-19 render.sh: resolve [use plates] via VCAD_LOON_PATH; note the vcad root cache
2026-08-19 pro: size the line at 1800 / 2000 -- the actuator decides the layout
    "rose pro should be about 1800 mm, rose max 2000." Height is the root
    decision, so before any link moves: mass and per-joint peak torque at each
    height, calibrated on the three URDFs we have (G1, H2, rose pro all want
    ~1.3 m g L_thigh at the knee; H2 gives every hip axis the knee's actuator),
    mass as height-cubed density (H2 11.6 kg/m^3 design, G1 14.8 pessimistic),
    and a pick from what exists. sizing.py is the calculation; SIZING.md the
    decision and the catalogue.
    pro @ 1800: 68 kg design / 86 pessimistic. Hip pitch and knee want 349 N.m
    (446 pessimistic) -> RMD-X15-450, hip roll X12-320, hip yaw X10-200, ankle
    and should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
2026-08-19 pro: re-lay out at 1800 mm -- layout parametric on height, plate table derived from it, every gate green
    (a) of the H3 programme. rose_pro_layout.py is now the single source: HEIGHT,
    the H2's proportions (thigh 0.225 H, shank 0.270, torso 0.290, arm 0.257) and
    the actuator envelopes from SIZING.md give every joint position; the lateral
    layout comes from the envelopes (hip pitch at y 94 because two D166 X15 bodies
    sit end-to-end at the centre; the roll/yaw/knee/ankle column OUTBOARD at y
    164 because a D124 roll body cannot nest under a D166 pitch body - the H2's
    arrangement, pitch 80 / roll 144 / knee 157). rose_pro_export.py reads the
    layout; the URDF/MJCF at ~/Developer/pond_assets/robots/r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
2026-08-19 pro: plates can be polygons and can tilt -- and the torso, thigh and knee use it
    (b) of the H3 programme. The axis-aligned rectangle was the reason nothing
    could taper and chest:waist stalled at 1.3. Plate now takes `poly` (a CONVEX
    outline in its own plane, every vertex rounded by the plate's corner radius)
    and `tilt` (a rotation about a world axis through a pivot), and every consumer
    asks the plate instead of reading its rectangle:
    * rose_pro_links: Plate.outline / sdf_uv / local_to_world / world_to_local;
    poly_sdf + poly_inset (a rounded convex polygon is the inset polygon's SDF
    minus r); box() is the rotated prism's AABB; fit() leaves polygons alone
    and the containment che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
2026-08-19 pro: a pelvis that is a part -- waist yaw on an X8-120, the hub the hips and the torso bolt into
    (c) of the H3 programme (UNITREE.md item C). The 1173 body hung the hips off
    the trunk box; the 1800 layout already enclosed the two D166 hip-pitch
    bodies in a pod whose walls are their stator plates. Now that pod is its own
    LINK on a waist yaw:
    * rose_pro_layout: waist_yaw, an X8-120 (H2 waist yaw 120 N.m) standing
    FACE UP on the centreline, its body inside the pelvis 4 mm over the hip
    bodies' tops, face at z 106. Layout clearance 7.1 mm to the hip bodies.
    * rose_pro_export: a Pelvis link (the two X15 + the X8 + 2.2 kg sheet =
    10.6 kg), Waist_Yaw Trunk->Pelvis at z 106, the hips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
2026-08-19 pro: pushrod ankle -- both ankle motors up the shank, cranks and rods, pins at the ankle, and the sweeps that shaped it
    (d) of the H3 programme (UNITREE.md item B; rose max already commits to it).
    No actuator at the ankle any more. Both ankle motors are X8-120s carried on
    the shank's inner face at z -627 / -729 (the calf), their output CRANKS on
    the outer face, two vertical D10 pushrods down to a sheet YOKE on a pitch
    pin, the foot on a roll pin through the yoke. Pitch and roll are pins 28 mm
    apart; the 116 mm serial stack is gone. Proportions now land exactly on the
    H2: hip pitch 53 % of height, shoulder 82 %.
    * rose_pro_layout: ank_mA / ank_mB (X8-120, faces in the shank web's
    plane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
2026-08-19 max: re-scope to 2000 mm -- the numbers, and the actuator that does not exist yet
    "rose max 2000 mm." max's geometry is rose-1, the 1210 mm R1-class study on
    rana-140 / rana-100, and its INTERFACES.md targets are the R1's. At 2000 mm
    (pro/sizing.py, calibrated on the G1 / H2 / rose pro URDFs): 93 kg design /
    118 pessimistic, hip pitch and knee 533 N.m (679), hip roll 410, shoulder
    pitch 148. rana-140 is 96 N.m: at this height it covers the ankle drive and
    the arms only. The hip and knee want a rana-200-class unit at ~550 N.m peak
    - the H2's 360 N.m joint scaled to 180 more millimetres and 23 more kilograms
    - and that is a new line item with an envelope nobody has drawn.
    So the re-scope is w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
2026-08-19 pro: one loon module per link -- rose-pro.loon is an assembly of [use]s
    vcad #823 landed the module lib path and the content-addressed root-mesh
    cache. The generator now writes pro/cad (and vcad's hardware/rose-pro) as:
    links/<link>.loon one module per link, L and R plates as top-level lets
    (its exports) plus its OWN [root]s - which an importer
    does not see, so the file renders standalone
    actuators.loon envelopes and pushrods, same shape
    rose-pro.loon roots only: [use links.thigh [L_thigh_web ...]] and a
    [root] per name, for every module; defparams; material
    plates.loon (the vocabulary) stays hand-maintain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
2026-08-19 pro: photoreal hero render of the 1800 mm body (vcad-render --photoreal, 256 spp, 30 deg lens)
2026-08-19 leg: H2's massing in sheet -- thigh taper, knee shroud, calf shell, a foot that is a shoe
    In profile the leg read as an open channel, then a D166 can, then a stick with
    two bare X8s on it, then a flat plate. The H2's leg is widest under the hip,
    tapers to a pinched knee, swells to a calf, pinches to the ankle, ends in a
    shoe. Four cuts, all inside the leg blocks of rose_pro_links.py:
    THIGH -- more taper. TH_IN 16 -> 22 mm of lean per flange: the channel now goes
    174 wide at the hip to 130 at the shelf (was 174 -> 142); H2 is 143 -> 72. The
    lean is pivoted at the TOP, so it cannot touch the yaw body and does not grow
    the hip_yaw envelope -- flange_in/out vs hipB's stator plate is 0.4 mm at 4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
2026-08-19 pro: an H3 head -- a faceted helmet on a short neck, not a die on a stack
    The head was the last item on DESIGN.md's open-geometry list and the biggest
    "H2 vs ours" difference left in profile: a 198 mm open cage of four plates
    sitting 49 mm above the chest deck on a visible neck-actuator stack. The H2's
    head is a small closed helmet with no neck gap. This is that, in bent 3 mm.
    WHAT IT IS
    The sagittal section is ONE convex polygon; every panel is an edge of it.
    Seven brake hits round the section --
    jaw (42,553) -> face (66,588) -> crown_fr (79,681) -> crown_top (38,706)
    -> crown_bk (-55,706) -> rear (-88,671) -> underside (-88,559) -> jaw
    -- and the flanks (the polygon itself)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
2026-08-19 pro: H3 torso and pelvis -- a chest deep at the sternum over an exposed waist
    The chest was a flat-fronted, flat-backed rectangle with one square window and
    the pelvis was a square box: in profile rose pro had no figure at all. The H2
    reverses width four times between chest and knee and is deepest at the sternum.
    This is that massing, in bent 3 mm sheet, and every number in it is either the
    H2's proportion or a clearance.
    The tool: `xpanel` -- an x-normal plate TILTED ABOUT Y. The front and rear
    panels' outline lives in (y, z), so a polygon there shapes the FRONT view and
    nothing shapes the SIDE view; that is why the chest was a rectangle in profile.
    Tilt it and the outline's v axis becomes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
2026-08-19 pro: an arm with section -- shoulder cap, tapered channels, a hand that reads as a hand
    The arm was the last thing on rose pro still built like the 1173 mm body: the
    shoulder pitch X8 was a bare can standing 87 mm proud of the chest side, the
    upper arm was a parallel channel, the forearm was two 3 mm strips with the
    wrist actuator hanging off the bottom of them, and the hand was a 60 x 60 palm
    plate. The H2's arm is a tapered shell from shoulder to wrist ending in
    something you read as a hand from across a room. This is that, in bent sheet.
    WHAT IS NEW
    * shoC, the shoulder cap (new link, 5 plates, 118 g). Three facets tangent to
    r 51 about the pitch axis -- top plate, 45 deg chamfer, fro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
2026-08-19 sweep: shoC rides the trunk -- add it to waist_yaw's child side
    Choji caught it: the shoulder cap is fixed to the trunk and rotates over
    the pelvis during waist yaw, but was only listed as a sho_roll/sho_pitch
    parent. Swept: it clears (not in the worst-8 pairs); VERDICT stays PASS.
2026-08-20 pro: posed photoreal heroes -- pose.py wraps the zero-pose modules in joint transforms
    A pose is an ASSEMBLY concern: links/*.loon stay zero-pose (fabrication truth,
    cache keys); pose.py emits rose-pro-{stride,wave,stand}.loon, wrapping each
    imported root in rotate-about-joint transforms along its kinematic chain,
    proximal outermost. Actuator bodies ride the link their stator is on; rods
    ride the shank. Right-side x/z joints negate the angle so poses read symmetric.
    Poses respect sweep.py's RANGES (single-joint clearance is proven there;
    combinations were eyeballed on fast rasters before spending photoreal time).
    Found while posing: 97 deg of abduction is only just past horizontal, so the
    w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
2026-08-20 pro: skin.py -- the polymer skin layer as [skin r] over the bone modules
    15 panels (thigh/calf/foot/upperarm/forearm/hand x2, pelvis/chest/head
    centred), each [shell 3 [skin 12 :gap 6 bones+actuators]]. Panels never
    span a joint. SKIN_R is the cobot number: no curvature tighter than 12 mm
    anywhere a person can touch. Renders once vcad's [skin]/[shell] land.
2026-08-20 pro: the skin renders -- 15 panels over the bones, and two kernel edges found
    skin.py now also emits rose-pro-skinned.loon (bones aluminum + actuators +
    skin). Two findings against vcad's [skin], both worked around and worth
    filing: (1) a group spanning shoulder-can to shoulder-can blew the 40M grid
    cap and evaluated EMPTY rather than coarse (chest panel now excludes the
    sho_pitch cans - shoC's cowl covers them); (2) a group of ONLY thin tilted
    3 mm plates with no bulk vanishes in the SDF at cell = r/6 (the documented
    thin-feature limit) - shoC stays bare sheet.
    Syntax updated to the branch as implemented: [shell t [skin-gap r g #[...]]].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
2026-08-21 pro: windows in the skin, and the hips learn to be joints
    Four reveals cut through the shells (windows() in skin.py, coordinates from
    the plate table): knee rings, calf pushrod slots, the chest window, and a
    visor slot the stereo pair reads through. The pelvis skin is the pod ALONE:
    skinning the crossed hip actuators bridged them into X-webs (rolling-ball
    closing in the crotch of a cross) - the cans stay dark and exposed, which is
    the joint reveal anyway.
    Rendered on the merged skin+perf vcad: warm photoreal is now ~6 min for the
    skinned body (1.5M skin triangles; bare rose-pro hits the 7 s number) vs
    2h16m cold. --gpu refuses >1M triangles rather than falling back - filed
    mentally against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
2026-08-21 pro: bone diet, first cut -- the hems come off
    Every hem plate is deleted (thigh windows, chest front/rear, shoulder cap,
    upper arm, forearm, hand, visor): under the skin their person-facing job is
    gone, and the chest apertures stay as slots without the doubled edge.
    9320 -> 9109 g of sheet per side; 118 -> 105 plates; all gates green
    (0 clashes, 0 bend-rule violations, 12 sweeps PASS). Skin re-rendered:
    externally identical, which is the point.
    Revising the earlier -5 kg estimate honestly: the big cosmetic sheet
    (helmet shell, knee facets, calf shells, foot walls, chest chamfers) is
    what GIVES the skin its form - [skin] wraps bones, so removing them
    collapses the shape. They can only shrin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
2026-08-21 pro/skin: the windows never cut -- stale loop variables, and a radius rule
    Two bugs, one render apart.
    1. The emission loop read `panel` and `side` from the COLLECTION loop, which
    by then held the last entry - so every shell got the head's visor cut (a
    no-op anywhere off the head) and the knee rings, calf slots and chest
    window were never emitted at all. What looked like a working knee ring in
    the leg render was bare bone showing through a severed skin. Roots now
    carry their own panel/side.
    2. The ball must be BIGGER than any aperture it should span, or it rolls
    through: at r 12 (24 across) the thigh's 65 x 48 flange window became a
    hole in the skin and the jog step ne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
2026-08-21 pro/skin: form blocks -- give the hollow panels something to wrap
    A bone group is mostly air. The rolling ball dips into every lightening
    aperture and between every pair of flanges, so the arms and chest skinned
    into bags around bare sheet instead of limbs. Inflating r would fix it and
    is the wrong lever: r is the SAFETY number, and a chest at r 45 (what its
    85 mm side slot would need) is a balloon.
    Instead each hollow panel carries a FORM block - a filler primitive inside
    its bones, sized from the panel's own plate bounding box and inset so it
    never pokes through the sheet. Form authored with a primitive, which is the
    subdivision-cage idea in the vocabulary we have today. Upper arm, forear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
2026-08-21 pro/skin: split the shoulder off the upper arm -- a panel may not span a joint
    shoA and shoB straddle the shoulder ROLL joint, and I had them in one panel:
    the skin would have torn on abduction, and in the body render it showed as
    bare sheet flanking the arms because one form block cannot describe two
    links that move apart. Now 'shoulder' (shoA, on the pitch output) and
    'upperarm' (shoB, on the roll output), each with its own form block, 16
    panels total. My own rule, applied to my own table.
2026-08-22 pro: a clearance gate for the SKIN, and it fails -- which is the point
    The skin had NO gate. sweep.py proves the bones clear; the skin stands proud
    of them, so a bone pair clearing by 4 mm is a skin pair overlapping by 8.
    Nothing checked that, and the renders could not show it.
    skin_sweep.py sweeps the panels analytically, no mesh needed: [skin-gap r g X]
    puts the outer surface +g off the hull of X, so a panel proxy is (its bones +
    its form blocks) offset by SKIN_GAP, and
    skin gap = bone gap - 2 * SKIN_GAP
    It found adjacent panels overlapping at 8 of 9 joints. Two causes, and the
    first is now fixed: my form blocks crossed each other (shoulder into upper
    arm by 42 mm, forearm into uppe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
2026-08-22 pro/skin: seams sized by the gate -- knee, waist, wrist and hips now clear
    Working the gate's findings rather than guessing. Seam radii are now results:
    knee 95 -> 130 (at 95 the thigh and calf shells still met at rest), waist
    60 -> 125 (the chest floor and pelvis top are a 200-wide pancake pair that
    touches BY DESIGN, and a 60 seam left both skinned - the wide gap this leaves
    is the exposed waist the H2 has, arrived at from clearance rather than
    styling), wrist 42 -> 58, and an ankle seam that did not exist. Chest form
    block raised off the pelvis; hand block pulled back from the wrist.
    The shoulder panel is DELETED, measured: 102 mm between the shoulder pitch
    and roll axes against 114 mm o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
2026-10-13 arm: a RobStride table arm, from boxes to forks
    A 6/7-DOF arm on RobStride integrated actuators, flat sheet cut on the
    Anolex 4040, meant to be sold and to be rose's arm.
    - layout, sizing and clearance (rose_arm_layout.py), bone section search
    (rose_arm_bone.py), cable harness model with pinch / kink / snag sweeps
    (rose_arm_cables.py), pose-aware geometry (rose_arm_geom.py)
    - phyz sim (sim/): hold, power cut, reach, roll and a payload duty sweep.
    Finds ~1.5 kg continuous / 2.5 kg peak, and that the J2 gas spring is
    only a failsafe together with shorted motor phases
    - fork concept (fork/): every pitch joint a fork on one centreline, cables
    through hollow sleeves on the pitch axes a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
    [rose_arm.urdf, rose_arm_payload.urdf, rose_arm_payload_0.0.urdf, rose_arm_payload_0.5.urdf, rose_arm_payload_1.0.urdf, rose_arm_payload_1.5.urdf, rose_arm_payload_2.0.urdf, rose_arm_payload_2.5.urdf]
2026-10-13 arm/fork: RobStride interfaces and mechanical answers, elbow test rig
    Answers from the vendor manuals and STEP (~/Developer/robstride_assets):
    - manual drawing interfaces for RS06: output 6x M4 on 24, stator front
    8x M3 on 82 with a 52 spigot (corrects the STEP-only reading)
    - Kt 1.09 N.m/Arms, R_phase ~0.15 ohm -> shorted-phase damping ~2.6 N.m.s/rad
    - power-off anti-backdrive protection exists, on by default; whether it
    engages at falling-arm speed is rig test #1
    - holding is the thermal limit: 8 N.m continuous at stall, not 11. Continuous
    hold straight out drops to 0.5 kg at the elbow - it binds, not the shoulder
    - output bearing ~61807 class; the fork carries the child on both side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
    [child_A_3mm.dxf, child_B_3mm.dxf, parent_A_3mm.dxf, parent_B_3mm.dxf, sheet_3mm_1.dxf, sheet_3mm_2.dxf, spacer_disc_3mm.dxf]
2026-10-13 arm/fork v4: size up the shoulder and elbow, no springs
    Holding is a stall; with the manuals' stall-continuous ratings v3 could not
    hold anything without its gas spring. Instead of adding springs, size up:
    shoulder RS04 (25 N.m stall-cont on a ~220 mm plate), elbow RS03 (13),
    wrist RS00 x3, reach 743 mm. size_actuators.py searches all combinations
    with the arm's own weight re-computed.
    Holds 1.24 kg straight out continuously with no spring (wrist binds),
    ~6 kg peak, 0.04 / 0.11 mm deflection, elbow -165..+140. Covers and bars
    now stop clear of each motor so the bigger elbow still folds both ways.
    [fork_checks.py, rose_fork.py, size_actuators.py]
2026-10-13 arm/fork v5: two motor models, RS04 x3 + RS00 x3
    RS03 is not available. Searched every selection from the motors RobStride
    sells, ranked by continuous straight-out hold then by number of distinct
    models: RS04 at base yaw, shoulder and elbow, RS00 for the wrist. No third
    model helps; the base yaw takes an RS04 for its output bearing.
    703 mm reach, holds 1.24 kg straight out continuously with no springs,
    ~6 kg peak, 0.03 / 0.09 mm deflection. Shoulder and elbow are now the same
    joint. Elbow rig moved to RS04 interfaces (10x M4 on 106, 8x M5 on 36),
    270 mm test forearm, bar holes follow the plate taper.
    [child_A_3mm.dxf, child_B_3mm.dxf, parent_A_3mm.dxf, parent_B_3mm.dxf, sheet_3mm_1.dxf, sheet_3mm_2.dxf, spacer_disc_3mm.dxf]
2026-10-13 arm/fork v6: one plate family, flat sheet only, cables drawn honestly
    - shoulder motor flipped onto the upper arm: the arm holds the same RS04
    joint at both ends, constant width; the turret straddles it. The motor's
    mass is on the shoulder axis, so no torque cost
    - forearm-roll and tool-roll RS00s inside their links; collars gone
    - no 2020 bars: plates and flat covers only
    - base is a flat foot with the yaw RS04 in a slim collar
    - pitch-joint cable crossing modelled for real: out through the holder's
    plate B under the other lobe, an 18 mm gap with each leg on its own plate,
    twist on the axis inside the sleeve, turn under an orange hub cap
    Holds 1.28 kg straight out continuously (was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
    [fork_checks.py, rose_fork.py]
2026-10-13 arm/fork: v6 motion video
2026-10-13 arm/fork v6.1: interference and pinch audit, and the fixes it found
    audit.py: true solid-in-solid interference across every video frame and
    full joint sweeps, plus crush (gap closing under 25 mm) and shear (4-25 mm
    relative motion) classification per ISO 13854 / 13857. Replaces the old fold
    check, which compared surface-point distances and missed buried overlaps -
    its elbow -170..+150 claim was wrong.
    Fixes:
    - forearm tip narrowed to just clear the J5 motor; yoke plates outboard of
    it, starting behind a thicker hub disc - they overlapped at every pose
    - finger-safe 3 mm gaps on both sides of each pitch joint: flat high-flex
    cable in routed grooves in 4 mm B plates (was an 18 mm gap)
    - y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
    [audit.py, rose_fork.py]
2026-10-13 arm/fork v7 + v8: hybrid wrist, then a DFM and efficiency pass
    v7: RS02 at forearm roll and wrist pitch, RS00 at tool roll (no gravity
    load about its own axis). Forearm tip, yoke and wrist lobes resized; yoke
    hub moved back 8 mm to clear the RS02. Old fold check removed from
    fork_checks.py - audit.py is the source of truth for ranges.
    v8, from dfm.py (process, bed fit, web and tool rules, unique parts):
    - holder plates holed inside the motor bolt circle; span-fitted windows
    - hub caps thin cups (were modelled solid steel, 117 g each -> 5 g)
    - flat 3 mm yoke bridge instead of an 8 mm disc (177 g -> 24 g)
    - B plates 3 mm, single-layer 4 mm cable gap (legs in different sectors)
    - turret disc 3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
2026-10-13 arm/fork v9: complete - back-mounted motors, tabs and slots, fab package
    Real RS04 / RS02 / RS00 interfaces from the manual drawings. Every motor
    back-mounted: plate B carries motor and sleeve, plate A clears the nose,
    straddler bolts to the output through a 3 mm spacer. 4 mm gaps throughout.
    Every plate flat and parallel: v8's flared forearm could not sit flat on
    the elbow spacer. Both roll motors are now cartridges on end plates; side
    plates tab through the end plates; covers, bridge and towers tabbed too.
    One 3 mm stock (6 mm foot), closed hub caps, lobe rings in the stiffness
    model, sleeves in the mass.
    fab.py writes fab/: 20 unique DXFs, nests (3 x 3 mm + 1 x 6 mm, upper
    plates at 21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
    [3mm_sheet1.dxf, 3mm_sheet2.dxf, 3mm_sheet3.dxf, 6mm_sheet1.dxf, foot_6mm_x1.dxf, fore-A_3mm_x1.dxf, fore-B_3mm_x1.dxf, fore-end-plate_3mm_x1.dxf]
2026-10-13 arm/fork v9: 1/8 in (3.175 mm) stock, 1/4 in foot, nests on 15 x 15 in sheets
    Plates, covers, spacers tied to T_PL. 8.34 kg, holds 1.46 kg straight out,
    no interference, end plates widened 0.3 mm to keep the 1.5 t web rule.
    [3.2mm_sheet1.dxf, 3.2mm_sheet2.dxf, 3.2mm_sheet3.dxf, 3mm_sheet1.dxf, 3mm_sheet2.dxf, 3mm_sheet3.dxf, 6.3mm_sheet1.dxf, foot_6.3mm_x1.dxf]
2026-10-13 arm/controller: design v0.1 for the per-arm controller board
    STM32H723 (3x FDCAN, Ethernet), two motor buses, LM5069 hot-swap with a
    hardware e-stop path and window watchdog, brake chopper to a resistor on
    the foot, INA229 bus monitor. Replaces the RobStride power board,
    discharge module, USB-CAN adapter and a Teensy. Also adds animate.py
    (resumable motion video).
    [animate.py]
2026-10-13 arm/controller: schematic v0.1 in loon, exported to KiCad by vcad
    arm_controller.loon is the circuit: 168 KiCad library parts, 110 nets.
    build.sh exports it with vcad, checks KiCad's netlist against the loon
    nets pin for pin, runs ERC (0 errors) and plots a PDF. DESIGN.md notes
    the parts swapped to ones in KiCad's library and the pin-map changes.
    [arm_controller.kicad_sch]
2026-10-13 arm/fork fab: J7 output screws M3x10, shared by the tool flange and gripper top plate
2026-10-13 arm/controller: simulate the power path with vcad chips; fix three schematic faults
    sim/ runs hot-swap, e-stop chain, brake comparator and chopper on vcad's
    solver with behavioural ICs. It found: brake hysteresis 1 V (chatter) ->
    R16/R17/R20 309k/10.2k/309k; 10 ohm brake resistor can't hold >5 A regen
    (20 A -> 188 V) -> 3.3 ohm; e-stop hold varied 104-142 ms with uptime ->
    BAT54 across R8, C3 390n, fixed 188 ms. Schematic rebuilt: 0 ERC errors,
    netcheck clean.
    [arm_controller.kicad_sch, brake_chopper.csv, power_path.csv]
2026-10-13 arm/controller/sim: drop stale brake_chopper.csv from the first harness
    [brake_chopper.csv]
2026-10-13 arm/controller: board placement in loon, muni logo + board art, route script
    - 150 x 40 mm, 4 layers (GND In1, +3V3 In2). place.py puts the anchors
    (edge connectors facing out, MCU, PHY, transceivers, FETs) and packs the
    rest next to what they connect to; output is [EcadPlace] lines in the loon.
    - Space: one XT30 for the three RS04s (split in the harness), 6x6 mm
    inductors, the 50 A fuse inline in the supply cable.
    - brand/svg2fp.py: stroked SVG -> KiCad silkscreen footprints; brand/muni.pretty
    is the muni logo at 8/12/20 mm, front and back, for any board.
    - art.py: the fork arm drawn on the back from its own dimensions, board
    name and notes, and a message hidden inside the MCU's p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
    [arm_controller.kicad_sch]
2026-10-13 arm/controller: first routed draft (vcad route, rotation fix + declared currents), renders
    92% of connections routed; KiCad DRC: 2 shorts (USB ESD part under the RJ45
    shield pin), 199 unconnected (Ethernet RMII between MCU and PHY, +3V3
    stitching), 19 courtyard overlaps. Only GND was poured despite declared
    currents - next to look at. Not for fab.
    [arm_controller.kicad_pcb]
2026-10-14 arm/controller: limb controller on 6 layers
    One board for arm, leg, torso and head: board ID divider, ISM330DHCX IMU,
    ADS1220 load-cell input, MCP251863 fourth CAN-FD, DRV8871 brushed driver,
    fused 48 V aux out, four M3 holes. Stack F/GND/sig/+3V3/sig/B with the
    planes kept trace-free. route.sh: KiCad fill, drop what KiCad calls
    dangling, DRC; route_best.sh keeps the best of N router runs. DRC:
    13 unconnected, 3 silk warnings left. Plus the v9 motion video.
    [arm_controller.kicad_pcb, arm_controller.kicad_sch]
2026-10-14 arm/controller: 3D render of the routed 6-layer board
2026-10-14 arm/fork: v9 motion video with a fixed camera
    Framing anchors now span the arm's whole reach (the tool swings below and
    behind the base), so the camera no longer rescales between frames. A frame
    that hangs the renderer is skipped after 10 min and holds the previous one
    (3 of 130 here).
    [animate.py]
2026-10-14 arm/controller: premium pass, closer for open connections
    Black mask, muni orange silk, ENIG (set_finish.py). Clean front: designators
    on the fab layer, labels on the back, the muni logo in bare gold copper.
    Shield-can frame and lid round the MCU. Passives packed against the pin they
    serve, aligned on a grid. Teardrops at via joints, gold edge rim with a
    stitching-via fence inside it, placeholder 3D bodies for the XT and RJ45
    connectors. J3 is an XT30 now. close_unconnected.py closes what the router
    left open by KiCad's own DRC and drop_added.py removes any addition DRC
    flags. DRC: 10 unconnected (2 long signals, MCU plane pins), 13 silk/minor.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
    [arm_controller.kicad_pcb, arm_controller.kicad_sch]
2026-10-14 arm/controller: route ETH_REFCLK, CANX_INT, BK2_FB first
    vcad reports 100% routed; KiCad still finds 10 open (MCU plane pins, two
    long signals, three layer-change gaps). Re-rendered.
    [arm_controller.kicad_pcb]
2026-10-14 close_unconnected: L-shaped plane stubs, offset hop vias; DRC report refreshed
    The committed board has 8 open connections by a fresh KiCad DRC (the
    earlier report was stale): +3V3/GND plane pins of U10, C28 and U18, and
    USB_DM between the J12 A7/B7 pads. vcad's own clean-up lists the same nets
    as split, so vcad and KiCad agree; these just aren't closed yet.
2026-10-14 arm/controller: route with plane prestitch (vcad 6ea67cf)
    All plane pins now reach their planes: the vcad router stitches each GND /
    +3V3 pad before fanning out (223 vias). Back art moved clear of the USB
    pins, fab text at the 0.8 mm minimum. astar_fix.py: a fine-grid fixer for
    hand repairs (rip-up and reroute, atomic per fix) - kept as a tool, not in
    route.sh: on this board its paths for the last long nets don't clear DRC.
    DRC: 4 unconnected (ETH_REFCLK, MOT_IN2, SPI_MISO, WD_KICK), 7 silk.
    [arm_controller.kicad_pcb]
2026-10-14 arm/controller: route with vcad's corridor grids and plane rule; hand fixes on record
    Back on the 150 x 40 rectangle (the arc/horseshoe experiments routed worse:
    16-28 open). Routed with vcad 0cdef22: first pass 60 s, whole route 15 min.
    manual_fixes.py records the hand work and route.sh replays it: +12V under L1
    had no vias at either end of its In2 run (and was 0.15 mm on a 1 A rail).
    stitch.py: no stitching via inside a rule area that forbids vias.
    DRC: 2 unconnected - ETH_RXN (PHY to R66, boxed in by ETH_TXD0/TXD1/PHY_XI
    on In4 and ETH_CT/PHY_VDDA on B) and AUX_IO (U10.44 to J11) - both need a
    push-and-shove reroute in KiCad. 8 silk/minor.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
    [arm_controller.kicad_pcb]
2026-10-14 arm/controller: every net connected - ETH_RXN routed in KiCad, AUX_IO pin-swapped to PB0
    DRC: 0 unconnected, 0 copper violations; 7 silk warnings left.
    - ETH_RXN (PHY to R66): routed in KiCad's push-and-shove router - In4, then a
    via beside R66 pad 2.
    - AUX_IO: moved from U10 pin 44 (PE13) to pin 34 (PB0), which faces J11
    (pin_swap.py on the board, the same change in the loon; netcheck passes),
    then routed by astar_fix.py on a 0.05 mm grid.
    - astar_fix.py / close_unconnected.py: vias at the board default (0.45/0.25,
    a per-layer SetWidth zeroed them), 0.2 mm clearance to the Power class.
    DESIGN.md records the hand work and how to replay it after a re-route.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
    [arm_controller.kicad_pcb, arm_controller.kicad_sch]
2026-10-14 arm/controller: real XT30PB wrist bus, 150x46 board, 13S brake thresholds, pcbway BOM
    - J9: XT30PB(2+2)-M footprint (art.pretty) instead of the pin-header placeholder;
    the board grew 6 mm (150 x 46) to fit it, then a full re-route.
    - Brake comparator on 57.0 / off 55.5 V for 13S packs (R16 301k, R17 9.09k,
    R20 665k); TVS SMDJ58A -> SMDJ60A. R3/R5/R16 to 0603 (75 V; 0402 is 50 V).
    - F1: Bel 0ZCF0110AF2A, 60 V 1.1 A hold (no 60 V 3 A 2920 exists).
    - fab.sh + pcbway_bom.py + bom_mpn.csv: gerbers, drill, CPL, and an assembly
    BOM with a part number on every line (SH1, R68, J4 pads, holes not placed).
    - astar_fix.py: Power-class clearance when routing a power net; ASTAR_WIN.
    DRC: 1 unconnec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
    [arm_controller.kicad_pcb, arm_controller.kicad_sch, bom_mpn.csv]
2026-10-15 arm/controller: every net connected, copper DRC clean
    - SPI_MOSI: routed by astar_fix.py (ASTAR_FORCE: rip IMU_INT's escape and
    leave it for a second pass).
    - IMU_INT: pin-swapped U10 pin 87 (PD6) -> pin 7 (PC13), routed. Firmware:
    IMU_INT is PC13.
    - +12V: the 0.5 mm jog by the ETH_REFCLK via re-laid 1.4 mm left (0.2 mm
    Power clearance).
    - astar_fix.py: a track (not just a pad or via) can be the goal; ASTAR_WIN;
    ASTAR_FORCE; reports which ripped net could not be rerouted.
    DRC: 0 unconnected, 0 copper violations; 3 silk-over-mask on the back art.
    [arm_controller.kicad_pcb, arm_controller.kicad_sch]
2026-10-15 brain: three-board electronics design (limb, power spine, brain) sized from the k1 stack
2026-10-15 brain: RK3588S2 ball list from the datasheet (1253 balls, checked), footprint and symbol generators; ROCK 5C v1.1 schematic + RK3588S datasheet as references
2026-10-15 brain: full schematic - RK3588S2 + 2x LPDDR4X + RK806/RK860 power after ROCK 5C, STM32H7 realtime core, 6 CAN-FD buses, M.2, 2 cameras
    - lib/gen_lib.py: symbols/footprints from pin tables (RK3588S2 1253 balls, JEDEC
    LPDDR4X 200-ball, RK806-1, RK860 WLCSP20, eMMC 153, SY8089, SGM2576).
    - gen_brain.py: the circuit as data -> brain.loon; SoC power map by ball-name rule,
    every pin looked up by name. 1069/1253 SoC balls used (rest: HDMI/DP/USB3/2nd
    DSI, spare GPIO).
    - build.sh: vcad export, netcheck (no merged nets), ERC: 5 errors left, all
    expected (MCP251863 EP is 'NC' in KiCad's symbol; shared SPI SDO).
    [brain.kicad_sch]
2026-10-15 brain: placement (571 parts, SoC/DRAM caps on the back), BGA fanout (laser via in every used ball), route.sh; DESIGN v0 notes
    [brain.kicad_pcb, brain.kicad_sch]
2026-10-15 rename size variants: pro -> full, max -> mega
    mini stays mini (K1 size); full is the 1750 mm human-size body, mega the
    2000 mm industrial one. Moves pro/ -> full/, max/ -> mega/, rose_pro_*.py ->
    rose_full_*.py, cad/rose-pro.loon -> cad/rose-full.loon and the renders,
    and updates identifiers, imports, paths and prose to match.
    External paths outside this repo (vcad hardware/rose-pro, pond_assets
    robots/rose-pro and rose_pro_plates.json) are left as-is.
2026-10-15 brain: restack (In1 GND, In2 SoC power, In4 VDD2 + board power, In6 VDDQ), planes for core rails only, 110x84, DDR priority; fast loop at 90% routed / 579 unconnected
2026-10-16 arm/fork: ROSE_ARM=mini size switch - K1-scale lengths, RS02 / RS00, ratings per joint
    First numbers: with RS02 at the shoulder the mini arm can't hold itself
    (-0.55 kg); the RS00 wrist stack sets the reach (566 mm to the jaws).
    Exploratory - direction (5 DOF, RS04 shoulder, or smaller wrist servos) open.
2026-10-16 arm/fork: ROSE_ARM_MOTORS / ROSE_ARM_LEN overrides for sweeps; harness mass scales with arm length
    RS02/RS00-only mini: a single RS02 shoulder can't hold the arm at any
    length tried (180/170 down to 120/110); two RS02s on the shoulder fork
    hold 0.28-0.91 kg. Full arm numbers unchanged.
2026-10-16 arm/fork mini: twin RS02 shoulder and no-J5 (5 DOF) variants, modelled; side-by-side renders
    ROSE_ARM_TWIN_SH=1: two J2 motors back to back on a centre web, both turret
    plates driven. ROSE_ARM_NO_J5=1: J6 holders tab into the forearm end plate.
    At 150/110 with both: 4.3 kg, 476 mm, holds 0.73 kg (elbow binds).
    [fork_checks.py, rose_fork.py]
2026-10-16 arm/fork mini: RS02 yaw / RS04 shoulder / RS02 elbow / RS00 / RS00, 5 DOF, 150/110 - the full arm's motor models
    One motor per joint. Flat parallel upper plates with a shorter elbow motor
    (13.9 mm turned spacer), holes sized per motor, scaled foot and turret,
    shoulder at 150 mm. 4.8 kg, 476 mm, holds 0.72 kg (elbow); no interference,
    no DFM web violations. Full arm unchanged.
    [fork_checks.py, rose_fork.py]
2026-10-16 brain: through vias 0.40/0.20 (0.15 mm through 1.6 mm was past 10:1), route.sh tees live vcad output to route.vcad.log, ignore route checkpoints
2026-10-16 arm/fork: scenarios (real objects, IK, per-frame load check, full vs mini) and mini arms on rose
    world_loon takes a rigid mount (R0, at), a name prefix and skipped parts, so
    several arms share a scene. scenarios.py: six pick-and-place tasks; mini does
    the four everyday objects, misses the far can, can't lift the 1.5 L bottle
    (J4 145%). rose_arms.py: mini arms on rose-pro's shoulders, J1 as shoulder
    roll (RS04), rough - the humanoid is being redesigned.
    [rose_arms.py, rose_fork.py, scenarios.py]
2026-10-16 brain: rail regions as a nearest-pad partition (0.4 mm Voronoi, rects with 0.05 overhang) instead of overlapping boxes; fast route 523 -> 487 unconnected
2026-10-16 brain: full route on Voronoi rail regions + 0.2 mm through vias: 472 unconnected (was 579)
    [brain.kicad_pcb]
2026-10-16 brain: via in every back-side 0201 cap pad (GND to In5, rail to its plane layer); fast route 487 -> 475
2026-10-16 Revert "brain: via in every back-side 0201 cap pad (GND to In5, rail to its plane layer); fast route 487 -> 475"
    This reverts commit bc3675026352d64c726fdbc0573a4e2a856785f2.
    [fanout.py]
2026-10-16 brain: Voronoi rail patches joined by corridors, _MEM rails routed as traces, ball-field same-net links on the plane layers
2026-10-16 arm/fork: emit each plate in its link frame under one [translate [rotate]]
    vcad-render then caches the plate (and its bolt-hole booleans) by shape, so
    every pose after the first is a cache hit: ~100 s -> 0.3 s per frame. The
    scenario runner renders frame 0 alone first to fill the cache before the
    workers fan out. Needs vcad branch render-rigid-cache.
2026-10-16 brain: full route with the via-stack fix: 271 unconnected (was 472)
    [brain.kicad_pcb]
2026-10-16 brain: ball-field links at any BGA pitch (DRAM 0.8 x 0.65 too), Kruskal over same-net pairs <= 1.05 mm clear of foreign vias; fast 316 -> 286
2026-10-16 arm/fork: render_bench.py -- the render yardstick (hero + clip per variant, timed, one gallery)
2026-10-16 brain: full route with any-pitch ball links: 257 unconnected (was 271)
    [brain.kicad_pcb]
2026-10-16 brain: full route at effort 2: 248 unconnected (was 257)
    [brain.kicad_pcb]
2026-10-16 arm/fork: scene(photo=True) -- shop finishes for --photoreal (brushed sheet, anodized black, powder-coat base)
2026-10-16 brain: full route effort 2 with DDR pinned (ddr_pin.py): 247 unconnected, DDR 41 -> 31
    [brain.kicad_pcb]
2026-10-16 brain: DQ swizzle within each byte (LPDDR4X allows it; DMI/DQS fixed) - DRAM bits paired with SoC bits in order across the bus axis, map in ddr_swizzle.csv for the DDR config; DDR re-pinned. fast 273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
    [ddr_swizzle.csv]
2026-10-16 brain: finish.py writes the board stackup with matte black mask, white silk, ENIG (rerun-safe); first look render
2026-10-16 brain: route.sh applies the matte black / ENIG finish after every route
    [brain.kicad_pcb]
2026-10-16 brain: split into compute module + carrier (split.py): SoC, 2x LPDDR4X, eMMC, RK806 + RK860s on the module (404 parts), the rest on the carrier (167); 44 nets cross two Hirose DF40C 100-pin B2Bs (fas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
    [b2b_pinmap.csv]
2026-10-16 brain: place/fanout/route parameterized by BOARD (brain | module | carrier); module 50x54 8-layer with the brain's SoC block at the origin and the B2Bs on the back; carrier 4-layer with a keepout und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
2026-10-16 brain: carrier full route (73 unconnected), module fast route, module renders
    [carrier.kicad_pcb, module.kicad_pcb]
2026-10-16 brain: carrier to 6 layers (F / GND / 3V3_RT / 5V_RT / GND / B): full route 73 -> 66 unconnected, rails closed
    [carrier.kicad_pcb]
2026-10-16 brain: carrier In4 as a signal layer (F / GND / 3V3_RT / 5V_RT / sig / B): full route 66 -> 62
    [carrier.kicad_pcb]
2026-10-16 brain: module to 10 layers (In7 sig, In8 GND), DDR pinned: full route 219 unconnected (DDR 19), down from 273 fast / 247 for the single board
    [module.kicad_pcb]
2026-10-16 brain: search.py - overnight placement search for the module (mutate DRAM / eMMC / PMIC anchors, score by fast route + KiCad unconnected, keep the best); place.py takes PLACE_OVERRIDE
2026-10-16 brain: module placement from search.py (DRAMs flipped 180 deg, ~2.5 mm out; eMMC nudged): DDR alone 92% routed, full route 219 -> 198 unconnected (DDR 19 -> 9)
    [module.kicad_pcb]
2026-10-17 quad00: RS00 quadruped leg with a sheet-gear knee -- generator, DXFs, print STLs, renders
    One leg as a bench rig: hip RS00 outboard, knee RS00 inboard driving a
    module 2.5 involute train (z17 pinion, two z17 idlers, z34 knee gear, 2:1)
    cut from the same 3.2 mm stock; the knee gear and shin are one laminate.
    leg.py emits router DXFs per layer and fused, print-flat STLs, checks mesh
    backlash, stack, knee fold (35 deg) and hip range (+/-129 deg), and poses
    an assembly for vcad-render.
    [carrier-L0_3.2mm_x4.dxf, carrier-in.stl, carrier-out.stl, carrier_x2.stl, idler-1.stl, idler-2.stl, idler-L0_3.2mm_x6.dxf, idler_x2.stl]
2026-10-17 quad00: Bambu P1S plates as 3MF (links, gears+carrier, TPU paw)
    leg.py lays the print-flat solids out on three 256 x 256 plates, asserts
    they sit on the bed with 3 mm between parts, and writes out/3mf/. Built
    from the in-memory manifolds rather than the STLs.
    [carrier-L0_3.2mm_x4.dxf, idler-L0_3.2mm_x6.dxf, pinion-L0_3.2mm_x1.dxf, pinion-L1_3.2mm_x3_csk-1.dxf, plate1_PETG_links.3mf, plate2_PETG_gears-carrier.3mf, plate3_TPU_paw.3mf, shin-L0_3.2mm_x3.dxf]
2026-10-18 quad00: assembly guide -- hardware, print prep, seven rendered steps, first power
    assembly_steps.py renders each step from out/assembly (fitted parts grey,
    the part going on in copper, pulled out along the hip axis) and inlines
    them into out/assembly-guide.html. Corrects the hardware: plain 8x10x8
    sleeves, not flanged (no room in the 0.4 mm gear-to-plate gap), and Ø8 x 20
    shoulder bolts with 3.2 mm of washers under the head so the shoulder sets
    the plate spacing. Knee kinematics: three external meshes, so
    knee = -(knee_motor - hip_motor) / 2.
    [plate1_PETG_links.3mf]
2026-10-18 quad00: keyed-arch hip yoke with the ab/ad RS00, ball paw; guide rebuilt to nine steps
    The carriers and M5 standoffs are gone. One arch (2 x 3.2 mm, YZ plane)
    bridges the two side plates, which key into it with tapered keys through
    tusk tenons -- plates and keys only, all 2D-cut. The arch sits ahead of
    the hip, in the forward-up sector a quadruped thigh never uses, so the
    hip now swings 81 deg forward (under the arch's leg-plane notch) to
    184 deg back over the top. The ab/ad RS00 bolts its output to the arch
    with its axis fore-aft in the leg plane, 60 mm above the hip; a bulkhead
    stands in for the torso. The paw is a TPU ball on two cross bolts.
    Also drops a stale second copy of the solid/e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
    [arch-L0_3.2mm_x2.dxf, arch.stl, arch_x1.stl, bulkhead-L0_3.2mm_x2.dxf, bulkhead.stl, bulkhead_x1.stl, carrier-in.stl, carrier-out.stl]
2026-10-18 quad00: 3D viewer template + assembled GLB
    viewer.template.html is a three.js turntable (orbit, explode, parts key,
    procedural brushed-aluminium and TPU textures); inline out/assembly/leg.glb
    as base64 at __GLB_BASE64__ to build the page.
2026-10-18 quad00: lower the ab/ad to 40 mm above the hip; trim the yoke; viewer lighting and flat shading
    ABAD_Z 60 -> 40 and the arch, notch, tenons and lightening now derive from
    it: arch + side plates 434 -> 337 g in aluminium, bulkhead 90 -> 72 mm
    square, hip forward swing 81 -> 60 deg (still 184 back, over the top).
    The viewer was rendering near-black with streaked facets: flat normals,
    a hemisphere fill, brighter exposure and less-mirror metals fix both.
    assembly_steps.py now also builds out/assembly/leg.glb and out/viewer.html.
    [arch-L0_3.2mm_x2.dxf, arch.stl, arch_x1.stl, bulkhead-L0_3.2mm_x2.dxf, bulkhead.stl, bulkhead_x1.stl, idler-L0_3.2mm_x6.dxf, key-L0_3.2mm_x4.dxf]
2026-10-18 quad00: the upper assembly is one bent U
    The arch, two side plates, four tenon keys and the bulkhead become a single
    U bent from 3.2 mm 5052: the base carries the ab/ad output over the thigh
    notch, the two flanges are the hip and knee motor mounts. The ab/ad motor
    back-mounts on the torso (a bench plate stands in). Upper assembly: 1 part,
    3 motors, 14 screws; leg aluminium 800 -> 620 g; hip 56 deg fwd / 184 back.
    leg.py writes the flat blank (263 x 105, bend lines on BEND_UP_90, inside
    R 3.2, K 0.44) and a 6.4 mm printed U; guide rebuilt to eight steps.
    [arch-L0_3.2mm_x2.dxf, arch.stl, arch_x1.stl, bulkhead-L0_3.2mm_x2.dxf, bulkhead.stl, bulkhead_x1.stl, idler-L0_3.2mm_x6.dxf, key-L0_3.2mm_x4.dxf]
2026-10-18 quad00: three motors coplanar -- ab/ad level with the hip, beside the leg
    The ab/ad RS00 drops to hip height and moves 42 mm inboard, in front of the
    knee motor, so all three axes lie in one plane and the thigh no longer
    sweeps through it. The U's bridge only has to span the leg plane, from
    30 mm up: hip 88 deg forward (was 56) / 184 back; yoke 162 -> 150 g.
    Ab/ad load with the 42 mm lever: 60% of RS00 peak worst case.
    To make room, the gear shafts become Ø8 clevis pins with E-clips (1.5 mm
    proud inboard) and 0.4 mm thrust washers: nothing to tighten. Checks now
    cover E-clip-to-ab/ad clearance and ab/ad holes vs the bend.
    [bulkhead-L0_3.2mm_x2.dxf, bulkhead.stl, bulkhead_x1.stl, idler-L0_3.2mm_x6.dxf, pinion-L0_3.2mm_x1.dxf, pinion-L1_3.2mm_x3_csk-1.dxf, plate1_PETG_links.3mf, plate2_PETG_yoke.3mf]
2026-10-18 quad00: the whole quad -- four legs on a placeholder torso, in the viewer
    quad.py places the leg four times (left/right mirrored, all facing forward,
    knees back) at 420 x 204 mm hips; each ab/ad back-mounts on a transverse
    bulkhead (front pair at the nose, rear pair inside the body) joined by a
    spine box. The GLB stores the leg once and instances it. The viewer opens
    on the quad with a Quad / One leg toggle.
2026-10-18 quad00: survey two whole-quad architectures in the viewer, with scale reference
    quad.py now builds the corner-pod layout (body as wide as the legs, legs
    at the corners, every ab/ad bolted to an end wall, front yokes flipped)
    and the side-hung layout (legs along the body, ab/ad on cross walls, body
    pocketed at the hips). Fixes the floating ab/ad of the previous build.
    The viewer switches between them and the single leg, over a 100 mm grid
    with a 330 ml can.
    [quad.py]
2026-10-18 quad00: both architectures get a real silhouette
    Corner pods: a low (82 mm) soft-edged slab as wide as the legs that runs
    out to the ab/ad output faces, so each leg plugs straight into a corner and
    the ab/ad motors disappear inside it.
    Side-hung: a full-width chest and belly, necked in to 71 mm only where the
    hip clusters tuck against the body, plus a tail spine.
    Both bodies are soft boxes (rounded in plan and elevation).
2026-10-18 quad00: a real side-hung body -- flat decks, tabbed ribs, internals, mass
    body.py: two 3.2 mm decks whose plan shape is the silhouette (chest and
    belly +/-88 for the ab/ad pairs, +/-35 necks where the hip clusters tuck
    in), split at a splice rib so every plate fits the 4040; nose and mid
    walls carry the ab/ad pairs, ribs tab into deck slots, sides stay open
    (the thighs pass 4 mm outside the decks). 12S2P battery in the belly,
    compute and power aft. 10.2 kg aluminium / 7.2 kg printed, CoM +27 mm.
    quad.py's side layout now uses it.
    [body-deck-front_3.2mm_x2.dxf, body-deck-rear_3.2mm_x2.dxf, body-mid_3.2mm_x2.dxf, body-nose_3.2mm_x2.dxf, body-rib-0_3.2mm_x1.dxf, body-rib-a_3.2mm_x1.dxf, body-tail_3.2mm_x1.dxf]
2026-10-18 quad00: pull the legs in -- leg planes at +/-87, 301 mm overall (Go2 ~310)
    Body narrows to 146 (necks 41), 9.9 kg in aluminium. The ab/ad pair
    still clears by 33 mm and the battery still fits.
    [body-deck-front_3.2mm_x2.dxf, body-deck-rear_3.2mm_x2.dxf, body-mid_3.2mm_x2.dxf, body-nose_3.2mm_x2.dxf, body-rib-0_3.2mm_x1.dxf, body-rib-a_3.2mm_x1.dxf, body-tail_3.2mm_x1.dxf]
2026-10-18 quad00: mock up the inboard hip -- both pitch motors inboard, 2:1 geared thigh
    The hip motor moves above the hip, inboard, and drives a z32 gear bolted to
    the inner thigh plate through a z16 pinion (m2.5, 60 mm centres); the knee
    motor stays on the hip axis 10 mm further in. An L-bracket replaces the U,
    nothing crosses the leg plane, and the thigh turns full circle. Leg planes
    back at +/-102: 224 mm overall (was 331), legs overhang the body 24/side.
    body.py gains configure() so the body follows the leg plane.
    [body-deck-front_3.2mm_x2.dxf, body-deck-rear_3.2mm_x2.dxf, body-mid_3.2mm_x2.dxf, body-nose_3.2mm_x2.dxf, body-rib-0_3.2mm_x1.dxf, body-rib-a_3.2mm_x1.dxf, body-tail_3.2mm_x1.dxf]
2026-10-18 quad00: inboard-hip quad on a belly-only body -- abduction can't catch
    body.configure(ends=False) drops the chest, necks and tail: one deck pair
    (328 x 176, a single router piece each) between two ab/ad walls. The front
    legs' L-yokes flip fore-aft so their ab/ad point back into the belly. The
    body stops 3.5 mm short of every hip cluster in x, and ab/ad rolls about
    x, so no abduction angle can bring a cluster into it. CoM +12 mm.
    [body-deck-front_3.2mm_x2.dxf, body-deck-rear_3.2mm_x2.dxf, body-mid_3.2mm_x2.dxf, body-nose_3.2mm_x2.dxf, body-rib-0_3.2mm_x1.dxf, body-rib-a_3.2mm_x1.dxf, body-tail_3.2mm_x1.dxf]
2026-10-18 quad00: mock up the zero-gear quad -- a motor at every joint
    All RS00, 130 mm links: hip motor coaxial and inboard, bolted to the thigh
    fork; knee motor at the knee, outboard, bolted to the shin; L-yoke and
    belly-only body as on the inboard hip. No gears, pins or E-clips. 174 mm
    wide at the hips, 278 at the knees, hips 221 high; knee 84% of RS00 in the
    non-backflip cases.
2026-10-18 quad00: mock up the hybrid -- zero gears, both motors inside the thigh box
    The thigh is two plates with the hip and knee RS00 as its spacers (the
    arm's fork joint, twice): the L-yoke reaches through a bearing hole in the
    inner plate to the hip motor's back, the hip output drives the outer plate,
    the knee motor's back sits on the inner plate and its output comes through
    the outer plate to the shin, which runs outside. Nothing proud of the leg;
    274 mm wide at the feet, full thigh rotation, body 288 x 132.
2026-10-18 quad00: mock up the inline hybrid -- shin inside the thigh box, knees inward
    The knee motor flips (back on the outer plate, output through the inner
    plate) so the shin runs down the inside of the thigh box; the feet come in
    to +/-66, nearly under the ab/ad axes (35 mm lever vs the hybrid's 99:
    ab/ad 41% of RS00 worst case). Knees point inward ('><') so a folding foot
    rises on the far side of the hip from the ab/ad and yoke base; the paw
    meets the thigh box only below 25 deg interior. 270 mm wide, nothing proud.
    [quad.py]
2026-10-18 quad00: dog proportions -- deep chest, battery under the ab/ad, hips 300 apart
    Against conformation ratios the inline quad was too long (length/withers
    1.70 vs a dog's 1.0-1.15) and too shallow (chest/withers 0.33 vs 0.47).
    The dog variant deepens the body to 127 mm (decks +50 / -77, body.py gains
    separate top and bottom heights), puts a 12S1P battery in a tray under the
    ab/ad motors, puts compute on the withers, and pulls the hips in to 300 mm,
    the closest the inward knees allow through a +/-30 deg stride:
    length/withers 1.37, chest/withers 0.47, withers 299 mm.
    [body.py, quad.py]
2026-10-18 quad00: mock up a humanoid from the hybrid limb module
    Four identical hybrid modules hang from fore-aft ab/ad RS00 on one back
    plate, exactly as the quad's legs do: legs mirrored fore-aft (knees bend
    forward), arms with only the yoke flipped (elbows back). ~600 mm tall,
    hips 276. quad.py's build() gains per-limb height and per-pose geometry.
    [quad.py]
2026-10-18 quad00: lock the mini quad and mini humanoid -- 170 mm shins
    Shins lengthen to 170 (thigh stays 130) on every hybrid-family build; a
    stance() solver keeps each foot under its hip with unequal links. The quad
    stands at 255 mm (knee lever 68 -> 78 mm, ~97% of RS00 without backflips),
    the humanoid at 310. The viewer opens on the locked pair (Mini quad, Mini
    humanoid) with an updated spec line; the README records the lock and what
    is still open before building.
2026-10-18 quad00: limb modules carry their ab/ad; shins inline -- mini quad + humanoid
    The ab/ad RS00 reverses: its stator back-mounts on the limb's L-yoke and its
    output bolts to the body, so a limb module carries all three of its motors
    and the torso is only plates with bolt patterns (body.WALL_TAKES_OUTPUT).
    The shin moves inside the thigh box on both robots, so the foot sits 35 mm
    from the ab/ad axis and the leg plane stays put when actuators change.
    Mini quad: two plain walls + decks (200 x 118), knees inward. Mini humanoid:
    the same module on a back plate carrying four output patterns.
    [body.py, quad.py]
2026-10-18 quad00: S-torso humanoid -- every ab/ad points into the body, as on the quad
    Arms keep their ab/ad ahead of the shoulder (output on a chest wall), legs
    put theirs behind the hip (output on a pelvis wall); the torso is the box
    joining the two walls, chest forward and pelvis back, so nothing sits
    behind the limbs. Same parts kit: two walls taking ab/ad outputs + side
    plates. The viewer opens on it, next to the backpack version.
2026-10-18 quad00: slab humanoid -- each ab/ad in its limb's plane
    The ab/ad RS00 moves level with its limb: centred fore-aft on the hip or
    shoulder axis, just inboard of the shin layer, stator on a yoke base behind
    the axis, output 26.5 mm ahead of it. Limb, ab/ad and torso now share one
    66 mm slab: the torso is a front wall (arm outputs), a back wall (leg
    outputs) and two sides -- no chest, no seat, no backpack.
2026-10-18 quad00: mini humanoid as the mini quad reared up
    Same body (two walls taking the ab/ad outputs + decks, here 100 mm between
    the walls, 280 shoulder-to-hip) and the same four limbs mounted exactly as
    on the quad; every hip pitches ~90 deg so the limbs hang along the spine
    and the robot stands on its rear pair. The ab/ad axes now run along the
    spine, so they act as hip/shoulder yaw rather than roll. build() gains a
    world transform and ground snap.
    [quad.py]
2026-10-18 quad00: mini humanoid = the mini quad chassis upright, plus hip roll
    Built in the quad's body frame and stood up: the quad's two walls + decks
    are the torso, the front pair are the arms exactly as on the quad
    (shoulder yaw-pitch-elbow). Each leg adds a hip-yaw RS00 hanging from the
    pelvis wall (the quad's rear wall) and an L-bracket on its output that
    takes the quad limb module's ab/ad output -- so that ab/ad is hip roll, as
    on the quad: yaw-roll-pitch-knee. No head for now. ~630 mm tall.
2026-10-18 quad00: mini humanoid hips -- roll motor centred on each hip, no seat
    The legs use the in-plane module: the hip-roll RS00 sits centred fore-aft
    on the hip axis instead of 90 mm behind it, and the yaw bracket's roll wall
    moves to 26.5 mm off the axis. The block behind the pelvis is gone; the
    robot is now 55 mm deep behind the hip line instead of 97.
2026-10-18 Revert "quad00: mini quad keeps the 200 body, hips pulled in to +/-126"
    This reverts commit 3b3515f1934a2c15b774bf86ec3017c18734b9a6.
    [quad.py]
2026-10-18 quad00: humanoid drops hip yaw + brackets; both roll outputs on one pelvis plate (12 RS00, as the quad)
2026-10-18 quad00: humanoid torso shortened to human proportions (hip_a 85)
    [quad.py]
2026-10-18 quad00: humanoid range-of-motion cleanup + rom sweep
    - yoke base round about the ab/ad axis (legs roll without the yokes meeting)
    - pelvis plate trimmed to the port rings (thighs roll past it)
    - arms outboard of the legs on a T chest (hands hang past the thighs)
    - rom.py / sweep.py: intersection sweep over pitch/knee/ab-ad
2026-10-18 quad00: mini humanoid -- 19 RS00: waist yaw, hip yaw, ankle, wrist on the tiny's lengths
    - limb module: end='ankle'|'wrist' puts an RS00 at the shin end (the knee idiom), foot/hand on it
    - waist + hip-yaw RS00 are spacers between walls, hung output-down on their front flanges
    - hip yaw = roll axis (84 apart) so a leg yaws +/-45 clear of the other
    - viewer: tiny quad / tiny humanoid / mini humanoid
2026-10-18 quad00: mini humanoid at ~70 cm -- the largest all-RS00 size (walking knee ~94% of 0.7 x peak)
    - limb module takes its lengths (LT, LS); mini legs 170/220, arms 150/170
    - chest +32 for shoulder-to-hip 235 (0.6 x leg)
2026-10-18 quad00: mini humanoid, cleaner -- flush shoulders, upright stance, closed pelvis
    - arm ab/ad outputs on the shoulder bar's underside: the shoulder-yaw motors sit inside the chest
    - arms hang relaxed (90, 12); legs stand nearly straight (stance had the foot subtracted twice)
    - chest and pelvis skins closed with round lightening holes instead of windows
    - launch.json: local viewer server for previews
2026-10-18 quad00 viewer: all three on one floor line; height tags, 1 m pole, 175 mm stair step
2026-10-18 quad00: tiny humanoid = the 70 cm all-RS00 design; new mini humanoid, Booster K1 class
    - limb module takes any RobStride (MOTORS: rs00/rs02/rs06; RS06 out/back patterns assumed)
    - humanoid_family(): one builder for the style; tiny = all RS00, mini = RS06 legs + waist,
    RS02 arms + hip yaw, RS00 wrists, lengths x1.36, 92 cm to the shoulders
    - pushrod motor clears the thigh to a 127 deg knee
    - viewer: K1 ghost (95 cm) beside the mini
2026-10-18 quad00: mini humanoid = full K1 replacement, 23 DoF
    - ankle roll: a second motor back-to-back on the shin + an inboard pushrod (rods in step pitch, opposed roll)
    - 2-DoF head: neck yaw inside the chest on the shoulder bar (waist idiom), pitch motor as a spacer in the head U
    - 11 RS06 + 8 RS02 + 4 RS00; clean at rest, +/-45 hip yaw (feet clear to 40 inward), knee to 127
    [quad.py]
2026-10-18 quad00: mini with RS04 hip pitch + knee, side by side with the RS06 mini
    - module: thigh-box motor (hip pitch + knee) split from the ab/ad motor (ab_mot); RS04 in MOTORS
    - ankle U-joint drawn as a spider pin, not a solid block
    - numbers (plates from geometry x0.75, 1.3 kg pack, 1.2 kg electronics): RS06 21.1 kg, walking knee 120%
    of 0.7 x peak; RS04 24.9 kg, 44%
2026-10-18 quad00: mini = RS04 hip pitch + knee; truss-pocketed plates
    - drop the RS06-knee variant
    - pocket(): rim + rings round every pattern + Warren struts, applied to thigh plates, shins,
    yoke flange/base/boss, foot side plates + sole, chest/pelvis walls and skins
    - mini aluminium 10.8 -> 7.0 kg; est. 23.8 kg, walking knee 45% of 0.7 x RS04 peak
    - tiny humanoid with real plate mass: 10.9 kg, walking knee 134% (was a 94% guess)
2026-10-18 quad00: tiny humanoid shrunk x0.72 to ~56 cm -- RS00 walking knee 94% with real plate mass
    - knee.py: size sweep from the built geometry (plates weighed, pack ~ s^2)
    - clean at rest, 4 arm poses, +/-45 hip yaw, knee to 127
2026-10-18 quad00: mini ankle -- both motors in a shin box, 2-rod U-joint ankle that checks out
    - shin box: the two RS06 ankle motors are spacers between two shin plates, facing opposite ways
    (thigh-box idiom); one crank + rod outside each plate, nothing sticks out inboard
    - dog-bone U-joint: roll axis 25 below pitch; rods behind the shin; foot pins level with the roll axis
    - ankle2_ik(): crank angles for pitch + roll; crank 0.7 D, offset 5 deg (swept)
    - ankle_check.py: K1 range pitch -50..20 x roll +/-20 all reachable, worst transmission 0.75,
    no collisions over knee 0..127; tiny ankle 0.64 and clean; tiny wrist hand moved to its own layer (was hitting its crank)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
    [quad.py]
2026-10-18 quad00: mini -- one rectangular torso, arms inboard over the legs' line
    - rect=True: shoulder motors as close to the neck as they fit, pelvis widened to the chest,
    torso grown until the hanging hands clear the thighs (shoulder-to-hip 630)
    - shoulders 498 -> 362 wide; height 1.39 m; est. 24.3 kg, walking knee 45%
    - arm pitch -30..210 x elbow 0..120 clean against torso and legs
2026-10-18 quad00: humanoids face forward -- knees, elbows, toes, face agree; mini torso just clears the elbows
    - knees bent the wrong way (bird legs) relative to toes + face: stance flipped; elbows flex forward
    - ankle range was signed backwards: K1's 50 plantar / 20 dorsi is -20..50 here; retuned (crank 0.8 D,
    offset -12, cranks on 7 mm spacers) -- all reachable, worst transmission 0.53, no collisions
    - rect torso sized for the elbows only: shoulder-to-hip 331, mini 1.09 m
    [quad.py]
2026-10-18 quad00: mini arms = the leg chain on RS06, 6 DoF each (27 total)
    - shoulder box per side (yaw RS02 as a spacer, the pelvis idiom), flange + roll plate, RS06 thigh box
    for shoulder pitch + elbow, 2-rod U-joint wrist (2 x RS00, pitch +/-45 x yaw +/-20, worst tm 0.52)
    - arm_check.py: pitch x elbow clean; abduction to 30 deg; yaw ~-20..+15 with the forearm forward;
    no adduction (thighs); wrist clean
    - est. 28.0 kg, walking knee 54% (RS04); shoulders 598 wide
2026-10-18 quad00: mini shoulder reordered to pitch-roll-yaw, same parts
    - pitch RS06 inside the chest corner on a new chest side wall, output out the side; L-bracket holds
    the roll RS06 beside the torso; its L-bracket hangs the RS02 upper-arm yaw; the yaw output caps the
    thigh box (upper arm 120 + elbow RS06); 2-rod wrist unchanged
    - arm_check.py: abduction -180..0 clean, arms up + out clean, yaw outward to -90; forearm meets the
    thighs/belly when it points down or yaws inward (only the elbows were sized to clear)
    - shoulders 430 wide (was 598); 1.18 m; est. 27.8 kg, walking knee 54%
2026-10-18 quad00: mini elegance pass -- grippers, forearm, DFM
    - gripper: RS00 as a spacer in a palm box under the wrist U-joint (box idiom); the box plates run on
    into a fixed two-tine finger, the RS00 output carries the moving finger; TPU pads; 29 DoF
    - forearm 230 -> 220 (shortest the 2-rod wrist clears)
    - pocket(): webs thickened to >= 1.5 x stock; dfm.py: 0 thin webs over 24 pocketed profiles,
    45 flat plates (37 x 3.2, 8 x 6.4) + 20 small stacks, 8.4 kg aluminium
    [dfm.py, quad.py]
2026-10-18 quad00: mini wrist tucked -- inner crank + rod run inside the forearm box
    - tuck: forearm box widened by a 12.6 mm slot; both wrist RS00 hang from the outer plate (A on its
    front flange, B on its back), so the slot is clear end to end; B's crank + rod run in it to a post
    inside the hand; cross block shortened to leave the slot
    - nothing inboard of the forearm's inner plate at neutral; wrist pitch +/-45 x yaw +/-20 all reachable,
    worst transmission 0.58 (was 0.52), no collisions
    [quad.py]
2026-10-18 quad00: mini compressed + human-proportioned head
    - head: closed plate shell (face, back, crown, cheeks) on the pitch motor's plates, 145 mm tall
    (0.13 of height), 0.66 wide, 0.8 deep, eyes in the face
    - compressed, same topology: upper arm 120 -> 80, thigh 230 -> 210, elbow-over-thigh margin 20 -> 8,
    foot sole just under the U-joint (was 97 mm below the ankle)
    - 1.18 -> 1.14 m; shin stays 300 (two ankle motors at 140 / 230 below the knee for a 127 deg fold)
    - all checks: ankle, wrist, arm sweeps unchanged; DFM 0 thin webs
2026-10-18 quad00: mini shin -- solid full-width plate from knee to the upper ankle motor
    - shin_check.py: plate sections from the flat profiles, 3 x body weight one-leg landing (with the load
    line's offset) + 120 N.m knee peak, vs 5052-H32
    - before: the knee..motor stretch was one pocketed plate -- 106 MPa (1.8x on yield), Euler 2.3 kN (2.8x)
    - after: solid + full width there -- worst 23 MPa (8x), Euler 15.7 kN (18x); box section below < 10 MPa
    - +0.5 kg; ankle/wrist/DFM checks unchanged
2026-10-18 quad00 viewer: Booster K1 in the lineup (its URDF + meshes, BSD-3), arms lowered; limb profiles recorded for strength checks
2026-10-18 quad00: tiny humanoid takes the mini's look where torque allows -- rectangular torso, fixed head shell
    - rect torso: shoulders 451 -> 331; head='fixed': the head shell on a neck post, no motors
    - motor head (+2 RS00) would put the knee at 106%, grippers further over: left off
    - walking knee 99% (10.7 kg est.); arm poses clean except forearm hanging straight onto the thighs
    [quad.py]
2026-10-19 quad00: mini humanoid = the Booster K1 reverse-engineered on our stack (22 DoF)
    - humanoid_k1(): K1's DoF and dims (hip-knee 192, shin 245, shoulder-to-hip 261); every limb is one
    pitch-roll-yaw chain (pry_limb: pitch motor inside a torso corner, roll L-bracket, yaw motor down
    the limb, capping our limb box); legs RS06 pitch/roll/knee + RS02 yaw + shin box with 2 x RS00 2-rod
    ankle; arms + head RS00 (K1 arms are 14 N.m); one torso box, no waist, no wrists/grippers
    - 99 cm, est. 16.0 kg (K1 19.7), walking knee 84% of 0.7 x RS06 peak
    - k1_check.py: ankle -20..50 x +/-20 all reachable, worst transmission 0.59, no collisions; hip/knee
    sweeps clean; arms collide with the hip-roll motors /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
    [quad.py]
2026-10-19 quad00: mini hips K1-style -- roll under the pitch, hips narrow, arms hang outside
    - pry_limb(roll_below=y): roll motor under the torso floor below the pitch axis, pitch plate stops
    above it, back plate runs out and down to the roll stator outside/under the torso
    - legs at +/-78 (was +/-126), arms at +/-134 outside them; pelvis carved round each hip (side-wall arc
    round the pitch port, floor + skins narrow between the hips) so the roll motor sweeps clear
    - k1_check: shoulder pitch/roll clean, elbow clean but 0 (hand grazes hip roll), hip pitch -30..60 clean
    (90 hits the torso front), ankle unchanged; 1.05 m, est. 15.9 kg, walking knee 92%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
2026-10-19 quad00: cover shells (toggle) -- the finished look on both humanoids
    - add_covers(): one smooth hull per segment (torso, head, thigh/upper arm, shin/forearm, foot), 4 mm
    proud of the structure; joints stay bare so the dark motors read as accents (two-tone, like the K1)
    - instanced (posed) limbs get covers in build(); viewer: 'covers (printed shells)' material + Covers toggle
    - stand-ins for printed / thermoformed shells clipped to the plates; not yet split or checked against motion
2026-10-19 quad00: mini skin v1 -- lofted shells, joint caps, visor, chest/pelvis split
    - skin.py: shells lofted through superellipse sections along each segment's axis (not hulls), domed
    ends scaled to the section; chest flare; chest + pelvis split by a graphite waist band
    - graphite caps on every joint motor whose axis crosses a shell, sized to the shell surface; flat shaded
    - head: fuller rounded shell, smoked-gloss visor patch; mitten hands; feet on dark rubber soles
    - viewer: smooth-shaded shells, puck/visor/sole materials, Covers toggles the whole skin,
    window.__view() review hook; relaxed pose (elbows 12 deg)
2026-10-19 quad00: mini skin v2 -- slim: shells hug the structure, smaller caps, egg head, low shoes
    - shells 2.5 mm proud (was 6-9), no chest flare, slim shoulder/hip shells over the motors only
    - caps 0.78 x motor radius, nearly flush, main joints only; head an oval with deep domes
    - shoes: the sole + 28 mm; visible structure goes dark anodized when the skin is on
2026-10-19 quad00: mini ID pass -- design.py: designed shells over the packaging, concentric joint hubs
    - rules: no structure visible; every joint a concentric graphite hub with shells ending in arcs
    1.5 mm off it; one superellipse family; seams on one coronal plane
    - designed_shell(): sections from a concave envelope of the packaging, fitted in the superellipse
    metric (no corner poke-through), linear taper, domed free ends; cut by hub cylinders / collar planes
    - hip + shoulder lobes over the roll/yaw stack, yaw collars, roll + knee/elbow + ankle drums,
    torso flank hubs; helmet fitted over the head box with a goggle visor; moulded outsole
    - viewer: crease-angle normals for shells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
2026-10-19 quad00: K1 teardown -- its housings measured, our RobStrides on its joint frames
    - k1_teardown.py: joint housings (diameter x width around each axis from the link meshes), link
    lengths, fit + torque table per joint: RS06 hip pitch/roll/knee, RS02 hip yaw (17 vs 20 N.m),
    RS00 arms + head; the K1 drives its ankle from the shank by links, as our 2-rod ankle does
    - viewer: 'K1 on our stack' -- the K1 skin as a translucent ghost over our motors; ghosts keep their
    opacity; K1 meshes decimated (1.5 mm vertex clustering) to stay under the page size limit
    - k1.arms_down() picks arms down, not up
2026-10-19 quad00: mini = our own housings + bone links on the K1 joint layout
    - k1_design.py: every joint a rounded coaxial drum around our RobStride (graphite caps both ends),
    every link a bone lofted between its joints' drums (slimmer, with a thigh/calf/forearm swell);
    hip pitch-roll-yaw merged into one lobe; chest + accent waist + pelvis blocks; egg helmet with a
    visor band; shoes on soles; mittens; flank caps for the shoulder pitch
    - the plate-based K1-style build stays as humanoid_k1()
2026-10-19 quad00: mini in satin black + municipal orange; hip and head elegance pass
    - palette: satin-black shells, municipal-orange joint caps + waist, gloss-black visor, gunmetal
    collars/trim, grey rubber soles
    - hips: pitch + roll drums merged into one pod per side, the yaw drum a gunmetal collar under it,
    pelvis narrowing downward so the pods read as hips
    - head: ellipsoidal helmet (flatter jaw), oval gloss visor, orange ear caps on the head-pitch axis,
    slim gunmetal neck
    - bones never wider than their joint drums' faces: every cap reads as a full disc
2026-10-19 quad00: mini leg plate structure -- 3.2 mm router-cut plate pairs around RS06/RS02/RS00, no interferences
    [k1_structure.py]
2026-10-19 quad00: mini shells sit on the plate structure -- drums on structure motors, pod wraps hip brackets, plates clipped 2 mm inside shells; legs pass 3xBW + knee peak (stress >=7.6x, buckling >=2.1x)
2026-10-19 quad00: mini hips -- pitch/roll pair centred fore/aft at pelvis height, pod back to a slim capsule, neck into the yaw collar; still no interferences, legs pass
    [k1_design.py, k1_structure.py]
2026-10-19 quad00: mini hips -- roll RS06s hidden inside the pelvis, pitch is one drum under the flank (knee language), yaw collar below; new hip plates, no interferences, everything inside its shell
    [k1_design.py, k1_structure.py]
2026-10-19 quad00: mini at 100 cm -- layout scaled, chest = pelvis width, shoulder yokes join the arms, flat-sided rounded-rect shells; fits, legs pass (shin buckling 8.6x braced by the ankle motors)
2026-10-19 quad00: mini arm, torso, head plate structure -- RS00 shoulders/elbows on yokes and forks, torso box on the roll mounts, neck yaw+pitch; all inside shells, no interferences, plates >=8.6x at RS00 peak
    [k1_design.py, k1_structure.py]
2026-10-19 quad00: mini ROM pass -- every joint covers walking range (rom_mini.py sweeps)
    clevis knee (calf nests between the thigh plates, thigh relieved for the fold), elbow fork cheek + outboard
    forearm, hip inner plate trimmed to a disc, pelvis + shoe relieved by swept clearance, helmet opening round
    the head-pitch hub. Heavy relief meshes decimated for the viewer only.
    [k1_design.py, k1_structure.py, rom_mini.py]
2026-10-19 quad00: mini arms hang plumb -- arm chain on one line under the shoulder (16 mm wider for hip clearance), full lower-arm clevis shell, yoke relieved; all 12 joints still clear their ranges
    [k1_design.py, k1_structure.py]
2026-10-19 quad00: mini pelvis K1-style -- wraps the hidden roll cans and follows their bellies in, narrow keel between the hip drums; hip roll now full -23..45, all 12 joints pass
2026-10-19 quad00: tiny humanoid = the mini design on 22 RS00 at 0.75 x K1 (~74 cm, 10.1 kg)
    k1_structure.VARIANTS + use(): one design, two sizes; mini bit-identical (regression-checked). Tiny-only:
    interleaved knee plates (shin inner stands off 6.4 mm), head yaw above the shoulder cans with a round neck
    base, helmet lifted onto the head motors, asymmetric knee drum, 608 knee support bearing, deeper foot,
    longer upper arm. Fits, no interferences, legs pass (shin >= 6.8x), knee 3.8 N.m squat (39% of 0.7 peak).
    ROM: 10/12 joints full; knee 0..100 and elbow -120 are the tiny's geometric limits.
    [k1_design.py, k1_structure.py, quad.py, rom_mini.py]
2026-10-19 quad00: mini humanoid in vcad -- vcad_export.py writes vcad/mini/mini.loon
    122 parts, one rigid body per link, 22 revolute joints at the K1 limits (+ ankle U-joint). Plates are native
    sketch+extrude from the clipped router-cut outlines (bolt holes cut), motors/drums/caps native cylinders;
    lofted and relief-cut shells come in as body-frame meshes (import-mesh-scaled 0.001). Renders at 995.9 mm
    and poses through every chain (vcad/mini/pose-test.png).
    [accent-waist.stl, cover-calf_ll.stl, cover-calf_rl.stl, cover-chest.stl, cover-elbowfork_la.stl, cover-elbowfork_ra.stl, cover-forearm_la.stl, cover-forearm_ra.stl]
2026-10-19 quad00: vcad mini -- bones, blocks, helmet, hands, soles, neck as native loon lofts; helmet opening + visor native booleans
    Shells built as hulls of section rings now carry the rings (metadata) and export as [loft #[sketch ...]]. Only the
    9 relief-cut shells (pelvis, thighs, shoes, yokes, elbow forks) stay meshes. 111 native parts of 122. Renders
    identically at 995.9 mm, but the lofts take ~29 min in vcad-render today (was 17 s with meshes) -- loft
    performance is being fixed in vcad (loft-perf). Mini geometry unchanged (regression-checked).
    [accent-waist.stl, cover-calf_ll.stl, cover-calf_rl.stl, cover-chest.stl, cover-forearm_la.stl, cover-forearm_ra.stl, cover-hand_la.stl, cover-hand_ra.stl]
2026-10-19 quad00: vcad export -- cylinders/drums from explicit axis vectors (extruded circle / ring loft), no Euler rotate, no fillet op
    Every [fillet r [cylinder]] drum failed in the kernel (blend geometry diverged) -- the 14 parts photoreal silently
    dropped -- and the exporter's [rotate] order was wrong. Now all 122 parts evaluate (vcad eval-json, 32 s on merged
    vcad main) and drum/motor bboxes match the Python model. check-joint-range agrees on elbow (-140) and head (40); the
    knee stops at 85 there only by a ~1 cm3 calf-top / knee-drum shell overlap (clears 127.8 at a 1500 mm3 threshold).
    [vcad_export.py]
2026-10-19 quad00: vcad mini stands on z = 0; rest + posed renders from vcad render (merged CLI assembly support)
2026-10-19 quad00: mini hip-roll brackets sheathed in gunmetal guards (no bare Al under the pelvis); vcad explode export + photoreal renders
    vcad_export.py takes explode factors (shells 45 mm off their links, links spread 35% along joint lines) and writes
    mini-explode-NNN.loon; photoreal assembled/exploded renders committed. Fit, overlaps and hip ROM re-checked
    (mini + tiny); 124/124 parts evaluate in vcad.
    [cover-pelvis.stl, trim-hipguard_ll.stl, trim-hipguard_rl.stl]
2026-10-19 quad00: mini shell detail -- parting-line panels on chest + calves (1.2 mm grooves, front and back), satin rounded neck
    Grooves = shell minus (band ^ skin), skin = shell minus an inset copy; built the same way in Python and in loon,
    so they stay native in vcad (124/124 parts evaluate). Fit and head/knee ROM unchanged.
2026-10-20 quad00: mini sculpted calves + forearms -- full under the knee/elbow, slim at ankle/wrist (depth profile; widths stay on the plates)
    Calf depth +14% under the knee to 26 mm at the ankle, never thinner than the ankle cans need (mini; the tiny's
    cans sit too low for a taper). Forearm +12% under the elbow to 15 mm at the wrist. Fit clean, plates whole, shin
    stress 3.5x / forearm 7.7x, knee 0..120 (need met), ankle + elbow full range; tiny unaffected. Reviewed live in
    the vcad desktop app over its MCP bridge (hot reload).
    [cover-elbowfork_la.stl, cover-elbowfork_ra.stl, cover-shoe_ll.stl, cover-shoe_rl.stl, cover-thigh_ll.stl, cover-thigh_rl.stl]
2026-10-20 quad00: mini torso proportions -- V chest, raised band, slim abdomen, pelvis flaring over the hips; satin yaw collars
    The chest narrows to 86% at the waist (full width from below the shoulders, so the yokes keep their range), the
    orange band moves up to the bottom of the rib cage, a 84%-wide abdomen joins a pelvis that now flares out over the
    hip cans. Yaw collars go satin black so the short thigh reads as one segment from hip drum to knee. Fit clean;
    hip, shoulder and head ROM in spec; tiny unaffected. Reviewed live in the vcad app (hot reload).
    [cover-pelvis.stl]
2026-10-20 quad00: mini electronics in the torso bay -- 2x 12S1P side packs, Jetson Orin NX envelope, 110x74 limbic board
    Envelopes from the limbic-board proposals (rose claude/limbic-spec, LIMBIC.md), sized to the V chest: battery as
    two 12-cell 21700 packs standing upright outboard of the frame side plates under the shoulder cans (130x44x74 each;
    the proposed 68x48x145 pack would poke 33.5 cm3 out of the tapered chest), Jetson upright in the centre bay under
    the neck deck, limbic board flat on the bottom deck. Chest taper eased 0.86 -> 0.88 to clear the packs. 12S2P
    43.2 V 9 Ah 389 Wh. Mass now 15.5 kg (was a 14.2 kg estimate), CoM on the centreline 533 mm above the soles. Fit,
    overlaps and hip/shoul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
    [elec-battery_l.stl, elec-battery_r.stl, elec-jetson.stl, elec-limbic.stl]
2026-10-20 quad00: mini cooling + e-stop + BMS + foot nodes from LIMBIC.md; groove export fix
    - Jetson as the Seeed A603 + Orin NX envelope (50x52x87, upright); 12S BMS (5x40x60) on each pack's aft face,
    kept inboard/high; packs 2 mm forward; chest corners 22 -> 15 mm and waist taper 0.88 -> 0.90 so the packs clear
    a real 2 mm wall (only a 4 mm3 corner, and ~1 mm thinner under the panel groove).
    - Airflow: 5-slot intake grille low on the abdomen front, 5-slot exhaust grille high on the chest back with a
    40x40x10 fan behind it blowing out; brake resistor envelope behind the Jetson, in the stream.
    - E-stop: IDEC XA1E-BV402R 40 mm red mushroom on the upper back (16.2 mm hole, 30x32 body reserved) --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
    [elec-battery_l.stl, elec-battery_r.stl, elec-bms_l.stl, elec-bms_r.stl, elec-brake.stl, elec-estopbody.stl, elec-fan.stl, elec-jetson.stl]
2026-10-20 quad00: reserve 10 mm for each pack's 12S BMS (>=60 A FETs per LIMBIC.md): packs 2.5 mm forward, envelope trimmed to the cells
    [elec-battery_l.stl, elec-battery_r.stl, elec-bms_l.stl, elec-bms_r.stl]
2026-10-20 quad00: mini -- no e-stop (the K1 has none), no orange joint caps (plain satin drums); waist band stays
2026-10-20 quad00: mini shoulders in the full-size (H2/T2) language -- V chest flaring to a broad shoulder line, pitch disc flush in it, deltoid cap on the arm
    - Chest flanks flare from the waist taper out to SHOULDER_FLANK (124 mm half-width) at the shoulder line; square
    shoulder tops.
    - The boxy yoke becomes a round shoulder-pitch disc coaxial with the pitch axis (r 42, covers the yoke plates),
    mostly inside the flared flank: an 8 mm collar shows.
    - A deltoid cap belongs to the arm: coaxial with the roll drum (3 mm proud, rolls clean) and blended into the
    upper arm's top sections.
    Fit clean; shoulder, elbow and head ROM unchanged. Defined from motor diameters + arm sections, so it scales to
    the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
    [cover-deltoid_la.stl, cover-deltoid_ra.stl]
2026-10-20 quad00: full -- 2 m humanoid variant on RobStride (RS04 legs/arms/ankles, RS02 head, 6.35 mm plate) in the mini's design language
    - per-role motors (ARM/ANK/HEAD) + per-variant plate stock; arm widths derived from the arm motor
    - shoulder disc spans pitch output face to roll drum; yokeP2 exempt from clipping (spans the disc gap)
    - head_z 465 for 40 deg head pitch; neck + neck base sized to the yaw motor
    - full: 1998 mm, no overlaps/splits, joints meet, full ROM sweep ok; vcad/full/full.loon (118 parts)
    [cover-deltoid_la.stl, cover-deltoid_ra.stl, cover-elbowfork_la.stl, cover-elbowfork_ra.stl, cover-hip_ll.stl, cover-hip_rl.stl, cover-pelvis.stl, cover-shoe_ll.stl]
2026-10-20 quad00: full -- 1.8 m, 31 DoF (H2/T2 class): 3-DoF waist, 7-DoF arms, slimmer trunk
    - 1.8 m (H2 height); trunk lengthened 100 mm for the waist stack, everything 15% narrower in y, chest 12% shallower
    - waist: RS04 yaw on a pelvis deck -> roll -> pitch, plates W0-W4; satin yaw drum + roll hub, gunmetal pitch hub
    under a bored chest; yaw +-90, roll +-25, pitch -25..50
    - wrist: RS00 roll mid-forearm (round sleeve below), pitch drum at the wrist, yaw inside the hand; full ROM
    - rom/export: wyaw/wroll/chest and wr/wp/wy bodies, 31 joints; mini bit-identical, tiny unchanged
    [accent-waisthub.stl, cover-deltoid_la.stl, cover-deltoid_ra.stl, cover-elbowfork_la.stl, cover-elbowfork_ra.stl, cover-hand_la.stl, cover-hand_ra.stl, cover-hip_ll.stl]
2026-10-20 quad00: full -- dressed waist: three coaxial shells, no slots
    yaw drum (yaw stage) up to the roll axis, satin roll barrel (roll stage), gunmetal pitch hub on the chest
    carrying the chest mount; the chest's bore is gone, the pitch stator plate turns in thin internal pockets.
    No bare waist plates; waist ROM unchanged (yaw +-90, roll +-25, pitch -25..50).
    [accent-waisthub.stl, cover-chest.stl, cover-deltoid_la.stl, cover-deltoid_ra.stl, cover-waist.stl, trim-waisthub.stl]
2026-10-20 quad00: mini -- one back-mounted swappable pack (LIMBIC option C), pocketed plates
    - 12S2P 21700 pack (432 Wh, 2.0 kg) in a 136 x 58 x 150 PA12 case on the back: slides down two rails on a new
    3.2 mm back plate, gravity-seats a blind-mate dock at the bottom, spring latch at the top lip; 140 x 155 opening
    in the chest/band/abdomen backs. Twin side packs retired (y +-45..88 freed). Option D (80 mm, 12S3P) documented.
    - exhaust fan + grille moved above the pack (z 178..208); ELRS e-stop RX at the chest top; limbic board was
    never emitted (it sat after the e-stop early return) -- fixed
    - plates: +-45 deg rib lattice pocketing (7 mm rim, 5 mm ribs, bosses round holes); shins and the hip cha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
    [cover-deltoid_la.stl, cover-deltoid_ra.stl, cover-shoulderyoke_la.stl, cover-shoulderyoke_ra.stl, elec-battery.stl, elec-battery_l.stl, elec-battery_r.stl, elec-bms.stl]
2026-10-20 quad00: mini -- pack inside the chassis, K1-style (backpack retired)
    One 12S2P pack (4 x 3 x 2 upright 21700s + BQ76952 slab, PA12 case 98 x 78 x 148) slides into the bay between the
    torso side plates from the back on two guide strips on deck0, blind-mates a dock on a new cross plate at x +43,
    latch at the top; its back face is the hatch, flush with the abdomen skin (6 mm in from the chest's). Jetson
    (on its side) moves to the left side bay, limbic board + brake resistor to the right. CoM now over the ankle
    (x -0.2 mm, was 9 mm aft); 15.6 kg; walking knee 7.2 N.m. ROM ok, no overlaps. Option D no longer fits.
    [cover-deltoid_la.stl, cover-deltoid_ra.stl, elec-battery.stl, elec-bms.stl, elec-brake.stl, elec-dock.stl, elec-jetson.stl, elec-limbic.stl]
2026-10-20 quad00: mini -- brake resistor aft (x -50..-22) so x 0..60 outboard of the limbic board stays free
2026-10-20 quad00: vcad export -- pocketed plates as meshes (a 40-deep boolean chain each hung the app); mini loads in ~5 s
    [arm-forearmF1_la.stl, arm-forearmF1_ra.stl, chassis-rollmount_ll.stl, chassis-rollmount_rl.stl, chassis-thightop_ll.stl, chassis-thightop_rl.stl, cover-deltoid_la.stl, cover-deltoid_ra.stl]
2026-10-20 quad00: mini/tiny -- drop the orange waist stripe; the abdomen runs up under the chest
    [chassis-thightop_ll.stl, chassis-thightop_rl.stl, cover-deltoid_la.stl, cover-deltoid_ra.stl, thigh-inner_ll.stl, thigh-inner_rl.stl]
2026-10-20 quad00: head -- rounded box (H2/T2) with a flat landscape face screen
    Flat sides + front, crown fillet, deep chin round-off and a jaw that slopes back below the screen so the head
    pitches clear of the chest; the oval visor becomes a flat rounded-rect glass panel 0.8 mm proud of the face
    (trimmed by the neck pocket on the tiny). Head yaw +-57 / pitch -20..49 on mini, tiny and full.
    [cover-deltoid_la.stl, cover-deltoid_ra.stl, thigh-inner_ll.stl, thigh-inner_rl.stl]
2026-10-20 quad00: mini/tiny torso -- one sleek shell in the head's language
    Chest + abdomen become one loft from the pelvis top to a head-style crown fillet: the waist flows into the chest
    and out to the shoulder line (smoothstep, no step), 24 mm plan radii, one tall panel groove; intake/exhaust
    grilles and the pack hatch carried over. Fit, joints and ROM unchanged.
    [chassis-thightop_ll.stl, chassis-thightop_rl.stl, cover-deltoid_la.stl, cover-deltoid_ra.stl, thigh-inner_ll.stl, thigh-inner_rl.stl]
2026-10-20 quad00: pelvis -- torso/head language: 24 mm plan radii, constant depth, keel as one filleted rounded box
    [cover-deltoid_la.stl, cover-deltoid_ra.stl, cover-pelvis.stl, thigh-inner_ll.stl, thigh-inner_rl.stl]
2026-10-20 quad00: cleaner pelvis + neck
    - pelvis: the thigh-swing clearance is one smooth convex cut (was a faceted sweep scoop); mini drops the keel
    for one flat rounded underside
    - neck: one round satin column sunk into the chest crown (round, so it yaws clean); head hub satin, not gunmetal
    Fit, hip and head ROM unchanged on mini/tiny/full.
    [cover-deltoid_la.stl, cover-deltoid_ra.stl, cover-pelvis.stl, thigh-inner_ll.stl, thigh-inner_rl.stl]
2026-10-20 quad00: pelvis -- hip-roll clearance split: the bracket in an internal slot, the drum under one clean round arch about the roll axis (tiny keeps the swept cut; its drum rolls in too close)
    [cover-deltoid_la.stl, cover-deltoid_ra.stl, cover-pelvis.stl, thigh-inner_ll.stl, thigh-inner_rl.stl]
2026-10-20 quad00: mini pelvis -- start over: a plain rounded box like the head, just the safety cover over the two hip-roll cans
    Tucked under the torso, bottom radius concentric with the cans (clear of the hip drums), round arches over the
    drums; bracket guards satin, not gunmetal. Hip ROM full; fit clean.
    [chassis-rollmount_ll.stl, chassis-rollmount_rl.stl, cover-deltoid_la.stl, cover-deltoid_ra.stl, cover-hipguard_ll.stl, cover-hipguard_rl.stl, cover-pelvis.stl, thigh-inner_ll.stl]
2026-10-20 quad00: H2/T2 pass -- wider head, chest-over-waist-over-pelvis on mini and full
    - head 15% wider (mini screen 115 x 70)
    - mini: the chest shell stops above a narrow dark waist band (intake grille front, pack hatch back), box pelvis
    - full: the same sleek chest shell above its real waist, the box pelvis (sized to also carry the waist-yaw deck),
    round neck; chest panel groove dropped on the full (its pocket cut exports a mesh, the groove broke)
    - leg_in knob in world() (unused: any shift breaks the side-by-side hip-roll linkage; needs a hip re-layout)
    Fit, joints and full ROM pass on mini and full; tiny unchanged.
    [chassis-rollmount_ll.stl, chassis-rollmount_rl.stl, cover-chest.stl, cover-deltoid_la.stl, cover-deltoid_ra.stl, cover-hipguard_ll.stl, cover-hipguard_rl.stl, cover-pelvis.stl]
2026-10-20 quad00: legs in (H2/T2 stance): mini 20 mm, full 30 mm
    Leg spacing is set by inward hip roll vs thigh width, not the hip motors: inward roll need drops -15 -> -10
    (walking ~8; Cam's call). The hip-roll bracket guard now only sheathes the bracket near the pelvis, so hip
    pitch keeps -100 with the collar swinging past it. Fit and full ROM pass on mini and full.
    [chassis-rollmount_ll.stl, chassis-rollmount_rl.stl, chassis-thightop_ll.stl, chassis-thightop_rl.stl, cover-deltoid_la.stl, cover-deltoid_ra.stl, cover-hip_ll.stl, cover-hip_rl.stl]
2026-10-20 quad00: mini -- no pelvis cover; the hip-roll cans are the pelvis
    [chassis-rollmount_ll.stl, chassis-rollmount_rl.stl, chassis-thightop_ll.stl, chassis-thightop_rl.stl, cover-deltoid_la.stl, cover-deltoid_ra.stl, cover-pelvis.stl, thigh-inner_ll.stl]
2026-10-20 quad00: full -- no pelvis cover either; open hips. A plate with no shell over it now stays whole instead of failing the clip
    [cover-deltoid_la.stl, cover-deltoid_ra.stl, cover-pelvis.stl]
2026-10-20 quad00: waist deck cut to the yaw drum's edge (full); head shorter + shallower, chin up (crown stays), screen keeps its height
    [cover-deltoid_la.stl, cover-deltoid_ra.stl, thigh-inner_ll.stl, thigh-inner_rl.stl]
2026-10-20 quad00: head -- the chin mirrors the crown fillet: one simple rounded box (chin-up made the jaw slope unnecessary)
    [cover-deltoid_la.stl, cover-deltoid_ra.stl, thigh-inner_rl.stl]
2026-10-20 quad00: head -- less chin (height 0.74 -> 0.66 of the K1 head, crown fixed); screen keeps its size
    [cover-deltoid_la.stl, cover-deltoid_ra.stl, thigh-inner_rl.stl]
2026-10-20 quad00: torso front + back lean in toward the top (25%, from just under the shoulder axis); 30 mm exhaust fan lower and further in, slots follow the leaning wall; pack latch moved to the side
    [cover-chest.stl, cover-deltoid_la.stl, cover-deltoid_ra.stl, elec-fan.stl, thigh-inner_ll.stl, thigh-inner_rl.stl]
2026-10-20 quad00: mini back panel (Booster-style): gunmetal plate on the leaning back over the exhaust grille, power button + status LED left, USB-C charge port right
    [cover-deltoid_la.stl, cover-deltoid_ra.stl]
2026-10-20 quad00: mini/tiny -- the torso shell stops just above the shoulder axis (simpler vertically); the shoulder-pitch drums wrap their whole cans and sit at the top corners, Booster-style; neck column cov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
    [cover-deltoid_la.stl, cover-deltoid_ra.stl, thigh-inner_ll.stl, thigh-inner_rl.stl, torso-side_l.stl, torso-side_r.stl]
2026-10-20 quad00: torso -- a concave funnel: near-vertical sides (0.95 CHEST) flaring late (u^3) to a narrower shoulder line (1.10, was 1.23); built as piecewise hulls so the concave flanks survive
    [cover-chest.stl, cover-deltoid_la.stl, cover-deltoid_ra.stl, thigh-inner_rl.stl]
2026-10-20 quad00: mini/tiny torso stretched back out -- one piece from the pelvis line up over the shoulder-pitch drums (crown zs + 46); waist band dropped, intake grille back on the shell; concave funnel kept
    [cover-deltoid_la.stl, cover-deltoid_ra.stl, thigh-inner_ll.stl, thigh-inner_rl.stl, torso-deck0.stl, torso-side_l.stl, torso-side_r.stl]
2026-10-20 quad00: torso -- skinnier waist (0.80 CHEST at the pelvis line, full width by the side bays), bottom rounded like the crown, top corners flare just over the shoulder-pitch drums (mini; tiny keeps 1.1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
    [cover-deltoid_la.stl, cover-deltoid_ra.stl, thigh-inner_ll.stl, thigh-inner_rl.stl]
2026-10-20 quad00: armpit -- the concave flare ends at the shoulder drum's bottom edge, so the flank wraps the whole drum in one curve; drums wrap the full pitch can on the full too
    [cover-chest.stl, cover-deltoid_la.stl, cover-deltoid_ra.stl]
2026-10-20 quad00: mini electronics per limbic layout (0a00f7b): board 110 x 88 at z 78..166 (22 mm clear outboard), brake resistor below the board, 2 x 30 mm exhaust fans + 66 mm grille, latch moved fore
    [cover-deltoid_la.stl, cover-deltoid_ra.stl, elec-brake.stl, elec-fan.stl, elec-fan_l.stl, elec-fan_r.stl, elec-limbic.stl, thigh-inner_ll.stl]
2026-10-20 quad00: mini intake -- two tall low front grilles, one per side bay (8 x 3.5 x 30 mm slots each, 16.8 cm2 open, >= 12 for 4 CFM); centre grille dropped (the pack blocks the middle)
    [cover-deltoid_la.stl, cover-deltoid_ra.stl]
2026-10-20 quad00: mini -- PA12 baffle shelf off the Jetson's top-fore edge to the front wall (no hot-air recirculation into the cool stream); A603 fan fore -> aft noted
    [cover-baffle.stl, cover-deltoid_la.stl, cover-deltoid_ra.stl]
2026-10-20 quad00: full gets the mini's chest shaping above its visible waist (funnel scaled to its shorter chest, rounded bottom, lean, corners over the shoulder drums); hip-roll mount plates are clean convex 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
    [cover-chest.stl, cover-deltoid_la.stl, cover-deltoid_ra.stl, thigh-inner_ll.stl]
2026-10-20 quad00: full chest lengthened down past the waist-pitch hub (pitch - 0.45 D); one smooth clearance arch under it for the roll stage keeps waist pitch -25..60
    [cover-chest.stl, cover-deltoid_la.stl, cover-deltoid_ra.stl]
2026-10-20 quad00: head -- shorter (0.58 of the K1 head) and shallower, the back wedges in: a rounded triangle from the side, the face one flat plane
    [cover-deltoid_la.stl, cover-deltoid_ra.stl, thigh-inner_ll.stl, thigh-inner_rl.stl]
2026-10-20 quad00: cortex head -- a detachable module on a neck dock (the spinal-cord split)
    - the head is the cortex: Jetson (flat, behind the screen) + its own small permanent battery + the back panel
    (power, LED, USB-C, Ethernet) + side vents; flat bottom so it can live detached on a desk
    - the neck ends in a dock: the head-pitch output carries H1 up to a dock plate (gunmetal trim) the head seats on;
    the pitch drum splits into a neck half (over the stator plate) and a head half (over the dock bracket)
    - the back of the head reaches past the neck (no craning); the torso keeps the limbic board, pack and exhaust;
    its back panel and the Jetson's side-bay + baffle are gone
    - fit + full ROM pass on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
    [cover-baffle.stl, cover-deltoid_la.stl, cover-deltoid_ra.stl, elec-cbat.stl, elec-jetson.stl, thigh-inner_ll.stl, thigh-inner_rl.stl]
2026-10-20 quad00: cortex head softened (less helmet): no back wedge, generous plan/crown/bottom rounds (still sits flat), calmer rounded screen, side vents on the flat; slightly shallower
    [cover-deltoid_la.stl, cover-deltoid_ra.stl, thigh-inner_ll.stl, thigh-inner_rl.stl]
2026-10-20 quad00: cortex head -- larger face screen; stereo eyes behind its top edge (gunmetal bezels); ears: a mic/speaker grille each side, forward of the vents
    [cover-deltoid_la.stl, cover-deltoid_ra.stl, trim-ear_l.stl, trim-ear_r.stl]
2026-10-20 quad00: cortex parts chosen + wiring routed (mini)
    - parts (datasheet sizes, ASSUMED marked): Orin NX on Seeed A603 + ATS heatsink, Waveshare 3.5in HDMI (E), 2x Arducam
    IMX219 (106 mm baseline, flanking the display behind one glass), 2x Visaton 28 mm speakers + MAX98357A amps,
    2x SPH0645 I2S mics, 3S1P 21700 cortex pack + charger, 12-pin pogo dock (receptacle opening in the neck's dock plate)
    - head_frame shared by the shell and the parts; head plan corners a bit tighter so the eyes clear the face's flat
    - harness: camera FFCs, HDMI FPC, power, dock DC/GbE, panel RJ45/USB-C, audio; spine from the dock behind the pitch
    drum (pitch flex loop), down the neck (yaw service loop), through a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
    [cable-haudio_l.stl, cable-haudio_r.stl, cable-hcsi_l.stl, cable-hcsi_r.stl, cable-hdockdc.stl, cable-hdockgbe.stl, cable-heth.stl, cable-hhdmi.stl]
2026-10-20 quad00: cortex eyes up to the top of the face's flat band (EYE_Z), glass a touch taller to keep them behind it
    [cable-hcsi_l.stl, cable-hcsi_r.stl, cover-deltoid_la.stl, cover-deltoid_ra.stl, elec-cxcam_l.stl, elec-cxcam_r.stl]
2026-10-20 quad00: cortex as its own loon product (cortex/cortex.loon): shell, face, eyes, ears, back panel, parts, wiring, USB-C dock; robot side: USB-C dock, DOCK_Z raised over the pitch drum
2026-10-20 cortex: face raked ~8 deg (looks up from a desk); one dead-front glass, cameras hidden behind it; no ears -- side vents double as speaker/mic grilles
2026-10-20 cortex: screen up 6 mm
2026-10-20 cortex: tub + floor plate + dead-front glass; internals on a floor-plate sled (pack flat over the dock, Jetson above on side brackets, heatsink-to-right-vent duct, speakers low in the vents, mics abo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
2026-10-20 cortex: back sweeps forward and down above 40 mm (Braun clock profile) -- the crown was empty; back panel lowered onto the full-depth band, port looms rerouted, duct clear of the new back corner
2026-10-20 cortex: ears are a 1.1 mm dot grid (2.4 hex, rounded slot) set higher; speaker left behind the grid top, fan exhaust right; both mics on the same dot below
2026-10-20 cortex: stereo again (speaker + amp each side); fan exhaust moved aft -- short duct from the heatsink to a matching dot-grid slot on the back sweep
2026-10-20 cortex: no back panel -- the carrier's I/O edge sits behind a plain rounded cutout (any Jetson/carrier drops in); Jetson moved aft to the wall, heatsink straight at the exhaust grid (duct gone), loom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
2026-10-20 cortex: SPEC.md (requirements, thermal check, assembly room, mounting); thermal fix -- grilles 1.4 mm on 2.2 hex (~37% open), exhaust slot 90 x 22 behind the heatsink; carrier/sled/power-board pulled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
2026-10-20 cortex: option B dock -- sealed floor with 8 flush gold pads (20 V / 5 A, 1000BASE-T1 + USB 2), tapered cone seats, steel magnet strikes, latch keeper; neck side pogo pins, cones, magnets, spring paw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
2026-10-20 cortex: grilles become flush perforated inserts in plain tub windows (tub evals in ~1 s, was ~5 min; no mould side actions); holes unioned as a balanced tree
2026-10-20 quad00: mini export [use]s cortex/cortex.loon for the whole head (shell, grilles, internals, option-B dock incl. neck-side pogo/cones/magnets/pawl); cortex.py kept only as collision proxies for the P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
    [cable-hspine.stl, cover-deltoid_la.stl, cover-deltoid_ra.stl, thigh-inner_ll.stl, thigh-inner_rl.stl]
2026-10-20 arm/fork: build package -- order list, assembly order, measurement protocol and scripts, rana dyno plan
    Regenerates fab/ from the current model (turret tower windows moved 0.11 mm).
    [3.2mm_sheet1.dxf, 3.2mm_sheet2.dxf, cal_plate.dxf, poses.csv, turret-tower-A_3.2mm_x1.dxf, turret-tower-B_3.2mm_x1.dxf]
2026-10-21 arm/fork: design review for approval; order list parked until approved
2026-10-21 quad00: mini v1 fab package (fab/) -- plate DXFs nested on 4 x 390 sheets, hollowed + split printed skins, cortex STEP/STL (tub, floor, grilles, sled, latch, keeper) + glass DXF, BOM, bench list
    Head proxies come from cortex.loon (cortex/export.sh -> cortex/stl, k1_structure.cx_parts); cortex.py deleted.
    Dock plate/trim get the pogo + latch windows; spine leaves the pogo block. Every other part unchanged.
    ROM all ok, harness_check.py passes (service loops 46 mm). SPEC.md TBDs -> fab/MEASURE.md.
    [BOM.csv, arm-elbowE1_la.dxf, arm-elbowE2_la.dxf, arm-forearmF1_la.dxf, arm-forearmF1_ra.dxf, arm-upperU1_la.dxf, arm-upperU2_la.dxf, arm-yokeP1_la.dxf]
2026-10-21 arm/fork: mini-first assessment
2026-10-21 arm/fork: lymb v10 (ROSE_ARM=v10) - roll moved to the upper arm (J3), 300/200, short turret + desk pedestal / chest adapter, skin + photoreal renders, V10.md
    v9 bit-identical when ROSE_ARM is unset.
    [3.2mm_sheet1.dxf, 3.2mm_sheet2.dxf, 3.2mm_sheet3.dxf, 3.2mm_sheet4.dxf, 6.3mm_sheet1.dxf, foot_6.3mm_x1.dxf, fore-A_3.2mm_x1.dxf, fore-B_3.2mm_x1.dxf]
2026-10-21 arm/fork/rig: elbow rig purchase list, test plan with pass criteria, rig_test.py; plates on 1/8" stock
    [child_A_3.175mm.dxf, child_B_3.175mm.dxf, parent_A_3.175mm.dxf, parent_B_3.175mm.dxf, sheet_3.175mm_1.dxf, sheet_3.175mm_2.dxf, spacer_disc_3.175mm.dxf]
2026-10-21 arm/fork: v10 one-page review for Cam
2026-10-21 quad00/fab: STATUS -- mini fab cut; done / partial / left
2026-10-21 arm/fork: lymb v10.1 - drum-to-drum skin, one-loft upper arm split at J3, round pedestal skirt, chest socket, J3/J7 service loops, J3 pose cap (pose_cap.py + poses.py hook), revised renders, V10.1.md
    [3.2mm_sheet1.dxf, 3.2mm_sheet2.dxf, 3.2mm_sheet3.dxf, 3.2mm_sheet4.dxf, pedestal-base_3.2mm_x1.dxf]
2026-10-21 cortex: release renders (hero 16:9 + square, colorway lineup, mini docked) via vcad --photoreal; glass face plates (render workaround), finer 7.5 deg rounds, matte dead-front glass
    [vcad_export.py]
2026-10-21 arm/fork: lymb v10.2 - Rose's language: keyhole plates, tapered rounded-rect sleeves with coaxial 1 mm seams, flush graphite pucks, desk puck base, J1 flush in the torso corner, cortex head, warm bla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
    [3.2mm_sheet1.dxf, 3.2mm_sheet2.dxf, 3.2mm_sheet3.dxf, 3.2mm_sheet4.dxf, 6.3mm_sheet1.dxf, foot_6.3mm_x1.dxf, fore-A_3.2mm_x1.dxf, fore-B_3.2mm_x1.dxf]
2026-10-21 measure: dry run on a simulated RobStride bus; scripts follow the v10 joints and table height; rig heat check verifies torque; rig weights to 14 kg
    [cal_plate.dxf, poses.csv]
2026-10-21 arm/fork: lymb v10.3 WIP - soft_limits.py pose_ok (+table, verified 0 clashes on desk/body sweeps), thermal_v10.py (J2 holds 1.27 kg with open ring pucks + Al flank panels), keyhole turret towers + n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
    [3.2mm_sheet1.dxf, 3.2mm_sheet2.dxf, 3.2mm_sheet3.dxf, turret-disc_3.2mm_x1.dxf, turret-tower-A_3.2mm_x1.dxf, turret-tower-B_3.2mm_x1.dxf]
2026-10-21 quad00 full torso for lymb v10: crown raised over the J1 drums (was 7 mm proud), gunmetal J1 bezel rings flush on the flank at |y| 186.6 (rides the chest)
    [cover-chest.stl, cover-deltoid_la.stl, cover-deltoid_ra.stl, elec-dockplug.stl, trim-dockplug.stl, trim-ear_l.stl, trim-ear_r.stl, trim-j1ring_l.stl]
2026-10-21 quad00: SHOULDER.md -- J1 heat, keep it simple (Cam): plate conduction as built, no fans; controller derate 10 W continuous, ~5 min rated hold
2026-10-21 arm/fork: lymb v10.3 - soft limits proven (0 clashes: desk random 58 %, body 61 %, fold grid 86 % kept), thermal derating + skin mass in fork_checks (J2 1.27 kg), open-ring pucks + Al flank panels of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
    [j1j2_envelope_l.stl]
2026-10-21 quad00 full: J1 cooling B + A (Cam) -- open dot-grid ring around the J1 face (intake), 40 mm fan per corner behind the drum, dot-grid exhaust on the chest back; conduction via the side plate; SHOULDE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
    [cover-chest.stl, cover-deltoid_la.stl, cover-deltoid_ra.stl, elec-j1fan_l.stl, elec-j1fan_r.stl, trim-j1grille_l.stl, trim-j1grille_r.stl]
2026-10-21 build: buy sheet B lines from the v10.3 final BOM delta
2026-10-21 TORSO-INTERFACE: no torso fans (Cam) - ring + plate conduction + controller derate is the design of record
2026-10-21 quad00 full torso to lymb v10.3 interface: flank pinned at |y| 186.6, corner clears r 88 about J1 (crown 522.3, deeper armpit flare), J1 face opening for the arm's open ring, bezel inlaid flush; inta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
    [cover-chest.stl, cover-deltoid_la.stl, cover-deltoid_ra.stl, trim-j1ring_l.stl, trim-j1ring_r.stl]
2026-10-21 quad00 full: no fans (Cam) -- J1 cooled by plate conduction + the arm's open ring through a flank opening, bezel inlaid; full export wears the cortex head (scaled 1.702)
    [cover-chest.stl, cover-deltoid_la.stl, cover-deltoid_ra.stl]
2026-10-21 arm/fork: humanoid 3/4 on rose's torso pass 3 (b49e00b, no fans, Ø135 flank opening, cortex x1.702) - lymb-v10.4-humanoid-34-torso3.png
2026-10-21 arm/fork: lymb v10.4 (pass 1) - J2 1.355 kg (wrist -18 mm, distal windows, 0.9 mm sleeves, windowed panels), skin fastening (clips/magnets/standoffs, 57 g, no new plate holes), open-corner adapter r 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
    [3.2mm_sheet2.dxf, 3.2mm_sheet3.dxf, 3.2mm_sheet4.dxf, 6.3mm_sheet1.dxf, foot_6.3mm_x1.dxf, fore-A_3.2mm_x1.dxf, fore-B_3.2mm_x1.dxf, pedestal-X_3.2mm_x2.dxf]
2026-10-21 cortex: full-size head (cortex-full.loon) for the 1703 mm humanoid -- 190 x 230 x 160, 5in display, 150 mm baseline, 40 mm speakers, 3S2P, same dock core; full export wears it; FULL-HEAD.md with gaze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
    [cover-deltoid_la.stl, cover-deltoid_ra.stl]
2026-10-21 quad00: neck in the torso/cortex language -- yaw sleeve out of the crown cradling the pitch drum, gunmetal yaw parting ring, flush gunmetal pitch pucks, satin dock saddle under the head; head yaw/pit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
    [cover-deltoid_la.stl, cover-deltoid_ra.stl, thigh-inner_ll.stl, thigh-inner_rl.stl]
2026-10-21 cortex: desk fit print set (mini head) -- FDM fit coupons (inserts, board slot, magnet pockets, dock face, tub-floor lip), printable tub/floor(+registration lip)/sled/grilles/glass STLs, make_print.s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
    [cortex-mini-ear-grilles.stl, cortex-mini-exhaust-grille.stl, cortex-mini-floor.stl, cortex-mini-glass.stl, cortex-mini-sled.stl, cortex-mini-tub.stl, coupons-plate.stl]
2026-10-21 cortex: full-head desk print for Cam's Orin NX on Seeed J401 (P1S, PETG) -- J401 modelled in cortex-full (board, port block, module+heatsink, 4 sled pillars with M2.5 insert holes, wider port cutout,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
    [cortex-full-ear-grilles.stl, cortex-full-exhaust-grille.stl, cortex-full-floor.stl, cortex-full-glass.stl, cortex-full-sled.stl, cortex-full-tub.stl, coupons-plate.stl]
2026-10-21 cortex-full: refit to Cam's actual hardware -- reComputer Super (Orin NX) in its 130x120x66 enclosure (assumed), rear I/O cutout 104x46, sled with bridge over the pack; 7in portable panel (lowered un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
2026-10-21 cortex-full: bare reComputer Super carrier (Cam: out of the enclosure, keep the stock heatsink) from caliper photos -- holes 100.2 sq, port edge 23.6, board ~110 sq; sled + bridge, 108x28 port cutout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
    [cortex-full-sled.stl, cortex-full-tub.stl]
2026-10-21 cortex print: Bambu Studio 3MF plates for the P1S (coupons, tub, floor, sled, grilles at 0.12, glass) -- pre-oriented, placed, per-object settings; make_3mf.py
    [cortex-coupons.3mf, cortex-full-1-tub.3mf, cortex-full-2-floor.3mf, cortex-full-3-sled.3mf, cortex-full-4-grilles.3mf, cortex-full-5-glass.3mf]
2026-10-21 cortex: USB-only head evaluation (power budget, PD/power-path, USB2 dock over pogo, body comms, harness, BOM delta)
2026-10-21 USB head: J3011 datasheet facts (12-54 V -> 4S mandatory; J38 host USB-C outside, J55 USB2 header to dock, J70 recovery internal; PCB 87.8x56.7)
2026-10-21 USB head: Cam's picks -- 4S + 19 V buck-boost (J3011 12-54 V), pogo dock DC+USB2; BOM battery/power lines updated
2026-10-21 arm/fork: lymb v10.4 + v10.5 - ring taper J2 137 > J4 126 > J6 96, deltoid hood (humanoid), rose's biceps (1.15:1, fullest 27 % down, 0.75 at J3, 0.72 elbow), J3 hairline, J3 dot-grid fields 1.4/2.2 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
    [3.2mm_sheet1.dxf, 3.2mm_sheet2.dxf, 3.2mm_sheet3.dxf, 3.2mm_sheet4.dxf, fore-A_3.2mm_x1.dxf, fore-B_3.2mm_x1.dxf, upperd-A_3.2mm_x1.dxf, upperd-B_3.2mm_x1.dxf]
2026-10-21 USB head: J3011 geometry from Seeed STEP (M2.5 holes 81x49, heatsink 87x58.7x16.7, fan 47x47x7.3, stack ~36-38)
2026-10-21 neck pass 2: wider/taller collar (1.48/1.34), saddle pedestal from collar to head floor over the dock plate +3 mm; ROM yaw +-57, pitch -20..49; pass2 renders
    [cover-deltoid_ra.stl, thigh-inner_ll.stl, thigh-inner_rl.stl]
2026-10-21 cortex print: grilles with solid 1.4 mm rim and finer holes; sled as one connected body; 3MFs rebuilt (ear grilles split by side, glass laid face down) + plate previews
    [cortex-coupons.3mf, cortex-full-1-tub.3mf, cortex-full-2-floor.3mf, cortex-full-3-sled.3mf, cortex-full-4-grilles.3mf, cortex-full-5-glass.3mf, cortex-full-ear-grilles.stl, cortex-full-exhaust-grille.stl]
2026-10-21 arm: rose_arm_layout imports full.rose_full_layout (main renamed pro -> full; the merge broke rose_fork's import)
    [rose_arm_layout.py]
2026-10-21 cortex print MVP: no heat-set inserts (M2.5 self-tap pilots 2.2 in the sled pillars), medium-rare fits (lip c 0.15); tub/floor/sled STLs + 3MFs regenerated; PRINT.md
    [cortex-full-1-tub.3mf, cortex-full-2-floor.3mf, cortex-full-3-sled.3mf, cortex-full-5-glass.3mf, cortex-full-floor.stl, cortex-full-sled.stl, cortex-mini-floor.stl]
2026-10-21 PRINT.md: only floor + sled changed
2026-10-21 arm/fork: lymb v10.6 - range wins, skin frozen: biceps 1.3:1 (side profile kept), turret top inside the J2 seam zone, no hood, upperd lateral = structure; J2 -145 desk / -130 humanoid, J4 +-110; cove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
    [cap-J2+1.stl, cap-J2-1.stl, cap-J4+1.stl, cap-J4-1.stl, cap-J6+1.stl, cap-J6-1.stl, desk-puck.stl, drum-J1.stl]
2026-10-21 neck pass 3: saddle cheeks -- a +-40 deg cowl concentric with the pitch axis wraps the drum crown by 5 mm, zero daylight at every pitch; ROM yaw +-57, pitch -20..49 free on mini + full; pass3 close-u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
    [cover-deltoid_ra.stl, cover-dockcollar.stl]
2026-10-21 arm/fork: lymb v10.7 - print-ready skin: 28 watertight shells (0.9/1.2 mm, open, clips + magnet bosses + ring spiders, ring dot-grids meshed, 3MF rings) in skin-stl/print/ + PRINT.md (329 cm3 MJF, ~$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
    [cap-J2+1.stl, cap-J2-1.stl, cap-J4+1.stl, cap-J4-1.stl, cap-J6+1.stl, cap-J6-1.stl, desk-puck.stl, drum-J1.stl]
2026-10-21 arm/fork: humanoid renders on main's neck pass 2 (91e67b9): cortex-full + head-pitch body at 35 deg rest - lymb-v10.6-*-neck2.png
2026-10-21 buy sheet: skin print ready (v10.7 print set, ~$152)
2026-10-21 cortex: deep-mini study (+15 mm, Waveshare IO base inside, 0 clash) + comparison renders vs mini and full
2026-10-21 cortex release 1: deep mini is the mini of record (J3011 on a carrier plate, Waveshare-ready); no brown -- black/white + one accent across all colorways (mini/full/mega); minimal: solid accent ear pa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
    [cortex-full-4-grilles.3mf, cortex-full-ear-grilles.stl, cortex-full-exhaust-grille.stl, cortex-mini-1-tub.3mf, cortex-mini-2-floor.3mf, cortex-mini-3-sled.3mf, cortex-mini-4-grilles.3mf, cortex-mini-5-glass.3mf]
2026-10-21 arm/fork: humanoid_export keeps rose's pass-2 neck (cheeks, collar, head-H1, dock) and pitches all hpitch parts 35 deg; only old helmet/visor/eye/ear parts dropped
2026-10-21 arm/fork: lymb v10.8 - no perforations: 6061 J2 drum + Al caps J4/J6 on gap pads, J3 6061 band (3.46 N.m >= 3.43 cap), J2 1.33 kg after +0.38 kg; solid recessed caps in 1.5 mm gunmetal rings, Make gr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
    [cap-J2+1.stl, cap-J2-1.stl, cap-J4+1.stl, cap-J4-1.stl, cap-J6+1.stl, cap-J6-1.stl, disc-J2+1.stl, disc-J2-1.stl]
2026-10-21 arm/fork: lymb v10.8 renders - black and white colourways: desk 3/4, humanoid 3/4 / front / side, neck close-up
2026-10-21 mega: heavy-duty human-scale actuator sizing (1.95 m, ~95 kg, 25/50 kg payload): per-joint peak/continuous torque, RS04+stage mapping, rana-L class for knee/hip/waist pitch
2026-10-21 buy sheet: v10.8 white release look - machined drums, cap discs, J3 band, white skin print, anodize
2026-10-26 cortex: print prep -- tub corner blocks + M3 heat-set holes, glass seat band (notched round display/cams), floor M3/M2.5 countersinks, printed v1 sled (cortex-sled-print); print_build.py rebuilds tub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
    [cortex-ear-grille-l.stl, cortex-ear-grille-r.stl, cortex-exhaust-grille.stl, cortex-floor.stl, cortex-sled-print-l.stl, cortex-sled-print-r.stl, cortex-sled-print.step, cortex-sled-print.stl]
2026-10-26 cortex: print plan (fab/cortex/README.md), print renders, notes; fab/README tub orientation corrected
2026-10-26 cortex: closed back with a perforated back grille (ports reached only with the tub off; keeps the I/O-window intake), 4-inch square face variant (cortex-tub-d4, d4-glass, d4-body: Waveshare 4inch HDM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
    [cortex-back-grille.stl, cortex-exhaust-grille.stl, cortex-floor.stl, cortex-tub-d4.step, cortex-tub-d4.stl, cortex-tub.step, cortex-tub.stl, d4-body.step]
2026-10-26 cortex: print plan + notes for the closed back and the 4-inch face variant
2026-10-26 cortex: drop the vendor-screen probe renders from the print set (kept in NOTES.md as numbers)
2026-10-26 cortex: size comes from size.loon (mini default, bit-identical) / size-full.loon (7-inch full head, WIP: d7 face + camera placement pending Cam's call); work around loon unary-minus panic on module-i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
2026-10-26 cortex: 7-inch full-head mockups (eyes above / beside / in the corners) through the one source; the 7-inch mounts behind the face wall, window = active area + 2 mm; lineup render vs the mini
2026-10-26 cortex: fix cortex-tub-d4 (and the new tub-full) leaving the back I/O window uncut -- the 4-inch tub had a solid back, which fails the 25 W thermal check; print_build.py now reads size.loon and build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
    [cortex-back-grille.stl, cortex-ear-grille-l.stl, cortex-ear-grille-r.stl, cortex-ear-grilles.stl, cortex-exhaust-grille.stl, cortex-floor.stl, cortex-tub-d4.stl, cortex-tub.stl]
2026-10-26 cortex mockups: E = D with a goggle-lens visor (1.6 mm PC lens, flush in the bezel's 0.6 mm reveal, bonded with VHB; stand-in geometry for a real ski/MTB replacement lens)
2026-10-26 cortex mockups: F = the printable MVP of E (D's egg + ears, single-curve visor band printable standing in vase mode, the 4-inch panel recessed in the band's window as the dead front; no bought lens, 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
2026-10-26 cortex mockups: G = one-material premium (single-volume skull with the visor carved 2 mm in, chamfered rim, recess floor as the dead front carrying the lit eyes, display body behind) and H = F with d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
    [f-band.stl, f-body.stl, f-ear.stl, f-glass.stl, f-panel.stl, f-ring.stl]
2026-10-26 cortex mockups: G = one-material premium (one volume, the face a chamfered 2 mm recess in the skull, panel at the bottom of the recess), H = F with 1.2 mm step reveals at the band's edges; hero + azi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
2026-10-26 cortex mockups: exploded view of G (skull lifted, visor recess pane + panel forward, ear caps and rings out to each side, the electronics stack behind: battery, compute, heatsink, speakers as the min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
2026-10-26 cortex mockups: option I final -- no visor; the cameras ARE the eyes (Ø9.5 recessed windows at ±33, dark glass discs seated inside), the 4-inch screen low as nose/mouth in a chamfered rectangular rec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
2026-10-26 cortex mockups: option J -- the Figure direction. No literal features: the egg skull gets a flat face facet, the 4-inch panel flush in it (1.2 mm reveal), and the eyes are glossy dark glass domes pro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
2026-10-26 cortex: mouth decision, DIY dome sources, camera-behind-dome caveat recorded in NOTES.md
2026-10-27 cortex mockups: J texture-honest final -- screen gloss vs satin shell, eyes+mouth emissive flush proud of the pane (circular discs, stadium mouth; z-order fixed: pane elements clear the skull rim), s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
2026-10-27 cortex: texture rule, ear cameras, emissive double-count warning recorded in NOTES.md
2026-10-27 cortex.loon: option J rebuilt as the production architecture -- egg skull with a flat face facet (vertical plane 9 mm behind the widest front), the 4-inch pane recessed 1.2 mm in it, Ø19 lit eye disc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
2026-10-27 cortex.loon: J face finalized in the tilted frame -- j-tilt rotates about the ORIGIN then places at (xfj, zfj) (the old double-pivot displaced the pane); facet plane cuts only u>0 so the leaning crow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
2026-10-27 cortex: J tilted-frame geometry decisions recorded
2026-10-27 cortex.loon: clearance pass -- panel pocket extended through the facet (the 0.2 mm skin was burying the pane), display + camera proxies repositioned for the J architecture (display behind the pane po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
2026-10-27 cortex.loon: clearance pass complete -- panel pocket through the facet (the pane was buried under a 0.2 mm skin), display proxy in the panel pocket (1.1 mm off the pane), camera proxies behind the ea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
2026-10-27 cortex: three colorway renders of the J head (A warm two-tone grey, B all-black machined, C off-white robot); proxies moved after the J frame in cortex.loon, duplicate j-tilt removed, glued comment/l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
2026-10-27 cortex: shorter mini (108 H) with the forehead and chin reduced -- the pane grew to the 4-inch screen's real height (85 tall, edge-to-edge vertically too), facet centred so the glass dominates the fa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
2026-10-27 cortex: the premium detail pass in loon -- 45-deg countersunk grille dots, a 0.6 mm aperture chamfer around the pane, a 1.2 mm parting-line groove at the pane's bottom edge, a recessed 3 mm base band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
2026-10-27 cortex: banana for scale -- the J head at 98x100H next to a ~186 mm banana (about 62% of it); the shot exposes the pane/chin overlap artifact to fix
2026-10-27 cortex: the 7-inch FULL size driven through the same J architecture -- 193 W x 118 D x 126 H, the 7-inch panel (166 x 108) as the whole face, pane size/params switched on size-full; eyes/mouth scale 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
2026-10-27 cortex: ears + cameras reworked -- grille lowered to the wall's full-width band (zg 43, smaller oval), cameras moved to the FACET edge at eye height flanking the screen (baseline 90, Ø8.5 bore + dark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
2026-10-27 cortex: cameras v1 -- ONE mono sensor in the forehead band above the pane (Vector-style), bore through the crown wall, dark glass dot flush; stereo proven impossible behind either panel (glass sits O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
2026-10-27 cortex: camera decision + stereo verdict recorded in NOTES.md
2026-10-27 cortex: orange ear accent rings -- the design's one colour accent around each grille oval, flat frame 1.4 wide extruded through the wall, caps the hole from outside; ring boolean directions fixed, io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
2026-10-27 cortex: orange grille inserts -- the ears are the accent: an oval plate (2.2 thick) with the hex dot grid cut through, seated flush in each ear window (all geometry local, then placed; the old differ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
2026-10-27 cortex: orange grille inserts recorded; the head is visually complete
2026-10-27 cortex: frog-node brief + v0 massing -- one pebble, brow domes for the stereo cameras, flush square face, 12-deg desk puck; desk and humanoid renders
2026-10-27 cortex: node v1 -- human-skull massing (flat face plane, domed cranium, egg plan, occiput, neck recess), the 4in square panel as the face, brow cameras; brow domes dropped
2026-10-27 cortex: node brief -- drop the last dome references
    [cortex-sled-print.step, cortex-tub-d4.step, cortex-tub.step, d4-body.step, d4-glass.step, dock-face.step, dock-pawl.step, dock-release.step]
2026-10-27 cortex: node v1.1 -- neck join (foot-outline trim at a 1 mm reveal, flaring from a 50 column) and a jaw-line slot each side with a green light pipe
2026-10-27 cortex: node v1.2 -- one dead-front glass from chin to brow hides the cameras (options A-D in the brief), 19-dot ear grilles for the mics
2026-10-27 cortex: node v1.3 -- jaw slot out, ear grilles moved to eye height at mid-depth (vertical oval), satin black; cameras can't sit behind the 4in IPS backlight (noted)
2026-10-27 cortex: node v1.4 -- hidden intake band on the foot's bottom round (~690 mm2), neck trim shrunk to the foot flat; internals fitted by node_fit.py with a clearance check (all >= 1 mm, no clashes); sec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
2026-10-27 cortex: node v1.5 -- exhaust field low on the back of the crown; node_print.py builds the printable hollow tub (849 holes: face window, ears, intake, exhaust) + floor plate in manifold3d, both watert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
    [node-floor.stl, node-tub.stl]
2026-10-27 cortex: node v1.6 -- rain: exhaust moved under the occiput (sheltered, faces down), ear + exhaust holes fall 30 deg outward; IPX4 review of every opening in the brief
    [node-tub.stl]
2026-10-27 cortex: node v1.7 -- MVP for the P1S: USB-C panel port on the back, 4 webbed M3 heat-set bosses, floor plate + printed sled (one support-free print), internals re-fitted (all >= 1 mm, no clashes), pr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
    [node-floor.stl, node-tub.stl]
2026-10-27 cortex: node v1.8 -- back USB-C is PD power in + USB 2 data: receptacle on the PD/charger board, board on a pad inside the back wall, plug overmold pocket; wiring in the brief
    [node-tub.stl]
2026-10-27 cortex: node hero + exploded assembly renders (node_hero.sh)
2026-10-27 cortex: node v1.9 -- right speaker no longer mirrored outside the head; camera boards modelled as board + lens barrel and clear the crown curve; assembly .vcad for vcad.app
2026-10-27 fab/node: P1S 3MF kit -- tub + floor/sled on one plate (vcad kit)
    [node-mvp.3mf]
2026-10-27 fab/node: plain core-spec 3MF (trimesh) -- vcad kit's Bambu project metadata (plater_id 0) segfaults Bambu Studio / Orca on load
    [node-mvp.3mf]
2026-10-27 cortex: node v1.10 -- sled walls run the carrier's full length with outward 45-deg lips under the A603's corner holes; carrier moved forward, 3 floor screws, node_3mf.py for the plain 3MF
    [node-floor.stl, node-mvp.3mf, node-tub.stl]
2026-10-27 cortex: node v1.11 -- Jetson Orin Nano Super devkit from NVIDIA's P3768 files (100x79, M2.5 on 92x58); shell splits at z 30 into a closed base (pack, 4 devkit posts, lip) and an upper that lowers ove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
    [node-base.stl, node-floor.stl, node-mvp.3mf, node-tub.stl, node-upper.stl]
2026-10-27 cortex: node v1.12 -- 1/8in cast acrylic face inlaid flush (face plane +3.5, pocket on a 1.5 land, panel bonded behind), glass runs past the seam; CNC DXF of the sheet + mask (node_acrylic.py)
    [node-acrylic.dxf, node-base.stl, node-mvp.3mf, node-upper.stl]
2026-10-27 fab/node: node-mvp-fast.3mf -- Bambu project (plate numbered from 1) with fast per-object settings: 0.28 layers, 2 walls, 10% grid, tree support at 30 deg
    [node-mvp-fast.3mf, node-mvp.3mf]
2026-10-27 fab/node: node-mvp-facedown.3mf -- upper laid on its face plane to cut the crown's tree support
    [node-mvp-facedown.3mf, node-mvp-fast.3mf, node-mvp.3mf]
2026-10-27 fab/node: node-mvp-06.3mf -- face-down, 0.6 nozzle settings (0.36 layers, 2 walls, no infill)
    [node-mvp-06.3mf, node-mvp-facedown.3mf, node-mvp-fast.3mf, node-mvp.3mf]
2026-10-27 cortex: node shell 2.0 mm (4 x 0.5 lines, no gap fill/infill); node-mvp-fastest.3mf -- face-down, 0.5 lines, draft speeds on the objects, supports past 40 deg
    [node-base.stl, node-mvp-06.3mf, node-mvp-facedown.3mf, node-mvp-fast.3mf, node-mvp-fastest.3mf, node-mvp.3mf, node-upper.stl]
2026-10-27 cortex: node -- front seam boss floated free in the upper (its web was cut to clear the display): 4 seam screws now, all webbed to side/back walls; lower power-board holes kept blind in the 2.0 wall;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
    [node-base.stl, node-mvp-06.3mf, node-mvp-facedown.3mf, node-mvp-fast.3mf, node-mvp-fastest.3mf, node-mvp.3mf, node-upper.stl]
2026-10-27 fab/node: fastest/0.6 3MFs -- 0% infill + 3/3 shells left holes in the near-flat back of the head printed face-down; 6 top / 4 bottom + 10% infill
    [node-mvp-06.3mf, node-mvp-facedown.3mf, node-mvp-fast.3mf, node-mvp-fastest.3mf, node-mvp.3mf]
2026-10-27 cortex: node shell offset along the surface normal -- the sideways slice offset left the crown 0.3-1.2 mm thick (sliced as a ring of holes); cavity is now the intersection of skins shifted by dz and 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
    [node-base.stl, node-mvp-06.3mf, node-mvp-facedown.3mf, node-mvp-fast.3mf, node-mvp-fastest.3mf, node-mvp.3mf, node-upper.stl]
2026-10-27 cortex: node v1.14 -- a whole 4x6in acrylic sheet, landscape, factory corners, inlaid flush; head widened to ~173 with a squarer crown; full sensor plate behind the sheet; stereo cameras beside the p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
    [node-acrylic.dxf, node-base.stl, node-mvp-06.3mf, node-mvp-facedown.3mf, node-mvp-fast.3mf, node-mvp-fastest.3mf, node-mvp.3mf, node-upper.stl]
2026-10-27 cortex: node v1.15 -- the 4x6in sheet in portrait: skull stretched above the seam (x1.54) to ~190 tall, ~123 wide; panel mid-face, stereo cameras in the brow (60 baseline), sensor strip below the pan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
    [node-acrylic.dxf, node-base.stl, node-mvp-06.3mf, node-mvp-facedown.3mf, node-mvp-fast.3mf, node-mvp-fastest.3mf, node-mvp.3mf, node-upper.stl]
2026-10-27 cortex: node -- human-skull back: elliptical occiput to x -94 tucking into the neck (head ~1.3x longer than wide); sheet corners R24/R10 with the face narrowing into the temples; round plan above the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
    [node-acrylic.dxf, node-base.stl, node-mvp-06.3mf, node-mvp-facedown.3mf, node-mvp-fast.3mf, node-mvp-fastest.3mf, node-mvp.3mf, node-upper.stl]
2026-10-27 cortex: node -- top of the head one smooth dome: no temple taper (face full width to the brow), crown taller (198) and round in plan above the sheet
    [node-base.stl, node-mvp-06.3mf, node-mvp-facedown.3mf, node-mvp-fast.3mf, node-mvp-fastest.3mf, node-mvp.3mf, node-upper.stl]
2026-10-27 cortex: node v1.17 -- back to the short head (45cb480); no cover sheet: the 4in panel's own glass flush in a face pocket above the seam; IMX219 spy-camera heads behind Ø4 holes on the face rim beside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
    [node-acrylic.dxf, node-base.stl, node-mvp-06.3mf, node-mvp-facedown.3mf, node-mvp-fast.3mf, node-mvp-fastest.3mf, node-mvp.3mf, node-upper.stl]
2026-10-27 cortex: node v1.18 -- chin sensortown: a dot grille across the chin under the screen hides the stereo cameras (two of its holes, 60 baseline); rim camera holes removed
    [node-base.stl, node-mvp-06.3mf, node-mvp-facedown.3mf, node-mvp-fast.3mf, node-mvp-fastest.3mf, node-mvp.3mf, node-upper.stl]
2026-10-27 cortex: node v1.19 -- vertical split: black face module (panel groove, flush 4in glass, one centred camera + privacy shutter, full-width chin grille) + rear shell (body colour, closed bottom); top ho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
    [node-base.stl, node-face.stl, node-mvp-06.3mf, node-mvp-facedown.3mf, node-mvp-fast.3mf, node-mvp-fastest.3mf, node-mvp.3mf, node-rear.stl]
2026-10-27 cortex: node v1.20 -- all black; Waveshare IMX219-83 stereo depth camera (from its STEP) behind the chin grille, lenses through Ø8 chamfered windows, 60 baseline; top camera, shutter and panel groove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
    [node-face.stl, node-mvp-06.3mf, node-mvp-facedown.3mf, node-mvp-fast.3mf, node-mvp-fastest.3mf, node-mvp.3mf, node-rear.stl, node-shutter.stl]
2026-10-27 cortex: node v1.21 -- head shortened (VS 1.12, ~150 tall): flat face ends ~4 mm above the screen
    [node-face.stl, node-mvp-06.3mf, node-mvp-facedown.3mf, node-mvp-fast.3mf, node-mvp-fastest.3mf, node-mvp.3mf, node-rear.stl]
2026-10-27 cortex: node v1.21 LOCKED -- the design of record for the first print
2026-10-27 cortex: full-size node v3 -- grille between the lenses only, ear grilles over the speakers
2026-10-27 cortex: mini chin grille between the lens windows only (matches full); pair render leaned back 10 deg on a bare desk
    [node-face.stl, node-mvp-06.3mf, node-mvp-facedown.3mf, node-mvp-fast.3mf, node-mvp-fastest.3mf, node-mvp.3mf]
2026-10-27 cortex: 10 deg desk lean cut off the back of both feet (flat meets the old foot ahead of the CoM); batteries and AGX raised to clear it
    [node-face.stl, node-mvp-06.3mf, node-mvp-facedown.3mf, node-mvp-fast.3mf, node-mvp-fastest.3mf, node-mvp.3mf, node-rear.stl]
2026-10-27 cortex: neck dock on the mini's lean flat -- O52 locating recess + key, 4x M3 inserts on O40, O14 cable port, 4 bumpon recesses; strap slots follow the flat
    [node-mvp-06.3mf, node-mvp-facedown.3mf, node-mvp-fast.3mf, node-mvp-fastest.3mf, node-mvp.3mf, node-rear.stl]
2026-10-27 cortex: bumpons on the dock's frame -- all four now land on the lean flat
    [node-mvp-06.3mf, node-mvp-facedown.3mf, node-mvp-fast.3mf, node-mvp-fastest.3mf, node-mvp.3mf, node-rear.stl]
2026-10-27 cortex: rear bumpons inboard of the flat's back edge
    [node-mvp-06.3mf, node-mvp-facedown.3mf, node-mvp-fast.3mf, node-mvp-fastest.3mf, node-mvp.3mf, node-rear.stl]
2026-10-27 cortex: face lab -- mouth options (ribbon, line, kawaii, visemes, none) and a speaking sample
2026-10-27 cortex: full head ears -- reSpeaker XVF3800 under the crown, mics up, 4 crown ports
    Ø100 x 1.2 disc (Seeed 2D drawing + STEP), bottom at z 203, 8 forward of centre; parts
    down, mic inlets up through ~11 mm sealed channels to Ø1.6 ports in a quiet square on the
    crown; hung from four M2.5 crown bosses; USB-C at the back edge to the AGX. Mic inlet
    positions ASSUMED just inside the mounting holes until measured.
2026-10-27 cortex: mini ears -- reSpeaker XVF3800 under a crown grown 5 mm
    The Ø100 board only fit at mid-height (mics 25-36 mm under the shell, too far for clean
    channels), so the crown peak goes 134 -> 138 (design; 150 -> 155 mm tall). The board lies
    flat at z 132 above the display, mics up: four crown bosses (M2.5 pilots), four sealed Ø5
    channels to Ø1.6 crown ports, ~11 mm each; fit clean (2.6 mm to the wall), print watertight,
    3MFs rebuilt. The full head re-anchors its height map to the new crown peak (still 226).
    [node-face.stl, node-mvp-06.3mf, node-mvp-facedown.3mf, node-mvp-fast.3mf, node-mvp-fastest.3mf, node-mvp.3mf, node-rear.stl]
2026-10-28 cortex: crown halo grille over the mic array, both heads; rain-safe
    A ring of Ø1.4 dots on a 2.2 hex (the chin and ear grilles' pattern) through the mic
    radius, five rows; its middle row lands a dot on each mic, so the four ports are four of
    its dots. The rest are blind (0.6 deep), so only the ports go through, and each port's
    sealed channel is closed at its foot by a hydrophobic acoustic membrane (ePTFE vent) over
    the mic, on a lip above the board: sound passes, rain stops there.
    (node_print.py staged without another session's uncommitted neck-intake work in the
    same file; fab STLs not committed here since they'd mix both.)
    Signed-o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
2026-10-28 cortex: face lab -- liquid mouth rebuilt as liquid lips
    Two chains of droplets (upper and lower lip) joined at the corners: one breathing capsule
    at rest, a lens with darkness between when speaking (viseme opening and width, mood at
    the corners). Damped springs with surface tension, kicked on syllable onsets; drawn per
    pixel as a metaball field with soft edges, a hotter core and a sheen.
2026-10-28 cortex: face lab -- every emotion designed: mouth pose, pupils, entry motion
    Each named emotion carries a mouth pose (width, opening, curve, side, tilt, round, press),
    a pupil size and an entry bounce; the liquid lips ease into it on springs. Listening
    holds its breath with lips softly parted, thinking presses them aside with a slow drift,
    surprise is a round o with small pupils, sad quivers now and then. Faces from the pad or
    from Claude read a pose off valence/arousal.
2026-10-28 cortex: drop the pan stem renders swept into 6eb4f8d (the stem thread is parked)
2026-10-28 cortex: rerender the pair and rebuild the mini's STLs at the current design (crown grille, no neck)
    [node-face.stl, node-rear.stl]
2026-10-28 cortex: mini 3MFs regenerated from the current STLs (crown grille, no neck)
    [node-mvp-06.3mf, node-mvp-facedown.3mf, node-mvp-fast.3mf, node-mvp-fastest.3mf, node-mvp.3mf]
2026-10-28 quad00: node skulls seated on the neck -- node's own neck trim replaces the cortex dock collar and plate, spine cable hidden in its column; rerendered
    [vcad_export.py]
2026-10-28 quad00: the head-pitch cap goes satin black beside the node skull (its gunmetal mirrored the sky and read as a hole in the cowl); rerendered
2026-10-28 quad00 design pass: pelvis shell over the hip-roll cans (mini + full), a real waist on the torso shell, the full's yaw drum becomes an abdomen
2026-10-28 quad00 design pass: mini gets a parallel gripper (palm block + two jaws), full gets a hand (palm over the wrist-yaw can, four curled fingers, an opposed thumb)
2026-10-28 quad00 design pass: full head x1.12 with a calf and quad swell; one accent (every gunmetal band satin, the yaw seam in the face's mint); full face sized to its 7in panel; toe spring + rounded heel; r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
2026-10-28 quad00 design pass 2: hips not a box (pelvis widest over the cans, drawing in to the waist), the hip-roll plate black-anodized, a taller mint yaw-seam ring, more quad on the full; rerendered
2026-10-28 quad00 design pass 3, arms: a bicep swell on the upper arm, the elbow fold cut as one smooth convex cut, the elbow + wrist plates black-anodized beside the node head; rerendered
2026-10-28 quad00 arms: the elbow fold cut keeps the full 142 deg range, its edges rounded 4 mm (rounded(): a voxel morphological opening, so the clearance holds); rerendered
    Needs scikit-image alongside quad00's usual deps for the export.
    [k1_design.py]
2026-10-28 cortex: node -- jaw + occiput: below the panel the sides tuck under like a jaw (half width to 46 at the foot, from z 38) and the back sweeps under from the occiput (x -48 at the foot, from z 32); nod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
    Prints, 3MFs and DXF not regenerated yet.
2026-10-28 cortex: node prints regenerated for the jaw + occiput skull: face + rear STLs (watertight), all five 3MFs, print renders
    [node-face.stl, node-mvp-06.3mf, node-mvp-facedown.3mf, node-mvp-fast.3mf, node-mvp-fastest.3mf, node-mvp.3mf, node-rear.stl]
2026-10-28 quad00: no accent -- the yaw seam is a 2 mm satin line inlaid on the neck sleeve (follows its taper, 0.3 proud), the mint dropped; rerendered
2026-10-28 cortex: export.sh after the main merge -- the print parts it named (sled-print, back grille, the d4 tub) moved to cortex/print/ with release 1; head proxies + fab STL/STEP re-exported from release 1'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
    [cortex-cables.stl, cortex-cams.stl, cortex-compute.stl, cortex-ear-grilles.step, cortex-ear-grilles.stl, cortex-exhaust-grille.step, cortex-exhaust-grille.stl, cortex-floor.step]
2026-10-28 cortex: node-mvp-quality.3mf -- for the look: a variable layer-height profile from the outer skin's slopes (0.08 on the crown and jaw, 0.24 on the sides), outer wall 80 mm/s between its inner walls, 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
    [node-mvp-quality.3mf]
2026-10-28 cortex: node-mvp-tilt.3mf -- the quality settings with the rear tilted 30 deg back (crown and sides steep, supports on the occiput), uniform 0.12 layers, one filament (no prime tower), 5 mm brim
    [node-mvp-tilt.3mf]
2026-10-28 cortex: node-mvp-tilt.3mf -- the face plate tilts 30 deg back too (as assembled), parts stacked front to back so the bigger tilted footprints fit the P1S plate
    [node-mvp-tilt.3mf]
2026-10-28 quad00 hands: the full's hand human-sized (~165 mm), three-phalanx fingers with knuckle gaps, a round opposed thumb, cheek discs over the wrist plates; the mini's gripper as two wide pads with grip f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
2026-10-28 quad00: renders -- the full's hand alone (palm, back, side), rose mini's arms as a bench duet (duet.py poses the arm chains by their own joint axes); walk_keys.py turns a K1 hardware walk trace into 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
2026-10-28 quad00 full: a 6-DoF linkage hand with the wrist yaw out of the palm
    - wrist: roll moved up under the elbow; pitch + yaw become one U-joint at the wrist, driven differentially by two
    20 mm linear actuators in the rolling forearm (aft, +-14 in y) through pushrods -- together they pitch, against
    each other they yaw; a ribbed rubber boot over the joint; limits +-45 pitch / +-30 yaw (the hand clears the
    sleeve to exactly this, checked at the corner pose)
    - palm: nothing but the hand frame and six 10 mm linear actuators -- one per finger (a four-bar curls the three
    phalanges together), two for the thumb (flex, swing); the back of the hand thins to 21 mm half-thick
    - every wrist/hand part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
    [k1_design.py, k1_structure.py, rom_mini.py]
2026-10-28 quad00 full hand: articulated fingers -- hand_grasp.py makes each phalanx a real joint, couples PIP to MCP and DIP to PIP with four-bars closed numerically (pivots searched: assembled 0-90 deg, PIP/M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
    k1_design keeps the palm shell and the phalanx sections in HAND_SPEC for it. Coupler/crank pivots ASSUMED, not yet optimised for force.
2026-10-28 quad00 torso pass (K1-sleek, athletic): one straight V from a narrow waist to broad shoulders (no pinch + late funnel), crisp 18 mm plan corners and crown (not a pillow), no front panel groove, the m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
2026-10-28 quad00 torso pass 2: slimmer and sexier, the mini repacked to fit
    - a stronger V (waist 0.56 of the chest, flaring as u^1.9 to the shoulder drums); the pelvis's top draws in to meet it
    - depth: KS.SHELL_DEPTH (mini 0.88/0.90, full 0.70/0.84 of the trunk envelope), shared by the shell and the packing
    - mini repack: the pack's hatch follows the slimmer back skin, BMS board 6 mm (was 10), side plates + decks trimmed
    to the shell, the limbic board on end (88 across), the brake and the ELRS RX to the free left bay, the fans on the
    slimmer back wall
    - checked: every torso internal inside the shell (the spine cable 3.2 %, under its old 4 %), no clashes; full clean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
2026-10-28 quad00: rose mini exploded 2.5x (vcad_export explode: shells lift off the plate frame, links spread along the chain) -- 3/4, front, back
2026-10-28 quad00: BARE=1 vcad_export.py -- no plastics (covers, trims, soles, the head shell dropped; frame, motors, electronics kept); rose mini bare: 3/4, front, back
2026-10-29 cortex: node print 2 joint -- the top clips become 20 mm snap hooks and the vertical seam is keyed all the way round
    Print 1 findings: in the assembled position the top tabs overlapped the rear lip by 0.17 cm3, so they snapped when
    forced. The seam also gapped: the front devkit posts and the lip under the jaw ran into the face module, and the
    sides were unkeyed where the lip is cut for the devkit.
    - hooks: 1.8 x 14 beams with 0.3 clearance under the lip, a 0.7 hook (~0.45 % root strain), a 30 deg lead-in
    and a 45 deg return. They catch behind keeper strips in the crown. The bridges bear on the lip's front edge as
    the x stop.
    - the face module has side lips across z 35-74
    - the seam is a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
    [node-face.stl, node-mvp-06.3mf, node-mvp-facedown.3mf, node-mvp-fast.3mf, node-mvp-fastest.3mf, node-mvp-quality.3mf, node-mvp-tilt.3mf, node-mvp.3mf]
2026-10-29 cortex: node print 2 -- drop the seam reveal; its skin-offset cut left non-manifold slivers (Bambu: 4 edges)
    The stepped chamfer (and a single rabbet) cut from offsets of the skin left sliver edges at the split.
    Vertex-merging slicers pinch them. The shadow gap stays a plain 0.5 butt joint. Export goes back to
    trimesh's positional merge, so watertight=True means the slicer will see it as watertight. Plates regenerated.
    [node-face.stl, node-mvp-06.3mf, node-mvp-facedown.3mf, node-mvp-fast.3mf, node-mvp-fastest.3mf, node-mvp-quality.3mf, node-mvp-tilt.3mf, node-mvp.3mf]
2026-10-29 cortex: node ears -- XVF3800 mounting from Seeed's STEP: 3 x M2 bosses, mics on the 66 square, board down to z 120
    The board that arrived didn't match the crown bosses. Its holes are 3 x Ø2.2 at (0, -34) and (+-21.35, 24.5),
    and the 66 square we drilled is where the 4 bottom-port mics are. From
    respeaker_mic_array_xvf3800_1_with-xiao-0820.stp and the 2D drawing:
    - 3 crown bosses with M2 self-tap pilots. The USB-C faces aft, so board (bx, by) maps to head (XVF_X + by, -bx).
    - the mic channels and the halo go to (+-33, +-33)
    - the board drops from z 132 to 120: at 132 the edge buttons and the USB-C hit the walls. A box per STEP part,
    grown 1 mm, now clears both shells. There are 6.6 mm behi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
    [node-face.stl, node-mvp-06.3mf, node-mvp-facedown.3mf, node-mvp-fast.3mf, node-mvp-fastest.3mf, node-mvp-quality.3mf, node-mvp-tilt.3mf, node-mvp.3mf]
2026-10-29 cortex: node-mvp-asa.3mf -- ASA body + Support For PLA interface (tilted, 0.2 layers, 0 gap), with the Orca temperature-range fix in PRINT.md
    [node-mvp-06.3mf, node-mvp-asa.3mf, node-mvp-facedown.3mf, node-mvp-fast.3mf, node-mvp-fastest.3mf, node-mvp-quality.3mf, node-mvp-tilt.3mf, node-mvp.3mf]
2026-10-29 cortex: node-mvp-asa.3mf -- ASA only, with tree supports tuned to peel (0.2 gap, 3 interlaced interface layers at 0.3, 0.6 xy)
    [node-mvp-asa.3mf]
2026-10-29 cortex: node 3mf plates regenerated with the generator's last run
    [node-mvp-06.3mf, node-mvp-facedown.3mf, node-mvp-fast.3mf, node-mvp-fastest.3mf, node-mvp-quality.3mf, node-mvp-tilt.3mf, node-mvp.3mf]
2026-11-10 README: rewrite for the public launch (#22)
    State what rose is and that it is design stage, map every top-level area
    (arm, brain, quad00, cortex were unmentioned), say which design pass is
    current, list only commands whose files exist, note that family.py --pack
    no longer runs, and point readers of the vcad paper and irys to
    full/cad/links/shoA.loon at 832192f.
2026-11-10 README: show the current quad00 mini and full renders (#1)
2026-11-10 restructure: body/, head/, arm/, electronics/, sizing/
    The current design moves out of quad00/ into body/ (mini + full) and head/ (cortex).
    arm/fork becomes arm/ (lymb). brain, the limb controller and brand go under
    electronics/. family.py and the mega sizing go under sizing/.
    Removed, kept in history at tag pre-restructure: the earlier mini/, full/ and mega/
    passes, the quadruped-leg scripts and its generated out/ and render/, the first box
    arm, and the head mockups.
    Paths in scripts, KiCad library tables, symlinks and docs are rewritten; each
    folder has a README.
    [3.2mm_sheet1.dxf, 3.2mm_sheet2.dxf, 3.2mm_sheet3.dxf, 6.3mm_sheet1.dxf, BOM.csv, arm-elbowE1_la.dxf, arm-elbowE2_la.dxf, arm-forearmF1_la.dxf]
